GlasgowEmbedded/glasgow/README.md

# Glasgow Interface Explorer

For all information regarding this project, please refer to our [documentation manual](https://glasgow-embedded.org/).
