GlasgowEmbedded/glasgow/docs/meetings/2023-10-07.md

# Glasgow Maintainers Coordination Meeting

Date: 2023-10-07

Attendees:
- @whitequark
- @attie
- @esden
- @ewenmcneill

## Agenda

### CrowdSupply Campaign

Assignee: @esden

- Early bird orders have been arriving, people are very happy!!
  - Issue getting unit(s) shipped to Russia, @whitequark willing to support

### [#312](https://github.com/GlasgowEmbedded/glasgow/issues/312) - Documentation

Assignee: @attie & @whitequark

- Very shiny new documentation has been prepared and published - [glasgow-embedded.org](https://glasgow-embedded.org/latest/intro.html)
- Community contributions for installation steps recieved (FreeBSD)
- @attie to continue working on "_REPL & Script_" usage
- @whitequark to add a "_Design Principles_" section, and fill in "_Dev Process -> Firmware_"

### [#400](https://github.com/GlasgowEmbedded/glasgow/issues/400) - OS version in `--version` output

Assignee: @whitequark

- Plan to use `/etc/os-release`
- In progress, to be completed soon

### [#415](https://github.com/GlasgowEmbedded/glasgow/issues/415) - Case Options Mentioned in Docs

Assignee: @attie (to review)

- 3D print and laser-cut case designs exist, both need review for compatibility with revC3
- **Don't** add link in docs until revC3 compatibility is confirmed
- Aluminium case (from CS) won't be made public, isn't OSHW

### [#429](https://github.com/GlasgowEmbedded/glasgow/issues/429) - Export BOM for revC3

Assignee: @esden

- Will try to complete by the next meeting

### [#422](https://github.com/GlasgowEmbedded/glasgow/issues/422) - TypeError when running `glasgow`

Assignee: @whitequark

- Turns out this is likely related to older patch releases of Python
  - `<=3.9.10` is broken (including `3.9.5` as shipped in "_universe_" repo for Ubuntu 20.04 LTS)
  - `<=3.10.2` is broken
- High priority, do not want to instruct users on additional system setup steps
