GlasgowEmbedded/glasgow/docs/meetings/2023-09-09.md

# Glasgow Maintainers Coordination Meeting

Date: 2023-09-09

Attendees:
- @whitequark
- @attie
- @esden
- @electroniceel
- @wanda
- @isabelburgos
- @nanographs

## Agenda

### Rework Handling of EP0 in FX2

Assignee: @whitequark

- See [#382](https://github.com/GlasgowEmbedded/glasgow/issues/382) - Device fails to enumerate when plugged in for the first time on Windows
- See [#385](https://github.com/GlasgowEmbedded/glasgow/pull/385) - Temporarily work around issue #382
- No update since [2023-09-02](./2023-09-02.md)
- @whitequark plans to progress this next weekend, if not sooner

### CrowdSupply Campaign

Assignee: @esden

- No hardware update - 1000x cases ready, 200x PCBAs ready for firmware (see #382)
- Supply chain paperwork prepared and in review
- No update on LVDS test or test jig

### [#376](https://github.com/GlasgowEmbedded/glasgow/pull/376) - Migrate away from `bitarray` dependency

Assignee: @wanda

- No update since [2023-09-02](./2023-09-02.md)

### [#312](https://github.com/GlasgowEmbedded/glasgow/issues/312) - Documentation

Assignee: @attie & @whitequark

- @attie to look at expanding #312, and discuss with @whitequark
  - If they are aligned, @attie will coordinate documentation, @whitequark gets final approval
- @isabelburgos as lots of notes from personal use
- Potential contributors:
  - @isabelburgos
  - @nanographs
- "_Getting Started_" documentation would benefit from a native Windows / macOS user
