GlasgowEmbedded/glasgow/hardware/boards/glasgow/revB/output/3drender-back.png

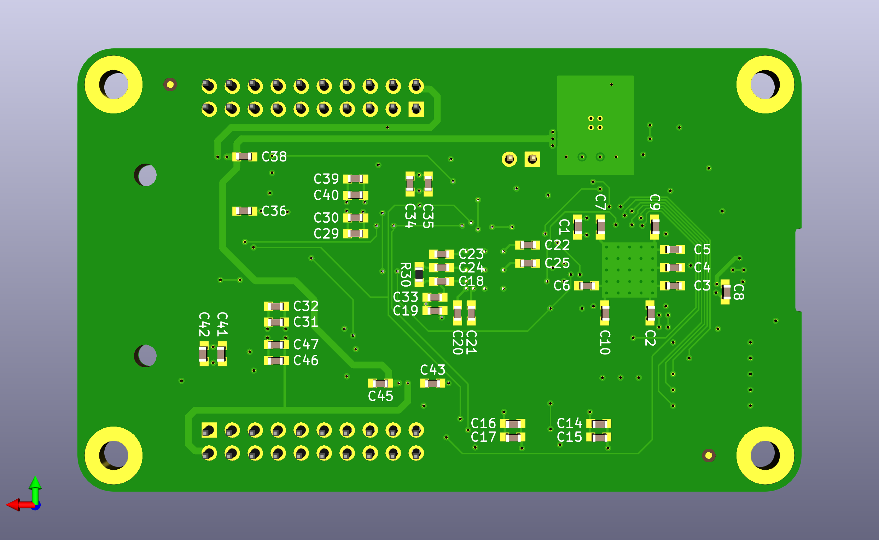
hardware/boards/glasgow/revB/output/3drender-back.png
