GlasgowEmbedded/glasgow/hardware/boards/glasgow/revB/output/3drender-front.png

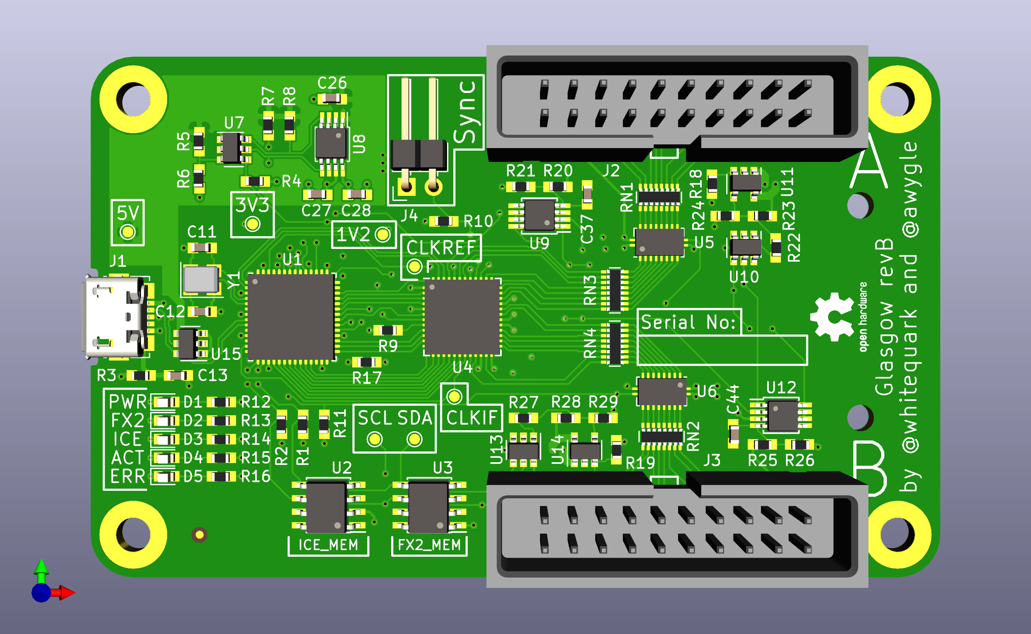
hardware/boards/glasgow/revB/output/3drender-front.png
