GlasgowEmbedded/glasgow/hardware/boards/glasgow/revC0/output/3drender-back.png

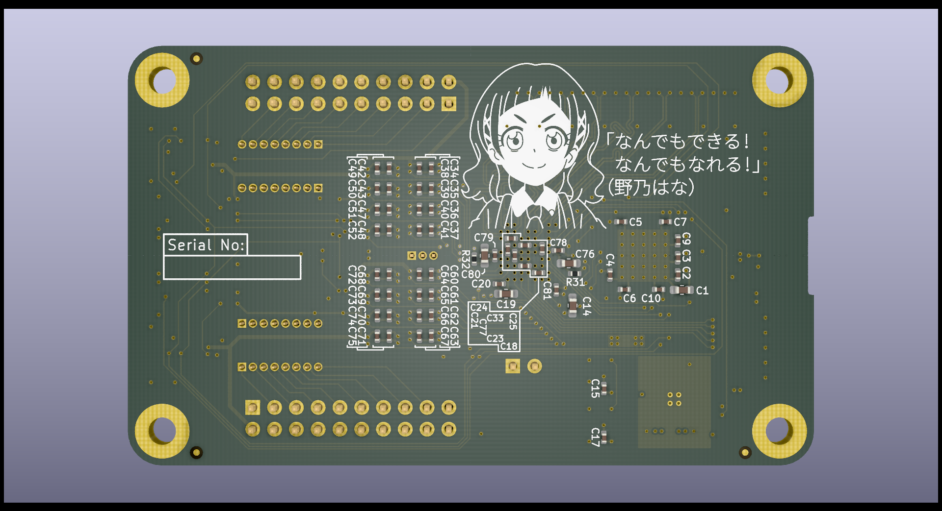
hardware/boards/glasgow/revC0/output/3drender-back.png
