GlasgowEmbedded/glasgow/hardware/boards/glasgow/revC0/output/3drender-front.png

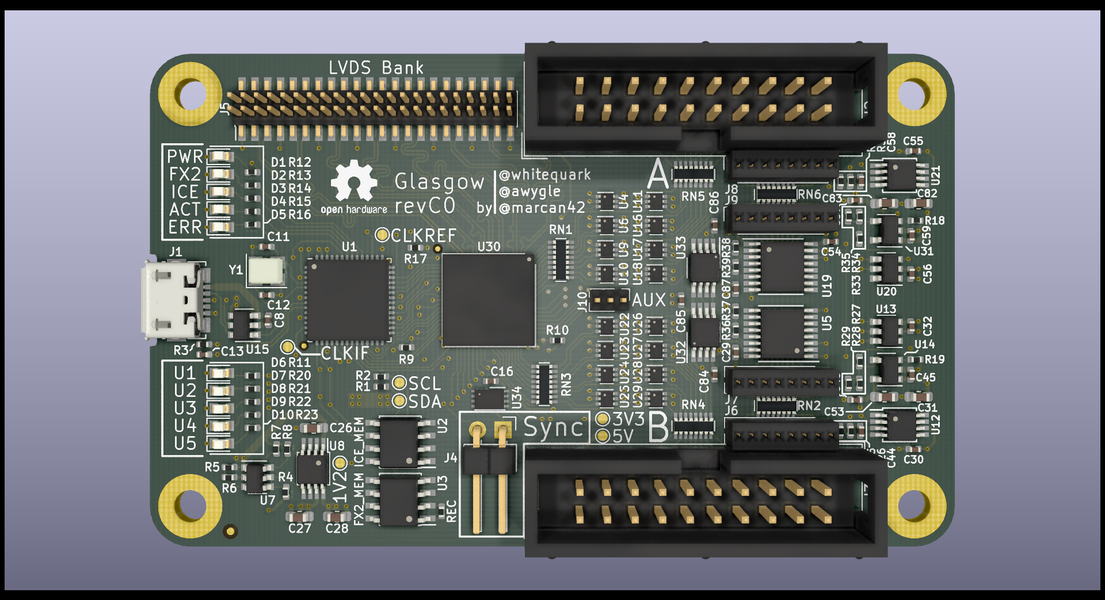
hardware/boards/glasgow/revC0/output/3drender-front.png
