GlasgowEmbedded/glasgow/hardware/boards/glasgow/revC1/output/3drender-back.png

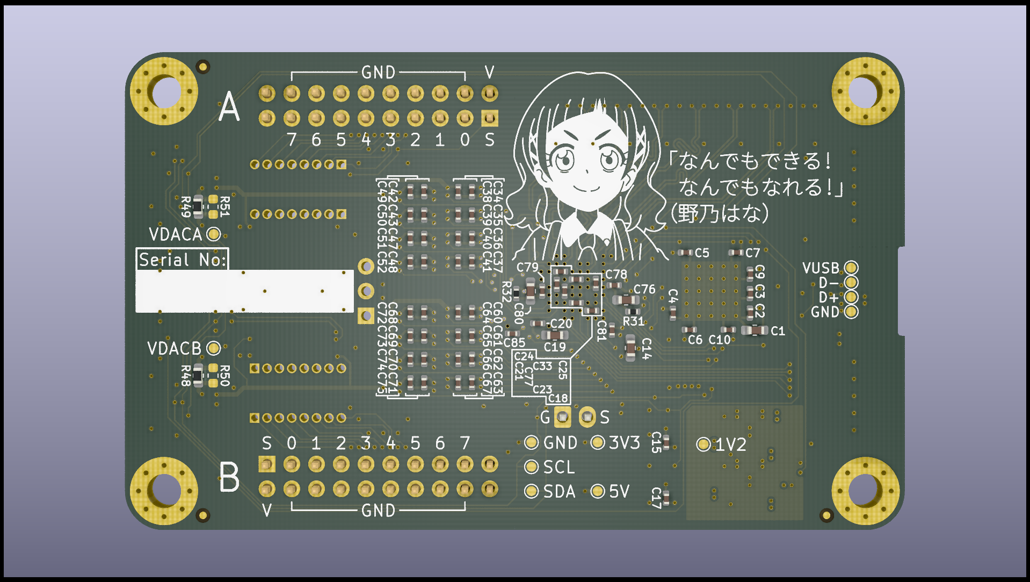
hardware/boards/glasgow/revC1/output/3drender-back.png
