GlasgowEmbedded/glasgow/hardware/boards/glasgow/revC1/output/3drender-front.png

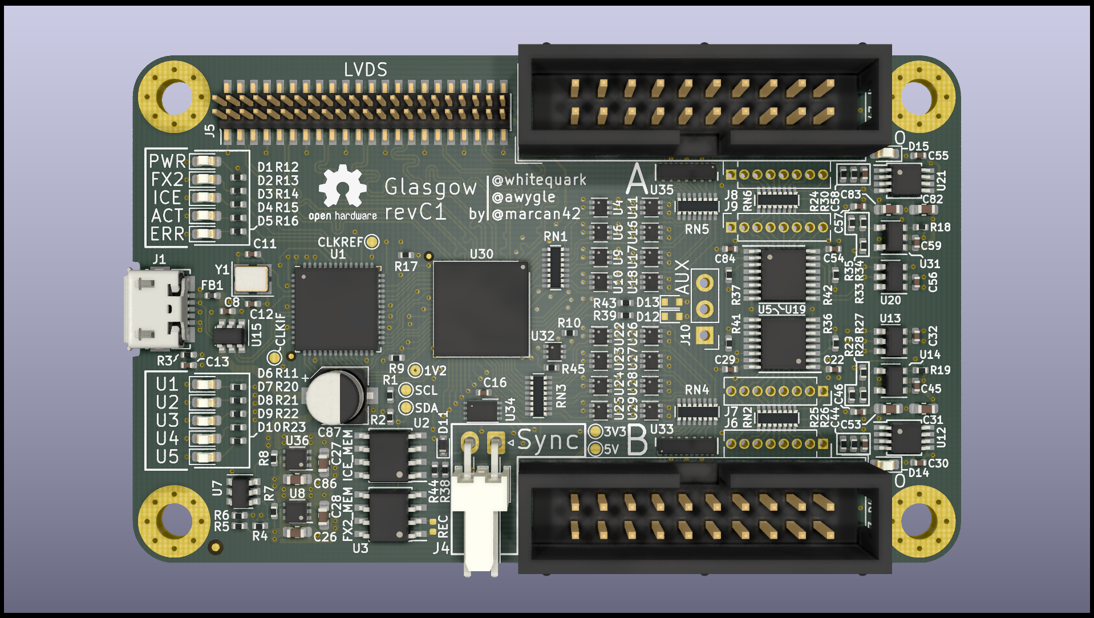
hardware/boards/glasgow/revC1/output/3drender-front.png
