GlasgowEmbedded/glasgow/hardware/boards/glasgow/revC2/output/3drender-back.png

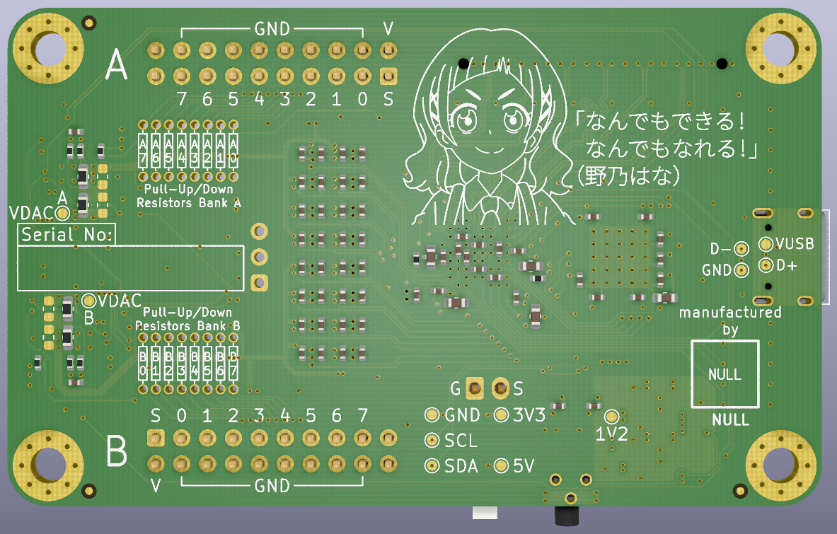
hardware/boards/glasgow/revC2/output/3drender-back.png
