GlasgowEmbedded/glasgow/hardware/boards/glasgow/revC2/output/3drender-front.png

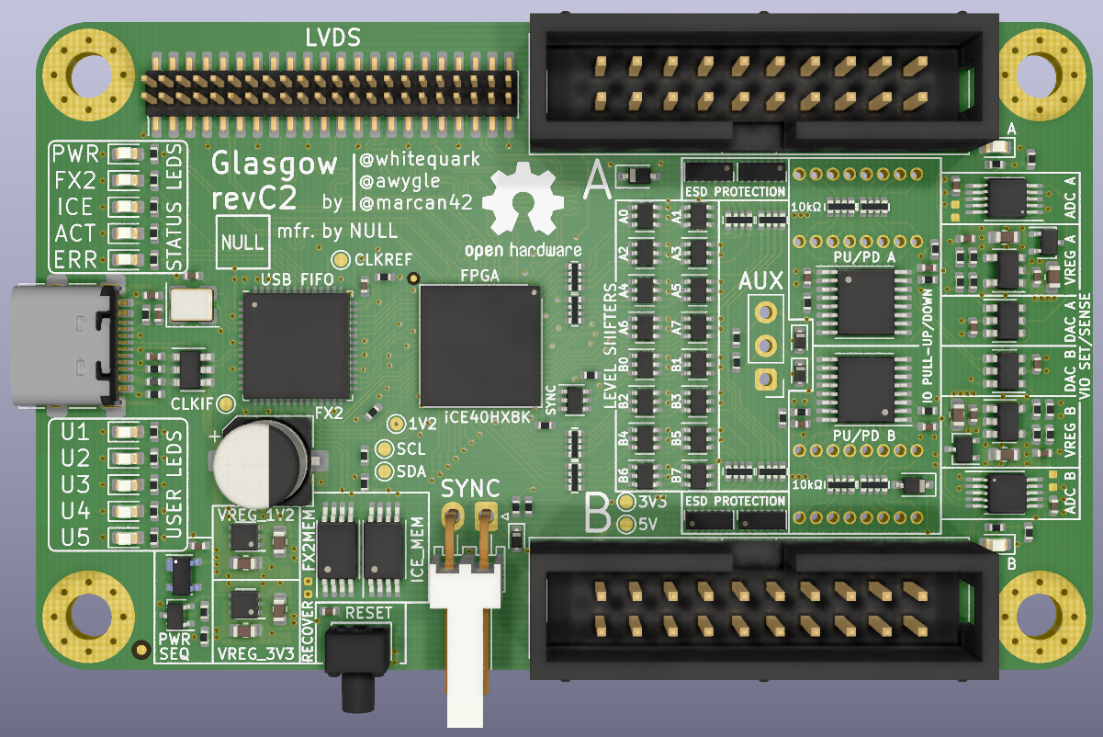
hardware/boards/glasgow/revC2/output/3drender-front.png
