GlasgowEmbedded/glasgow/docs/manual/src/purchase.rst

.. _purchasing:

Purchasing hardware
===================

Pre-assembled Glasgow devices and cases are available for purchase from the stores listed below.

* `CrowdSupply`_
* `1BitSquared USA`_
* `1BitSquared Germany`_
* `Mouser`_

.. _1BitSquared USA: https://1bitsquared.com/products/glasgow
.. _1BitSquared Germany: https://1bitsquared.de/products/glasgow
.. _CrowdSupply: https://www.crowdsupply.com/1bitsquared/glasgow
.. _Mouser: https://www.mouser.com/c/?q=glasgow-c3

As Glasgow is open hardware, you also have the option of :ref:`building a device yourself <build>`!
