GlasgowEmbedded/glasgow/hardware/cases/3d-printed/revC/base/output/Glasgow_base.iges

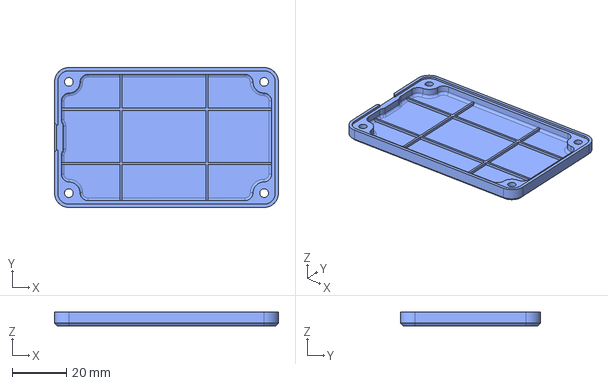
[picture p9: CAD file, 2026-09-02]
hardware/cases/3d-printed/revC/base/output/Glasgow_base.iges
82.6 x 51.6 x 5.00 mm
