GlasgowEmbedded/glasgow/hardware/cases/3d-printed/revC/magnetic-lid/output/glasgow_magnetic_lid.iges

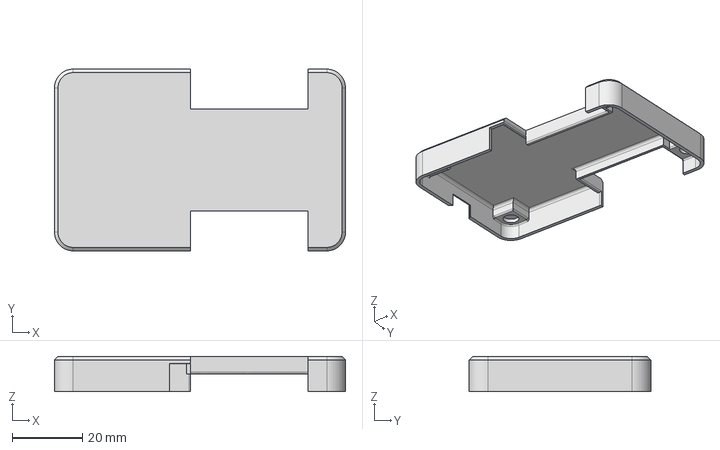
[picture p10: CAD file, 2020-11-04]
hardware/cases/3d-printed/revC/magnetic-lid/output/glasgow_magnetic_lid.iges
82.6 x 51.6 x 9.95 mm
