GlasgowEmbedded/glasgow/hardware/cases/laser-cut/revA/output/bottom.dxf

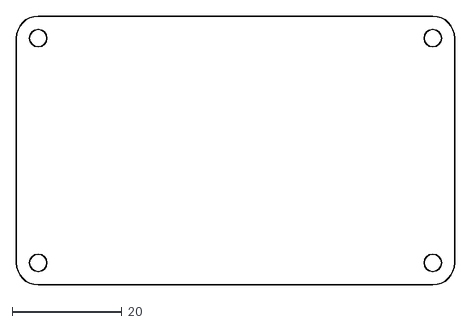
[picture p11: CAD file, 2018-04-18]
hardware/cases/laser-cut/revA/output/bottom.dxf
80.0 x 49.0
