GlasgowEmbedded/glasgow/hardware/cases/laser-cut/revA/output/top.dxf

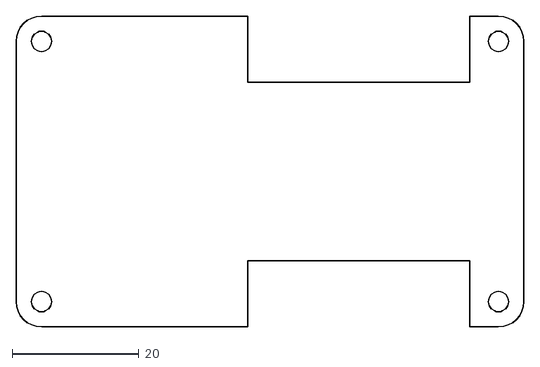
[picture p12: CAD file, 2018-04-18]
hardware/cases/laser-cut/revA/output/top.dxf
80.0 x 49.0
