GlasgowEmbedded/glasgow/(list of files, cad)

Other CAD files:
hardware/cases/3d-printed/revC/base/Glasgow_base.f3d
hardware/cases/3d-printed/revC/base/output/Glasgow_base.stl
hardware/cases/3d-printed/revC/magnetic-lid/glasgow_magnetic_lid.f3z
hardware/cases/3d-printed/revC/magnetic-lid/output/glasgow_magnetic_lid.stl
