GlasgowEmbedded/glasgow/docs/manual/src/applets/index.rst

Applet index
============

.. note::

    Note that not every applet is documented here yet; see ``glasgow run --help`` for a complete list.

.. toctree::
    :maxdepth: 2

    interface/index
    memory/index
    program/index
    debug/index
    radio/index
    control/index
    sensor/index
    bridge/index
    audio/index
    measure/index
    internal/index
