GlasgowEmbedded/glasgow/docs/manual/src/use/index.rst

Using the device
================

.. toctree::

    basic
    repl-script
