GlasgowEmbedded/glasgow/docs/manual/src/applets/control/index.rst

.. _applet.control:

Device control
==============

.. automodule:: glasgow.applet.control

.. toctree::
    :maxdepth: 3

    clock
    gpio
    mdio
    servo
    si535x
    tps6598x
