GlasgowEmbedded/glasgow/docs/manual/src/applets/sensor/index.rst

.. _applet.sensor:

Environment sensing
===================

.. automodule:: glasgow.applet.sensor

.. toctree::
    :maxdepth: 3

    bmx280
    hcsr04
    hx711
    ina260
    max31855
    pmsx003
    scd30
    sen5x
    qmc5883p
