GlasgowEmbedded/glasgow/docs/manual/src/applets/sensor/pmsx003.rst

``sensor-pmsx003``
==================

CLI reference
-------------

.. _applet.sensor.pmsx003:

.. autoprogram:: glasgow.applet.sensor.pmsx003:SensorPMSx003Applet._get_argparser_for_sphinx("sensor-pmsx003")
    :prog: glasgow run sensor-pmsx003

API reference
-------------

.. module:: glasgow.applet.sensor.pmsx003

.. autoexception:: PMSx003Error

.. autoclass:: PMSx003Interface
