GlasgowEmbedded/glasgow/docs/manual/src/applets/interface/index.rst

.. _applet.interface:

I/O interfaces
==============

.. automodule:: glasgow.applet.interface

.. toctree::
    :maxdepth: 3

    analyzer2
    uart
    uart_analyzer
    i2c_controller
    spi_controller
    spi_analyzer
    qspi_controller
    qspi_analyzer
    jtag_pinout
    jtag_probe
    jtag_svf
    sbw_probe
    swd_probe
