GlasgowEmbedded/glasgow/docs/manual/src/applets/interface/i2c_controller.rst

``i2c-controller``
==================

CLI reference
-------------

.. _applet.interface.i2c_controller:

.. autoprogram:: glasgow.applet.interface.i2c_controller:I2CControllerApplet._get_argparser_for_sphinx("i2c-controller")
    :prog: glasgow run i2c-controller

API reference
-------------

.. module:: glasgow.applet.interface.i2c_controller

.. autoexception:: I2CNotAcknowledged

.. autoclass:: I2CControllerInterface

.. module:: glasgow.arch.i2c

.. autoclass:: ProbeStep

    .. autoenum:: glasgow.arch.i2c::ProbeStep.Type

.. autoclass:: ProbeDevice
