GlasgowEmbedded/glasgow/docs/manual/src/applets/sensor/qmc5883p.rst

``sensor-qmc5883p``
==================

CLI reference
-------------

.. _applet.sensor.qmc5883p:

.. autoprogram:: glasgow.applet.sensor.qmc5883p:SensorQMC5883PApplet._get_argparser_for_sphinx("sensor-qmc5883p")
    :prog: glasgow run sensor-qmc5883p

API reference
-------------

.. module:: glasgow.applet.sensor.qmc5883p

.. autoexception:: QMC5883PError

.. autoenum:: OperatingMode

.. autoenum:: OutputDataRate

.. autoenum:: OversampleRatio

.. autoenum:: DownsampleRatio

.. autoenum:: FieldRange

.. autoenum:: SetResetMode

.. autoclass:: QMC5883PInterface
