GlasgowEmbedded/glasgow/docs/manual/src/applets/program/avr_spi.rst

``program-avr-spi``
===================

CLI reference
-------------

.. _applet.program.avr.spi:

.. autoprogram:: glasgow.applet.program.avr.spi:ProgramAVRSPIApplet._get_argparser_for_sphinx("program-avr-spi")
    :prog: glasgow run program-avr-spi
