GlasgowEmbedded/glasgow/docs/manual/src/applets/interface/jtag_probe.rst

``jtag-probe``
==============

CLI reference
-------------

.. _applet.interface.jtag_probe:

.. autoprogram:: glasgow.applet.interface.jtag_probe:JTAGProbeApplet._get_argparser_for_sphinx("jtag-probe")
    :prog: glasgow run jtag-probe

API reference
-------------

.. todo::

    Add API documentation for ``jtag-probe``.
