GlasgowEmbedded/glasgow/docs/manual/src/applets/interface/sbw_probe.rst

``sbw-probe``
=============

CLI reference
-------------

.. _applet.interface.sbw_probe:

.. autoprogram:: glasgow.applet.interface.sbw_probe:SpyBiWireProbeApplet._get_argparser_for_sphinx("sbw-probe")
    :prog: glasgow run sbw-probe

API reference
-------------

.. todo::

    Add API documentation for ``sbw-probe``.
