GlasgowEmbedded/glasgow/docs/manual/src/applets/sensor/hcsr04.rst

``sensor-hcsr04``
=================

CLI reference
-------------

.. _applet.sensor.hcsr04:

.. autoprogram:: glasgow.applet.sensor.hcsr04:SensorHCSR04Applet._get_argparser_for_sphinx("sensor-hcsr04")
    :prog: glasgow run sensor-hcsr04

API reference
-------------

.. module:: glasgow.applet.sensor.hcsr04

.. autoclass:: SensorHCSR04Interface
