GlasgowEmbedded/glasgow/docs/manual/src/applets/interface/swd_probe.rst

``swd-probe``
=============

CLI reference
-------------

.. _applet.interface.swd_probe:

.. autoprogram:: glasgow.applet.interface.swd_probe:SWDProbeApplet._get_argparser_for_sphinx("swd-probe")
    :prog: glasgow run swd-probe

API reference
-------------

.. module:: glasgow.applet.interface.swd_probe

.. autoexception:: SWDProbeException

    .. autoenum:: glasgow.applet.interface.swd_probe::SWDProbeException.Kind

.. autoclass:: SWDProbeInterface
