GlasgowEmbedded/glasgow/docs/manual/src/applets/sensor/sen5x.rst

``sensor-sen5x``
=================

CLI reference
-------------

.. _applet.sensor.sen5x:

.. autoprogram:: glasgow.applet.sensor.sen5x:SensorSEN5xApplet._get_argparser_for_sphinx("sensor-sen5x")
    :prog: glasgow run sensor-sen5x

API reference
-------------

.. todo::

    Add API documentation for ``sensor-sen5x``.
