GlasgowEmbedded/glasgow/docs/manual/src/applets/sensor/scd30.rst

``sensor-scd30``
=================

CLI reference
-------------

.. _applet.sensor.scd30:

.. autoprogram:: glasgow.applet.sensor.scd30:SensorSCD30Applet._get_argparser_for_sphinx("sensor-scd30")
    :prog: glasgow run sensor-scd30

API reference
-------------

.. todo::

    Add API documentation for ``sensor-scd30``.
