GlasgowEmbedded/glasgow/docs/manual/src/applets/control/servo.rst

``control-servo``
=================

CLI reference
-------------

.. _applet.control.servo:

.. autoprogram:: glasgow.applet.control.servo:ControlServoApplet._get_argparser_for_sphinx("control-servo")
    :prog: glasgow run control-servo

API reference
-------------

.. module:: glasgow.applet.control.servo

.. autoclass:: ServoInterface
