GlasgowEmbedded/glasgow/docs/manual/src/applets/interface/spi_analyzer.rst

``spi-analyzer``
================

CLI reference
-------------

.. _applet.interface.spi_analyzer:

.. autoprogram:: glasgow.applet.interface.spi_analyzer:SPIAnalyzerApplet._get_argparser_for_sphinx("spi-analyzer")
    :prog: glasgow run spi-analyzer

API reference
-------------

.. module:: glasgow.applet.interface.spi_analyzer

.. autoexception:: SPIAnalyzerOverflow

.. autoclass:: SPIAnalyzerInterface
