GlasgowEmbedded/glasgow/docs/manual/src/applets/interface/uart.rst

.. _applet.interface.uart:

``uart``
========

CLI reference
-------------

.. autoprogram:: glasgow.applet.interface.uart:UARTApplet._get_argparser_for_sphinx("uart")
    :prog: glasgow run uart

API reference
-------------

.. module:: glasgow.applet.interface.uart

.. autoclass:: UARTInterface
