GlasgowEmbedded/glasgow/docs/manual/src/applets/interface/uart_analyzer.rst

``uart-analyzer``
=================

CLI reference
-------------

.. _applet.interface.uart_analyzer:

.. autoprogram:: glasgow.applet.interface.uart_analyzer:UARTAnalyzerApplet._get_argparser_for_sphinx("uart-analyzer")
    :prog: glasgow run uart-analyzer

API reference
-------------

.. module:: glasgow.applet.interface.uart_analyzer

.. autoenum:: UARTAnalyzerError()

.. autoclass:: UARTAnalyzerInterface
