GlasgowEmbedded/glasgow/docs/manual/src/applets/bridge/flashrom.rst

``spi-flashrom``
================

.. _applet.bridge.spi_flashrom:

.. autoprogram:: glasgow.applet.bridge.spi_flashrom:SPIFlashromApplet._get_argparser_for_sphinx("spi-flashrom")
    :prog: glasgow run spi-flashrom
