GlasgowEmbedded/glasgow/docs/manual/src/applets/bridge/index.rst

.. _applet.bridge:

External tools
==============

.. automodule:: glasgow.applet.bridge

.. toctree::
    :maxdepth: 2

    flashrom
    jtag_openocd
    jtag_xvc
    probe_rs
