GlasgowEmbedded/glasgow/docs/manual/src/applets/bridge/probe_rs.rst

``probe-rs``
============

.. _applet.bridge.probe_rs:

.. autoprogram:: glasgow.applet.bridge.probe_rs:ProbeRsApplet._get_argparser_for_sphinx("probe-rs")
    :prog: glasgow run probe-rs
