GlasgowEmbedded/glasgow/hardware/cases/3d-printed/revC/base/output/Glasgow_base.png

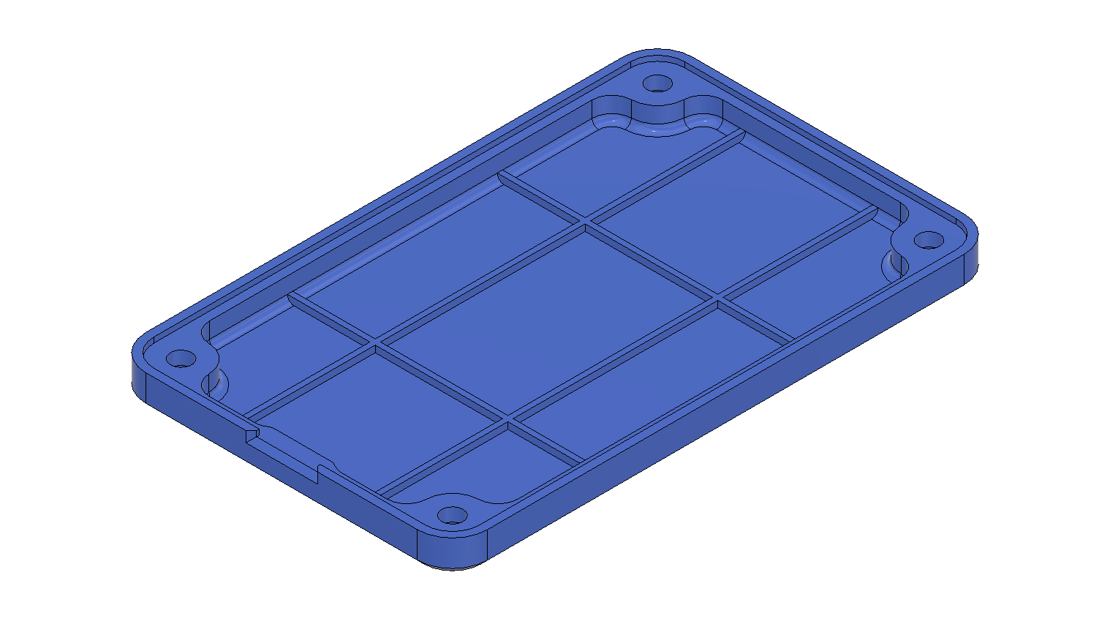
hardware/cases/3d-printed/revC/base/output/Glasgow_base.png
