GlasgowEmbedded/glasgow/docs/manual/src/applets/measure/curve_trace.rst

``curve-trace``
===============

CLI reference
-------------

.. _applet.measure.curve_trace:

.. autoprogram:: glasgow.applet.measure.curve_trace:CurveTraceApplet._get_argparser_for_sphinx("curve-trace")
    :prog: glasgow run curve-trace

API reference
-------------

.. module:: glasgow.applet.measure.curve_trace

.. autoclass:: CurveTraceInterface

.. autoclass:: DiodeTraceInterface
