GlasgowEmbedded/glasgow/docs/manual/src/applets/measure/index.rst

.. _applet.measure:

Measure
=======

.. automodule:: glasgow.applet.measure

.. toctree::
    :maxdepth: 2

    calibrate_clock
    prn_noise
