GlasgowEmbedded/glasgow/docs/manual/src/applets/measure/calibrate_clock.rst

``calibrate-clock``
===================

CLI reference
-------------

.. _applet.measure.calibrate_clock:

.. autoprogram:: glasgow.applet.measure.calibrate_clock:CalibrateClockApplet._get_argparser_for_sphinx("calibrate-clock")
    :prog: glasgow run calibrate-clock

API reference
-------------

.. module:: glasgow.applet.measure.calibrate_clock

.. autoclass:: CalibrateClockInterface
