GlasgowEmbedded/glasgow/hardware/boards/test-jig/pictures/render-bottom.jpg

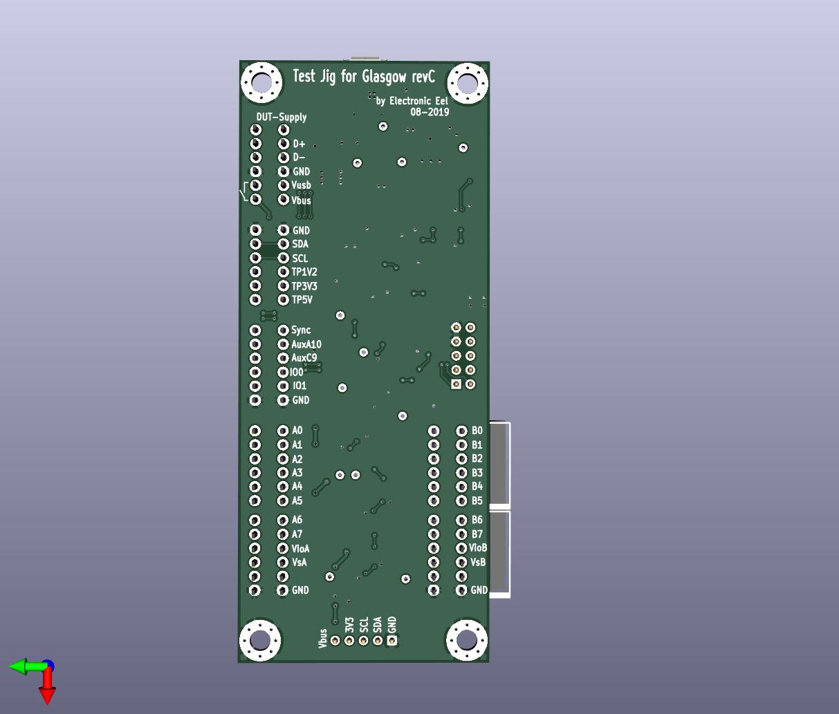
hardware/boards/test-jig/pictures/render-bottom.jpg
