GlasgowEmbedded/glasgow/hardware/boards/test-jig/pictures/render-leds.jpg

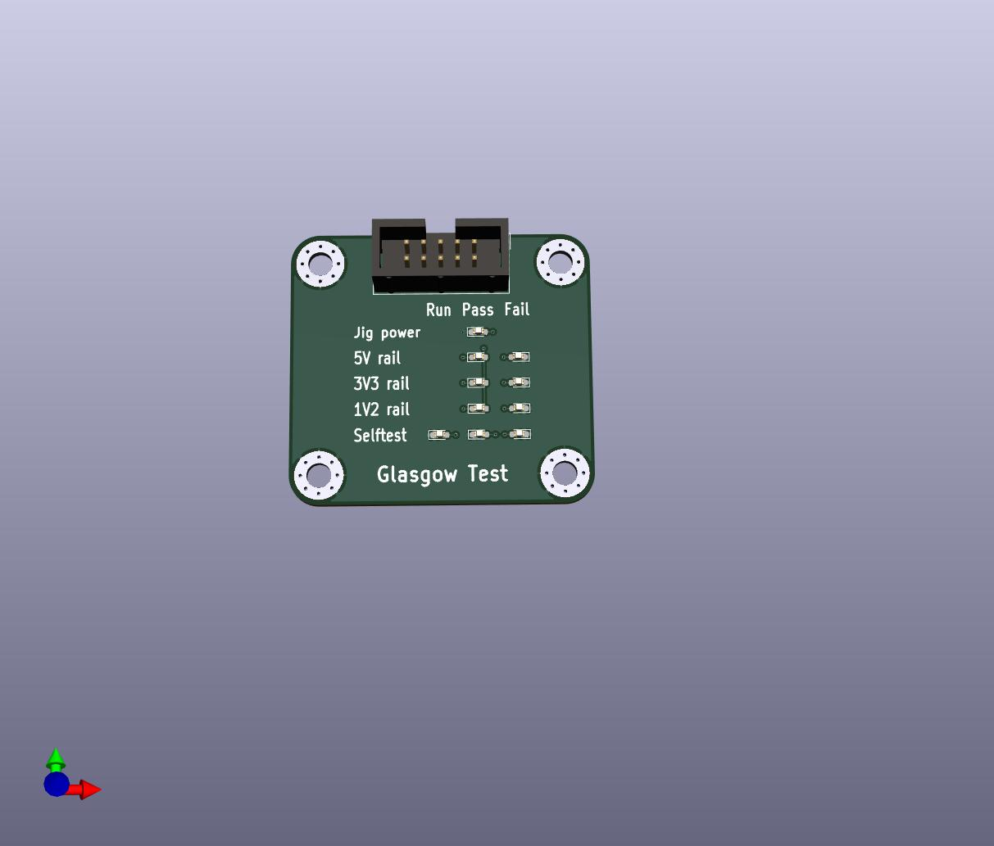
hardware/boards/test-jig/pictures/render-leds.jpg
