GlasgowEmbedded/glasgow/hardware/boards/test-jig/pictures/render-top1.jpg

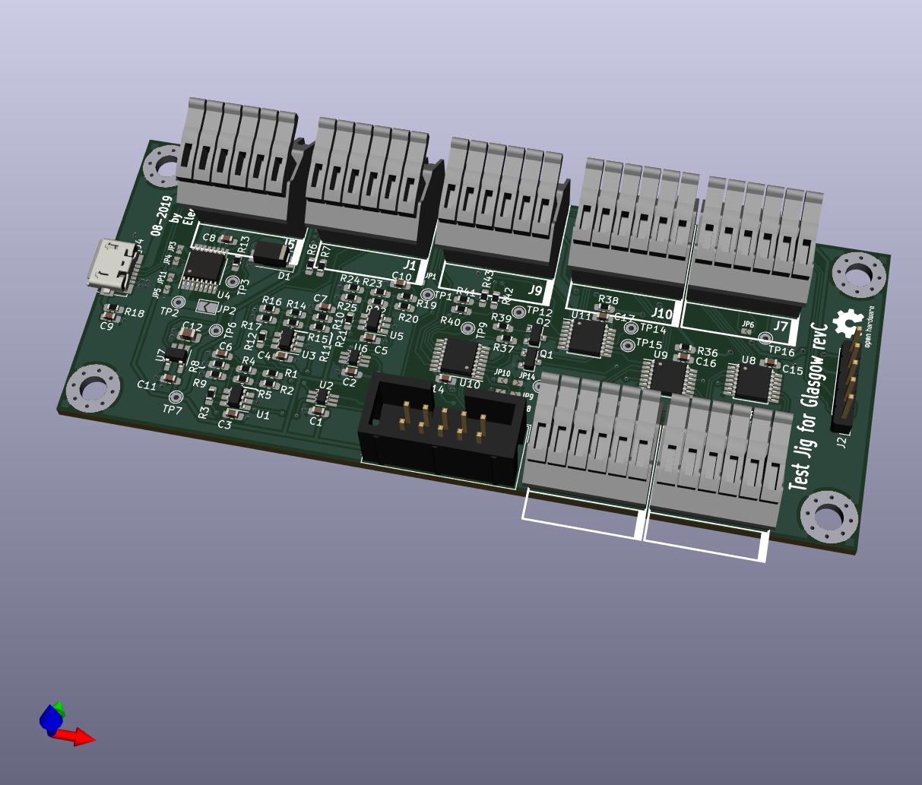
hardware/boards/test-jig/pictures/render-top1.jpg
