GlasgowEmbedded/glasgow/hardware/boards/test-jig/pictures/render-top2.jpg

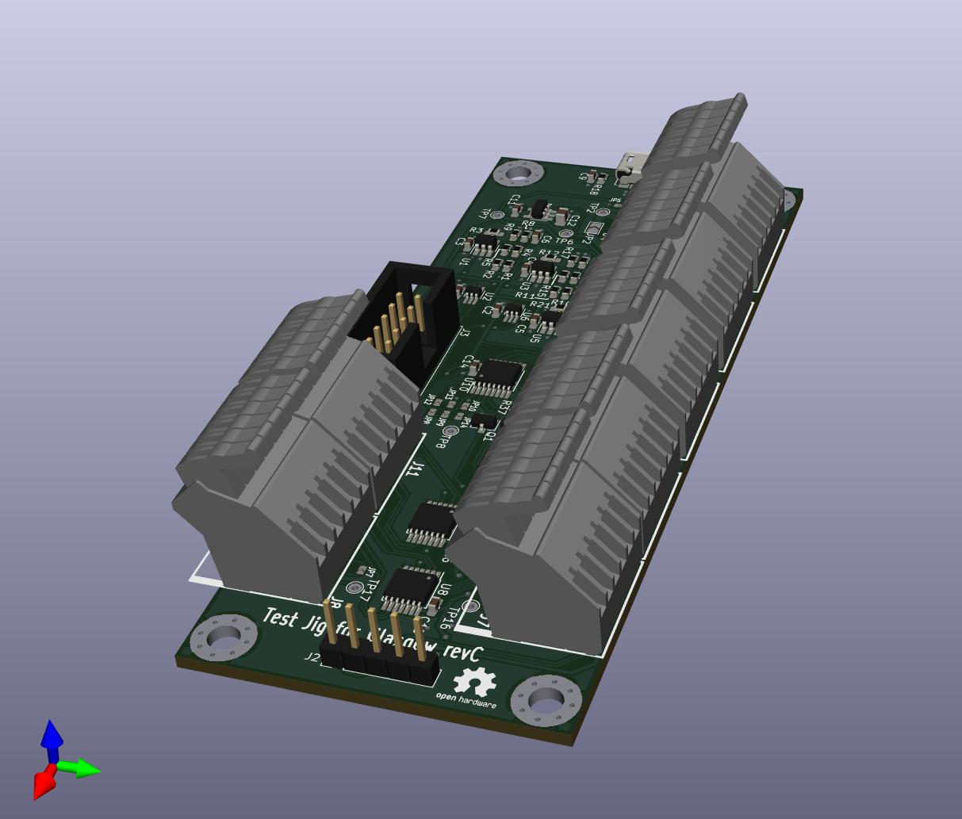
hardware/boards/test-jig/pictures/render-top2.jpg
