GlasgowEmbedded/glasgow/docs/manual/src/applets/debug/arm.rst

``debug-arm``
=============

CLI reference
-------------

.. _applet.debug.arm.jtag:

.. autoprogram:: glasgow.applet.debug.arm.jtag:DebugARMJTAGApplet._get_argparser_for_sphinx("debug-arm")
    :prog: glasgow run debug-arm
