GlasgowEmbedded/glasgow/docs/manual/src/applets/debug/index.rst

.. _applet.debug:

MCU debugging
=============

.. automodule:: glasgow.applet.debug

.. toctree::
    :maxdepth: 3

    arc
    arm
    arm7
    mips
