GlasgowEmbedded/glasgow/docs/manual/src/applets/debug/arm7.rst

``debug-arm7``
==============

CLI reference
-------------

.. _applet.debug.arm.arm7:

.. autoprogram:: glasgow.applet.debug.arm.arm7:DebugARM7Applet._get_argparser_for_sphinx("debug-arm7")
    :prog: glasgow run debug-arm7
