GlasgowEmbedded/glasgow/(threads)

Thread 11 (2018-04-06):

TI ADC081C021CIMM MSOP-8

whitequark, 2018-04-06:
Nothing closely related, seems to use an existing package.

whitequark, 2018-04-11:
Merged

whitequark, 2018-04-16:
ALERT pin should be marked as open-drain (needs to be fixed upstream).

whitequark, 2018-04-19:
Fixed.

Closed 2018-04-19.

Thread 12 (2018-04-06):

ON Semi FXMA108BQX QFN-20

whitequark, 2018-04-06:
Nothing related, the high aspect ratio QFN-20 almost definitely doesn't exist yet.

awygle, 2018-04-08:
See https://github.com/KiCad/kicad-symbols/pull/461 for symbol PR

whitequark, 2018-04-20:
Symbol merged.

whitequark, 2018-05-03:
Pin names are wrong... 1-8 instead of 0-7.

whitequark, 2018-05-03:
Fixed in PR https://github.com/KiCad/kicad-symbols/pull/571

Thread 9 (2018-04-06):

TI TPS73101DBVR SOT-23-5

whitequark, 2018-04-06:
KiCAD has a closely related TPS763xx series, the TPS731 series probably just needs to be a few aliases.

awygle, 2018-04-08:
See https://github.com/KiCad/kicad-symbols/pull/462 for Kicad PR

awygle, 2018-04-09:
Kicad PR merged - closing.

whitequark, 2018-04-17:
Symbol bug. https://github.com/KiCad/kicad-symbols/pull/498

whitequark, 2018-04-20:
Symbol bug fixed upstream.

Closed 2018-04-20.

Thread 15 (2018-04-10):

Cypress CY7C68013A-LXI

whitequark, 2018-04-10:
Unfortunately, some issues with the footprint: https://github.com/KiCad/kicad-symbols/pull/289#issuecomment-380247117

whitequark, 2018-04-11:
> I'm good with having a footprint with thermals vias and making it the default. Vias can also be added by the user in the PCB, but obviously it's best and easiest to build it into the footprint. I have asked Cypress for a recommended footprint. The reference design mentioned above uses 25 vias with 10mil drill (0.254mm), 22mil annular rings (0.5588mm), and 16mil mask (0.4064mm) on a 50mil (1.27mm) XY grid. Pads are oval 40x100mil (1.016x2.54mm) with row-row/column-column spacing of 152.48mil (~3.873mm). When a suitable footprint is in the library, then the default footprint for this symbol could be changed.

whitequark, 2018-05-17:
Footprint: https://github.com/KiCad/kicad-footprints/pull/582

whitequark, 2018-05-25:
3D package: https://github.com/KiCad/kicad-packages3D/pull/316

whitequark, 2018-07-12:
Footprint merged.

whitequark, 2018-09-19:
3D package merged.

Closed 2018-09-19.

Thread 17 (2018-05-01):

R5 has wrong Mouser_PN

whitequark, 2018-05-01:
It's 300k, should be 220k.

whitequark, 2018-05-02:
Already fixed, must have been a stale line in the Mouser BOM.

Closed 2018-05-02.

Thread 19 (2018-05-01):

Move R12-R16 to top side

whitequark, 2018-05-01:
It's a pain in the ass to do double-sided assembly, that's what it is. No need to make it worse.

whitequark, 2018-05-01:
This would involve moving R1/R2/R11 to the right into the great empty plains of EEPROM-land.

whitequark, 2018-05-10:
Nope. D1-D5 silkscreen overlaps R12-R16.

Closed 2018-05-12.

Thread 20 (2018-05-01):

Y1 footprint is way too big

whitequark, 2018-05-01:
Not actually an issue for the component selected, since it still solders nicely, but this is not what I was expecting at all.

Closed 2018-05-05.

Thread 26 (2018-05-01):

Test/loopback PCB

whitequark, 2018-05-01:
When (at this point, apparently not "if") we do a production run we'll need to do QA, and for that we should use a simple board that plugs into both ports and connects them to each other. It should also have LEDs (buffered to Vioa, since the level shifters cannot drive a LED directly) for visual verification.

whitequark, 2018-05-26:
A flat cable with IDC connectors works just as well and is marginally easier to remove. Vio/Vsense map to non-populated pins on an unmodified cable, those should probably be shorted together.

Closed 2018-05-26.

Thread 28 (2018-05-03):

Lattice iCE40HX8K-BG121 121-ball caBGA

whitequark, 2018-05-03:

awygle, 2018-06-25:
Kicad footprint PR: https://github.com/KiCad/kicad-footprints/pull/693
The symbol exists at https://github.com/awygle/kicad-symbols/tree/ice40hx but is waiting on https://github.com/KiCad/kicad-symbols/pull/457 to merge before creating the PR.

whitequark, 2018-07-21:
@awygle That symbol is now merged.

awygle, 2018-07-21:
Kicad symbol PR: https://github.com/KiCad/kicad-symbols/pull/777

whitequark, 2018-10-12:
Symbol merged.

Closed 2018-10-12.

Thread 33 (2018-05-03):

Develop a tool to validate capacitor/resistor values against Mouser API

whitequark, 2018-05-03:

shapr, 2018-05-10:
could this be unpacked with more detail? Might be able to use the octopart API

whitequark, 2018-05-10:
So, I've had an issue several times that the Mouser part number didn't match the value of a resistor (less a problem with capacitors because we only have like one capacitor whose value actually matters, the rest is decoupling). It's a thing that's *really* easy to miss with manual review, so I want to automate it.

Octopart probably works too, just cut `\d+-` from the start of Mouser PN to get MPN.

whitequark, 2018-05-25:
I'm dumb and this is not necessary. The Yageo part numbers have the resistor value in the part number, e.g. `10K` in `RC0603FR-1310KL` or `604R` in `RC0603FR-07604RL`. Same for package. A cursory visual check is well enough.

Closed 2018-05-25.

Thread 34 (2018-05-03):

Use a dedicated USB protection IC instead of a regular fast-blow fuse

whitequark, 2018-05-03:
If you short Vio to GND for like a millisecond it blows instantly. Source: shorted Vio to GND for like a millisecond.

whitequark, 2018-05-05:
This fuse will take ~1s to trip at 1A fault current. Seems completely pointless.

We need a fuse that will blow if you short the 3V3 supply to ground, but also will sustain short-circuit current of both LDOs indefinitely. This needs measurement and experimentation...

awygle, 2018-05-05:
Per IRC discussion, will use http://www.ti.com/lit/ds/symlink/tpd3s014.pdf instead.

whitequark, 2018-05-13:
This seems simple enough we really should add this in revB.

awygle, 2018-06-04:
Closed by 369968e

Closed 2018-06-04.

Thread 35 (2018-05-07):

Slew rate limiting resistors

whitequark, 2018-05-07:
Two arrays of four resistors per port. I'm not sure yet what the values should be; worst case, we can always populate with 0R and decide later.

whitequark, 2018-05-07:
This will also add some very limited pin overcurrent protection. Say at 200 ohm, the buffers should tolerate ±10V on up to two signal pins (not Vio or Vsense though).

whitequark, 2018-05-07:
0402 8-position array fits better (it's about the same size as FXMA108).

whitequark, 2018-06-06:
Pretty sure we also need slew rate limiting on the *other* side of the level shifter because switching many inputs at once causes [glitches](https://github.com/whitequark/Glasgow/blob/a89f5a224449ddd5d1bf9e5f4e8b7e3bc2593bce/software/glasgow/gateware/fx2.py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) on the FLAGn pins on the other side of the board. The apparently random timing of the glitches seems to suggest that glitches happen when the inputs transition happens closely enough to IFCLK transition.

awygle, 2018-06-25:
I added these in commit 7c3203c126e7444981d5405d7d6fcd1db53bbbc5

whitequark, 2018-07-21:
Thanks!

Closed 2018-07-21.

Thread 38 (2018-05-08):

Use an FX2LP in a BGA package?

whitequark, 2018-05-08:
We can save a dollar if we go for 56-ball 0.5 mm pitch VFBGA package. We only need to route out two rows of balls at most, so it seems fine that it's 0.5 mm pitch. Should we?

awygle, 2018-05-08:
Mmm... maybe. The problem with the 0.5mm pitch is, you can't get vias *or* traces between balls on 6/6 trace/space specs. I'll investigate this at the same time as doing the HX routing - 0.8mm parts have similar-but-not-the-same problems, so seeing what we *need* to do will help us figure out what it'll cost us to do the optional stuff.

whitequark, 2018-10-06:
@awygle Do you remember what was your conclusion? Looking at the package, some B and G balls do present an issue...
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

whitequark, 2018-10-31:
We don't have any margin for two-row escape routing on 0.8 mm with 5/5 rules already, so this is not viable.

Closed 2018-10-31.

Thread 40 (2018-05-10):

Add IFCLK test point

whitequark, 2018-05-10:
I'm observing some strange issues related to post-bitstream-upload reset and CDONE is currently not easily accessible at all.

whitequark, 2018-05-11:
I figured it out.

whitequark, 2018-05-11:
But IFCLK makes sense.

Thread 41 (2018-05-13):

Describe Device, Target, Applet APIs

whitequark, 2018-05-13:
- [ ] GlasgowDevice
 - [ ] GlasgowTarget
 - [ ] GlasgowApplet

whitequark, 2019-08-19:
Doesn't seem that useful; documentation dedicated to explaining how to write applets is what's really needed.

Closed 2019-08-19.

Thread 43 (2018-05-13):

Cache bitstreams

whitequark, 2018-05-13:
Synthesis and PAR are slow, rerunning them on every invocation is wasteful, and explicit `--no-build` is awful.

Needs extra care so that it works on:
 - [x] Linux
 - [x] macOS
 - [x] Windows

whitequark, 2018-05-25:
Instead of caching files in some system location, bitstreams are now cached in device memory (volatile and non-volatile) after 48a130ff. This is far more portable and far less likely to result in stale caches leading to confusing results (especially if you don't flash EEPROM) while still eliminating most rebuilds (unless you switch between two applets continuously).

We can revisit this later, but this works for now.

whitequark, 2023-07-23:
We decided to cache bitstreams after all, which becomes possible to do safely after #353 is merged.

Closed 2023-07-23.

Thread 44 (2018-05-13):

Make FX2 bus arbiter prevent starvation

whitequark, 2018-05-13:
Use a leaky bucket algorithm to limit per-FIFO bursts to 16 bytes (or a configurable value).

whitequark, 2019-04-03:
Actually, the FX2 arbiter does not cause starvation. It only looked like it did because of a deadlock in the host code, which was fixed in e59730f.

whitequark, 2019-04-03:
Though, that being said, the arbiter is not particularly fair, but it seems pretty much sufficient for now.

Closed 2019-04-03.

Thread 49 (2018-05-13):

Implement MPSSE subtarget and FTDI emulation mode

whitequark, 2018-05-13:
This is kind of annoying because it needs reenumeration logic in the firmware.

marcan, 2019-05-01:
Don't forget to emulate the 32-bit EEPROM correctly to avoid being hit by FTDI's bricker :P

whitequark, 2019-08-19:
Does anyone actually *want* this?

esden, 2019-08-20:
MPSSE would be fairly useful. There is a bunch of software that uses MPSSE for "stuff" and it would be nice to just transparently use the Glasgow instead of an FTDI cable. Also that implementation might be a useful reference implementation for FTDI chip replacements.

classic-gentleman, 2020-07-08:
> MPSSE would be fairly useful. There is a bunch of software that uses MPSSE for "stuff" and it would be nice to just transparently use the Glasgow instead of an FTDI cable. Also that implementation might be a useful reference implementation for FTDI chip replacements.

YES, for every point made.

whitequark, 2020-07-08:
Ironically this was the original goal of the project and the very first committed gateware, but I don't think we even have the code left for it in-tree anymore.

classic-gentleman, 2020-07-08:
https://github.com/usb-tools/Facedancer/blob/master/facedancer/devices/ftdi.py

Adapting this shouldn't be horrible...

whitequark, 2020-07-08:
The problem is actually the firmware, and there is no great solution that I know of, especially for Windows.

whitequark, 2023-07-23:
We decided not to do this. 60d09a217502f469682e3dd1c51c5e6bd2dfd586

Closed 2023-07-23.

Thread 50 (2018-05-13):

Figure out exactly what happens during Vio short-circuit to GND

whitequark, 2018-05-13:
On revA the fuse blows immediately. Need to check if the current limiting works as designed (probably not since the fuse blows. lol.) and decide what to do about it.

awygle, 2018-05-22:
I put a hard short on one VIO port and did not pop the fuse. I measured a peak of 350 mA and 280 mA steady state (without the short and with the I/O toggling at 15 MHz I was seeing 77 mA). I put a hard short on the other port as well and managed to pop it. That suggests to me that we're close to being able to tolerate two full shorts on the I/O banks, and that dropping down to 100 mA LDOs would probably put us into safe territory. It also becomes sort of a question as to whether we need the USB IC at that point... But then you had your issue earlier so I'm not totally sure what's going on.

Thoughts? Can you replicate your one-port fuse popping?

awygle, 2018-05-22:
With both shorts in place I nearly popped the 600 mA fuse on my ammeter - it looked like 580 mA with both LDOs in current limit.

With one short in place I got up to 350 mA and then it looked like the LDO was going into a thermal shutdown loop. So I think the full-short current is pretty much 350 mA. But again, I was only able to get 77 mA from the pins toggling at 15 MHz, so it looks like the LDO is actually limiting much higher than 150 mA.

awygle, 2018-05-22:
I am an idiot. The current limit for the TPS731 is min 150, typ 360, max 500 mA. No wonder it's not protecting us.

I was going to suggest the LP2980-ADJ, which is a 50 mA output LDO, and whose current limit is "typical" 150 mA. That would put us into safe territory. I'd be worried about starving the shifters but it looks like we can't feed them any faster than like 30 MHz, so we should be safe.

whitequark, 2018-05-22:
> Thoughts? Can you replicate your one-port fuse popping?

I, uh, don't have any fuses left.

whitequark, 2018-05-22:
> I'd be worried about starving the shifters but it looks like we can't feed them any faster than like 30 MHz, so we should be safe.

Hm, I wouldn't put 50 MHz out of question with async FIFOs.

awygle, 2018-05-22:
Yeah, the dropout's not ideal. The alternative is to rely on the USB protection IC. The bummer with that is that it will probably brown out the FX2 and cause the device to flap on the user's PC. The LDO will stop this further downstream.

whitequark, 2018-05-22:
I think a brownout is OK.

whitequark, 2018-05-25:
Since a brownout seems OK (and even beneficial in some ways, as you get a pretty visible indication of something going wrong!) I'm closing this as a duplicate of #34.

Closed 2018-05-25.

Thread 51 (2018-05-14):

Make SYNC pullup smaller

whitequark, 2018-05-14:
The FPGA has ridiculously powerful drivers (what, 10 mA?) so if we use a pullup smaller than 1k we can go well into MHz range. Useful, because the PLL has a minimum frequency of 16 MHz--can we get that high?

awygle, 2018-05-22:
I think 300 Ohms is the lowest we can safely go. That'll give us 300 mV of rise above ground at 3.3V with 10 mA drivers.

whitequark, 2018-05-22:
It's actually 24 mA. On the other hand, Vil(max) for LVCMOS 3.3 inputs is 0.8 V, so 0.3 V seems fine.

awygle, 2018-05-22:
Okay, that'd give us 125 Ohms. 130 for ease of sourcing. Math math math.

whitequark, 2018-05-22:
Can you verify that this value actually gives a decent signal? I don't have my resistor set at hand...

awygle, 2018-05-22:
I have some 120 Ohm resistors, I can look at what those give.

awygle, 2018-06-25:
Where'd you find 24 mA as the value? I'm looking at
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 and reading 8 mA.

(Just for completeness that's 375 Ohms by math and probably 390 by sourcing)

whitequark, 2018-07-10:
Hrm, I might have been looking at the wrong package. 300 mV rise seems pretty low too, that's not enough to sync using e.g. external LMVCMOS 3.3 circuitry... Let's aim at 800 mV rise above ground then.

awygle, 2018-07-10:
Because it's an open drain output, 300 mV is Voh in this case - the voltage for a logic 0. The high voltage will be the full VIO voltage.

whitequark, 2018-07-10:
Oh right, I derped. That's fine then, let's go with 300 mV.

awygle, 2018-07-22:
Whoops:

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

Closed 2018-07-22.

Thread 52 (2018-05-14):

TI SN74LVC1T45

whitequark, 2018-05-14:
Footprint: https://github.com/KiCad/kicad-footprints/pull/581
Symbol: https://github.com/KiCad/kicad-symbols/pull/596
3D package: https://github.com/KiCad/kicad-packages3D/pull/314

whitequark, 2018-05-26:
Footprint and symbol merged.

whitequark, 2018-06-10:
3D package merged.

whitequark, 2018-10-21:
Reopening since the  upstream fp requires 4/4 rules.

whitequark, 2019-08-19:
Upstream says the default footprint should really use the recommended pad sizes, which indeed require 4/4, so we should just fork it, which is what's already happened.

Closed 2019-08-19.

Thread 56 (2018-05-19):

Implement a self-test routine checking for solder bridges

whitequark, 2018-05-19:
This is essentially #26-lite; a proper loopback PCB would allow to test input/output on every single pin, but you need to have it. On the other hand, all our I/O are adjacent on both FPGA and FXMA, and being able to quickly eliminate any possible shorts is *enormously* valuable.

This should run the check twice, once with ~OEQ high and once low, to check for shorts on either side of FXMA.

Closed 2018-07-21.

Thread 59 (2018-05-21):

ESD protection on Vio and Vsense pins

whitequark, 2018-05-21:
FXMA108 gives us ESD protection on all I/O pins. However, what about the ADC and the LDO? In particular, the turned off LDO has the output in hi-Z state, which seems like it might have bad implications. Verify.

awygle, 2018-05-22:
The LDO has 2 kV ESD tolerance, the ADC has 2.5 kV (on the pins in question, under the human body model). The LDO rail has 4.7 uF of capacitance, and the ADC has 12 nF before the input pin. Given that the human body model specifies 200 pF of capacitance, we have an effective 250 kV of tolerance, which should be plenty.

See https://irclog.whitequark.org/~h~openfpga/2018-05-22#22149898; for discussion with @azonenberg on this topic.

whitequark, 2018-05-22:
Agreed.

Closed 2018-05-22.

Thread 62 (2018-07-21):

Use USB type C connector

whitequark, 2018-07-21:
I'm not really sure about this, but it seems mechanically quite a bit nicer than micro-USB, and, well, is the future. I don't think we need excessively small tolerances for just USB 2, but this needs to be verified.

whitequark, 2018-11-29:
Postponed as per request by @esden.

whitequark, 2019-03-08:
After careful consideration: revC will use micro-USB, revD will use micro-USB as well for interchangeability with revC, and revE is too far into future to plan for. As such, this wish is not for now relevant.

Closed 2019-03-08.

Thread 63 (2018-09-17):

Add alignment holes on stencil

whitequark, 2018-09-17:

whitequark, 2018-10-07:
They're there on both revA and revB, seems like a fab issue. DirtyPCBs *does* remind us that they use some weird kinda process to do stencils, so we've been warned.

Closed 2018-10-07.

Thread 64 (2018-10-06):

Implement combined, zero-configuration reset for USB FIFO and applet

whitequark, 2018-10-06:
Right now, all applets have to implement reset code (if any) themselves, via a dedicated I2C register. This is suboptimal because:
  * FIFO needs to be reset at the same time as applet, or there could be stale data going in either direction;
  * this is another thing applets have but don't need to care about;
  * I2C register numbering isn't stable and any use of applets with non-Glasgow software suffers greatly because of this, as reset is an essential function.

We need to add I2C reset register configuration to the FX2 configuration block and add a vendor request (unless USB has something useful) to reset the *interface*, which would also reset the *applet*.

whitequark, 2018-10-06:
Oh and this also effectively breaks ^C as a way to interrupt applets, so it's kind of critical.

whitequark, 2018-10-09:
@kevinmehall Thanks, this worked quite well. Though I didn't anticipate that SET INTERFACE would reset the EP toggles and was really puzzled for a while there.

Closed 2018-10-09.

Thread 65 (2018-10-06):

Add a logic analyzer mode

whitequark, 2018-10-06:
A logic analyzer mode is critical for three different reasons:
  * Glasgow must work as a logic analyzer.
  * Glasgow must allow debugging applets without an external logic analyzer, and especially see pin direction, and its relationship to commands.
  * Glasgow must be able to record traces of interaction with hardware in an applet-independent way, store them as test fixtures, and replay them in simulation, thus achieving end-to-end testing of applets.

The implicit assumption is that when using the logic analyzer, the applets implement synchronous logic, and may be paused at any point, which might be necessary because the analyzer FIFO becomes full (or surpasses high water mark), and the analyzer cannot record any more transitions. Thus, when analyzer FIFO is full, no new USB EP data is delivered to or from applets, and applets don't make any output transitions; if the external logic is fully synchronous, there will be no (or very few, in case there's something like an async R/B input) input transitions either. But, the analyzer has to tolerate overflows in case of asynchronous external logic anyway, as well as genuinely asynchronous applets,

The analyzer frontend should output data in VCD or similar high-level format. USB EP data should, at least, be present as proper hex (and ideally, even symbolized); we need `x` to indicate analyzer FIFO overflow; we'd like `z` for more compact direction indication; and it'd be ideal if we could even display pulls nicely. One trace per I/O pin with highly distinctive states (strong0/strong1/weak0/weak1/input0/input1) would be perfect. That said, something compatible with pulseview (because of its decoders) would be pretty nice, too.

Because of the high amount of physical channels, the analyzer must compress data well. For a 16 channel Glasgow, there are 48 binary analyzer channels just for the I/O cells in the maximum configuration (not all channels need to be continuously polled or placed; we don't care about transitions on unused inputs!), plus the FIFO traces.

Closed 2018-10-12.

Thread 67 (2018-10-07):

Add pullups/pulldowns on every pin

whitequark, 2018-10-07:
I thought about this a lot and pullups are *everywhere*. Having zero external component pullups is very important.

I suggest using TCA9534 plus a 4- or 8-wide resistor network to get tristate/pullup/pulldown capacity on every pin. It will have to be mounted on the bottom side and complicate routing even more, but it's worth the hassle.

Bikeshed: what should we make the pull value? 10k sounds good to me.

hardkrash, 2018-10-15:
Bikeshed... Red My favorite color.
- Nice pull values are between 3.3K for strong i2c pull-ups to 100k for weak drive chips.
- Consider a few channels with individual 0603 resistor or small surface mount 100k trimpot for easy changes.
  - e.g. Bournes TC33X-2-104E in series with 2.2k to 3.3k resistor to limit lower bound.

whitequark, 2018-10-15:
> Consider a few channels with individual 0603 resistor or small surface mount 100k trimpot for easy changes.
> * e.g. Bournes TC33X-2-104E in series with 2.2k to 3.3k resistor to limit lower bound.

I think I'll go with 5k or 10k for revC. I think further revs might use a current source instead of a pullup so you can use a current mirror to set their strength, but I'll need to find a suitable IC and/or make a larger board. I think revC board just doesn't have enough space for configurable pulls.

hardkrash, 2018-10-15:
i thought about a DAC + current mirror,  but didn't think of how to overcome compliance voltages with single supply 5V, unless this is not a concern with pulls.

It appears that digital-pots are not too expensive these days.  Something like a MCP4241 might work for less than $0.76 @ 5k qty with 8x per board, so $6.08 per board...

hardkrash, 2018-10-15:
Yea board space is always a problem.  I was not necessarily saying the digi-pots for rev C.
An add-on daughter card to have the digital-pots that mimics cordwood type interconnects using longer tails on the interconnects.  Any spare pins on the FPGA? It looked full on the schematic.

It the options are 5k or 10k, a user can always add a resistor externally if need be.

whitequark, 2018-10-15:
> Any spare pins on the FPGA? It looked full on the schematic.

Not on this one, but UP5K can't support revC anyway, so we're switching to HX8K.

> An add-on daughter card to have the digital-pots that mimics cordwood type interconnects using longer tails on the interconnects.

Not a bad idea! I should add some sort of header for I2C so you can hook up other stuff to the bus.

whitequark, 2018-11-22:
Mostly done in master, still needs level shifters for the TCAs.

marcan, 2018-11-25:
Done. What I ended up doing is adding 1.27mm female pin headers around the resistor network for the pull-ups. The user can then opt to desolder the resistor network and plug in their own resistors (discretes, daughtercard, or whatever).

Closed 2018-11-25.

Thread 68 (2018-10-15):

Expose on-board I2C for accessories

whitequark, 2018-10-15:
As suggested in https://github.com/whitequark/Glasgow/issues/67#issuecomment-429797935.

marcan, 2018-11-28:
Do we want to do this / what would it look like?

We currently have I²C testpoints. Those could easily be replaced with a 3x2.54mm header (I2C+GND), but I think that may run up the wave soldering keepouts against some decoupling caps.

marcan, 2018-11-28:
There's also a spot centered on the board, to the right of the TCAs, where this would fit vertically and not screw up the wave soldering more.

whitequark, 2018-11-28:
I feel like this ought to be addressed systematically. Let's leave this out of C0; if someone wants digipots, they can use the testpoints. Once the need and a good path forward is clear, we can add this.

marcan, 2018-11-28:
Yeah, we'd need supplies to make this actually useful (and depending on what the user is doing, that might mean 3V3 or VioA or VioB or even also 5V)

marcan, 2018-11-28:
Just for reference since I already tried it, this is what it would look like with just SDA/SCL/GND (modulo fixing the silkscreen):
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

whitequark, 2018-11-28:
> Yeah, we'd need supplies to make this actually useful (and depending on what the user is doing, that might mean 3V3 or VioA or VioB or even also 5V)

Yes. And we can't extend J6/J7, since there's no space...

whitequark, 2019-03-12:
My additional experience with I2C on revC0 indicates that *any* fault on the bus tends to bring the device to its knees until it's power cycled, and USB is not helping here a lot either. Therefore I do not think exposing I2C on revC or revD is a good idea. revE would probably have an I2C switch (or multiple) but that's quite a long time off.

whitequark, 2019-03-12:
To be clear, zealous handling of I2C errors is something that's *possible* to do, but given that errors on the bus potentially affect DUT reliability (e.g.: your DUT can't handle voltages on its inputs while it's not powered, you unplug the DUT, but Glasgow has an I2C bus fault and doesn't shut down the LDO) I am very hesitant to go that route.

And even if we do handle all I2C errors, we'd still have to invest a lot of time into making sure every I2C device can be properly reset, the resets don't lead to glitches (this part is almost impossible), and we have a sound way to test this by fault injection, which is not something I think we can afford for revC/D either.

marcan, 2019-03-12:
Strongly agree given what I've seen recently. Exposed I²C needs to be behind an isolator/mux.

whitequark, 2019-03-12:
It's also kind of ridiculous that most I2C muxes are controlled via I2C. I think the only reliable way to use such a mux is to just reset it every single time before writing a new command byte to it, because otherwise you introduce timeouts--a software minefield--and latency--which can blow your deadlines.

marcan, 2019-03-12:
Yeah, I was thinking about that too. This is only going to work if the mux has a reset line we can control, so we can unwedge it if a downstream peripheral is stupid. We probably don't have to worry much about sub-buses that we control, but we'd need to bracket any external I²C comms with mux resets to cleanly isolate external faults from internal peripherals.

whitequark, 2019-03-12:
> This is only going to work if the mux has a reset line we can control, so we can unwedge it if a downstream peripheral is stupid.

Right, but we don't have any pins on FX2 we can use for a mux reset line on revD, so I think this isn't happening for revD either. (We could technically put LDO enable lines under an I2C GPIO expander, but this is getting quite absurd at this point.)

marcan, 2019-03-12:
Yes, that's a dealbreaker for revD. It's going to depend on how that road goes when we get there. I think there's still a good chance we decide we need more GPIOs anyway and end up using an expander, or something else. If things go in a direction where this is doable, why not do it. If no, then not.

whitequark, 2019-03-12:
I am weakly against having such a feature on revD and not having it on revC for the following reason. revC and revD are supposed to be more or less equivalent, with the understanding that you trade off LVDS capability for double the I/O count. An adapter board should, ideally, work with both. That said, maybe I'll change my mind.

whitequark, 2019-04-01:
Let's keep this open until we figure out for sure whether there's going to be a mux before revE.

whitequark, 2019-04-01:
I'm thinking we could use the "aux" connector on revC to make the FPGA "proxy" I²C if it comes to that. But I still think that a solution that only uses the normal I/O bank pins is more robust...

electroniceel, 2019-04-01:
(continuing from #117)
For an analog addon board, I'd like to have access to the internal I2C and 5V. Having 3V3 would also make sense since the I2C is using 3V3 levels.

I propose to use the space below the Sync-header for this. In the current revC design this place seems to be unused on most layers and the signals mentioned are already running near that place. The sync header would have to be replaced by a vertical 3x2 pin header. This way it could still be used with pin sockets like in the current design.

The addon board could route through the sync signal and provide it on a pin header again, so you could use the sync with the addon board installed.

---------

About I2C muxes / isolators:

The problems you talk about appear when hotplugging something into the internal I2C bus, correct? Is hotplugging necessary? Wouldn't it be possible to adapt the spec of Glasgow to just allow plugging something in/out of the internal I2C when Glasgow is unpowered? Something like "the shrouded headers are secured against for hotplugging & ESD, everything else is not".

You could of course add a mux with reset and so on to guard the internal I2C against influence from outside, but that will add extra cost and needs board space. Is hotplugging an addon board that important?

-----------

About controlling the addon board with some pins from the regular port a or b:

- I'd still need power, preferably 5V
- It makes it hard to properly autodetect if an addon board is installed and which. I'd have put an I2C EEPROM on the addon board which an applet could read and then automatically enable functions, hooks and so on for the addon board. Using regular io pins like this could interfere with the DUT
- The analog board I envision would just minimally interfere with regular Glasgow usage (maybe a few ohms series resistance, a few more parasitic pf). It routes through all of port A and B and I'd constantly leave it plugged into Glasgow. It just adds extra features like ADC on each pin or uses hooks into the regular applets to allow stuff like autodetecting voltages.

whitequark, 2019-04-01:
> The problems you talk about appear when hotplugging something into the internal I2C bus, correct? Is hotplugging necessary? Wouldn't it be possible to adapt the spec of Glasgow to just allow plugging something in/out of the internal I2C when Glasgow is unpowered? Something like "the shrouded headers are secured against for hotplugging & ESD, everything else is not".

No, it's not just hotplugging. Adding things on the internal I²C bus means this internal bus is more likely to misbehave. It is, in fact, very easy to make I²C misbehave, as anyone who's ever worked with it can tell you. Right now, we have a few carefully selected components on it, which are thoroughly tested, and so I'm quite certain that in normal operation it's not going to misbehave. (Consider how we thought we took good care of the added I²C level shifters in revC0, and how much breakage that caused.)

Glitches and strange behavior on the internal I²C bus mean two things.

  1. If the FX2 cannot get a response from I²C in time, it (currently) hangs. It is possible to add timeouts to it, but AFAIK not all I²C fault conditions are recoverable. I think the fault condition where a device is stuck transmitting an ACK bit because it waits for the master to toggle clock, and the master is stuck because it thinks there's bus contention, is not recoverable with FX2.
  2. If the FX2 is stuck, it will not be able to turn off Vio in case Vsense goes out of range. The voltage range alert function is supposed to protect a DUT from being powered via its digital pins in case the DUT power is lost but Glasgow still drives it. Right now, I'm confident that it will do its job in almost any circumstances (I've never seen it fail, at least) but with your change there is no confidence at all.

Robustness, especially robustness against operator error, is a core design principle of Glasgow and I will not compromise on it. In fact, if I had the option, I would not use I²C at all; the current use of I²C for a few carefully selected and tested chips on the board is a compromise. Unfortunately FX2 doesn't really leave  any options here.

Exposing the internal I²C bus to arbitrary peripherals will reduce this robustness significantly and so it will not happen. An I²C mux that is reset out of band on every single I²C transaction is probably good enough (though it needs validation), but we physically lack the board space to fit one on revC, so it's not going to happen on that revision.

> I propose to use the space below the Sync-header for this. In the current revC design this place seems to be unused on most layers and the signals mentioned are already running near that place. The sync header would have to be replaced by a vertical 3x2 pin header. This way it could still be used with pin sockets like in the current design.

I am **especially** opposed to this idea because it is very easy to miss the right row on the pin header when plugging in the sync cable and thus accidentally short the I²C bus to ground when sync activates. Or worse, 5V. That's never happening.

<hr>

So is there a reason your addon board can't use the AUX connector? It would need power; I think we could fit a 4th pin with 3V3 there, but then it wouldn't nicely fall on the 0.1" grid, which is a bit sad. I don't think 5V there is going to happen because that's just one slipped screwdriver away from a fried board.

whitequark, 2019-04-01:
I see these possible routes to addressing this:

  1. Do nothing. Cons: no defined way to autodetect addon boards or communicate with them.
  2. Explicitly define AUX as carrying I²C signals. Add pullups on it. Use the FPGA to proxy host I²C to AUX I²C, or maybe use gateware to drive AUX I²C directly. Cons: requires FPGA to be configured before the addon EEPROM can be read; does not protect FPGA from ESD or overvoltage at all; gateware complexity, potential timing problems; we lose AUX pins for other applications.
  3. Add an I²C buffer with enable in the smallest reasonable package (I think PCA9306 fits between the level shifters), and route the enable to the FX2 so that it can enable that only while trying to communicate with the addon board. Cons: we absolutely have to use an I²C expander on revD now to control LDOs; restricts the addresses that can be used by addon boards (but I think 0x50 still works, and this is statically detectable anyway); we lose AUX pins for other applications.

Common for both 2 and 3 is the problem that only one addon board can use the AUX connector and it has to go over both of the ports.

Common for both 2 and 3 is the problem that if we expand AUX any further it stops being wave solderable.

@marcan What are your thoughts?

whitequark, 2019-04-01:
> 3\. I think PCA9306 fits between the level shifters

Of course, PCA9306 is another one of those awful I²C devices that come with severe restrictions on operating them that make them unsuitable for us. TCA9517 wouldn't fit. TCA9406 fits, but it has internal pullups that are disabled if OE is inactive, which rules it out for our application. TCA4311 seems ideal for our application but it wouldn't fit. PCA9515 wouldn't fit.

So that's pretty much the entire TI I²C buffer lineup ruled out for this application. This isn't going so well.

whitequark, 2019-04-01:
@electroniceel So, the I²C switch exists (a regular analog switch can be used in this application if level translation is not required), but we couldn't find a connector configuration that would work well in this appliaction. Here's the [IRC log](https://freenode.irclog.whitequark.org/glasgow/2019-04-01#1554131987-1554133790;).

I think revC1 is too far into the pipeline to do any kind of major change at this point, and there is no way to make this supported *well* without major changes. I think it is more important to support expandability *well* than to support it *at all*. The decisions we make right now (if we do), we're going to be stuck with them for the rest of eternity, like Arduino is now stuck with their misaligned connectors.

So, we will prototype something for revD0 and then, if it works out, backport it to revC2 or something. But there's no way to easily add this capability in a way that we can support forever, and it's too late to add it the hard way, so it's not going to be there in revC1.

marcan, 2019-04-01:
@electroniceel So here's a proposal. We can't really come up with a "nice" official way of doing what you want on revC, but what we can do is make it easier to do unofficially. So: we're freeing up pin #20 on the IO connectors (previously GND); this makes 19 and 20 both no connect. We will probably use those for something in the future, but for now, this gives you a total of 4 spare pins on the existing connectors. We'll also put I²C, 5V, 3V3 testpoints on the bottom of the board. This way, you can prototype your whole-Glasgow analog expansion board by just adding 4 fly-wires to the bottom of the board, assigning I²C and either or both supplies to the four extra pins on ports A and B combined. Then your board can just connect to the existing IO connectors, and can be easily connected and removed.

To be clear, we aren't going to implement this officially like this in any future revision, but at least this gives you a reasonable way to do it on revC1 unofficially, without requiring any extra hanging connectors or other horrible mods, just four wires on the bottom. This also allows you and others to experiment with other ideas, e.g. connecting I²C to both connectors (for standalone single-bank addons), or a supply to both connectors (for people who just want a big fat 5V to power something exceeding the Vio capability), or putting the AUX pins somewhere (for people who just need that one extra IO).

electroniceel, 2019-04-01:
I don't know of a suitable I2C switch that is small enough either. So I can understand you moving official support to the next board revision. The unconnected pins on the io header are ok for development and a prototype board.

If you plan on putting the testpoints below the sync header, you'd have space to use through hole ones. If you want to solder wires to them, through hole is much more sturdy. I don't care if they are filled with tin from wave soldering.

I suggest to add some silkscreen markers (for example on the back side) indicating the unconnected pins on the port headers. Not that someone expects ground there. Maybe extend that to printing the numbers, sense, Vio. I tend to forget the pinout and hate having to look it up all the time.

-------------------

revD is planned to have the same fx2 and ice40, but more port IOs instead of LVDS, correct?
I guess you'd need more board space for that. Do you plan to completely redesign the physical layout or do you plan to keep some compatibility, like the distance and layout of the shrouded port headers?

------------

I'm a bit sceptical if using '66 muxes in the next revision will help against the I2c logic of the fx2 locking up: if the glitch, emi,... happens while the autodetection code tries to search for an addon board, the fx2 may still lock up. So I think to solve this you'd need a full i2c switch with it's own i2c logic and an external reset, something like the PCA9546A (won't fit the current board of course).

I can fully understand your frustration with I2C. I had my share of lockup problems on projects I worked on. But if you are not keen on adding microcontrollers (see https://github.com/GlasgowEmbedded/Glasgow/issues/115#issuecomment-472180630) there aren't many alternatives left. I use open drain UART as bus on several of my projects and that works well. But all members are microcontrollers and it is just single-master.

-----------------

> I don't think 5V there is going to happen because that's just one slipped screwdriver away from a
> fried board.

You already have a 5V test pin exposed, also the legs of the components. A screwdriver, metal scrap or whatever there can fry your board too. If you want to properly protect a bare board against that, you'd need thick conformal coating everywhere. Don't think that makes sense.

Just use a case that encloses the whole board and just leaves the port headers and usb exposed. 3D printed, laser cut acrylic, whatever.

I need 5V for the analog muxes. Also an addon board may need some switching converters to create additional power rails. It is not efficient or easy to run them from 3V3. Especially during startup they can draw a lot of current to charge the output caps. The 3V3 may dip from this and that could cause stability issues somewhere else on Glasgow. A complex power sequence logic is not what you want.

whitequark, 2019-04-02:
> revD is planned to have the same fx2 and ice40, but more port IOs instead of LVDS, correct?

We'd need to go to the HX8K in CB256 package as there aren't enough FPGA balls for four I/O banks.

> I'm a bit sceptical if using '66 muxes in the next revision will help against the I2c logic of the fx2 locking up: if the glitch, emi,... happens while the autodetection code tries to search for an addon board, the fx2 may still lock up. So I think to solve this you'd need a full i2c switch with it's own i2c logic and an external reset, something like the PCA9546A (won't fit the current board of course).

I agree that isolating the internal I²C devices completely would be more reliable than connecting the I²C on addon board to the main bus. That pretty much rules out exposed I²C on revC.

> But if you are not keen on adding microcontrollers (see [#115 (comment)](https://github.com/GlasgowEmbedded/Glasgow/issues/115#issuecomment-472180630)) there aren't many alternatives left.

Correct. But I think "no autodetection" is also a perfectly reasonable approach. It's not that important.

> I use open drain UART as bus on several of my projects and that works well. But all members are microcontrollers and it is just single-master.

I've considered open-drain UART, but the FX2 has neither spare pins for it nor processing power to bitbang UART in software at any reasonable baud rate. So it's not a great solution.

> You already have a 5V test pin exposed, also the legs of the components. A screwdriver, metal scrap or whatever there can fry your board too. If you want to properly protect a bare board against that, you'd need thick conformal coating everywhere. Don't think that makes sense.

You misunderstood. **If** the AUX connector is exposed to addon boards, it will have a corresponding opening in the case, so even if you have a board that is enclosed, it's still very easy to short it. If it is **not** exposed to addon boards, having 5V on it is about as bad as having it on the test points (i.e. not very bad), but it's also pointless for the purposes of addon boards.

Also, I'd be totally behind a thick conformal coating if I knew of a way to economically apply it while masking all the sensitive areas, like the connectors for customizing pull resistors. I don't think that exists, though?

> A complex power sequence logic is not what you want.

We have a power sequencer that will take care of this. The FX2 has it as one of its requirements, though I've never seen anyone else actually use one.

> I need 5V for the analog muxes. Also an addon board may need some switching converters to create additional power rails. It is not efficient or easy to run them from 3V3. Especially during startup they can draw a lot of current to charge the output caps.

This is true, but keep in mind that I've never planned for addon boards that would be active independent of Vio. All of the addon boards I was thinking about are things like passive adapters to IC sockets, serializers/deserializers, ADCs or DACs that are directly controlled by the applet, and so on.

And for good reason! As this issue nicely demonstrates, supporting such active addon boards well adds a massive amount of complexity (we haven't even touched software yet...). It's hard enough to make a purely digital multitool. Adding plug-and-play analog addons to it is nightmarish, and I don't believe I can pull it off at all without a lot of iteration--and the first iteration that will be shipped to the public is not it.

whitequark, 2019-04-02:
> **If** the AUX connector is exposed to addon boards, it will have a corresponding opening in the case, so even if you have a board that is enclosed, it's still very easy to short it. If it is **not** exposed to addon boards, having 5V on it is about as bad as having it on the test points (i.e. not very bad), but it's also pointless for the purposes of addon boards.

Oh by the way, I am very much opposed to having always-active 5V on any pin of the IO bank connectors in any board revision. Absent-mindedly plugging a jumper wire into a pin next to the one I actually need, or to the wrong side of the connector because I'm looking at it the wrong way, is something I do *constantly*. Any such power pins will be on a separate connector next to the actual I/O bank.

electroniceel, 2019-04-02:
> You misunderstood. **If** the AUX connector is exposed to addon boards, it will have a corresponding opening in the case, so even if you have a board that is enclosed, it's still very easy to short it. If it is **not** exposed to addon boards, having 5V on it is about as bad as having it on the test points (i.e. not very bad), but it's also pointless for the purposes of addon boards.

Hmm. That all depends on the kind of case concept & design you have in mind.

If you have one case that covers Glasgow itself and addon boards connect through openings in this case, then you are right. But then the addon board is unprotected and can still be fried by touching metal parts. So the addon board would have to come with it's own case to protect itself.

So why not expect the addon board to provide a case that encloses Glasgow and the addon board together instead? In small volumes and 3d printing or laser cutting the price difference would be negligible. Then you wouldn't need openings in the case for the addon connectors.

> Also, I'd be totally behind a thick conformal coating if I knew of a way to economically apply it while masking all the sensitive areas, like the connectors for customizing pull resistors. I don't think that exists, though?

All conformal coating stuff I've seen being done was completely manual, with a brush or syringe-style applicator. That is expensive. But the biggest problem I see is that if you use proper coating, you can't remove it ever again. So it completely prevents replacing broken components, expansion, hacking, development,... - I think the intended audience for Glasgow values having these options.

electroniceel, 2019-04-02:
> Oh by the way, I am very much opposed to having always-active 5V on any pin of the IO bank connectors in any board revision.
I concur. They shouldn't be on io banks.

whitequark, 2019-04-02:
> So why not expect the addon board to provide a case that encloses Glasgow and the addon board together instead? In small volumes and 3d printing or laser cutting the price difference would be negligible. Then you wouldn't need openings in the case for the addon connectors.

I see your point, but I've never considered this kind of addon boards in the first place. Nothing in Glasgow is designed to support this use case well. Also, I can't really imagine any addon boards that would *always* want to be in the middle and between anything else you might connect, other than your analog board.

electroniceel, 2019-04-02:
> Also, I can't really imagine any addon boards that would _always_ want to be in the middle and between anything else you might connect, other than your analog board.

Ah, you mean the combined case makes changing addons more complicated? You have a point there.

Maybe the top part of the regular case could be made to easily snap in. Then the addon-case could be made to snap into the same position instead. Don't think that works with the laser cut acrylic designs I know of. Would probably mean 3d printing.

Another idea would be to have the regular Glasgow case have an opening for the addon connectors, but they are protected by a snap-on cover if not in use.

I think there are possible solutions for this, but the board design doesn't really depend on having a complete case design done. I'd just go forward with a case that protects the addon connectors. Providing users with a STL of a new case with access to the connectors is much more simple than to add connectors to a board that is already shipped without...

whitequark, 2019-04-02:
As described above, we can't physically fit a suitable I²C mux on revC and it's not reliable enough with a simple analog switch. So there isn't going to be an addon connector...

electroniceel, 2019-04-02:
I know. Was just thinking ahead for revD.

whitequark, 2019-04-02:
I think for revD we can provide a level translating mux (I think there are muxes that are explicitly ESD rated) and additional protection for any other purposes. I imagine I²C could be provided directly at the I/O bank as the passive adapters would then go for the easier solution, and the active adapters would make use of the additional 5V power.

electroniceel, 2019-04-02:
Good idea. An EEPROM for autodetecting passive addons like socket adapters would make sense to automatically use the correct pin mapping.

Thread 69 (2018-10-25):

Can we get SWD support?

ghost, 2018-10-25:
Is that possible while only using FOSS?

whitequark, 2018-10-25:
There is already a (preview quality) SWD applet! There's no actual gdbserver (or flasher) support *right now* mostly because I was going to integrate with @azonenberg's jtaghal, and jtaghal isn't evolving quite quickly enough. There will likely be native gdbserver support, the same as for MIPS EJTAG applet.

esden, 2018-10-25:
You might be able to plug it into https://github.com/orbcode/orbuculum

whitequark, 2018-10-25:
That's mostly pointless, it's just more C code I cannot actually distribute with Glasgow itself... Really, the protocol is not very complex.

whitequark, 2019-08-19:
Update: I will not even try to rely on jtaghal, Glasgow-native gdbserver is superior in every way.

JustAnother1, 2020-03-26:
I have done some work on SWD. Please let me know how I can help realize the SWD support.

whitequark, 2020-03-26:
There's a prototype of an SWD applet. What's missing is the actual debugger code. Currently the bottleneck is maintainer time / review bandwidth so there is little you can do to make things faster.

samlittlewood, 2020-03-26:
I have been picking at SWIM+stm8, programming only so far.

whitequark, 2020-03-26:
We should probably have a different issue for SWIM, as far as I remember it's a completely different protocol.

samlittlewood, 2020-03-26:
Certainly! I have a couple more branches from master for other protocols, but they are pretty gross atm. I'll create merge rqs when that have at least some utility.

wrongbaud, 2020-06-02:
Is it worth trying to write a driver for support with openocd? That's something I've done in the past and would be willing to work on.

whitequark, 2020-06-02:
Does openocd have something like the JTAG bitbang interface but for SWD? Anything that works through a socket rather than through libusb would work.

wrongbaud, 2020-06-02:
I believe so - I can start experimenting with this and report back if I find something.

whitequark, 2020-06-02:
We can quite easily add a `swd-openocd` applet like the existing `jtag-openocd` one, yep.

gimbas, 2020-06-12:
i never realized there was a `jtag-openocd` bridge, what are the limitations of it? how fast can the clock go? one of the things i wanted from the glasgow was to use it as a debugger programmer

whitequark, 2020-06-12:
As fast as the native JTAG applet allows, which is currently 6 MHz due to a temporary limitation while we're migrating from Migen to nMigen.

gimbas, 2020-06-12:
in that case that `swd-openocd` applet could prove real usefull to me, how far away in the horizon do you see that coming? not asking for a timeline, just a ballpark.

whitequark, 2020-06-12:
No idea if OpenOCD can even do the equivalent of that. @wrongbaud may be investigating that; you could take a look too if you want things earlier.

gimbas, 2020-06-12:
I have every intention of helping, especially on matters that are especially useful to me; I will look into it, though i am not very familiar with the inner workings of openocd. Also my glasgow is just a parts bin waiting to be assembled so i can't test anything.

gimbas, 2020-06-13:
So, i looked around the OpenOCD code.
Apparently, as it is right now, the `remote_bitbang` driver that is used with the `jtag-openocd` applet only supports JTAG, though i found two unmerged patches that added SWD support, i have no idea why they were left open, but they were trivial changes and if they actually worked it shouldn't be to hard to convince them to push them upstream, i have already opened a ticket asking about it.
That being said, if  the `remote_bitbang` supported SWD, not much would be needed in the glasgow applet side in order for it to work, am i correct?

whitequark, 2020-06-13:
> That being said, if the `remote_bitbang` supported SWD, not much would be needed in the glasgow applet side in order for it to work, am i correct?

Correct.

gimbas, 2020-06-26:
So, after opening the ticket there was some progress, one of the patches was rebased, but it needs to be tested, i cant do it myself, because my glasgow isn't ready, and i don't know how i could do it any other way.

If someone could look into this it would be great, i believe it should work.

Here's the ticket:
https://sourceforge.net/p/openocd/tickets/269/

electroniceel, 2020-06-28:
> If someone could look into this it would be great, i believe it should work.

I have a working Glasgow revC1 and would like to help, but I haven't used OpenOCD for some time. So what exactly should I do to test?

Take a recent OpenOCD and apply http://openocd.zylin.com/#/c/4205/
But what would be the next steps to get it running?

I have for example a STM32F072 and would hook up it's SWCLK and SWDIO to the Glasgow.

FFY00, 2020-07-07:
I think you just need to add the new commands to `JTAGOpenOCDSubtarget` and then you should be able to get glasgow to open a server, as shown in https://github.com/GlasgowEmbedded/glasgow/blob/8a277fe9bd609e9abfa8d3b526f95f7c4cdeeac9/software/glasgow/applet/interface/jtag_openocd/__init__.py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, and invoke openocd with the `stm32f0x` config.

Should look something like this:
```
openocd -c 'interface remote_bitbang; remote_bitbang_port 2222' -f /usr/share/openocd/scripts/target/stm32f0x.cfg
```

whitequark, 2020-07-07:
I don't think that would work, `JTAGOpenOCDApplet` can't electrically do SWD if I remember correctly.

FFY00, 2020-07-07:
Hum, okay. Then we can just copy it to a new applet and apply the required modifications.

gimbas, 2020-07-08:
I believe connecting to a target using SWD and that driver should be enough to approve the changes.

I don't think we actually need to change anything in the applet.

FFY00, 2020-07-08:
Well, you should need to test if the new commands actually work, no?

gimbas, 2020-07-08:
hm, i don't think i understood quite right how the applet worked, i guess you're right

whitequark, 2024-03-06:
We now have `swd-openocd`. I'm going to close this issue since it does enable SWD debugging and it'll likely be quite a while before I have bandwidth to either implement or review support for ADIv5 (including internal architecture changes needed to make it maintainable).

Closed 2024-03-06.

Thread 70 (2018-10-31):

Add a DNP resistor footprint between CYP_MEM A1 and Vcc

whitequark, 2018-10-31:
This is so you can easily recover from a failed flash by shorting it with a screwdriver or something.

whitequark, 2018-10-31:
Should be A1. First, it's equivalent to shorting pins 1 and 2 (already easy, but you have to remember the pinout). Second, it gives the EEPROM an unique address, unlike shorting A0 to Vcc.

Closed 2018-11-25.

Thread 73 (2018-10-31):

Pipeline USB reads

whitequark, 2018-10-31:
Right now, making very large latency-sensitive USB reads is done by giving `interface.read()` a `hint` with the amount of expected data, which causes it to use a buffer that large. Unfortunately, the following sequence still results in a FIFO underflow:

  1. `interface.read(512, hint=512*1000)` is called
  2. device returns a single 512-byte packet, `interface.read` returns
  3. processing starts; bus is idle (no IN-BULK-NAK)
  4. device queues 2 (4) more 512-byte packets, filling FX2 FIFO
  5. `interface.read(512, hint=512*1000)` is called again

Given how small the FX2+device FIFO are (at most a 2+30 KB on UP5K), the maximum fill rate (up to 30 KB per millisecond), and the OS scheduling latency (at best, a few milliseconds), if we get a context switch anywhere between steps 3 and 5, a FIFO underflow is unavoidable at the maximum fill rate, and becomes linearly less likely at fractions of maximum fill rate. This can be easily demonstrated with the `shugart-floppy` applet at higher read redundancies.

Thus, we have to teach the software to pipeline USB reads. Up to 30 MB/s of reads should *definitely* be doable in Python if no particular processing is done (`shugart-floppy` just appends reads to a buffer), and possibly even with processing.

whitequark, 2019-02-25:
There is an example of this in the `yamaha-opl` applet, which only needs to be generalized a bit.

Closed 2019-04-03.

Thread 74 (2018-11-21):

Applet regression tests

whitequark, 2018-11-21:
As the number of applets, many targeting very obscure hardware, grows, the need for applet regression tests is clear. In general, applets can be classified into three categories.

For the following applets, regression tests can be done by mocking the gateware interface wrapper (e.g. SPIMasterInterface for SPI flash and AVR flash, and so on). These are the easiest to test, have tests that run the fastest because it does not require simulating gateware, and have the most impact, because this is where most applet complexity lies.

- [ ] i2c-bmp280
- [ ] i2c-eeprom-24c
- [ ] i2c-tps6598x
- [ ] jtag-arc
- [ ] jtag-mec16xx
- [ ] jtag-mips
- [ ] jtag-svf
- [ ] jtag-xc9500
- [ ] spi-flash-25c
- [ ] spi-flash-avr

For the following applets, regression testing requires simulating gateware. This is slower, more complex and more fragile due to the need for non-cycle-accurate fuzzy matching, but is essential as these applets underlie many others. However, they both typically have less functionality and the hardware is easier to obtain.

- [ ] hd44780
- [ ] i2c-master
- [ ] jtag
- [ ] jtag-pinout
- [ ] nand-flash
- [ ] program-ice40
- [ ] shugart-floppy
- [ ] spi-master
- [ ] swd
- [ ] uart

The following applets are utility applets that only use Glasgow itself. They do not require regression testing or regression testing is meaningless for them due to their nature.

- benchmark
- selftest

The following applets cannot be regression tested within the generic framework due to reasons such as very high bit rate.

- rgb_grabber

Closed 2025-05-20.

Thread 76 (2018-11-22):

spi-flash-25c erase-program command broken

whitequark, 2018-11-22:
Causes a hang. Seems related to FX2 arbiter (#44?) as this happened after the arbiter was improved.

smunaut, 2019-01-03:
I think https://github.com/whitequark/Glasgow/pull/90/commits/c24d17a5d799b2f499ecb6c281084cf71f9b23bc might fix that.

whitequark, 2019-01-13:
Nope. Long reads (if you disable the hack below) still break.
https://github.com/whitequark/Glasgow/blob/12ba0124285fa5aa213b58ea142239f9fac83b56/software/glasgow/applet/spi_flash_25c/__init__.py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

whitequark, 2019-01-13:
Oh--my bad, I apologize! I haven't realized I did not merge that. Indeed, it works with your fix, thank you! You've saved me a lot of headache.

Thread 79 (2018-11-24):

Performance issues when writing lots of data

kbeckmann, 2018-11-24:
```
$ python -m glasgow.cli run benchmark sink -c 1000000
I: glasgow.applet.benchmark: running benchmark mode sink for 1.907 MiB
I: glasgow.applet.benchmark: mode sink: 1.182 MiB/s
$ python -m glasgow.cli run benchmark sink -c 5000000
I: glasgow.applet.benchmark: running benchmark mode sink for 9.537 MiB
I: glasgow.applet.benchmark: mode sink: 0.516 MiB/s
$ python -m glasgow.cli run benchmark sink -c 10000000
I: glasgow.applet.benchmark: running benchmark mode sink for 19.073 MiB
I: glasgow.applet.benchmark: mode sink: 0.302 MiB/s
```

I fixed this by using arrays of bytearrays in the class DirectDemultiplexerInterface. However when I do this I get some weird errors from libusb if I send lots of data. Maybe I just found a new bug instead, not sure!

With my patch:
```
$ python -m glasgow.cli run benchmark sink -c 1000000
I: glasgow.applet.benchmark: running benchmark mode sink for 1.907 MiB
I: glasgow.applet.benchmark: mode sink: 18.284 MiB/s
$ python -m glasgow.cli run benchmark sink -c 5000000
I: glasgow.applet.benchmark: running benchmark mode sink for 9.537 MiB
I: glasgow.applet.benchmark: mode sink: 18.310 MiB/s
$ python -m glasgow.cli run benchmark sink -c 10000000
I: glasgow.applet.benchmark: running benchmark mode sink for 19.073 MiB
Traceback (most recent call last):
  File "/usr/lib/python3.7/runpy.py", line 193, in _run_module_as_main
    "__main__", mod_spec)
  File "/usr/lib/python3.7/runpy.py", line 85, in _run_code
    exec(code, run_globals)
  File "/home/konrad/dev/Glasgow/software/glasgow/cli.py", line 694, in <module>
    main()
  File "/home/konrad/dev/Glasgow/software/glasgow/cli.py", line 690, in main
    exit(loop.run_until_complete(_main()))
  File "/usr/lib/python3.7/asyncio/base_events.py", line 573, in run_until_complete
    return future.result()
  File "/home/konrad/dev/Glasgow/software/glasgow/cli.py", line 485, in _main
    await task
  File "/home/konrad/dev/Glasgow/software/glasgow/cli.py", line 474, in run_applet
    iface = await applet.run(device, args)
  File "/home/konrad/dev/Glasgow/software/glasgow/applet/benchmark/__init__.py", line 141, in run
    await iface.write(golden)
  File "/home/konrad/dev/Glasgow/software/glasgow/access/direct/demultiplexer.py", line 114, in write
    await self._write_packet()
  File "/home/konrad/dev/Glasgow/software/glasgow/access/direct/demultiplexer.py", line 106, in _write_packet
    await self.device.bulk_write(self._endpoint_out, packet)
  File "/home/konrad/dev/Glasgow/software/glasgow/device/hardware.py", line 182, in bulk_write
    await self._do_transfer(is_read=False, setup=lambda transfer:
  File "/home/konrad/dev/Glasgow/software/glasgow/device/hardware.py", line 148, in _do_transfer
    transfer.submit()
  File "/usr/lib/python3.7/site-packages/usb1/__init__.py", line 821, in submit
    raiseUSBError(result)
  File "/usr/lib/python3.7/site-packages/usb1/__init__.py", line 125, in raiseUSBError
    raise __STATUS_TO_EXCEPTION_DICT.get(value, __USBError)(value)
usb1.USBErrorIO: LIBUSB_ERROR_IO [-1]
```

The patch in question:
```
diff --git a/software/glasgow/access/direct/demultiplexer.py b/software/glasgow/access/direct/demultiplexer.py
index e9a6cdc..bd949ed 100644
--- a/software/glasgow/access/direct/demultiplexer.py
+++ b/software/glasgow/access/direct/demultiplexer.py
@@ -63,7 +63,7 @@ class DirectDemultiplexerInterface(AccessDemultiplexerInterface):

         self._interface  = self.device.usb.claimInterface(self._pipe_num)
         self._buffer_in  = bytearray()
-        self._buffer_out = bytearray()
+        self._buffer_out = []

     async def reset(self):
         self.logger.trace("asserting reset")
@@ -102,19 +102,16 @@ class DirectDemultiplexerInterface(AccessDemultiplexerInterface):
         return result

     async def _write_packet(self):
-        packet = self._buffer_out[:self._out_packet_size]
-        self._buffer_out = self._buffer_out[self._out_packet_size:]
+        packet = self._buffer_out.pop(0)
         await self.device.bulk_write(self._endpoint_out, packet)

     async def write(self, data):
         if not isinstance(data, (bytes, bytearray)):
             data = bytes(data)

-        self.logger.trace("FIFO: write <%s>", data.hex())
-        self._buffer_out += data
-
-        if len(self._buffer_out) > self._out_packet_size:
-            await self._write_packet()
+        #self.logger.trace("FIFO: write <%s>", data.hex())
+        self._buffer_out.append(data)
+        await self._write_packet()

     async def flush(self):
         self.logger.trace("FIFO: flush")
```

It also helped to comment out the trace log even if I don't run with -v. Compile-time logs would probably fix this but I'm not a python-ninja so have no clue how to do that properly. (Goes from 18.x to 17.x MB/s when that line is commented out, so it's not a huge problem but still noticeable.)

whitequark, 2018-11-24:
> I fixed this by using arrays of bytearrays in the class DirectDemultiplexerInterface.

Nice! I was aware that there is a bottleneck somewhere but deliberately did not pursue it so far. Thanks for tracking it down!

> Compile-time logs would probably fix this but I'm not a python-ninja so have no clue how to do that properly.

This has been on my plans for a while. I'm not yet sure what's the best way to do it, I think some decorator and bytecode hacking could help, but it's somewhat of an open problem.

> However when I do this I get some weird errors from libusb if I send lots of data.

Yeah. So, on Linux, you cannot send a chunk more than a few MB in size (I think I got about 16 MiB in my tests) with libusb. I think it's a kernel limitation, or possibly HCI driver. I'm not sure if it's documented anywhere, I certainly haven't found one.

This is why the Python code chunks the packets right now. (Should've probably added a comment there.)

Think you could investigate alternative chunking strategies? If I was doing it, I would have added a new class, perhaps `ChunkedFIFO`, which would do the following:

   * Store bytes or bytearray objects provided via `.push()` in a FIFO structure;
   * Each time `.pop()` is called, locate the object at the head;
   * If it is under some "safe limit" (1 MiB?), return it directly;
   * Otherwise, return Python's "memory view" (zero-copy view into another buffer) pointing into the chunk, and track current offset.

But you're free to go with another strategy if I'm missing something.

kbeckmann, 2018-11-30:
Sorry I had quite a busy week behind me, thanks for fixing it! It seems to work really well.

Closed 2018-11-30.

Thread 89 (2018-12-05):

Use SB_GB_IO instead of SB_IO+SB_GB

whitequark, 2018-12-05:
SB_GB_IO has a much lower (and completely predictable!) delay than SB_IO + SB_GB pair we are using now. In fact, using the latter pair has been observed to (rarely) lead to selftest failures due to setup/hold violations on FD pins.

Unfortunately, simply switching to SB_GB_IO completely breaks FX2 timing. I have adjusted the strobes to work (without actually trying to think of a proper solution) in the `sb_gb_io` branch, but really, a model of the FX2 bus *and* tests are necessary to fix this properly. See #44.

smunaut, 2018-12-06:
I've been looking into the timings between the FX2 and ICE interface.

### ICE to FX2

The ICE has a clock-to-out somewhere between 9 and 10 ns. (relative to the `if_clk` at the fpga pad).
The FX2 has requirements for up to 11 ns setup time (depends on which signal) and 0ns hold time.

So this works just fine. The data valid window of the ICE outputs entirely cover the data capture window of the FX2 with plenty of margins. Whatever the ICE outputs will be captured on the next rising clk edge by the FX2.

See diagram below :

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

### FX2 to ICE

The FX2 is a bit under-specified in its clock-to-out. There is only a max value of 11 ns but no minimum value, so we have to assume that the data isn't valid at all from the clock edge up to 11 ns after it.

In the ICE40 it takes a long time for the clock to go from the pad to the actual `SB_IO` register, so the data capture window is well after the clock edge has happened. The setup time is -1.3 ns and hold time is 5.6 ns.

So this means that the ICE40 data capture window is right in the middle of the unstable part of the FX2 output :/  See diagram below.

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

The best way to solve this would be to use the DDR registers in the `SB_IO` to capture the window on the falling edge of `if_clk` and then immediate re-register it in a fabric `DFF` on the rising edge. This way the data would be captured in the valid zone and the fpga logic would see whatever is output by the FX2 on the next rising edge of `if_clk`.

### Details

Attached the timing report from icecube to get details on the IO timings. Also attached the sources for the wavedrom drawings.

[timing.txt](https://github.com/whitequark/Glasgow/files/2652993/timing.txt)
[fx2_to_ice.json.txt](https://github.com/whitequark/Glasgow/files/2652996/fx2_to_ice.json.txt)
[ice_to_fx2.json.txt](https://github.com/whitequark/Glasgow/files/2652997/ice_to_fx2.json.txt)

whitequark, 2019-01-13:
Thank you for your analysis again! I'm not entirely sure about one facet here:

> The best way to solve this would be to use the DDR registers in the `SB_IO` to capture the window on the falling edge of `if_clk` and then immediate re-register it in a fabric `DFF` on the rising edge.

Do I understand it correctly that this adds another cycle of latency with regards to the current arrangement with `PIN_INPUT_REGISTERED`?

whitequark, 2019-01-13:
Looks like my understanding is correct. Therefore, there is a problem with this solution. Namely, what happens when we are filling an IN FIFO and it becomes full? With one register, FX2 has an `INFM1` bit, which causes the FIFO flag (which is also registered like this!) to go low one sample before the FIFO is actually full. But there is no `INFM2` flag!

(I'm not sure how `INFM1` actually works--is it effectively the same as using a programmable flag with level set to depth minus two, as opposed to depth minus one? If yes, we could just use a PF then.)

smunaut, 2019-01-13:
Mmm, that's weird I would have thought that the latency would be the same.

If we look at the 'orange' data cycle for the fx2_out in the diagram above. In the previous implementation, I would have assumed that what the ice40 captured during the invalid window was that orange cycle data like I put on the diagram.  And so if you capture on the falling edge, you essentially move that capture window half a cycle earlier than currently, and then re-registering it once on the rising edge in the fabric would bring it "in-alignement" with what the `PIN_INPUT_REGISTERED` version was doing previously.

whitequark, 2019-02-09:
@smunaut I'd like to ask you for a favor. Can you please take another look at the timings of this interface, but this time, assuming externally sourced (in the FPGA) CLKIF, where the CLKIF output is produced using a DDR register with `.D_OUT_0(0)`, `D_OUT_1(1)`. I suspect this might simplify things radically.

whitequark, 2019-03-18:
@smunaut Bad news: this doesn't help. With the video-rgb-input applet, there is digital snow on the output, which I know for sure is caused by timings mismatch between ICE and FX2. I have a bitstream I made half a year ago that doesn't have this problem but I have no idea how to reproduce it.

There's still something else wrong with the arbiter.

whitequark, 2019-03-19:
Looks like ae5cbc1d81f39dfa423d3fd879f7f627fd1091af is the good commit. Bisecting now.

whitequark, 2019-03-19:
I've bisected this down to... 630b524ae3c71437ab217c73ad154780646ec4e6. Which is not really of help.

whitequark, 2019-04-02:
I've made a standalone way to reproduce the glitches. First, apply this patch:

<details>

```diff
diff --git a/software/glasgow/applet/video/rgb_input/__init__.py b/software/glasgow/applet/video/rgb_input/__init__.py
index aa8ee9d..f472b19 100644
--- a/software/glasgow/applet/video/rgb_input/__init__.py
+++ b/software/glasgow/applet/video/rgb_input/__init__.py
@@ -3,6 +3,7 @@ import math
 from migen import *
 from migen.genlib.cdc import *

+from ....gateware.clockgen import *
 from ... import *

@@ -12,12 +13,15 @@ class VideoRGBInputSubtarget(Module):
         gx    = Signal(5)
         bx    = Signal(5)
         dck   = Signal()
-        self.specials += [
-            MultiReg(pads.r_t.i, rx),
-            MultiReg(pads.g_t.i, gx),
-            MultiReg(pads.b_t.i, bx),
-            MultiReg(pads.dck_t.i, dck)
-        ]
+        # self.specials += [
+        #     MultiReg(pads.r_t.i, rx),
+        #     MultiReg(pads.g_t.i, gx),
+        #     MultiReg(pads.b_t.i, bx),
+        #     MultiReg(pads.dck_t.i, dck)
+        # ]
+
+        self.submodules.clockgen = ClockGen(ClockGen.derive(sys_clk_freq, 1.4e6))
+        self.comb += dck.eq(self.clockgen.clk)

         dck_r = Signal()
         stb   = Signal()
@@ -59,7 +63,7 @@ class VideoRGBInputSubtarget(Module):
                     NextState("SKIP-FIRST-PIXEL")
                 ).Elif(row == rows,
                     NextValue(row, 0),
-                    NextState("REPORT-FRAME")
+                    NextState("CAPTURE-ROW")
                 ).Else(
                     NextState("REPORT-FRAME")
                 )
@@ -86,7 +90,7 @@ class VideoRGBInputSubtarget(Module):
             ("REPORT-3", 10, "CAPTURE-PIXEL")
         ):
             self.fsm.act(state,
-                din.eq((pixel >> offset) & 0x1f),
+                din.eq(col & 0x1f),#(pixel >> offset) & 0x1f),
                 we.eq(1),
                 NextState(nextstate)
             )
```
</details>

Second, run:

    glasgow run video-rgb-input --port AB --voltage 3.3 --rows 145 --columns 160 --vblank 960e-6

Third, run:

    git clone https://github.com/whitequark/gameboy-grabber/
    cd gameboy-grabber
    cargo run

This is what it should display:

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

This is what it displays:

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

cc @smunaut @marcan

whitequark, 2019-04-02:
Looks pretty much the same on revB:
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

whitequark, 2019-04-02:
My question on the Cypress forum: https://community.cypress.com/message/191835

enjoy-digital, 2019-04-02:
Have you tried eliminating the FIFO datapath from the equation? (If the corruption is on the first valid cycle after interruption, it also means it's the first data outputed by the fifo after being empty, which is also a corner case). I would personally do a test by keeping the exact same control flow and just replace the FIFO data that is going to the FX2 with a counter and see if you also have the corruption. (but maybe you already verified that).

whitequark, 2019-04-02:
@enjoy-digital You are right! There's no corruption if I replace the FIFO with a counter. But... the FIFO is just migen's SyncFIFOBuffered...

enjoy-digital, 2019-04-02:
Then it seems there is a mismatch between the control/data path for this corner case on the FIFO. I'm using the same FIFO on several designs in situations that very similar (mostly on Xilinx device). Maybe something is not handled correclty in the toolchain. At least it shows the issue is probably not on the FX2 side.

whitequark, 2019-04-02:
Yeah...

daveshah1, 2019-04-02:
Do you have YosysHQ/yosys#896 in your Yosys tree?

whitequark, 2019-04-02:
@daveshah1 If I use Yosys master instead of whichever old commit I've had, it segfaults.

whitequark, 2019-04-02:
@gregdavill Repro: [bug.zip](https://github.com/GlasgowEmbedded/Glasgow/files/3034491/bug.zip)

daveshah1, 2019-04-02:
Hmm, can't reproduce and Valgrind shows nothing either over here. But it doesn't hit the #896 case either, so that's not related anyway.

whitequark, 2019-04-02:
@daveshah1 Valgrind log of the crash:
<details>

```
3.10.6. Executing OPT_RMDFF pass (remove dff with constant values).
==7696== Conditional jump or move depends on uninitialised value(s)
==7696==    at 0x66DE72: std::_Rb_tree<Yosys::RTLIL::Cell*, Yosys::RTLIL::Cell*, std::_Identity<Yosys::RTLIL::Cell*>, std::less<Yosys::RTLIL::Cell*>, std::allocator<Yosys::RTLIL::Cell*> >::_M_erase(std::_Rb_tree_node<Yosys::RTLIL::Cell*>*) (stl_tree.h:1870)
==7696==    by 0x66DFB5: std::_Rb_tree<Yosys::RTLIL::Cell*, Yosys::RTLIL::Cell*, std::_Identity<Yosys::RTLIL::Cell*>, std::less<Yosys::RTLIL::Cell*>, std::allocator<Yosys::RTLIL::Cell*> >::~_Rb_tree() (stl_tree.h:965)
==7696==    by 0x877D60: ~set (stl_set.h:281)
==7696==    by 0x877D60: ~pair (stl_pair.h:193)
==7696==    by 0x877D60: ~entry_t (hashlib.h:202)
==7696==    by 0x877D60: _Destroy<Yosys::hashlib::dict<Yosys::SigSet<Yosys::RTLIL::Cell *, std::less<Yosys::RTLIL::Cell *> >::bitDef_t, std::set<Yosys::RTLIL::Cell *, std::less<Yosys::RTLIL::Cell *>, std::allocator<Yosys::RTLIL::Cell *> >, Yosys::hashlib::hash_ops<Yosys::SigSet<Yosys::RTLIL::Cell *, std::less<Yosys::RTLIL::Cell *> >::bitDef_t> >::entry_t> (stl_construct.h:98)
==7696==    by 0x877D60: __destroy<Yosys::hashlib::dict<Yosys::SigSet<Yosys::RTLIL::Cell *, std::less<Yosys::RTLIL::Cell *> >::bitDef_t, std::set<Yosys::RTLIL::Cell *, std::less<Yosys::RTLIL::Cell *>, std::allocator<Yosys::RTLIL::Cell *> >, Yosys::hashlib::hash_ops<Yosys::SigSet<Yosys::RTLIL::Cell *, std::less<Yosys::RTLIL::Cell *> >::bitDef_t> >::entry_t *> (stl_construct.h:108)
==7696==    by 0x877D60: _Destroy<Yosys::hashlib::dict<Yosys::SigSet<Yosys::RTLIL::Cell *, std::less<Yosys::RTLIL::Cell *> >::bitDef_t, std::set<Yosys::RTLIL::Cell *, std::less<Yosys::RTLIL::Cell *>, std::allocator<Yosys::RTLIL::Cell *> >, Yosys::hashlib::hash_ops<Yosys::SigSet<Yosys::RTLIL::Cell *, std::less<Yosys::RTLIL::Cell *> >::bitDef_t> >::entry_t *> (stl_construct.h:136)
==7696==    by 0x877D60: _Destroy<Yosys::hashlib::dict<Yosys::SigSet<Yosys::RTLIL::Cell *, std::less<Yosys::RTLIL::Cell *> >::bitDef_t, std::set<Yosys::RTLIL::Cell *, std::less<Yosys::RTLIL::Cell *>, std::allocator<Yosys::RTLIL::Cell *> >, Yosys::hashlib::hash_ops<Yosys::SigSet<Yosys::RTLIL::Cell *, std::less<Yosys::RTLIL::Cell *> >::bitDef_t> >::entry_t *, Yosys::hashlib::dict<Yosys::SigSet<Yosys::RTLIL::Cell *, std::less<Yosys::RTLIL::Cell *> >::bitDef_t, std::set<Yosys::RTLIL::Cell *, std::less<Yosys::RTLIL::Cell *>, std::allocator<Yosys::RTLIL::Cell *> >, Yosys::hashlib::hash_ops<Yosys::SigSet<Yosys::RTLIL::Cell *, std::less<Yosys::RTLIL::Cell *> >::bitDef_t> >::entry_t> (stl_construct.h:206)
==7696==    by 0x877D60: _M_erase_at_end (stl_vector.h:1658)
==7696==    by 0x877D60: clear (stl_vector.h:1386)
==7696==    by 0x877D60: clear (hashlib.h:557)
==7696==    by 0x877D60: Yosys::SigSet<Yosys::RTLIL::Cell*, std::less<Yosys::RTLIL::Cell*> >::clear() (sigtools.h:151)
==7696==    by 0x872BA3: (anonymous namespace)::OptRmdffPass::execute(std::vector<std::__cxx11::basic_string<char, std::char_traits<char>, std::allocator<char> >, std::allocator<std::__cxx11::basic_string<char, std::char_traits<char>, std::allocator<char> > > >, Yosys::RTLIL::Design*) (opt_rmdff.cc:542)
==7696==    by 0x52E658: Yosys::Pass::call(Yosys::RTLIL::Design*, std::vector<std::__cxx11::basic_string<char, std::char_traits<char>, std::allocator<char> >, std::allocator<std::__cxx11::basic_string<char, std::char_traits<char>, std::allocator<char> > > >) (register.cc:234)
==7696==    by 0x52E2AB: Yosys::Pass::call(Yosys::RTLIL::Design*, std::__cxx11::basic_string<char, std::char_traits<char>, std::allocator<char> >) (register.cc:214)
==7696==    by 0x85EA69: (anonymous namespace)::OptPass::execute(std::vector<std::__cxx11::basic_string<char, std::char_traits<char>, std::allocator<char> >, std::allocator<std::__cxx11::basic_string<char, std::char_traits<char>, std::allocator<char> > > >, Yosys::RTLIL::Design*) (opt.cc:150)
==7696==    by 0x52E658: Yosys::Pass::call(Yosys::RTLIL::Design*, std::vector<std::__cxx11::basic_string<char, std::char_traits<char>, std::allocator<char> >, std::allocator<std::__cxx11::basic_string<char, std::char_traits<char>, std::allocator<char> > > >) (register.cc:234)
==7696==    by 0x52E2AB: Yosys::Pass::call(Yosys::RTLIL::Design*, std::__cxx11::basic_string<char, std::char_traits<char>, std::allocator<char> >) (register.cc:214)
==7696==    by 0x52EECF: Yosys::ScriptPass::run(std::__cxx11::basic_string<char, std::char_traits<char>, std::allocator<char> >, std::__cxx11::basic_string<char, std::char_traits<char>, std::allocator<char> >) (register.cc:322)
==7696==    by 0x9E296C: (anonymous namespace)::SynthIce40Pass::script() (synth_ice40.cc:240)
==7696==    by 0x9E21E5: (anonymous namespace)::SynthIce40Pass::execute(std::vector<std::__cxx11::basic_string<char, std::char_traits<char>, std::allocator<char> >, std::allocator<std::__cxx11::basic_string<char, std::char_traits<char>, std::allocator<char> > > >, Yosys::RTLIL::Design*) (synth_ice40.cc:214)
==7696==
==7696== Use of uninitialised value of size 8
==7696==    at 0x66DE74: _S_right (stl_tree.h:788)
==7696==    by 0x66DE74: std::_Rb_tree<Yosys::RTLIL::Cell*, Yosys::RTLIL::Cell*, std::_Identity<Yosys::RTLIL::Cell*>, std::less<Yosys::RTLIL::Cell*>, std::allocator<Yosys::RTLIL::Cell*> >::_M_erase(std::_Rb_tree_node<Yosys::RTLIL::Cell*>*) (stl_tree.h:1872)
==7696==    by 0x66DFB5: std::_Rb_tree<Yosys::RTLIL::Cell*, Yosys::RTLIL::Cell*, std::_Identity<Yosys::RTLIL::Cell*>, std::less<Yosys::RTLIL::Cell*>, std::allocator<Yosys::RTLIL::Cell*> >::~_Rb_tree() (stl_tree.h:965)
==7696==    by 0x877D60: ~set (stl_set.h:281)
==7696==    by 0x877D60: ~pair (stl_pair.h:193)
==7696==    by 0x877D60: ~entry_t (hashlib.h:202)
==7696==    by 0x877D60: _Destroy<Yosys::hashlib::dict<Yosys::SigSet<Yosys::RTLIL::Cell *, std::less<Yosys::RTLIL::Cell *> >::bitDef_t, std::set<Yosys::RTLIL::Cell *, std::less<Yosys::RTLIL::Cell *>, std::allocator<Yosys::RTLIL::Cell *> >, Yosys::hashlib::hash_ops<Yosys::SigSet<Yosys::RTLIL::Cell *, std::less<Yosys::RTLIL::Cell *> >::bitDef_t> >::entry_t> (stl_construct.h:98)
==7696==    by 0x877D60: __destroy<Yosys::hashlib::dict<Yosys::SigSet<Yosys::RTLIL::Cell *, std::less<Yosys::RTLIL::Cell *> >::bitDef_t, std::set<Yosys::RTLIL::Cell *, std::less<Yosys::RTLIL::Cell *>, std::allocator<Yosys::RTLIL::Cell *> >, Yosys::hashlib::hash_ops<Yosys::SigSet<Yosys::RTLIL::Cell *, std::less<Yosys::RTLIL::Cell *> >::bitDef_t> >::entry_t *> (stl_construct.h:108)
==7696==    by 0x877D60: _Destroy<Yosys::hashlib::dict<Yosys::SigSet<Yosys::RTLIL::Cell *, std::less<Yosys::RTLIL::Cell *> >::bitDef_t, std::set<Yosys::RTLIL::Cell *, std::less<Yosys::RTLIL::Cell *>, std::allocator<Yosys::RTLIL::Cell *> >, Yosys::hashlib::hash_ops<Yosys::SigSet<Yosys::RTLIL::Cell *, std::less<Yosys::RTLIL::Cell *> >::bitDef_t> >::entry_t *> (stl_construct.h:136)
==7696==    by 0x877D60: _Destroy<Yosys::hashlib::dict<Yosys::SigSet<Yosys::RTLIL::Cell *, std::less<Yosys::RTLIL::Cell *> >::bitDef_t, std::set<Yosys::RTLIL::Cell *, std::less<Yosys::RTLIL::Cell *>, std::allocator<Yosys::RTLIL::Cell *> >, Yosys::hashlib::hash_ops<Yosys::SigSet<Yosys::RTLIL::Cell *, std::less<Yosys::RTLIL::Cell *> >::bitDef_t> >::entry_t *, Yosys::hashlib::dict<Yosys::SigSet<Yosys::RTLIL::Cell *, std::less<Yosys::RTLIL::Cell *> >::bitDef_t, std::set<Yosys::RTLIL::Cell *, std::less<Yosys::RTLIL::Cell *>, std::allocator<Yosys::RTLIL::Cell *> >, Yosys::hashlib::hash_ops<Yosys::SigSet<Yosys::RTLIL::Cell *, std::less<Yosys::RTLIL::Cell *> >::bitDef_t> >::entry_t> (stl_construct.h:206)
==7696==    by 0x877D60: _M_erase_at_end (stl_vector.h:1658)
==7696==    by 0x877D60: clear (stl_vector.h:1386)
==7696==    by 0x877D60: clear (hashlib.h:557)
==7696==    by 0x877D60: Yosys::SigSet<Yosys::RTLIL::Cell*, std::less<Yosys::RTLIL::Cell*> >::clear() (sigtools.h:151)
==7696==    by 0x872BA3: (anonymous namespace)::OptRmdffPass::execute(std::vector<std::__cxx11::basic_string<char, std::char_traits<char>, std::allocator<char> >, std::allocator<std::__cxx11::basic_string<char, std::char_traits<char>, std::allocator<char> > > >, Yosys::RTLIL::Design*) (opt_rmdff.cc:542)
==7696==    by 0x52E658: Yosys::Pass::call(Yosys::RTLIL::Design*, std::vector<std::__cxx11::basic_string<char, std::char_traits<char>, std::allocator<char> >, std::allocator<std::__cxx11::basic_string<char, std::char_traits<char>, std::allocator<char> > > >) (register.cc:234)
==7696==    by 0x52E2AB: Yosys::Pass::call(Yosys::RTLIL::Design*, std::__cxx11::basic_string<char, std::char_traits<char>, std::allocator<char> >) (register.cc:214)
==7696==    by 0x85EA69: (anonymous namespace)::OptPass::execute(std::vector<std::__cxx11::basic_string<char, std::char_traits<char>, std::allocator<char> >, std::allocator<std::__cxx11::basic_string<char, std::char_traits<char>, std::allocator<char> > > >, Yosys::RTLIL::Design*) (opt.cc:150)
==7696==    by 0x52E658: Yosys::Pass::call(Yosys::RTLIL::Design*, std::vector<std::__cxx11::basic_string<char, std::char_traits<char>, std::allocator<char> >, std::allocator<std::__cxx11::basic_string<char, std::char_traits<char>, std::allocator<char> > > >) (register.cc:234)
==7696==    by 0x52E2AB: Yosys::Pass::call(Yosys::RTLIL::Design*, std::__cxx11::basic_string<char, std::char_traits<char>, std::allocator<char> >) (register.cc:214)
==7696==    by 0x52EECF: Yosys::ScriptPass::run(std::__cxx11::basic_string<char, std::char_traits<char>, std::allocator<char> >, std::__cxx11::basic_string<char, std::char_traits<char>, std::allocator<char> >) (register.cc:322)
==7696==    by 0x9E296C: (anonymous namespace)::SynthIce40Pass::script() (synth_ice40.cc:240)
==7696==    by 0x9E21E5: (anonymous namespace)::SynthIce40Pass::execute(std::vector<std::__cxx11::basic_string<char, std::char_traits<char>, std::allocator<char> >, std::allocator<std::__cxx11::basic_string<char, std::char_traits<char>, std::allocator<char> > > >, Yosys::RTLIL::Design*) (synth_ice40.cc:214)
==7696==
==7696== Invalid read of size 8
==7696==    at 0x66DE74: _S_right (stl_tree.h:788)
==7696==    by 0x66DE74: std::_Rb_tree<Yosys::RTLIL::Cell*, Yosys::RTLIL::Cell*, std::_Identity<Yosys::RTLIL::Cell*>, std::less<Yosys::RTLIL::Cell*>, std::allocator<Yosys::RTLIL::Cell*> >::_M_erase(std::_Rb_tree_node<Yosys::RTLIL::Cell*>*) (stl_tree.h:1872)
==7696==    by 0x66DFB5: std::_Rb_tree<Yosys::RTLIL::Cell*, Yosys::RTLIL::Cell*, std::_Identity<Yosys::RTLIL::Cell*>, std::less<Yosys::RTLIL::Cell*>, std::allocator<Yosys::RTLIL::Cell*> >::~_Rb_tree() (stl_tree.h:965)
==7696==    by 0x877D60: ~set (stl_set.h:281)
==7696==    by 0x877D60: ~pair (stl_pair.h:193)
==7696==    by 0x877D60: ~entry_t (hashlib.h:202)
==7696==    by 0x877D60: _Destroy<Yosys::hashlib::dict<Yosys::SigSet<Yosys::RTLIL::Cell *, std::less<Yosys::RTLIL::Cell *> >::bitDef_t, std::set<Yosys::RTLIL::Cell *, std::less<Yosys::RTLIL::Cell *>, std::allocator<Yosys::RTLIL::Cell *> >, Yosys::hashlib::hash_ops<Yosys::SigSet<Yosys::RTLIL::Cell *, std::less<Yosys::RTLIL::Cell *> >::bitDef_t> >::entry_t> (stl_construct.h:98)
==7696==    by 0x877D60: __destroy<Yosys::hashlib::dict<Yosys::SigSet<Yosys::RTLIL::Cell *, std::less<Yosys::RTLIL::Cell *> >::bitDef_t, std::set<Yosys::RTLIL::Cell *, std::less<Yosys::RTLIL::Cell *>, std::allocator<Yosys::RTLIL::Cell *> >, Yosys::hashlib::hash_ops<Yosys::SigSet<Yosys::RTLIL::Cell *, std::less<Yosys::RTLIL::Cell *> >::bitDef_t> >::entry_t *> (stl_construct.h:108)
==7696==    by 0x877D60: _Destroy<Yosys::hashlib::dict<Yosys::SigSet<Yosys::RTLIL::Cell *, std::less<Yosys::RTLIL::Cell *> >::bitDef_t, std::set<Yosys::RTLIL::Cell *, std::less<Yosys::RTLIL::Cell *>, std::allocator<Yosys::RTLIL::Cell *> >, Yosys::hashlib::hash_ops<Yosys::SigSet<Yosys::RTLIL::Cell *, std::less<Yosys::RTLIL::Cell *> >::bitDef_t> >::entry_t *> (stl_construct.h:136)
==7696==    by 0x877D60: _Destroy<Yosys::hashlib::dict<Yosys::SigSet<Yosys::RTLIL::Cell *, std::less<Yosys::RTLIL::Cell *> >::bitDef_t, std::set<Yosys::RTLIL::Cell *, std::less<Yosys::RTLIL::Cell *>, std::allocator<Yosys::RTLIL::Cell *> >, Yosys::hashlib::hash_ops<Yosys::SigSet<Yosys::RTLIL::Cell *, std::less<Yosys::RTLIL::Cell *> >::bitDef_t> >::entry_t *, Yosys::hashlib::dict<Yosys::SigSet<Yosys::RTLIL::Cell *, std::less<Yosys::RTLIL::Cell *> >::bitDef_t, std::set<Yosys::RTLIL::Cell *, std::less<Yosys::RTLIL::Cell *>, std::allocator<Yosys::RTLIL::Cell *> >, Yosys::hashlib::hash_ops<Yosys::SigSet<Yosys::RTLIL::Cell *, std::less<Yosys::RTLIL::Cell *> >::bitDef_t> >::entry_t> (stl_construct.h:206)
==7696==    by 0x877D60: _M_erase_at_end (stl_vector.h:1658)
==7696==    by 0x877D60: clear (stl_vector.h:1386)
==7696==    by 0x877D60: clear (hashlib.h:557)
==7696==    by 0x877D60: Yosys::SigSet<Yosys::RTLIL::Cell*, std::less<Yosys::RTLIL::Cell*> >::clear() (sigtools.h:151)
==7696==    by 0x872BA3: (anonymous namespace)::OptRmdffPass::execute(std::vector<std::__cxx11::basic_string<char, std::char_traits<char>, std::allocator<char> >, std::allocator<std::__cxx11::basic_string<char, std::char_traits<char>, std::allocator<char> > > >, Yosys::RTLIL::Design*) (opt_rmdff.cc:542)
==7696==    by 0x52E658: Yosys::Pass::call(Yosys::RTLIL::Design*, std::vector<std::__cxx11::basic_string<char, std::char_traits<char>, std::allocator<char> >, std::allocator<std::__cxx11::basic_string<char, std::char_traits<char>, std::allocator<char> > > >) (register.cc:234)
==7696==    by 0x52E2AB: Yosys::Pass::call(Yosys::RTLIL::Design*, std::__cxx11::basic_string<char, std::char_traits<char>, std::allocator<char> >) (register.cc:214)
==7696==    by 0x85EA69: (anonymous namespace)::OptPass::execute(std::vector<std::__cxx11::basic_string<char, std::char_traits<char>, std::allocator<char> >, std::allocator<std::__cxx11::basic_string<char, std::char_traits<char>, std::allocator<char> > > >, Yosys::RTLIL::Design*) (opt.cc:150)
==7696==    by 0x52E658: Yosys::Pass::call(Yosys::RTLIL::Design*, std::vector<std::__cxx11::basic_string<char, std::char_traits<char>, std::allocator<char> >, std::allocator<std::__cxx11::basic_string<char, std::char_traits<char>, std::allocator<char> > > >) (register.cc:234)
==7696==    by 0x52E2AB: Yosys::Pass::call(Yosys::RTLIL::Design*, std::__cxx11::basic_string<char, std::char_traits<char>, std::allocator<char> >) (register.cc:214)
==7696==    by 0x52EECF: Yosys::ScriptPass::run(std::__cxx11::basic_string<char, std::char_traits<char>, std::allocator<char> >, std::__cxx11::basic_string<char, std::char_traits<char>, std::allocator<char> >) (register.cc:322)
==7696==    by 0x9E296C: (anonymous namespace)::SynthIce40Pass::script() (synth_ice40.cc:240)
==7696==    by 0x9E21E5: (anonymous namespace)::SynthIce40Pass::execute(std::vector<std::__cxx11::basic_string<char, std::char_traits<char>, std::allocator<char> >, std::allocator<std::__cxx11::basic_string<char, std::char_traits<char>, std::allocator<char> > > >, Yosys::RTLIL::Design*) (synth_ice40.cc:214)
==7696==  Address 0x100000017 is not stack'd, malloc'd or (recently) free'd
==7696==
==7696==
==7696== Process terminating with default action of signal 11 (SIGSEGV)
==7696==  Access not within mapped region at address 0x100000017
==7696==    at 0x66DE74: _S_right (stl_tree.h:788)
==7696==    by 0x66DE74: std::_Rb_tree<Yosys::RTLIL::Cell*, Yosys::RTLIL::Cell*, std::_Identity<Yosys::RTLIL::Cell*>, std::less<Yosys::RTLIL::Cell*>, std::allocator<Yosys::RTLIL::Cell*> >::_M_erase(std::_Rb_tree_node<Yosys::RTLIL::Cell*>*) (stl_tree.h:1872)
==7696==    by 0x66DFB5: std::_Rb_tree<Yosys::RTLIL::Cell*, Yosys::RTLIL::Cell*, std::_Identity<Yosys::RTLIL::Cell*>, std::less<Yosys::RTLIL::Cell*>, std::allocator<Yosys::RTLIL::Cell*> >::~_Rb_tree() (stl_tree.h:965)
==7696==    by 0x877D60: ~set (stl_set.h:281)
==7696==    by 0x877D60: ~pair (stl_pair.h:193)
==7696==    by 0x877D60: ~entry_t (hashlib.h:202)
==7696==    by 0x877D60: _Destroy<Yosys::hashlib::dict<Yosys::SigSet<Yosys::RTLIL::Cell *, std::less<Yosys::RTLIL::Cell *> >::bitDef_t, std::set<Yosys::RTLIL::Cell *, std::less<Yosys::RTLIL::Cell *>, std::allocator<Yosys::RTLIL::Cell *> >, Yosys::hashlib::hash_ops<Yosys::SigSet<Yosys::RTLIL::Cell *, std::less<Yosys::RTLIL::Cell *> >::bitDef_t> >::entry_t> (stl_construct.h:98)
==7696==    by 0x877D60: __destroy<Yosys::hashlib::dict<Yosys::SigSet<Yosys::RTLIL::Cell *, std::less<Yosys::RTLIL::Cell *> >::bitDef_t, std::set<Yosys::RTLIL::Cell *, std::less<Yosys::RTLIL::Cell *>, std::allocator<Yosys::RTLIL::Cell *> >, Yosys::hashlib::hash_ops<Yosys::SigSet<Yosys::RTLIL::Cell *, std::less<Yosys::RTLIL::Cell *> >::bitDef_t> >::entry_t *> (stl_construct.h:108)
==7696==    by 0x877D60: _Destroy<Yosys::hashlib::dict<Yosys::SigSet<Yosys::RTLIL::Cell *, std::less<Yosys::RTLIL::Cell *> >::bitDef_t, std::set<Yosys::RTLIL::Cell *, std::less<Yosys::RTLIL::Cell *>, std::allocator<Yosys::RTLIL::Cell *> >, Yosys::hashlib::hash_ops<Yosys::SigSet<Yosys::RTLIL::Cell *, std::less<Yosys::RTLIL::Cell *> >::bitDef_t> >::entry_t *> (stl_construct.h:136)
==7696==    by 0x877D60: _Destroy<Yosys::hashlib::dict<Yosys::SigSet<Yosys::RTLIL::Cell *, std::less<Yosys::RTLIL::Cell *> >::bitDef_t, std::set<Yosys::RTLIL::Cell *, std::less<Yosys::RTLIL::Cell *>, std::allocator<Yosys::RTLIL::Cell *> >, Yosys::hashlib::hash_ops<Yosys::SigSet<Yosys::RTLIL::Cell *, std::less<Yosys::RTLIL::Cell *> >::bitDef_t> >::entry_t *, Yosys::hashlib::dict<Yosys::SigSet<Yosys::RTLIL::Cell *, std::less<Yosys::RTLIL::Cell *> >::bitDef_t, std::set<Yosys::RTLIL::Cell *, std::less<Yosys::RTLIL::Cell *>, std::allocator<Yosys::RTLIL::Cell *> >, Yosys::hashlib::hash_ops<Yosys::SigSet<Yosys::RTLIL::Cell *, std::less<Yosys::RTLIL::Cell *> >::bitDef_t> >::entry_t> (stl_construct.h:206)
==7696==    by 0x877D60: _M_erase_at_end (stl_vector.h:1658)
==7696==    by 0x877D60: clear (stl_vector.h:1386)
==7696==    by 0x877D60: clear (hashlib.h:557)
==7696==    by 0x877D60: Yosys::SigSet<Yosys::RTLIL::Cell*, std::less<Yosys::RTLIL::Cell*> >::clear() (sigtools.h:151)
==7696==    by 0x872BA3: (anonymous namespace)::OptRmdffPass::execute(std::vector<std::__cxx11::basic_string<char, std::char_traits<char>, std::allocator<char> >, std::allocator<std::__cxx11::basic_string<char, std::char_traits<char>, std::allocator<char> > > >, Yosys::RTLIL::Design*) (opt_rmdff.cc:542)
==7696==    by 0x52E658: Yosys::Pass::call(Yosys::RTLIL::Design*, std::vector<std::__cxx11::basic_string<char, std::char_traits<char>, std::allocator<char> >, std::allocator<std::__cxx11::basic_string<char, std::char_traits<char>, std::allocator<char> > > >) (register.cc:234)
==7696==    by 0x52E2AB: Yosys::Pass::call(Yosys::RTLIL::Design*, std::__cxx11::basic_string<char, std::char_traits<char>, std::allocator<char> >) (register.cc:214)
==7696==    by 0x85EA69: (anonymous namespace)::OptPass::execute(std::vector<std::__cxx11::basic_string<char, std::char_traits<char>, std::allocator<char> >, std::allocator<std::__cxx11::basic_string<char, std::char_traits<char>, std::allocator<char> > > >, Yosys::RTLIL::Design*) (opt.cc:150)
==7696==    by 0x52E658: Yosys::Pass::call(Yosys::RTLIL::Design*, std::vector<std::__cxx11::basic_string<char, std::char_traits<char>, std::allocator<char> >, std::allocator<std::__cxx11::basic_string<char, std::char_traits<char>, std::allocator<char> > > >) (register.cc:234)
==7696==    by 0x52E2AB: Yosys::Pass::call(Yosys::RTLIL::Design*, std::__cxx11::basic_string<char, std::char_traits<char>, std::allocator<char> >) (register.cc:214)
==7696==    by 0x52EECF: Yosys::ScriptPass::run(std::__cxx11::basic_string<char, std::char_traits<char>, std::allocator<char> >, std::__cxx11::basic_string<char, std::char_traits<char>, std::allocator<char> >) (register.cc:322)
==7696==    by 0x9E296C: (anonymous namespace)::SynthIce40Pass::script() (synth_ice40.cc:240)
==7696==    by 0x9E21E5: (anonymous namespace)::SynthIce40Pass::execute(std::vector<std::__cxx11::basic_string<char, std::char_traits<char>, std::allocator<char> >, std::allocator<std::__cxx11::basic_string<char, std::char_traits<char>, std::allocator<char> > > >,
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

Thread 96 (2019-01-28):

Level shifter state during reconfiguraiton?

whitequark, 2019-01-28:
It looks like we are constrained in level shifter routing: the DIR input is referenced to VCCA. When DIR is low, B is an input. Ideally, we would have this as the state of the tool when the FPGA is reconfigured, but AFAIK the FPGA pins are all set to be weak pullups.

Should we add external pulldowns? This seems... basically impossible placement-wise.

The alternative is to force the entire level shifter into a high impedance state by disabling the voltage regulators. (Good thinking, @marcan--if we powered level shifters directly from Vsense this would not be possible.) The problem is that discharging the output capacitor below the cutoff level may take a while and we cannot directly determine when this happens. So it would be a hardcoded worst-case delay in the FPGA reconfiguration code.

Thoughts?

marcan, 2019-01-28:
Pull-downs are plausible on the back side. It won't be fun but I think it's doable. We already have a couple of resistors back there.

Our only static load on VIO is the feedback divider, which is 83kΩ. We have about 6µF of capacitance on that bus, so not considering any external capacitance, that's a t<sub>RC</sub> of half a second. Not terrible, not great. The easiest change to improve this would be to dump a 1kΩ discharge resistor on there (easy to retrofit to revC0 units), which would add a worst-case load of 5mA and reduce the t<sub>RC</sub> to 6ms. This is probably a good idea anyway, we'd want level changes on that rail to be responsive.

marcan, 2019-01-28:
I couldn't find a proper threshold for the shifters to shut down, but I'm guessing 3t<sub>RC</sub> will probably do it in all cases (that's 5V to 0.23V).

whitequark, 2019-02-02:
Discharge resistor sounds great, and we need that regardless of this issue--I think I've hit the problem with rails changing too slowly before.

We can qualify the level shifter threshold easily, at least the ballpark.

marcan, 2019-03-28:
Let's call this closed for revC1. Discharge resistors are there, we can revisit and add pull-downs if it becomes a problem.

Closed 2019-03-28.

Thread 97 (2019-02-09):

Make both PLLs usable in theory

whitequark, 2019-02-09:
Right now on revC, CLKIF is connected to GBIN4 and CLKREF is connected to GBIN5. CLKIF can be either an (FPGA) input or an output; CLKREF is always an (FPGA) input.

On iCE40, a PLL is connected in such a way that it is always in an input path of an SB_IO tile. Moreover, it always uses a global buffer. So, the PLL placed at SB_IO of GBIN4 uses a) the G4 network for its PLLOUTGLOBAL output and b) the input path of the SB_IO pin.

Currently, we have two possible cases:
  * No PLLs are used. CLKIF can be an input or an output, CLKREF can be used.
  * One PLL is used. The PLL is placed in the CLKREF input path, and CLKREF cannot be used. Since there is nothing to generate the clock from, CLKIF can only be an input.
  * Two PLLs are used. Impossible.

I have a proposal that allows two PLLs to be used. This would happen by:
  * Making CLKIF an output, which is compatible with a co-located PLL.
  * Connecting CLKREF to a different ball, apart from its normal `L5`. `K4` (currently ~ALERT) seems well suitable, and nothing is currently using FPGA alert anyway, none of that path is implemented.
  * Connecting ~ALERT to  a different ball, instead of its normal `K4`. `B10` would likely work, and result in no disruption.

Then this case becomes possible:
  * Two PLLs are used. Both CLKIF and CLKREF input buffers are used for PLLs. Clock is routed from CLKREF_AUX to a `SB_GB` global buffer. A DDR output pin at CLKIF outputs the clock.

This would allow us a significant increase in flexibility at the cost of insignificant ball assignment change and having to route ~ALERT via an even more meandering path, which doesn't really make it much worse anyway.

@daveshah1 Can you please confirm my understanding of interaction of PLLs and input buffers here?
@marcan Can you take a look at routing and ballout, in case I'm missing something?

daveshah1, 2019-02-09:
If CLKREF is useful as a PLL input, then there is another option on the existing hardware. You can use a `SB_PLL_2_PAD` (as opposed to a `2F_PAD`) with `PACKAGEPIN` connected directly to the CLKREF pin. This will pass CLKREF to the second output, either to fabric or a global network.

In the latter case, this is similar to having a `SB_GB_IO` on CLKREF, although I don't know how it compares delay wise.

whitequark, 2019-02-09:
> If CLKREF is useful as a PLL input, then there is another option on the existing hardware. You can use a `SB_PLL_2_PAD` (as opposed to a `2F_PAD`) with `PACKAGEPIN` connected directly to the CLKREF pin. This will pass CLKREF to the second output, either to fabric or a global network.

Would that take up both GBIN4 and GBIN5?

daveshah1, 2019-02-09:
AIUI this would occupy the padins at (16, 0, 1) and (17, 0, 0) which correspond to GBIN3 and GBIN6

whitequark, 2019-02-09:
Are you sure? I currently have clk_if constrained to ball K6, which is called IOB_82_GBIN4, which in nextpnr output corresponds to `X17/Y0/io0`, and the PLL takes `X16/Y0/pll_3`.

daveshah1, 2019-02-09:
I was looking at a PLL with pad connected CLKREF which I think is at (16, 0, 1); which would indeed constrain the PLL to (16, 0, 3)

whitequark, 2019-04-01:
Fixed in fe2ecfe.

Closed 2019-04-01.

Thread 102 (2019-02-25):

Reconsider SYNC pullup value?

whitequark, 2019-02-25:
The revAB SYNC pin can sink 24 mA. This is no longer true as of revC.

whitequark, 2019-03-30:
Is this worth a ECN?

marcan, 2019-03-30:
Done.

Thread 103 (2019-02-25):

Changing pin assignment only doesn't change bitstream ID

whitequark, 2019-02-25:

Closed 2019-03-12.

Thread 99 (2019-02-25):

FX2 firmware too large?

bgamari, 2019-02-25:
I just built `firmware.bin` on 8ae10d25574f583828203a85be58edfd92cbc8c7 and found that it contains over 10 kBytes of text:
```
firmware$ size glasgow.ihex
   text	   data	    bss	    dec	    hex	filename
      0	  11059	      0	  11059	   2b33	glasgow.ihex
```
This seems problematic given that the FX2 has only 8kB of RAM.

As one might expect, attempting to load this firmware onto the device fails:
```
$ sudo result/bin/glasgow  factory
Traceback (most recent call last):
  File "/nix/store/5smg02nfkfy3x29zaqcbmqiicggvg2im-python3.7-glasgow-0.1/bin/.glasgow-wrapped", line 12, in <module>
    sys.exit(main())
  File "/nix/store/5smg02nfkfy3x29zaqcbmqiicggvg2im-python3.7-glasgow-0.1/lib/python3.7/site-packages/glasgow/cli.py", line 656, in main
    exit(loop.run_until_complete(_main()))
  File "/nix/store/yv4pzx3lxk3lscq0pw3hqzs7k4x76xsm-python3-3.7.2/lib/python3.7/asyncio/base_events.py", line 584, in run_until_complete
    return future.result()
  File "/nix/store/5smg02nfkfy3x29zaqcbmqiicggvg2im-python3.7-glasgow-0.1/lib/python3.7/site-packages/glasgow/cli.py", line 337, in _main
    device = GlasgowHardwareDevice(firmware_file, VID_CYPRESS, PID_FX2)
  File "/nix/store/5smg02nfkfy3x29zaqcbmqiicggvg2im-python3.7-glasgow-0.1/lib/python3.7/site-packages/glasgow/device/hardware.py", line 100, in __init__
    self._download_firmware(input_data(f, fmt="ihex"))
  File "/nix/store/5smg02nfkfy3x29zaqcbmqiicggvg2im-python3.7-glasgow-0.1/lib/python3.7/site-packages/glasgow/device/hardware.py", line 80, in _download_firmware
    self._write_ram(address, data)
  File "/nix/store/5smg02nfkfy3x29zaqcbmqiicggvg2im-python3.7-glasgow-0.1/lib/python3.7/site-packages/glasgow/device/hardware.py", line 72, in _write_ram
    self.usb.controlWrite(usb1.REQUEST_TYPE_VENDOR, REQ_RAM, addr, 0, data)
  File "/nix/store/ry142lhv029chh1rh7jsyah11wf7443g-python3.7-libusb1-1.7/lib/python3.7/site-packages/usb1/__init__.py", line 1481, in controlWrite
    sizeof(data), timeout)
  File "/nix/store/ry142lhv029chh1rh7jsyah11wf7443g-python3.7-libusb1-1.7/lib/python3.7/site-packages/usb1/__init__.py", line 1457, in _controlTransfer
    mayRaiseUSBError(result)
  File "/nix/store/ry142lhv029chh1rh7jsyah11wf7443g-python3.7-libusb1-1.7/lib/python3.7/site-packages/usb1/__init__.py", line 133, in mayRaiseUSBError
    __raiseUSBError(value)
  File "/nix/store/ry142lhv029chh1rh7jsyah11wf7443g-python3.7-libusb1-1.7/lib/python3.7/site-packages/usb1/__init__.py", line 125, in raiseUSBError
    raise __STATUS_TO_EXCEPTION_DICT.get(value, __USBError)(value)
usb1.USBErrorInvalidParam: LIBUSB_ERROR_INVALID_PARAM [-2]
```

marcan, 2019-02-25:
The FX2 has 16KiB of RAM (CY7C68013A-56LTXC).

bgamari, 2019-02-25:
The following is output from `glasgow -vv factory`, as requested by @whitequark:
```
$ sudo result/bin/glasgow -vv  factory --revision C
D: glasgow.device.hardware: found revA device without firmware
D: glasgow.device.hardware: loading firmware from /nix/store/5smg02nfkfy3x29zaqcbmqiicggvg2im-python3.7-glasgow-0.1/lib/python3.7/site-packages/glasgow/glasgow.ihex
write_ram 58880 1
write_ram 0 6
write_ram 11 3
write_ram 19 3
write_ram 27 3
write_ram 35 3
write_ram 43 3
write_ram 51 3
write_ram 59 3
write_ram 67 3
write_ram 75 3
write_ram 83 3
write_ram 91 3
write_ram 99 98
write_ram 256 3
write_ram 260 3
write_ram 264 3
write_ram 268 3
write_ram 272 3
write_ram 276 3
write_ram 280 3
write_ram 284 3
write_ram 288 3
write_ram 292 3
write_ram 296 3
write_ram 300 3
write_ram 304 3
write_ram 308 3
write_ram 312 3
write_ram 316 3
write_ram 320 3
write_ram 324 3
write_ram 328 3
write_ram 332 3
write_ram 336 3
write_ram 340 3
write_ram 344 3
write_ram 348 3
write_ram 352 3
write_ram 356 3
write_ram 360 3
write_ram 364 3
write_ram 368 3
write_ram 372 3
write_ram 376 3
write_ram 380 3
write_ram 384 3
write_ram 388 3
write_ram 392 3
write_ram 396 3
write_ram 400 3
write_ram 404 3
write_ram 408 3
write_ram 412 3
write_ram 416 3
write_ram 420 3
write_ram 424 3
write_ram 428 3
write_ram 432 3
write_ram 436 3
write_ram 440 1
write_ram 446 10783
Traceback (most recent call last):
  File "/nix/store/5smg02nfkfy3x29zaqcbmqiicggvg2im-python3.7-glasgow-0.1/bin/.glasgow-wrapped", line 12, in <module>
    sys.exit(main())
  File "/nix/store/5smg02nfkfy3x29zaqcbmqiicggvg2im-python3.7-glasgow-0.1/lib/python3.7/site-packages/glasgow/cli.py", line 656, in main
    exit(loop.run_until_complete(_main()))
  File "/nix/store/yv4pzx3lxk3lscq0pw3hqzs7k4x76xsm-python3-3.7.2/lib/python3.7/asyncio/base_events.py", line 584, in run_until_complete
    return future.result()
  File "/nix/store/5smg02nfkfy3x29zaqcbmqiicggvg2im-python3.7-glasgow-0.1/lib/python3.7/site-packages/glasgow/cli.py", line 337, in _main
    device = GlasgowHardwareDevice(firmware_file, VID_CYPRESS, PID_FX2)
  File "/nix/store/5smg02nfkfy3x29zaqcbmqiicggvg2im-python3.7-glasgow-0.1/lib/python3.7/site-packages/glasgow/device/hardware.py", line 100, in __init__
    self._download_firmware(input_data(f, fmt="ihex"))
  File "/nix/store/5smg02nfkfy3x29zaqcbmqiicggvg2im-python3.7-glasgow-0.1/lib/python3.7/site-packages/glasgow/device/hardware.py", line 80, in _download_firmware
    self._write_ram(address, data)
  File "/nix/store/5smg02nfkfy3x29zaqcbmqiicggvg2im-python3.7-glasgow-0.1/lib/python3.7/site-packages/glasgow/device/hardware.py", line 72, in _write_ram
    self.usb.controlWrite(usb1.REQUEST_TYPE_VENDOR, REQ_RAM, addr, 0, data)
  File "/nix/store/ry142lhv029chh1rh7jsyah11wf7443g-python3.7-libusb1-1.7/lib/python3.7/site-packages/usb1/__init__.py", line 1481, in controlWrite
    sizeof(data), timeout)
  File "/nix/store/ry142lhv029chh1rh7jsyah11wf7443g-python3.7-libusb1-1.7/lib/python3.7/site-packages/usb1/__init__.py", line 1457, in _controlTransfer
    mayRaiseUSBError(result)
  File "/nix/store/ry142lhv029chh1rh7jsyah11wf7443g-python3.7-libusb1-1.7/lib/python3.7/site-packages/usb1/__init__.py", line 133, in mayRaiseUSBError
    __raiseUSBError(value)
  File "/nix/store/ry142lhv029chh1rh7jsyah11wf7443g-python3.7-libusb1-1.7/lib/python3.7/site-packages/usb1/__init__.py", line 125, in raiseUSBError
    raise __STATUS_TO_EXCEPTION_DICT.get(value, __USBError)(value)
usb1.USBErrorInvalidParam: LIBUSB_ERROR_INVALID_PARAM [-2]
```

I also have this patch applied for debugging purposes:
```patch
diff --git a/software/glasgow/device/hardware.py b/software/glasgow/device/hardware.py
index b4b8ad6..81c8acd 100644
--- a/software/glasgow/device/hardware.py
+++ b/software/glasgow/device/hardware.py
@@ -68,6 +68,7 @@ class GlasgowHardwareDevice:
             pass

     def _write_ram(self, addr, data):
+        print("write_ram", addr, len(data))
         self.usb.controlWrite(usb1.REQUEST_TYPE_VENDOR, REQ_RAM, addr, 0, data)

     def _cpu_reset(self, is_reset):
```

whitequark, 2019-02-25:
This was fixed by commit whitequark/libfx2@a06b7f573f71abe6e. Did you run `git submodule update`?

bgamari, 2019-02-25:
Ahh, this commit wasn't present on the commit pointed to in the `revC0` tag.

bgamari, 2019-02-25:
Actually, I don't see how this could be fixed by that commit. The `fx2` library appears nowhere in the backtrace. It looks to me like this issue just exists independently in `software/glasgow/device/hardware.py`.

whitequark, 2019-02-25:
Good point! Can you try this patch:
```patch
diff --git a/software/glasgow/device/hardware.py b/software/glasgow/device/hardware.py
index 8b454a7..7b4d190 100644
--- a/software/glasgow/device/hardware.py
+++ b/software/glasgow/device/hardware.py
@@ -68,7 +68,11 @@ class GlasgowHardwareDevice:
             pass

     def _write_ram(self, addr, data):
-        self.usb.controlWrite(usb1.REQUEST_TYPE_VENDOR, REQ_RAM, addr, 0, data)
+        while len(data) > 0:
+            chunk_length = min(len(data), 4096)
+            self.usb.control_write(usb1.REQUEST_TYPE_VENDOR, REQ_RAM, addr, 0, data[:chunk_length])
+            addr += chunk_length
+            data = data[chunk_length:]

     def _cpu_reset(self, is_reset):
         self._write_ram(REG_CPUCS, [1 if is_reset else 0])
```

bgamari, 2019-02-25:
Made it much farther with that patch (although `control_write` should be `controlWrite`).

Closed 2019-02-25.

Thread 104 (2019-02-27):

Indicate 10/12-bit ADC and DAC as functional equivalents to the 8-bit ones

whitequark, 2019-02-27:
They're completely identical in function when used as replacements and apparently there is a shortage of 8-bit chips for some reason. I assumed it's obvious that the 10/12-bit ones are just as good but it's not; we need to indicate it on the schematic and/or BOM somehow.

Closed 2019-03-28.

Thread 106 (2019-03-01):

Pulls on revC0 are BROKEN and I²C level shifters require replacement

whitequark, 2019-03-01:
This is what happens to the FX2-side I2C bus after trying to address a pull TCA9534 while *both* DACs are enabled and supply IO power:
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
The TCA9534-side I2C bus is similar but oscillates at 1.8 MHz instead.

This happens because we connected two TCA9517s with their B-sides on the same bus. (We had to, since the A-side is the only one that goes below 2.7 V). The datasheet says to not do it, but doesn't mention that they will oscillate wildly...

As far as I can tell, TCA9509 ([datasheet](https://www.ti.com/lit/ds/symlink/tca9509.pdf)) is a pin and package compatible replacement for TCA9517 ([datasheet](https://www.ti.com/lit/ds/symlink/tca9517.pdf)) that should not have this problem. It is possible to use it on existing revC0 boards by swapping the shifter and changing R36-R39 to DNP.

TCA9509 datasheet explicitly calls out this problem (or lack thereof):

> The output pull-down on the B-side drives a hard LOW and the input level is set at 0.3 of SMBus
or I2C-bus voltage level which enables B side to connect to any other I2C-bus devices or buffer.

marcan, 2019-03-08:
Fixed with the new expanders, just need to update the design and validate. Chips are on the way.

marcan, 2019-03-28:
New chips validated and design updated.

Closed 2019-03-28.

Thread 107 (2019-03-01):

Consider connecting level shifter EN to DAC EN

whitequark, 2019-03-01:
Related to #96. We really don't need the level shifters to guess whether the IO port is enabled, and lock up the bus if it guesses wrong.

TCA9509 does this:

> The TCA9509 drivers are not enabled unless VCCA is above 0.8 V and VCCB is above 2.5 V. The enable (EN) pin can also be used to turn the drivers on and off under system control. Caution should be observed to only change the state of the EN pin when the bus is idle.

which is good enough, but I think explicitly managing EN would be safer.

marcan, 2019-03-08:
Sounds good to me. We still need to make sure we have something like a 100ms delay after Vio shutdown before reconfiguration to allow for plenty of time for charge to drain on revC0, but this makes revC1 more robust in the face of external capacitance.

marcan, 2019-03-28:
Kill it with fiiiiiiiire

Closed 2019-03-28.

Thread 108 (2019-03-08):

Verify XC9572XL programming on revC

whitequark, 2019-03-08:
There were some spurious errors while programming XC9572XL with revB, it's unclear if they were caused by FXMAs or something else.

whitequark, 2019-03-10:
Answer: these are not caused by FXMA as the error patterns are exactly the same on revC as on revB. These are likely reject bin or [recycled](http://tech.mattmillman.com/making-use-of-recycled-xilinx-xc9500-cplds/) devices, since they are found on an extremely cheap POST card.

Closed 2019-03-10.

Thread 109 (2019-03-08):

Verify MEC16xx programming on revC

whitequark, 2019-03-08:
There were some spurious errors while verifying (not programming!) MEC16xx with revB, it's unclear if they were caused by FXMAs or something else.

whitequark, 2020-11-04:
Having done some groundwork on the ARC core in MEC16xx, I have concluded that this is more likely to be a silicon bug than an FXMA-related issue and updated the applet to indicate this conclusion in 506839f1e5186881ab9427e2d9b89e0e307b6c1b.

Closed 2020-11-04.

Thread 115 (2019-03-12):

ADC on every IO pin

electroniceel, 2019-03-12:
Enhancement idea for a future hardware revision:

Use muxes to be able to automatically connect the ADC to any regular IO pin, not just dedicated analog sense pins. This would allow to improve the automatic detection capabilities. An applet could just scan the voltages on all pins and select the correct io voltage level or complain if one or more pins are not within a common level.

Another idea would be to wiggle the pullups/pulldowns while the adc is sampling in sync. This would allow to guess the impedance of the possibly unknown stuff connected to this pin. This would help the user to make a guess at finding out what a pin does. It also helps deciding if it is safe to use push-pull logic on a pin or not.

Both features would also increase the value of Glasgow for small scale automated post-production tests.

Ideas to implement it:
a) an 8 channel analog mux, like 74HC4051, between the pins and voltage divider, then the ADC.
Drive it with 5V Vcc, you need 4 control lines on 5V-level from somewhere. But you can then switch off the voltage divider for the ADC.

b) Replace the ADC with a 5V-compatible microcontroller that has an ADC and 8 or more analog input pins. For example some Atmel part like the Attiny416 https://www.microchip.com/wwwproducts/en/ATTINY416 would probably work. It also seems to be even cheaper than the ADC081C021.

You could communicate with it via I2C (I2C level shifting to 5V needed). For programming it uses UPDI, which would probably need a connection to the FPGA with another '1T45 for level shifting.

whitequark, 2019-03-12:
> This would allow to guess the impedance of the possibly unknown stuff connected to this pin.

That's doable purely in the digital domain. In fact the jtag-pinout applet already does something like it.

whitequark, 2019-03-12:
Is there a reason this should be on the main PCB? This significantly increases area, cost and complexity.

I think you can implement this with a board that plugs into (let's say we have revC) port A and port B. Port A is the normal digital port, powered however you like, port B has the mux and ADC connected to it, and is powered from 5 V. This a) doesn't require everyone to pay for this non-essential feature, b) allows to iterate this fairly complicated analog circuit separately from Glasgow.

electroniceel, 2019-03-12:
Wow, that was a fast reply :-O

> That's doable purely in the digital domain. In fact the jtag-pinout applet already does something like it.

Don't you get just stuff like "high-Z" or "push/pull" in the digital domain? I'd prefer to get some estimate of the pullup/pulldown strength, like is it more like 4K (-> could be I2C) or more like 50K.

> Is there a reason this should be on the main PCB?

It could be an addon pcb.

> This significantly increases area, cost and complexity.

Really? For my suggestion with the Attiny you'd replace the ADC081C021 with the Attiny (3x3 QFN). You'd need one more '1T45 and one more TCA9517. I wouldn't call this significantly. But you are to decide.

whitequark, 2019-03-12:
> Don't you get just stuff like "high-Z" or "push/pull" in the digital domain? I'd prefer to get some estimate of the pullup/pulldown strength, like is it more like 4K (-> could be I2C) or more like 50K.

You can estimate pull strength by measuring its time constant with just the digital driver, then with a configurable (known value) Glasgow pullup, then solving for unknown R. You don't know the exact input threshold voltage for this PVT corner, but you can calibrate it against a known resistance (integrated 1% pull resistor) and known capacitance (connect a capacitor to a pin).

> Really? For my suggestion with the Attiny you'd replace the ADC081C021 with the Attiny (3x3 QFN). You'd need one more '1T45 and one more TCA9517. I wouldn't call this significantly. But you are to decide.

This can't possibly physically fit on revC. Also, unless we replace the old DACs we don't have enough pins on the FX2 for UPDI, so there's no way to program this microcontroller.

But the most significant part is: the need to add a completely new kind of programmable logic to the device, add *even more* level shifters (which are extremely finicky and in fact we are getting rid of TCA9517s because they're too unreliable to use), add a new toolchain (which needs to be added on CI, has its own unique quirks, etc), add a new firmware (which needs to be stored somewhere, appropriately reflashed when it's stale, etc), add a new programming interface (which needs to be implemented to fit in the already quite scarce 8051 RAM), qualify new analog circuitry... probably a few things I've missed. All this without ever dropping support for the old DAC and/or ADC (because we support existing boards forever), of course.

The "simplicity" of adding a microcontroller is misleading; in fact there is no simplicity at all. That would still be true even on a completely new design, microcontrollers are inferior to programmable logic as well as hard logic when it comes to reliability. Programmable logic allows you to trivially prove strong isolation for different components, and hard logic allows you to use physically independent components. A microcontroller requires some kind of scheduling, which is very easy to get wrong in edge cases. A microcontroller usually has bugs in its I²C implementation, or at least more bugs than a typical discrete DAC/ADC. I would never implement this feature with a microcontroller even if I chose to put it on the base design.

marcan, 2019-03-12:
I concur; using a microcontroller adds all kinds of horrible complexity that we don't want here, and there is no way this is ever going to fit on revC.

electroniceel, 2019-03-12:
I understand your reservations against adding a microcontroller.

So if this is added to the Glasgow PCB, it would have to be done with an analog mux or an I2C ADC (MAX11602, NCD9830,...). Both would need more board space.

whitequark, 2019-03-12:
No Maxim parts in any production designs.

whitequark, 2019-03-30:
Unrealistic for revC/D. I'd be interested in such an add-on card but I don't consider myself a competent analog designer, so this goes in the "An Interesting Project" category. Therefore, closing as not immediatealy actionable.

Closed 2019-03-30.

Thread 117 (2019-03-31):

Pins for Addon-Boards

electroniceel, 2019-03-31:
Let's say I wanted to develop an addon board like suggested as solution for #115. It would make developing an analog addon board easier if I had access to these signals:
5V, SCL, SDA.
Maybe also one of the aux signals would be handy if an additional pin is free.

These are already accessible on the pcb as smd pads. But that makes bringing them up to an addon board sitting on top and plugging into port A & B mechanically difficult. So I propose to provide these signals on some vertical pin headers that an addon board could easily plug into.

I propose to use the space below the Sync-header for this. In the current revC design this place seems to be unused on most layers and the signals mentioned are already running near that place. The sync header would have to be replaced by a vertical 3x2 pin header. This way it could still be used with pin sockets like in the current design.

The addon board could route through the sync signal and provide it on a pin header again, so you could use the sync with the addon board installed.

What do you think?

whitequark, 2019-03-31:
Duplicate of #68, please continue the discussion there. In short, this wouldn't be possible on revC1, but will likely be possible on revD0.

whitequark, 2019-04-01:
To be clear--I would very much like to see an analog frontend that works with revC1. I think it should use the normal data pins instead of the internal I²C bus. Indeed that would be a much better experience because you could get higher sample rates and more flexibility with less cost in terms of software complexity, as you don't have to configure the frontend with the FX2.

electroniceel, 2019-04-01:
Sorry for the duplicate, didn't see it because it was closed. Will continue the discussion in #68.

Closed 2019-03-31.

Thread 118 (2019-04-01):

Improve ESD immunity

electroniceel, 2019-04-01:
Glasgow is designed to withstand hotplugging, manually touching wires and so on on the port pins. But there are also other pins accessible from the outside: sync, aux, lvds. They currently aren't protected well. They don't have a series resistor like the ports, so the IC connected to them has to survive all the ESD energy.

The first thing I propose is to add a series resistors (I suggest 47 ohms) between the sync pin and it's '45 U32, and the aux pins and the ice40.

These series resistors help the ICs dropping the ESD voltage. They aren't perfect, but a small, cheap and easy method. In my experience they significantly improve esd immunity. Also they double as a series termination and help to reduce ringing.

The 74LVC1T45s used on the port pins just have an ESD rating of 2 kV HBM. That is not much for a pin connected to outside of the board and expected to be "abused", even with the series resistors in front. I suggest to add TVS diode arrays behind the series resistors to improve this.

My usual go-to part for this application is IP4220CZ6, I use them a lot on my boards. It protects 4 lines of USB HS speed level. But it is SOT23-6, so it wouldn't fit on the board. But there are many similar products available in smaller packages, e.g. D5V0F4U6V, XBP14E5UFN-G or you could even go crazy small with HSP051-4M5.

There are also some available for 8 lines in parallel. These are mostly designed for USB 3, HDMI and the like and could also be used for the LVDS port. For example ESD7016MUTAG,  ESD8008MUTAG or SP7538PUTG.

On the LVDS port I wouldn't add series resistors as this interferes with LVDS and isn't recommended. So just a TVS diode array there.

whitequark, 2019-04-02:
So, the AUX pins and the LVDS bank are not going to be populated as they come from the fab, and moreover, they will not be directly accessible under the case. That means you can't just touch them, and that's why they have no particular protection mechanisms; for LVDS specifically it is expected that for any real use, an add-on board will be connected that has the termination (as it stands, the "LVDS" bank can't really do LVDS, it requires external passives, a lot of them).

Regarding banks A and B and the Sync pin... it would be very tricky to fit. @marcan?

marcan, 2019-04-02:
Adding series resistors for SYNC and AUX is trivial, that much we can do.

As for clamp diodes, it's worth noting that as far as I can tell the SN74LVC1T45s we're using only have low side clamp diodes (because they are 5V tolerant on inputs regardless of IO voltage). So to provide proper protection it makes sense to add external diodes hardwired to 5V and GND (not VIO); this maintains the 5V-tolerance on the inputs regardless of reference voltage (which is a good feature to have).

Now the question is whether we can fit this in at all. I might try something with the XBP14E5UFN, but either way, if we do this I'm pretty sure the ESD protection is going to have to go on the underside.

marcan, 2019-04-02:
Okay, I can push things around *just* enough to put the XBP14E5UFN on the top side. Very rough layout test:

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

electroniceel, 2019-04-02:
looking good to me. Thanks for picking this up.

whitequark, 2019-04-07:
Fixed in b9794b5.

whitequark, 2019-04-07:
Ah, not yet on SYNC.

marcan, 2019-04-07:
Fixed in 59c960b.

Closed 2019-04-07.

Thread 119 (2019-04-02):

Print IO bank pin mappings on silkscreen

electroniceel, 2019-04-02:
As written by me in https://github.com/GlasgowEmbedded/Glasgow/issues/68#issuecomment-478746138:
I suggest to add some silkscreen markers (for example on the back side) indicating the unconnected pins on the port headers. Not that someone expects ground there. Maybe extend that to printing the numbers, sense, Vio. I tend to forget the pinout and hate having to look it up all the time.

I don't want to put work on you with more and more of my ideas, so do you want me to provide patches? Don't want to create merge conflicts tough, they aren't as easy to see & fix in Kicad as in code.

whitequark, 2019-04-02:
I really like this idea.

marcan, 2019-04-03:
Yeah, we had to get rid of the (very vague) front side marking due to space constraints, but we can probably put some version of a full pinout on the back.

Closed 2019-04-05.

Thread 121 (2019-04-08):

MG2040

whitequark, 2019-04-08:

smunaut, 2019-06-11:
Comment from IRC that's probably relevant for this issue :

> 07:06 < esden> LOL! Why are the MG2040 set as Through hole parts in the board file... ;)

whitequark, 2023-02-07:
No one has the bandwidth to upstream footprints.

Closed 2023-02-07.

Thread 122 (2019-04-08):

USB test points

whitequark, 2019-04-08:
Per IRC:
```
18:55 < davidc__> (Re USB connectors, using the actual USB connector for testing can be problematic.... plug starts to wear out of tolerance at $N insertions... then starts bending the pins inside the USB housing on the board)
18:55 < davidc__> (since the connector is broken, it makes fine contact, but ruins the connector for normal cables. Yes this has happened to me)
18:56 < davidc__> Solution is generally to force replacement of the test cable every $N boards tested, but that can be difficult to enforce at the fab
```

Two small stubs shouldn't make things much worse at 480 Mbps.

As a bonus, if you ever manage to tear off the SMT connector, you can solder directly to testpoints to make the device work again. (But the cable would need to be well restrained or you'll just tear off the testpoints again.)

whitequark, 2019-04-09:
Fixed in e91c7a9847.

Closed 2019-04-09.

Thread 125 (2019-04-12):

Protection resistor for FPGA & level shifter on the sync pin

electroniceel, 2019-04-12:
There are resistor networks RN1 and RN3 between the FPGA and the '45 level shifters of the io ports. My guess is that these are there mostly to protect against the pins burning out due to contention when buggy hdl code is loaded.

If that is the reason, then it would only be consistent to add a resistor between the FPGA and the level shifter for the sync pin too.

Regarding the resistor value:
The value should most probably be the same as RN1 and RN3. But currently these are still marked as "TBD".

The current datasheet for the ice40hx doesn't specify a abs max. value for the io ports anymore. But on IRC daveshah found an old version of the datasheet that specifies 20mA:
http://static6.arrow.com/aropdfconversion/5439a9fe06e5510518bbd9887f93dff8a029b60a/ice40hxdatasheet120330.pdf
His guess is that this value got lost during the transition from SiliconBlue to Lattice.

20mA @ 3.3V would mean 165 Ohms. But the '45 would most probably drop the voltage on contention. So my guess is that 100 Ohms could be enough to protect from permanent damage, but 220 Ohms would be on the safe side.

electroniceel, 2019-04-13:
I have a proposed implementation for this as pull request #126.

This leaves the resistor value at TBD.

Closed 2019-04-13.

Thread 127 (2019-04-14):

Add LEDs for status of port Vio

electroniceel, 2019-04-14:
As discussed on IRC: it would be nice to have LEDs showing if Vio on each of the ports is enabled.

The LEDs should be next to the port connectors. Either on the side, where the J2 / J3 labels currently are, or on the inside, next to the "A" or "B" silkscreen labels (moving the testpoints or getting rid of them as we now have some on the back side).

I prefer the J2 / J3 label positions, because if you have an addon board connecting to both ports on top of Glasgow, you won't see them on the inside. But the exact positions of the J2 / J3 labels are near to the screw holes. So LEDs there could touch screw heads or washers. So maybe a few millimeters to the indside, where the R24 / R25 labels are now.

Regarding color: I'd prefer green, like a power led. Yellow like the activity led would also be an option.

I would connect them directly to the enable inputs of the voltage regulators as this signal has a constant voltage.

@marcan I can do a layout patch, but I guess you'll want to redo it afterwards because my try is not beautiful/symmetrical/... enough. So it is probably better if you do it.

marcan, 2019-04-24:
Done in 104b364.

Closed 2019-04-24.

Thread 130 (2019-04-16):

Change regulator from MIC5355-S4YMME

whitequark, 2019-04-16:
This regulator appears to be out of stock or soon out of stock at multiple distributors, for unknown reasons.

electroniceel, 2019-04-17:
@marcan
When you are re-working the layout to fit the new regulators, could you please also reposition R6 next to the regulator region: one pad of it is quite near to the mounting hole so that I fear a washer, standoff or similar hardware might short or damage the resistor.

A standard washer for M3 has 7mm outer diameter. I suggest 1mm tolerance and safety margin around it and then you end up with 9mm diameter or 4.5mm radius.

whitequark, 2019-04-17:
We should put that keepout zone on the PCB.

electroniceel, 2019-04-17:
There is the Courtyard layer, I think it is designed for such stuff

electroniceel, 2019-04-22:
The courtyard & resistors are done with #132.

marcan, 2019-04-24:
New regulators in f3fa13a

Closed 2019-04-24.

Thread 135 (2019-04-24):

Regulator behavior after short circuit

whitequark, 2019-04-24:
To reproduce this issue, do this:
  1. `glasgow voltage A 5.0`
  2. Short Vio to GND. Do this in a way that doesn't bounce as bounce will hide the issue.
  3. The board stays powered down--the 3V3 rail is dark because of brownout detection. However a considerable current is flowing through the regulator.
  4. Note that regulator EN pin is actually low.

marcan, 2019-04-25:
Okay, so the problem here is [this](https://electrical-engineering-portal.com/selectivity-between-circuit-breakers).

We have two current limits: the one inherent to the TPS73101DBV and the upstream TPD3S014. The problem is that the latter trips faster and harder, and that the former has a memory characteristic.

1. When Vio is shorted hard to GND, current begins flowing through both devices. The TPD3S014 detects this overload earlier, and starts limiting current. This stabilizes with the TPD3S014 dropping about 4.5V and the TPS73101DBV dropping less than 0.4V or thereabouts.
2. At this point, the internal 5V rail is at 0.4V. This is not enough to power any logic, so the TPS73101DBV no longer functions.
3. The 3.3V rail is also going low, and with it EN, but by this point the TPS73101DBV cannot respond to this low-EN condition and properly shut down; instead, the gate of its pass transistor remains charged and passing current, as it has no discharge resistor or other passive path from gate to GND when not powered properly.
4. With the TPD3S014 dropping most of the voltage, it gets very hot; this causes it to go into thermal shutdown quickly.
5. At this point the internal 5V rail drops to 0. However, the pass gate of the TPS73101DBV remains charged.
6. After the thermal trip in the TPD3S014 resets a few milliseconds later, the TPS73101DBV begins passing current again since its gate is still charged. This causes another thermal trip, and the system oscillates through thermal trips and never recovers.

If the device is unplugged and plugged back in, the lockup persists: the pass transistor gate of the TPS73101DBV seems to easily stay charged for over a minute while completely unpowered. Removing and reinstating the fault while unpowered has no effect; on next power-up the board still locks up. To clear the condition, the board must be powered with no fault present (or the fault removed while powered).

Solutions being investigated:

1. Use a regulator other than TPS73101DBV, which does not have the gate discharge problem.
1. Replace the TPD3S014 with TPD3S044, which has a higher current limit and may allow enough voltage to remain on the 5V rail through a fault condition for the TPS73101DBV to cleanly shut itself down.
1. Introduce a protection resistor in series with the TPD3S044 output. This can be before the feedback divider, so it would introduce dropout voltage, but not bad regulation. A Vio fault with a 1Ω resistance does not cause this problem; instead the TPS73101DBV drops most of the voltage and goes into thermal and current limiting, which is what we expect.

marcan, 2019-04-25:
255e8c5 implements solution #<b></b>3. Waiting for parts to arrive to qualify it and determine final resistor value, and also test #<b></b>2.

sixtyfive, 2019-04-25:
Not sure if it has suitable specs for your purposes but I've had good experiences with the 3V3, PDIP version of the TPS71xx, which is also available as SO and TSSOP and with different fixed voltages or adjustable.

whitequark, 2019-04-25:
SO and TSSOP are far too large.

marcan, 2019-04-30:
Okay, so the problem wasn't the TPD3S014 per se, at least not initially. The initial transient response where we lose 5V entirely is just due to lack of bulk capacitance on that rail (and things like impedance of the USB cable and transient response of whatever is upstream). After that, indeed the TPD3S014 current limit triggers ahead of the downstream regulator and we never recover.

Putting 220µF of capacitance on the internal 5V rail (after the TPD3S014) solves the problem entirely, with the 5V rail dropping briefly (below the brownout threshold, but not for long enough for the LM3880 to trigger a reset/shutdown sequence, and not low enough to brown out the 3V3 rail). This avoids a reset entirely, with the unit remaining active and functional through the event; the TPS73101DBV goes into current limiting and gets hot and that's it (this is the same thing that already happened if the output was enabled into a dead short; in that case the TPS73101DBV ramping up correctly ended up triggering the current limit without any upstream effects).

So we're going to go with several mitigations:

1. Drop the EN pulldowns to 10K. This may or may not help anything, but it can't hurt and I feel that might help recovery over 100K.
1. Put 0.68Ω in series with the regulator output, before the feedback divider. In my testing, this allows revC0 to recover from a Vio crowbar fault immediately; 5V rises high enough for the regulator to shut itself down. 0.68Ω at 300mA is 0.2V of dropout (this only matters when the output is set to 5V, as lower settings will still regulate properly).
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
  This resistance will be on the back of the board next to an empty footprint; users concerned about dropout at the 5V IO setting can either use a USB host that provides a slightly higher voltage (>5.2V under load will allow correct regulation at a 5V output setting when the load is high) or short out the resistor / install a 0 ohm resistor next to it.
1. Add 150µF (tentative value, needs more testing; 220µF is sufficient with no series resistance, 150µF is sufficient with 0.68Ω resistance) across the internal 5V rail, after the TPD3S014. This solves the actual problem of a load transient browning out everything before the current limit kicks in.
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

(2) solves the steady-state problem (it lets Glasgow recover from a bad state where the TPD3S014 has gone into limiting mode and the output regulator is enabled), while (3) avoids getting into that state in the first place.

I don't think we need to switch to the TPD3S044 necessarily, but it would be an option if we want to allow higher current consumption, and it ought to allow us to use smaller protection resistors while still being able to get out of a lockup state.

Thoughts?

marcan, 2019-04-30:
Looks like 100µF is enough; this droops the 3V3 rail down to 3.1V, but that should be acceptable for a glitch. Performance might be better with the production parts.

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

I was able to shoehorn a 5mm SMT electrolytic into the layout:

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

marcan, 2019-04-30:
Turns out the TPD3S014 said 120µF was required for USB applications all along, derp. Bumped it to 150µF (which is about the highest we can get in that footprint), that should give us plenty of margin.

electroniceel, 2020-06-07:
I'm revisiting this issue as #165 will re-use the dropper resistor of point (2) above
as measurement shunt.

I've tested a stock revC1 with 0.68Ω and 150µF cap. Due to the capacitor,
there is no more brownout on the internal 5V when shorting one port rail.
But when shorting both ports (set to 5V) at once, there is still a brownout.

In stock revC1 this results in a shutdown of the FX2 and ICE40, recovery
after about 3 ms and properly disabled Vio.

I shorted the 0.68Ω resistor and created a short on both rails at once
using two AO3400A MOSFETs, controlled by a function generator.

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

Yellow: internal 5V rail
Magenta: Vio on Port A
Blue: Current flowing through Vio on Port A

So without the 0.68Ω resistor we now don't get the original issue, but
an oscillation at about 9 MHz over the time of a few milliseconds. This
shows that a resistor is definitely needed. The changed behavior could
have to do with the different test setup, like shorting both ports or
interaction of the LDO with the wire inductance of the test harness.

Next was a test with 0.22Ω, which shows a clear improvement, but still
not perfect behavior:

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

Increasing to 0.33Ω fixed these issues:
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

For implementing #165, it is planned to use a 0.47Ω resistor to give the
INA233 the wanted measurement range. 0.47Ω should give enough headroom
for process variation, different usb hosts and varying overload conditions, so that
the LDO stays stable under overload conditions.

marcan, 2020-06-08:
Yikes, that oscillation. Worth noting that I never measured the Vio rail in the scope, just the internal 5V rail.

0.47Ω sounds reasonable; I forget how I came up with 0.68Ω, but I think I was leaving some margin (and also going with whatever values I had lying around to test with). Keep in mind that this was with a (probably higher ESR / lower perf) through hole cap tacked on. If 0.47Ω works then we can go with that and lower the dropout voltage.

That said, since the shunt is now a measurement device, we should consider a settings area to store the actual shunt value / calibration data somewhere in flash. This would allow for calibration, but also changing the value if, for example, a different manufacturing variant run (otherwise identially compatible with software) with different capacitors ends up requiring a higher value to avoid this issue.

whitequark, 2020-06-08:
> we should consider a settings area to store the actual shunt value / calibration data somewhere in flash.

Reasonable, and in fact we can add this at any point when we need it in a backwards-compatible way (since I thought of this when designing the configuration area in the EEPROM). So there's no rush.

Closed 2019-04-30.

Thread 137 (2019-05-01):

Reduce resistor part count

electroniceel, 2019-05-01:
Reduce the number of different resistors by replacing them with similar values. Less different resistor values reduces the count of reels needed for production, reducing costs.

Candidates:
R45 (33 ohms) to 47 ohms
or
R38, R39, R43 (47 ohms) to 33 ohms
These are used for the sync io and aux.

R3 (1 Meg) to 100k
This is decoupling of the usb shield. 1 Meg is a common value for that, but 100k should not make much of a difference.

whitequark, 2019-05-01:
R38 needs to be 47 ohm to stay under AMR, so it is better to change R45.

Changing R3 to 100k is OK.

electroniceel, 2019-05-01:
heartless cost cutters might also reduce the color variance of the leds. But I think that bit of indulgence is justified.

whitequark, 2019-05-01:
Key part of the device! :D

whitequark, 2019-05-01:
(You could cut the costs by making the brightness not matched as well before that, I think.)

electroniceel, 2019-05-01:
the 6k8 R21 is just used for white. that could be changed to 4k7 or 10k

whitequark, 2019-05-01:
I'd rather keep that one.

electroniceel, 2019-05-01:
The other led resistor values seem to be used in some other circuits as well.

marcan, 2019-05-01:
Yeah, it makes more sense to choose nicely matched resistors for the LEDs and then reuse those values where they fit (which is what I did a few times).

Closed 2019-05-01.

Thread 141 (2019-05-12):

Better specify ATECC508A variant in schematic/bom

JJJollyjim, 2019-05-12:
The schematic and BOM only specify that the chip is a ATECC508A, which leaves open which of three packages, and two interfaces are used:

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

It looks to me like the relevant variant is the ATECC508A-MAHDA: can someone confirm that?

whitequark, 2019-05-12:
Yes, it is -MAHDA indeed.

Closed 2019-07-24.

Thread 142 (2019-05-16):

Present revC1 on http://kicad-pcb.org

herostrat, 2019-05-16:
Hey guys,

I wanted to thank you for this awesome project.
Just for the case you didn't know, there is a section on the official KiCad site were interesting projects are presented.
See: http://kicad-pcb.org/made-with-kicad/

I think this project is very interesting and would deserve a place on the list (although I am not qualified to make a decision on this).
You can make a PR to include your board here: https://github.com/KiCad/kicad-website/tree/master/content/made-with-kicad

attie, 2023-02-23:
This repo has since moved - https://gitlab.com/kicad/services/kicad-website/-/tree/master/content/made-with-kicad

Details on submitting a project are here: https://www.kicad.org/made-with-kicad/submit-a-project/

I think this would be a good thing to do! (probably starting with the CS hardware)

whitequark, 2023-02-23:
@attie SGTM

attie, 2023-02-23:
I'm planning to submit a generic "_Glasgow revC_" (rather than "_revCx_", if that works for you...

They require a `projectdeveloper` field - with your permission, I'll list you (wq)?

whitequark, 2023-02-23:
Is that just one person? If so, `Catherine <whitequark@whitequark.org>`

attie, 2023-02-23:
Seems to be, yes - no email, so is just "_Catherine_" okay?

whitequark, 2023-02-23:
`Catherine 'whitequark'` maybe?

whitequark, 2023-02-23:
@attie SGTM

attie, 2023-02-23:
PR here: https://gitlab.com/kicad/services/kicad-website/-/merge_requests/594

herostrat, 2023-02-23:
Thanks and awesome work

Closed 2023-02-23.

Thread 143 (2019-05-25):

Spy-Bi-Wire support

smunaut, 2019-05-25:
Applet to support the 2 wire JTAG variant of TI for the msp430 along with a way to interact with the mspdebug tool (and/or gdb directly) would be really nice :)

http://www.ti.com/lit/ug/slau320ag/slau320ag.pdf

whitequark, 2019-07-27:
I totally agree. Want to sponsor an MSP430 board for me? Although if they're cheap...

Closed 2019-08-01.

Thread 150 (2019-08-18):

Port and validate applets on nMigen native

whitequark, 2019-08-18:
The following is a list of applets with gateware that needs to be ported to native (non-compat) nMigen and validated on real hardware:

 - [x] audio.dac
 - [ ] audio.yamaha_opx
 - [ ] debug.arm.swd
 - [x] display.hd44780
 - [x] display.pdi
 - [x] interface.analyzer
 - [x] interface.i2c_initiator
 - [x] interface.i2c_target
 - [x] interface.jtag_pinout
 - [x] interface.jtag_probe
 - [x] interface.ps2_host
 - [x] interface.sbw_probe
 - [x] interface.spi_controller
 - [x] interface.uart (#228)
 - [x] internal.benchmark
 - [x] internal.selftest
 - [ ] memory.floppy
 - [ ] memory.onfi
 - [x] memory.prom
 - [x] program.avr.spi
 - [x] program.ice40_sram
 - [ ] program.m16c
 - [x] program.nrf24lx1
 - [ ] program.xc6s
 - [ ] radio.nrf24l01
 - [x] sensor.hx711
 - [x] sensor.pmsx003
 - [ ] video.rgb_input
 - [x] video.vga_output (#233)
 - [x] video.ws2812_output

(Although many of these will go away after #147, so maybe that should be done first.)

Closed 2023-07-03.

Thread 151 (2019-08-19):

False positive results in selftest

electroniceel, 2019-08-19:
Selftest can give false-positive results on revC, see for example https://twitter.com/szeloof/status/1161346534098833408

The main reason is probably that cmos inputs are left floating in high-z and their value is used for the test results. This seems to be a leftover from revA and revB which had hold circuits.

So selftest for revC has to be reworked to utilize the pullups/pulldowns.

For the pins-int test the internal pullups of the ice40 should be used. This is not yet supported in nmigen.

whitequark, 2019-08-19:
One problem is that there could actually be shorts on the side of pull drivers too.

electroniceel, 2019-08-19:
There could be shorts on the side of the pull drivers, there could also be a bridge over the 10k resistor, changing pullup/pulldown to push-pull.

Some of this can be detected on the other port utilizing the pins-loop and hoping that there is not the same error on the same pins.

But in the end you can detect all shorts with current measurement. This is why I wanted to have it on the test jig pcb.

esden, 2020-08-25:
Just for added information. I just ran into this issue too.

The `pins-int` selftest consistently results in:
```
E: g.applet.internal.selftest: self-test: FAIL
E: g.applet.internal.selftest: pins-int: fail high: A0 A1 A2 A3 A4 A5 A6 A7 B0 B1 B2 B3 B4 B5 B6 B7
```

All other selftests pass. This is consistent on 3 revC1 boards I could get tested.

FFY00, 2020-09-17:
Also ran into this in a new board, I had tested before with an older version and it passed.

brainstorm, 2020-10-04:
hand-assembled revC1, same here:

```
$ glasgow run selftest
I: g.device.hardware: building bitstream ID 5f3786f6a206364144276824b8f39a8e
Warning: Wire top.$flatten\U$$0.$verilog_initial_trigger has an unprocessed 'init' attribute.
Warning: Wire top.$flatten\i2c_target.\bus.$verilog_initial_trigger has an unprocessed 'init' attribute.
Warning: Wire top.$verilog_initial_trigger has an unprocessed 'init' attribute.
I: g.cli: running handler for applet 'selftest'
I: g.applet.internal.selftest: running self-test mode pins-int
I: g.applet.internal.selftest: running self-test mode loopback
E: g.applet.internal.selftest: self-test: FAIL
E: g.applet.internal.selftest: pins-int: fail high: A0 A1 A2 A3 A4 A5 A6 A7 B0 B1 B2 B3 B4 B5 B6 B7
```

whitequark, 2020-10-04:
Yes, the selftest is completely broken on revC, please stop reiterating this over and over again. I should probably just remove it.

attie, 2020-11-04:
@whitequark can this be closed after 13a3509?

whitequark, 2020-11-04:
No, we still have to implement some form of selftest on revC. I've renamed the issue.

TomKeddie, 2021-02-16:
@whitequark would you like me to look at this?  I think the first steps would be to get the existing tests to be sane on revC?

rwhitby, 2021-02-16:
@TomKeddie I'd be happy to help you with that if desired.

TomKeddie, 2021-02-16:
@rwhitby I'll look at this toward the end of the week.  I have some fixes already on a branch, I made some changes/hacks to find the shorts in the boards I built.

TomKeddie, 2021-02-25:
I have a proposed fix on https://github.com/TomKeddie/glasgow/tree/tomk_20210225_self_test am looking for people with revA, revB, revC0 and revC2 to test please.

RoganDawes, 2025-01-05:
I just started trying to use my CrowdSupply Glasgow C3, and am running into odd behaviour on the selftests. Even the pins-loop test fails, surprisingly, with different pins reported each run.

Not sure how to proceed, but it does feel like more/working selftests would help to diagnose the problem?

Thread 152 (2019-08-19):

Add selftest for sync and aux pins

electroniceel, 2019-08-19:
Currently there is no selftest for the sync and aux pins of revC. These should be added.

For a loop test they should be connected like on the test jig pcb: sync to A0, Aux A10 to A1 and Aux C9 to A2.

These tests also require the internal pullups on the ice40 which are not yet supported in nmigen.

whitequark, 2019-08-19:
Sync to A0?

electroniceel, 2019-08-19:
Yeah. When executing "pins-sync-loop" the user is required to connect the sync pin to port A pin 0.

I don't like looping Aux together as they could probably have a short between them. Connecting them to port A, which was tested independently by the other tests, seems to be a better idea to me.

whitequark, 2019-08-19:
Makes sense

Thread 160 (2019-09-27):

selftest uses outdated LED resource name

emilazy, 2019-09-27:
selftest references the platform resource `"user_leds"`, which seems to throw a ResourceError (`"leds"` works). This bug confuses me a bit though, since as far as I can tell only nmigen-boards migrated the name of this, and there have been no changes involving the resource naming in nmigen or Glasgow itself...

whitequark, 2019-09-27:
Yes, I forgot to change that.

Closed 2019-09-27.

Thread 162 (2019-09-28):

CLI handles USB device permission errors badly

emilazy, 2019-09-28:
If you run Glasgow as a user that can't access the USB device under Linux, you get a `usb1.USBErrorAccess: LIBUSB_ERROR_ACCESS [-3]` backtrace; it should print something more useful about running it with `sudo` or installing the udev rules. (Relatedly, Glasgow should probably drop permissions after opening the USB device when run as `root`.)

whitequark, 2019-09-28:
> Relatedly, Glasgow should probably drop permissions after opening the USB device when run as `root`.

I'm not sure if this works. Suppose you run it in a Docker container--you have to be root then, I think, or you can't write anywhere in it.

emilazy, 2019-09-28:
Well, it should at least drop its privileges after opening everything it needs to. This is good practice even for daemons that need to have access to root-permissioned files. However, it's hard to implement, and given that the CLI just plain crashes and dies if you try to run it in anything that isn't a proper pty with width and height it can determine, I'm not sure `glasgow.cli`-in-Docker-with-pid-namespaces is the most convincing use-case.

whitequark, 2019-09-28:
> Well, it should at least drop its privileges after opening everything it needs to.

You can't do that. An applet can decide to write a file right before termination, and it might not even know the name of this file beforehand (e.g. you're reading a floppy into `track-1.raw`, `track-2.raw` etc).

whitequark, 2019-09-28:
Also, it works just fine for me in Docker? I actually test the installation instructions that way.

whitequark, 2023-10-21:
The error that you get now (since commit 26ba5e70d12b508ebf6f95d4e8544964d28a9d05) is this:

```
$ glasgow list
E: g.device.hardware: missing permissions to open device 001/113
```

The documentation includes instructions for installing the udev rules file that should work, as far as I know, for any remotely modern Linux distribution (including eudev-based ones), so I consider this finished.

Closed 2023-10-21.

Thread 163 (2019-09-29):

config/99-glasgow.rules should maybe set ENV{ID_MAKER_TOOL}

emilazy, 2019-09-29:
...or something of the sort, rather than doing group tests and assigning uaccess directly. udev ships with rules like these:

```
# software-defined radio communication devices
ENV{ID_SOFTWARE_RADIO}=="?*", TAG+="uaccess"

# 3D printers, CNC machines, laser cutters, 3D scanners, etc.
ENV{ID_MAKER_TOOL}=="?*", TAG+="uaccess"
```

electroniceel, 2019-09-29:
hmm, I'm not so sure if Glasgow fits their idea of a "maker tool". The examples they give hint more in the direction of making physical stuff than being used for electronics debugging and rev engineering.

Also this would tighten the dependencies for Glasgow: this ID_MAKER_TOOL was introduced with systemd 230, released 2016-05-21.

I'm not sure we gain anything by declaring being a maker tool. systemd will just give us the same uaccess. I actually like the GROUP="plugdev", TAG+="uaccess" approach, as it gives maximum compatibility with older and newer systems, be they systemd-based or something else.

marcan, 2019-09-30:
Just as a datapoint, eudev does not ship with such rules as far as I can tell.

whitequark, 2019-09-30:
> I'm not sure we gain anything by declaring being a maker tool. systemd will just give us the same uaccess. I actually like the GROUP="plugdev", TAG+="uaccess" approach, as it gives maximum compatibility with older and newer systems, be they systemd-based or something else.

I agree with this. I also don't find "maker tool" a convincing classification.

Closed 2019-09-30.

Thread 164 (2019-10-02):

ICE_MEM is too small, needs to use 24M02 instead of 24M01

whitequark, 2019-10-02:
HX8K bitstream is about 32 Kbit too large for the 1 Mbit device, unfortunately.

I think this (+ possible DFM issues with ESD diodes?) pushes us to revC2.

Thanks to @smunaut for discovering this.

electroniceel, 2019-10-02:
just changing to a 24M02 will not be enough as this will create an address clash with the fx2 eeprom.
See irc discussion for details and ideas to fix it.

whitequark, 2019-10-02:
I looked into this further, let me recap.
  1. The FX2 can boot from `1010000` and `1010001`. My understanding is that it first tries to boot from `1010000` and treats it as a 1 address byte EEPROM, and then from `1010001` and treats it as a 2 address byte EEPROM. However, this needs to be verified on actual hardware.
  2. Currently, we have FX2_MEM at `1010001` and ICE_MEM at `1010010`/`1010011`. We also have ADCs at `1010100` and `1010101`.
  3. Using the E2 strap, 24M02 can take either addresses `1010000`..`1010011` (which will not work because FX2 will interpret `1010000` as a 1 address byte EEPROM and likely fail to boot from it), or `1010100`..`1010111` (which clashes with ADCs).
  4. The ADCs can be easily remapped to `1011000`/`1011001` by changing the ADR1 strap to V_A. This does not clash with the 24M02-xR variant, which has an identification page at `1011100` when E2 is strapped high.
  5. Strapping ADCs with ADR1 to V_A deprives us of the ability to use four ADCs on the main I2C bus on revD.
  6. When the FX2 is booting from an EEPROM, it can never directly load more than 16 KB since it only has that much RAM; the largest FX2 package that exposes the external memory bus lets it have up to 64 KB of memory, but we don't use that package, so we have a 16 KB hard limit. I have used a 32 KB EEPROM just in case it will come in handy.
  7. CAT24M01 costs 0.78€@100. CAT24C256 costs ~0.18€@100. M24M02 costs 1.98€@100.

My conclusion is that, even if consolidating ICE and FX2 flashes into a single package would work (i.e. the FX2 can actually boot from a M24M02 strapped with E2 to low), it would be more expensive. I think the simplest solution is to remap accesses to ICE flash above certain addresses back to the top addresses of FX2 flash.

Closed 2019-10-02.

Thread 165 (2019-10-03):

Replace ADC with INA233

electroniceel, 2019-10-03:
Replace ADC with INA233 in revD.
http://www.ti.com/product/INA233

It can monitor voltages and trigger an interrupt in cases of overvoltage, undervoltage and so on. The interrupt can then directly shut off the LDO, without interaction of the fx2 or other processor.

Also it can measure current, allowing to program a precise overcurrent limit.
Use the 0.68 Ohm resistor we have after the LDO as current shunt.

VBUS voltage input would be connected to the Vsense of the port. This allows the same flexibility as revC, but with much enhanced voltage range on Vsense, as the INA233 allows up to 36V.

whitequark, 2019-10-03:
Of note is that the ADC we are currently using can also shut off the LDO directly, in principle, but the board is not designed to take advantage of that. I am not sure if the tradeoff of somewhat worse UI and somewhat better theoretical reliability is worth it.

I think changing the FX2 code to shut off all regulators indiscriminately in case an ALERT# coincides with I2C hangup would be an acceptable fail-safe, but if there is a good way to make INA233 shut off the LDO directly that would not degrade the UI too much, we should do that.

electroniceel, 2019-10-03:
The ALERT# can directly pull down the enable signal of the LDO for the respective port. Just one extra resistor required. The FX2 can read if a over* event occured via the STATUS_* registers of the INA233.

whitequark, 2019-10-03:
How does it pull down both that and ALERT# of the FX2? I don't think polling I2C is acceptable.

electroniceel, 2019-10-03:
We could do that with diodes:
1. between ALERT# of the FX2 and the ALERT# out of the INA233
2. between LDO enable and the ALERT# out of the INA233

whitequark, 2019-10-03:
Will the added diode drop work well with the rest of the circuit? This has occurred to me, but it's not immediately obvious if there are bad implications.

electroniceel, 2019-10-03:
I suggest to use BAT54CW / BAT54-05W common cathode dual diodes in SOT-323. They are small and the max forward drop is about 300mV if we stay <1mA. I don't think this is gonna have negative effects on the function as we have CMOS logic inputs on the LDO enable and FX2 ALERT#.

The Vio LED is tied to the LDO enable. We'd have to keep that before the dropper resistor, so the LED doesn't automatically shut off when the LDO enable is pulled down by the Alert signal of the INA233. The FX2 has to switch the LDO enable off for the LED to go off. The time delay won't be visible. It is just in case the FX2 should ever lock up that the Vio LED isn't accurate. But I'd say mission accomplished if the DUT survives even in case of a lockup.

whitequark, 2019-10-03:
I think that's a reasonable thing to consider, with an assembly option that disables it in case we get it wrong.

electroniceel, 2020-07-12:
The original idea in #165 and #135 was to reuse the 0.47 Ohms dropper resistor
    we already have for the regulator as current shunt too. As the INA233 has a fixed
    measurement range of +- 81.9 mV, this would allow to measure 174 mA. My initial
    thought was that this is enough, as the specced load of the TPS73101 is 150 mA.

    Review and experimentation has shown that the TPS73101 can be used to 350 mA in
    most configurations before limiting set in, for a programmed output of 5 V I
    could use it even up to 420 mA. As one of the design goals of using the INA233
    is overcurrent protection, the settable range should be higher than what the
    regulator can output in best case.

    So the design is changed to a 0.15 Ohms current shunt and an additional 0.33 Ohms
    dropper resistor in series. This gives a total 0.48 Ohms drop for the regulator
    and a measurable current range to 546 mA.

    For both resistors a DNPed parallel footprint is provided as before, allowing
    the user to reduce the voltage drop if desired.

whitequark, 2020-07-12:
@electroniceel Excellent investigation!

whitequark, 2020-12-27:
This has now been done in revC2 and merged.

Closed 2020-12-27.

Thread 169 (2019-10-06):

revD minispec

whitequark, 2019-10-06:
Summarizing the broad design points regarding revD in one place:

1. Four I/O banks (ABCD) instead of two (AB)
2. Placement of AB and CD so that addons developed for revC work on revD side by side (at least if width allows). That means relative position of AB and CD is the same as AB on revA-C.
3. No LVDS bank.
4. Goal: we should provide I2C and power to ports. Proposal#1: put I2C on NC pins in the 20-pin connector, put GND/3V3/GND/5V on a pin header next to 20-pin connector. Proposal #2: put SDA/SCL/GND/3V3/GND/5V on a pin header next to 20-pin connector, leave NC pins as NC.
5. Goal: I2C on ports should not impact reliability due to faults such as stuck bus. Proposal: use 1:4 I2C level translating passthrough switch with dedicated reset pin.
6. Problem: we run out of I2C addresses (definitely on PCA6408, possibly on DAC081 without change of package). Proposal#1: change PCA6408 part and DAC081 package. Proposal#2: expand passthrough switch from (5) to 1:8, use identical parts to revC (simplifies production!).
7. Placement/layout sketch: https://marcan.st/transf/Screenshot_20190510_145158.png
8. Proposal: Replace ADC with INA233 to allow for precise current and voltage limiting (#165)
9. Consideration: if there is free board space, some sort of low pin count RAM would help with streaming workloads. Only a "nice to have" and should be dropped if troublesome at all.

electroniceel, 2019-10-06:
> Placement of AB and CD so that addons developed for revC work on revD side by side (at least if
> width allows). That means relative position of AB and CD is the same as AB on revA-C.

This could be solved by an adapter board which can be plugged into revD and which provides connectors with the same width as revC.

For this to work revD has to be wider and the position of the new connectors must not intersect the position of the revC ones.

whitequark, 2019-10-06:
Huh? Why use an adapter if we can just not have one?

electroniceel, 2019-10-06:
It might make layout easier if we want/need to use a different layout than what marcan proposed.
Such an adapter board would be dirt cheap and I don't think many users with revC addons would mind.

whitequark, 2019-10-06:
But it needs to be produced, packaged, sold, assembled, etc. And then you have to not lose or forget it.

The only thing better than solving a problem cheaply is to not have it in the first place.

electroniceel, 2019-10-06:
Another point: my I/O protection board will work easier and better if it has access to the IO voltage DAC output. I suggest to put that on the addon pins too. We could replace one of the GNDs proposed above, there are enough GND pins on the port header already.

whitequark, 2019-10-06:
We are not going to change any GND pins on the connectors to non-GND.

whitequark, 2019-10-06:
Oh sorry, you meant one *new* GND pin. That could work.

whitequark, 2019-10-06:
The reason I suggested using this many GND pins on the extension connectors is to make shorts between adjacent pins a little less destructive (short to GND generally stresses the LDO, short from 5V to 3V3 will stress all logic on 3V3 too).

electroniceel, 2019-10-06:
yes, the new header. Not change the existing 20 pin header.
I suggest using female connectors for the new header. It is harder to short these.

whitequark, 2019-10-06:
That makes sense. I think they should somehow be keyed, too.

whitequark, 2019-10-06:
> Another point: my I/O protection board will work easier and better if it has access to the IO voltage DAC output.

I'm confused. Isn't that just Vio already?

electroniceel, 2019-10-06:
What is the use case for this keying? If you plug in single wires, a keying won't matter. If you plug in full addon boards, these won't fit into the 20 pin header the wrong way, so the other connector fits too.

I think of regular female pin header, something like this: https://lcsc.com/product-detail/Pin-Header-Female-Header_HOAUC-2685Y-106CNG1SNA01_C350307.html
Getting keyed ones might be more expensive.

whitequark, 2019-10-06:
I guess it's fine. If it's not centered wrt 20 pin header, then plugging it the wrong way wouldn't result in electrical contact even if you try to plug in the board one pin off and it skews.

electroniceel, 2019-10-06:
> > Another point: my I/O protection board will work easier and better if it has access to the IO voltage DAC output.
>
> I'm confused. Isn't that just Vio already?

I explained it somewhere, but don't find it now. Probably on IRC.
Overvoltage will be current limited, but the current still has to go somewhere. Vio might rise above the programmed voltage if there is not enough load on it. So there will be an opamp and transistor to drain it. But the opamp needs some reference value to compare the current Vio against. The DAC output voltage is this reference value.

More details here:
https://github.com/electroniceel/io-protection-notes/tree/master/vio-discharge-sim

whitequark, 2019-10-06:
> The DAC output voltage is this reference value.

Makes sense. One problem is that it's not actually the same as Vio, there is a more complex function between the DAC out and the Vio voltage.

electroniceel, 2019-10-06:
> Makes sense. One problem is that it's not actually the same as Vio, there is a more complex function between the DAC out and the Vio voltage.

That is already accounted for, see the U3 opamp in my simulation schematic.

revC1 has VDAC test points on the back for exactly this use case. The voltage scaling would be the same for revD, just on a regular connector which doesn't require the user to solder bodge wires.

whitequark, 2019-10-06:
I am a bit worried about making VDAC a part of our "public API".

electroniceel, 2019-10-06:
Will revE not be only SYZYGY and you need a SYZYGY-to-regular-glasgow-port addon? If so, the addon can have a similar dac-to-ldo configuration.

whitequark, 2019-10-06:
> Will revE not be only SYZYGY and you need a SYZYGY-to-regular-glasgow-port addon?

I was thinking about including one or two legacy ports somewhere, since it's so convenient to do some wirewrapping to them.

electroniceel, 2019-10-06:
ok, but why should we develop some new DAC/LDO scheme for these regular ports? I think it works quite well as it is now.

If we ever have to change it, we could either add an opamp to Glasgow to keep compatibility or respin the protection board with a jumper to select the correct ratio. Or a more automatic way with autodetection and a mux.

whitequark, 2019-10-06:
OK. No objection to DAC out on accessory connector.

electroniceel, 2019-10-06:
If there is enough board space left: add a DNP SO-8 footprint for a SPI-flash connected to the FPGA to load/store user data from in a setup without host.

whitequark, 2019-10-07:
We can use [PCA9544A](https://www.ti.com/lit/ds/symlink/pca9544a.pdf) as the I2C mux, connecting all of our level translating GPIO expanders behind it. It has four interrupt inputs and one interrupt output. We can connect the INA233 alert output to PCA9544A interrupt input, and PCA9544A interrupt output to the FX2 interrupt input (which is also shared with FPGA alert pin). This way, a PCA9544A reset followed by a register read should give us the exact faulting channel, which seems reliable enough to me. Also, in this scheme, we do not need any diodes and can connect INA233 alert output directly to LDO EN input.

whitequark, 2019-10-07:
Actually, not PCA9544A, since it does not have a reset.

whitequark, 2019-10-07:
Note that while PCA9545A is a voltage translating I2C switch, I think we should run all of its subordinate buses at 3V3 as well. First, the ~INTn inputs are referenced to the bus pull-up voltage. Second, I think the connected extension board should not be forced to interoperate with Vio level I2C but 3V3 level I2C. So we would keep the voltage translating PCA6408 IO expander (and use it for translating) even as we use a voltage translating I2C mux (and do not use it for translating).

electroniceel, 2019-10-08:
How do we deal with the too few I2C addresses for the PCA6408? Is the PCA6408 for pullup/-down of a port connected to the same I2C sub-bus as the addon board on this port?

The list of available I2C addresses becomes part of the addon interface guarantee, right? We already use up a lot of address space for common stuff (like EEPROMs, DAC, an addon might also want to use the tried and tested PCA6408 to switch something onto the pins of the port,...).

So I'm more leaning towards splitting the I2C bus into smaller bits by using a 8-way switch like the [TCA9548A](http://www.ti.com/product/TCA9548A). Just the fx2 eeprom would be directly on the bus as the fx2 wouldn't start without, and the TCA9548A. We'd then have 4 sub-busses for internal stuff, including the PCA6408 for pullup/-down per port. The addon connectors each get their own sub-bus, so that just the address for the TCA9548A and the fx2 eeprom is blocked from usage on the addon board. Also a broken addon can't interfere with the glasgow controlling it's pullups/-downs.

I think all the I2C busses, including the ones on addon boards, should just run on 3V3. This makes it easier and prevents unexpected trouble like oscillating i2c-level-shifters and the like.

whitequark, 2019-10-08:
> The list of available I2C addresses becomes part of the addon interface guarantee, right? We already use up a lot of address space for common stuff (like EEPROMs, DAC, an addon might also want to use the tried and tested PCA6408 to switch something onto the pins of the port,...).

This is a good point. I did not realize that the addresses used by Glasgow-internal I2C devices become "holes" in our I2C addressing scheme. I think your suggestion makes a lot of sense.

electroniceel, 2019-10-10:
The 8-way I2C switches don't have integrated IRQ handling, so we have to use something else. Here is a quick sketch of what I propose:
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

In response to "`<whitequark>` that seems kinda like the worst of both worlds":

This adds a 74HC4066 analog mux to the diode logic I proposed earlier in #165. This analog mux allows the user to select between each INA233-Alert only shutting off it's own port and each Alert shutting off all ports simultaneously in hardware. While you could think of use cases where you for example just want port A and B shut off together, I think offering either global or local shutoff will allow a reasonable behaviour for most cases.

But we can now handle both cases fully in hardware, with quick response and no software handling necessary in the FX2.

---------
The Reset for the TCA9548A I2C switch and the 74HC4066 global/local shutoff will need 2 more GPIOs on the FX2 which aren't free.
- The reset for the TCA9548A could be wired together with the FX2-LED. The FX2-LED will be on as soon as code is loaded into the FX2, the TCA9548A will need to be high most of the time. Only in case we really assert a reset the pin will be pulled low, resulting in a short, but probably not noticeable flicker of the LED.
- The ICE-LED could be rewired directly to the ICE40. It only lights up if gateware is loaded and could be hard-wired high by default in gateware. Then we get one GPIO on the FX2 to control the 74HC4066 global/local shutoff.

whitequark, 2019-10-10:
I'm really unhappy about the increase in complexity. I think neither the hardware global shutoff feature nor the reduction in reserved addresses is really justifies adding all this.

whitequark, 2019-10-10:
After discussion on IRC and careful consideration I changed my mind. Let's prototype this. Instead of rewriring ICE-LED to iCE40 we should rewire it to CDONE, I am not sure why it's not already done that way.

whitequark, 2019-10-10:
To add to this, the 1:8 mux allows us to strap every ADC/DAC to the same addresses, which is very nice and reduces errors as well as simplifies firmware.

electroniceel, 2019-10-11:
As per discussion on IRC, remove the ATECC digital signature IC. Not enough benefit for the work of implementing the software for it.

electroniceel, 2020-01-17:
as per discussion on IRC, the interface to the addon boards should have one pin for swizzling i2c addresses for stacking up to 2 addon boards. This pin is GND on Glasgow. An addon that is designed for stacking will set it to 3V3 on it's output connector.

Addon boards are expected to connect one address pin of their ID-EEPROM to this pin. If they have more i2c devices than the ID-EEPROM, they are expected to have an I2C switch, which address is also connected to the swizzle-pin.

whitequark, 2020-01-17:
> If they have more i2c devices than the ID-EEPROM, they are expected to have an I2C switch, which address is also connected to the swizzle-pin.

To expand on this, the reason is to avoid address collisions between one device on a bottom addon strapped to A=0 potentially having a conflict with a completely different device on a top addon strapped to A=1, e.g. if they have different address bits adjustable with address straps.

DurandA, 2020-01-20:
Will you keep the ATECC508A/608A footprint or completely get rid of it?

electroniceel, 2020-01-20:
> Will you keep the ATECC508A/608A footprint or completely get rid of it?

I'd say there is no reason to waste space for it. That is unless there is actual interest in using the ATECC on Glasgow, with someone contributing code to make use of it (creating a CA, creating certificates, signing, checking,...)

revD will expose the internal I2C over the new addon interface, so you could also put a ATECC on an addon board, without any specific provisions necessary on the side of Glasgow revD.

hardkrash, 2020-01-23:
Would changing the USB connection to Type-C legacy UFP Sink be acceptable?
It involves a type-c connector and 2 resistors, no additional logic.

Could upgrade to have usb super speed streaming, but that's just icing on the cake.

whitequark, 2020-01-23:
> Would changing the USB connection to Type-C legacy UFP Sink be acceptable?

@esden was worried about assembly of these.

> Could upgrade to have usb super speed streaming, but that's just icing on the cake.

Nope. Would need to change almost the entire design to have SS; that'll be revE.

sslupsky, 2020-03-19:
Add a couple Pmod interfaces?

whitequark, 2020-03-19:
@sslupsky Glasgow isn't intended to be a general purpose developer board, so I would say Pmod interfaces are out of scope.

sslupsky, 2020-03-19:
I was think along the lines of possibly using Glasgow with sigrok as a logic analyzer?

electroniceel, 2020-03-19:
> Add a couple Pmod interfaces?

You could design an addon board for Glasgow with a Pmod on top.

sslupsky, 2020-03-19:
I think so.  When do you think will the Glasgow be available for sale?

whitequark, 2020-03-19:
> I was think along the lines of possibly using Glasgow with sigrok as a logic analyzer?

Do you need Pmods for that?

hardkrash, 2020-03-19:
I would leave specialty I/O for kilts to attach.

In your instance a pmod snooping kilt might be the best bet.

I would rarely use PMOD for my applications, and probably resort to jumper wires in that application as the -.1" connectors are easy to come by.

hardkrash, 2020-03-19:
> > Would changing the USB connection to Type-C legacy UFP Sink be acceptable?
>
> @esden was worried about assembly of these.

There are USB 2.0 only Type-C connectors that are pretty simple, no hidden pins and the like of a super speed version.  I understand the desire to keep it simple.

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

Makes sense.

Thread 170 (2019-10-29):

Nasty Schematic vs PCB bug in revC1 - 1.2V and 3.3V regulators are swapped

TomKeddie, 2019-10-29:
I really want this to be some kind of mistake I've made but I'm fairly sure the pcb does not match the schematic.  I believe the part numbers for U8 and U36 are swapped in the PCB file, the 1.2V regulator (TLV73312PQDRVRQ1) is shown as U8 driving the 3.3V bus.

This also affects the bom generated by the interactive bom generator.  I'm hoping my board is ok but once I saw the 1.2V rail rise to 1.4V and shutdown I had a sinking feeling.

You can also see this in the text of the kicad files (thank you kicad for using plain text).  The [schematic](https://github.com/GlasgowEmbedded/glasgow/blob/master/hardware/boards/glasgow/glasgow.sch#L3042) does not match the [pcb](https://github.com/GlasgowEmbedded/glasgow/blob/master/hardware/boards/glasgow/glasgow.kicad_pcb#L3341) (github won't view the file).

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

marcan, 2019-10-29:
Ugh. Yeah, we found this, and [fixed it](https://github.com/GlasgowEmbedded/glasgow/commits/revC1), but evidently I forgot about regenerating the fabrication outputs (and updating the PCB) with the fixed schematic data.

I'll do that as soon as I get home. Sorry that you had to stumble upon this the hard way.

TomKeddie, 2019-10-29:
Thanks I figured someone must have seen this I guess I should have been working off the branch not master.

marcan, 2019-10-29:
Those commits should be in master too, unless I did something horribly wrong. What I just didn't do yet is propagate the change to the other files.

TomKeddie, 2019-10-29:
I test generated a PR from revC1 to master, the kicad_pcb file changes were the only ones that came up not merged.

TomKeddie, 2019-10-29:
I should add that I have absolutely no ill feelings about this.  I'm in the wild west of hardware and here be dragons.  I built two boards things that the process might not be smooth, I now need to find the shorts on my other board.

marcan, 2019-10-30:
Should be fixed in dc3e083 (branch) and b436530 (master). Sorry again for leaving this pending so long :(

Closed 2019-10-30.

Thread 171 (2019-11-03):

selftest: some tests ignore --port spec

TomKeddie, 2019-11-03:
This may be all tests, these are the inconsistent results I've observed.

voltage:
```
(venv) tom@z400:~/git/GlasgowEmbedded/glasgow/software$ venv/bin/glasgow run selftest --port A voltage
I: g.device.hardware: device already has bitstream ID f40ac1bcdf477dc065149f7980d9eaf3
I: g.cli: running handler for applet 'selftest'
I: g.applet.internal.selftest: running self-test mode voltage
E: g.applet.internal.selftest: self-test: FAIL
E: g.applet.internal.selftest: voltage: port B out of ±5% tolerance: Vio=1.80 Vsense=0.00
E: g.applet.internal.selftest: voltage: port B out of ±5% tolerance: Vio=2.70 Vsense=0.00
E: g.applet.internal.selftest: voltage: port B out of ±5% tolerance: Vio=3.30 Vsense=0.00
E: g.applet.internal.selftest: voltage: port B out of ±5% tolerance: Vio=5.00 Vsense=0.00
```
pins-ext:
```
(venv) tom@z400:~/git/GlasgowEmbedded/glasgow/software$ venv/bin/glasgow run selftest --port A pins-ext
I: g.device.hardware: device already has bitstream ID f40ac1bcdf477dc065149f7980d9eaf3
I: g.cli: running handler for applet 'selftest'
I: g.applet.internal.selftest: running self-test mode pins-ext
E: g.applet.internal.selftest: self-test: FAIL
E: g.applet.internal.selftest: pins-ext: fail short: B0 B1
```

TomKeddie, 2021-02-16:
This is a dupe of https://github.com/GlasgowEmbedded/glasgow/issues/151

Closed 2021-02-16.

Thread 172 (2019-11-04):

revC1 schematic : lvds compatible connector part number is incorrect

TomKeddie, 2019-11-04:
The suggested part number 20021321-00040T4LF in the schematic refers to a 40 pin connector, a 44 pin connector is required.  Unfortunately I could not find an economic 44 pin connector to recommend.

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

electroniceel, 2019-11-04:
For J5 itself, @esden has used Samtec FTSH-122-01-F-DV-K-P while @gregdavill has used FTS-122-01-L-DV.

According to the mating connector search at Samtec, CLP-122-02-F-D and FLE-122-01-G-DV should be possible mating connectors. Both seem to be available in single quantity at Mouser.

But I guess we should try both and check if the mechanics work out, meaning they stay on, but can still be removed without too much stress on the solder joints of J5.

electroniceel, 2020-03-03:
I now tested Samtec FLE-122-01-G-DV-A and CLP-122-02-F-D-A on the FTS-122-01-L-DV of my Glasgow:

- Both fit
- Both are availably in small quantities from Mouser
- The CLP one is more difficult to insert and remove, Samtec probably increased the tension due to the smaller height
- The FLE one looks and feels more sturdy to me

-> I would recommend the Samtec FLE-122-01-G-DV-A in the schematics

Closed 2020-03-03.

Thread 180 (2020-02-03):

Multiple Simultaneous Applets

gregdavill, 2020-02-03:
For a hardware project I'm working on now I'm using both the Glasgow as a UART pty and a separate basic FTDI breakout for JTAG.

I see potential for having both a JTAG and UART interface when debugging a target.
Or having two UARTs one for a CLI and another for Embedded Logic analyses in SoC designs.
From a hardware perspective there isn't any reason why Glasgow couldn't theoretically handle this.

But I'm not sure what that would look like from the software side, and the command line side.

I understand this feature may be impractical to support in a general sense, but do you think it may be possible for some subset of cases? Like Applet.* + UART?

whitequark, 2020-02-03:
> I understand this feature may be impractical to support in a general sense, but do you think it may be possible for some subset of cases?

I think it is, in principle, practical to support in general, and in fact, I have aimed to do so from the very beginning. It's been one of the design goals!

> But I'm not sure what that would look like from the software side,

This one is easy: you simply build/run multiple applets. I've never actually tried it, but none of the applet APIs assume that there is only one applet; there can be any amount of submodules in the target, and asyncio takes care of concurrency inherent to multiple applets.

> and the command line side.

Here... I'm not sure either, which is precisely why it isn't yet implemented.

Let's brainstorm CLI ideas in this issue?

gregdavill, 2020-02-03:
Brainstorming sounds like a good idea.

One idea, which I think could work in practice, but may be not very elegant.
The initial command which creates the multiple applets, also creates a server, each applet gets a socket or pipe interface.

In separate terminals each applet can run in a "client" mode which connects to the server to interact with the hardware. Kind of like how litex_server operates.

whitequark, 2020-02-03:
One problem is that currently applet code assumes that build/run state is one and same, and that's pretty well baked in. So these "clients" would have to be thin clients, perhaps reduced to passing the terminal fds and cwd through that socket.

But I think I could do that.

whitequark, 2020-02-03:
That still leaves open a question of how to specify multiple applets on the CLI invocation of the server.

gregdavill, 2020-02-03:
You could just specify run multiple times?
```
glasgow run uart --pin-rx 1 --pin-tx 0 -V 3.3 -b 115200 pty run uart --pin-rx 2 --pin-tx 3 -b 115200 pty
```

whitequark, 2020-02-03:
I think you can't do that with argparse. Imagine what would happen if `pty` took a filename.

gregdavill, 2020-02-04:
Turn each command into a string?

```
glasgow run "uart --pin-rx 1 --pin-tx 0 -V 3.3 -b 115200 pty" "uart --pin-rx 2 --pin-tx 3 -b 115200 pty"
```

So argparse just sees two strings? This gets ugly when filenames are required and strings need to be escaped.

Or adding a new command:
```
glasgow run-multiple
```

That drops you into a REPL or other interactive console that enabled you to add interfaces then run. If this is the path this feature heads down, it would be possible to show recently used interface combinations.

whitequark, 2020-02-04:
I think a guard argument can be done:

    glasgow run-multiple uart --pin-rx 1 --pin-tx 0 -V 3.3 -b 115200 pty -- uart --pin-rx 2 --pin-tx 3 -b 115200 pty

Still kind of ugly though.

alexhude, 2020-03-12:
+1
**run-multiple** with **--** guard argument is pretty straight forward, I vote for that :)

andresmanelli, 2020-03-13:
Hello, what about a config file? I see it like a "glasgow compose" file

`glasgow run -f config.?`

whitequark, 2020-03-13:
> what about a config file?

I don't know what a good syntax would be, and worse, currently the frontend is very closely tied to argparse.

RX14, 2020-03-14:
Would it be possible to have the interface be to run glasgow multiple times in multiple terminals and have that be handled gracefully? Then the server/daemon would be configured over some form of IPC?

whitequark, 2020-03-14:
> Would it be possible to have the interface be to run glasgow multiple times in multiple terminals and have that be handled gracefully?

Not really, since there's no partial reconfiguration possible on iCE40.

alexhude, 2020-03-14:
I think config file should be an alternative to command arguments, not a replacement. Therefore run-multiple with guard or something similar should still exist.

ChuckM, 2023-05-09:
Random thought on this somewhat dated thread ...

One might consider both a config file and arguments. In many ways glasgow appears to be like a "hardware interpreter" in the same sense the python is a software interpreter. A glasgow "program" would consist of the applet(s) to run. It would specify at its entry point what command line arguments it would accept and how it would use them.

I'm going to have to noodle on some syntax ideas but basically think shell script where instead of shell commands you have applets.

whitequark, 2023-05-09:
> I'm going to have to noodle on some syntax ideas but basically think shell script where instead of shell commands you have applets.

We do not need new syntax. We have perfectly good Python right here. We even have a shell-style interpreter! (`glasgow repl`)

fabianfreyer, 2023-05-09:
> We do not need new syntax. We have perfectly good Python right here. We even have a shell-style interpreter! (`glasgow repl`)

@whitequark does this mean that the ability to run multiple applets via the CLI is no longer a goal? Above, you mentioned that this is blocked on the command-line side because it's not clear how this should look. There seem to be two, not necessarily mutually exclusive, approaches:
* Shoehorn this into a command-line (`run-multiple`, etc.), which seems difficult, if not impossible using argparse.
* Specify what applets to run in some config file. This was blocked earlier by the question about a good syntax (https://github.com/GlasgowEmbedded/glasgow/issues/180#issuecomment-598722258). Does this mean this is no longer an issue, and people should just use the `script` / `real` subcommand instead? In this case, it's not really clear to me right now how one would do that easily, without e.g. mocking argparse and instantiating each frontend, which seems cumbersome.

whitequark, 2023-05-09:
@fabianfreyer Sorry, I was unclear earlier. This thread is so old I nearly forgot what I was thinking about back then...

> * Shoehorn this into a command-line (`run-multiple`, etc.), which seems difficult, if not impossible using argparse.

You could do this with argparse--it is a bit hacky though. The problem is sometimes more with applets themselves that try to do things like read from the console, or take exclusive use of limited FPGA resources. The UI is also very awkward.

People will probably want this no matter what.

> * Does this mean this is no longer an issue, and people should just use the `script` / `real` subcommand instead?

We still need a configuration file, but the surface syntax of the configuration file should just be Python.

The deep syntax, i.e. the meaning of the objects and functions used within, still needs to be defined.

Ultimately the current argparse syntax should be reduced to a special case of whatever we use for the configuration file. For that however the applets need to use some sort of language (again, Python-based) to declare the options they take.

fabianfreyer, 2023-12-25:
FWIW, here's my quick-and-very-dirty script I just used to do things, if someone wants to clean that up somehow, I could imagine it to be somewhat useful.
https://gist.github.com/fabianfreyer/b6371761fa521d14b48c602e738006b9

alexhude, 2023-12-26:
Thanks heaps! I hope I will be able to use that as reference to get JTAG+UART applet combo :)

whitequark, 2023-12-26:
@fabianfreyer This is essentially the best way to achieve what you want right now. Good job!

alexhude, 2024-04-08:
OK, as I understand maximum amount of applets is 2, because otherwise there is an error `cannot claim pipe: out of pipes`?

whitequark, 2024-04-08:
For now yes, though there is an open RFC to change that.

urjaman, 2024-07-29:
Thank you a bunch for that dual UART example - I updated and modified it a bit and made an UART (on the tty) + spi-flashrom (TCP) dual "applet". (Oh btw, it called uart0_parser twice to provide the args for uart0 and uart1 :P)

https://gist.github.com/urjaman/0e48bb2fc31bfe355cdd18a5388705a7

whitequark, 2024-07-29:
@urjaman I'd like to prototype a much better interface for achieving the same sometime soon. Would you like to participate?

urjaman, 2024-07-29:
@whitequark  I'd be happy to participate - feel free to poke me on discord or IRC when it's relevant because I don't actively "poll" github.

urjaman, 2025-03-23:
Today, in remembering how to use glasgow, i effectively did:
```
$ glasgow -h
$ glasgow run -h
$ glasgow run uart -h
$ glasgow run uart socket -h
```
(and waited 4 seconds between each)

And then I thought, maybe glasgow itself could provide a REPL/"interactive cli" (additionally to the per-applet python REPL), somewhat modeled after the CLI, so that individual operations wouldnt need to incur the python startup time.

But right after that thought, i realized that such an interface would suit itself to multiple applets, you'd "run"/configure each one, and then finally launch the whole configuration - and in this way, you could also easily store such a configuration in script form.

I know this isnt like, earth shattering insight, but I just wanted to share this to maybe provoke some more thoughts about this (is this the direction you'd like to prototype with?) - and to say that I still care about multiple applets, and also I care about having fast interactivity.

whitequark, 2025-03-23:
4 seconds is very high, what kind of device this is on? We can make it faster in various ways (and I already did my best to do so).

urjaman, 2025-03-24:
> 4 seconds is very high, what kind of device this is on? We can make it faster in various ways (and I already did my best to do so).

ASUS C201 (ARMv7, RK3288, 4 Cortex-A17 cores at 1.8Ghz, with Python 3.11.9):
```
[urjaman@veyron ~]$ time glasgow -h
usage: glasgow [-h] [-V] [-v] [-q] [-L FILE] [-F FILTER] [--statistics]
               [--serial SERIAL]
               COMMAND ...
<snipsnap tldr>
real    0m4.307s
user    0m3.723s
sys     0m0.280s
```
(okay, that was the "first run" in a while (the laptop idled all day), 3.9s now when "warmed up".)

whitequark, 2025-03-24:
That's remarkably low end. On that kind of hardware I do expect a cold run to take this long. I have an idea of how to improve this without any user-facing changes but it's a bit tricky; it involves having a long-running process that has the Glasgow modules loaded fork itself and run a `main` whenever commanded; JRuby does this (it's called "shotgun" launcher) with great efficiency.

Closed 2025-05-20.

Thread 182 (2020-02-08):

gateware.analyzer: FIFO tests are broken

emilazy, 2020-02-08:
`gateware.analyzer:EventAnalyzerTestCase.test_delay_{{2,3}_septet,max,overflow{,_p1}}` currently fail (potentially nondeterministically?). They should probably not fail. I'm creating this issue so I can disable them for now.

emilazy, 2020-02-08:
`test_delay_4_septet` too, so it seems there is indeed some nondeterminism at play here. :(

Thread 184 (2020-02-14):

Glasgow isn't quite compatible with Chrome OS

TiltMeSenpai, 2020-02-14:
Probably a low priority issue, I'm opening this mostly so I can track and share information.

Chrome OS added a preview for USB support in their linux subsystem a while back, and I was curious if I could use Glasgow with this. Initially, I would get a libusb device not found error when attempting to connect (working theory here) due to how the Glasgow board briefly disconnects when receiving firmware before coming back with the same VID/PID combo.

I also discovered the `glasgow flash` command while looking through source to find something to help. While this in theory does help Chrome with not losing track of the Glasgow board, there's something in the descriptors that Chrome must not like, bc `lsusb` doesn't show the board, and `usb-devices` freezes before showing output without the Glasgow board. After this happens, attaching USB devices to Crostini no longer does anything.

TiltMeSenpai, 2020-02-14:
Update: Found these entries in /var/log/messages:
```
2020-02-13T21:40:03.425453-08:00 ERR crosvm[6583]:  [vm_control/src/lib.rs:527] fail to recv command from usb control socket: failed to receive request or response: Resource temporarily unavailable (os error 11)
2020-02-13T21:40:03.426792-08:00 ERR vm_concierge[6545]: Failed crosvm call returned code 1
2020-02-13T21:40:03.426952-08:00 ERR vm_concierge[6545]: Failed to attach USB device: unexpected response: error: Input/output error (os error 5)
```
This looks like a bug on the ChromeOS side, but I'd like to keep this open for a bit to see if I can narrow down if there's something about Glasgow after loading device strings that is triggering this.

whitequark, 2023-02-23:
@TiltMeSenpai It's been a while. Does it work now?

Closed 2023-07-02.

Thread 186 (2020-02-20):

Invalid revision value after flashing EEPROM

DurandA, 2020-02-20:
Hi,

After a few flashes, I can't revert the EEPROM to factory firmware anymore.

**I don't have a Glasgow** yet so I am using a FX2LP dev board ([EZ-USB FX2LP CY7C68013A](https://www.hotmcu.com/ezusb-fx2lp-cy7c68013a-usb-development-board-p-281.html)—schematic outdated on the link, I can't find one for the newer revision) to play with the firmware without the iCE40 connected.

After resetting the FX2LP, the host detects it as `Bus 001 Device 046: ID 04b4:8613 Cypress Semiconductor Corp. CY7C68013 EZ-USB FX2 USB 2.0 Development Kit
`. Using `glasgow -vv factory --rev C1` produces the following output:
```
D: g.device.hardware: loading firmware from /home/duranda/devel/glasgow-vanilla/software/glasgow/glasgow.ihex
D: g.device.hardware: loading firmware to revC1 device
E: g.cli: device not found
```

However, `lsusb | grep 20b7:9db1` shows `Bus 001 Device 047: ID 20b7:9db1 Qi Hardware`. If I proceed with `glasgow -vv flash` anyway it produces the following output:
```
Traceback (most recent call last):
  File "/home/duranda/devel/glasgow-vanilla/venv/bin/glasgow", line 11, in <module>
    load_entry_point('glasgow', 'console_scripts', 'glasgow')()
  File "/home/duranda/devel/glasgow-vanilla/software/glasgow/cli.py", line 796, in main
    exit(loop.run_until_complete(_main()))
  File "/usr/lib/python3.8/asyncio/base_events.py", line 612, in run_until_complete
    return future.result()
  File "/home/duranda/devel/glasgow-vanilla/software/glasgow/cli.py", line 436, in _main
    device = GlasgowHardwareDevice(args.serial, firmware_filename)
  File "/home/duranda/devel/glasgow-vanilla/software/glasgow/device/hardware.py", line 73, in __init__
    revision = GlasgowConfig.decode_revision(device_id & 0xFF)
  File "/home/duranda/devel/glasgow-vanilla/software/glasgow/device/config.py", line 59, in decode_revision
    raise ValueError("invalid revision value {:#04x}".format(value))
ValueError: invalid revision value 0xaa
```

I was able to flash the firmware previously, so I guess I corrupted the EEPROM at some point. I am using the same CAT24C256W as on the schematic with pin 1 tied to VCC and pin 2 left floating.

Do you have any advice on how I could flash EEPROM? I don't have spare EEPROM but I can erase it with an Arduino if required. I am using the vanilla master branch with the below line commented to prevent interrupts from triggering (as advised by @whitequark): https://github.com/GlasgowEmbedded/glasgow/blob/bd9625cdf85c8dad3911ca1b38cc3604ee0cf5a2/firmware/adc.c#L40

whitequark, 2020-02-20:
You can use `fx2tool -d xxxx:yyyy -B write_eeprom ...` with any FX2 based device. It's in the libfx2 Python package.

DurandA, 2020-02-27:
_fxtool_ is excellent, thanks! The only related tool I found is _fxload_ and doesn't seem to be practical to write EEPROM. For reference, I used `dd if=/dev/zero ibs=1k count=256 | tr "\000" "\377" > paddedFile.bin` to pad with 0xFF and then `fx2tool -d 04b4:8613 -B write_eeprom -f paddedFile.bin`.

For some reasons, I always have to call `glasgow factory` to boot from the EEPROM after a reset/power cycle. I had a look at [EZ-USB FX1/FX2LP Boot Options](https://www.cypress.com/file/43391/download) but couldn't figure why it doesn't boot directly to the EEPROM. Do you have any suggestion?

whitequark, 2020-02-27:
> For some reasons, I always have to call `glasgow factory` to boot from the EEPROM after a reset/power cycle.

Can you describe the steps you are taking exactly, starting from some known state? The boot process is a bit subtle so I can't tell just from your description here.

DurandA, 2020-02-27:
Starting with empty EEPROM (filled with 0xFF) connected to the FX2LP dev board as follow:
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

1. At this point, `lsusb` shows `ID 04b4:8613 Cypress Semiconductor Corp. CY7C68013 EZ-USB FX2 USB 2.0 Development Kit`.
2. `glasgow factory --rev C1`.
3. `lsusb` still shows `ID 04b4:8613 Cypress Semiconductor Corp. CY7C68013 EZ-USB FX2 USB 2.0 Development Kit`.
4. Reset.
5. `lsusb` still shows `ID 04b4:8613 Cypress Semiconductor Corp. CY7C68013 EZ-USB FX2 USB 2.0 Development Kit`.
6. `glasgow factory --rev C1`.
7. `lsusb` shows `ID 20b7:9db1 Qi Hardware`.
8. Reset.
9. `lsusb` shows `ID 04b4:8613 Cypress Semiconductor Corp. CY7C68013 EZ-USB FX2 USB 2.0 Development Kit`.

whitequark, 2020-02-27:
That's really strange actually. Please do this: After step (2), read the EEPROM with `fx2tool`. After step (4), (6) and (8) do it again. Compare the result, or just post the dumps here.

DurandA, 2020-02-27:
All dumps are identical after (2), (4), (6) and (8).

DurandA, 2020-02-27:
All dumps are identical after (2), (4), (6) and (8). I did the process several times and please ignore my previous edit.

whitequark, 2020-02-27:
That's really weird. I'll have to use one of my devkits to reprouce.

DurandA, 2020-02-27:
I bought the cheapest board available on AliExpress. Do you know if there are fake FX2 chips around? Could it be a FX2 disguised as FX2LP?

whitequark, 2020-02-27:
Seems super unlikely. What I think is more likely is that you don't have other peripherals real Glasgow boards do, and that trips up the boot process somehow.

electroniceel, 2020-02-27:
It could be a genuine FX2LP that was recycled and damaged in the process. There are some backyard recycling gigs in China that remove valuable ICs with big blowtorches and similar methods.

Do you have a logic analyzer? If yes, maybe take a look at the I2C bus and check if the FX2 is successfully reading from your EEPROM directly after reset.

DurandA, 2020-02-27:
> What I think is more likely is that you don't have other peripherals real Glasgow boards do, and that trips up the boot process somehow.

This was also my first hypothesis but I wondered if this was a jelly-bean part that is massively counterfeited like the FTDI chips.

> It could be a genuine FX2LP that was recycled and damaged in the process. There are some backyard recycling gigs in China that remove valuable ICs with big blowtorches and similar methods.

That could very well be the case given that the board + shipping was cheaper than the CY7C68013A in > 1k quantitites.

> Do you have a logic analyzer?

Yes, I have a FX2-based logic analyzer. :laughing: I will try that tomorrow.

Many thanks for your time.

DurandA, 2020-02-28:
Here is the trace:

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

I think that the EEPROM replies with 0xFF at address 0 instead of 0xC0. This is really strange since it reads C0 at address 0 when I dump the flash using `fx2tool`.

electroniceel, 2020-02-28:
Is there another EEPROM on the I2C bus?

A0 of the Glasgow EEPROM is high, A1 and A2 low (001). The FX2 tries to read from 000 first and some EEPROM seems to answer there, so the FX2 acts on that answer and does not do the C0-boot we want.

whitequark, 2020-02-29:
> Is there another EEPROM on the I2C bus?

There almost certainly is, the FX2 devboards come with a EEPROM that @DurandA needs to disconnect for things to start working. Sometimes there's a jumper on SCL or one of the address pins.

DurandA, 2020-02-29:
> Is there another EEPROM on the I2C bus?

No, I unsoldered the EEPROM that came with the FX2 devboard. And I re-checked the connection of the EEPROM, A0 is connected to VCC (measured 3.3V with my multimeter). :confused:

DurandA, 2020-02-29:
I mixed up the CAT24M01 and the CAT24C256. The CAT24M01 doesn't have A0 so the address was 0x50...

I am really sorry for the wasted time.

@electroniceel I just realized you were the author of the awesome [SMD protoboard](https://github.com/electroniceel/protoboard). I really love it, I have to try the new variant with ground plane.

Closed 2020-02-29.

Thread 187 (2020-03-01):

applet.interface.i2c_initiator: timeout & error message when SCL stuck low

electroniceel, 2020-03-01:
how to reproduce:
- connect any port IO to GND (like A0)
- issue any command that uses this io as i2c initiator SCL (like "glasgow run i2c-initiator --port A -V 3.3 scan")
- glasgow is waiting endlessly for SCL to go high

I suggest to add a generous, but still reasonable timeout (like 1 second) for this case. Also return an explicit error message like "timeout, SCL stuck low" or similar.

I think this kind of error is not uncommon when testing or developing. Cases that come to mind are:

- wrong IO pin selected
- flaky connection
- external pullup resistors not connected or forgotten to enable the internal ones
- DUT misbehaving

It would be nice to add some similar detection for SDA too, currently you get back all zeros.

whitequark, 2020-03-05:
Yes, that's pretty common. We can add a timeout for USB requests, which is already supported by the streaming code we have, and raise an exception in `I2CInitiatorInterface`. I2C doesn't require a timeout (unfortunately, IMO) so it'll have to be optional, but having it something like 1 second by default seems generally OK.

whitequark, 2023-07-30:
This will become *far* easier wihth #354.

Thread 190 (2020-03-25):

cortex-m jtag

gimbas, 2020-03-25:
Is debugging/programing arm cortex-m devices via swd/jtag possible/implemented/planned?
In the main README there is a lot of mention of debugging and programming microcontrollers via jtag, but not for cortex-m devices.

whitequark, 2020-03-25:
Planned, cf. #69.

gimbas, 2020-03-25:
thank you, sorry for the duplicate.

whitequark, 2020-03-25:
Not actually a duplicate--JTAG and SWD debugging are different in this context.

Thread 202 (2020-09-18):

Benchmark results never gets reported

FFY00, 2020-09-18:
```
$ glasgow run benchmark source
I: g.device.hardware: device already has bitstream ID e00c76bf7d43e9c1b138500bf7df1a1f
I: g.cli: running handler for applet 'benchmark'
I: g.applet.internal.benchmark: running benchmark mode source for 8.000 MiB
```

I've traced the issue to `iface.read` never continuing and bisected the breaking patch to a7d041f4ca5805a136acc8a99689833dedefd9d5.

FFY00, 2020-09-18:
Looks like that commit can be cleanly reverted, and after that everything does work as supposed to.

```
$ glasgow run benchmark
I: g.device.hardware: device already has bitstream ID e00c76bf7d43e9c1b138500bf7df1a1f
I: g.cli: running handler for applet 'benchmark'
I: g.applet.internal.benchmark: running benchmark mode source for 8.000 MiB
I: g.applet.internal.benchmark: mode source: 25.11 MiB/s (200.85 Mb/s)
```

FFY00, 2020-09-18:
The following patch solves the issue.

```patch
diff --git a/software/glasgow/support/task_queue.py b/software/glasgow/support/task_queue.py
index 25cda9f..cb87c0c 100644
--- a/software/glasgow/support/task_queue.py
+++ b/software/glasgow/support/task_queue.py
@@ -21,7 +21,8 @@ class TaskQueue:

     def _callback(self, future):
         self._live.remove(future)
-        self._done.append(future)
+        if not future.cancelled():
+            self._done.append(future)

     def submit(self, coro):
         """
```

I miss the background behind this change, @whitequark could you clarify?

whitequark, 2020-09-21:
The background for the change is described in the commit message. Whether your patch is correct or not, I can't say offhand because asyncio cancellation semantics is annoyingly tricky.

Closed 2020-10-16.

Thread 206 (2020-09-23):

Method to list connected Glasgow boards

attie, 2020-09-23:
It doesn't appear that the `glasgow` utility has a method to list / enumerate connected Glasgow boards.

I'd like to propse a new `glasgow list` subcommand that will produce a list of boards connected to the system, with their revision and serial number (ready for use with `--serial`)... and possibly even their position in the USB tree too.

It is possible to get this information using other system utilities (examples below), but I feel we could streamline the process and present the information in a better way.

- `lsusb -d 20b7:9db1 -v | grep iSerial`
- `dmesg | grep -A2 'Glasgow Debug Tool'`

Is there already a method to do this with the `glasgow` tool (ignoring methods that employ other system utilities such as `lsusb` / `dmesg`), and/or does this sound sensible?

attie, 2020-09-25:
While flashing and testing the batch of boards I've just run, I also noticed that the Glasgow's serial isn't reported correctly until the `glasgow` utility has interacted with it for the first time (since power up).

This seems to be because the firmware needs to be loaded ((software/glasgow/device/hardware.py:88)[https://github.com/GlasgowEmbedded/glasgow/blob/master/software/glasgow/device/hardware.py#L88]), which is fair enough / makes sense.

While digging, I also noticed that a list of connected serials is in fact listed if A) no serial number is given, _and_ B) there are more than 1x Glasgows attached to the system. See (software/glasgow/device/hardware.py:120)[https://github.com/GlasgowEmbedded/glasgow/blob/master/software/glasgow/device/hardware.py#L120], for example:

```
venv:$ glasgow run selftest loopback
E: g.cli: found 2 devices (serial numbers C1-20200923T174926Z, C1-20200923T190627Z), but a serial number is not specified
```

I appreciate that this is only presented when required... but it isn't presented when an invalid serial is given (e.g: "_oops - pick from this list_"), and it feels like a bit of an unexpected route (i.e: "_just try running something_" vs "_show me a list_").

whitequark, 2020-09-29:
Yeah, reasonable request.

> This seems to be because the firmware needs to be loaded ([software/glasgow/device/hardware.py:88](https://github.com/GlasgowEmbedded/glasgow/blob/master/software/glasgow/device/hardware.py#L88)), which is fair enough / makes sense.

You can also run `glasgow flash`, which will cause the firmware to be loaded on power-up. Glasgow boards that are distributed to general public actually have to be shipped in that state because otherwise you have to do an annoying little registry dance to have them recognized via WinUSB.

attie, 2020-09-29:
> You can also run `glasgow flash`, which will cause the firmware to be loaded on power-up.

Oh, oops... I didn't run this step for the batch I've just done, running just `glasgow factory`, and then the various self test steps. Everything seems to work okay - I'll have a play and then send an email to the group so that they're aware that this might be something worth doing(!)

> Glasgow boards that are distributed to general public actually have to be shipped in that state because otherwise you have to do an annoying little registry dance to have them recognized via WinUSB

Huh, interesting... For clarity, do boards need to be shipped with firmware flashed (i.e: which state are you referring to by "_in that state_")?

whitequark, 2020-09-29:
> For clarity, do boards need to be shipped with firmware flashed (i.e: which state are you referring to by "_in that state_")?

Boards need to be shipped with firmware flashed so that they present the WinUSB descriptor on first plug-in. Otherwise Windows remembers the *lack* of the descriptor and you'll get an access violation even if you plug a flashed board in.

You can fix that by deleting a single registry key (which I *think* it's possible to write a .reg file for, and it's definitely possible with a short PowerShell snippet), or by using a driverless INF file (which someone will have to write, but it's straightforward).

But it's easiest to ship flashed boards, in which case no interaction is necessary. Install the Python package and off you go.

attie, 2020-09-29:
Understood - thanks for the clarification! I had expected it to be that way round, but wanted to be sure.

Closed 2020-10-03.

Thread 212 (2020-10-09):

'KeyError: None' when no applet name given to 'run' command

ansemjo, 2020-10-09:
When running `glasgow run` with an attached Glasgow revC1 but no applet name, the command crashes with a traceback:

```
Traceback (most recent call last):
  File "/home/ansemjo/.local/bin/glasgow", line 33, in <module>
    sys.exit(load_entry_point('glasgow', 'console_scripts', 'glasgow')())
  File "/home/ansemjo/git/extern/glasgow/software/glasgow/cli.py", line 812, in main
    exit(loop.run_until_complete(_main()))
  File "/usr/lib/python3.8/asyncio/base_events.py", line 616, in run_until_complete
    return future.result()
  File "/home/ansemjo/git/extern/glasgow/software/glasgow/cli.py", line 499, in _main
    target, applet = _applet(device.revision, args)
  File "/home/ansemjo/git/extern/glasgow/software/glasgow/cli.py", line 340, in _applet
    applet = GlasgowApplet.all_applets[args.applet]()
KeyError: None
```

Looking at `cli.py` it is indeed marked *not* required but is then later used in `_applet()` without checking for `None`.

https://github.com/GlasgowEmbedded/glasgow/blob/696b94ac66bf3803335bb63423dce5beede8d4b2/software/glasgow/cli.py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

The default argument of `False` looked weird but intentional. Changing it to `True` produces a different error: `ValueError: mutually exclusive arguments must be optional`.

So I'd propose something like this to catch a missing applet argument:

```diff
diff --git a/software/glasgow/cli.py b/software/glasgow/cli.py
index 68935b0..cc06b2f 100644
--- a/software/glasgow/cli.py
+++ b/software/glasgow/cli.py
@@ -334,6 +334,9 @@ def get_argparser():

 # The name of this function appears in Verilog output, so keep it tidy.
 def _applet(revision, args):
+    if args.applet is None:
+      logger.error("applet name required as an argument")
+      raise SystemExit()
     target = GlasgowHardwareTarget(revision=revision,
                                    multiplexer_cls=DirectMultiplexer,
                                    with_analyzer=hasattr(args, "trace") and args.trace)
```

---

**edit:** I'm on `HEAD` by the way:

```
$ glasgow --version                                                                                         
Glasgow version 0.1.dev1447+g696b94a (Python 3.8.5)
```

ansemjo, 2020-10-09:
Oh, sorry .. I looked through the issues but not the pull requests. There is one open already: https://github.com/GlasgowEmbedded/glasgow/pull/203

Closed 2020-10-09.

Thread 219 (2020-10-24):

Firmware support for INA233 on revC2

electroniceel, 2020-10-24:
revC2 replaces the ADC081C021, which was used on previous revisions, with the INA233.

The firmware needs to be adapted to communicate with the INA233 on revC2 boards.

First step is to reach feature-parity with revC1 (voltage sensing, interrupt for undervoltage and overvoltage).

Second step is to add current sensing and interrupt for overcurrent.

attie, 2023-02-23:
@electroniceel - is this now complete / can be closed (in #242), or are we waiting on current sense / overcurrent?

whitequark, 2023-07-24:
@attie I have a revC2 and it's unusable (I cannot enable any Vio), so I don't think it's complete...

attie, 2023-07-29:
revC3:

```
$ glasgow -vv voltage A 3.3
D: g.device.hardware: found revC3 device with serial C3-20230610T175317Z
T: g.device.hardware: USB: CONTROL OUT type=0x40 request=0x16 value=0x0000 index=0x0001 data=<00007c15> (submit)
T: g.device.hardware: USB: CONTROL OUT (completed)
T: g.device.hardware: USB: CONTROL IN type=0x40 request=0x12 value=0x0000 index=0x0000 length=1 (submit)
T: g.device.hardware: USB: CONTROL IN data=<00> (completed)
T: g.device.hardware: USB: CONTROL IN type=0x40 request=0x17 value=0x0000 index=0x0000 length=1 (submit)
T: g.device.hardware: USB: CONTROL IN data=<00> (completed)
T: g.device.hardware: USB: CONTROL OUT type=0x40 request=0x14 value=0x0000 index=0x0001 data=<e40c> (submit)
T: g.device.hardware: USB: CONTROL OUT (completed)
T: g.device.hardware: USB: CONTROL IN type=0x40 request=0x12 value=0x0000 index=0x0000 length=1 (submit)
T: g.device.hardware: USB: CONTROL IN data=<00> (completed)
T: g.device.hardware: USB: CONTROL OUT type=0x40 request=0x16 value=0x0000 index=0x0001 data=<9a0b2e0e> (submit)
T: g.device.hardware: USB: CONTROL OUT (completed)
T: g.device.hardware: USB: CONTROL IN type=0x40 request=0x12 value=0x0000 index=0x0000 length=1 (submit)
T: g.device.hardware: USB: CONTROL IN data=<00> (completed)
Port    Vio     Vlimit  Vsense  Monitor
T: g.device.hardware: USB: CONTROL IN type=0x40 request=0x17 value=0x0000 index=0x0000 length=1 (submit)
T: g.device.hardware: USB: CONTROL IN data=<00> (completed)
T: g.device.hardware: USB: CONTROL IN type=0x40 request=0x14 value=0x0000 index=0x0001 length=2 (submit)
T: g.device.hardware: USB: CONTROL IN data=<fa0c> (completed)
T: g.device.hardware: USB: CONTROL IN type=0x40 request=0x1a value=0x0000 index=0x0001 length=2 (submit)
T: g.device.hardware: USB: CONTROL IN data=<7c15> (completed)
T: g.device.hardware: USB: CONTROL IN type=0x40 request=0x15 value=0x0000 index=0x0001 length=2 (submit)
T: g.device.hardware: USB: CONTROL IN data=<0000> (completed)
T: g.device.hardware: USB: CONTROL IN type=0x40 request=0x16 value=0x0000 index=0x0001 length=4 (submit)
T: g.device.hardware: USB: CONTROL IN data=<9a0b2e0e> (completed)
A       3.3     5.5     0.0     3.0-3.6
```

whitequark, 2023-07-29:
Nevermind, I got tripped up by my own bad UI choices; I had a voltage limit set (years ago) and totally forgot about it.

I think this is done then.

Closed 2023-07-29.

Thread 220 (2020-10-24):

Qualification tests for revC2: pre INA233

electroniceel, 2020-10-24:
This issue is a task list of things to test for qualification of revC2.

This issue lists the tests that should be able to do without firmware support for the new INA233 ADC (pre issue #219).
There is issue #221 for tests that need support for the INA233 in firmware.

### PCB/Mechanical
- [x] Use a addon board with soldered-in port plugs, does it fit in revC1 and revC2? (the spacing was changed a little)
- [x] Check all silkscreen markings, do they match the actual pins/ports (known issue: #250)
- [x] Check new LVDS connector. Does the recommended mating connector still work well?
- [x] Check height of cap and reset button. Does the laser cut "case" still work or will it get in the way of addon boards?
- [x] Check how hard it is to replace/rework the USB-C socket. There is some flood fill in the layers that might make this harder than necessary.

### USB/Power

- [x] USB communication works with USB-C cable plugged in both orientations
- [x] Powering via USB works from a USB-C host with a fancy cable with electronic marker
- [x] Measure current idle draw of Glasgow, compare to revC1, differences reasonable?
- [x] Run benchmark for some time and compare to revC1, there should be no significant difference

### LEDs
- [x] LED brightness is similar among the LEDs, maybe with exception of the ERR led (@esden : assuming the prototypes use the final led part nos)

### Reset
- [x] Measure rising voltage (+5V rail) the reset is released at, is it enough for the lowest voltage the usb spec allows?
- [x] Measure falling voltage (+5V rail) the reset is activated at, is it enough for the max. drop of the 3v3 LDO?
- [x] Measure time between press (!) of reset button and falling voltage of (enabled) Vio a and b. Is it reasonably fast for a emergency power off?
- [x] Measure time between rise of the internal 3v3 rail and release of reset for the FX2. Is it > 5 msec?
- [x] Short internal 3v3 rail, is the FX2 reset triggered?
- [x] Remove short on internal 3v3 rail, is the FX2 reset released >5 msec later?
- [x] Is the new reset circuit sensitive to EMI? Improvise some EMI, see if accidental resets are issued

### EEPROMs
- [x] Storing the FX2 firmware works
- [x] Recover shorting works
- [x] Storing FPGA gateware works using ```glasgow flash <applet>```

### Short circuit behavior
- [x] Redo tests as in #135, including scope measurement of Vio out

### Level Shifters
- [x] New shifter footprints: Vio to 5V, pin to output, short the pin. Keep shorted for a few hours. Does the shifter survive? Measure temp.

whitequark, 2020-10-24:
> * TODO: do we already have support for it, I never tried it?

Yes we do, `glasgow flash <applet>` will do everything necessary.

electroniceel, 2020-12-06:
@esden tested reworking the USB-C connector live on twitch.

Rework was not unreasonably difficult, just needed regular hot air.

esden, 2020-12-07:
I tested point one "Use a addon board with soldered-in port plugs, does it fit in revC1 and revC2? (the spacing was changed a little)" and the PROM reader addon fits perfectly on both versions of the board.

electroniceel, 2020-12-30:
Current consumption:

| test             | revC1 mA | revC2 mA |
|--------------- |-------------- |-------------- |
| idle             |   34.8         |   36.4    |
| firmware loaded |   44.3 |   45.0   |
| uart gw running  |   57.3 |  58.0   |
| vga output         |    55.6 |  57.2  |

These differences are reasonable and can be explained for example by different led resistors and part variance.

electroniceel, 2020-12-30:
Benchmarks:

revC1:
I: g.applet.internal.benchmark: running benchmark mode source for 953.674 MiB
I: g.applet.internal.benchmark: mode source: 41.39 MiB/s (331.09 Mb/s)
I: g.applet.internal.benchmark: running benchmark mode sink for 953.674 MiB
I: g.applet.internal.benchmark: mode sink: 41.64 MiB/s (333.08 Mb/s)
I: g.applet.internal.benchmark: running benchmark mode loopback for 953.674 MiB
I: g.applet.internal.benchmark: mode loopback: 41.62 MiB/s (332.95 Mb/s)
I: g.applet.internal.benchmark: running benchmark mode latency for 953.674 MiB
I: g.applet.internal.benchmark: mode latency: mean: 740.00 µs stddev: 213.11 µs worst: 48991.92 µs

revC2:
I: g.applet.internal.benchmark: running benchmark mode source for 953.674 MiB
I: g.applet.internal.benchmark: mode source: 41.39 MiB/s (331.13 Mb/s)
I: g.applet.internal.benchmark: running benchmark mode sink for 953.674 MiB
I: g.applet.internal.benchmark: mode sink: 41.64 MiB/s (333.08 Mb/s)
I: g.applet.internal.benchmark: running benchmark mode loopback for 953.674 MiB
I: g.applet.internal.benchmark: mode loopback: 41.63 MiB/s (333.03 Mb/s)
I: g.applet.internal.benchmark: running benchmark mode latency for 953.674 MiB
I: g.applet.internal.benchmark: mode latency: mean: 744.14 µs stddev: 214.06 µs worst: 49607.51 µs

The differences are within the expected tolerances.

whitequark, 2020-12-30:
(Did we *expect* any changes in USB performance?)

electroniceel, 2020-12-30:
No, we didn't expect any differences. I there were any, we'd have to investigate (bad layout, added capacitance and stuff like that could cause it).

This test was to make sure there isn't such stuff lurking anywhere.

electroniceel, 2020-12-30:
Reset thresholds of the new reset IC:
Rising (slow): 4.10 V
Falling (slow): 3.96 V
Measured at about 19 °C directly at the reset ic (behind the TPD3S014).

-> Matches the datasheet (which just specifies falling and not rising).

The TLV75533 has a max. dropout of 270 mV: ok
USB Vbus is allowed to go down to 4.40 V: ok

electroniceel, 2020-12-30:
Vio off time when pressing the reset button:

Worst case measurement: 5 V Vio, no load

Falling logarithmically,
5 V -> 1 V: 8 ms
5 V -> 300 mV: 16.2 ms

With 100 mA load:

Falling logarithmically,
5 V -> 1 V: 320 µs
5 V -> 300 mV: 610 µs

The time seems to be dominated by the voltage regulator switching off and the output capacitor to discharge.

Compared to the operator hitting the button this reasonably fast.

electroniceel, 2020-12-30:
Reset for the FX2 crosses the VIL level (800 mV) about 5.4 ms after the 3v3 rail reaches 3.0 V. This satisfies the requirements of the datasheet.

This is the same for initial powerup and after a short on 3v3.

A short on 3v3 instantly pulls low the reset.

electroniceel, 2020-12-30:
Height of cap and reset button:

The highest component on the prototype is the sync connector. But it was manually rised because of a component mismatch at @esden. The proper part is lower, Next lower part is the polymer cap (about 1mm).

But even with the high sync connector a 2.5 mm thick acrylic laser cut case works fine (top of acrylic = top of port shroud).

electroniceel, 2020-12-31:
Level shifter shorted from 5V.

Temp. increase over ambient by 19 K. The 33 R series resistor even gets warmer than the shifter: 31 K. Current flowing 102 mA,

After 12 hours the temp increase was still the same, also still 102 mA flowing.

The shifter still works fine for input and output, edges look similar on the scope. No measurable current flowing into the shifter in input mode. No increased supply current measurable.

marcan, 2020-12-31:
Worth noting that IIRC I torture tested the old shifters *without* the protection resistors for a day or two and they were still fine :)

electroniceel, 2020-12-31:
All the older revs already have the resistors. So did you bridge them for testing?

marcan, 2020-12-31:
IIRC I soldered directly to the shifter pin.

electroniceel, 2020-12-31:
Ok, so it seems there is enough margin. The new shifter footprint has slightly worse thermal resistance than the one in revC1, but that doesn't matter because it is usually used with the resistors like I tested them.

electroniceel, 2021-01-01:
Redid the tests as in #135 with revC2:

Just shorting one port from 5V with a function-gen controlled fet is enough for triggering the new reset ic.

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

Yellow: internal 5V rail, measured at the polymer bulk cap
Magenta: Vio pin on port A

The results look even cleaner than what we had on revC1, no trace of oscillation. The reset ic triggers, Vio switches off and that's it.

I also measured a short 30µs load pulse:

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

The pulse length is still enough to drop the 5V rail to a reset condition. But the regulator is switched off cleanly and then the bleeding resistor begins to discharge Vio. So no trace left of the buggy still-conducting behavior from revC0.

marcan, 2021-01-01:
Is this with or without the series resistor? Ideally we *don't* necessarily want glasgow to reset on a momentary Vio short, I would say. That's how revC1 worked. The regulators should current limit on that condition without killing the whole board.

whitequark, 2021-01-01:
> Ideally we _don't_ necessarily want glasgow to reset on a momentary Vio short, I would say.

I've been thinking about that, and at first, that was also my view. But for revC2 we went even harder for safety than we did before, adding a E-stop button (which resets the board) that you are expected to use any time you rewire anything. I think that momentary shorts triggering the E-stop behavior "automatically" are, at least, in line with that design direction.

There is the separate question of whether INA233 can detect and abort momentary shorts before they can affect the board power rails. If yes, that should be our only supported mechanism for keeping the board alive across a momentary short.

electroniceel, 2021-01-01:
This is with the default series resistor and shunt (0.33 + 0.15 Ohms).

Not resetting the board on a short could be done by
1. making the reset ic less sensitive
2. increase bulk capacitance
3. use another voltage regulator that limits faster / stricter
4. increase series resistance to voltage regulator

I don't think any of these are particularly good options and safely switching off is the better option.

The INA233 isn't fast enough to prevent the 5V rail to drop. It works by constantly sampling and converting (delta sigma adc) Vsense and Isense (constantly switching between the two). If one measured value goes beyond the programmed limit, it can trigger the alarm. The shortest sampling interval is 140 µs, so 280 µs between two current measurements. A 30 µs short was enough for reset in the measurement shown above. So it is about one order of magnitude too slow.

whitequark, 2021-01-01:
Ack. I'm perfectly fine with safely switching off on a momentary short.

marcan, 2021-01-01:
I'm concerned about large bulk capacitance connected across Vio spuriously triggering this behavior. Can we qualify how it behaves in this scenario? *Especially* during soft power up scenarios.

30μs quite honestly sounds to me like spurious glitch territory to me. I'd be fine with a shutdown after a 10ms short or such, but...

The point of the Vio current limiting behavior of the regulators was to insulate Glasgow from not just actual fault conditions, but also "general badness". Glasgow is obviously not a tool only meant to be used with well-behaved circuits, and I hotplug things all the time. If I have Glasgow in powering logic analyzer mode I don't want it to just die on me while I'm debugging something just because a new subcircuit got powered up and glitched Vio for a few microseconds.

If *enabling* Vio into 2000μF of capacitance results in a reset, I would consider that a problem. If externally connecting such capacitance while live does, that is still not great, but would not be as critical a flaw.

whitequark, 2021-01-01:
> If _enabling_ Vio into 2000μF of capacitance results in a reset, I would consider that a problem

Enabling into a short worked fine in my limited testing, though I'll defer to @electroniceel to check this more thoroughly.

electroniceel, 2021-01-06:
Improvised EMI test:

- Glasgow constantly running loopback benchmark. Throughput and any usb-related kernel messages are monitored
- Glasgow connected to a stationary PC, IEC protection class I (GND connected to PE in the PSU)

A massive industrial relay (rated 4x 40 A, 24 V coils, coil current 0.5 A) is wired in oscillation mode using it's NC contacts.

#### Just the oscillating relay next to glasgow
No measurable effect

#### Connecting relay coil GND to Glasgow GND (PSU powering the coil isolated)
No measurable effect

#### Connecting relay coil GND to Glasgow GND (PSU powering the coil connected to PE)
In this setup a part of the coil current flows through the USB cable.

Sometimes leads to USB disconnects. Also the monitor sometimes flickers black and once the PC crashed. No reset of the FX2 was visible on Glasgow LEDs.

So this level of EMI is more than common PCs are immune against, so not a concern for Glasgow. But even then no spurious resets on Glasgow.

#### Coil of fluorecent lamp ballast switched with relay
Oscillating setup as above.
Coil wired in series with a incadecent bulb for current limiting, connected to mains.
Next to Glasgow
No measurable effect

#### GSM900 call directly next to Glasgow
Test was done in the basement, to provoke the cell phone using max power.
In a cheap active speaker nearby I could loudly hear the GSM noise.
No measurable effect on Glasgow.

whitequark, 2021-01-06:
> Sometimes leads to USB disconnects.

I'm fairly sure this happens because USB isn't fully differential and the DC level matters for things like SE0 detection.

> Test was done in the basement, to provoke the (ancient) cell phone using max power.

Another good test I have found in the past is using a CB or commercial radio. 5 W seems to reset USB devices quite reliably.

electroniceel, 2021-01-06:
> > Sometimes leads to USB disconnects.
>
> I'm fairly sure this happens because USB isn't fully differential and the DC level matters for things like SE0 detection.

I'm fairly sure that this was a massive level of EMI. Otherwise neither the monitor wouldn't flicker nor the whole PC would crash.
I use this machine on my electronics bench on a daily basis and it is a stable and well working machine.

> Another good test I have found in the past is using a CB or commercial radio. 5 W seems to reset USB devices quite reliably.

I'll can try that too.

electroniceel, 2021-01-06:
#### Keying up a Baofeng at 145 MHz FM with (specified, not verified) 5 W directly above Glasgow
USB disconnect
At some antenna positions: Glasgow reset

#### Keying up a Baofeng at 145 MHz FM with (specified, not verified) 1 W directly above Glasgow
No measurable effect

#### Keying up a Baofeng at 434 MHz FM with (specified, not verified) 5 W directly above Glasgow
No measurable effect

whitequark, 2021-01-06:
> Otherwise neither the monitor would flicker nor the whole PC would crash.

Oh yeah if the whole thing crashes you're right. I misread, sorry.

> Keying up a Baofeng [...]

This tracks with my experiments.

electroniceel, 2021-01-06:
> > Keying up a Baofeng [...]
>
> This tracks with my experiments.

And I don't see it as concern for Glasgow design, especially because going down to 1 W eliminates the problem.

electroniceel, 2021-01-06:
About the LEDs:

@esden told me that the LEDs he used on the prototypes are different parts than the ones specified in the BOM. He plans to use the same LED / resistor combinations as in the prototypes for the production run.

In my experiments I found the LEDs on the prototype to work well and evenly lit. But I don't have a prototype of the aluminium case so I couldn't test how they work for that scenario.

whitequark, 2021-01-06:
> He plans to use the same LED / resistor combinations as in the prototypes for the production run.

Then it will be necessary to recalibrate the resistors. cc @marcan

electroniceel, 2021-01-06:
As I wrote, the brightness levels of the LEDs on the prototype seemed fine to my eyes, so @esden running production with these resistors+LEDs would work for me.

The bigger issue I'd say is finding a brightness setup that works well with a bare board and also through the lightpipes on the al case. This is complicated by the fact that to my knowledge only @timonsku has a prototype of the case, and that prototype has a different height than the final cases will have (the prototype has the capacitor sticking out, the final one will not).

If further discussion is wanted, I'd prefer if we could create a separate issue for it.

esden, 2021-01-06:
I had a conversation with @whitequark about this today. Especially after yesterday's stream, I have to agree and change my position on this. We will have to at least adjust the resistors to increase the brightness. What I ended up mounting onto the prototypes is not good enough. I would rather not open the topic and delay things but unfortunately that is not possible. And yes we should probably open a dedicated issue to fixing the LED selection and associated resistors.

electroniceel, 2021-01-06:
@esden created issue #259 for further discussion of the LED issue.

Closed 2021-01-06.

Thread 221 (2020-10-24):

Qualification tests for revC2: post INA233

electroniceel, 2020-10-24:
This issue is a task list of things to test for qualification of revC2.

This issue lists the tests that need firmware support for the new INA233 ADC (post issue #219).
There is issue #220 for tests that don't need support for the INA233 in firmware.

### Voltage measurement
- [x] Measure different Vsense voltages, check accuracy
- [x] Vsense to 36V, measure current drawn by Vsense, check measured voltage
- [x] Slowly rise Vsense to 40V, measure current drawn by Vsense, check when the TVS diode begins to conduct
- [x] Do we need a filter (R60 + C91)? Couple some hi freq noise (e.g. 1 MHz) onto a otherwise constant voltage, measure results over a time, aliasing present?

### Current measurement
- [x] Measure idle current at different voltages. Does it correspond to our load resistor values? What kind of offset calibration do we need?
- [x] Measure different currents, compare to multimeter
- [x] Connect a 100µF cap on Vio, program a overcurrent limit. what limit do you need to reliably not trigger the overcurrent off?
- [x] Draw a fast-pulsed current (FET+R controlled by function gen), is the filtering on the INA233 good enough?
- [x] Measure (worst case) reaction speed of the overcurrent protection. Is it fast enough to prevent damage on a DUT?

### Hardware Vio-off via IRQ
- [x] Program overvoltage/undervoltage limits into the INA233, activate the IRQ, is Vio turned off without intervention of the FX2?
- [x] Do the Vio-LEDs stay on in this case? They should by design.

### Port differences
- [x] Repeat the tests above on both ports. Are there significant differences between the two ports?

### SMBus Alert Response Address
- [x] Change the conflicting DAC I2C address, adapt firmware, test how the INA233 reacts to the Alert Response Address and when ~ALERT is released

electroniceel, 2021-01-01:
Voltages set with 30 V calibrator (Advantest R6144) and read out in parallel with Keithley 2001 multimeter.

On both ports the measured voltages swing by +- 2 LSB. The median is within 0.02% of the voltage measured with the multimeter.

Matches the spec of the INA233, much better than what is required for Glasgow.

electroniceel, 2021-01-01:
I coupled hi freq noise into the Vsense pins. While on most frequencies no aliasing was measurable, on some frequencies (e.g. 370 kHz, 680 kHz) I could measure aliasing up to 50 mV with my (very improvised) setup. Will have to improve my test setup to better quantify the results.

electroniceel, 2021-01-02:
Today I improved my noise injection setup. I used this coupling network, derived from similar setups used for various EMI measurements:

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

The noise was a triangle signal, tuned with the oscilloscope to result in 200 mVpp noise on the output, overlayed over the reference voltage that was set with my calibrator. The LC network shields the noise from the calibrator to not affect it's feedback loop. A 200 mVpp ripple/noise figure is a realistic value for an unfiltered switching PSU. A triangle noise shape is also very common for switcher ripple.

With most frequencies the noise was completely filtered by the INA233. But with some select frequencies the results were significantly affected:

| Frequency   |  Std. deviation  |  Max. deviation |
|----------------|--------------------|-------------------|
| 338 kHz      |     0.018 V        |     0.034 V          |
| 677 kHz      |     0.020 V        |     0.038 V          |
| 683 kHz      |     0.021 V        |     0.040 V          |
| 694 kHz      |     0.015 V        |     0.030 V          |
| 1.014 MHz   |    0.063 V        |     0.110 V          |
| 1.353 MHz   |    0.025 V        |     0.043 V          |

I tested the frequencies by letting the freq generator sweep in 1 kHz steps up while watching the results that were read out in a loop. So I could have missed some peaks. Unfortunately I don't have the software tooling ready to create a proper graph with smaller steps.

These frequencies are something that can very well be created by a common switching PSU. Even PSUs switching at a much lower frequency will create harmonics that easily go in these regions.

Increasing the built-in averaging in the INA233 only partially helped, 0.026 V std. dev and 0.050 V max at 1.014 MHz with 64 averages.

I tested several RC combinations with R and C values that are already on the Glasgow BOM. Unfortunately 100 nF doesn't work as they usually aren't specced to the 40 V we need in 0402. Even if they were, the capacitance would be gone at that voltage. Also 2k2 as resistor is too high, the INA233 begins to read low by about 1% with this, even without noise.

A RC filter with 470 Ohms and 1 nF gives good results though:
0.016 V std. dev. and 0.026 V max dev at 1.014 MHz with just 4 averages. I couldn't see any noise at all the other frequencies listed above.

1 nF is available in 0402 as C0G up to 50 V.

So the question is: do we want to increase the BOM by 2 parts for making the ADC immune to noise at specific frequencies?

electroniceel, 2021-01-06:
Idle current:

The idle current varied by 0.2 mA from the theoretical value given by the load resistors (2 resistors of 2k2 in parallel). For example I measured 4.5 mA at 4.78 V instead of the expected 4.3 mA. Or 2.4 mA measured at 2.55 V instead of the expected 2.3 mA. The difference percentage was constant across the set voltages, so it could be caused by load resistor values being out a bit.

Another reason could be idle current draw by devices connected to the Vio rail, e.g. the level shifters or the IO-expanders for the pull resistors.

Calibrating out this offset requires knowing the Vio voltage and the measured load resistor value. Using the set Vio voltage (instead of the measured actual voltage) should be enough for the precision expectations of Glasgow. This is realistic to be done in firmware.

electroniceel, 2021-01-06:
Current measurement accuracy:

I used a electronic load set to CC mode in series to my Keithley 2001 multimeter. I dialed in the currents on the e-load and compared the measurement on the multimeter with the values read out from Glasgow.

The idle voltage of Glasgow was measured first with disconnected load and subtracted from the following measurements.

I measured currents in 50 mA steps from 50 mA to 400 mA. The measured values were higher by between 1.3% and 1.5% than the values expected by ideal shunt resistors with 0.15 Ohms. This difference was constant between both ports. It could be both shunts being out a bit.

This difference could be calibrated out by firmware.

With calibration the measured error would be 0.1%, which is totally acceptable for Glasgow.

electroniceel, 2021-01-06:
Aliasing/Filtering of current measurements:

I connected a 47 Ohm base load resistor between Vio and GND. In parallel I connected a 470 Ohm pulse resistor in series with a N-MOSFET. The gate connected to my function generator. I set Vio to 3.3 V, yielding in about 70 mA with just the base load and 77 mA with the FET conducting.

I swept the frequency of the function gen in 1 kHz steps between 400 and 600 kHz and 900 and 1100 kHz, as these are the ranges the ADC is most sensitive to noise in.

I could not find any frequency that caused the measurement results to produce aliasing. So the implemented filtering seems to be adequate.

electroniceel, 2021-01-09:
Overcurrent with capacitor:

Tested with Vio = 3.3V, 100 µF polymer capacitor (ESR in the 0.01 Ohms region)

When first activating the Vio, then connecting the capacitor, a current limit of 130 mA was enough to not trigger.
When first connecting the capacitor, then activating the Vio, it needs a 300 mA limit to reliably not trigger.

This means the current in the first scenario is such a fast spike that the filtering and ADC timing doesn't let it register the current well.

100 µF polymer is quite a lot for something that is not expected to draw more than about 300 mA total, so this testing the limits. If cap charging leads to too many false OCP triggers, we could add a firmware option to slowly step up the Vio. This would also prevent shorts or bigger caps on the output from resetting Glasgow.

When testing with Vio set to 5V and then connecting the 100 µF I experienced some resets of Glasgow due to the 5 V rail dropping down too much. This isn't unexpected when comparing the 150 µF bulk cap on Glasgow with the 100 µF load cap. So a slow start option would be good.

electroniceel, 2021-01-09:
I tested the overcurrent protection reaction speed:

Current limit set to 50 mA, ADC speed to max. (140 µs interleaved, 280 µs current sampling speed).
The results varied a lot, so the following is the slowest reaction from 20 tries:

Current drawn 70 mA (3.3V, 47 Ohm):
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

Current drawn 330 mA (3.3V, 10 Ohm):
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

Yellow is Vio, magenta the gate of the FET that switches the current.

Since the worst time is just a bit above two sample times (560 µs), this means that unless there is a dead short on the rail, at least two samples are needed before the OCP triggers. If the drawn current is just a bit over the programmed limit, it takes about 5 samples. This indicates that the filtering is the reason for this.

In the 330 mA case I would have preferred a faster reaction time, since for example the integrated protection diodes of a DUT with the power pins reversed could already be damaged by then.

electroniceel, 2021-01-09:
Further experimentation showed that most likely the datasheet of the INA233 isn't detailed enough regarding when/how the limits are compared:

Figure 23 reads "Current Limit Detect Following Every Shunt Voltage Conversion". I understood this as that the actually read last is compared to the limit. This is most likely wrong.

The above measurements were taken with averaging set to 4. Once I switched down to 1 number of averages, the reaction times improved to a bit more than 280 µs. Since 4 averages would take 1120 µs, what most likely happens is that the INA233 calculates a moving average and that is compared against the limit value.

So for a fast reaction, any averaging in the INA233 itself has to be switched off. For less noise the firmware in the FX2 could take care of averaging.

electroniceel, 2021-01-09:
Vsense overvoltage test:

INA233 equipped with the filter from https://github.com/GlasgowEmbedded/glasgow/issues/221#issuecomment-753531753
(a sample IC on a protoboard, no Glasgows were endangered in this test)

3v3 supply applied, Vbus voltage slowly increased, current into Vbus measured
- until 42 V: nothing happens
- at 42 V: current begins to increase slowly, most probably the TVS that begins to conduct
- 56 V: about 50 mA flows through the TVS
- 60 V: the TVS fails short

Desoldered the TVS, inspected the INA233:

- No increased supply current drawn
- No reduced impedance on Vbus (the voltage measurement pin)
- I2C comms works
- Voltage sense accuracy not reduced

-> protection circuitry performs as planned

electroniceel, 2021-01-10:
SMBus Alert Response Address:

I changed the i2c address of the port A dac with a bodge wire, just like I plan to change it for revC3.

Accessing the DAC on port A, port B and ports AB simultaneously worked (i2c address changed in firmware of course).
Also querying the Alert Response Address cleared the ~ALERT line of the INA233s as planned.

So there are no negative consequences to be expected when changing the dac address in revC3 and the wanted outcome of being able to query the ARA is achieved.

But after being more familiar with the state mechanisms and requirements of the firmware, I think the current solution of using a state cache and reset for the INA233 is the better solution than using the ARA, at least until we get muxed i2c busses as planned for revD and maybe later revC.

Consider the following case:
- There is an alert on port B
- The INA233 of port B pulls low it's ~ALERT line, thus disabling the voltage regulator on port B through the diode logic
- The firmware sees the alert and begins to handle it
- The INA233s on both ports are queried for alerts, it is found out that port B triggered the alert
- Firmware switches off the enable line for Vio B, so the diode logic isn't required anymore to keep Vio B off
- There is now an alert on port A too
- The INA233 of port A pulls low it's ~ALERT line, thus disabling the voltage regulator on port A through the diode logic
- Firmware continues to handle the previous alert on port B. The next thing to do would be to disable the ~ALERT line for port B
- The Alert Response Protocol is not directed at a special device. If multiple devices have an alert situation, the device with the lowest i2c address will win the request and thus disable their ~ALERT line. The other devices with alert situations will respond to subsequent Alert Response queries.
- The INA233 with the lowest i2c address is the one on port A. When it disables it's ~ALERT line, the voltage regulator on port A will now be re-enabled, because firmware hasn't gotten around to disable it's enable line yet

The cache and reset logic used now is better in that regard, because it only affects the one INA233 that is addressed through it's i2c address. So there is no risk of accidently reenabling a already disabled Vio.

I still think it makes sense to fix the i2c address clash for revC3, but keep the cache & reset logic from revC2 firmware.

Closed 2021-01-10.

Thread 234 (2020-11-14):

Long-term maintainability goals

whitequark, 2020-11-14:
**Please DO NOT start working on tasks from this list on your own.** These tasks are very complex, have far-reaching consequences, and require subtle API design. In most cases, I (@whitequark) have a fairly specific solution in mind, which I will eventually transfer to a dedicated issue for collaborating. Unless you discuss any work on these tasks beforehand, it is unlikely to be accepted.

  - [ ] Replace `argparse` with a new, almost certainly in-house argument parsing system.

    Although `argparse` has served us extremely well so far (it is quite impressive how well it supports Glasgow's sprawling, complicated CLI), there are many issues with it:
    * rough at edges (e.g. #204),
    * doesn't integrate well with our very specific domain (`add_pin_argument` is the worst offender),
    * requires significant amounts of imperative glue code in applets,
    * is not based on an abstract model that could be shared between CLI and GUI,
    * does not allow an inheriting applet a free choice between keeping its ancestor's options in the CLI or setting a fixed value for them (to a degree this is mitigated with highly modular subtargets, but the overhead is high for something like `program-ice40-sram`);
    * does not easily admit formatted help text (`cli.TextHelpFormatter` is an abomination, Markdown or reST would be ideal),
    * does not easily support multiple applets (#180),
    * does not allow improving autogenerated help text for choice options (e.g. no way to show only non-preview applets, or non-contrib ones, etc),
    * is inherently unable to support self-chainable applets (e.g. JTAG-over-BSCAN-over-JTAG-...) because it requires eagerly defining all subparsers and has only a single namespace for every argument/option,
    * does not allow automatically renaming conflicting options to disambiguate (e.g. in cases of applet inheritance).

    A particularly unpleasant consequence of the imperative interface and lack of an abstract model is that using shell completions (e.g. [`argcomplete`](https://kislyuk.github.io/argcomplete/) requires importing every applet on every Tab press, which is unusably slow.

    Any solution would have to start off with an `argparse` API compatibility layer and allow gradual migration. (The new API could either use `argparse` internally to perform actual argument parsing and help formatting during the migration, or it could present an `argparse`-compatible interface.)

  - [ ] Replace `logging` with a new, definitely in-house logging system.

    Although `logging` has served us pretty okay so far (complex applets, especially JTAG-related applets, do already have serious usability problems), there are many issues with it:
    * does not easily support `{}`-style formats and is the sole remaining reason the codebase uses `%`-style formats (workarounds are available but unpleasant),
    * does not support multiple TRACE debug levels (requiring hacks such as `glasgow -F`, instead of straightforward `-vvv` enabling tracing three interfaces deep),
    * doesn't integrate well with our very specific domain (it would be extremely handy to have nested loggers coupled with the ability to bracket begin/end of a request/response),
    * doesn't support fine-grained elimination of disabled logging calls (ideally through a source-to-source transformation so that hacks like the lazy `dump_bin` are not necessary in first place),
    * doesn't support structured logging (the structure should be ad-hoc and optimized for writeability/readability of the source, but filtering by e.g. logged addresses would be extremely handy).

    Any solution would include a `logging`-compatible sink for external library code, as well as to allow gradual migration.

  - [ ] Extend the Python import system to allow introducing external (PyPI) library dependencies from applet code.

    Although the current situation where applets directly and unconditionally import libraries and the Glasgow package depends on the union of external dependencies of all in-tree applets has somewhat worked so far, there are many issues with it:
    * is extremely slow to import all packages at all times (the CLI is already too slow for tab-completion or running interactively on RasPi) and is only going to get much slower,
    * is highly error-prone to maintain the import/dependency correspondence manually, especially if version constraints are involved,
    * does not gracefully degrade in case of missing imports (bitarray #179 is a particularly painful case, being used only by two applets),
    * is inherently incompatible with loading applets directly from filesystem (as individual files) rather than from a setuptools package, as well as graceful handling of imports in even more ad-hoc scenarios such as `glasgow script`,
    * makes harder to generate option parsers and help text for applets that lack all necessary imports,
    * finally, simply wastes resources (most of the current transitive dependencies are only there because of `audio-yamaha-opx`, something most people will never use).

    A possible solution is to transform imports of the form `from ..pypi.aiohttp import aiohttp` or even `from ..pypi.aiohttp.ge_3_7 import aiohttp` into code that:
    * for packages that are found, simply imports the module from the package,
    * for packages that are not found or do not satisfy a constraint, imports a dummy module that raises an exception if it's being used in any way, records this fact, and ideally propagates it to any modules that import the module with the problematic import,
    * exposes the list of missing imports for any requested module, so that it can be used in the help text, error messages, etc,
    * automatically collects `extra_requires` for the setuptools package, so that e.g. `pip install glasgow[debug-arm-jtag]` installs whatever dependencies that applet may or may not have (this becomes even more useful if the new pip resolver starts to track extras statefully rather than statelessly as it is done now).

    It would be *extremely* cool (and also ensure we never struggle with dependency hell) if the external dependencies of every applet would exist in a sort of "in-process venv", but while this seems possible (barely) with PEP 302 import hooks and creative use of the pip cli, it looks like one of those things that would break in truly horrifying ways that negate whatever advantages they may have when they work.

    - [ ] Switch to declarative pin management based on nMigen platforms.

    For historical reasons (namely, Migen platforms being very crude), Glasgow reimplements large chunks of nMigen platform code: connector-based indirection, triple construction, IO buffer insertion. There are many issues with it:
    * prevents us from using nMigen-native pin gearboxes (and thus kneecapping maximum IO frequency of many applets),
    * prevents us from adding multi-applet support because of the rigid `argparse`-based pin allocation scheme (that would work a lot better if represented as a constraint solving problem),
    * necessitates sprawling `XxxBus` modules that mostly rearrange the wires attached to the tristate triples that are constructed for every pin,
    * does not have an abstract model that would allow defining FPGA pin constraints (needed at build time) and pull resistor settings (needed at run time) in the same place.

    Unfortunately, Glasgow has additional requirements well beyond what most FPGA boards require (and thus what nmigen-boards can handle):
    * applets may not use a global resource namespace, making direct use of `platform.request` (with dynamically added resources) non-viable,
    * revC+ has an OE pin that must follow output enable of the corresponding IO pin, even if gearboxes are involved;
    * reuse of subtargets between applets means point of resource definition is completely decoupled from point of resource use, making https://github.com/nmigen/nmigen/issues/458 a hard requirement;
    * applets use dynamic constraints for pin properties like width range or optionality whereas nMigen only supports static constraints for these properties (i.e. applet resource declarations are higher order compared to nMigen platform resource declarations).

    Solving this will certainly require major nMigen changes (as well as migrating the entire codebase to nMigen in first place).

whitequark, 2020-11-25:
> * Extend the Python import system to allow introducing external (PyPI) library dependencies from applet code.

I'm starting to think this might not be necessary (thank gods). The [entry point system](https://setuptools.readthedocs.io/en/latest/userguide/entry_point.html) (available through [`importlib.metadata`](https://docs.python.org/3/library/importlib.metadata.html)) provides almost everything we need.

It seems like there is a reasonably simple solution: don't mess with executable code at all, just add a `__requires__ = [...]` statement somewhere in the applet module. This statement (where the RHS is strictly a literal) can be easily parsed using
standard functionality. There are a few possible options of what happens next:
  * We might use the entry points functionality closer to the way it's intended: create an "extra" per applet with external dependencies, then add the contents of `__requires__` to `extra_requires`. However, there are a few issues with this. First, metadata can (and will, with editable installs) get outdated. Second, while `importlib.metadata` will happily give you the dependencies of a package with extras, it won't help you parse it--I think people usually import some `distutils` gunk which breaks a few months later. Third, while you can easily print a message instructing to `pip install <requirements...>`, it is much harder to figure out the right command to `pip install glasgow[<extras...>]` (in fact it's impossible in some cases).
  * Or, we might forget about extras and just manage requirements lists ourselves in a rudimentary way. This is robust with editable installs and so probably preferable, but, annoyingly, still requires parsing dependencies because otherwise there is no way to safely run an applet with dependencies (best case it fails with `ImportError`, worst case it is silently broken because of one patch revision too low).
  * Maybe both? Try `__requires__` first since it is up to date, fall back to extras if that didn't work (maybe a third party chose not to use `__requires__`).

whitequark, 2023-10-21:
> 3. Extend the Python import system to allow introducing external (PyPI) library dependencies from applet code.

The third goal is now **complete**! :tada:

whitequark, 2024-06-24:
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

Amaranth is going to replace the platform system entirely at some later point because it was not working well for Amaranth either. In particular, triples are gone (`Pin` is deprecated and will be removed shortly), and IO buffer insertion is no longer a part of the platform functionality (instead, `lib.io` is used in Amaranth 0.5).

The major Amaranth changes have been done, and PR #590 adds support for new Amaranth I/O. Completing this goal now only requires a new declarative pin management system.

whitequark, 2025-05-10:
Goal (4) has been partly completed by PRs https://github.com/GlasgowEmbedded/glasgow/pull/590 and https://github.com/GlasgowEmbedded/glasgow/pull/598. We are only missing a declarative pin constraint definition language.

Thread 235 (2020-11-15):

LED testing mode

timonsku, 2020-11-15:
As mentioned on Discord. It would be great to have a LED testing mode that allows to freely toggle every LED on the board.
Background for me is testing the case for Glasgow and ensuring that the visibility of LEDs is good but probably also handy for testing functioning of the LEDs in general for manufacturing (which I think is @esden primary reason for wanting it).

Closed 2023-07-28.

Thread 239 (2020-12-03):

On windows, first glasgow command after plug-in errors, second one works

0x53A, 2020-12-03:
If I plug my glasgow in the first command errors out:

1) plug in
2) run ``glasgow list`` (and I get a bling from windows as if a device was connected)

```
C:\Users\lr>glasgow list
I: glasgow.device.hardware: found revC1 device with API level 0 (supported API level is 1)
Traceback (most recent call last):
  File "C:\Users\lr\AppData\Local\Programs\Python\Python39\Scripts\glasgow-script.py", line 33, in <module>
    sys.exit(load_entry_point('glasgow', 'console_scripts', 'glasgow')())
  File "c:\glasgow\repo\glasgow\software\glasgow\cli.py", line 856, in main
    exit(loop.run_until_complete(_main()))
  File "c:\users\lr\appdata\local\programs\python\python39\lib\asyncio\base_events.py", line 642, in run_until_complete
    return future.result()
  File "c:\glasgow\repo\glasgow\software\glasgow\cli.py", line 835, in _main
    for serial in sorted(GlasgowHardwareDevice.enumerate_serials()):
  File "c:\glasgow\repo\glasgow\software\glasgow\device\hardware.py", line 174, in enumerate_serials
    devices = cls._enumerate_devices(usb_context)
  File "c:\glasgow\repo\glasgow\software\glasgow\device\hardware.py", line 107, in _enumerate_devices
    handle = device.open()
  File "c:\users\lr\appdata\local\programs\python\python39\lib\site-packages\libusb1-1.8.1-py3.9-win-amd64.egg\usb1\__init__.py", line 2153, in open
    mayRaiseUSBError(libusb1.libusb_open(self.device_p, byref(handle)))
  File "c:\users\lr\appdata\local\programs\python\python39\lib\site-packages\libusb1-1.8.1-py3.9-win-amd64.egg\usb1\__init__.py", line 127, in mayRaiseUSBError
    __raiseUSBError(value)
  File "c:\users\lr\appdata\local\programs\python\python39\lib\site-packages\libusb1-1.8.1-py3.9-win-amd64.egg\usb1\__init__.py", line 119, in raiseUSBError
    raise __STATUS_TO_EXCEPTION_DICT.get(value, __USBError)(value)
usb1.USBErrorNoDevice: LIBUSB_ERROR_NO_DEVICE [-4]
Exception ignored in: <function USBDevice.__del__ at 0x000001EE1FC8FF70>
Traceback (most recent call last):
  File "c:\users\lr\appdata\local\programs\python\python39\lib\site-packages\libusb1-1.8.1-py3.9-win-amd64.egg\usb1\__init__.py", line 1897, in __del__
  File "c:\users\lr\appdata\local\programs\python\python39\lib\site-packages\libusb1-1.8.1-py3.9-win-amd64.egg\usb1\__init__.py", line 1909, in close
OSError: exception: access violation writing 0x0000000000000024
Exception ignored in: <function USBDevice.__del__ at 0x000001EE1FC8FF70>
Traceback (most recent call last):
  File "c:\users\lr\appdata\local\programs\python\python39\lib\site-packages\libusb1-1.8.1-py3.9-win-amd64.egg\usb1\__init__.py", line 1897, in __del__
  File "c:\users\lr\appdata\local\programs\python\python39\lib\site-packages\libusb1-1.8.1-py3.9-win-amd64.egg\usb1\__init__.py", line 1909, in close
OSError: exception: access violation writing 0x0000000000000024
Exception ignored in: <function USBDevice.__del__ at 0x000001EE1FC8FF70>
Traceback (most recent call last):
  File "c:\users\lr\appdata\local\programs\python\python39\lib\site-packages\libusb1-1.8.1-py3.9-win-amd64.egg\usb1\__init__.py", line 1897, in __del__
  File "c:\users\lr\appdata\local\programs\python\python39\lib\site-packages\libusb1-1.8.1-py3.9-win-amd64.egg\usb1\__init__.py", line 1909, in close
OSError: exception: access violation writing 0x0000000000000024
Exception ignored in: <function USBDevice.__del__ at 0x000001EE1FC8FF70>
Traceback (most recent call last):
  File "c:\users\lr\appdata\local\programs\python\python39\lib\site-packages\libusb1-1.8.1-py3.9-win-amd64.egg\usb1\__init__.py", line 1897, in __del__
  File "c:\users\lr\appdata\local\programs\python\python39\lib\site-packages\libusb1-1.8.1-py3.9-win-amd64.egg\usb1\__init__.py", line 1909, in close
OSError: exception: access violation writing 0x0000000000000024
Exception ignored in: <function USBDevice.__del__ at 0x000001EE1FC8FF70>
Traceback (most recent call last):
  File "c:\users\lr\appdata\local\programs\python\python39\lib\site-packages\libusb1-1.8.1-py3.9-win-amd64.egg\usb1\__init__.py", line 1897, in __del__
  File "c:\users\lr\appdata\local\programs\python\python39\lib\site-packages\libusb1-1.8.1-py3.9-win-amd64.egg\usb1\__init__.py", line 1909, in close
OSError: exception: access violation writing 0x0000000000000024
Exception ignored in: <function USBDevice.__del__ at 0x000001EE1FC8FF70>
Traceback (most recent call last):
  File "c:\users\lr\appdata\local\programs\python\python39\lib\site-packages\libusb1-1.8.1-py3.9-win-amd64.egg\usb1\__init__.py", line 1897, in __del__
  File "c:\users\lr\appdata\local\programs\python\python39\lib\site-packages\libusb1-1.8.1-py3.9-win-amd64.egg\usb1\__init__.py", line 1909, in close
OSError: exception: access violation writing 0x0000000000000024
```

3) run ``glasgow list`` again:

```
C:\Users\lr>glasgow list
C1-20200924T010855Z
```

Notes: the usb driver has been a bit finicky and I clicked buttons in Zardig without really understanding what they do, apparently I currently have libusbk.

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

whitequark, 2020-12-03:
There's a timeout in the enumeration code which probably needs increasing, but it's at 5 seconds already and I'm somewhat surprised that isn't enough. If it *is* increased significantly then we should do this once libusb hotplug lands on Windows (https://github.com/libusb/libusb/issues/86).

0x53A, 2020-12-13:
After ``glasgow flash`` this seems to happen less often.
It still errors out if I execute a glasgow command immediatly after plugging it in, but if I plug it in and wait 10 seconds, it works.

Maybe ``I: glasgow.device.hardware: found revC1 device with API level 0 (supported API level is 1)`` could be extended with that information?

> [...] (supported API level is 1, __run 'glasgow flash' to update your device__)

whitequark, 2020-12-13:
I think it would be better to fix the hotplug issue, or perhaps do both.

Closed 2023-08-05.

Thread 241 (2020-12-05):

In-Use Glasgows can be interrupted by firmware reload

attie, 2020-12-05:
I had previously started a Glasgow collecting data using the SCD30 applet.

I've just connected a second Glasgow to my system and ran `glasgow list` (to get the serial for use with `--serial`), and noticed that the SCD30 Glasgow was interrupted. I also _think_ I saw the following line twice (once for each board, I've lost the output unfortunately).

```
I: g.device.hardware: found revC1 device with API level 0 (supported API level is 1)
```

It seems that running `glasgow list` reloaded the firmware on the currently busy board, interrupting the applet, and showing the errors below (the last a number of times).

I don't know if we can "_lock_" a device, or determine if it is already use, but this may be worth investigating.

The API level message was introduced in ab21295, and may or may not be related.

I'll look into this further when I have time.

---

```
Traceback (most recent call last):
  File "/home/attie/proj_local/glasgow/venv/bin/glasgow", line 11, in <module>
    load_entry_point('glasgow', 'console_scripts', 'glasgow')()
  File "/home/attie/proj_local/glasgow/glasgow/software/glasgow/cli.py", line 830, in main

  File "/home/attie/.bin/python3.8.2/lib/python3.8/asyncio/base_events.py", line 616, in run_until_complete
    return future.result()
  File "/home/attie/proj_local/glasgow/glasgow/software/glasgow/cli.py", line 639, in _main
    await asyncio.wait(tasks, return_when=asyncio.ALL_COMPLETED)
  File "/home/attie/proj_local/glasgow/glasgow/software/glasgow/cli.py", line 600, in run_applet
    if args.action == "run":
  File "/home/attie/proj_local/glasgow/glasgow/software/glasgow/applet/sensor/scd30/__init__.py", line 290, in interact
    await asyncio.wait_for(report(), meas_interval * 3)
  File "/home/attie/.bin/python3.8.2/lib/python3.8/asyncio/tasks.py", line 483, in wait_for
    return fut.result()
  File "/home/attie/proj_local/glasgow/glasgow/software/glasgow/applet/sensor/scd30/__init__.py", line 283, in report
    while not await scd30.is_data_ready():
  File "/home/attie/proj_local/glasgow/glasgow/software/glasgow/applet/sensor/scd30/__init__.py", line 96, in is_data_ready
    ready, = await self._read(CMD_DATA_READY, ">H")
  File "/home/attie/proj_local/glasgow/glasgow/software/glasgow/applet/sensor/scd30/__init__.py", line 81, in _read
    return struct.unpack(format, await self._read_raw(addr, struct.calcsize(format)))
  File "/home/attie/proj_local/glasgow/glasgow/software/glasgow/applet/sensor/scd30/__init__.py", line 54, in _read_raw
    acked = await self.lower.write(self.i2c_addr, struct.pack(">H", addr), stop=True)
  File "/home/attie/proj_local/glasgow/glasgow/software/glasgow/applet/interface/i2c_initiator/__init__.py", line 182, in write
    acked = len(data) - unacked
  File "/home/attie/proj_local/glasgow/glasgow/software/glasgow/applet/interface/i2c_initiator/__init__.py", line 163, in _data_read

  File "/home/attie/proj_local/glasgow/glasgow/software/glasgow/access/direct/demultiplexer.py", line 225, in read
    async def read(self, length=None, *, flush=True):
  File "/home/attie/proj_local/glasgow/glasgow/software/glasgow/access/direct/demultiplexer.py", line 357, in flush
    if self._out_buffer:
  File "/home/attie/proj_local/glasgow/glasgow/software/glasgow/support/task_queue.py", line 73, in wait_all
    async def wait_all(self):
  File "/home/attie/proj_local/glasgow/glasgow/software/glasgow/support/task_queue.py", line 55, in poll
    """
  File "/home/attie/proj_local/glasgow/glasgow/software/glasgow/access/direct/demultiplexer.py", line 288, in _out_task

  File "/home/attie/proj_local/glasgow/glasgow/software/glasgow/device/hardware.py", line 245, in bulk_write
    else:
  File "/home/attie/proj_local/glasgow/glasgow/software/glasgow/device/hardware.py", line 204, in _do_transfer
    def close(self):
  File "/home/attie/proj_local/glasgow/venv/lib/python3.8/site-packages/usb1/__init__.py", line 822, in submit
    raiseUSBError(result)
  File "/home/attie/proj_local/glasgow/venv/lib/python3.8/site-packages/usb1/__init__.py", line 125, in raiseUSBError
    raise __STATUS_TO_EXCEPTION_DICT.get(value, __USBError)(value)
usb1.USBErrorNoDevice: LIBUSB_ERROR_NO_DEVICE [-4]
E: asyncio: Unclosed client session
client_session: <aiohttp.client.ClientSession object at 0x7f98fa2d97f0>
E: asyncio: Task exception was never retrieved
future: <Task finished name='Task-2297363' coro=<DirectDemultiplexerInterface._in_task() done, defined at /home/attie/proj_local/glasgow/glasgow/software/glasgow/access/direct/demultiplexer.py:209> exception=Gla
sgowDeviceError('transfer error: LIBUSB_TRANSFER_ERROR')>
Traceback (most recent call last):
  File "/home/attie/proj_local/glasgow/glasgow/software/glasgow/access/direct/demultiplexer.py", line 217, in _in_task
    await self._in_pushback.wait()
  File "/home/attie/proj_local/glasgow/glasgow/software/glasgow/device/hardware.py", line 236, in bulk_read
    endpoint_dir = "OUT"
  File "/home/attie/proj_local/glasgow/glasgow/software/glasgow/device/hardware.py", line 206, in _do_transfer
    self.usb_handle.close()
glasgow.device.GlasgowDeviceError: transfer error: LIBUSB_TRANSFER_ERROR
```

whitequark, 2020-12-05:
> I don't know if we can "_lock_" a device, or determine if it is already use, but this may be worth investigating.

We can, by claiming an interface. But... there's a chicken-and-egg problem here: the only way we can introduce this interface is by increasing the API level, which means that claiming an interface would require reloading the firmware, which means this very interruption.

whitequark, 2020-12-05:
Per IRC discussion, it's an edge case that we probably can't do much with.

whitequark, 2020-12-27:
I actually think we *can* introduce this feature without significant disruption. But it would need to be carefully considered how.

marcan, 2020-12-27:
Can't we just make sure we don't reload firmware on Glasgows already exposing this interface? Sure, ones running old firmware would be reloaded... but that sounds like a problem nobody will ever actually care about.

whitequark, 2020-12-27:
> Can't we just make sure we don't reload firmware on Glasgows already exposing this interface?

That's what API levels are already for! And we still have the problem, because people keep running old firmware, because the firmware is transparently reloaded on every invocation.

marcan, 2020-12-27:
But once you're running an applet with up to date software, like OP, it'll already be running the latest firmware, right? If this happened to them it's because their existing run wasn't using an interface, otherwise we would just try to claim it, fail, and not touch that device any more.

whitequark, 2020-12-27:
> wasn't using an interface, otherwise we would just try to claim it, fail, and not touch that device any more.

The firmware is reloaded before any interfaces are claimed.

marcan, 2020-12-27:
> > wasn't using an interface, otherwise we would just try to claim it, fail, and not touch that device any more.
>
> The firmware is reloaded before any interfaces are claimed.

Then it sounds like an easy fix to claim the interface first, if present, as a mutex, before doing that.

whitequark, 2020-12-27:
Well... yes, that's what I suggested above? Except we don't have an interface that can be used for this purpose yet.

marcan, 2020-12-27:
Sure... I was just confused as to how this was an unfixable problem. Like, just doing that means going from "any concurrent glasgow invocations fail" to "glasgow invocations concurrent with out of date ones fail" which sounds like an obvious 99% fix.

whitequark, 2020-12-27:
Yep, I was also confused when I closed this issue, which is why I reopened it!

marcan, 2020-12-27:
Ok, we're in violent agreement then :)

whitequark, 2020-12-29:
Actually, I think I came up with a way that is somewhat simpler and works with every firmware version we have: just try to claim every interface that is already exposed before reflashing, then release.

Closed 2023-08-05.

Thread 250 (2020-12-27):

Silkscreen labels swapped on SCL and SDA testpoints

kevinmehall, 2020-12-27:
Originally reported by `martinr` on Discord, confirmed in KiCad:

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

attie, 2020-12-27:
@esden - a candidate for revC3...

electroniceel, 2021-01-10:
Fixed in wip-revC3-hardware branch

Closed 2021-01-10.

Thread 252 (2020-12-30):

recover flashing doesn't work when firmware or gateware is flashed

electroniceel, 2020-12-30:
Steps to reproduce
1. flash firmware or gateware onto the eeproms
2. short the recover jumper and release reset
3. ```glasgow factory --force --rev C2```

Result:
```
W: g.device.hardware: device 001/033 did not re-enumerate after firmware upload
E: g.cli: device not found
```
No new serial is flashed. The Glasgow still loads firmware and gateware after a manual reset.

I haven't investigated yet, but at least loading gateware takes longer than factory is waiting for. Could be the same for firmware, but the time difference isn't as obvious.

Maybe we need to upload a special firmware during factory that ignores everything in eeprom?

whitequark, 2020-12-30:
> Maybe we need to upload a special firmware during factory that ignores everything in eeprom?

Yes, and we can even get it from libfx2.

electroniceel, 2020-12-30:
> Yes, and we can even get it from libfx2.

One of the examples?

They don't have binaries checked in and we don't want to require sdcc.

I also think we should upload special firmware, because if the flashed firmware is completely broken (that is what recover is for), then we really don't want the fx2 to load it.

whitequark, 2020-12-30:
No, `boot-cypress.ihex` (it is built like a binary extension of the fx2 wheel). (I'm not sure actually if I'm uploading fx2 wheels, let me check that.)

whitequark, 2020-12-30:
Ok, there are binary wheels now: https://pypi.org/project/fx2/#files

whitequark, 2020-12-30:
Specifically, I'm referring to the firmware loaded when you run `fx2tool --bootloader`, which is needed for its EEPROM commands.

electroniceel, 2020-12-30:
Ok, so the solution for factory would be:
1. upload boot-cypress.ihex into the ram of the fx2
2. clear & rewrite the eeprom
3. tell the user to reset

Are the eeprom commands the same between boot-cypress.ihex and Glasgow firmware?

whitequark, 2020-12-30:
Yes, intentionally.

whitequark, 2020-12-30:
(You can also use fx2tool's EEPROM commands with Glasgow *without* replacing its firmware with the bootloader, although you can only access the first EEPROM that way.)

electroniceel, 2020-12-30:
Hmm, let's say you have bad gateware flashed. Once you load the Glasgow firmware into the ram of the fx2, it will start to load this gateware, right? So i think factory should also clear the FPGA EEPROM.

Can the boot-cypress.ihex do this or does it just have the commands for the FX2 EEPROM?

whitequark, 2020-12-30:
> Once you load the Glasgow firmware into the ram of the fx2, it will start to load this gateware, right?

No it won't if the configuration doesn't tell it to do that.

electroniceel, 2020-12-30:
Ah, ok, I haven't looked at that part yet. So the boot-cypress.ihex is fine then when we clear this config bit.

Closed 2023-07-28.

Thread 253 (2020-12-31):

Add documentation of ics used on Glasgow to the archive

electroniceel, 2020-12-31:
The Glasgow archive is designed to store older versions of relevant documentation for devices or standards, even when the vendor removes them or redacts out important information.

Currently the archive mostly contains documentation of devices that Glasgow applets communicate with, but ics on Glasgow itself are missing. This should be improved.

Relevant ics are all non-discrete parts.

All files that are relevant for Glasgow should be archived. That is the basic datasheet, but also reference manuals and appnotes that touch anything used by Glasgow. For example for the FX2 that is AN15456, AN50963, datasheet, TRM, reset and power considerations.

Thread 255 (2021-01-01):

Schematics & Layout TODO for revC3

electroniceel, 2021-01-01:
A list of everything that should be decided and/or done for revC3 of the Glasgow hardware.

- [x] Finish qualification tests for revC2 ( #220 #221 )
- [x] Fix I2C address clash between SMBus Alert Response Address and the DAC of port A
- [x] Add note about the SMBus Alert Response Address to the schematics
- [x] Fix internal I2C testpoint silkscreen labels ( #250 )
- [x] Review all changes added to revC2 between the version the prototypes were made from and merge of the branch
- [x] Check all DFM issues @esden mentioned on stream while assembling the prototypes, are they already incorporated into revC2?
- [x] Increase spacing between the mounting holes and the 3V3 flood fill on the internal power layer to prevent shorts when using serrated washers that could penetrate into the power layer
- [x] Remove the port pinout marking on the top silkscreen ( #256 )
- ~~Decide if to keep the CDSOD323-T36S TVS diodes or to change to another model with better availibility.~~ CDSOD323-T36S stay, @esden said they are ok
- [x] Decide if to add filter for Vsense ( https://github.com/GlasgowEmbedded/glasgow/issues/221#issuecomment-753531753 )  -> filter added in wip-revC3-hardware branch
- [x] Schematics+BOM: adapt LEDs and LED-resistors ( #259 )
- [x] Fix reset button part number
- [x] Decide on LVDS connector alignment hole size
- [x] Decide on resistor pack footprint spacing
- [x] Decide on improved decoupling for Vio_Aux (LVDS io rail). Currently it has 100nF, maybe go up to 1µF, also check trace width
- [x] Add pin 1 marker or something similar to the LVDS header to make the pinout unambiguous

electroniceel, 2021-01-10:
@esden While reviewing the changes to revC2 since the prototypes I found these issues:

### 1. LVDS alignment holes
You mentioned that the LVDS connector alignment holes are quite large and fitting loose. They haven't been changed yet and are still 1.1mm.

The samples you sent me measure alignment pins of 1.02 x 0.98 mm.
The samples of Samtec FLE-122-01-G-DV-A I have measure 0.65mm tough. Samtec suggests a hole of 0.76mm

So the alignment pins of Samtec and your parts have different sizes and I'd say the tolerances look reasonable in CAD, maybe JLCPCB added too much tolerance and drilled much larger in the prototypes?

So to me it looks ok, but please check and decide what to do.

### 2. Reset button part number
The reset button part no is currently "TC-1109DE-X-X". The Xes stand for ordering options for length and actuation force. Please review your ordering/manufacturing data and fill in the correct part nos.

electroniceel, 2021-01-10:
@esden I found another thing that I'm not sure about:

The new footprint for the resistor packs (R_Array_Convex_4x0402) has unequal spacing between the pads. The inner pads have 0.2 mm space between them, the space between the outer and the inner pads is 0.15 mm. I thought the issue was increased likelihood of shorts between the outer and inner pads. So moving the outer pads a bit more outside is good, but you also increased them to the point that the spacing is reduced. I don't know if that will really help.

I suggest to move them out a little bit more so that they get the same space of 0.2 mm.

electroniceel, 2021-01-20:
@smunaut I added a 4.7 µF cap to VIO_AUX now, because adding 1 µF would have meant adding a new BOM line, as we don't have 1 µF yet.

Unfortunately I couldn't get it as close to the FPGA as I wanted, but I didn't want to reroute bigger parts of the LVDS data lines this late in the design.

You can check it in the wip-revC3-hardware branch. Maybe you find a better spot to fit it or a second 100 nF nearer to the balls?

smunaut, 2021-01-20:
4u7 is fine.

And location will have to do. That's a rather crowded area and the 'clkref' line splitting the line and also going across the whole reference plane for half the lvds lines is a bit of a bummer but with 6/6 rules there is only so much you can do :/

electroniceel, 2021-01-20:
> And location will have to do. That's a rather crowded area and the 'clkref' line splitting the line and also going across the whole reference plane for half the lvds lines is a bit of a bummer but with 6/6 rules there is only so much you can do :/

Yeah, the layout in that area is a bit crowded and convoluted, not optimized for EMI, but for keeping it at 4 layers. But I think it will still do fine as it is now.

Thanks for reviewing.

esden, 2021-03-26:
## Decide on LVDS connector alignment hole size

The part that we have sourced for the production of Glasgow revC3 has a smaller alignment pin than alternative models. This results in alignment wobble. The peg is rectangular with dimensions of 0.5mm x 0.7mm. The footprint recommendation by the connector manufacturer lists a hole of 1.1mm which is very large and does not result in a very good alignment. Based on reading of other manufacturer datasheets and recommendations, the rule of thumb seems to be 0.1mm larger hole than the alignment pin. Thus I would recommend to decrease the alignment hole size to 0.8mm.

esden, 2021-03-26:
## Fix reset button part number
Fixed in commit 84810727408d623672fd89c878565682f2e92de3 the full part number is `TC-1109DE-B-F`.

esden, 2021-03-26:
## Decide on resistor pack footprint spacing

The current footprint is based on the Samsung recommended footprint dimensions.

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
https://www.samsungsem.com/resources/file/global/support/product_catalog/Chip_Resistor.pdf

The `RP104P` is the `0402x4` package type. The strange part about those dimensions is that the P1 distance indicates 0.55mm between the inner pad and the outer pad centers. Which results in a 0.15mm gap. The outer gap is not defined otherwise only the center gap which is 0.2mm. I guess we could move the pad out by 0.05mm so that the gaps are balanced.

On another note, looking through a bunch of datasheets the bigger outer pads recommendation is not the most common one. (if the manufacturer recommends any footprint at all) I tried to resolve it by going to JEDEC standard. But so far I was not able to locate that. Based on [one stack overflow post](https://electronics.stackexchange.com/questions/101079/what-standard-governs-the-dimensions-of-smt-chip-resistors-and-capacitors) it seems that there is no up to date standard for resistor array footprints at the moment. But it would be nice to at least find a copy of the IEC 60115-8 document.

I would for now leave the footprint as it is, as I know that it works in production. But if we can get some better industry recommendation we can consider updating it.

esden, 2021-03-31:
## Schematics+BOM: adapt LEDs and LED-resistors

Resolved with: bd0d5b1d4d3006b3629e85382b80c47547cc3e1b

esden, 2021-03-31:
## Decide on LVDS connector alignment hole size
Changed to 0.76mm diameter holes, and removed pad chamfers that are not needed any more in: ae8d47c5f9998be509b4eca82c461dd58cf31335

attie, 2023-02-23:
@esden / @electroniceel - is this still in progress?

esden, 2023-07-31:
I have also corrected the resistor pack footprint. That was the last remaining todo item. I have pushed all the remaining patches to the wip branch. I will open a PR as soon as I rebase it onto main.

whitequark, 2023-07-31:
@esden Excellent work!! So excited to have this ***Done***.

esden, 2023-07-31:
Yeah it is indeed quite a relief! I hope everything works as expected :see_no_evil:

whitequark, 2023-10-06:
Thanks everyone! We now have all the design files upstream.

Closed 2023-10-06.

Thread 256 (2021-01-01):

Decide on port pinout marking on the top silkscreen

electroniceel, 2021-01-01:
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

During revC2 development this was added, mostly as an experiment to see how it works out in the prototypes.
Do we want to keep it for future revisions or remove it in revC3?

Pros:
- We have no other marking on the top side that shows the port assignments
- Does not cost us anything

Cons:
- Hard to read
- Does not look pretty in it's current state
- The marking is on the outside of the port headers, because that is the only space available. But the outside pins are mostly GND, the numbered pins are inside. The user could get confused by this and has to memorize it.

The protoypes were made at JLCPCB, the final production boards are planned to be made at King Credie. The latter is supposed to have higher quality silkscreen, at least available as an option. So it may look better on the final boards.

There are full pin markings without any confusion issues on the backside silkscreen. Also the aluminium case will have the pinout printed on top. People not using the aluminium case can stick marking tape on the connector shrouds or the lasercut case.

I'm yet undecided, but more leaning for removal because of the inside/outside confusion issue.

electroniceel, 2021-01-01:
@esden Could you comment on the silkscreen quality expected by King Credie? Also your opinion on this issue of course.

esden, 2021-01-01:
@electroniceel Regarding the labeling. I think I agree, I am not really using those labels myself (they are as we expected too small to be useful). I also think they might result in confusion as they are on the wrong side of the connector anyways. I think we should remove them. The wire harnesses and their labeling, as well as the markings on the back of the board turn out to be much more useful in practice.

whitequark, 2021-01-01:
I agree with the removal. Parallax makes the labels easy to accidentally misuse.

electroniceel, 2021-01-01:
Ok, let's remove them

Closed 2021-01-01.

Thread 257 (2021-01-02):

Blink FX2 LED when Glasgow is powered, but no USB data connection

electroniceel, 2021-01-02:
This is to make cable issues or charge-only usb cables easily visible for the user.

Use a slow blink (not aggressively fast) because this could also be a permanent and expected state (Glasgow with flashed gateware connected to a power supply).

Implementation: check in firmware if an address is assigned.

Idea from @whitequark on irc: https://freenode.irclog.whitequark.org/glasgow/2020-12-20#28644811;

Closed 2023-07-28.

Thread 259 (2021-01-06):

revC LED type and resistor selection

esden, 2021-01-06:
In the effort to optimize pricing for revC batch production I have ended up using different LED than the ones listed in the design files. Thus the optimized resistors for even and correct brightness ended up not being correct.

I was hoping to get it close enough with some existing BOM lines but it turns out that did not work out.

This issue is meant to track progress on finalizing the LED type and inline resistor selection to meet the following requirements:

* Reasonabely even brightness between all the different color LEDs
* Not too bright to be blinding as a naked PCB
* Bright enough to be well visible through lightpipes of the case in bright video recording brightness conditions.
* Easily sourcible LEDs for a CM at good price point.

TODO: I will post the old and new LED MFN and assoctiated resistor selections a bit later.

attie, 2021-01-06:
@esden - if you're swapping the LEDs, I'd vote for the design files to be updated to reflect the actual parts used - especially if you're going to tune the resistors again.

revC2 is already "released", so don't change that... but perhaps this update can be done for revC3? (which I believe you'll be shipping for the CS campaign?)

esden, 2021-01-06:
For revC2 design files I should have not touched the resistor values as I did not change the LED MPN. When populated with the original parts and resistor values as marcan selected will be fine. My mistake here was to touch the resistor values in the design files.

As for the parts that I have selected, I am concerned that hose parts are not as widely available from the usual part suppliers. They are easy to get in china but not from western suppliers. So at the end I am not sure what the correct end solution should be. I wish KiCad supported alternate population sets...

timonsku, 2021-01-06:
I wouldn't worry too much about the light pipes in terms of brightness. The extra size doesn't really decrease brightness, it just means the light pipes have to be longer. Acrylic has 90%+ translucency so the brightness loss is minimal, making them not blindingly bright is more important imo.
Also note that a very high brightness can also cause more bleed as we are not working with "true" light-pipes that transfer the light of each LED individually but rather packed together as one big blob.

For the case I only would like to see at least a different LED color for the FX2 LED so they can be differentiated when they inevitably bleed into each other a bit with the light-pipe. The ICE green led and the orange ACT led are also a bit similar in color and probably hard to differentiate for color blind people.
Blue for ICE and white for FX2 sound like good options to me as these colors are used on the user LEDs already.

electroniceel, 2021-01-06:
> As for the parts that I have selected, I am concerned that hose parts are not as widely available from the usual part suppliers. They are easy to get in china but not from western suppliers.

If the new LEDs are available from LCSC that would be good enough for me. They reliably ship to western countries and don't ship fakes or misuse part nos.

In the end the LEDs are not a dealbreaker for rebuilding. If someone is able to solder BGAs and 0402 to build their own Glasgow, I'd say they should usually be experienced enough to change to different LEDs and matching resistors if they can't source the original ones.

But I second @attie in that we should put the parts actually used in production into the schematics and BOM.

marcan, 2021-01-07:
Yeah, the canonical schematics and BOM should just have *some* set of resistors and LEDs that are known to be properly matched, ideally the production ones.

People DIYing this will probably use whatever they have on hand, and people doing their own production runs get to redo this process. I'm not too concerned as long as the design files reflect one known-good set of parts, and it might as well be @esden's production version.

As for the brightness, I'm happy as long as long as the end result is roughly similar to what I came up with. For referecence, [this](https://twitter.com/marcan42/status/1103642165475864577) is how I did it.

Basically, I would say: naked LEDs should be discernible (not necessarily easily) in bright sunlight. Lightpipes should be easily visible in normal indoor bright lighting conditions. And the things shouldn't light up the whole room when in pitch darkness. The revC1 I got from @esden has pretty good brightness, so that's probably a good thing to match to (except the Vio LEDs are way too dim on that one; I think the resistor choice was wrong for that or something and I assume that's been fixed already).

electroniceel, 2021-01-07:
> For the case I only would like to see at least a different LED color for the FX2 LED so they can be differentiated when they inevitably bleed into each other a bit with the light-pipe. The ICE green led and the orange ACT led are also a bit similar in color and probably hard to differentiate for color blind people.
> Blue for ICE and white for FX2 sound like good options to me as these colors are used on the user LEDs already.

The majority of the orders seems to be with the al. case, so we should really make the  LEDs work well for that scenario too. I think @timonsku has a valid point here, light bleed can be an issue, especially when looking at the LEDs from an angle.

Even though LEDs are surprisingly hard to photograph an still look realistic, I tried to emulate the lightpipe setup with a slightly frosted acrylic sheet I had around:

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

The picture above is from straight above. But when looking at an angle, color bleed and axis shift become a problem:

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

To see how @timonsku s proposal would look like, I took the user LEDs from my prototype and resoldered them to the status LEDs:

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

While I think the look on the bare board is a bit more "nervous" than the greens that were suggesting everything is ok, I still think it is ok. Also the white and blue are much brighter than the orange activity LED.

But unfortunately it doesn't work out for me through the acrylic:

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

The white has a bluish tint and the blue isn't visible as a point, more as a color field bleeding everywhere. I guess this mostly comes from these individual LED models, but could also have to do something with the light permeability of the acrylic being dependant on wavelength.

So unfortunately I don't have a nice solution for the problem.

esden, 2021-03-26:
Michael Ossmann tipped me off that they have put a bunch of effort into selecting LCSC sourcable LEDs with appropriate resistors for [Luna](https://github.com/greatscottgadgets/luna). For reference here is their selection of led and resistor values:
* Red, OptoSupply, OSR50603C1E, 1k
* Orange, EKINGLUX, E6C0603SEAC1UDA, 1k
* Yellow, EKINGLUX, E6C0603UYAC1UDA, 1k
* Green, Orient, ORH-G36G, 10k
* Blue, Orient, ORH-B36G, 2k2
* Purple, OptoSupply, OSVX0603C1E, 2k2 (does not seem to be available through LCSC?)
* Ice Blue, MEIHUA, MHT192WDT-ICE, 5k5 (5k5 is not a common value, 5k49 or 5k6 could be used here?)
* Pink, OptoSupply, OSK40603C1E, 2k2
* White, Orient, ORH-W46G, 2k2

The resulting color balance picture by ktemkin: https://twitter.com/ktemkin/status/1357120015133077504

esden, 2021-03-29:
I like the @electroniceel suggestion to change the `STATUS LED` colors. I have put the proposed color scheme onto a test board and it does look good and makes it easier to distinguish them. (will test on a live glasgow board next)

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

This is the proposed color scheme:
* PWR: Green
* FX2: White
* ICE: Blue
* ACT: Orange
* ERR: Red
* U1: Blue
* U2: Pink
* U3: White
* U4: Pink
* U5: Blue

The part numbers used on my board with resistor values:
* Green, Foshan NationStar Opto, NCD0603G1, 10k
* White, Foshan NationStar Opto, NCD0603G1, 2k2
* Blue, Orient, ORH-B36G, 2k2
* Orange, Foshan NationStar Opto, NCD0603O1, 1k
* Red, Orient, ORH-R36A, 1k
* Pink, OptoSupply, OSK40603C1E, 2k2

The brightness match seems acceptable to me. It is still possible to see that the led are on with a bright flashlight shining onto the board, and they are also not blindingly bright. (it is very hard to convey on camera though)

electroniceel, 2021-03-29:
did you check the proposed LEDs through a lightpipe?

As noted above, I had problems when looking at an angle and especially with the blue LEDs.

electroniceel, 2021-03-29:
>     * Green, Foshan NationStar Opto, NCD0603G1, 10k
>     * White, Foshan NationStar Opto, NCD0603G1, 2k2

these are the same P/N, this seems like a mistake.

I use NCD0603G1 myself, they are my default green LEDs.

esden, 2021-03-29:
After testing multiple lightpipes, I am convinced that using clear acrylic is the way to go. At least as long as we keep the oval lightpipes. Diffusion will only be useful if we have another way of separating the LED, for example by using one light pipe per LED. Having different colors of LED next to each other is still desirable though as it makes it easier to see what is going on at a glance.

I corrected the P/N above.

esden, 2021-03-31:
Made the proposed changes and committed in: bd0d5b1d4d3006b3629e85382b80c47547cc3e1b
For additional reference, I showed off the selected LEDs and discussed their visibility through the light pipes during [my twitch stream](https://www.twitch.tv/videos/969238435).

esden, 2021-03-31:
I consider the issue closed. If there are still questions or need for followup please feel free to reopen the issue.

Closed 2021-03-31.

Thread 263 (2021-01-19):

applet.interface.uart: high Baud rates drop data

attie, 2021-01-19:
It seems that using ~1.5Mbaud, with high Rx data rates can cause the applet FIFOs to overflow, and silently drop data.

1.5Mbaud is worst-case of ~150KB/s... this overflow is likely due to the relatively inefficient USB utilization that is incurred with the default `auto_flush=True`.

Suggestions:

1. Set `auto_flush=False`, and implement a timer to flush buffers after a number of idle bit/word-times
2. Increase FPGA-side FIFO size, past the default of `depth=512`
3. Add a register to indicate overflow / dropped frames

I think that this should be a non-issue for Tx data, as the buffers will back up, eventually into Python.

---

This was discovered by @marcan while working on Asahi Linux.

whitequark, 2023-07-24:
We should probably implement something like Nagle for UART.

whitequark, 2025-07-06:
Item (1) will be fixed globally in #794.
Item (2) isn't necessary once (1) and (3) are addressed.
Item (3) is fixed in #932.

Closed 2025-07-13.

Thread 268 (2021-01-31):

iCE40 NVCM programming support

smunaut, 2021-01-31:
New applet to support to program NVCM memory in ice40 devices.

Just opening the issue to collect data about how that works just because I happen to have an example of NVCM file and the matching "SVF" (which really is SPI commands, not JTAG) for it and it includes some comments.

There is no official document describing the protocol. Those files were generated from Radiant.

[nvcm-example.zip](https://github.com/GlasgowEmbedded/glasgow/files/5899869/nvcm-example.zip)

whitequark, 2025-05-20:
@smunaut Are you still planning to work on this applet?

Thread 270 (2021-02-08):

applet.interface.pulse_counter: new applet to count pulse events on pins

TomKeddie, 2021-02-08:
I'm writing this applet for a testbench I'm building.  Initial version will just edge detect on pins and increment counters.
Other future features could include
- counter reset
- per pin configurable debounce time
- pulse width measurement (min/max/median/recent)

attie, 2021-02-08:
see https://github.com/GlasgowEmbedded/glasgow/pull/218

Closed 2021-02-08.

Thread 274 (2021-02-12):

Invalid glasgow_config after flashing a modified firmware

DurandA, 2021-02-12:
Hi,

I got an assembled Glasgow rev C1 and I am playing with the FX2 firmware. I noticed some strange issues if I erase the FX2 EEPROM, perform a `glasgow factory --rev C1`:
```
[ 2080.974006] usb 1-2: New USB device found, idVendor=20b7, idProduct=9db1, bcdDevice= 1.31
[ 2080.974011] usb 1-2: New USB device strings: Mfr=1, Product=2, SerialNumber=3
[ 2080.974014] usb 1-2: Product: Glasgow Debug Tool
[ 2080.974017] usb 1-2: Manufacturer: whitequark research
[ 2080.974020] usb 1-2: SerialNumber: C1-20210212T011722Z
```

And then after a power cycle  `glasgow flash --firmware firmware/glasgow.ihex` with a [modified firmware](https://github.com/GlasgowEmbedded/glasgow/compare/master...DurandA:atecc):
```
[ 2281.649128] usb 1-2: New USB device found, idVendor=04b4, idProduct=8613, bcdDevice= 1.f9
[ 2281.649133] usb 1-2: New USB device strings: Mfr=1, Product=2, SerialNumber=3
[ 2281.649136] usb 1-2: Product: Glasgow Debug Tool
[ 2281.649139] usb 1-2: Manufacturer: whitequark research
[ 2281.649141] usb 1-2: SerialNumber: O9-9999999999999999
[ 2286.717811] usb 1-2: can't set config #1, error -110
```

The board becomes unusable after that and requires a flash erase with an external tool as it is not properly enumerated after a power cycle otherwise:
```
[ 2624.222003] usb 1-2: new high-speed USB device number 28 using xhci_hcd
[ 2629.374022] usb 1-2: device descriptor read/64, error -110
```

However, the issue does not appear if I first flash the firmware compiled from master and then the same custom firmware.

My first thought that maybe a memory region grew a bit too much and the memory location of `glasgow_config` slightly moved and/or was erased by other regions. However it seems to be allocated the very end of the usable memory:
https://github.com/GlasgowEmbedded/glasgow/blob/25fe8d326ef2cb01d1316136ec7a86967e90f21b/firmware/glasgow.h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

So I tried to slightly increase XRAM and reduce CODE by the same amount:
https://github.com/GlasgowEmbedded/glasgow/blob/25fe8d326ef2cb01d1316136ec7a86967e90f21b/firmware/Makefile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

None of my attempts solved the issue. Do you have any idea of what kind of black magic could be happening?

attie, 2021-02-12:
Unfortunately I don't think custom firmware is going to receive much direct support from the Glasgow project. Sorry.

Depending on what you're doing, I'd encourage you to inspect the official firmware, how it is built, and work from there.

If you've taken the existing firmware and tweaked it, then the `bcdDevice`, Serial Number, and other fields are stored at a [specific location in flash](https://github.com/GlasgowEmbedded/glasgow/blob/25fe8d326ef2cb01d1316136ec7a86967e90f21b/firmware/glasgow.h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) (as you've identified), and looking at your values, these all appear to be bad / wrong... Possibly due to erased flash with no data (_does a bcd field mask / limit to `9`?_, wrt revision `'A' + 0xf - 1 == 'O'`), possibly due to other data being placed there incorrectly.

This location is at the very end of the flash (`0x4000 - CONF_SIZE = 16 KiB - 64 Bytes`), and that `0x4000` / 16 KiB size directly relates the size of the FX2's internal RAM - i.e: your CODE + RAM + CONFIG cannot exceed this size.

If you have access, it might be worth dumping the flash and looking at what is stored there.

The USB enumeration / configuration change failing implies that something is wrong with your USB handling, but I can't offer much more than that unfortunately.

Have you confirmed that you can simply build the official firmware, and that it works correctly?

> The board becomes unusable after that and requires a flash erase with an external tool as it is not properly enumerated after a power cycle otherwise:

It should be possible to short the two "REC" pins at power up, to present the FX2 as if it had no firmware - assuming you're on the revC1 board from me, the pins are here:

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

electroniceel, 2021-02-12:
> > The board becomes unusable after that and requires a flash erase with an external tool as it is not properly enumerated after a power cycle otherwise:
>
> It should be possible to short the two "REC" pins at power up, to present the FX2 as if it had no firmware - assuming you're on the revC1 board from me, the pins are here:

If flashing with the REC pads shorted doesn't work for you, it could be issue #252 you are experiencing. This happens when you have flashed firmware (and not just the VID/PID for the FX2). You need to flash basic firmware from libfx2 as outlined in that issue to work around that until a proper fix for #252 is implemented.

DurandA, 2021-02-12:
Thank you very much @attie and @electroniceel for the help. I will have a closer look at it in the next few days.

>     1. It looks like your changes are implementing support for the ATECC chip - if you're using the board from me without modifications, then please be aware that this chip isn't present.

I'm using your one board :wink: and yes U34 is unpopulated. I soldered the SOIC variant on the test points at the back.

>     2. The ATECC chip was removed from future revisions for various reasons, so I _suspect_ that support for it isn't something we're looking for (in case you're aiming at a PR).

I am aware of it. I joined the #glasgow IRC last year to propose my help for authentication and @whitequark told me that the idea was discarded. I proceeded anyway since I am doing some academic work on IoT security and was interested in it.

Thanks for the REC tip, I did not notice it on the board nor in the schematic.

electroniceel, 2021-02-12:
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

I'm curious to know why you decided to connect your ATECC to the internal I2C bus of Glasgow then and not to one of the regular ports A or B.

Using the regular ports would allow you to easily create a Glasgow applet for the ATECC or use a REPL script like https://github.com/GlasgowEmbedded/glasgow/blob/master/examples/i2c-pcf8574.py
There is no interface for accessing the internal I2C yet, so all I2C transactions must be added to the firmware, as you probably already figured out. This makes it much more complicated, at least from my point of view.

DurandA, 2021-02-13:
> I'm curious to know why you decided to connect your ATECC to the internal I2C bus of Glasgow then and not to one of the regular ports A or B.

The main reason was that the board was already designed with the ATECC connected to the internal bus. Also I was able to start working on the firmware with a cheap FX2LP dev board as I did not have a Glasgow and was not very confident about assembling BGA parts myself. I also think it makes more sense to be able to authenticate the device at any stage without replacing the gateware.

Besides the issue when flashing this firmware, the minimal driver for the ATECC I created for the FX2 seems to work fine and have sufficient features for public key authentication and certificate retrieval. The Python authentication module is still WIP.

DurandA, 2021-03-30:
I am back to firmware hacking and I am still annoyed by this issue. I am now stuck in a loop that prevents any useful work.

From a C1 Glasgow with a modified firmware:
```
[  980.665167] usb 1-2: new high-speed USB device number 24 using xhci_hcd
[  980.817066] usb 1-2: New USB device found, idVendor=20b7, idProduct=9db1, bcdDevice= 1.31
[  980.817071] usb 1-2: New USB device strings: Mfr=1, Product=2, SerialNumber=3
[  980.817074] usb 1-2: Product: Glasgow Debug Tool
[  980.817077] usb 1-2: Manufacturer: whitequark research
[  980.817079] usb 1-2: SerialNumber: C1-20210330T015615Z
```

Then I send a USB requests that fails with `usb1.USBErrorPipe: LIBUSB_ERROR_PIPE [-9]`:
```
data = await device.control_read(usb1.REQUEST_TYPE_VENDOR, 0x20, 10, 0, 16)
```

After that the device is unusableso I disconnect and then reconnect the Glasgow board:
```
[ 1071.765476] usb 1-2: USB disconnect, device number 24
[ 1074.350063] usb 1-2: new high-speed USB device number 25 using xhci_hcd
[ 1074.502355] usb 1-2: New USB device found, idVendor=04b4, idProduct=8613, bcdDevice= 1.f9
[ 1074.502360] usb 1-2: New USB device strings: Mfr=1, Product=2, SerialNumber=3
[ 1074.502364] usb 1-2: Product: Glasgow Debug Tool
[ 1074.502367] usb 1-2: Manufacturer: whitequark research
[ 1074.502369] usb 1-2: SerialNumber: O9-9999999999999999
[ 1079.687043] usb 1-2: can't set config #1, error -110
```

And then the device is unusable. I have to put it back to FX2 bootloader mode, erase the EEPROM and start again.

What kind of debug tools do you use for the FX2?

DurandA, 2021-04-05:
After some more debug, the USB errors appear as I get closer to the memory limit of the 8051.

It is strange, because I do not see overlaps in `build/glasgow.mem`:
```
Other memory:
   Name             Start    End      Size     Max
   ---------------- -------- -------- -------- --------
   PAGED EXT. RAM   0x3e00   0x3ecc     205      256
   EXTERNAL RAM     0x3ecd   0x3f1a      78      448
   ROM/EPROM/FLASH  0x0000   0x3958   14617    15872
```

I know that `struct glasgow_config` is located at  `__xdata __at(0x4000 - CONF_SIZE)` where `CONF_SIZE` is configured to `0x0040` but 0x4000-0x40 > 0x3f1a.

Commenting out a few unused functions solves the USB issues. It could be a memory alignment issue as well.

I'm not sure if I should close this issue as it could happen if the current firmware is expanded. Let me know what you think.

whitequark, 2021-04-05:
I agree that this is a potential issue for expanding the current firmware.

DurandA, 2021-04-06:
I started investigating if this could be due to the config overwriting due to an overlapping EEPROM page.

I enabled https://github.com/GlasgowEmbedded/glasgow/blob/99b81aac282f02ec3f3cda9566d929e30f1ecef4/software/glasgow/device/hardware.py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 and  https://github.com/GlasgowEmbedded/glasgow/blob/99b81aac282f02ec3f3cda9566d929e30f1ecef4/software/glasgow/device/hardware.py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

What surprises me is that the configuration is read at address 0 of the EEPROM while I thought it was located at 0x3fc0:
```sh
$ glasgow flash --firmware firmware/glasgow.ihex
I: g.cli: reading device configuration
reading EEPROM chip 0 range 0000-004b
I: g.cli: device has serial C1-20210406T021410Z
```

Is the memory mapping reversed?

whitequark, 2021-04-06:
No. Take a look at the section of the FX2 manual that describes how loads its firmware from EEPROM. In short, there's a series of length-address-value chunks at the start of the EEPROM, so the EEPROM addresses and the XRAM addresses have no correspondence.

whitequark, 2023-07-24:
At a glance, this issue seems to have been caused by the code area becoming too large and overflowing into something important. (The `atecc.c` file is pretty chonky.)

In any case this is not an actionable issue for the Glasgow project.

Closed 2023-07-24.

Thread 276 (2021-02-16):

applet: explore ideas for testing usb 2.0 data with Glasgow

TomKeddie, 2021-02-16:
I'm opening this issue to document my experiments with Luna (https://github.com/greatscottgadgets/luna) on glasgow.

Unsurprisingly Luna works fine using the lvds connector.  Here is the platform definition I used.  I used a usb direct pmod and my lvds-pmod adapter to test this.

Next step is to test using the test interface.

```
#
# This file is part of LUNA.
#
# Copyright (c) 2020 Great Scott Gadgets <info@greatscottgadgets.com>
# SPDX-License-Identifier: BSD-3-Clause

""" TinyFPGA Platform definitions.

This is a non-core platform. To use it, you'll need to set your LUNA_PLATFORM variable:

    > export LUNA_PLATFORM="luna.gateware.platform.glasgow:GlasgowPlatform"
"""

import os
import subprocess

from nmigen import Elaboratable, ClockDomain, Module, ClockSignal, Instance, Signal, Const, ResetSignal
from nmigen.build import Resource, Subsignal, Pins, Attrs, Clock, Connector, PinsN
from nmigen_boards.resources import *
from nmigen.vendor.lattice_ice40 import *

from .core import LUNAPlatform

class GlasgowDomainGenerator(Elaboratable):
    """ Creates clock domains for the TinyFPGA Bx. """

    def __init__(self, *, clock_frequencies=None, clock_signal_name=None):
        pass

    def elaborate(self, platform):
        m = Module()
        locked = Signal()

        # Create our domains...
        m.domains.sync   = ClockDomain()
        m.domains.usb    = ClockDomain()
        m.domains.usb_io = ClockDomain()
        m.domains.fast   = ClockDomain()
        # ... create our 48 MHz IO and 12 MHz USB clock...
        # Fout = 48MHz * (47 + 1) / (2^4 * (2 + 1)) = 48MHz
        clk48  = Signal()
        clk12  = Signal()
        m.submodules.pll = Instance("SB_PLL40_2F_CORE",
            i_REFERENCECLK  = platform.request(platform.default_clk),
            i_RESETB        = Const(1),
            i_BYPASS        = Const(0),

            o_PLLOUTCOREA   = clk48,
            o_PLLOUTCOREB   = clk12,
            o_LOCK          = locked,

            # Create a 48 MHz PLL clock...
            p_FEEDBACK_PATH = "SIMPLE",
            p_PLLOUT_SELECT_PORTA = "GENCLK",
            p_PLLOUT_SELECT_PORTB = "SHIFTREG_0deg",
            p_DIVR          = 2,
            p_DIVF          = 47,
            p_DIVQ          = 4,
            p_FILTER_RANGE  = 1,
        )

        # ... and constrain them to their new frequencies.
        platform.add_clock_constraint(clk48, 48e6)
        platform.add_clock_constraint(clk12, 12e6)

        # We'll use our 48MHz clock for everything _except_ the usb domain...
        m.d.comb += [
            ClockSignal("usb")     .eq(clk12),
            ClockSignal("sync")    .eq(clk48),
            ClockSignal("usb_io")  .eq(clk48),
            ClockSignal("fast")    .eq(clk48),

            ResetSignal("usb")     .eq(~locked),
            ResetSignal("sync")    .eq(~locked),
            ResetSignal("usb_io")  .eq(~locked),
            ResetSignal("fast")    .eq(~locked)
        ]
        return m

class GlasgowPlatform(LatticeICE40Platform, LUNAPlatform):
    name                   = "Glasgow"
    clock_domain_generator = GlasgowDomainGenerator
    default_usb_connection = "usb"
    device                 = "iCE40HX8K"
    package                = "BG121"
    default_clk            = "clk48"
    resources   = [
        Resource("clk48", 0, Pins("K6", dir="i"),
                 Clock(48e6), Attrs(IO_STANDARD="SB_LVCMOS")),

        *LEDResources(pins="G9", attrs=Attrs(IO_STANDARD="SB_LVCMOS")),

        DirectUSBResource(0, d_p="H2", d_n="H1", pullup="J2", d_p_oe="C1", d_n_oe="D2", attrs=Attrs(IO_STANDARD="SB_LVCMOS33")),
    ]
```

whitequark, 2021-02-16:
To keep my workload as a maintainer manageable I would strongly prefer to avoid supporting any third party frameworks on Glasgow hardware even if it is something as nice as Luna. I will close this issue because of this.

TomKeddie, 2021-02-16:
Thanks @whitequark I was expecting this kind of thing would come to Glasgow with support for external applets, we not expecting this to be in tree.  I understand your need to stay focussed.  I have some more stuff to document that I'd like to add here (if you don't mind).  If nothing else, to aid someone in the future that might want to build usb test on Glasgow.

whitequark, 2021-02-16:
I understand that this is frustrating but unless explicitly limited, open source tends to creep in scope until the maintainers fold. I will preventively limit the scope to avoid that. I think I made the board easily hackable for anyone who wants to do that with the understanding that they are completely on their own.

TomKeddie, 2021-02-16:
Not frustrated, a good call on your part I think.

whitequark, 2021-02-16:
The LVDS bank in particular is essentially something that exists because @marcan didn't want any FPGA I/O to go to waste. It is not even going to be 100% tested (I think, this might not be final) and it will go away in future revs.

TomKeddie, 2021-02-16:
Agreed, I used lvds as a PoC for the logic and nothing else.  My next comment was to be about resolving whether this is possible for the test interface.  I'm not sure it is.

TomKeddie, 2021-02-16:
(am leaving this here for future explorers).

The real challenge for driving the usb data lines directly with the glasgow test interface will be the direction control on the level converters.  I've modified luna to wire out the direction control to pins and used them to drive the test interface (A[0:2]) with this change to the platform definition.
```
        DirectUSBResource(0, d_p="A1", d_n="A2", pullup="B3", d_p_oe="C7", d_n_oe="C8", attrs=Attrs(IO_STANDARD="SB_LVCMOS33")
```
There are signs of life but it's not clean.  The messages are corrupt are the enumeration fails.
```
[788582.485186] usb 2-4.7.4: new high-speed USB device number 79 using ehci-pci
[788582.593700] usb 2-4.7.4: New USB device found, idVendor=03fd, idProduct=000f, bcdDevice= 0.00
[788582.593704] usb 2-4.7.4: New USB device strings: Mfr=0, Product=0, SerialNumber=0
```

rwhitby, 2021-02-16:
This is all good for me to hear and understand.   I was contemplating putting D+/D- switchable pull-up/down on the Glasgow USB-PD board I'm designing (https://github.com/rwhitby/glasgow-addons/tree/usbp-pd-addon/hardware/usb-pd-addon) but this discussion is now dampening that contemplation and pushing me towards just making the USB-PD board easily connectable to a supported Luna board (Glasgow/USB-PD handles the USB-PD side, Luna handles the USB data side).

Closed 2021-02-16.

Thread 281 (2021-03-29):

P and N pins are swapped on revC2

whitequark, 2021-03-29:
I've tried actually using the LVDS bank and it turns out we swapped the pair polarity *again*.

From nMigen comments:
```
        # On iCE40, a differential input is placed by only instantiating an SB_IO primitive for
        # the pin with z=0, which is the non-inverting pin. The pinout unfortunately differs
        # between LP/HX and UP series:
        #  * for LP/HX, z=0 is DPxxB   (B is non-inverting, A is inverting)
        #  * for UP,    z=0 is IOB_xxA (A is non-inverting, B is inverting)
```

electroniceel, 2021-03-29:
When looking at Figure 2 in
https://github.com/GlasgowEmbedded/archive/raw/main/G00079/Using_Differential_IOLVDS_Sub-LVDS_in_iCE40_Devices_Revision_1.5.pdf
it seems like IOL_nA is non-inverting and IOL_nB is inverting. The document explicitly mentions LP/HX devices and not UP. It is also explained in the text on page 3:
```
Connect the positive or true polarity side of the differential pair to the DPxxA input and the negative or complemen-
tary side of the pair to the DPxxB input.
```

This doesn't match the above mentioned nMigen comment.

I couldn't quickly find another document from Lattice confirming this.

The ball numbers in our symbol and the IOL_nA / IOL_nB description matches the pinout description from Lattice.

We always call the *_A from the FPGA _P (positive, non-inverting) and the *_B _N (negative, inverting). This matches the LVDS document I linked above.

When comparing the LVDS pinout on revC0, revC1 and revC2 I couldn't see a difference.

I'm trying to understand where the issue actually occurs. Could it be that the nMigen comment is wrong? Or is the error in the Lattice documentation?

electroniceel, 2021-03-29:
from IRC discussion https://freenode.irclog.whitequark.org/glasgow/2021-03-29#29552047 :

@adamgreig found that Lattice changed the _A and _B designators in the revision history of the tech note linked above. This suggests that there are some inconsistencies in the Lattice documentation about this detail. So it is not unlikely that the nMigen comment is correct.

whitequark, 2021-03-29:
> Could it be that the nMigen comment is wrong? Or is the error in the Lattice documentation?

If you try to synthesize a design with the pins assigned as they are right now, you get a placement error.

electroniceel, 2021-03-29:
Further progress from IRC:

@smunaut saw that inverting and non-inverting is swapped between input and output pairs.

Naming in the Glasgow schematics currently matches output pairs.

Figure 9 in the tech note shows that the input pair has a fixed polarity, while for the output pair LUTs are used, so inverting is free. This would mean that naming the pins in the schematics would be better done according to input pairs.

Now the best course of action is still to be determined: Swapping pin names now could lead to confusion with existing addons/documents/code.

whitequark, 2021-03-30:
> Swapping pin names now could lead to confusion with existing addons/documents/code. OTOH, getting a placement error with the names from the schematics will lead to confusion too.

Fix it. The LVDS connector is supported on a best-effort basis so I am not concerned about downstream fallout. Also, barely anyone has ever used it.

marcan, 2021-03-30:
I assume we mean swapping the labels, not the traces. If so, agreed. Whatever fallout exists right now can be mitigated, let's make the docs sane from here on.

whitequark, 2021-03-30:
Yes, the labels of course.

electroniceel, 2021-03-30:
As this just affects the labeling and not the traces, I don't consider it urgent. I'm currently busy with other stuff, so it will take me 3 weeks or so until I'll work on it.

If someone else wants to work on this, feel free to take over this issue and send a pull request or questions.

TomKeddie, 2021-03-30:
@esden some notes here on the lvds connector that might affect the rampak (but likely not since the only differential signal is the clock which is an output from the fpga).

whitequark, 2023-10-21:
@esden Could you please check the latest revC schematic to see if that's still a problem?

whitequark, 2025-05-20:
It seems like nobody involved cares enough to fix this on revC, and revD won't have the LVDS bank, so I'm just going to leave the schematic as-is.

Closed 2025-05-20.

Thread 282 (2021-04-21):

revC2: incorrect part number for U2

festlv, 2021-04-21:
[BOM](https://github.com/GlasgowEmbedded/glasgow/blob/99b81aac282f02ec3f3cda9566d929e30f1ecef4/hardware/boards/glasgow/revC2/bom.csv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) and [schematics](https://github.com/GlasgowEmbedded/glasgow/blob/99b81aac282f02ec3f3cda9566d929e30f1ecef4/hardware/boards/glasgow/glasgow.sch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) of revC2 have the following part number for U2: CAT24M01XI-T2

That part number corresponds to SOIC-8 package, however the footprint used on board is TSSOP-8.

The correct part number should be either:
CAT24M01YI−GT3 (-40..+85 deg C) **or** CAT24M01YE−GT3 (-40..+125 deg C)

whitequark, 2021-04-22:
It should be CAT24M01YI−GT3.

Closed 2023-07-31.

Thread 283 (2021-05-16):

Test 1.2 V capable level shifters 74AXP1T45

electroniceel, 2021-05-16:
Glasgow revC devices use 74LVC1T45 level shifters for the two ports. They support a 1.65 to 5.5 V voltage range, but lack official support for 1.2 V. @attie found out that Nexperia recently released the 74AXP1T45 which supports 0.9 V to 5.5 V. This issue is about testing if 74AXP1T45 would work as a replacement for future Glasgow revisions and thus allow increasing the voltage range of the Glasgow ports.

The side of the level shifter that has the DIR pin is called "FPGA-side" in this issue and is fixed to 3.3 V. The other side is called "DUT-side" and is varied in voltage. The voltages tested on the DUT-side will be the common CMOS-levels 1.2 V, 1.8 V, 3.3 V, 5 V.

Tests to do:
- shifter driving the DUT-side, measure propagation delay between input and output, repeat with different voltage levels
- shifter receiving on the DUT-side, measure propagation delay between input and output, repeat with different voltage levels
- shifter driving the DUT-side, compare signal shape on the output, repeat with different voltage levels
- shifter receiving on the DUT-side, test max. frequency on the DUT-side the shifter can reliably forward, repeat with different voltage levels
- measure max DC drive and sink strength on the DUT-side (through the 33 Ohms resistor as on Glasgow), repeat with different voltage levels
- output shorted to GND on DUT-side, let the shifter constantly drive the short at 5V, measure temperature, check if it survives for a day (check drive strength and leakage afterwards)
- shifter with 33 Ohms in series, SP3012-06UTG TVS diodes after the resistor as on Glasgow revC2. shifter in receiving mode, slowly increase voltage on the DUT-side until either the TVS diode or the shifter dies. Repeat with new shifters and diodes, lower voltage into negative until one dies. It should be the TVS diode that dies first and thus protects the FPGA.

Repeat these test with the TI SN74LVC1T45DCK, Diodes 74LVC1T45DW and Nexperia 74AXP1T45. Also do the 1.2 V tests with the TI and Diodes parts to check how they perform outside their officially supported voltage range.

electroniceel, 2021-05-16:
Attached is the current work-in-progress state of the circuit i plan to use.
[level-shifter-comparison.pdf](https://github.com/GlasgowEmbedded/glasgow/files/6489123/level-shifter-comparison.pdf)

The AC-coupled input with the comparator is definitely overkill, but I might use this comparator for another circuit I have in mind, so I want to try it out here.

Anyone else got ideas for other tests to do or improvements to the circuit?

attie, 2021-05-16:
This looks good - thanks!

> shifter receiving on the DUT-side, test max. frequency on the DUT-side the shifter can reliably forward

I think it would be good to have this in reverse too (i.e: verify max. freq in both directions)

The schematic looks good, though on Glasgow we also have a 33R betwen the shifers and the FPGA, so I'd be tempted to include one here too, just to match the usage it as closely as possible.

electroniceel, 2021-05-16:
> > shifter receiving on the DUT-side, test max. frequency on the DUT-side the shifter can reliably forward
>
> I think it would be good to have this in reverse too (i.e: verify max. freq in both directions)

I'm actually not really sure how to measure the exact max. frequency. The common way seems to measure from when the rising signal crosses 0.5xVcc to the next rising crossing. But there doesn't seem to be a common definition how high the signal must rise in between to still be considered a stable setup. Maybe the 0.7xVcc / 0.3xVcc points used for defining the input voltages? But then there is no voltage tolerance left for parasitics between the output and input of the next stage.

So I mostly wanted to do this by comparing the waveforms of the different shifter models in the same setup. But I'm open to other suggestions.

> The schematic looks good, though on Glasgow we also have a 33R betwen the shifers and the FPGA, so I'd be tempted to include one here too, just to match the usage as closely as possible.

Good idea, I'll add a 33 Ohms on the other side too.

My signal generator maxes out at 120 MHz for square signals, while I have sine sources up to 3 GHz available. That was why I thought about adding the comparator. But after searching around a bit I'm not sure if the comparator is really the best way to supply really fast logic input signals. The ADCMP602 is the fastest I found with CMOS outputs and it still maxes out between 160 and 200 MHz. If I go to LVDS comparators, the fastest LVDS to CMOS receivers I found claim 200 MHz, e.g. ADN4662.

Nexperia claims about 619 MHz typ. max. freq for some parts in their AUP series:
https://assets.nexperia.com/documents/data-sheet/74AUP1G80.pdf
So maybe build a self oscillating circuit out of an AUP or AUC inverter and a trimmer resistor. This is not as convenient as typing in a freqency, but should still work out.

attie, 2021-05-16:
> I'm actually not really sure how to measure the exact max. frequency.

Hmm, fair point. I've not looked at the figures (IIRC there were a few missing from the new part), and I'm probably not well placed to comment much further, but...

- For our usage, I might expect that the phase shift introduced will start to become problematic before the part's max freq is reached? (should we try to measure that too, if it's not spec'd)
- Depending on how the part behaves at the higher frequencies, I'd suggest that when the signal starts to get attenuated due to bumping into the rise/fall times would be the cutoff... but as you say, that's going to be influenced by parasitics... It's a difficult one to quantify.

electroniceel, 2021-05-17:
>     * For our usage, I might expect that the phase shift introduced will start to become problematic before the part's max freq is reached?

With phase shift you mean the one between input and output of the shifter, introduced by the transition delay? Wouldn't that only become a problem with a protocol where Glasgow needs to reply in time to some external event, like in a SPI peripheral applet? An applet which just receives, like a logic analyzer or frequency counter, shouldn't be affected by that.

> (should we try to measure that too, if it's not spec'd)

I had the propagation delay on the list. But maybe we are meaning something different with phase shift.

> PS: Do we just want to verify that they'll work to (and a bit above) our current specs? You have access to 120MHz, and that will satisfy the 100 MHz Glasgow spec...?

Boo! Where is the fun in that? :smirk:

Here is an updated version of the schematics:
[level-shifter-comparison.pdf](https://github.com/GlasgowEmbedded/glasgow/files/6496577/level-shifter-comparison.pdf)

attie, 2021-05-18:
> An applet which just receives, like a logic analyzer or frequency counter, shouldn't be affected by that.

While this is true, from a usability point of view if there are certain restrictions like "_btw, don't try 2-way comms at high speeds because of phase shift / propagation delays_" might be a bit invisible / unexpected, and could cause weird behaviour for people who don't realise - especially if we quote "_works up to 100 MHz_", with a subtext / caveat of "_for one-way interfaces only_".

I wonder where our current level shifters sit on this?

> I had the propagation delay on the list. But maybe we are meaning something different with phase shift.

Ah yes, apologies.

> Boo! Where is the fun in that? 😏

🙃

electroniceel, 2021-05-18:
> While this is true, from a usability point of view if there are certain restrictions like "_btw, don't try 2-way comms at high speeds because of phase shift / propagation delays_" might be a bit invisible / unexpected, and could cause weird behaviour for people who don't realise - especially if we quote "_works up to 100 MHz_", with a subtext / caveat of "_for one-way interfaces only_".

Ah, good point. I was just thinking of measuring and comparing the shifters first, not what we will communicate as "supported" or similar in the end.

So I'd say I'll make the planned measurements and comparisons, when we have the results we'll draw conclusions on what can be considered as safe to be called supported.

> I wonder where our current level shifters sit on this?

I don't know and I haven't seen any systematic measurements (like with different voltage levels and so on) yet. I guess we'll find out when I'm done with the measurements listed above.

What I'm also interested in is how the same shifter model from different manufatcurers compare. This is why I included the I SN74LVC1T45DCK and Diodes 74LVC1T45DW in my list above.

shuffle2, 2021-11-21:
1.2v would be great to expand the existing nand support to newer versions of jedec/onfi spec. Just an anecdote as I am currently searching for a device to interface with such band and was hoping glasgow would work.

attie, 2021-11-21:
@shuffle2 is that on topic for this thread (i.e: low voltage parts), or a feature request (i.e: new parts / protocol)?

If the latter, please create a new issue. and give details about the part(s) you have in mind.

shuffle2, 2021-11-21:
I hope it was on topic for this thread :) glasgow already [has nand protocol support](https://github.com/GlasgowEmbedded/glasgow/blob/main/software/glasgow/applet/memory/onfi/__init__.py). But the DUT logic levels go down to 1.8v only. So implementing this level shifter change would enable otherwise existing functionality of glasgow to support the newer ("NV-DDR3/NV-LPDDR4") nand protocols which have 1.2v I/O levels, maybe modulo the turnaround time issues which were pointed out in previous messages.

whitequark, 2023-07-31:
This is not happening for revC (please confirm @esden) so I'm going to bump this to revD.

electroniceel, 2023-07-31:
> This is not happening for revC (please confirm @esden) so I'm going to bump this to revD.

Yes, this is more for revC4 (if we ever have one) or revD

esden, 2023-07-31:
We can definitely evaluate it for revC4, which can happen after we run out of parts for the current boards. By that time I will also know what DFM improvements to make.

whitequark, 2023-08-01:
> We can definitely evaluate it for revC4, which can happen after we run out of parts for the current boards. By that time I will also know what DFM improvements to make.

Got it. Tagged back as `revC`.

Thread 286 (2021-11-13):

applet.memory-25x: Sector parameter, doesn't update erase opcode

gregdavill, 2021-11-13:
When using the memory-25x, you have the ability to set the sector size, using the `-S` parameter.
However setting this value does not update the command that's actually sent to the flash.

By default the opcode `0x20` is sent, which (on common flashes) is a 4kB sector erase.

Most flash devices supports the 64kB sector erase, which typically executes faster, but in order to make use of this the opcode sent will need to change based on the `-S` parameter.

whitequark, 2023-10-26:
@gregdavill In case SFDP is available this is easy to handle. What is to be done if there's no SFDP data available? Should an option to specify the exact erase opcode be mandatory in this case?

gregdavill, 2023-10-26:
Using SFDP makes the most sense when it's available as a default option, it can pick the largest erase sector size based on the amount of data to write.

If an opcode is presented it should take precedence over the SFDP. (But show a WARN/INFO if SFDP is available and the opcode is not present in the SFDP)

If no SFDP is available, requiring the opcode to be provided is a good option.

whitequark, 2023-10-26:
Got it! I'll implement this soonish (and then finally take care of your other PRs.)

Thread 287 (2021-11-13):

GPIB applet

FFY00, 2021-11-13:
It would be useful to have a GPIB applet, as it would allow us to talk with lots of, mainly older, testing equipment.

whitequark, 2021-11-13:
Yeah. I've considered it; I'm not sure if I have anything around that supports GPIB.

whitequark, 2021-11-13:
If you can suggest something cheap (bonus points if it's useful) I can buy then I might just do that and implement it.

FFY00, 2021-11-13:
I really need to get started on hardware design so I can help with this stuff.

Unfortunately, I don't think I know anything super cheap, but there are many cheap-ish, for what you get at least, useful legacy gear.

I really like the HP/Agilent 66xxB lines of power supplies. They are pretty good, and you can easily put binding posts on the front (there are holes already in the front panel plastic piece and the PCB is prepared, just needs some missing jumpers). I don't know about shipping/import costs for where you are, but you can find them pretty cheap in the US, a bit more expensive for the rest of the world. Here are a couple listings in Asia:

https://www.ebay.com/itm/110943616006
https://www.ebay.com/itm/153823238670
https://www.ebay.com/itm/153283612160
https://www.ebay.com/itm/272327301175
https://www.ebay.com/itm/392242863402
https://www.ebay.com/itm/392241077278
https://www.ebay.com/itm/283952534100
https://www.ebay.com/itm/113411427377
https://www.ebay.com/itm/401709583912

Some other useful stuff:

https://www.ebay.com/itm/294203055354
https://www.ebay.com/itm/133922320443

I have just bought a Tektronix TDS744A in a lot, which can be hacked to 1GHz. That is a bit more expensive, but still could be potentially interesting.

whitequark, 2021-11-13:
All of those either can't be shipped, or have >200$ shipping...

FFY00, 2021-11-17:
😕

This is not cheap, but reasonably priced, I think, if it doesn't give you extra shipping costs.

https://www.ebay.com/itm/HP-Agilent-34401A-6-1-2-Digit-Digital-Multi-Meter-Main-Unit-Only-From-JAPAN-/384484576020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

whitequark, 2021-11-17:
Nope, can't be shipped.

whitequark, 2023-10-21:
I have several GPIB devices and am working on the GPIB controller applet with some others. This turns out to be unexpectedly tricky because *holy shit have you seen the spec?!?*

Thread 289 (2021-11-20):

Debugging a SuperH4 target (Anritsu MS2721B)

brainstorm, 2021-11-20:
While attempting repair of an [Anritsu MS2721B 6GHz "portable" spectrum analyzer](https://www.anritsu.com/en-US/test-measurement/products/ms2721b), I [mapped out the JTAG pinout](https://www.eevblog.com/forum/testgear/anritsu-ms2721b-internal-cf-card-missing/msg3732022/#msg3732022) of its main [SH4 (SH7750R) MCU](https://datasheet.octopart.com/HD6417750F167V-Renesas-datasheet-11770390.pdf) on the board.

<a href="https://www.eevblog.com/forum/testgear/anritsu-ms2721b-internal-cf-card-missing/msg3732022/#msg3732022">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</a>

For context, [the unit was working before but stopped booting up](https://blogs.nopcode.org/brainstorm/anritsu-ms2721b-spectrum-analyzer-repair-part-2/), so now I'm trying to figure out where exactly is the device halting within the (early) boot sequence.

Then I went for Glasgow to confirm the JTAG pinout and indeed, those pins are well identified:

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

```
(glasgow) rvalls@m1 glasgow % glasgow run jtag-pinout --port A --pins-jtag 1,3,5,6 -f 250 -V 1.8
I: g.device.hardware: building bitstream ID 32f2f979fe52e87384b67000968b34fa
I: g.cli: running handler for applet 'jtag-pinout'
I: g.applet.interface.jtag_pinout: port(s) A voltage set to 1.8 V
I: g.applet.interface.jtag_pinout: detecting pull resistors
I: g.applet.interface.jtag_pinout: pull-H: A1, A3, A5, A6
I: g.applet.interface.jtag_pinout: detecting TCK, TMS, and TDO
I: g.applet.interface.jtag_pinout: shifted 10 out of IR with TCK=A1 TMS=A5 TDO=A3
I: g.applet.interface.jtag_pinout: detecting TDI
I: g.applet.interface.jtag_pinout: shifted 32-bit IR with TCK=A1 TMS=A5 TDI=A6 TDO=A3
I: g.applet.interface.jtag_pinout: JTAG interface without reset detected
I: g.applet.interface.jtag_pinout: use `jtag-probe -V 1.8 --pin-tck 1 --pin-tms 5 --pin-tdi 6 --pin-tdo 3` as arguments
```

And they also spit some TAP info:

```
(glasgow) rvalls@m1 glasgow % glasgow run jtag-probe -V 1.8 --pin-tck 1 --pin-tms 5 --pin-tdi 6 --pin-tdo 3 scan
I: g.device.hardware: building bitstream ID a441e52aea68aafca8d02fa0007c27cf
I: g.cli: running handler for applet 'jtag-probe'
I: g.applet.interface.jtag_probe: port(s) A, B voltage set to 1.8 V
I: g.applet.interface.jtag_probe: shifted 1-bit DR=<0>
I: g.applet.interface.jtag_probe: shifted 32-bit IR=<10111111111111111111111111111111>
I: g.applet.interface.jtag_probe: discovered 1 TAPs
I: g.applet.interface.jtag_probe: TAP #0: IR[32] BYPASS
```

And even attempted to establish some JTAG bitbanged session for OpenOCD, similar to [my previous attempts with an ESP32S2](https://github.com/espressif/openocd-esp32/issues/135):

```
% glasgow run jtag-openocd -V 1.8 --pin-tck 1 --pin-tms 5 --pin-tdi 6 --pin-tdo 3 -f 100 -V 3.3 tcp:localhost:2222
I: g.device.hardware: building bitstream ID c850b1822f53f5fa7fc5e4ec24e21c87
I: g.cli: running handler for applet 'jtag-openocd'
I: g.applet.interface.jtag_openocd: port(s) A, B voltage set to 3.3 V
I: g.applet.interface.jtag_openocd: socket: listening at tcp:localhost:2222
I: g.applet.interface.jtag_openocd: socket: new connection from [::1]:58608

% openocd -c 'interface remote_bitbang; remote_bitbang_port 2222'
Open On-Chip Debugger 0.11.0+dev-00471-gcaa169813 (2021-11-20-01:35)
Licensed under GNU GPL v2
For bug reports, read
	http://openocd.org/doc/doxygen/bugs.html
DEPRECATED! use 'adapter driver' not 'interface'
Info : only one transport option; autoselect 'jtag'
DEPRECATED! use 'remote_bitbang port' not 'remote_bitbang_port'
Info : Listening on port 6666 for tcl connections
Info : Listening on port 4444 for telnet connections
Info : Initializing remote_bitbang driver
Info : Connecting to localhost:2222
Info : remote_bitbang driver initialized
Info : This adapter doesn't support configurable speed
Warn : There are no enabled taps.  AUTO PROBING MIGHT NOT WORK!!
Info : TAP auto0.tap does not have valid IDCODE (idcode=0xfffffffe)
Warn : AUTO auto0.tap - use "jtag newtap auto0 tap -irlen 2 -expected-id 0x00000000"
Warn : gdb services need one or more targets defined
```

But then after [scanning OpenOCD for suitable targets](https://github.com/openocd-org/openocd/tree/master/tcl/target), I couldn't find any SuperH4 related ones. So I went back to the [datasheet linked above](https://datasheet.octopart.com/HD6417750F167V-Renesas-datasheet-11770390.pdf) and sections 20 and 21 describe what seems to be a customization (extension?) of JTAG called **"H-UDI"** (and its debugging support called **"UBC"**).

Also there seem to be [some 12-y.o dead end threads on renesasrulz.com regarding BDSL availability for those targets](https://renesasrulz.com/other_products/sh_family/f/sh-family---forum/2824/h-udi-jtag).

Is there somebody experienced with this target within this community? Is there any prior art of OSS tooling for SH4 that somebody can point me to?

Closed 2021-11-20.

Thread 292 (2022-04-13):

Running glasgow applets fails on first try after device plug-in

thasti, 2022-04-13:
On recent ArchLinux (Kernel 5.6.13), glasgow fails to run any applet on the first invocation of `glasgow run` after connecting the device to USB.  The error message is the following:

```
[thasti@nyan microbeam]$ glasgow run ...

Traceback (most recent call last):
  File "/home/thasti/.local/bin/glasgow", line 33, in <module>
    sys.exit(load_entry_point('glasgow', 'console_scripts', 'glasgow')())
  File "/home/thasti/projekte/glasgow/glasgow/software/glasgow/cli.py", line 857, in main
    exit(loop.run_until_complete(_main()))
  File "/usr/lib/python3.10/asyncio/base_events.py", line 641, in run_until_complete
    return future.result()
  File "/home/thasti/projekte/glasgow/glasgow/software/glasgow/cli.py", line 470, in _main
    device = GlasgowHardwareDevice(args.serial)
  File "/home/thasti/projekte/glasgow/glasgow/software/glasgow/device/hardware.py", line 179, in __init__
    devices = self._enumerate_devices(usb_context, _factory_rev)
  File "/home/thasti/projekte/glasgow/glasgow/software/glasgow/device/hardware.py", line 107, in _enumerate_devices
    handle = device.open()
  File "/home/thasti/.local/lib/python3.10/site-packages/libusb1-3.0.0-py3.10.egg/usb1/__init__.py", line 2055, in open
    mayRaiseUSBError(libusb1.libusb_open(self.device_p, byref(handle)))
  File "/home/thasti/.local/lib/python3.10/site-packages/libusb1-3.0.0-py3.10.egg/usb1/__init__.py", line 127, in mayRaiseUSBError
    __raiseUSBError(value)
  File "/home/thasti/.local/lib/python3.10/site-packages/libusb1-3.0.0-py3.10.egg/usb1/__init__.py", line 119, in raiseUSBError
    raise __STATUS_TO_EXCEPTION_DICT.get(value, __USBError)(value)
usb1.USBErrorNoDevice: LIBUSB_ERROR_NO_DEVICE [-4]
```

This error message coincides with a re-enumeration of the device in dmesg:

```
[397361.999956] usb 2-2: USB disconnect, device number 94
[397362.290842] usb 2-2: new high-speed USB device number 95 using xhci_hcd
[397362.433003] usb 2-2: New USB device found, idVendor=20b7, idProduct=9db1, bcdDevice= 1.31
[397362.433017] usb 2-2: New USB device strings: Mfr=1, Product=2, SerialNumber=3
[397362.433023] usb 2-2: Product: Glasgow Debug Tool
[397362.433027] usb 2-2: Manufacturer: whitequark research
[397362.433031] usb 2-2: SerialNumber: C1-20200924T000714Z
```

Any further attempts at running applets work just fine every time, however the issue can be reproduced (on multiple machines here) by disconnecting and reconnecting the device.

attie, 2022-04-13:
Where did your Glasgow come from? (self build / me?)

Please could you try running the following?

```
glasgow flash
```

thasti, 2022-04-16:
Hi Attie. This indeed is one from the batch you made. I confirm that after running `glasgow flash`, the issue disappears. Now, the glasgow already enumerates fully (i.e. as `Glasgow Debug Tool`) on the initial plug-in - not only after launching the `glasgow run` command.

So now I'm not sure if "device is being used without firmware in flash" is a valid use case or not, and therefore whether this issue is actually one or not.

attie, 2022-04-16:
Thanks for confirming - I tried to be careful and flash all boards, so I'm surprised you needed to do that step.... my apologies either way.

This is a valid use-case, and it should load firmware and "just work" on the first run... I have a feeling there is already a ticket about this, so I'll look through later and link / close as necessary.

attie, 2022-04-16:
This seems to be similar in behaviour to / the same as #239...

whitequark, 2022-04-16:
On Linux, Glasgow uses hotplug detection since it's available in libusb, so #239 shouldn't apply...

whitequark, 2023-07-24:
To investigate this further I would need verbose logs from `glasgow -vvv` and also timestamped `dmesg`. Let me know if this is something you can still reproduce, please.

whitequark, 2023-10-06:
No response from reporter for a few months; closing.

Closed 2023-10-06.

Thread 298 (2022-12-17):

Synthesis for `jtag-probe` fails with latest YoWASP Yosys

VioletEternity, 2022-12-17:
Using `yowasp-yosys 0.23.dev444` (the version that is installed with no additional action taken), synthesis fails when running as a part of `glasgow build --rev C2 jtag-probe`:
```
(beginning of log omitted)
2.4. Executing FLATTEN pass (flatten design).
<suppressed ~6 debug messages>
ERROR: Cell port out_fifo_0.inner.$2 is driving constant bits: { 7'0000000 \inner_None$8 } <= { 7'0000000 $flatten\inner.$1 }
```
The archive with the build tree is attached here: [glasgow_sm98_a5s.zip](https://github.com/GlasgowEmbedded/glasgow/files/10250283/glasgow_sm98_a5s.zip)

Also, it would be nice if the `debug` argument of `BuildPlan.execute` would be settable from the command line. I had to apply the following diff to retain the build tree above:
```
diff --git a/software/glasgow/cli.py b/software/glasgow/cli.py
index f401033..ecc86f1 100644
--- a/software/glasgow/cli.py
+++ b/software/glasgow/cli.py
@@ -770,7 +770,7 @@ async def _main():
                 logger.info("building bitstream for applet %r", args.applet)
                 with open(args.filename or args.applet + ".bin", "wb") as f:
                     f.write(plan.bitstream_id)
-                    f.write(plan.execute())
+                    f.write(plan.execute(debug=True))

         if args.action == "test":
             logger.info("testing applet %r", args.applet)
```

VioletEternity, 2022-12-17:
It also fails, with the same error, as far back as `yowasp-yosys 0.9.post5623.dev231`, so the issue might not be Yosys version dependent.

whitequark, 2022-12-17:
Looks like the `build_top.sh` file, when generated on Windows, is written with CRLF line endings, and so sh doesn't run it. I've filed this as https://github.com/amaranth-lang/amaranth/issues/732.

whitequark, 2022-12-17:
Other than that, I can reproduce the issue with the archive you attached, but not with Glasgow installed in a fresh venv on Linux. Can you describe your environment in more detail?

VioletEternity, 2022-12-17:
I'm using `Python 3.11.1 (tags/v3.11.1:a7a450f, Dec  6 2022, 19:58:39) [MSC v.1934 64 bit (AMD64)] on win32`. The output of `pip freeze` is:
```
aiohttp==3.8.3
aiosignal==1.3.1
amaranth==0.3
amaranth-yosys==0.10.0.dev47
appdirs==1.4.4
async-timeout==4.0.2
attrs==22.1.0
bitarray==2.6.0
charset-normalizer==2.1.1
crcmod==1.7
frozenlist==1.3.3
fx2==0.9
-e git+https://github.com/GlasgowEmbedded/glasgow@b8051ad39cf608cf52adf6111892d9510b4420ab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
idna==3.4
Jinja2==2.11.3
libusb1==3.0.0
MarkupSafe==1.1.1
multidict==6.0.3
pyvcd==0.2.4
wasmtime==0.30.0
yarl==1.8.2
yowasp-nextpnr-ice40==0.4.post25.dev361
yowasp-yosys==0.23.dev444
```

whitequark, 2022-12-17:
After removing the `src` attributes, it looks like there is some difference in the IL where wires end up with internal `$`-names rather than `\\`-names:

```diff
@@ -60,8 +60,8 @@
       update \stage1 \stage1$next
   end
   process $group_2
-    assign $1 1'0
-    assign $1 \stage1
+    assign \sda_i 1'0
+    assign \sda_i \stage1
     sync init
   end
 end
```

This is likely to affect the `flatten` pass. The reason names end up missing are probably bytecode changes in Python 3.11. Can you recheck with 3.9 or 3.10?

VioletEternity, 2022-12-17:
I get a different crash with `Python 3.10.9 (tags/v3.10.9:1dd9be6, Dec  6 2022, 20:01:21) [MSC v.1934 64 bit (AMD64)] on win32` and YoWASP Yosys:
```
I: glasgow.cli: building bitstream for applet 'jtag-probe'
ERROR: Assert `ofs.is_open()' failed in ../yosys-src/passes/techmap/abc9_ops.cc:950.
I: glasgow.target.hardware: keeping build tree as C:\Users\Maya\AppData\Local\Temp\glasgow_lfow7thr
Traceback (most recent call last):
  File "C:\Users\Maya\AppData\Local\Programs\Python\Python310\lib\runpy.py", line 196, in _run_module_as_main
    return _run_code(code, main_globals, None,
  File "C:\Users\Maya\AppData\Local\Programs\Python\Python310\lib\runpy.py", line 86, in _run_code
    exec(code, run_globals)
  File "C:\Users\Maya\Desktop\glasgow\software\glasgow\cli.py", line 861, in <module>
    main()
  File "C:\Users\Maya\Desktop\glasgow\software\glasgow\cli.py", line 857, in main
    exit(loop.run_until_complete(_main()))
  File "C:\Users\Maya\AppData\Local\Programs\Python\Python310\lib\asyncio\base_events.py", line 649, in run_until_complete
    return future.result()
  File "C:\Users\Maya\Desktop\glasgow\software\glasgow\cli.py", line 773, in _main
    f.write(plan.execute(debug=True))
  File "C:\Users\Maya\Desktop\glasgow\software\glasgow\target\hardware.py", line 118, in execute
    products  = self.lower.execute_local(build_dir)
  File "C:\Users\Maya\AppData\Local\Programs\Python\Python310\lib\site-packages\amaranth\build\run.py", line 96, in execute_local
    subprocess.check_call(["cmd", "/c", "call {}.bat".format(self.script)])
  File "C:\Users\Maya\AppData\Local\Programs\Python\Python310\lib\subprocess.py", line 369, in check_call
    raise CalledProcessError(retcode, cmd)
subprocess.CalledProcessError: Command '['cmd', '/c', 'call build_top.bat']' returned non-zero exit status 1.
```

The output of `pip freeze` is:
```
aiohttp==3.8.3
aiosignal==1.3.1
amaranth==0.3
amaranth-yosys==0.10.0.dev47
appdirs==1.4.4
async-timeout==4.0.2
attrs==22.1.0
bitarray==2.6.0
charset-normalizer==2.1.1
crcmod==1.7
frozenlist==1.3.3
fx2==0.9
-e git+https://github.com/GlasgowEmbedded/glasgow@b8051ad39cf608cf52adf6111892d9510b4420ab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
idna==3.4
Jinja2==2.11.3
libusb1==3.0.0
MarkupSafe==1.1.1
multidict==6.0.3
pyvcd==0.2.4
wasmtime==0.30.0
yarl==1.8.2
yowasp-nextpnr-ice40==0.4.post25.dev361
yowasp-yosys==0.23.dev444
```

The archive with the build tree is attached here:
[glasgow_lfow7thr.zip](https://github.com/GlasgowEmbedded/glasgow/files/10250432/glasgow_lfow7thr.zip)

whitequark, 2022-12-17:
I can build a bitstream with the build tree from `glasgow_lfow7thr.zip` on Linux, so it looks like there are at least three bugs here:
 1. Amaranth not inferring names for signals properly on Python 3.11;
 2. Yosys `flatten` pass failing to process the netlist Amaranth generates;
 3. whatever the fuck is wrong with abc from yowasp that makes it die with a `Assert `ofs.is_open()' failed in ../yosys-src/passes/techmap/abc9_ops.cc:950.`
 4. oh and there's the CRLF issue that I already filed an Amaranth bug for.

Sigh...

whitequark, 2022-12-17:
Hey @mwkmwkmwk, can you please take a look at the netlist in [glasgow_sm98_a5s.zip](https://github.com/GlasgowEmbedded/glasgow/files/10250283/glasgow_sm98_a5s.zip) please and say if there's a reason the `flatten` pass should be failing on it?

whitequark, 2022-12-17:
> * whatever the fuck is wrong with abc from yowasp that makes it die with a `` Assert `ofs.is_open()' failed in ../yosys-src/passes/techmap/abc9_ops.cc:950. ``

It looks like abc is failing to write a LUT library:

```
void write_lut(RTLIL::Module *module, const std::string &dst) {
	std::ofstream ofs(dst);
	log_assert(ofs.is_open());
	ofs << module->design->scratchpad_get_string("abc9_ops.lut_library");
	ofs.close();
}
```
Probably because the path is wrong or something?

mwkmwkmwk, 2022-12-20:
> Hey @mwkmwkmwk, can you please take a look at the netlist in [glasgow_sm98_a5s.zip](https://github.com/GlasgowEmbedded/glasgow/files/10250283/glasgow_sm98_a5s.zip) please and say if there's a reason the `flatten` pass should be failing on it?

Amaranth is using `$13` as an autogenerated port name. Unfortunately, yosys has the convention that ports called `$<number>"`are actually positional parameters, so cell port called `$13` will actually bind to, say, `wire width 4 input 13 \fx2_0__flag__i1`.

I highly suggest choosing a different naming convention.

mwkmwkmwk, 2022-12-20:
Oh, and by the way, this only happens when the `$<number>` actually happens to be a valid port number — you may get lucky if the autogenerated name is high enough.

whitequark, 2022-12-20:
That is incredibly cursed.

mwkmwkmwk, 2022-12-20:
> I can build a bitstream with the build tree from `glasgow_lfow7thr.zip` on Linux, so it looks like there are at least three bugs here:
>
> 1. Amaranth not inferring names for signals properly on Python 3.11;

The version of amaranth here seems to be 0.3, which is earlier than 851546bf2d16db62663d7002bece51f07078d0a5 that adds Python 3.11 support — could you retest with current git main?

VioletEternity, 2022-12-20:
I've retested with Amaranth version 0.4.dev36+ge3b2ba4` (installed via `pip install git+https://github.com/amaranth-lang/amaranth.git`); `glasgow build --rev C2 jtag-probe` succeeds with yowasp-yosys version 0.23.dev444.

whitequark, 2023-01-31:
Of issues described in https://github.com/GlasgowEmbedded/glasgow/issues/298#issuecomment-1355933818:

- (1) was already fixed upstream;
- (2) is an Amaranth issue that was fixed upstream;
- (3) is a consequence of (2), probably because there's a comb loop or something;
- (4) isn't a cause of bugs here and is tracked upstream.

I think this is done now. Thanks for the report.

whitequark, 2023-01-31:
@mwkmwkmwk So I've never actually aimed to create ports with `$\d+` names, it was an invariant violation elsewhere.

Closed 2023-01-31.

Thread 301 (2023-02-03):

ImportError: cannot import name 'soft_unicode' from 'markupsafe'

jeremyherbert, 2023-02-03:
When running the `glasgow` executable for the first time after install, I get the following error:

```
$ glasgow
Traceback (most recent call last):
  File "/home/jeremy/.local/bin/glasgow", line 33, in <module>
    sys.exit(load_entry_point('glasgow', 'console_scripts', 'glasgow')())
  File "/home/jeremy/.local/bin/glasgow", line 25, in importlib_load_entry_point
    return next(matches).load()
  File "/usr/lib/python3.10/importlib/metadata/__init__.py", line 171, in load
    module = import_module(match.group('module'))
  File "/usr/lib/python3.10/importlib/__init__.py", line 126, in import_module
    return _bootstrap._gcd_import(name[level:], package, level)
  File "<frozen importlib._bootstrap>", line 1050, in _gcd_import
  File "<frozen importlib._bootstrap>", line 1027, in _find_and_load
  File "<frozen importlib._bootstrap>", line 1006, in _find_and_load_unlocked
  File "<frozen importlib._bootstrap>", line 688, in _load_unlocked
  File "<frozen importlib._bootstrap_external>", line 883, in exec_module
  File "<frozen importlib._bootstrap>", line 241, in _call_with_frames_removed
  File "/home/jeremy/Downloads/glasgow/software/glasgow/cli.py", line 26, in <module>
    from .target.hardware import GlasgowHardwareTarget
  File "/home/jeremy/Downloads/glasgow/software/glasgow/target/hardware.py", line 8, in <module>
    from amaranth.build import ResourceError
  File "/home/jeremy/.local/lib/python3.10/site-packages/amaranth/build/__init__.py", line 3, in <module>
    from .plat import *
  File "/home/jeremy/.local/lib/python3.10/site-packages/amaranth/build/plat.py", line 6, in <module>
    import jinja2
  File "/home/jeremy/.local/lib/python3.10/site-packages/jinja2/__init__.py", line 12, in <module>
    from .environment import Environment
  File "/home/jeremy/.local/lib/python3.10/site-packages/jinja2/environment.py", line 25, in <module>
    from .defaults import BLOCK_END_STRING
  File "/home/jeremy/.local/lib/python3.10/site-packages/jinja2/defaults.py", line 3, in <module>
    from .filters import FILTERS as DEFAULT_FILTERS  # noqa: F401
  File "/home/jeremy/.local/lib/python3.10/site-packages/jinja2/filters.py", line 13, in <module>
    from markupsafe import soft_unicode
ImportError: cannot import name 'soft_unicode' from 'markupsafe' (/home/jeremy/.local/lib/python3.10/site-packages/markupsafe/__init__.py)
```

It appears that `markupsafe` needs to be pinned to 2.0.1 as they have removed this functionality: https://github.com/aws/aws-sam-cli/issues/3661

jeremyherbert, 2023-02-03:
After running `pip3 install --force-reinstall MarkupSafe==2.0.1` the `glasgow` command works.

whitequark, 2023-02-03:
This is an upstream issue, https://github.com/amaranth-lang/amaranth/issues/718.

whitequark, 2023-02-07:
I think this should be coincidentally fixed by 386a7b8fd5084f29da0d9a9b435cb7a53477ba45 since now pip will install the git revision of Amaranth.

daquintero, 2023-08-17:
Cheers for all the great work @whitequark ! Worth mentioning that the https://github.com/GlasgowEmbedded/glasgow/commit/386a7b8fd5084f29da0d9a9b435cb7a53477ba45 fix for the upstream pypi installation `amaranth @ git+https://github.com/amaranth-lang/amaranth.git` has not been propagated to pypi as it still is pinned to the old 0.3v without this fix.

whitequark, 2023-08-17:
> Worth mentioning that the [386a7b8](https://github.com/GlasgowEmbedded/glasgow/commit/386a7b8fd5084f29da0d9a9b435cb7a53477ba45) fix for the upstream pypi installation `amaranth @ git+https://github.com/amaranth-lang/amaranth.git` has not been propagated to pypi as it still is pinned to the old 0.3v without this fix.

I do not understand what you are saying here.

attie, 2023-08-20:
I think @daquintero is referring to [amaranth on PyPi](https://pypi.org/project/amaranth/#history).

@daquintero, it's worth noting, that the `name @ repo` syntax will install the package from the git repo, and not from PyPi, so while PyPi has v0.3 listed, it'll actually be installing from the [Amaranth repo](https://github.com/amaranth-lang/amaranth) directly.

Closed 2023-02-07.

Thread 303 (2023-02-06):

jtag-openocd behaviour doesn't match jtag-svf

jeremyherbert, 2023-02-06:
Apologies in advance if this is an upstream bug in openocd or ecppack.

I have an SVF file which is just a blinky for an ECP5 (LFE5U-12F) FPGA built with ecppack. If I use the `jtag-svf` applet, it loads on the FPGA fine:

```
$ glasgow run jtag-svf -M --port A --pin-tck 0 --pin-tms 3 --pin-tdi 2 --pin-tdo 1 blink.svf
I: g.device.hardware: building bitstream ID baa3e836c8b20784cde3bbff3b5fe82e
/home/jeremy/oss-cad-suite/bin/nextpnr-ice40: line 22: /home/jeremy/.config/yosyshq/fonts.conf: No such file or directory
I: g.cli: running handler for applet 'jtag-svf'
I: g.applet.interface.jtag_svf: port A voltage set to 3.3 V
W: g.applet.interface.jtag_svf: SVF: test vector did not reset DUT explicitly, resetting
```

However, if I try to use the `jtag-openocd` applet with the following configuration file:

```
adapter driver remote_bitbang
remote_bitbang port 33333
remote_bitbang host localhost

reset_config none separate

jtag newtap ecp5 tap -irlen 8 -expected-id 0x21111043

init
scan_chain
svf -tap ecp5.tap -quiet -progress blink.svf
shutdown
```

the FPGA does actually load the bitstream and start running (I can see the blinking LEDs), but openocd throws an error:

```
$ glasgow run jtag-openocd -M --port A --pin-tck 0 --pin-tms 3 --pin-tdi 2 --pin-tdo 1 tcp:localhost:33333
I: g.device.hardware: building bitstream ID b6ca43076c531bba087e54cd1f647cdb
/home/jeremy/oss-cad-suite/bin/nextpnr-ice40: line 22: /home/jeremy/.config/yosyshq/fonts.conf: No such file or directory
I: g.cli: running handler for applet 'jtag-openocd'
I: g.applet.interface.jtag_openocd: port A voltage set to 3.3 V
I: g.applet.interface.jtag_openocd: socket: listening at tcp:localhost:33333
I: g.applet.interface.jtag_openocd: socket: new connection from [127.0.0.1]:51492
I: g.applet.interface.jtag_openocd: socket: connection from [127.0.0.1]:51492 lost
```

```
$ openocd -f flash.ocd
Open On-Chip Debugger 0.12.0+dev-00059-g0b6f53e94-dirty (2023-01-29-02:08)
Licensed under GNU GPL v2
For bug reports, read
	http://openocd.org/doc/doxygen/bugs.html
Info : only one transport option; autoselecting 'jtag'
Info : Initializing remote_bitbang driver
Info : Connecting to localhost:33333
Info : remote_bitbang driver initialized
Info : Note: The adapter "remote_bitbang" doesn't support configurable speed
Info : JTAG tap: ecp5.tap tap/device found: 0x21111043 (mfg: 0x021 (Lattice Semi.), part: 0x1111, ver: 0x2)
Warn : gdb services need one or more targets defined
svf processing file: "blink.svf"
95%    Error: tdo check error at line 28
Error:     READ = 0x6401e10
Error:     WANT = 0x0000000
Error:     MASK = 0x000b000
Time used: 0m16s183ms

svf file programmed failed
Info : remote_bitbang interface quit
```

Presumably there isn't anything wrong with the SVF file because the `jtag-svf` applet works fine - unless there are some SVF lines that are skipped in the `jtag-svf` applet.

[blink.svf.txt](https://github.com/GlasgowEmbedded/glasgow/files/10661891/blink.svf.txt) (.txt extension added to allow it to be uploaded)

jeremyherbert, 2023-02-06:
Hmm, I’m thinking this is because there is no openocd remote_bitbang command for a delay. The glasgow server is accepting packets as fast as possible, and so the delay in data packets is not transferred to the device due to the fact that the output data rate of the FPGA is slower than the input data rate from the USB interface.

jeremyherbert, 2023-02-07:
Indeed, that appears to be the issue. Something like this appears to fix the problem: https://review.openocd.org/c/openocd/+/7472

Basically, it just adds two commands to delay either 1ms or 1us. If the patch is accepted, then it should be straightforward to add some delays to the JTAG applet I think.

whitequark, 2023-02-07:
I wonder if maybe applying backpressure to the bitbang source is actually the correct approach here? Can we do this?

jeremyherbert, 2023-02-07:
I thought about this (both with some sort of XON/XOFF and a ‘checkpoint’ handshake at points in SVF execution), but I can’t think of a good way to send the back pressure indication to openocd without increasing the complexity of the remote_bitbang protocol (which I don’t think will fly). As I understand it, the original intention for the protocol was for use with simulations, so they probably want to keep it as simple as possible.

Though, I think there is no reason that Glasgow needs to utilise the functionality in the linked patch - perhaps a different way would be more suitable given the extreme flexibility of the hardware. I mostly put the patch together to confirm that was indeed the problem, and also because I’d like to use it with another non-Glasgow device. For this applet, I think that maybe long term it would be better to use/create another adapter in openocd that also allows one to set the clock rate and maybe some other options - this could also include back pressure indication.

whitequark, 2023-02-07:
LGTM on adding support for this specific interface to `jtag-openocd`.

whitequark, 2023-10-21:
The upstream continues being unresponsive for seemingly no reason. :(

whitequark, 2023-12-17:
This has now been merged upstream: https://review.openocd.org/c/openocd/+/7472

jeremyherbert, 2024-03-31:
See also https://review.openocd.org/c/openocd/+/8191

whitequark, 2024-06-27:
@jeremyherbert I think this should be fixed now--could you retest please?

jeremyherbert, 2024-07-02:
I tried running the following command with the SVF file in the original post:

```
glasgow run jtag-svf -V 3.3 --port A --pin-tck 0 --pin-tms 3 --pin-tdi 2 --pin-tdo 1 blink.svf
```

But I receive the error:

```
I: g.device.hardware: device already has bitstream ID 62239ba31f7697d2809a2646248c966a
I: g.cli: running handler for applet 'jtag-svf'
I: g.applet.interface.jtag_svf: port(s) A voltage set to 3.3 V
Traceback (most recent call last):
  File "/home/jeremy/.local/bin/glasgow", line 8, in <module>
    sys.exit(run_main())
  File "/home/jeremy/Downloads/glasgow/software/glasgow/cli.py", line 939, in run_main
    exit(asyncio.new_event_loop().run_until_complete(main()))
  File "/usr/lib/python3.10/asyncio/base_events.py", line 649, in run_until_complete
    return future.result()
  File "/home/jeremy/Downloads/glasgow/software/glasgow/cli.py", line 707, in main
    return applet_task.result()
  File "/home/jeremy/Downloads/glasgow/software/glasgow/cli.py", line 656, in run_applet
    return await applet.interact(device, args, iface)
  File "/home/jeremy/Downloads/glasgow/software/glasgow/applet/interface/jtag_svf/__init__.py", line 294, in interact
    await coro
  File "/home/jeremy/Downloads/glasgow/software/glasgow/applet/interface/jtag_svf/__init__.py", line 120, in svf_state
    path = {
KeyError: (<JTAGState.UNKNOWN: 'Unknown'>, <JTAGState.IDLE: 'Run-Test/Idle'>)
```

I also tried with a freshly compiled openocd and the openocd config file above:

```
Open On-Chip Debugger 0.12.0+dev-00634-g23c33e1d3 (2024-07-02-17:11)
Licensed under GNU GPL v2
For bug reports, read
	http://openocd.org/doc/doxygen/bugs.html
Info : auto-selecting first available session transport "jtag". To override use 'transport select <transport>'.
Info : Initializing remote_bitbang driver
Info : Connecting to localhost:33333
Info : remote_bitbang driver initialized
Info : Note: The adapter "remote_bitbang" doesn't support configurable speed
Info : JTAG tap: ecp5.tap tap/device found: 0x41111043 (mfg: 0x021 (Lattice Semi.), part: 0x1111, ver: 0x4)
Warn : JTAG tap: ecp5.tap       UNEXPECTED: 0x41111043 (mfg: 0x021 (Lattice Semi.), part: 0x1111, ver: 0x4)
Error: JTAG tap: ecp5.tap  expected 1 of 1: 0x21111043 (mfg: 0x021 (Lattice Semi.), part: 0x1111, ver: 0x2)
Error: Trying to use configured scan chain anyway...
Warn : Bypassing JTAG setup events due to errors
Warn : gdb services need one or more targets defined
svf processing file: "blink.svf"
  0%  HDR	0;
(Above Padding command skipped, as per -tap argument)
  0%  HIR	0;
(Above Padding command skipped, as per -tap argument)
  0%  TDR	0;
(Above Padding command skipped, as per -tap argument)
  0%  TIR	0;
(Above Padding command skipped, as per -tap argument)
  0%  ENDDR	DRPAUSE;
  0%  ENDIR	IRPAUSE;
  0%  STATE	IDLE;
  0%  SIR	8	TDI  (E0);
  0%  			MASK (FFFFFFFF);
  0%  SIR	8	TDI  (1C);
  0%  				FFFFFFFFFFFFFFFFFFFFFFFFFFFFFFFFFFFFFFFFFFFFFFFF);
  0%  SIR	8	TDI  (C6);
  0%  SDR	8	TDI  (00);
  0%  RUNTEST	IDLE	2 TCK	1.00E-02 SEC;
  0%  SIR	8	TDI  (0E);
  0%  SDR	8	TDI  (01);
  0%  RUNTEST	IDLE	2 TCK	1.00E-02 SEC;
  0%  SIR	8	TDI  (3C);
  0%  			MASK (0000B000);
  0%  SIR	8	TDI  (46);
  0%  SDR	8	TDI  (01);
  0%  RUNTEST	IDLE	2 TCK	1.00E-02 SEC;
  0%  SIR	8	TDI  (7A);
  0%  RUNTEST	IDLE	2 TCK	1.00E-02 SEC;
  0%  			0000DCFFFFFFFFCDBDFFFFFF006CAC4C82E24282C21CB4624C8CB4AAACA26232045C2E4E860A00FF);
  0%  			00FF173300000000000000000000FF173300000000000000000000FF173300000000000000000000);
  0%  			FF173300000000000000000000FF173300000000000000000000FF173300000000000000000000FF);
  5%  			173300000000000000000000FF173300000000000000000000FF173300000000000000000000FF17);
  5%  			000000000000000000FF173300000000000000000000FF173300000000000000000000FF17330000);
  5%  			0000000000000000FF173300000000000000000000FF173300000000000000000000FF1733000000);
  5%  			000000000000FF173300000000000000000000FF173300000000000000000000FF17330000000000);
  5%  			00000000FF173300000000000000000000FF173300000000000000000000FF173300000000000000);
 10%  			000000FF173300000000000000000000FF173300000000000000000000FF17330000000000000000);
 10%  			00FF173300000000000000000000FF173300000000000000000000FF173300000000000000000000);
 10%  			173300000000000000000000FF173300000000000000000000FF173300000000000000000000FF17);
 10%  			3300000000000000000000FF173300000000000000000000FF173300000000000000000000FF1733);
 10%  			00000000000000000000FF173300000000000000000000FF173300000000000000000000FF173300);
 15%  			0000000000000000FF173300000000000000000000FF173300000000000000000000FF1733000000);
 15%  			000000000000FF173300000000000000000000FF173300000000000000000000FF17330000000000);
 15%  			0000000000FF173300000000000000000000FF173300000000000000000000FF1733000000000000);
 15%  			000000FF173300000000000000000000FF173300000000000000000000FF17330000000000000000);
 15%  			00FF173300000000000000000000FF173300000000000000000000FF173300000000000000000000);
 20%  			173300000000000000000000FF173300000000000000000000FF173300000000000000000000FF17);
 20%  			3300000000000000000000FF173300000000000000000000FF173300000000000000000000FF1733);
 20%  			000000000000000000FF173300000000000000000000FF173300000000000000000000FF17330000);
 20%  			00000000000000FF173300000000000000000000FF173300000000000000000000FF173300000000);
 20%  			000000000000FF173300000000000000000000FF173300000000000000000000FF17330000000000);
 25%  			00000000FF173300000000000000000000FF173300000000000000000000FF173300000000000000);
 25%  			000000FF173300000000000000000000FF173300000000000000000000FF17330000000000000000);
 25%  			00FF173300000000000000000000FF173300000000000000000000FF173300000000000000000000);
 25%  			0000000000000000FF173300000000000000000000FFF4220000000000000000000A40FF17330000);
 25%  			0000FF173300000000000000000000FF173300000000000000000000FF1733000000000000000000);
 25%  			00000000000000FF173300000000000000000000FF173300000000000000000000FF173300000000);
 30%  			173300000000000000000000FFD5360080000000000000000000FF173300000000000000000000FF);
 30%  			000000000000FFF4220000000000000000000A40FF173300000000000000000000FF173300000000);
 30%  			00000000000000000000FF173300000000000000000000FF173300000000000000000000FF173300);
 30%  			00000000FF173300000000000000000000FF173300000000000000000000FF173300000000000000);
 30%  			000000FF173300000000000000000000FF173300000000000000000000FF17330000000000000000);
 35%  			000000000000FF173300000000000000000000FF173300000000000000000000FF17330000000000);
 35%  			00FFF4220000000000000000000A40FFF4220000000000000000000A40FFF4220000000000000000);
 35%  			000000000000FF173300000000000000000000FF173300000000000000000000FF17330000000000);
 35%  			000000000000FFF4220000000000000000000A40FFF4220000000000000000000A40FFF422000000);
 35%  			0000000000FF173300000000000000000000FF173300000000000000000000FF1733000000000000);
 40%  			0000000000000000FF173300000000000000000000FF173300000000000000000000FF1733000000);
 40%  			00000000FF173300000000000000000000FF173300000000000000000000FF173300000000000000);
 40%  			00000000000000FF173300000000000000000000FF173300000000000000000000FF173300000000);
 40%  			00000000000000000000FF173300000000000000000000FF173300000000000000000000FF173300);
 40%  			0000000000000000FF173300000000000000000000FF173300000000000000000000FF1733000000);
 45%  			00000000000000FF173300000000000000000000FF173300000000000000000000FF173300000000);
 45%  			00000000FF173300000000000000000000FF173300000000000000000000FF173300000000000000);
 45%  			173300000000000000000000FF173300000000000000000000FF173300000000000000000000FF17);
 45%  			0000000000000000FF173300000000000000000000FFD5360080000000000000000000FF17330000);
 45%  			00000000FF173300000000000000000000FF173300000000000000000000FF173300000000000000);
 50%  			000000FF173300000000000000000000FF173300000000000000000000FF17330000000000000000);
 50%  			00FF173300000000000000000000FF173300000000000000000000FF173300000000000000000000);
 50%  			FF173300000000000000000000FF173300000000000000000000FF173300000000000000000000FF);
 50%  			3300000000000000000000FF173300000000000000000000FF173300000000000000000000FF1733);
 50%  			000000000000000000FF173300000000000000000000FF173300000000000000000000FF17330000);
 55%  			00000000000000FF173300000000000000000000FF173300000000000000000000FF173300000000);
 55%  			000000000000FF173300000000000000000000FF173300000000000000000000FF17330000000000);
 55%  			00000000000000000000FF173300000000000000000000FF173300000000000000000000FF173300);
 55%  			FF173300000000000000000000FF173300000000000000000000FF173300000000000000000000FF);
 55%  			173300000000000000000000FF173300000000000000000000FF173300000000000000000000FF17);
 60%  			00000000000000000000FF173300000000000000000000FF173300000000000000000000FF173300);
 60%  			0000000000000000FF173300000000000000000000FF173300000000000000000000FF1733000000);
 60%  			000000000000FF173300000000000000000000FF173300000000000000000000FF17330000000000);
 60%  			0000000000FF173300000000000000000000FF173300000000000000000000FF1733000000000000);
 60%  			000000FF173300000000000000000000FF173300000000000000000000FF17330000000000000000);
 65%  			0000FF173300000000000000000000FF173300000000000000000000FF1733000000000000000000);
 65%  			FF173300000000000000000000FFD5360080000000000000000000FF173300000000000000000000);
 65%  			173300000000000000000000FF173300000000000000000000FF173300000000000000000000FF17);
 65%  			00000000000000000000FF173300000000000000000000FF173300000000000000000000FF173300);
 65%  			0000000000000000FF173300000000000000000000FF173300000000000000000000FF1733000000);
 70%  			00000000000000FF173300000000000000000000FF173300000000000000000000FF173300000000);
 70%  			0000000000FF173300000000000000000000FF173300000000000000000000FF1733000000000000);
 70%  			000000FF173300000000000000000000FF173300000000000000000000FF17330000000000000000);
 70%  			00FF173300000000000000000000FF173300000000000000000000FF173300000000000000000000);
 70%  			FF173300000000000000000000FF173300000000000000000000FF173300000000000000000000FF);
 75%  			3300000000000000000000FF173300000000000000000000FF173300000000000000000000FF1733);
 75%  			000000000000000000FF173300000000000000000000FF173300000000000000000000FF17330000);
 75%  			0000FF173300000000000000000000FF173300000000000000000000FF1733000000000000000000);
 75%  			00FF173300000000000000000000FF173300000000000000000000FF173300000000000000000000);
 75%  			173300000000000000000000FF173300000000000000000000FF173300000000000000000000FF17);
 80%  			00000000000000000000FF173300000000000000000000FF173300000000000000000000FF173300);
 80%  			000000000000000000FF173300000000000000000000FF173300000000000000000000FF17330000);
 80%  			00000000000000FF173300000000000000000000FF173300000000000000000000FF173300000000);
 80%  			0000000000FF173300000000000000000000FF173300000000000000000000FF1733000000000000);
 80%  			000000FF173300000000000000000000FF173300000000000000000000FF17330000000000000000);
 85%  			0000FF173300000000000000000000FF173300000000000000000000FF1733000000000000000000);
 85%  			FF173300000000000000000000FF173300000000000000000000FF173300000000000000000000FF);
 85%  			3300000000000000000000FF173300000000000000000000FF173300000000000000000000FF1733);
 85%  			00000000000000000000FF173300000000000000000000FF173300000000000000000000FF173300);
 85%  			0000000000000000FF173300000000000000000000FF173300000000000000000000FF1733000000);
 85%  			00000000000000FFD68E0520000000000000000000FF173300000000000000000000FF1733000000);
 90%  			10000000000000000000FF170F0720000000000000000000FF170F0720000000000000000000FFD5);
 90%  			000000000000FF3F8700578200000000000000000A40FF173300000000000000000000FFECC001CF);
 90%  			0000000000FF3B1E00E410000000000000000000FF173300000000000000000000FF3B1E00E41000);
 90%  			FFD55A0010000000000000000000FF173300000000000000000000FF173300000000000000000000);
 90%  			01CEA0000000000000000000FFFB6B005410000000000000000000FFD55A00100000000000000000);
 95%  			0000000000FF173300000000000000000000FF173300000000000000000000FF1733000000000000);
 95%  			0000000000FF173300000000000000000000FF173300000000000000000000FF1733000000000000);
 95%  			00000000FF173300000000000000000000FF173300000000000000000000FF173300000000000000);
 95%  			00FF173300000000000000000000FF173300000000000000000000FF173300000000000000000000);
 95%  			000000000000FF173300000000000000000000FF173300000000000000000000FF17330000000000);
 95%  SIR	8	TDI  (FF);
 95%  RUNTEST	IDLE	100 TCK	1.00E-02 SEC;
 95%  SIR	8	TDI  (C0);
 95%  RUNTEST	IDLE	2 TCK	1.00E-03 SEC;
 95%  			MASK (FFFFFFFF);
 95%  SIR	8	TDI  (26);
 95%  RUNTEST	IDLE	2 TCK	2.00E-01 SEC;
 95%  SIR	8	TDI  (FF);
 95%  RUNTEST	IDLE	2 TCK	1.00E-03 SEC;
 95%  SIR	8	TDI  (3C);
 95%  			MASK (00002100);
Error: tdo check error at line 11
Error:     READ = 0x41111043
Error:     WANT = 0x21111043
Error:     MASK = 0xffffffff
Time used: 0m16s208ms
svf file programmed failed
Info : remote_bitbang interface quit
```

```
I: g.device.hardware: generating bitstream ID f4351d43ebcc1e42ec5196bfddf74d47
I: g.cli: running handler for applet 'jtag-openocd'
I: g.applet.interface.jtag_openocd: port(s) A voltage set to 3.3 V
I: g.applet.interface.jtag_openocd: socket: listening at tcp:localhost:33333
I: g.applet.interface.jtag_openocd: socket: new connection from [127.0.0.1]:53502
I: g.applet.interface.jtag_openocd: socket: connection from [127.0.0.1]:53502 lost
^CE: asyncio: Task exception was never retrieved
future: <Task finished name='Task-22' coro=<JTAGOpenOCDApplet.interact.<locals>.forward_in() done, defined at /home/jeremy/Downloads/glasgow/software/glasgow/applet/interface/jtag_openocd/__init__.py:164> exception=ValueError('Set of coroutines/Futures is empty.')>
Traceback (most recent call last):
  File "/home/jeremy/Downloads/glasgow/software/glasgow/applet/interface/jtag_openocd/__init__.py", line 167, in forward_in
    data = await iface.read()
  File "/home/jeremy/Downloads/glasgow/software/glasgow/access/direct/demultiplexer.py", line 240, in read
    await self._in_tasks.wait_one()
  File "/home/jeremy/Downloads/glasgow/software/glasgow/support/task_queue.py", line 81, in wait_one
    await asyncio.wait(self._live, return_when=asyncio.FIRST_COMPLETED)
  File "/usr/lib/python3.10/asyncio/tasks.py", line 368, in wait
    raise ValueError('Set of coroutines/Futures is empty.')
ValueError: Set of coroutines/Futures is empty.
E: asyncio: Task was destroyed but it is pending!
task: <Task pending name='Task-21' coro=<JTAGOpenOCDApplet.interact.<locals>.forward_out() running at /home/jeremy/Downloads/glasgow/software/glasgow/applet/interface/jtag_openocd/__init__.py:159> wait_for=<Future pending cb=[Task.task_wakeup()]>>
```

Probe does work though:
```
glasgow run jtag-probe -V 3.3 --port A --pin-tck 0 --pin-tms 3 --pin-tdi 2 --pin-tdo 1 scan
I: g.device.hardware: device already has bitstream ID 62239ba31f7697d2809a2646248c966a
I: g.cli: running handler for applet 'jtag-probe'
I: g.applet.interface.jtag_probe: port(s) A voltage set to 3.3 V
I: g.applet.interface.jtag_probe: shifted 32-bit DR=<11000010000010001000100010000010>
I: g.applet.interface.jtag_probe: shifted 8-bit IR=<10000000>
I: g.applet.interface.jtag_probe: discovered 1 TAPs
I: g.applet.interface.jtag_probe: TAP #0: IR[8] IDCODE=0x41111043
I: g.applet.interface.jtag_probe: manufacturer=0x021 (Lattice Semi.) part=0x1111 version=0x4
```

I am using the version `0.1.dev2093+g00ad180` with amaranth `0.5.0`.

whitequark, 2024-07-02:
@wanda-phi That sounds related to your changes, can you take a look?

jeremyherbert, 2024-07-03:
A small update - the openocd error was caused by me using an ECP5 25F to test rather than an ECP5 12F. Sorry, was just in a bit of a rush.

Here is what a 12F looks like (working):

```
$ glasgow run jtag-openocd -V 3.3 --port A --pin-tck 0 --pin-tms 3 --pin-tdi 2 --pin-tdo 1 tcp:localhost:33333
I: g.device.hardware: generating bitstream ID f4351d43ebcc1e42ec5196bfddf74d47
I: g.cli: running handler for applet 'jtag-openocd'
I: g.applet.interface.jtag_openocd: port(s) A voltage set to 3.3 V
I: g.applet.interface.jtag_openocd: socket: listening at tcp:localhost:33333
I: g.applet.interface.jtag_openocd: socket: new connection from [127.0.0.1]:59722
I: g.applet.interface.jtag_openocd: socket: connection from [127.0.0.1]:59722 lost
```

```
$ openocd -f flash.ocd
Open On-Chip Debugger 0.12.0+dev-00634-g23c33e1d3 (2024-07-02-17:11)
Licensed under GNU GPL v2
For bug reports, read
	http://openocd.org/doc/doxygen/bugs.html
Info : auto-selecting first available session transport "jtag". To override use 'transport select <transport>'.
Info : Initializing remote_bitbang driver
Info : Connecting to localhost:33333
Info : remote_bitbang driver initialized
Info : Note: The adapter "remote_bitbang" doesn't support configurable speed
Info : JTAG tap: ecp5.tap tap/device found: 0x21111043 (mfg: 0x021 (Lattice Semi.), part: 0x1111, ver: 0x2)
Warn : gdb services need one or more targets defined
svf processing file: "blink.svf"
  0%  HDR	0;
(Above Padding command skipped, as per -tap argument)
  0%  HIR	0;
(Above Padding command skipped, as per -tap argument)
  0%  TDR	0;
(Above Padding command skipped, as per -tap argument)
  0%  TIR	0;
(Above Padding command skipped, as per -tap argument)
  0%  ENDDR	DRPAUSE;
  0%  ENDIR	IRPAUSE;
  0%  STATE	IDLE;
  0%  SIR	8	TDI  (E0);
  0%  			MASK (FFFFFFFF);
  0%  SIR	8	TDI  (1C);
  0%  				FFFFFFFFFFFFFFFFFFFFFFFFFFFFFFFFFFFFFFFFFFFFFFFF);
  0%  SIR	8	TDI  (C6);
  0%  SDR	8	TDI  (00);
  0%  RUNTEST	IDLE	2 TCK	1.00E-02 SEC;
  0%  SIR	8	TDI  (0E);
  0%  SDR	8	TDI  (01);
  0%  RUNTEST	IDLE	2 TCK	1.00E-02 SEC;
  0%  SIR	8	TDI  (3C);
  0%  			MASK (0000B000);
  0%  SIR	8	TDI  (46);
  0%  SDR	8	TDI  (01);
  0%  RUNTEST	IDLE	2 TCK	1.00E-02 SEC;
  0%  SIR	8	TDI  (7A);
  0%  RUNTEST	IDLE	2 TCK	1.00E-02 SEC;
  0%  			0000DCFFFFFFFFCDBDFFFFFF006CAC4C82E24282C21CB4624C8CB4AAACA26232045C2E4E860A00FF);
  0%  			00FF173300000000000000000000FF173300000000000000000000FF173300000000000000000000);
  0%  			FF173300000000000000000000FF173300000000000000000000FF173300000000000000000000FF);
  5%  			173300000000000000000000FF173300000000000000000000FF173300000000000000000000FF17);
  5%  			000000000000000000FF173300000000000000000000FF173300000000000000000000FF17330000);
  5%  			0000000000000000FF173300000000000000000000FF173300000000000000000000FF1733000000);
  5%  			000000000000FF173300000000000000000000FF173300000000000000000000FF17330000000000);
  5%  			00000000FF173300000000000000000000FF173300000000000000000000FF173300000000000000);
 10%  			000000FF173300000000000000000000FF173300000000000000000000FF17330000000000000000);
 10%  			00FF173300000000000000000000FF173300000000000000000000FF173300000000000000000000);
 10%  			173300000000000000000000FF173300000000000000000000FF173300000000000000000000FF17);
 10%  			3300000000000000000000FF173300000000000000000000FF173300000000000000000000FF1733);
 10%  			00000000000000000000FF173300000000000000000000FF173300000000000000000000FF173300);
 15%  			0000000000000000FF173300000000000000000000FF173300000000000000000000FF1733000000);
 15%  			000000000000FF173300000000000000000000FF173300000000000000000000FF17330000000000);
 15%  			0000000000FF173300000000000000000000FF173300000000000000000000FF1733000000000000);
 15%  			000000FF173300000000000000000000FF173300000000000000000000FF17330000000000000000);
 15%  			00FF173300000000000000000000FF173300000000000000000000FF173300000000000000000000);
 20%  			173300000000000000000000FF173300000000000000000000FF173300000000000000000000FF17);
 20%  			3300000000000000000000FF173300000000000000000000FF173300000000000000000000FF1733);
 20%  			000000000000000000FF173300000000000000000000FF173300000000000000000000FF17330000);
 20%  			00000000000000FF173300000000000000000000FF173300000000000000000000FF173300000000);
 20%  			000000000000FF173300000000000000000000FF173300000000000000000000FF17330000000000);
 25%  			00000000FF173300000000000000000000FF173300000000000000000000FF173300000000000000);
 25%  			000000FF173300000000000000000000FF173300000000000000000000FF17330000000000000000);
 25%  			00FF173300000000000000000000FF173300000000000000000000FF173300000000000000000000);
 25%  			0000000000000000FF173300000000000000000000FFF4220000000000000000000A40FF17330000);
 25%  			0000FF173300000000000000000000FF173300000000000000000000FF1733000000000000000000);
 25%  			00000000000000FF173300000000000000000000FF173300000000000000000000FF173300000000);
 30%  			173300000000000000000000FFD5360080000000000000000000FF173300000000000000000000FF);
 30%  			000000000000FFF4220000000000000000000A40FF173300000000000000000000FF173300000000);
 30%  			00000000000000000000FF173300000000000000000000FF173300000000000000000000FF173300);
 30%  			00000000FF173300000000000000000000FF173300000000000000000000FF173300000000000000);
 30%  			000000FF173300000000000000000000FF173300000000000000000000FF17330000000000000000);
 35%  			000000000000FF173300000000000000000000FF173300000000000000000000FF17330000000000);
 35%  			00FFF4220000000000000000000A40FFF4220000000000000000000A40FFF4220000000000000000);
 35%  			000000000000FF173300000000000000000000FF173300000000000000000000FF17330000000000);
 35%  			000000000000FFF4220000000000000000000A40FFF4220000000000000000000A40FFF422000000);
 35%  			0000000000FF173300000000000000000000FF173300000000000000000000FF1733000000000000);
 40%  			0000000000000000FF173300000000000000000000FF173300000000000000000000FF1733000000);
 40%  			00000000FF173300000000000000000000FF173300000000000000000000FF173300000000000000);
 40%  			00000000000000FF173300000000000000000000FF173300000000000000000000FF173300000000);
 40%  			00000000000000000000FF173300000000000000000000FF173300000000000000000000FF173300);
 40%  			0000000000000000FF173300000000000000000000FF173300000000000000000000FF1733000000);
 45%  			00000000000000FF173300000000000000000000FF173300000000000000000000FF173300000000);
 45%  			00000000FF173300000000000000000000FF173300000000000000000000FF173300000000000000);
 45%  			173300000000000000000000FF173300000000000000000000FF173300000000000000000000FF17);
 45%  			0000000000000000FF173300000000000000000000FFD5360080000000000000000000FF17330000);
 45%  			00000000FF173300000000000000000000FF173300000000000000000000FF173300000000000000);
 50%  			000000FF173300000000000000000000FF173300000000000000000000FF17330000000000000000);
 50%  			00FF173300000000000000000000FF173300000000000000000000FF173300000000000000000000);
 50%  			FF173300000000000000000000FF173300000000000000000000FF173300000000000000000000FF);
 50%  			3300000000000000000000FF173300000000000000000000FF173300000000000000000000FF1733);
 50%  			000000000000000000FF173300000000000000000000FF173300000000000000000000FF17330000);
 55%  			00000000000000FF173300000000000000000000FF173300000000000000000000FF173300000000);
 55%  			000000000000FF173300000000000000000000FF173300000000000000000000FF17330000000000);
 55%  			00000000000000000000FF173300000000000000000000FF173300000000000000000000FF173300);
 55%  			FF173300000000000000000000FF173300000000000000000000FF173300000000000000000000FF);
 55%  			173300000000000000000000FF173300000000000000000000FF173300000000000000000000FF17);
 60%  			00000000000000000000FF173300000000000000000000FF173300000000000000000000FF173300);
 60%  			0000000000000000FF173300000000000000000000FF173300000000000000000000FF1733000000);
 60%  			000000000000FF173300000000000000000000FF173300000000000000000000FF17330000000000);
 60%  			0000000000FF173300000000000000000000FF173300000000000000000000FF1733000000000000);
 60%  			000000FF173300000000000000000000FF173300000000000000000000FF17330000000000000000);
 65%  			0000FF173300000000000000000000FF173300000000000000000000FF1733000000000000000000);
 65%  			FF173300000000000000000000FFD5360080000000000000000000FF173300000000000000000000);
 65%  			173300000000000000000000FF173300000000000000000000FF173300000000000000000000FF17);
 65%
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

Thread 304 (2023-02-16):

Synthesis for applets fails with YoWASP with: ERROR: Assert `ofs.is_open()' failed in ../yosys-src/passes/techmap/abc9_ops.cc:950.

VioletEternity, 2023-02-16:
I've installed Glasgow and YoWASP in a new virtual environment:

<details>
<summary>Shell transcript</summary>

```
C:\Users\Maya\Desktop\glasgow>python -m venv venv

C:\Users\Maya\Desktop\glasgow>venv\Scripts\activate

(venv) C:\Users\Maya\Desktop\glasgow>pip install ./software[toolchain]
Processing c:\users\maya\desktop\glasgow\software
  Installing build dependencies ... done
  Getting requirements to build wheel ... done
  Installing backend dependencies ... done
  Preparing metadata (pyproject.toml) ... done
Collecting amaranth@ git+https://github.com/amaranth-lang/amaranth.git
  Cloning https://github.com/amaranth-lang/amaranth.git to c:\users\maya\appdata\local\temp\pip-install-v05ktafr\amaranth_9c9a5d56b90b46b1af4f715b17b29de6
  Running command git clone --filter=blob:none --quiet https://github.com/amaranth-lang/amaranth.git 'C:\Users\Maya\AppData\Local\Temp\pip-install-v05ktafr\amaranth_9c9a5d56b90b46b1af4f715b17b29de6'
  Resolved https://github.com/amaranth-lang/amaranth.git to commit 7e3e10e7333630999c5b51440f0e5f0daef0358c
  Installing build dependencies ... done
  Getting requirements to build wheel ... done
  Preparing metadata (pyproject.toml) ... done
Collecting crcmod
  Using cached crcmod-1.7.tar.gz (89 kB)
  Preparing metadata (setup.py) ... done
Collecting libusb1>=1.8.1
  Using cached libusb1-3.0.0-py3-none-win_amd64.whl (140 kB)
Collecting pyvcd
  Using cached pyvcd-0.3.0-py2.py3-none-any.whl (23 kB)
Collecting bitarray
  Downloading bitarray-2.7.2-cp310-cp310-win_amd64.whl (116 kB)
     ---------------------------------------- 116.2/116.2 kB 3.3 MB/s eta 0:00:00
Collecting fx2>=0.11
  Using cached fx2-0.11-py3-none-any.whl (17 kB)
Collecting aiohttp~=3.8
  Downloading aiohttp-3.8.4-cp310-cp310-win_amd64.whl (319 kB)
     ---------------------------------------- 319.8/319.8 kB 4.9 MB/s eta 0:00:00
Collecting yowasp-nextpnr-ice40>=0.1
  Using cached yowasp_nextpnr_ice40-0.5.0.0.post399-py3-none-any.whl (71.9 MB)
Collecting amaranth-yosys
  Using cached amaranth_yosys-0.25.0.0.post67-py3-none-any.whl (740 kB)
Collecting yowasp-yosys>=0.11
  Using cached yowasp_yosys-0.26.0.0.post489-py3-none-any.whl (7.0 MB)
Collecting charset-normalizer<4.0,>=2.0
  Downloading charset_normalizer-3.0.1-cp310-cp310-win_amd64.whl (96 kB)
     ---------------------------------------- 96.5/96.5 kB ? eta 0:00:00
Collecting yarl<2.0,>=1.0
  Using cached yarl-1.8.2-cp310-cp310-win_amd64.whl (56 kB)
Collecting aiosignal>=1.1.2
  Using cached aiosignal-1.3.1-py3-none-any.whl (7.6 kB)
Collecting attrs>=17.3.0
  Downloading attrs-22.2.0-py3-none-any.whl (60 kB)
     ---------------------------------------- 60.0/60.0 kB 3.1 MB/s eta 0:00:00
Collecting multidict<7.0,>=4.5
  Downloading multidict-6.0.4-cp310-cp310-win_amd64.whl (28 kB)
Collecting async-timeout<5.0,>=4.0.0a3
  Using cached async_timeout-4.0.2-py3-none-any.whl (5.8 kB)
Collecting frozenlist>=1.1.1
  Using cached frozenlist-1.3.3-cp310-cp310-win_amd64.whl (33 kB)
Collecting yowasp-runtime~=1.1
  Using cached yowasp_runtime-1.7-py3-none-any.whl (3.8 kB)
Collecting Jinja2~=3.0
  Using cached Jinja2-3.1.2-py3-none-any.whl (133 kB)
Collecting wasmtime<6,>=1
  Downloading wasmtime-5.0.0-py3-none-win_amd64.whl (4.5 MB)
     ---------------------------------------- 4.5/4.5 MB 1.4 MB/s eta 0:00:00
Collecting MarkupSafe>=2.0
  Downloading MarkupSafe-2.1.2-cp310-cp310-win_amd64.whl (16 kB)
Collecting idna>=2.0
  Using cached idna-3.4-py3-none-any.whl (61 kB)
Collecting appdirs~=1.4
  Using cached appdirs-1.4.4-py2.py3-none-any.whl (9.6 kB)
Building wheels for collected packages: amaranth, glasgow
  Building wheel for amaranth (pyproject.toml) ... done
  Created wheel for amaranth: filename=amaranth-0.4.dev62+g7e3e10e-py3-none-any.whl size=153725 sha256=9781330247253579566930000c7cf3f5edb2bfc851ed882b7668aab92df6492d
  Stored in directory: C:\Users\Maya\AppData\Local\Temp\pip-ephem-wheel-cache-27jb0c1r\wheels\83\05\9a\59c513197e8c3427a5077986524b0058a75e7ae4f4ddd544f4
  Building wheel for glasgow (pyproject.toml) ... done
  Created wheel for glasgow: filename=glasgow-0.1.dev1698+g074db5d-py3-none-any.whl size=386634 sha256=bdedf7a9937296bba531301e7b6cc609d3981fbf1410e7533ed0767d0db5a81e
  Stored in directory: C:\Users\Maya\AppData\Local\Temp\pip-ephem-wheel-cache-27jb0c1r\wheels\66\dd\b5\62e39ea54c42fd95ac1d0534b9688190b78b2c8e9c041faf75
Successfully built amaranth glasgow
Installing collected packages: libusb1, crcmod, charset-normalizer, bitarray, appdirs, wasmtime, pyvcd, multidict, MarkupSafe, idna, fx2, frozenlist, attrs, async-timeout, yowasp-runtime, yarl, Jinja2, amaranth-yosys, aiosignal, yowasp-yosys, yowasp-nextpnr-ice40, amaranth, aiohttp, glasgow
  DEPRECATION: crcmod is being installed using the legacy 'setup.py install' method, because it does not have a 'pyproject.toml' and the 'wheel' package is not installed. pip 23.1 will enforce this behaviour change. A possible replacement is to enable the '--use-pep517' option. Discussion can be found at https://github.com/pypa/pip/issues/8559
  Running setup.py install for crcmod ... done
Successfully installed Jinja2-3.1.2 MarkupSafe-2.1.2 aiohttp-3.8.4 aiosignal-1.3.1 amaranth-0.4.dev62+g7e3e10e amaranth-yosys-0.25.0.0.post67 appdirs-1.4.4 async-timeout-4.0.2 attrs-22.2.0 bitarray-2.7.2 charset-normalizer-3.0.1 crcmod-1.7 frozenlist-1.3.3 fx2-0.11 glasgow-0.1.dev1698+g074db5d idna-3.4 libusb1-3.0.0 multidict-6.0.4 pyvcd-0.3.0 wasmtime-5.0.0 yarl-1.8.2 yowasp-nextpnr-ice40-0.5.0.0.post399 yowasp-runtime-1.7 yowasp-yosys-0.26.0.0.post489

[notice] A new release of pip available: 22.3.1 -> 23.0
[notice] To update, run: python.exe -m pip install --upgrade pip

(venv) C:\Users\Maya\Desktop\glasgow>pip list
Package              Version
-------------------- --------------------
aiohttp              3.8.4
aiosignal            1.3.1
amaranth             0.4.dev62+g7e3e10e
amaranth-yosys       0.25.0.0.post67
appdirs              1.4.4
async-timeout        4.0.2
attrs                22.2.0
bitarray             2.7.2
charset-normalizer   3.0.1
crcmod               1.7
frozenlist           1.3.3
fx2                  0.11
glasgow              0.1.dev1698+g074db5d
idna                 3.4
Jinja2               3.1.2
libusb1              3.0.0
MarkupSafe           2.1.2
multidict            6.0.4
pip                  22.3.1
pyvcd                0.3.0
setuptools           65.5.0
wasmtime             5.0.0
yarl                 1.8.2
yowasp-nextpnr-ice40 0.5.0.0.post399
yowasp-runtime       1.7
yowasp-yosys         0.26.0.0.post489

[notice] A new release of pip available: 22.3.1 -> 23.0
[notice] To update, run: python.exe -m pip install --upgrade pip

C:\Users\Maya\Desktop\glasgow>pip freeze
aiohttp==3.8.3
aiosignal==1.3.1
amaranth @ git+https://github.com/amaranth-lang/amaranth.git@7e3e10e7333630999c5b51440f0e5f0daef0358c
amaranth-boards @ git+https://github.com/amaranth-lang/amaranth-boards@609a65c163c1374fb5f9c528253c36caa8edd56f
amaranth-yosys==0.25.0.0.post67
appdirs==1.4.4
async-timeout==4.0.2
attrs==22.1.0
autobahn==22.12.1
Automat==22.10.0
bitarray==2.6.0
certifi==2022.12.7
cffi==1.15.1
charset-normalizer==2.1.1
click==8.1.3
colorama==0.4.6
constantly==15.1.0
contourpy==1.0.6
crcmod==1.7
cryptography==38.0.4
cycler==0.11.0
fonttools==4.38.0
frozenlist==1.3.3
fx2==0.11
-e git+https://github.com/GlasgowEmbedded/glasgow@074db5dceaa4a028b3b00c56663dfdad82e23d8a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
hkdf==0.0.3
humanize==4.4.0
hyperlink==21.0.0
idna==3.4
incremental==22.10.0
Jinja2==3.1.2
kaitaistruct==0.10
kiwisolver==1.4.4
libusb1==3.0.0
magic-wormhole==0.12.0
MarkupSafe==2.1.1
matplotlib==3.6.2
multidict==6.0.3
numpy==1.24.1
packaging==22.0
Pillow==9.3.0
pyasn1==0.4.8
pyasn1-modules==0.2.8
pycparser==2.21
PyNaCl==1.5.0
pyOpenSSL==22.1.0
pyparsing==3.0.9
python-dateutil==2.8.2
pyvcd==0.2.4
pywin32==305
requests==2.28.1
RigolWFM==0.9.6
service-identity==21.1.0
six==1.16.0
spake2==0.8
tqdm==4.64.1
Twisted==22.10.0
twisted-iocpsupport==1.0.2
txaio==22.2.1
txtorcon==22.0.0
typing_extensions==4.4.0
urllib3==1.26.13
wasmtime==1.0.1
yarl==1.8.2
yowasp-nextpnr-ice40==0.5.0.0.post399
yowasp-runtime==1.7
yowasp-yosys==0.26.0.0.post489
zope.interface==5.5.2

(venv) C:\Users\Maya\Desktop\glasgow>..\..\yowasp-env.cmd

(venv) C:\Users\Maya\Desktop\glasgow>set YOSYS=yowasp-yosys

(venv) C:\Users\Maya\Desktop\glasgow>set NEXTPNR_ICE40=yowasp-nextpnr-ice40

(venv) C:\Users\Maya\Desktop\glasgow>set ICEPACK=yowasp-icepack

(venv) C:\Users\Maya\Desktop\glasgow>
```
</details>

When I attempt to build a bitstream for an applet (I've tried `uart` and `jtag-probe`), I get the following error:

```
(venv) C:\Users\Maya\Desktop\glasgow>glasgow build --rev C1 uart
I: glasgow.cli: building bitstream for applet 'uart'
Preparing to run yowasp-yosys. This might take a while...
ERROR: Assert `ofs.is_open()' failed in ../yosys-src/passes/techmap/abc9_ops.cc:950.
Traceback (most recent call last):
  File "C:\Users\Maya\AppData\Local\Programs\Python\Python310\lib\runpy.py", line 196, in _run_module_as_main
    return _run_code(code, main_globals, None,
  File "C:\Users\Maya\AppData\Local\Programs\Python\Python310\lib\runpy.py", line 86, in _run_code
    exec(code, run_globals)
  File "C:\Users\Maya\Desktop\glasgow\venv\Scripts\glasgow.exe\__main__.py", line 7, in <module>
  File "C:\Users\Maya\Desktop\glasgow\venv\lib\site-packages\glasgow\cli.py", line 857, in main
    exit(loop.run_until_complete(_main()))
  File "C:\Users\Maya\AppData\Local\Programs\Python\Python310\lib\asyncio\base_events.py", line 649, in run_until_complete
    return future.result()
  File "C:\Users\Maya\Desktop\glasgow\venv\lib\site-packages\glasgow\cli.py", line 773, in _main
    f.write(plan.execute())
  File "C:\Users\Maya\Desktop\glasgow\venv\lib\site-packages\glasgow\target\hardware.py", line 118, in execute
    products  = self.lower.execute_local(build_dir)
  File "C:\Users\Maya\Desktop\glasgow\venv\lib\site-packages\amaranth\build\run.py", line 97, in execute_local
    subprocess.check_call(["cmd", "/c", "call {}.bat".format(self.script)])
  File "C:\Users\Maya\AppData\Local\Programs\Python\Python310\lib\subprocess.py", line 369, in check_call
    raise CalledProcessError(retcode, cmd)
subprocess.CalledProcessError: Command '['cmd', '/c', 'call build_top.bat']' returned non-zero exit status 1.
```

In issue https://github.com/GlasgowEmbedded/glasgow/issues/298, where a similar problem was [reported](https://github.com/GlasgowEmbedded/glasgow/issues/298#issuecomment-1355933818), I've [mentioned](https://github.com/GlasgowEmbedded/glasgow/issues/298#issuecomment-1359877580) that the issue was fixed with `yowasp-yosys==0.23.dev444`. If I downgrade YoWASP Yosys to that version, synthesis succeeds. However, it fails with `yowasp-yosys==0.23.0.0.post486` or `yowasp-yosys==0.25.0.102.post487.dev0`.

Running `glasgow build --rev C1 -t zip uart` produces this archive: [uart.zip](https://github.com/GlasgowEmbedded/glasgow/files/10757080/uart.zip)

whitequark, 2023-02-16:
This is a YoWASP issue. YoWASP no longer mounts `/tmp` itself, and Yosys abc integration [uses that](https://libera.irclog.whitequark.org/glasgow/2023-02-16#1676559679-1676559709;) to pass intermediate data around.

whitequark, 2023-02-16:
Could you recheck using the following `yowasp-runtime` wheel, please?
[wheel.zip](https://github.com/GlasgowEmbedded/glasgow/files/10760019/wheel.zip)

VioletEternity, 2023-02-16:
I can build a bitstream with this wheel.

whitequark, 2023-02-16:
I've released `yowasp-runtime` with this patch. Everything should work after `pip install -U yowasp-runtime` (or just reinstall the venv).

Closed 2023-02-16.

Thread 309 (2023-03-27):

Replace `crcmod` with `crc`

whitequark, 2023-03-27:
Crcmod is an ancient no longer updated package that doesn't upload wheels (and so requires pip to use deprecated setup.py based install method) and has a native dependency causing issues. We should replace it with [crc](https://github.com/Nicoretti/crc).

bkerler, 2023-03-28:
Just had some spare time and thought you'd welcome some help :)
Pushed PR #310 to port from crcmod to crc as requested.

bkerler, 2023-03-29:
Cleaned up PR #310 and reissued new PR #311

whitequark, 2023-03-29:
Fixed by #311.

Closed 2023-03-29.

Thread 312 (2023-03-30):

Documentation

attie, 2023-03-30:
I am planning to spend time writing more documentation for Glasgow, in preparation for the influx of new users via Crowd Supply.

I'm sharing my plans here, please feel free to comment with suggestions.
This will reside in the [`/docs/`](/docs/) directory, and will not likely touch [`README.md`](/README.md), at least for now... it may absorb some of the content at some point.
Some of these items will draw heavily on existing words.

The longer-term goal of this issue is to also produce static HTML that is hosted somewhere (probably using GitHub pages on a branch of this repo?)

- Index
  - Intro - what is Glasgow & what can it do?
  - Project overview
    - Revisions & naming
- Getting started
  - Installation
    - Linux
    - macOS
    - Windows
  - Running / invocation
    - Examples
  - Common problems & resolutions
- Applets
  - Overview
  - Details
  - Out-of-tree applets (_TBD..._)
  - My first applet example / template / walkthrough
- Hardware variants
  - Naming scheme
  - _foreach_
    - Feature summary
    - Board overview
- Production
  - PCBs, BOM & Assembly
  - Provisioning (serial numbers & firmware)
  - Testing
- Internals
  - Boot
  - Communication (between FPGA and Python)
  - Applet build, load & run
  - _probably much more, TBD..._
- Q&A
  - Where did the name come from?
  - Where can I get one?
  - Where can I ask for help?
  - Where & how can I use it? (Licensing)

whitequark, 2023-03-31:
Sounds wonderful! Let's gather on our IRC/Discord channel to discuss this sometime soon?

attie, 2023-09-30:
Requested examples / expansion:

- REPL usage
- Internal analyzer

attie, 2023-10-07:
- Add instructions for Ubuntu 20.04 LTS

whitequark, 2023-10-08:
> * Add instructions for Ubuntu 20.04 LTS

These are *really* annoying--I've had a go and I think I won't be working on them.

Thread 347 (2023-07-15):

Custom USB Manufacturer String

attie, 2023-07-15:
Add mechanism to permit users to set a custom Manufacturer USB string when flashing the EEPROM (and add to firmware too?)

1BitSquared are producing Glasgow boards, and would like to be able to use the name `1bitsquared` (or similar).

cc @esden

whitequark, 2023-07-15:
Yes it needs to be both in software (`glasgow factory`) and firmware.

The length I think is reasonable is 24 characters. We use 16 chars for serial but serials have higher entropy so they can be shorter.

Closed 2023-07-28.

Thread 354 (2023-07-23):

[RFC] New basis of operation: Reliable Datagram Pipe

whitequark, 2023-07-23:
Currently we configure USB as 4 or 2 completely unrelated streams: two IN/two OUT and one IN/one OUT (with bigger buffers) and expect applets to fit into this scheme. We also have an I2C sideband where applets can add arbitrary registers.

This scheme is problematic for many reasons:
- You only get full performance with one IN/one OUT pipe, and the difference in performance is *drastic*.
- Also you can't currently get this on Windows. (#231 item 2)
- There are serious race condition issues with the I2C registers that applets have to add workarounds for and which are a constant source of bugs. #147 points this out for SPI but it's true everywhere.
- I2C registers are not reset with the applet.
- With async applets, registers have *even more* race condition issues. Applet registers should be in the applet clock domain! But they are all in the I2C / main clock domain.
- You can never have more than 4 applets using USB pipes. Usually you cannot have more than 2. Sometimes, more than 1 (a few applets use e.g. two IN pipes). This is a blocker for #180, which at the moment is just infeasible.
- Having this weird scheme makes virtualizing Glasgow (e.g. to run the CLI on your PC and have the hardware be connected to your RPi elsewhere) very difficult, bordering on impossible.
- It also drags USB semantics everywhere, making it hard to do a future migration to Ethernet.
- Timeouts are... hard, because you don't have a good way to tell the applet to stop busy looping (like in https://github.com/GlasgowEmbedded/glasgow/issues/187) without just resetting it. You can use I2C registers for that but the protocol is awkward, and it introduces race conditions with async applets (doubly so if the clock is sourced externally).

Considering just the case of many applets and many pipes in isolation, a few solutions were proposed:
- using constant overhead byte stuffing to add metadata
- making the 1st byte of the USB package (which inherently delimits the stream) the applet number
Both of these are bad in that the coding overhead of this in Python will be *massive*. Whatever scheme we use, we need it to be faster, not slower, and this means handling >40 MB/s with USB scheduling in pure Python. So what do we do?

I propose a scheme called RDP: **Reliable Datagram Pipe**.
- It is essentially bootleg PCI Express.
- Communication with the device is done through a dual-simplex channel.
- Each individual datagram on the pipe (IN or OUT; both use the same format) consists of *endpoint* (uleb128), *credits* (uleb128), *length* (uleb128), and *payload* (bytes).
  - The endpoint is an arbitrary number used for routing datagrams in the FPGA and in the software. Its assignment is out of scope for this proposal.
  - The credits is a number of additional datagrams that can be sent in the opposite direction.
  - The length is a number describing the length of the payload.
  - The payload is an arbitrary sequence of bytes.
- The unit of transmission is a datagram, i.e. one 4-byte datagram is not the same as two 2-byte datagrams sent to the same endpoint. This is not a stream oriented scheme.
  - Many endpoints on the FPGA will contain no internal buffer, and will generate or parse the datagram payload on the fly.
  - If you want to make a stream oriented scheme out of it anyway, you can ask the demultiplexer to give you a stream (in software) or ignore the end-of-packet signal of the stream (in gateware).
- Datagrams are guaranteed to be delivered, but the latency (in either direction) is not bounded. In practice, what this means is that if you know that datagram number N has been delivered (e.g. through feedback), you also know that datagrams number 1..N-1 have been delivered. If you have no feedback you don't know when or if they're delivered.
  - Communicating with a non-existent endpoint is undefined behavior.
- Datagrams *to the same endpoint* are guaranteed to be delivered in-order. The order of delivery to different endpoints is unspecified.
- Each endpoint has a maximum length for IN and OUT directions, which is communicated out of band.
  - Exceeding the maximum length results in undefined behavior.
- When a datagram is received in one (e.g. OUT) direction, it automatically consumes a credit for that direction. When the credits (the maximum/initial amount of which is communicated out of band) are exhausted the datagram source must pause. When the datagrams in that direction are processed, the next datagram that is sent in the opposite direction (e.g. IN) has a non-zero amount of credits attached to it. If there is no datagram to be sent in the opposite direction, a credit-only datagram (zero length, no payload, non-zero credit amount) can be sent.
  - Credit-only datagrams carry no data and aren't forwarded to the application layer. To send an actual empty datagram, send it with no credits attached.
  - If a packet is received but there are no resources to process it (for any reason, including "the sender did not respect the credit amount") the packet is defined to be dropped.
  - If more credits are released than the maximum/initial amount, the behavior is undefined.

The scheme has the following advantages:
- Coding overhead is of the kind that Python can handle very well. We already have many protocols that use type-length-payload encoding (e.g. JTAG) and we achieve very high bit rates with them because Python can concatenate strings *really* quickly and it can match and slice only slightly slower. Unlike COBS or first-byte-of-every-512-byte-chunk-is-the-address, this scheme can be easily implemented in Python in such a way that if you have large payloads on average, your transfer rate is limited by USB.
- It isn't difficult to parse on the FPGA either.
  - In fact it seems so straightforward (especially for small endpoint values) that I think the parsers for it should be often nested. I.e. an endpoint addresses an applet, and the first bytes of the payload are uleb128 of a sub-endpoint within an applet.
- It has a straightforward mapping to the Internet protocol stack.
  - Probably the two most reasonable one is "one TCP socket for everything", considering head-of-line blocking is not an issue.
- Credit-based flow control means no head-of-line blocking and (with TCP encapsulation) no buffer bloat. (At least, outside of the Glasgow software.)
  - Dropping datagrams that exceed the available credits means it's easy to do quasi-realtime tasks such as "streaming video and hoping the other side has enough bandwidth for it" without losing framing sync even if you do end up dropping datagrams.
- It has an unlimited amount of endpoints, meaning we can support any number of applets that fit into the gateware.
- Mapping an endpoint to an applet means that the communication with the gateware of that applet can be abstracted as an ordered sequence of datagrams instead of the current stream.
- Using datagrams means that we can e.g. map each register to an endpoint and have it generate or overwrite its value with the payload bytes starting at the first one. This requires no additional buffering (only a state machine) and has no additional overhead.
- Actually, most registers (the main exception is applet reset registers) will be mapped to sub-endpoints within the applet.
  - You could potentially do everything with top-level endpoints, but that seems like it would really bloat the interconnect.
- Asynchronous applets are trivial: they are attached only through their IN and OUT pipes and the async reset register. Any applet registers use sub-endpoints and exist in the applet clock domain.
- There is no real need to make applets fit a contrived "SERDES+sideband" scheme anymore. Any sideband signals/registers are allocated to endpoints/sub-endpoints since they are so cheap.
- To make a timeout, add another (sub-)endpoint that pokes the state machine. The length of a datagram has to be known in advance, ergo any transmission proceeds after buffering at the source (or is otherwise guaranteed to make forward progress, meaning that the interconnect isn't stuck waiting for the transmission to complete while it's waiting for an event that never happens).

Using uleb128 as the encoding of the endpoint, credit, length fields has the following advantages:
- Very compact
- We won't ever run out of them
- Parsing overhead on the FPGA is trivial
- Parsing overhead on the Python side is less trivial, but still not too bad even in pure Python
  - This is simple and self-contained enough it can probably be easily accelerated with e.g. Cython
- Only pay for what you use
  - If you have just 2 endpoints you do not even generate the RTL decision tree bigger than 3 cases for the first byte

Downsides:
- The uleb128 encoding may be somewhat costly to parse on the Python side
- Unbounded latency (but we can't really make it bounded with Python and off-the-shelf OSes anyway)
  - But here it is *really* unbounded. Cut-through routing means an applet can transmit several GB of data and for that entire time it will prevent anything else from being transmitted.
    - Can be solved with fragmentation below applet level, but it gets complicated quick.

Open questions:
- Is it worth it allowing multiple levels of cut-through routing within the FPGA? I.e. instead of a single endpoint number, have a sequence of them at the beginning of the packet. Each router parses the number and then immediately starts forwarding the rest to the next one. The same happens in reverse for transmission.
  - Could be a good way to handle sub-endpoints without introducing complex credit accounting.

attie, 2023-07-23:
This sounds very good - I also prefer it to both COBS and a packet header.

Some questions:
- Is your expectation wrt Credits to primarily provide flow control, or is there more going on there?
- Is it more important to declare the maximum payload size, or make the maximum _buffer_ size?
    - e.g: 2x 10-byte frames may fit in the 10-byte max payload, but the buffer is only 16-bytes and thus overflows, now what?
- Do "_credits_" become "_bytes_", which instructs the other end how much data may be transferred before full, rather than being a more abstract packet count?

Can we address some of the "_undefined behaviour_", perhaps declaring that it resets / raises an exception / etc...?
- Missing endpoint - applet ACKs incoming payload, no-ACK = error -> reset / exception
- Oversied payload - applet ACKs each incoming byte, no-ACK / NACK = error -> reset / exception
- Depleating credits - if credits are "_space in buffer_", then the "_oversized payload_" catches this one too

> Unbounded latency (but we can't really make it bounded with Python and off-the-shelf OSes anyway)

Is it worth imposing a _maximum_ payload size, to help break up long busy periods / allow others in? Dynamically based on what is running, or a hard figure as part of the spec?

> Is it worth it allowing multiple levels of cut-through routing within the FPGA?

I was also wondering how to handle sub-endpoints better than placing header info in the payload... Given we have 128-bit IDs, Is it even worth worrying about multi-level routing, and just allow applets to register multiple endpoints (or a range like network masks / `192.168.0.0/24`)? The endpoint is then masked, and the equivelant of the "_Host ID_" is then passed through to the applet at the start. Alignment and stuff becomes important, but that shouldn't be too difficult to handle.

whitequark, 2023-07-23:
> * Is your expectation wrt Credits to primarily provide flow control, or is there more going on there?

I am thinking of this as solely a mechanism for flow control.

> * Do "_credits_" become "_bytes_", which instructs the other end how much data may be transferred before full, rather than being a more abstract packet count?

I think this actually depends on the buffering strategy used by the gateware! If it uses packets (e.g. it double-buffers a maximum-sized RAM) then a credit would be a datagram. If it is a stream endpoint then a credit would be a byte. (This also answers the previous question, I think?)

> Can we address some of the "_undefined behaviour_", perhaps declaring that it resets / raises an exception / etc...?

It does whatever. (In practice: routes a packet somewhere wrong; overflows an internal counter and gets a weird idea about the amount of credits; etc.) I think it's important to not spend too much gateware resources enforcing contracts that should never be violated

Note that all of the undefined behavior happens on the (abstracted) channel between software and gateware. The end user (or applet developer) never encounters any of it.

> Is it worth imposing a maximum payload size, to help break up long busy periods / allow others in? Dynamically based on what is running, or a hard figure as part of the spec?

I don't know. This seems like it could be potentially limiting to some applets. I think I'd like to understand how difficult it is to work around such a limitation being imposed before committing to it.

> Given we have 128-bit IDs

The ID is just a cache key. I don't think it should go into the gateware; that would be a waste of resources of our tiny iCE40!

> I was also wondering how to handle sub-endpoints better than placing header info in the payload...

I think I know how I want to do routing now.

<hr>

I propose splitting the spec effectively in two parts: the *routing* part and the *flow control* part.

For the routing, I propose ditching the endpoint *number* entirely. Instead, the endpoint *address* becomes an arbitrary sequence of non-zero bytes that ends with a zero byte. (This is so that no address is a prefix of another address.) So the frame becomes: endpoint address (bytes), delimiter (zero byte), length (uleb128), credits (whatever), (rest of) payload. The length would include the credits field and any other management data.
- In gateware, each address byte is parsed by a cut-through stream router that selects the next router, waits for a zero byte, then looks at the length, and goes back to the initial state after forwarding _length_ bytes.
- In software, you use any of the myriad ways to dispatch by prefix, and generally treat it as an opaque sequence.
- The length is important for both the routers (for switch state management) and for the endpoints (for identifying delimiters).
- Everything before the length is only important for the routers.
- Everything that's after the length is only important for the endpoints.
- Since it seems like there's going to be some diversity in flow control, treating it as a part of the payload (for the purely cut-through routers that never buffer anything other than to e.g. interface with the FX2) seems fair.

With this scheme, it is possible to build up arbitrary routing topologies in the gateware (to reflect the needs of e.g. clock domain transfer) and then treat the addresses that result as opaque byte sequences in software, which is kind of how you want to do it anyway. You could actually still make them valid uleb128, it's just no longer necessary since they are delimited at the end.

This means that sub-endpoints inside applets, which can be located e.g. after the CDC FIFO for async applets, are as cheap as normal endpoints are in the original proposal (since they are all treated uniformly anyway). It also means that routers never have to think about credits.

What do you think?

attie, 2023-07-23:
> I don't think it should go into the gateware; that would be a waste of resources of our tiny iCE40!

Fair.

> In gateware, each address byte is parsed by a cut-through stream router that selects the next router, waits for a zero byte, then looks at the length, and goes back to the initial state after forwarding length bytes.

I like it a lot.

Presumably each router also absorbs the first byte in the stream, so the address/"_route_" gets shifted up/shorter each time?

```
source:       0x42 0x01 0x00 ...
router1: 0x42      0x01 0x00 ...
router2: 0x01           0x00 ...

whitequark, 2023-07-23:
Yes, exactly. Each router would be a tiny FSM that is essentially linear:
- after receiving the first byte, connects the input stream to the output stream indicated by it,
- does nothing until it sees a `0x00`,
- latches the next number into a counter,
- counts down with each byte transferred until it's 0 and then switches back to the reset state.

attie, 2023-07-23:
Sounds very good to me!

whitequark, 2023-07-23:
All right. We can prototype this once streams land in upstream Amaranth (and this will be a good test case for them too).

whitequark, 2023-07-23:
> * latches the next number into a counter,

Actually, even this is wasteful. It would make a lot more sense to first pass the stream through a filter that asserts end-of-packet when length is reached, and then routers switch to the initial state on end-of-packet assertion.

This saves a (potentially) large counter in every router by instantiating it exactly one. And the router FSM becomes:
1. after receiving the first byte, connect the input stream to the right output stream (or null sink),
2. do nothing until end-of-packet is reached, then goto 1.

This means that routers are *fantastically* cheap. We can instantiate them completely automatically and without much regard for placement and routing. How cool is this?

attie, 2023-07-23:
> It would make a lot more sense to first pass the stream through a filter that asserts end-of-packet when length is reached, and then routers switch to the initial state on end-of-packet assertion.

> This means that routers are fantastically cheap. We can instantiate them completely automatically and without much regard for placement and routing. How cool is this?

Yeah, I love it!

Flow-wise, I'm envisaging something like this. (Port selection mechanism is obviously not based on 255 instances per router)

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

whitequark, 2023-07-23:
I'm thinking about it more generally. The applet would have a router in it! So for example, consider the system with two UART applets and one LPC applet (which is an async one). It could have a topology like this:

- 0: root router
  - 0.0: reset for UART-A
  - 0.1: router for UART-A
    - 0.1.0: rx/tx pipe
    - 0.1.1: baud rate register
    - 0.1.2: error counter
  - 0.2: reset for UART-B
  - 0.3: router for UART-B
    - 0.3.0: rx/tx pipe
    - 0.3.1: baud rate register
    - 0.3.2: error counter
  - 0.4: reset for LPC
  - 0.5: clock domain bridge for LPC
    - 0.5.0: scratch register on LPC side (on external clock, for testing)
    - 0.5.1: LPC applet (on external clock)
      - 0.5.1.0: rx/tx pipe
      - 0.5.1.1: some statistics...

attie, 2023-07-23:
Yep, we're on the same page... I just drew the router as a distinct box, because it'd be an "off the shelf" component:

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

whitequark, 2023-07-23:
Yep! And given that messages for the same applet should not be re-ordered (this new scheme actually calls the re-ordering policy into question somewhat... "only reorder based on first byte"? that's kind of gross) we can safely interleave register access with pipe commands and so on.

This is actually even more reminiscent of PCIe, except I guess a lot more... message-oriented redesign of it?

whitequark, 2023-07-23:
Actually, looking further at it, it seems that it's logical to put length *first*. So the framing becomes: length, endpoint address, delimiter, (credits), payload.

> Is it worth imposing a maximum payload size, to help break up long busy periods / allow others in? Dynamically based on what is running, or a hard figure as part of the spec?

I think I know how to handle this now. The length field (per above) now solely delimits the datagram stream, right? It became a separate entity that can be used elsewhere now, without involving addressing, credits, and so on.

So what we do is add some nesting. Let's consider the case of sending 100 KB to UART-A and 64 KB to UART-B. This could be encoded as:

    <Length=64.01KB Endpoint=0.1.0 Payload=<Length=100KB Payload=[64KB of data ... (unterminated)>
    <Length=64.01KB Endpoint=0.3.0 Payload=<Length=64KB Payload=[64KB of data]>>
    <Length=36.01KB Endpoint=0.1.0 Payload=<(continuation) ... other 36 KB of data]>>

In gateware, the way this could be implemented is that connected to some of the router outputs (specifically in front of endpoints or groups of them where long packets are allowed) will be another EOP generator, exactly the same as the one  in the front of the whole router tree. And instead of paying attention to the EOP signal at the input, it just looks at the length and counts! Meaning that each such point is a point where you can add fragmentation if you need it.

In software... this works exactly the same! A tree of Python objects that add framing when data passes through them.

I think it's really beautiful because it's completely composable. It's just two blocks, EOP generator and prefix router, connected in any way that seems useful for the design.

The other thing I really like about it is that if you do not need to fragment, _you do not have to_. Nothing stops you from forming the following packet:

    <Length=1.00001GB Endpoint=0.1.0 Payload=<Length=1GB Payload=[1GB of data]>>

It will be incredibly effective, especially assuming you're stuffing the data in there using `sendfile()` or an equivalent. Yes, it can't be interrupted, but what if you don't even have any other applets there to interrupt you? This is in stark contrast with TCP/IP-style fragmentation/segmentation, which you have to do whether you like it or not because it's a correctness issue, not a latency issue.

<hr>

I imagine that endpoints will state their maximum tolerable latency (e.g. "needs to be serviced at least every 10 ms") and the Glasgow infrastructure would insert EOP generators in the places where the data flow would have to be regularly interrupted to preserve fairness.

whitequark, 2023-07-23:
> this new scheme actually calls the re-ordering policy into question somewhat... "only reorder based on first byte"? that's kind of gross

I think what we can do here is twofold. First... do you know `set_clock_groups -asynchronous` from the Synopsys constraint files? Asserting that the groups of clock domains are independent from each other and need not be timed together. We can have the same thing for endpoints: a way to mark them asynchronous. Then they could be mapped to e.g. different TCP streams for when we have TCP/IP running on this thing.

Second, we can actually *enforce* this. We can make it possible to check that a single `asyncio.Task` never awaits two endpoints that are set as asynchronous to each other, and emit a warning (or even crash it) if it ever does.

The actual reordering policy will likely be still prefix based but formed based on the policy definition for endpoints. Ideally (and as we reach higher bandwidths) we'd have some Rust code that yeets datagrams for endpoints from asynchronous groups into different threads and then each thread can run an asyncio reactor handling datagrams for its endpoint group. So it's not just multiple applets running simultaneously, but they could actually run in parallel! (Provided they're actually independent from each other.)

Which, combined with the bound on latency from the previous message, actually makes it seem like we can make multiple-applet configurations that do not have applets starve each other of either USB pipe bandwidth or of host resources? That would be really nice.

whitequark, 2023-07-24:
Okay, it looks like I thought long and hard enough about this problem that I ended up finding a completely new (to myself) way to think about it ~which this margin is too narrow to contain~. I might have even better proposals soon! (Building on these particular ones, it seems.)

sorear, 2023-07-24:
Are all of our writes posted?  How do we establish ordering between an applet responding to a write and subsequent read data on another endpoint?  In particular, if we read data after a reset do we know if the data was generated before or after the reset?

whitequark, 2023-07-24:
> Are all of our writes posted? How do we establish ordering between an applet responding to a write and subsequent read data on another endpoint?

The interconnect knows which endpoints may not have flows be reordered between them and ensures this doesn't happen. Consider a multiplexer which has two input streams pending. If the flows in these streams are declared asynchronous, it can switch at any point (in practice it will switch to maintain latency requirements) and head-of-line blocking isn't possible. If the flows are declared synchronous (all of the flows within one applet are synchronous unless declared otherwise) then head-of-line blocking is possible.

> In particular, if we read data after a reset do we know if the data was generated before or after the reset?

But this isn't enough to solve reset endpoints specifically because it is possible (likely, even) that we want to reset the applet *because* it has filled every single buffer in the pipeline.

I thought I had a solution for this but I think it doesn't work out. I'll sleep on it; maybe it'll make sense then.

attie, 2023-07-29:
Adding my words from `#glasgow` on 2023-07-29, so they don't get lost.

---

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

> something like this (probably needs more thought / proving through)
> The `endpoint` then just connects the applet up instead of the output

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

> this would result in a stream that has `[ n Address Octets ][ n Payload Octets ]`, and can be interpreted as required
> e.g: `02 00 05 01 02 03 04 05` could be address `02 -> 00`, followed by `05` (length) and `01 02 03 04 05` (payload)

whitequark, 2023-07-29:
I don't think we should have an address bus at all--that's gates we could be using for something else.

Thread 382 (2023-08-03):

Device fails to enumerate when plugged in for the first time on Windows

VioletEternity, 2023-08-03:
After the first time the device (with the firmware as shipped by @1bitSquared) is enumerated on Windows 10 Version 10.0.19045 Build 19045, it fails to start:

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

When the device is in this failed state, the Glasgow CLI tool will show the following error:

```
>glasgow voltage
Traceback (most recent call last):
  File "<frozen runpy>", line 198, in _run_module_as_main
  File "<frozen runpy>", line 88, in _run_code
  File "c:\users\maya.maya-domain\.local\bin\glasgow.exe\__main__.py", line 7, in <module>
  File "C:\Users\Maya.MAYA-DOMAIN\AppData\Local\glasgow\software\glasgow\cli.py", line 901, in main
    exit(loop.run_until_complete(_main()))
         ^^^^^^^^^^^^^^^^^^^^^^^^^^^^^^^^
  File "C:\Users\Maya.MAYA-DOMAIN\AppData\Local\Programs\Python\Python311\Lib\asyncio\base_events.py", line 653, in run_until_complete
    return future.result()
           ^^^^^^^^^^^^^^^
  File "C:\Users\Maya.MAYA-DOMAIN\AppData\Local\glasgow\software\glasgow\cli.py", line 493, in _main
    device = GlasgowHardwareDevice(args.serial)
             ^^^^^^^^^^^^^^^^^^^^^^^^^^^^^^^^^^
  File "C:\Users\Maya.MAYA-DOMAIN\AppData\Local\glasgow\software\glasgow\device\hardware.py", line 159, in __init__
    devices = self._enumerate_devices(usb_context)
              ^^^^^^^^^^^^^^^^^^^^^^^^^^^^^^^^^^^^
  File "C:\Users\Maya.MAYA-DOMAIN\AppData\Local\glasgow\software\glasgow\device\hardware.py", line 98, in _enumerate_devices
    handle = device.open()
             ^^^^^^^^^^^^^
  File "C:\Users\Maya.MAYA-DOMAIN\AppData\Local\.local\pipx\venvs\glasgow\Lib\site-packages\usb1\__init__.py", line 2055, in open
    mayRaiseUSBError(libusb1.libusb_open(self.device_p, byref(handle)))
  File "C:\Users\Maya.MAYA-DOMAIN\AppData\Local\.local\pipx\venvs\glasgow\Lib\site-packages\usb1\__init__.py", line 127, in mayRaiseUSBError
    __raiseUSBError(value)
  File "C:\Users\Maya.MAYA-DOMAIN\AppData\Local\.local\pipx\venvs\glasgow\Lib\site-packages\usb1\__init__.py", line 119, in raiseUSBError
    raise __STATUS_TO_EXCEPTION_DICT.get(value, __USBError)(value)
usb1.USBErrorNotSupported: LIBUSB_ERROR_NOT_SUPPORTED [-12]
```

Unplugging the device and plugging it back in resolves the issue.

When it does work, the driver stack is:
```
\Driver\WINUSB
\Driver\ACPI
\Driver\USBHUB3
```

When it does not, the driver stack is:
```
\Driver\ACPI
\Driver\USBHUB3
```

The status code is 0xc0000001 STATUS_UNSUCCESSFUL, which is unfortunately not very useful. I am not sure what causes the issue. I will be able to capture ETW traces later.

The problem can be reproduced by removing the device using the Device Manager, unplugging it, and plugging it back in.

As far as I can tell the firmware does not have the git commit hash embedded into it, so I've included the entire firmware:
[glasgow.ihex.txt](https://github.com/GlasgowEmbedded/glasgow/files/12255462/glasgow.ihex.txt).

attie, 2023-08-03:
> Unplugging the device and plugging it back in resolves the issue.

Could you clarify?
- Did this happen the first ever time, and then never again after re-plugging?
- Does a reboot get it to occur again? (does anything?)

VioletEternity, 2023-08-03:
> * Did this happen the first ever time, and then never again after re-plugging?

Correct.

> * Does a reboot get it to occur again?

It works fine after a reboot.

>  (does anything / can you reproduce it?)

You can artificially make it happen the second time by uninstalling the driver using the Device Manager, unplugging the device, and plugging it back in.

Also, I am fairly certain it will happen once per physical device (i.e. VID/PID/DID/serial number combination).

attie, 2023-08-03:
> Also, I am fairly certain it will happen once per physical device (i.e. VID/PID/DID/serial number combination).

Knowing Windows, possibly physical port too...! (could you confirm?)

VioletEternity, 2023-08-03:
No, not physical port. It was originally plugged into `Port_#0004.Hub_#0002`. After plugging it in `Port_#0002.Hub_#0002` it works fine.

The device instance path remains the same, `USB\VID_20B7&PID_9DB1\C3-20230729T201611Z`, so the same device settings are used. It is only the location that is updated when it is plugged in a different port.

whitequark, 2023-08-03:
> I will be able to capture ETW traces later.

I would really appreciate ETW traces (or any additional information about this issue) because I'm at a loss of where to even begin debugging it.

whitequark, 2023-08-03:
@esden Have you already programmed all of the Early Bird units? This could be an unpleasant thing for people who use Windows to hit on their first plug in...

@attie I think we need to catch `usb1.USBErrorNotSupported` on Windows and ask the operator to unplug it and plug it back again to see if that solves it, until we can fix this properly >_>

attie, 2023-08-03:
> No, not physical port

That's good... FTDI UARTs (and I'm sure something else) used to have a habit of tying the `COMn` to a physical port.

> catch `usb1.USBErrorNotSupported` on Windows and ask the operator to unplug it and plug it back again

I've got access to Windows too, though my knowledge is _far_ below where it could be.
I'm a little surprised it doesn't "figure things out" and that a replug is required... but that's a good idea.

whitequark, 2023-08-03:
> I'm a little surprised it doesn't "figure things out" and that a replug is required... but that's a good idea.

It might be related to WinUSB somehow?

whitequark, 2023-08-04:
@VioletEternity Could you test https://github.com/GlasgowEmbedded/glasgow/pull/385, please?

VioletEternity, 2023-08-04:
I've attached the ETW trace capturing USB transactions on first plug-in of the device:
[usbtrace.zip](https://github.com/GlasgowEmbedded/glasgow/files/12264291/usbtrace.zip)

It seems that the cause of the issue might be the failure of the requests with FNs 378 and 390:
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

I've included the requests below:

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

VioletEternity, 2023-08-04:
It looks like an unrecognized USB request that is received by the device will always fall through to this line:

https://github.com/GlasgowEmbedded/glasgow/blob/31463053c8ca7bf9fda0c44e43f39f003765646d/firmware/main.c#L841

This isn't correct. In case of an IN request or an OUT request with a payload, it is necessary to wait for `EP0CS & _BUSY` to clear first. In case of OUT requests with no payload, the opportunity to stall EP0 has passed and the request should be ignored.

VioletEternity, 2023-08-04:
In addition, it looks like this implementation of `STALL_EP0()` is incorrect:
https://github.com/whitequark/libfx2/blob/82d154153f548b29b1be60f1c11d7a5bc102486d/firmware/library/include/fx2usb.h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

It should be `EP0CS = _HSNAK|_STALL` instead:

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

VioletEternity, 2023-08-04:
> This isn't correct. In case of an IN request, it is necessary to wait for `EP0CS & _BUSY` to clear first.

My apologies; I wasn't paying enough attention and got confused.

There is no point in waiting for `EP0CS & _BUSY` to clear in the beginning of the SUDAV deferred interrupt handler because it will never be set at that point:

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

It only makes sense to wait for `EP0CS & _BUSY` to clear after an EP0 data transfer has been set up. In case of libfx2, this would be after a call to `SETUP_EP0_BUF`, `SETUP_EP0_IN_DATA`, or `SETUP_EP0_IN_DESC`.

The issue is caused by not stalling EP0 as described here:

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

whitequark, 2023-08-04:
All right, I can't quite get it to work right now, but I also realized that I think I understood this part of the FX2 TRM wrong this whole time and I need to rewrite a significant amount of code. I'll do this tomorrow >_>

whitequark, 2023-09-20:
Python reproducer for this issue:

```
import usb1

context = usb1.USBContext()
device = context.getByVendorIDAndProductID(0x20b7, 0x9db1)
handle = device.open()
try:
    handle.controlRead(0xc1, 0xc0, 0, 5, 10)
    print("not failed")
except usb1.USBErrorPipe:
    print("failed")
print(handle.controlRead(0x80, 6, 0x0303, 0x0906, 255).hex())
```

Closed 2023-09-20.

Thread 383 (2023-08-03):

Instructions in README do not make it possible to build bitstreams on Windows

VioletEternity, 2023-08-03:
I followed the [instructions](https://github.com/GlasgowEmbedded/glasgow#-with-windows) exactly. After installing everything afresh, any command that involves building the bitstream causes the following error to occur:

```
>glasgow build --rev C3 uart
I: glasgow.cli: generating bitstream for applet 'uart'
Traceback (most recent call last):
  File "<frozen runpy>", line 198, in _run_module_as_main
  File "<frozen runpy>", line 88, in _run_code
  File "C:\Users\Maya.MAYA-DOMAIN\AppData\Local\.local\pipx\venvs\glasgow\Scripts\yowasp-yosys.exe\__main__.py", line 4, in <module>
  File "C:\Users\Maya.MAYA-DOMAIN\AppData\Local\.local\pipx\venvs\glasgow\Lib\site-packages\yowasp_yosys\__init__.py", line 2, in <module>
    import yowasp_runtime
  File "C:\Users\Maya.MAYA-DOMAIN\AppData\Local\.local\pipx\venvs\glasgow\Lib\site-packages\yowasp_runtime\__init__.py", line 5, in <module>
    import wasmtime
  File "C:\Users\Maya.MAYA-DOMAIN\AppData\Local\.local\pipx\venvs\glasgow\Lib\site-packages\wasmtime\__init__.py", line 16, in <module>
    from ._error import WasmtimeError, ExitTrap
  File "C:\Users\Maya.MAYA-DOMAIN\AppData\Local\.local\pipx\venvs\glasgow\Lib\site-packages\wasmtime\_error.py", line 2, in <module>
    from . import _ffi as ffi
  File "C:\Users\Maya.MAYA-DOMAIN\AppData\Local\.local\pipx\venvs\glasgow\Lib\site-packages\wasmtime\_ffi.py", line 26, in <module>
    raise RuntimeError("unsupported architecture for wasmtime: {}".format(machine))
RuntimeError: unsupported architecture for wasmtime:
Traceback (most recent call last):
  File "<frozen runpy>", line 198, in _run_module_as_main
  File "<frozen runpy>", line 88, in _run_code
  File "c:\users\maya.maya-domain\.local\bin\glasgow.exe\__main__.py", line 7, in <module>
  File "C:\Users\Maya.MAYA-DOMAIN\AppData\Local\glasgow\software\glasgow\cli.py", line 901, in main
    exit(loop.run_until_complete(_main()))
         ^^^^^^^^^^^^^^^^^^^^^^^^^^^^^^^^
  File "C:\Users\Maya.MAYA-DOMAIN\AppData\Local\Programs\Python\Python311\Lib\asyncio\base_events.py", line 653, in run_until_complete
    return future.result()
           ^^^^^^^^^^^^^^^
  File "C:\Users\Maya.MAYA-DOMAIN\AppData\Local\glasgow\software\glasgow\cli.py", line 798, in _main
    f.write(plan.get_bitstream())
            ^^^^^^^^^^^^^^^^^^^^
  File "C:\Users\Maya.MAYA-DOMAIN\AppData\Local\glasgow\software\glasgow\target\hardware.py", line 164, in get_bitstream
    bitstream_data = self.execute(debug=debug)
                     ^^^^^^^^^^^^^^^^^^^^^^^^^
  File "C:\Users\Maya.MAYA-DOMAIN\AppData\Local\glasgow\software\glasgow\target\hardware.py", line 138, in execute
    products  = self.lower.execute_local(build_dir, env=self.toolchain.env_vars)
                ^^^^^^^^^^^^^^^^^^^^^^^^^^^^^^^^^^^^^^^^^^^^^^^^^^^^^^^^^^^^^^^^
  File "C:\Users\Maya.MAYA-DOMAIN\AppData\Local\.local\pipx\venvs\glasgow\Lib\site-packages\amaranth\build\run.py", line 98, in execute_local
    subprocess.check_call(["cmd", "/c", "call {}.bat".format(self.script)],
  File "C:\Users\Maya.MAYA-DOMAIN\AppData\Local\Programs\Python\Python311\Lib\subprocess.py", line 413, in check_call
    raise CalledProcessError(retcode, cmd)
subprocess.CalledProcessError: Command '['cmd', '/c', 'call build_top.bat']' returned non-zero exit status 1.
```

The installed package versions are:

```
>pipx runpip glasgow list
Package              Version              Editable project location
-------------------- -------------------- --------------------------------------------------------
amaranth             0.4.dev160+gb952005
amaranth-yosys       0.25.0.0.post74
appdirs              1.4.4
bitarray             2.8.0
click                8.1.6
colorama             0.4.6
fx2                  0.11
glasgow              0.1.dev1786+g3146305 C:\Users\Maya.MAYA-DOMAIN\AppData\Local\glasgow\software
Jinja2               3.1.2
libusb1              3.0.0
MarkupSafe           2.1.3
packaging            23.1
pip                  23.2.1
pyvcd                0.4.0
setuptools           68.0.0
wasmtime             11.0.0
wheel                0.41.0
yowasp-nextpnr-ice40 0.6.0.0.post440
yowasp-runtime       1.30
yowasp-yosys         0.31.0.13.post553
```

Running yowasp-yosys normally succeeds:

```
>C:\Users\Maya.MAYA-DOMAIN\AppData\Local\.local\pipx\venvs\glasgow\Scripts\yowasp-yosys.exe
Preparing to run yowasp-yosys. This might take a while...
Yosys 0.31+13 (git sha1 6965abeef, ccache clang 14.0.0-1ubuntu1 -Os -flto -flto)
```

This seems to be caused by this line executing the build with only a few environment variables:

https://github.com/GlasgowEmbedded/glasgow/blob/31463053c8ca7bf9fda0c44e43f39f003765646d/software/glasgow/target/hardware.py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

and with these variables not including `PROCESSOR_ARCHITECTURE`:

https://github.com/GlasgowEmbedded/glasgow/blob/31463053c8ca7bf9fda0c44e43f39f003765646d/software/glasgow/target/toolchain.py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

Wasmtime uses `platform.machine()` to determine the system architecture:

https://github.com/bytecodealliance/wasmtime-py/blob/8a759215eaf515f69a70ee04bf105c66f044fff9/wasmtime/_ffi.py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

This method relies on the `PROCESSOR_ARCHITECTURE` environment variable:

```
>>> subprocess.call([sys.executable, "-c", "import platform; print(platform.machine())"], env={"PROCESSOR_ARCHITECTURE": "FOO"})
FOO
```

If this environment variable is additionally included, the build succeeds and the resulting bitstream works.

attie, 2023-08-03:
Oh. Thanks for the report.

This is likely related to the "_hermetic_" builds that Amaranth is doing... see also:
- https://github.com/amaranth-lang/amaranth/commit/cb5b0e38
- https://github.com/YosysHQ/oss-cad-suite-build/issues/75

VioletEternity, 2023-08-03:
> I suspect this is related to the "_hermetic_" builds that Amaranth is doing...

As far as I can see "hermetic" builds are something that is introduced in Glasgow. Amaranth provides the necessary hooks to clear the environment, but that's it.

whitequark, 2023-08-03:
Yeah, we need to include `PROCESSOR_ARCHITECTURE` at least, on Windows.

whitequark, 2023-08-03:
@VioletEternity Can you test https://github.com/GlasgowEmbedded/glasgow/pull/384, please?

Closed 2023-08-04.

Thread 386 (2023-08-05):

Glasgow does not gracefully shutdown if the device is unplugged...

attie, 2023-08-05:
For example, running the `uart` applet, and then unplugging it will produce lots of output, and then hang on `E: g.cli: transfer error: LIBUSB_TRANSFER_ERROR`, requiring `^C` to return to the shell.

<details><summary>Console Output</summary>

```
user@c0f973ab2540:~$ glasgow run uart -V 3.3 tty
I: g.device.hardware: generating bitstream ID fc10eecac687e82738156c3ee7cdfb42
I: g.cli: running handler for applet 'uart'
I: g.applet.interface.uart: port(s) A, B voltage set to 3.3 V
I: g.applet.interface.uart: running on a TTY; enter `Ctrl+\ q` to quit
W: g.applet.interface.uart: 40 frame or parity errors detected
W: g.applet.interface.uart: 12201 frame or parity errors detected
W: g.applet.interface.uart: 12202 frame or parity errors detected
W: g.applet.interface.uart: 12214 frame or parity errors detected
W: g.applet.interface.uart: 12211 frame or parity errors detected
E: asyncio: Task exception was never retrieved
future: <Task finished name='Task-5' coro=<DirectDemultiplexerInterface._in_task() done, defined at /opt/glasgow/software/glasgow/access/direct/demultiplexer.py:214> exception=GlasgowDeviceError('transfer error:
 LIBUSB_TRANSFER_ERROR')>
Traceback (most recent call last):
  File "/opt/glasgow/software/glasgow/access/direct/demultiplexer.py", line 222, in _in_task
    data = await self.device.bulk_read(self._endpoint_in, size)
  File "/opt/glasgow/software/glasgow/device/hardware.py", line 287, in bulk_read
    data = await self._do_transfer(is_read=True, setup=lambda transfer:
  File "/opt/glasgow/software/glasgow/device/hardware.py", line 257, in _do_transfer
    return await result_future
glasgow.device.GlasgowDeviceError: transfer error: LIBUSB_TRANSFER_ERROR
E: asyncio: Task exception was never retrieved
future: <Task finished name='Task-6' coro=<DirectDemultiplexerInterface._in_task() done, defined at /opt/glasgow/software/glasgow/access/direct/demultiplexer.py:214> exception=GlasgowDeviceError('transfer error:
 LIBUSB_TRANSFER_ERROR')>
Traceback (most recent call last):
  File "/opt/glasgow/software/glasgow/access/direct/demultiplexer.py", line 222, in _in_task
    data = await self.device.bulk_read(self._endpoint_in, size)
  File "/opt/glasgow/software/glasgow/device/hardware.py", line 287, in bulk_read
    data = await self._do_transfer(is_read=True, setup=lambda transfer:
  File "/opt/glasgow/software/glasgow/device/hardware.py", line 257, in _do_transfer
    return await result_future
glasgow.device.GlasgowDeviceError: transfer error: LIBUSB_TRANSFER_ERROR
E: asyncio: Task exception was never retrieved
future: <Task finished name='Task-7' coro=<DirectDemultiplexerInterface._in_task() done, defined at /opt/glasgow/software/glasgow/access/direct/demultiplexer.py:214> exception=GlasgowDeviceError('transfer error:
 LIBUSB_TRANSFER_ERROR')>
Traceback (most recent call last):
  File "/opt/glasgow/software/glasgow/access/direct/demultiplexer.py", line 222, in _in_task
    data = await self.device.bulk_read(self._endpoint_in, size)
  File "/opt/glasgow/software/glasgow/device/hardware.py", line 287, in bulk_read
    data = await self._do_transfer(is_read=True, setup=lambda transfer:
  File "/opt/glasgow/software/glasgow/device/hardware.py", line 257, in _do_transfer
    return await result_future
glasgow.device.GlasgowDeviceError: transfer error: LIBUSB_TRANSFER_ERROR
E: asyncio: Task exception was never retrieved
future: <Task finished name='Task-8' coro=<DirectDemultiplexerInterface._in_task() done, defined at /opt/glasgow/software/glasgow/access/direct/demultiplexer.py:214> exception=GlasgowDeviceError('transfer error:
 LIBUSB_TRANSFER_ERROR')>
Traceback (most recent call last):
  File "/opt/glasgow/software/glasgow/access/direct/demultiplexer.py", line 222, in _in_task
    data = await self.device.bulk_read(self._endpoint_in, size)
  File "/opt/glasgow/software/glasgow/device/hardware.py", line 287, in bulk_read
    data = await self._do_transfer(is_read=True, setup=lambda transfer:
  File "/opt/glasgow/software/glasgow/device/hardware.py", line 257, in _do_transfer
    return await result_future
glasgow.device.GlasgowDeviceError: transfer error: LIBUSB_TRANSFER_ERROR
E: asyncio: Task exception was never retrieved
future: <Task finished name='Task-9' coro=<DirectDemultiplexerInterface._in_task() done, defined at /opt/glasgow/software/glasgow/access/direct/demultiplexer.py:214> exception=GlasgowDeviceError('transfer error:
 LIBUSB_TRANSFER_ERROR')>
Traceback (most recent call last):
  File "/opt/glasgow/software/glasgow/access/direct/demultiplexer.py", line 222, in _in_task
    data = await self.device.bulk_read(self._endpoint_in, size)
  File "/opt/glasgow/software/glasgow/device/hardware.py", line 287, in bulk_read
    data = await self._do_transfer(is_read=True, setup=lambda transfer:
  File "/opt/glasgow/software/glasgow/device/hardware.py", line 257, in _do_transfer
    return await result_future
glasgow.device.GlasgowDeviceError: transfer error: LIBUSB_TRANSFER_ERROR
E: asyncio: Task exception was never retrieved
future: <Task finished name='Task-10' coro=<DirectDemultiplexerInterface._in_task() done, defined at /opt/glasgow/software/glasgow/access/direct/demultiplexer.py:214> exception=GlasgowDeviceError('transfer error
: LIBUSB_TRANSFER_ERROR')>
Traceback (most recent call last):
  File "/opt/glasgow/software/glasgow/access/direct/demultiplexer.py", line 222, in _in_task
    data = await self.device.bulk_read(self._endpoint_in, size)
  File "/opt/glasgow/software/glasgow/device/hardware.py", line 287, in bulk_read
    data = await self._do_transfer(is_read=True, setup=lambda transfer:
  File "/opt/glasgow/software/glasgow/device/hardware.py", line 257, in _do_transfer
    return await result_future
glasgow.device.GlasgowDeviceError: transfer error: LIBUSB_TRANSFER_ERROR
E: asyncio: Task exception was never retrieved
future: <Task finished name='Task-11' coro=<DirectDemultiplexerInterface._in_task() done, defined at /opt/glasgow/software/glasgow/access/direct/demultiplexer.py:214> exception=GlasgowDeviceError('transfer error
: LIBUSB_TRANSFER_ERROR')>
Traceback (most recent call last):
  File "/opt/glasgow/software/glasgow/access/direct/demultiplexer.py", line 222, in _in_task
    data = await self.device.bulk_read(self._endpoint_in, size)
  File "/opt/glasgow/software/glasgow/device/hardware.py", line 287, in bulk_read
    data = await self._do_transfer(is_read=True, setup=lambda transfer:
  File "/opt/glasgow/software/glasgow/device/hardware.py", line 257, in _do_transfer
    return await result_future
glasgow.device.GlasgowDeviceError: transfer error: LIBUSB_TRANSFER_ERROR
E: asyncio: Task exception was never retrieved
future: <Task finished name='Task-12' coro=<DirectDemultiplexerInterface._in_task() done, defined at /opt/glasgow/software/glasgow/access/direct/demultiplexer.py:214> exception=GlasgowDeviceError('transfer error
: LIBUSB_TRANSFER_ERROR')>
Traceback (most recent call last):
  File "/opt/glasgow/software/glasgow/access/direct/demultiplexer.py", line 222, in _in_task
    data = await self.device.bulk_read(self._endpoint_in, size)
  File "/opt/glasgow/software/glasgow/device/hardware.py", line 287, in bulk_read
    data = await self._do_transfer(is_read=True, setup=lambda transfer:
  File "/opt/glasgow/software/glasgow/device/hardware.py", line 257, in _do_transfer
    return await result_future
glasgow.device.GlasgowDeviceError: transfer error: LIBUSB_TRANSFER_ERROR
E: asyncio: Task exception was never retrieved
future: <Task finished name='Task-13' coro=<DirectDemultiplexerInterface._in_task() done, defined at /opt/glasgow/software/glasgow/access/direct/demultiplexer.py:214> exception=GlasgowDeviceError('transfer error
: LIBUSB_TRANSFER_ERROR')>
Traceback (most recent call last):
  File "/opt/glasgow/software/glasgow/access/direct/demultiplexer.py", line 222, in _in_task
    data = await self.device.bulk_read(self._endpoint_in, size)
  File "/opt/glasgow/software/glasgow/device/hardware.py", line 287, in bulk_read
    data = await self._do_transfer(is_read=True, setup=lambda transfer:
  File "/opt/glasgow/software/glasgow/device/hardware.py", line 257, in _do_transfer
    return await result_future
glasgow.device.GlasgowDeviceError: transfer error: LIBUSB_TRANSFER_ERROR
E: g.cli: transfer error: LIBUSB_TRANSFER_ERROR
```

</details>

whitequark, 2023-08-05:
Oh yeah. I've spent a lot of effort making it not do that and it's still an issue.

whitequark, 2023-10-21:
Fixed by https://github.com/GlasgowEmbedded/glasgow/pull/452.

whitequark, 2023-10-21:
> requiring ^C to return to the shell.

The UART applet in TTY mode specifically still requires this, but it also works with a single newline. Other applets return instantly. This could be separately fixed in the UART applet.

Closed 2023-10-21.

Thread 387 (2023-08-05):

Devices may "forget" firmware.

attie, 2023-08-05:
I believe I've seen this a few times - a Glasgow with firmware flashed, will "forget" it, and require firmware to be loaded the first time `glasgow` is invoked.

- It seems that byte @ `0x0` in the EEPROM is being set to `0xC0` (i.e: "_Load custom VID / PID / DID only_")
- `fx2tool` shows that firmware was indeed present (see [gist](https://gist.github.com/attie/a9106c4f9e65fddbb815724fdb306965))
- `glasgow flash` loads the firmware again with no error
- I do not currently have a way to reproduce this issue

whitequark, 2023-08-05:
The code in the firmware that does this is here:

https://github.com/GlasgowEmbedded/glasgow/blob/ba3cb99d0b2bcfd2638ccf0d0418942ec040932f/firmware/main.c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

It's called from `main`. But unless `glasgow_config.revision` is for some reason one of specifically `'A'`, `'B'`, or `'C'`, it won't fire.

Since this wouldn't happen with the boards @esden shipped I suspect the cause is something else.

I'm going to close this since it's completely unactionable and there is no reproducer. However, this isn't my way of saying "this issue doesn't matter"—closed issues still stay on the tracker and get searched. If anyone ever hits this again (and is able to provide more context) we will reopen it.

whitequark, 2023-08-05:
Alternatively, we can just remove `config_fixup` entirely. I think it's safe to assume that all of the devices that required the fixup have received it in the four years (git blame points at 2019-03-01) it's been in the codebase.

attie, 2023-08-05:
> Alternatively, we can just remove config_fixup entirely.

I was wondering about that approach too... or wondering if I missed something else performing the write via USB.

whitequark, 2023-08-05:
> or wondering if I missed something else performing the write via USB.

Unless you ran `glasgow flash --no-firmware` or `glasgow factory` I don't see what would issue such a write over USB...

Closed 2023-08-05.

Thread 413 (2023-10-03):

Calling `exit()` from script / REPL does not terminate glasgow

attie, 2023-10-03:
For example:

```
$ glasgow repl uart -V 3.3
I: g.device.hardware: device already has bitstream ID 067aee2e95ca0facf53eddbf5b092d50
I: g.cli: running handler for applet 'uart'
I: g.applet.interface.uart: port(s) A, B voltage set to 3.3 V
I: g.applet.interface.uart: dropping to REPL; use 'help(iface)' to see available APIs
>>> exit()
```

(and then it gets stuck / doesn't exit)

whitequark, 2023-10-28:
Reproducer without Glasgow:

```python
import threading
import usb1

class _PollerThread(threading.Thread):
    def __init__(self, context):
        super().__init__()
        self.done    = False
        self.context = context

    def run(self):
        while not self.done:
            self.context.handleEvents()

usb_context = usb1.USBContext()
usb_poller = _PollerThread(usb_context)
usb_poller.start()
usb_handle = usb_context.openByVendorIDAndProductID(0x20b7, 0x9db1)
exit()
```

Closed 2023-10-29.

Thread 415 (2023-10-03):

Mention cases (3d-printable as well) in the documentation

whitequark, 2023-10-03:
Do we have design files for the aluminium ones shipped by CrowdSupply? That would be good to import in the repo too.

attie, 2023-10-07:
I'll review the current designs (3D print & laser cut) for compatibility with revC3

esden, 2023-10-08:
As discussed during the dev meeting today, the 1BitSquared aluminium case design will remain closed source. But I do want to work on a nice designed to be 3D printable case to contribute to the project as time allows.

Thread 417 (2023-10-04):

glasgow build also has importlib issues with python <3.10

txf-, 2023-10-04:
Using Python 3.9. I updated to the latest version and `glasgow --version` executes correctly:

```
PS C:\Users\Tiago\Documents\Git> glasgow.exe --version
Glasgow version 0.1.dev1827+g613cdc1 (Python 3.9.0)
```

I assume this is related to https://github.com/GlasgowEmbedded/glasgow/issues/408

```
PS C:\Users\Tiago\Documents\Git> glasgow build --rev C3 uart
Traceback (most recent call last):
  File "C:\Users\Tiago\.local\pipx\venvs\glasgow\lib\site-packages\importlib_metadata\__init__.py", line 292, in __getitem__
    return next(iter(self.select(name=name)))
StopIteration

During handling of the above exception, another exception occurred:

Traceback (most recent call last):
  File "c:\python39\lib\runpy.py", line 197, in _run_module_as_main
    return _run_code(code, main_globals, None,
  File "c:\python39\lib\runpy.py", line 87, in _run_code
    exec(code, run_globals)
  File "c:\users\tiago\.local\bin\glasgow.exe\__main__.py", line 7, in <module>
  File "C:\Users\Tiago\Documents\Git\glasgow\software\glasgow\cli.py", line 910, in main
    exit(loop.run_until_complete(_main()))
  File "c:\python39\lib\asyncio\base_events.py", line 642, in run_until_complete
    return future.result()
  File "C:\Users\Tiago\Documents\Git\glasgow\software\glasgow\cli.py", line 794, in _main
    target, applet = _applet(args.rev, args)
  File "C:\Users\Tiago\Documents\Git\glasgow\software\glasgow\cli.py", line 398, in _applet
    applet = GlasgowAppletMetadata.get(args.applet).applet_cls()
  File "C:\Users\Tiago\Documents\Git\glasgow\software\glasgow\support\plugin.py", line 70, in get
    return cls(importlib_metadata.entry_points(group=cls.GROUP_NAME, name=handle)[0])
  File "C:\Users\Tiago\.local\pipx\venvs\glasgow\lib\site-packages\importlib_metadata\__init__.py", line 294, in __getitem__
    raise KeyError(name)
KeyError: 0
```

Closed 2023-10-04.

Thread 422 (2023-10-04):

running Glasgow exectutable produces "TypeError: expected string or bytes-like object" in packaging\utils.py

txf-, 2023-10-04:
The example below is a build command but even just running `Glasgow` without any arguments, produces the same error. I updated to commit 62e27d9941bf22d1fdb73681af7eb74e96be775a. This is still on python 3.9.

```
PS C:\Users\Tiago\Documents\Git> glasgow build --rev C3 uart
Traceback (most recent call last):
  File "c:\python39\lib\runpy.py", line 197, in _run_module_as_main
    return _run_code(code, main_globals, None,
  File "c:\python39\lib\runpy.py", line 87, in _run_code
    exec(code, run_globals)
  File "c:\users\tiago\.local\bin\glasgow.exe\__main__.py", line 7, in <module>
  File "C:\Users\Tiago\Documents\Git\glasgow\software\glasgow\cli.py", line 910, in main
    exit(loop.run_until_complete(_main()))
  File "c:\python39\lib\asyncio\base_events.py", line 642, in run_until_complete
    return future.result()
  File "C:\Users\Tiago\Documents\Git\glasgow\software\glasgow\cli.py", line 490, in _main
    args = get_argparser().parse_args()
  File "C:\Users\Tiago\Documents\Git\glasgow\software\glasgow\cli.py", line 283, in get_argparser
    add_applet_arg(p_run, mode="interact", required=True)
  File "C:\Users\Tiago\Documents\Git\glasgow\software\glasgow\cli.py", line 128, in add_applet_arg
    for handle, metadata in GlasgowAppletMetadata.all().items():
  File "C:\Users\Tiago\Documents\Git\glasgow\software\glasgow\support\plugin.py", line 87, in all
    return {ep.name: cls(ep) for ep in _entry_points(group=cls.GROUP_NAME)}
  File "C:\Users\Tiago\Documents\Git\glasgow\software\glasgow\support\plugin.py", line 87, in <dictcomp>
    return {ep.name: cls(ep) for ep in _entry_points(group=cls.GROUP_NAME)}
  File "C:\Users\Tiago\Documents\Git\glasgow\software\glasgow\support\plugin.py", line 97, in __init__
    self.requirements = _requirements_for_optional_dependencies(
  File "C:\Users\Tiago\Documents\Git\glasgow\software\glasgow\support\plugin.py", line 31, in _requirements_for_optional_dependencies
    if requirement.marker and requirement.marker.evaluate({"extra": dependency}):
  File "C:\Users\Tiago\.local\pipx\venvs\glasgow\lib\site-packages\packaging\markers.py", line 252, in evaluate
    return _evaluate_markers(self._markers, current_environment)
  File "C:\Users\Tiago\.local\pipx\venvs\glasgow\lib\site-packages\packaging\markers.py", line 157, in _evaluate_markers
    lhs_value, rhs_value = _normalize(lhs_value, rhs_value, key=environment_key)
  File "C:\Users\Tiago\.local\pipx\venvs\glasgow\lib\site-packages\packaging\markers.py", line 131, in _normalize
    return tuple(canonicalize_name(v) for v in values)
  File "C:\Users\Tiago\.local\pipx\venvs\glasgow\lib\site-packages\packaging\markers.py", line 131, in <genexpr>
    return tuple(canonicalize_name(v) for v in values)
  File "C:\Users\Tiago\.local\pipx\venvs\glasgow\lib\site-packages\packaging\utils.py", line 47, in canonicalize_name
    value = _canonicalize_regex.sub("-", name).lower()
TypeError: expected string or bytes-like object
```

I did try forcing it to be string in plugin.py:
`if requirement.marker and requirement.marker.evaluate({"extra": str(dependency)}):`

but after doing so I get an issue with the aiohttp dependency (so I don't know if this was the right thing to do):

```
  File "C:\Users\Tiago\Documents\Git\glasgow\software\glasgow\applet\audio\yamaha_opx\__init__.py", line 143, in <module>
    import aiohttp, aiohttp.web
ModuleNotFoundError: No module named 'aiohttp'
```

Here is the full trace:

```
PS C:\Users\Tiago\Documents\Git> glasgow.exe --version
Traceback (most recent call last):
  File "c:\python39\lib\runpy.py", line 197, in _run_module_as_main
    return _run_code(code, main_globals, None,
  File "c:\python39\lib\runpy.py", line 87, in _run_code
    exec(code, run_globals)
  File "c:\users\tiago\.local\bin\glasgow.exe\__main__.py", line 7, in <module>
  File "C:\Users\Tiago\Documents\Git\glasgow\software\glasgow\cli.py", line 910, in main
    exit(loop.run_until_complete(_main()))
  File "c:\python39\lib\asyncio\base_events.py", line 642, in run_until_complete
    return future.result()
  File "C:\Users\Tiago\Documents\Git\glasgow\software\glasgow\cli.py", line 490, in _main
    args = get_argparser().parse_args()
  File "C:\Users\Tiago\Documents\Git\glasgow\software\glasgow\cli.py", line 283, in get_argparser
    add_applet_arg(p_run, mode="interact", required=True)
  File "C:\Users\Tiago\Documents\Git\glasgow\software\glasgow\cli.py", line 128, in add_applet_arg
    for handle, metadata in GlasgowAppletMetadata.all().items():
  File "C:\Users\Tiago\Documents\Git\glasgow\software\glasgow\support\plugin.py", line 87, in all
    return {ep.name: cls(ep) for ep in _entry_points(group=cls.GROUP_NAME)}
  File "C:\Users\Tiago\Documents\Git\glasgow\software\glasgow\support\plugin.py", line 87, in <dictcomp>
    return {ep.name: cls(ep) for ep in _entry_points(group=cls.GROUP_NAME)}
  File "C:\Users\Tiago\Documents\Git\glasgow\software\glasgow\support\plugin.py", line 103, in __init__
    self._cls = entry_point.load()
  File "c:\python39\lib\importlib\metadata.py", line 77, in load
    module = import_module(match.group('module'))
  File "c:\python39\lib\importlib\__init__.py", line 127, in import_module
    return _bootstrap._gcd_import(name[level:], package, level)
  File "<frozen importlib._bootstrap>", line 1030, in _gcd_import
  File "<frozen importlib._bootstrap>", line 1007, in _find_and_load
  File "<frozen importlib._bootstrap>", line 986, in _find_and_load_unlocked
  File "<frozen importlib._bootstrap>", line 680, in _load_unlocked
  File "<frozen importlib._bootstrap_external>", line 790, in exec_module
  File "<frozen importlib._bootstrap>", line 228, in _call_with_frames_removed
  File "C:\Users\Tiago\Documents\Git\glasgow\software\glasgow\applet\audio\yamaha_opx\__init__.py", line 143, in <module>
    import aiohttp, aiohttp.web
ModuleNotFoundError: No module named 'aiohttp'
```

whitequark, 2023-10-04:
Try again on commit https://github.com/GlasgowEmbedded/glasgow/commit/e4fd2dc22f9a48b633004cab0d749606a31e07a2?

txf-, 2023-10-04:
> Try again on commit [e4fd2dc](https://github.com/GlasgowEmbedded/glasgow/commit/e4fd2dc22f9a48b633004cab0d749606a31e07a2)?

Same issue as above.

whitequark, 2023-10-04:
What's your `packaging` version?

txf-, 2023-10-04:
In the venv packaging==23.2
At the global level packaging==21.3

whitequark, 2023-10-04:
@txf- Does it work fine if you revert https://github.com/GlasgowEmbedded/glasgow/commit/69d23bfa397b1a93440c48b0511417338ecc7d3c? I've not been able to reproduce it so far.

txf-, 2023-10-04:
> @txf- Does it work fine if you revert [69d23bf](https://github.com/GlasgowEmbedded/glasgow/commit/69d23bfa397b1a93440c48b0511417338ecc7d3c)?
It does not. Same issue.

ewenmcneill, 2023-10-07:
I also ran into this on Python 3.9, this time on Ubuntu 20.04 LTS.  But only found this bug when someone pointed it out.

After a *bunch* of debugging, I found I could work around the `TypeError` by coercing the `entry_point.extras` value from the `re.Match()` that was being returned, to a string, and then it worked fine.   My fix is *very* brute force, so I don't know if you want it upstream.  But maybe it inspires a solution.

FTR, I did try fixing it in `_entry_points()`, but unfortunately `entry_point.extras` is immutable, and I couldn't quickly figure out where `importlib.metadata.distributions()` was even getting that `re.Match()` from.   Hence the kludge in the patch below.

From notes in `#glasgow`:

```
(Pdb) p entry_point.name, entry_point.extras
('audio-yamaha-opx', [<re.Match object; span=(1, 5), match='http'>])
seems to be the trigger.  And audio-yamaha-opx has a [http] suffix on its pyproject.toml.
```

and there's a gist of my original traceback -- https://gist.github.com/ewenmcneill/c30b58a83e4768e537eaa35f2b74829e -- which at a glance looks the same as the one at the top of this issue.

Presumably this is a Python 3.9 `importlib` bug of some kind.  But I suspect while Python 3.9 support is being kept (another year or so?) it'll probably have to be worked around somehow.

FTR, I too had the `aiohttp` dependency issue.  Which I fixed with:

`pipx3.9 inject glasgow aiohttp`

and then later when I did the a reinstall to see if that fixed the issue, with:

`pipx3.9 install -e --verbose --spec 'glasgow/software[builtin-toolchain,http]' glasgow`

(note that the older pipx, eg, in Ubuntu 20.04 LTS, does need that `--spec .... glasgow` approach as its auto-detection of the package name from the "URL" otherwise fails badly, leading to it installing the venv, not finding the weirdly named package, and deleting the whole venv again :-/

Ewen

```
ewen@parthenon:/src/glasgow/software/glasgow/support$ git diff --cached
diff --git a/software/glasgow/support/plugin.py b/software/glasgow/support/plugin.py
index 8ef6631..8548bac 100644
--- a/software/glasgow/support/plugin.py
+++ b/software/glasgow/support/plugin.py
@@ -27,6 +27,10 @@ def _requirements_for_optional_dependencies(distribution, depencencies):
     requirements = map(packaging.requirements.Requirement, distribution.requires)
     selected_requirements = set()
     for dependency in depencencies:
+        import re
+        if isinstance(dependency, re.Match):
+            dependency = dependency.group(0)
+
         for requirement in requirements:
             if requirement.marker and requirement.marker.evaluate({"extra": dependency}):
                 requirement = packaging.requirements.Requirement(str(requirement))
ewen@parthenon:/src/glasgow/software/glasgow/support$
```

txf-, 2023-10-07:
I can confirm that the above fix works to fix this specific issue, `Glasgow --version` now works again. `Glasgow --build` does not, but that is a bug which is probably windows specific. I'll open a new report for that.

ewenmcneill, 2023-10-07:
FTR, this seems to be the `importlib` being loaded for me:

```
ewen@parthenon:/usr/local/share/pipx/venvs/glasgow$ . bin/activate
(glasgow) ewen@parthenon:/usr/local/share/pipx/venvs/glasgow$ python3.9
python3.9         python3.9-config
(glasgow) ewen@parthenon:/usr/local/share/pipx/venvs/glasgow$ python3.9
Python 3.9.5 (default, Nov 23 2021, 15:27:38)
[GCC 9.3.0] on linux
Type "help", "copyright", "credits" or "license" for more information.
>>> import importlib.metadata
>>> print(importlib.metadata.__file__)
/usr/lib/python3.9/importlib/metadata.py
>>>
```

so it seems to be part of the Python 3.9 upstream distribution.

Ewen

ewenmcneill, 2023-10-07:
Aha, there's a regex-over-a-regex-match to make the `extras` property:

```
    @property
    def extras(self):
        match = self.pattern.match(self.value)
        return re.findall(r'\w+', match.group('extras') or '')
```

at https://github.com/python/cpython/blob/43a6e4fa4934fcc0cbd83f7f3dc1b23a5f79f24b/Lib/importlib/metadata.py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 where the regex patterns are defined at https://github.com/python/cpython/blob/43a6e4fa4934fcc0cbd83f7f3dc1b23a5f79f24b/Lib/importlib/metadata.py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

So it's "expected" in Python 3.9 that it will return a `re.Match` :-(

Ewen

ewenmcneill, 2023-10-07:
Equivalent code in Python 3.10 is completely rearranged, but can be found at:

patterns: https://github.com/python/cpython/blob/97ce15c5f8743fb8b8967c6a05d6aec9fef9cbc7/Lib/importlib/metadata/__init__.py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

extras: https://github.com/python/cpython/blob/97ce15c5f8743fb8b8967c6a05d6aec9fef9cbc7/Lib/importlib/metadata/__init__.py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

and that doesn't obviously look *that* different, so I'm puzzled how this is a Python 3.9 specific bug.  Maybe only Python 3.9 is leaking the `audio-yamaha-opx` module into visibility?

Ewen

whitequark, 2023-10-07:
> Maybe only Python 3.9 is leaking the `audio-yamaha-opx` module into visibility?

This module relies on an optional `aiohttp` package, so that's why it's only happening with that module / that version.

txf-, 2023-10-07:
I went back and omitted the aiohttp injection and that still worked.

whitequark, 2023-10-07:
Nominating the issue for today's meeting; hopefully we'll be able to get a resolution there. (I still don't understand *why* it is happening, and this loading mechanism is a key part of Glasgow.)

ewenmcneill, 2023-10-07:
FTR, I wondered if it was only on *editable* (`-e`) glasgow installs on Python 3.9, but no it appears to happen on both editable and non-editable installs.  Either way (editable or not) the `audio-yamaha-opx` applet ends up being visible in the venv, and thus visible in `dist-info` `entry-points.txt` (which seems to be what is being parsed to find that `http` regex match.

AFAICT `list(re.finditer(r'\w+', match.group('extras') or ''))` is going to return a list of `re.Match()` objects, and that'll happen if there are any `extras`.  The only thing I don't understand is how this apparently doesn't happen with Python 3.10?!

Ewen

<details><summary>Python 3.9 pipx non-editable install, still fails with TypeError</summary>

```
ewen@parthenon:~$ cd /src
ewen@parthenon:/src$ rm -r "${PIPX_HOME}/venvs/glasgow" "${PIPX_BIN_DIR}/glasgow"
ewen@parthenon:/src$ which glasgow
ewen@parthenon:/src$ (cd glasgow && git status && git diff origin/main main && git log -1 --oneline)
On branch main
Your branch is up to date with 'origin/main'.

nothing to commit, working tree clean
f1e9185 (HEAD -> main, origin/main, origin/HEAD) manual: redirect from our domain to /latest/intro.html, not to the index.
ewen@parthenon:/src$ pipx3.9 install --spec 'glasgow/software[builtin-toolchain]' glasgow
  installed package glasgow 0.1.dev1874+gf1e9185, Python 3.9.5
  These binaries are now globally available
    - glasgow
done! ✨ 🌟 ✨
ewen@parthenon:/src$ which glasgow
/usr/local/share/pipx/bin/glasgow
ewen@parthenon:/src$ glasgow --version
Traceback (most recent call last):
  File "/usr/local/share/pipx/bin/glasgow", line 8, in <module>
    sys.exit(main())
  File "/usr/local/share/pipx/venvs/glasgow/lib/python3.9/site-packages/glasgow/cli.py", line 903, in main
    exit(loop.run_until_complete(_main()))
  File "/usr/lib/python3.9/asyncio/base_events.py", line 642, in run_until_complete
    return future.result()
  File "/usr/local/share/pipx/venvs/glasgow/lib/python3.9/site-packages/glasgow/cli.py", line 486, in _main
    args = get_argparser().parse_args()
  File "/usr/local/share/pipx/venvs/glasgow/lib/python3.9/site-packages/glasgow/cli.py", line 279, in get_argparser
    add_applet_arg(p_run, mode="interact", required=True)
  File "/usr/local/share/pipx/venvs/glasgow/lib/python3.9/site-packages/glasgow/cli.py", line 124, in add_applet_arg
    for handle, metadata in GlasgowAppletMetadata.all().items():
  File "/usr/local/share/pipx/venvs/glasgow/lib/python3.9/site-packages/glasgow/support/plugin.py", line 87, in all
    return {ep.name: cls(ep) for ep in _entry_points(group=cls.GROUP_NAME)}
  File "/usr/local/share/pipx/venvs/glasgow/lib/python3.9/site-packages/glasgow/support/plugin.py", line 87, in <dictcomp>
    return {ep.name: cls(ep) for ep in _entry_points(group=cls.GROUP_NAME)}
  File "/usr/local/share/pipx/venvs/glasgow/lib/python3.9/site-packages/glasgow/support/plugin.py", line 97, in __init__
    self.requirements = _requirements_for_optional_dependencies(
  File "/usr/local/share/pipx/venvs/glasgow/lib/python3.9/site-packages/glasgow/support/plugin.py", line 31, in _requirements_for_optional_dependencies
    if requirement.marker and requirement.marker.evaluate({"extra": dependency}):
  File "/usr/local/share/pipx/venvs/glasgow/lib/python3.9/site-packages/packaging/markers.py", line 252, in evaluate
    return _evaluate_markers(self._markers, current_environment)
  File "/usr/local/share/pipx/venvs/glasgow/lib/python3.9/site-packages/packaging/markers.py", line 157, in _evaluate_markers
    lhs_value, rhs_value = _normalize(lhs_value, rhs_value, key=environment_key)
  File "/usr/local/share/pipx/venvs/glasgow/lib/python3.9/site-packages/packaging/markers.py", line 131, in _normalize
    return tuple(canonicalize_name(v) for v in values)
  File "/usr/local/share/pipx/venvs/glasgow/lib/python3.9/site-packages/packaging/markers.py", line 131, in <genexpr>
    return tuple(canonicalize_name(v) for v in values)
  File "/usr/local/share/pipx/venvs/glasgow/lib/python3.9/site-packages/packaging/utils.py", line 47, in canonicalize_name
    value = _canonicalize_regex.sub("-", name).lower()
TypeError: expected string or bytes-like object
ewen@parthenon:/src$
ewen@parthenon:/src$ cd "${PIPX_HOME}/venvs/glasgow/lib/python3.9/site-packages/"
ewen@parthenon:/usr/local/share/pipx/venvs/glasgow/lib/python3.9/site-packages$ grep yamaha glasgow*dist-info/*entry*
audio-yamaha-opx = glasgow.applet.audio.yamaha_opx:AudioYamahaOPxApplet [http]
ewen@parthenon:/usr/local/share/pipx/venvs/glasgow/lib/python3.9/site-packages$ ls glasgow/applet/audio/yamaha_opx/
index.html  __init__.py  __pycache__
ewen@parthenon:/usr/local/share/pipx/venvs/glasgow/lib/python3.9/site-packages$
```
</details>

<details><summary>pdb on Python 3.9 importlib extras</summary>

```
ewen@parthenon:~$ . "${PIPX_HOME}/venvs/glasgow/bin/activate"
(glasgow) ewen@parthenon:~$ python3.9 -m pdb "${PIPX_BIN_DIR}/glasgow" --version
> /usr/local/share/pipx/venvs/glasgow/bin/glasgow(3)<module>()
-> import re
(Pdb) b /usr/lib/python3.9/importlib/metadata.py:93
Breakpoint 1 at /usr/lib/python3.9/importlib/metadata.py:93
(Pdb) c
> /usr/lib/python3.9/importlib/metadata.py(93)extras()
-> match = self.pattern.match(self.value)
(Pdb) p self.value
'glasgow.applet.interface.analyzer:AnalyzerApplet'
(Pdb) c
> /usr/lib/python3.9/importlib/metadata.py(93)extras()
-> match = self.pattern.match(self.value)
(Pdb) p self.value
'glasgow.applet.audio.dac:AudioDACApplet'
(Pdb) c
> /usr/lib/python3.9/importlib/metadata.py(93)extras()
-> match = self.pattern.match(self.value)
(Pdb) p self.value
'glasgow.applet.audio.yamaha_opx:AudioYamahaOPxApplet [http]'
(Pdb) n
> /usr/lib/python3.9/importlib/metadata.py(94)extras()
-> return list(re.finditer(r'\w+', match.group('extras') or ''))
(Pdb) p match
<re.Match object; span=(0, 59), match='glasgow.applet.audio.yamaha_opx:AudioYamahaOPxApp>
(Pdb) p match.group('extras')
'[http]'
(Pdb) p list(re.finditer(r'\w+', match.group('extras') or ''))
[<re.Match object; span=(1, 5), match='http'>]
(Pdb)
```
</details>

ewenmcneill, 2023-10-07:
> **ETA**: [Python 3.12 re.findall()](https://docs.python.org/3/library/re.html#re.findall) suggests `re.finditer()` will return `re.Match` objects, and `re.findall()` will return strings. Which seems to [be fairly similar in Python 3.9 re.findall() and re.finditer()](https://docs.python.org/3.9/library/re.html#re.findall). But the code _being run_ according to the debugger is `re.finditer()`...

Oh no.

```
ewen@parthenon:~$ grep -A 3 "def extras" /usr/lib/python3.9/importlib/metadata.py
    def extras(self):
        match = self.pattern.match(self.value)
        return list(re.finditer(r'\w+', match.group('extras') or ''))

ewen@parthenon:~$
```

which *does not* match the Python 3.9.latest I found in GitHub last night (in https://github.com/GlasgowEmbedded/glasgow/issues/422#issuecomment-1751663261), which is:

```
    @property
    def extras(self):
        match = self.pattern.match(self.value)
        return re.findall(r'\w+', match.group('extras') or '')
```

in https://github.com/python/cpython/blob/43a6e4fa4934fcc0cbd83f7f3dc1b23a5f79f24b/Lib/importlib/metadata.py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

And the reason it doesn't match is https://github.com/python/cpython/issues/91160, which backported some `importlib_metadata` fixes to Python 3.9..... which leads us to *this exact problem* reported in 2022: https://github.com/python/importlib_metadata/issues/369, and this `importlib_metadata` fix that switched to `re.findall()` -- https://github.com/python/importlib_metadata/commit/14cce75299645467adcd17352cb07caada32c444

Relevant Python upstream bug for the backports is https://bugs.python.org/issue47004.   Looks like the relevant backport was merged around 2022-03-13.  Looks like that backport *is* in [Python 3.9.12 (released 2022-03-23)](https://www.python.org/downloads/release/python-3912/), see:

https://github.com/python/cpython/blob/v3.9.12/Lib/importlib/metadata.py#L100-L103

So AFAICT this issue affects Python 3.9 <= 3.9.11 :-(

And TBH, it's possibly best fixed by hand patching `python3.9/importlib/metadata.py`.

Ewen

attie, 2023-10-07:
Good/bad:

- `3.9.5` bad (see Ubuntu 20.04 LTS)

whitequark, 2023-10-08:
Reach heaven by violence. https://github.com/GlasgowEmbedded/glasgow/pull/436

ewenmcneill, 2023-10-08:
Thank you for "fixing" this (monkeypatching FTW!); works for me on Ubuntu 20.04 LTS with Python 3.9.5 from Universe.

```
ewen@parthenon:/src$ grep VERSION= /etc/os-release; glasgow --version
VERSION="20.04.6 LTS (Focal Fossa)"
Glasgow version 0.1.dev1879+g42b7086 (Python 3.9.5)
ewen@parthenon:/src$ (cd glasgow && git log -1 --oneline)
42b7086 (HEAD -> main, origin/main, origin/HEAD) support.plugin: add workaround for defect in Python 3.9 <3.9.11.
ewen@parthenon:/src$
```

For anyone finding this in future, my Ubuntu 20.04 LTS install was done by:

1.  Enabling "universe" repo if it is not already enabled
2.  Installing python 3.9.5  from Ubuntu 20.04 universe, and an old packaged pipx:

`sudo apt-get install python3.9 python3.9-venv python3.9-dev python3-pip pipx`

3.  Updating the pipx for a python3.9 option removal:

`sudo vi /usr/lib/python3/dist-packages/pipx/Venv.py`

and in `_venv_metadata_for_package()`, comment out the:

`encoding="utf-8"`

which was removed from Python3.9.   (Or alternatively pick some other way to install a much more recent pipx, and have a nicer time as the main glasgow instructions are more likely to work for you.)

3.  Using this pipx command instead of the one in the main instructions, due to (a) needing to override the Python version, and (b) the old pipx not supporting the all of the current features:

`python3.9 /usr/bin/pipx install -e --verbose --spec 'glasgow/software[builtin-toolchain,http]' glasgow`

(You *may* be able to leave `,http` out; it pulls in the extra dependencies for the extra applet which was triggering this bug.)

All going well you should then be  able to run `glasgow --version` and get output like the above.

Ewen

whitequark, 2023-10-08:
> Or alternatively pick some other way to install a much more recent pipx, and have a nicer time as the main glasgow instructions are more likely to work for you

I think you should be able to `sudo pip install pipx` or something like that?

ewenmcneill, 2023-10-09:
> I think you should be able to `sudo pip install pipx` or something like that?

Yes, the Python in Ubuntu 20.04 LTS (both 3.8, and universe 3.9.5) seems to be old enough not to complain about doing system-wide installs into the "managed Python".

This combination seems to work for me in an Ubuntu 20.04 LTS test docker run (although in the `ubuntu:20.04` docker image you do have to do `apt-get update && apt-get install sudo` first).

```
sudo apt-get update
sudo apt-get install python3.9 python3-pip python3.9-venv git
sudo python3.9 -m pip install pipx
python3.9 /usr/local/bin/pipx ensurepath
git clone https://github.com/GlasgowEmbedded/glasgow
python3.9 /usr/local/bin/pipx install -e --verbose 'glasgow/software[builtin-toolchain,http]'
glasgow --version
```

Note in particular that the `pipx` install syntax has changed from the "using old Ubuntu 20.40 packaged python-pipx" because the old pipx doesn't work with the new command line syntax (cannot find package, removes venv), and the new pipx from PyPI doesn't understand the old `--spec` arguments.  Apparently backwards compatibility is hard :-/

But as a general recommendation to Ubuntu 20.04 LTS users, using the pipx from PyPI is going to be a *much* nicer experience, as there seems to be a heap of changes in the least 3-4 years.  (In particularly the old packaged python-pipx doesn't know about `pipx reinstall PACKAGE` either.)

Ewen

Closed 2023-10-08.

Thread 441 (2023-10-09):

udev rules on Arch(-ish) systems

Manawyrm, 2023-10-09:
Hi,

I've just tried to setup the glasgow on an Arch machine.
The file glasgow/config/99-glasgow.rules uses the plugdev-group, which doesn't exist on Arch.

Possible solutions:
- use a different group (although I don't have a good suggestion)
- create the plugdev group and add the user

The readme also seems to be missing the
```bash
sudo udevadm control --reload
```
step, as well as a more explicit hint to re-plug the device after this (to apply the new permissions).

ewenmcneill, 2023-10-10:
Yes, I'd also suggest adding `sudo udevadm control --reload` to the documentation (AFAICT some systems will do it based on inotify of file writes, and some systems won't).

There's also `sudo udevadm trigger` (which can take options to match to a specific device, but I've not looked up the exact Glasgow match).  The "trigger" will reapply the updated udev rules to an already plugged in device, as if it was plugged in again.  It might be worth suggesting that rather than needing people to unplug/replug the device.

IIRC `plugdev` as a group is a Debian / Ubuntu thing.  I'm not quickly finding it on some RHEL / CentOS systems I've checked either (and online references suggest it won't be on Fedora either).   I'm not sure what other group name would be common across all Linux that would make sense here; `dialout` is a bit more common across Linux distros, but not really the right group (it's intended for serial TTYs).  Possibly the `sudo` group which is somewhat common across distros?   (For reference [Debian System Groups](https://wiki.debian.org/SystemGroups).)

Ewen

whitequark, 2023-10-11:
One of the issues here is that `TAG+="uaccess"`, which is the mechanism that's supposed to replace static groups, doesn't work on my (Debian) system for unknown reasons [and is undocumented](https://github.com/systemd/systemd/issues/4288), like is usual for systemd. Someone who isn't me is going to deal with that.

(Actually, looking at [this description](https://lists.debian.org/debian-devel/2022/03/msg00144.html) it would simply not work unless you relogin to your desktop, which is insane, and so I hope the description is wrong.)

I'm going to close this issue because I don't want to deal with broken and undocumented systemd stuff. Anyone who has a demonstrably working solution is welcome to offer a PR updating the udev rules. If the current state of udev rules is unsatisfying (due to missing `plugdev` group) I offer `MODE:="0666"` though since the Glasgow hardware is FX2-based this can probably effectively give a determined attacker root (e.g. by making it re-enumerate as a keyboard and hijacking a `sudo` invocation or something like that) and it's probably not something that should be done on shared machines.

I've opened #442 to track the addition of `udevadm` command, which seems incontroversial and simple.

whitequark, 2023-10-11:
Looking carefully at Debian's [SystemGroups](https://wiki.debian.org/SystemGroups) page it seems that our current use of the plugdev group is actually a misuse, since it's not a disk:

> plugdev: Allows members to mount (only with the options nodev and nosuid, for security reasons) and umount removable devices through pmount.

What a mess.

whitequark, 2023-10-11:
I made some progress in figuring out what went wrong with `TAG+="uaccess"`: it looks like it also needs `TAG+="udev-acl"`:

    SUBSYSTEM=="usb", ATTRS{idVendor}=="20b7", ATTRS{idProduct}=="9db1", TAG+="uaccess", TAG+="udev-acl"

With this rules file, the device does get an ACL applied:

```
$ getfacl /dev/bus/usb/001/004
getfacl: Removing leading '/' from absolute path names
# file: dev/bus/usb/001/004
# owner: root
# group: plugdev
user::rw-
user:whitequark:rw-
group::rw-
mask::rw-
other::r--
```

but it's still not accessible:

```
$ glasgow list
Traceback (most recent call last):
  File "/home/whitequark/.local/bin/glasgow", line 8, in <module>
    sys.exit(main())
             ^^^^^^
  File "/home/whitequark/Projects/glasgow/software/glasgow/cli.py", line 919, in main
    exit(loop.run_until_complete(_main()))
         ^^^^^^^^^^^^^^^^^^^^^^^^^^^^^^^^
  File "/usr/lib/python3.11/asyncio/base_events.py", line 653, in run_until_complete
    return future.result()
           ^^^^^^^^^^^^^^^
  File "/home/whitequark/Projects/glasgow/software/glasgow/cli.py", line 882, in _main
    for serial in sorted(GlasgowHardwareDevice.enumerate_serials()):
                         ^^^^^^^^^^^^^^^^^^^^^^^^^^^^^^^^^^^^^^^^^
  File "/home/whitequark/Projects/glasgow/software/glasgow/device/hardware.py", line 171, in enumerate_serials
    devices = cls._enumerate_devices(usb_context)
              ^^^^^^^^^^^^^^^^^^^^^^^^^^^^^^^^^^^
  File "/home/whitequark/Projects/glasgow/software/glasgow/device/hardware.py", line 92, in _enumerate_devices
    handle = device.open()
             ^^^^^^^^^^^^^
  File "/home/whitequark/.local/pipx/venvs/glasgow/lib/python3.11/site-packages/usb1/__init__.py", line 2055, in open
    mayRaiseUSBError(libusb1.libusb_open(self.device_p, byref(handle)))
  File "/home/whitequark/.local/pipx/venvs/glasgow/lib/python3.11/site-packages/usb1/__init__.py", line 127, in mayRaiseUSBError
    __raiseUSBError(value)
  File "/home/whitequark/.local/pipx/venvs/glasgow/lib/python3.11/site-packages/usb1/__init__.py", line 119, in raiseUSBError
    raise __STATUS_TO_EXCEPTION_DICT.get(value, __USBError)(value)
usb1.USBErrorAccess: LIBUSB_ERROR_ACCESS [-3]
```

Why? Who knows
```

whitequark, 2023-10-11:
> ```
> usb1.USBErrorAccess: LIBUSB_ERROR_ACCESS [-3]
> ```

(This error message is terrible, I've fixed it in #442)

whitequark, 2023-10-11:
> I made some progress in figuring out what went wrong with `TAG+="uaccess"`: it looks like it also needs `TAG+="udev-acl"`:

What's weird is that the Debian rules apply the `plugdev` group to the /dev/bus/usb device file whenever both of those tags are present, which seems to contradict Debian's own wiki on which devices should go to `plugdev`.

whitequark, 2023-10-11:
Okay, I figured this mess out. It's all in #442.

collinmay, 2025-05-02:
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

Actually insane behavior from systemd here. Because this is so non-intuitive and it's easy to miss this when skimming docs, would you accept a PR to make the error message from `glasgow` software elaborate that this behavior exists?

collinmay, 2025-05-02:
Maybe also or instead add comments to the udev rule file explaining that A: it needs to be ordered before uaccess rule and B: uaccess has weird behavior with being physically logged in. That also would've saved me a lot of troubleshooting time since udev rule was the first place I looked for something wrong.

whitequark, 2025-05-17:
@collinmay Does this look good? https://github.com/GlasgowEmbedded/glasgow/pull/815

Closed 2023-10-18.

Thread 447 (2023-10-20):

Extract test code from each applet to a separate `test.py` file

whitequark, 2023-10-20:
While the "one file per applet" paradigm was nice for a while, we have outgrown it, and the new directory structure reflects that already. Having tests in the main applet file breaks test discovery with just about any Python test framework. We should have tests in the `glasgow/applet/<category>/<name>/test.py`, next to `glasgow/applet/<category>/<name>/__init__.py` which contains the applet itself.

whitequark, 2023-10-20:
Note that this will need some additional work to unbreak `glasgow test`, which I will do once the mechanical part of this issue (the conversion to multi-file structure) is done.

Closed 2023-10-21.

Thread 459 (2023-10-22):

Documentation: REPL: suggestions for UART example

ewenmcneill, 2023-10-22:
(I started writing this as a comment on https://github.com/GlasgowEmbedded/glasgow/issues/312 but it got long, so I've made it its own issue)

Re https://glasgow-embedded.org/latest/use/repl-script.html#uart which i had a look at because Attie mentioned it in today's meeting, experimenting with it, it appears that the default `iface.read()` will read "whatever is available, possibly nothing": see https://github.com/GlasgowEmbedded/glasgow/blob/05c44bd0ff7fc051c08a942ed6c18cf0b0f8de20/software/glasgow/access/direct/demultiplexer.py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 with the default `length=None`.  Which means as presented the example is a bit racey (I started looking into this as on my second write/read cycle in a run I got a partial return, even with "types by hand" delays, and while experimenting I got an empty byte string even after writing bytes).

It might be worth adding a note to the UART REPL example in the documentation to the effect that `iface.read()` will return "whatever is immediately available, which might not be the whole message as shown in the example".  Or perhaps explicitly calling `iface.read(length=6)` to force reading all bytes expected to be returned for more user-reproducibility.   (FTR, I wasn't that surprised by the short read, given it's a byte oriented serial line; but I was a bit surprised by having an `iface.read()` finish returning a zero length byte string when I had written something.)

Relatedly, `help(iface)` doesn't include any description of how the `length` parameter is interpreted on `read()`, which might be worth adding.  Eg, "if length is omitted or None returns data immediately available; otherwise waits until required number of bytes have been received".  Which I think would be a doc string on `glasglow.access.direct.demultiplexer.DirectDemultiplexerInterface.read()` since AFAICT that's what the REPL user is encouraged to use for interactive help:

```
ewen@parthenon:~$ glasgow repl uart -V 3.3
I: g.device.hardware: device already has bitstream ID d45fa78180875415078a05fcec3dd124
I: g.cli: running handler for applet 'uart'
I: g.applet.interface.uart: port(s) A, B voltage set to 3.3 V
I: g.applet.interface.uart: dropping to REPL; use 'help(iface)' to see available APIs
>>> type(iface)
<class 'glasgow.access.direct.demultiplexer.DirectDemultiplexerInterface'>
>>>
```

**ETA**: Example of the "zero bytes read" read (in this case on the same command line, to make it faster to reproduce; but I did also get this with "up arrow, run again" one command per command line earlier):

<details><summary>UART REPL example showing some racey behaviour</summary>

```
>>> await iface.write(b'hello!')
>>> await iface.read()
<memory at 0x7fc93eac31c0>
>>> bytes(_)
b'hello!'
>>> await iface.write(b'hello!')
>>> await iface.read()
<memory at 0x7fc93eac3400>
>>> bytes(_)
b'hello!'
>>> await iface.write(b'hello!'); await iface.read(); bytes(_)
<memory at 0x7fc93eb5cd00>
b''
>>> await iface.write(b'hello!'); await iface.read(); bytes(_)
<memory at 0x7fc93eac3c40>
b'hello!'
>>> await iface.write(b'hello!'); await iface.read(); bytes(_)
<memory at 0x7fc93ea9f100>
b'hello!'
>>> await iface.read()
<memory at 0x7fc93ea9f4c0>
>>> bytes(_)
b'hello!'
>>>
```
</details>

(Note also the final `iface.read()` which caught up on the outstanding message.)

<details><summary>Example of partial message reads, including parts of two messages</summary>

```
>>> await iface.write(b'Hello World!')
>>> await iface.read()
<memory at 0x7fc93eac7400>
>>> bytes(_)
b'Hello World!'
>>> await iface.write(b'Hello World!')
>>> await iface.read()
<memory at 0x7fc93ea9fc40>
>>> bytes(_)
b'He'
>>> await iface.write(b'Hello World!')
>>> await iface.read()
<memory at 0x7fc93eacba00>
>>> bytes(_)
b'llo World!Hello Wo'
>>> await iface.read()
<memory at 0x7fc93eac71c0>
>>> bytes(_)
b'rld!'
>>>
```
</details>

(FTR, all of this is expected, but IMHO should be documented as expected to avoid user surprise.)

whitequark, 2023-10-22:
The UART should simply not return a `DirectDemultiplexerInterface` directly. In our chat I have called that out as incorrect and we should fix this instead of messing with documentation.

whitequark, 2025-05-20:
This has been implemented some time ago, the UART applet now follows the usual structure with `UARTInterface`.

Closed 2025-05-20.

Thread 460 (2023-10-22):

=

whitequark, 2023-10-22:
[This issue contains a draft of an RFC. It is not actionable yet and is published only to promote discussion.]

The existing pin management system is extremely ugly and hard to use and should go. At some point I thought this would be possible to address with a complete rewrite of our *argument parsing* system but at this point this is clearly infeasible and a more iterative approach is needed.

The requirements for a pin management system are:
* Is declarative (with an additional imperative validation layer; answering the question of "is this pin config valid?" but not "which pin config do these options result in?");
* Is based on Python code (at least for the time being, so far as we continue to allow implementing an applet as a single Python file);
* Is built to integrate with Amaranth components from the `lib.wiring` library;
* Allows the use of complex I/O buffering schemes (with clocked buffers, including tristate clocked buffers) while not requiring undue boilerplate for simple ones ("just give me this pin as an input/output/tristate");
* Namespaced, allowing multiple applets to share pins without fear of name conflicts (for cases such as multiple simultaneous applets, or a single applet instantiating two SPI interfaces in parallel);
* Composable and/or extensible, allowing an applet to instantiate another applet's subtarget with additional sideband pins (by far most common case of this being "SPI plus a bunch of other signals"), with minimal or no boilerplate requierd to hook up these sideband pins to the subtarget;
* Introspectable, allowing to render the pin configuration as JSON or human readable text;
* (Covered by the above goals, but an explicit goal in itself:) Possible to eventually use from a GUI configuration tool.

[To be continued in the future.]

whitequark, 2023-10-22:
(The issue is locked to allow edits by @GlasgowEmbedded/maintainers only, for the time being. It will be unlocked once the draft is finished.)

whitequark, 2025-05-10:
PR #598 has achieved several of the stated goals in full: it integrates with Amaranth standard library components (`lib.io` and `lib.wiring`), it allows the use of complex IO buffering schemes without requiring too much boilerplate, and it lets an applet to instantaite a subtarget of another applt while passing it a port group or its subset.

(We might want to have a slicing operation for port groups, but this might make more sense to do upstream in Amaranth.)

whitequark, 2025-05-10:
This issue should now be focused on the applet DX/UI concerns, as the backend concerns are fully or almost fully addressed. I'm happy to hear suggestions!

Thread 469 (2023-10-24):

[RFC] Use Nix instead of Docker for reproducible firmware builds

whitequark, 2023-10-24:
As of revision https://github.com/GlasgowEmbedded/glasgow/commit/8bf630516861843c8ad45e3d6086b985a864aca7 we are using Docker to build the firmware in a bit-for-bit reproducible way. An alternative way of doing this is by using Nix, suggested by @tpwrules. The advantages and disadvantages respectively are:

Docker:
* Advantage: most people already have it and many know (begrudgingly) how to use it
* Disadvantage: apt-get is used in the build script, requiring network access each time it is used, and potentially enabling impurity
  * While it is possible that a new upstream version of sdcc would be uploaded in the Debian package repository for the same release, this has never happened in the entire history of sdcc in debian.
  * It is possible to use https://snapshot.debian.org/ to work around that but that is not currently the case
* Disadvantage: this particular style of using Docker is unidiomatic

Nix:
* Advantage: unquestionably reproducible builds that are entirely offline
* Disadvantage: less widely known and understood system
  * This is not a maintenance concern because the script being used is very straightforward (see below)
* Disadvantage: installer in distro repositories can be outdated and potentially cause issues
  * Doesn't seem to be the case for the (seemingly widely maligned) Debian nix package

We should pick one or the other, but not both.

Nix-based replacement script (by @tpwrules):

```shell
#!/usr/bin/env nix-shell
#! nix-shell --pure -i bash -p sdcc -p git
#! nix-shell -I nixpkgs=https://github.com/NixOS/nixpkgs/archive/5550a85a087c04ddcace7f892b0bdc9d8bb080c8.tar.gz

# Display dependency versions.
sdcc --version

# Clean all build products; they may have been built using a different compiler.
make -C vendor/libfx2/firmware/library clean
make -C firmware clean

# Build the artifact.
make -C vendor/libfx2/firmware/library all MODELS=medium
make -C firmware all

# Deploy the artifact.
cp firmware/glasgow.ihex software/glasgow/device/firmware.ihex
```

whitequark, 2024-03-06:
To move this forward we'd need to write a user guide for this and integrate it with GitHub actions. I'm not really sure if "install Nix first" is a great thing to have in our guide for firmware developers...

tpwrules, 2024-03-06:
It was my understanding that this was only to be for the builds to be committed to the repo, which individual developers would not be generating anyway, so developers would not be required to use Nix. For what it's worth, I would have to install Docker first to use the current script.

I'd be okay with dropping this, I think it's neat and a nicer way but not mandatory. There are some minor tweaks to do for long term robustness but I haven't had this in the front of my mind. Using Nix with GHA is not a problem but I'm not really sure what an action to e.g. automatically build and commit the firmware would look like.

whitequark, 2024-03-06:
> It was my understanding that this was only to be for the builds to be committed to the repo, which individual developers would not be generating anyway

No, you actually have to use Docker/Nix when [deploying firmware](https://glasgow-embedded.org/latest/develop/firmware.html#deploying-firmware).

tpwrules, 2024-03-06:
I propose we keep the current Docker-based setup and keep this in the back of our minds for if there are problems down the line. It seems pretty unlikely to cause reproducibility problems, I think mostly the choice would have to do with ergonomics.

whitequark, 2024-03-06:
Souunds good to me. Thanks for the effort! I did appreciate seeing how flexible Nix can be.

Closed 2024-03-06.

Thread 484 (2023-10-29):

A CLI command to create a directory tree for a new out of tree applet

whitequark, 2023-10-29:
Once we enable the general use of out of tree applets (which should be possible soon, as long as we figure out API versioning and make it exceedingly clear that the current API is unstable and will be regularly broken without warning), we should add a command for creating a new out-of-tree applet (with the right dependencies, and a template filled in with the user's provided name) that also prints (or includes in the applet source tree) instructions for its use.

whitequark, 2025-05-20:
Not clear if anybody actually wants this—we can revisit the idea if there's demand.

Closed 2025-05-20.

Thread 511 (2024-01-13):

jtag-probe: JEDEC manufacturer lookup fails for bank 15

neuschaefer, 2024-01-13:
I am trying to scan a device with IDCODE=0x07926f0f, manufacturer=0x787, but `jedec_mfg_name_from_bank_num` fails:

```
$ glasgow run jtag-probe -V 3.3 --pin-tck 3 --pin-tms 2 --pin-tdi 1 --pin-tdo 4 --pin-trst 0 scan
I: g.device.hardware: device already has bitstream ID e999b72415fd3441a20e233ca2a839d9
I: g.cli: running handler for applet 'jtag-probe'
I: g.applet.interface.jtag_probe: port(s) A, B voltage set to 3.3 V
I: g.applet.interface.jtag_probe: shifted 32-bit DR=<11110000111101100100100111100000>
I: g.applet.interface.jtag_probe: shifted 4-bit IR=<1000>
I: g.applet.interface.jtag_probe: discovered 1 TAPs
Traceback (most recent call last):
  File "/.../bin/glasgow", line 8, in <module>
    sys.exit(main())
             ^^^^^^
  File "/.../glasgow/software/glasgow/cli.py", line 937, in main
    exit(loop.run_until_complete(_main()))
         ^^^^^^^^^^^^^^^^^^^^^^^^^^^^^^^^
  File "/usr/lib/python3.11/asyncio/base_events.py", line 653, in run_until_complete
    return future.result()
           ^^^^^^^^^^^^^^^
  File "/home/jn/dev/fpga/glasgow/software/glasgow/cli.py", line 707, in _main
    return applet_task.result()
           ^^^^^^^^^^^^^^^^^^^^
  File "/home/jn/dev/fpga/glasgow/software/glasgow/cli.py", line 656, in run_applet
    return await applet.interact(device, args, iface)
           ^^^^^^^^^^^^^^^^^^^^^^^^^^^^^^^^^^^^^^^^^^
  File "/home/jn/dev/fpga/glasgow/software/glasgow/applet/interface/jtag_probe/__init__.py", line 1039, in interact
    mfg_name = jedec_mfg_name_from_bank_num(idcode.mfg_id >> 7,
               ^^^^^^^^^^^^^^^^^^^^^^^^^^^^^^^^^^^^^^^^^^^^^^^^
  File "/home/jn/dev/fpga/glasgow/software/glasgow/database/jedec.py", line 18, in jedec_mfg_name_from_bank_num
    for (number, name, code) in _manufacturers[bank]:
                                ~~~~~~~~~~~~~~^^^^^^
IndexError: list index out of range
```

The `_manufacturers` array contains bank 1 to bank 15, which amounts to 15 banks (not 16), so bank 15 is out of bounds.

I suspect that the JEP106 conversion script might have an off-by-one error and generate one too few entries, but I might also be misunderstanding how these manufacturer IDs and banks work.

wanda-phi, 2024-01-13:
There isn't an off by one in the code; the problem is that new manufacturer IDs have been added since the last update of the database in Glasgow, and the code deals badly with an out-of-bounds bank number (which I fix in #512).

I'd gladly update the database if you can point me to a newer version of JEP106 PDF.

wanda-phi, 2024-01-13:
Oh huh. The PDF is actually a free download. I'll just update the database then.

neuschaefer, 2024-01-13:
Thanks for the fix in #512.

The device that I'm scanning isn't particularly new (so the update doesn't help me in this case), I think it just reports a bogus manufacturer ID.

Closed 2024-01-13.

Thread 541 (2024-03-22):

Failing to build applets on Windows 10

GMMan, 2024-03-22:
As suggested in the initial setup instructions in the readme, when I run `glasgow build --rev C3 uart`, I get the following output:

<details>
<summary>Console output</summary>

```
PS C:\projects\glasgow> glasgow build --rev C3 uart
I: glasgow.cli: generating bitstream for applet 'uart'
Fatal Python error: _Py_HashRandomization_Init: failed to get random numbers to initialize Python
Python runtime state: preinitialized

Traceback (most recent call last):
  File "C:\Users\cyanic\AppData\Local\Programs\Python\Python39\Lib\runpy.py", line 197, in _run_module_as_main
    return _run_code(code, main_globals, None,
  File "C:\Users\cyanic\AppData\Local\Programs\Python\Python39\Lib\runpy.py", line 87, in _run_code
    exec(code, run_globals)
  File "c:\users\cyanic\.local\bin\glasgow.exe\__main__.py", line 7, in <module>
  File "C:\projects\glasgow\glasgow\software\glasgow\cli.py", line 937, in main
    exit(loop.run_until_complete(_main()))
  File "C:\Users\cyanic\AppData\Local\Programs\Python\Python39\Lib\asyncio\base_events.py", line 642, in run_until_complete
    return future.result()
  File "C:\projects\glasgow\glasgow\software\glasgow\cli.py", line 833, in _main
    f.write(plan.get_bitstream())
  File "C:\projects\glasgow\glasgow\software\glasgow\target\hardware.py", line 170, in get_bitstream
    bitstream_data = self.execute(debug=debug)
  File "C:\projects\glasgow\glasgow\software\glasgow\target\hardware.py", line 144, in execute
    products  = self.lower.execute_local(build_dir, env=environ)
  File "C:\Users\cyanic\AppData\Local\pipx\pipx\venvs\glasgow\lib\site-packages\amaranth\build\run.py", line 101, in execute_local
    subprocess.check_call(["cmd", "/c", f"call {self.script}.bat"],
  File "C:\Users\cyanic\AppData\Local\Programs\Python\Python39\Lib\subprocess.py", line 373, in check_call
    raise CalledProcessError(retcode, cmd)
subprocess.CalledProcessError: Command '['cmd', '/c', 'call build_top.bat']' returned non-zero exit status 1.
```
</details>

The error is `Fatal Python error: _Py_HashRandomization_Init: failed to get random numbers to initialize Python`. [Researching this][1], it seems the executing environment variables are not reproduced, and missing `SYSTEMROOT` causes issues when running Python. I suggest adding `SYSTEMROOT` to child process envs, like it was done in #384.

[1]: https://stackoverflow.com/a/64706392/1180879

Closed 2024-03-22.

Thread 550 (2024-04-01):

`glasgow run benchmark source` fails on Windows

bburky, 2024-04-01:
On a Windows 11 computer I'm seeing `glasgow run benchmark source` fail:
```
I: glasgow.cli: running handler for applet 'benchmark'
I: glasgow.applet.internal.benchmark: running benchmark mode source for 8.000 MiB
E: glasgow.applet.internal.benchmark: mode source failed!
```

Very rarely, it sometimes succeeds:
```
I: glasgow.applet.internal.benchmark: running benchmark mode source for 8.000 MiB
I: glasgow.applet.internal.benchmark: mode source: 37.70 MiB/s (301.61 Mb/s)
```

After comparing the `actual` vs `golden` data, it seems there is a 0x400 offset to the test pattern in the `actual` data. It would seem some initial data is getting lost somehow?

(A future improvement to the benchmark test might be to send the requested length from Python to the FPGA, and have it refuse to send more than the requested amount of data. This likely would have caused an unexpectedly short read in this case, and may have made the bug more visible initially.)

If I comment out `iface.reset()` here, it consistently works fine (I don't know what the impact of removing the `reset()` call is though):
https://github.com/GlasgowEmbedded/glasgow/blob/2b01503bb516397910ad83948d86aed0c08460d5/software/glasgow/applet/internal/benchmark/__init__.py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

Does `DirectDemultiplexer.reset()` cause a read (or discard some read data) that could interfere with the test?

`actual` and `golden` data available here: https://gist.github.com/bburky/ac39a5211eb386c2edcc73e8b29b5397
I'm not an expert in USB debugging, but if there's something specific I can check I'm happy to.

Sazzach, 2025-03-12:
I replicated this on my Windows 10 computer. I was curious if this error might have been fixed by lock added in libusb1 3.3.0, but that made no change.

I spend some time examining the USB requests in Wireshark. I think that the issue may be that the FX2 FIFO isn't getting reset. I'm not firm in this conclusion though.

whitequark, 2025-03-12:
> After comparing the `actual` vs `golden` data, it seems there is a 0x400 offset to the test pattern in the `actual` data. It would seem some initial data is getting lost somehow?

Looking at this again, I've hit this problem before and concluded that it is indeed down to `RAW_IO` issues, but I haven't proven it by enabling that flag.

sonatique, 2025-08-28:
@bburky Can we consider this issue closed now that we have https://github.com/libusb/libusb/pull/1512 merged?

Thread 552 (2024-04-04):

Reloading FPGA bitstream causes all outputs whose Vio is enabled to strongly drive high

whitequark, 2024-04-04:
This unfortunately happens because the reset state for the FPGA is pull-high, which translates to DIR=H (B=A), where A is FPGA-side and B is DUT-side.

Solutions:
1. Turn off Vio during FPGA reconfiguration and wait for the output cap to discharge before proceeding.
   - Pros: costs nothing.
   - Cons: slow, turns off DUT power which is undesirable, makes Vsense alert even less useful.
2. Add pulldowns on Dxn nets.
   - Pros: preserves existing design as much as feasible.
   - Cons: another BOM line, @esden has 4000 revC3 PCBs.
3. Switch to [74AXP1T45](https://github.com/GlasgowEmbedded/glasgow/issues/283) and swap A/B.
   - Pros: improves performance of the device, doesn't add a BOM line.
   - Cons: @esden has ~2000-3000 boards worth of SN74LVC1T.
4. [Power gate the FPGA bank or the IO drivers](https://github.com/GlasgowEmbedded/glasgow/issues/552#issuecomment-2044906109)
   - Pros: zero new BOM lines, one added part
   - Cons: really awkward solution, may have unintended consequences

Swapping A/B on SN74LVC1T isn't feasible since this level shifter is asymmetric.

We have to implement (1) anyway to handle the existing devices; we must implement (2) or (3) for revD. What is not clear is whether or when revC4 will be designed, tested, and put into production.

smunaut, 2024-04-09:
You can also power gate the VCCIO of the FPGA bank. Either using a power switch or having two 3v3 rail ( fed by another TLV75533PDRVR with a different EN line). Not saying it's a great option, but it's a fourth option.

whitequark, 2024-04-09:
Thanks, added.

nekrondev, 2024-05-08:
Many thanks for building and maintaining `glasgow`... I've got a question regarding this issue ... how practically does this affect using the current device revision (C3)? I'm new into this and can't reason about it if it's only an issue when there is some edge case hacking where you need to power the DUT or does it interfere using `glasgow` with some common setup? As this hasn't been detected during the different PCB version integration tests I guess it should be a minor concern, right?

whitequark, 2024-05-09:
@nekrondev We'll deploy a firmware based fix that only has trivial effect on usability of device (slight delay added to firmware reload).

whitequark, 2024-06-22:
Apparently we *did* notice this... back in 2019: https://github.com/GlasgowEmbedded/glasgow/issues/96

whitequark, 2024-06-22:
While working on this (testing it with the UART applet) I discovered another buggy behavior in transients:
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

Because the FIFO interface was turned off before the FPGA was reset, and because turning it off meant that several active-low flags would go permanently low, applets would receive an endless stream of phantom zero bytes. This could potentially cause very undesired operation.

u1735067, 2025-01-30:
Maybe not the right place (sorry), but to share about "*How do I verify that the fix is applied*" (https://www.crowdsupply.com/1bitsquared/glasgow/updates/campaign-fulfillment-progress): on Windows it seems the device description containing the firmware git revision is not updated after the first plugging, so the provided `Get-WmiObject` command returns the old string even after flashing, unless the device is "uninstalled" (this was deduced from https://github.com/GlasgowEmbedded/glasgow/issues/382 and tested).

whitequark, 2025-01-31:
Oh, this is good to know, thank you!

Closed 2024-06-22.

Thread 565 (2024-05-04):

FAIL:  glasgow build --rev C3 uart

mbparks, 2024-05-04:
```
PS C:\Users\plebe> glasgow build --rev C3 uart
I: glasgow.cli: generating bitstream for applet 'uart'
Traceback (most recent call last):
  File "<frozen runpy>", line 198, in _run_module_as_main
  File "<frozen runpy>", line 88, in _run_code
  File "C:\Users\plebe\pipx\venvs\glasgow\Scripts\yowasp-yosys.exe\__main__.py", line 7, in <module>
  File "C:\Users\plebe\pipx\venvs\glasgow\Lib\site-packages\yowasp_yosys\__init__.py", line 16, in _run_yosys_argv
    sys.exit(run_yosys(sys.argv[1:]))
             ^^^^^^^^^^^^^^^^^^^^^^^
  File "C:\Users\plebe\pipx\venvs\glasgow\Lib\site-packages\yowasp_yosys\__init__.py", line 11, in run_yosys
    return yowasp_runtime.run_wasm(__package__, "yosys.wasm", resources=["share"],
           ^^^^^^^^^^^^^^^^^^^^^^^^^^^^^^^^^^^^^^^^^^^^^^^^^^^^^^^^^^^^^^^^^^^^^^^
  File "C:\Users\plebe\pipx\venvs\glasgow\Lib\site-packages\yowasp_runtime\__init__.py", line 111, in run_wasm
    store.set_wasi(wasi_cfg)
  File "C:\Users\plebe\pipx\venvs\glasgow\Lib\site-packages\wasmtime\_store.py", line 97, in set_wasi
    raise WasmtimeError._from_ptr(error)
wasmtime._error.WasmtimeError: The system cannot find the path specified. (os error 3)
Traceback (most recent call last):
  File "<frozen runpy>", line 198, in _run_module_as_main
  File "<frozen runpy>", line 88, in _run_code
  File "c:\users\plebe\.local\bin\glasgow.exe\__main__.py", line 7, in <module>
  File "C:\Users\plebe\glasgow\software\glasgow\cli.py", line 937, in run_main
    exit(asyncio.run(main()))
         ^^^^^^^^^^^^^^^^^^^
  File "C:\Users\plebe\AppData\Local\Programs\Python\Python312\Lib\asyncio\runners.py", line 194, in run
    return runner.run(main)
           ^^^^^^^^^^^^^^^^
  File "C:\Users\plebe\AppData\Local\Programs\Python\Python312\Lib\asyncio\runners.py", line 118, in run
    return self._loop.run_until_complete(task)
           ^^^^^^^^^^^^^^^^^^^^^^^^^^^^^^^^^^^
  File "C:\Users\plebe\AppData\Local\Programs\Python\Python312\Lib\asyncio\base_events.py", line 687, in run_until_complete
    return future.result()
           ^^^^^^^^^^^^^^^
  File "C:\Users\plebe\glasgow\software\glasgow\cli.py", line 833, in main
    f.write(plan.get_bitstream())
            ^^^^^^^^^^^^^^^^^^^^
  File "C:\Users\plebe\glasgow\software\glasgow\target\hardware.py", line 171, in get_bitstream
    bitstream_data = self.execute(debug=debug)
                     ^^^^^^^^^^^^^^^^^^^^^^^^^
  File "C:\Users\plebe\glasgow\software\glasgow\target\hardware.py", line 145, in execute
    products  = self.lower.execute_local(build_dir, env=environ)
                ^^^^^^^^^^^^^^^^^^^^^^^^^^^^^^^^^^^^^^^^^^^^^^^^
  File "C:\Users\plebe\pipx\venvs\glasgow\Lib\site-packages\amaranth\build\run.py", line 101, in execute_local
    subprocess.check_call(["cmd", "/c", f"call {self.script}.bat"],
  File "C:\Users\plebe\AppData\Local\Programs\Python\Python312\Lib\subprocess.py", line 413, in check_call
    raise CalledProcessError(retcode, cmd)
subprocess.CalledProcessError: Command '['cmd', '/c', 'call build_top.bat']' returned non-zero exit status 1.
```

Running Win11, and latest Python, pipx and git

whitequark, 2024-05-04:
This error is definitely a property of your environment, but it's difficult to say exactly how. The actual error most likely comes from one of [these statements](https://github.com/YoWASP/runtime-py/blob/9027ad28a03962e338dcc4392ca06260929a17ed/yowasp_runtime/__init__.py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), although it is also possible (but unlikely) that either the temporary directory or the resource directory are missing.

Do you happen to have a `net use` or `subst` share defined that is referencing a non-existent target?

whitequark, 2024-05-04:
It looks like I just reproduced this in my environment (unintentionally, I was trying to get something done). It has a network share, but no subst mounts.

whitequark, 2024-05-04:
I've confirmed that this is an upstream (YoWASP) error and not specific to Glasgow:

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

whitequark, 2024-05-04:
I've confirmed that the culprit is these preopens:

```
            for letter in "abcdefghijklmnopqrstuvwxyzABCDEFGHIJKLMNOPQRSTUVWXYZ":
                wasi_cfg.preopen_dir(letter + ":\\", letter + ":")
```

Namely, wasmtime used to ignore invalid preopens until you accessed them, but it no longer does since version 20. The workaround for now is to downgrade `wasmtime` to version 19.0.0.

whitequark, 2024-05-04:
This is an upstream issue in the YoWASP runtime and/or Wasmtime, so I filed two issues on it:
- https://github.com/YoWASP/runtime-py/issues/3
- https://github.com/bytecodealliance/wasmtime/issues/8552

There is an automated testsuite that is supposed to prevent this from happening, however unfortunately it does not cover Windows. We could probably run it under Wine...

whitequark, 2024-05-04:
I've fixed this in https://pypi.org/manage/project/yowasp-runtime/release/1.55/ and yanked the broken release. You can upgrade the virtual environment, or just reinstall it from scratch if you don't want to bother.

lboulard, 2024-06-25:
### FAIL: `glasgow build --rev C3 uart` in presence of BitLocker drives in locked state

Follow up on same issue. This is for reference for people who get hit by same bus.
I guess that any letter without a readable file system by operating system will also trigger issue.

Hint in https://github.com/GlasgowEmbedded/glasgow/issues/565 that was used for a fix in https://github.com/YoWASP/runtime-py/issues/3 is incomplete, and current fix does not address core issue. Core issue is that drive letters on windows are dynamic and may expose ressources that are not always available as readable file system. Because not a wheel known file system — ext4, xfs, BSD partition — or, folder/drive permissions does not allow current user. Drive letters can also come and gone at any moment.

Only fix I found is altering directly pipx virtualenv for glasgow. This will ignore non accessible drive.

```patch
--- Lib\site-packages\yowasp_runtime\__init__.py.orig
+++ Lib\site-packages\yowasp_runtime\__init__.py
@@ -62,6 +62,8 @@
             for drive_index in range(26):
                 if drive_mask & (1 << drive_index):
                     drive_letter = "abcdefghijklmnopqrstuvwxyz"[drive_index]
+                    if not os.access(drive_letter + ":\\", os.R_OK):
+                        continue
                     wasi_cfg.preopen_dir(drive_letter + ":\\", drive_letter + ":")
                     drive_letter = drive_letter.upper()
                     wasi_cfg.preopen_dir(drive_letter + ":\\", drive_letter + ":")
```

Should solve most existing failure of `glasgow build` on Windows.

Currently, I understand what `__init__.py` code is doing for startup. But, I do not known why `yowasp_runtime` code does "static" capture of drives list. First fix was to only allow C drive (`drive_mask  =4`), C drive is only drive I am (almost) sure exists on any windows setup.

This is why I write bug report here until I can understand who is guilty here. And open a new issue.

I know that glasgow project is not responsable for this bug.
Still, please, reopen this bug until a final solution is found.

whitequark, 2024-06-25:
So the proper fix is to bump the YoWASP wasmtime requirement to >=21.0.0 and then bail if `wasi_cfg.preopen_dir()` fails.

whitequark, 2024-06-25:
Please test whether https://test.pypi.org/project/yowasp-runtime/1.61/ addresses the issue and if it does I will make a proper release of yowasp-runtime and bump the constraint in Glasgow.

lboulard, 2024-06-25:
@whitequark I confirm that 1.61 solved issue. Thanks.
Testes 1.62 too. working too but that was expected on Windows I think.

whitequark, 2024-06-25:
Released 1.62: https://pypi.org/project/yowasp-runtime/1.62/.

lboulard, 2024-06-25:
Confirm. Everything did run well.

```
╭─ C:\lb\Code\glasgow   main 
╰─ pipx reinstall glasgow
uninstalled glasgow! ✨ 🌟 ✨
  installed package glasgow 0.1.dev2069+gbf5f29e, installed using Python 3.11.9
  These apps are now globally available
    - glasgow.exe
done! ✨ 🌟 ✨

╭─ C:\lb\Code\glasgow   main 
╰─ pipx runpip glasgow list
Package              Version
-------------------- --------------------
amaranth             0.5.0
amaranth-yosys       0.40.0.0.post96
click                8.1.7
colorama             0.4.6
fx2                  0.13
glasgow              0.1.dev2069+gbf5f29e
importlib_resources  6.4.0
Jinja2               3.1.4
jschon               0.11.1
libusb1              3.1.0
MarkupSafe           2.1.5
packaging            24.1
pip                  24.1
platformdirs         4.2.2
pyvcd                0.4.0
rfc3986              2.0.0
setuptools           69.0.2
typing_extensions    4.12.2
wasmtime             22.0.0
wheel                0.42.0
yowasp-nextpnr-ice40 0.7.0.0.post519
yowasp-runtime       1.62
yowasp-yosys         0.42.0.0.post734

╭─ C:\lb\Code\glasgow   main 
╰─ glasgow build --rev C3 uart
I: glasgow.cli: generating bitstream for applet 'uart'
```

Closed 2024-06-25.

Thread 568 (2024-05-06):

UART applet warnings

ikarus23, 2024-05-06:
Hi. My Glasgow just arrived today and I'm very exited. I've just tested the UART applet with nothing connected and made some observations. Not sure of what to make of them. Maybe they will help with development.

1. If I run the applet I'm always getting parity warnings, although the parity check is `none` by default.
```
> glasgow run uart -V 3.3 tty
I: g.device.hardware: generating bitstream ID d709aa1c79bf720fd874632c4cd73c2c
I: g.cli: running handler for applet 'uart'
I: g.applet.interface.uart: port(s) A, B voltage set to 3.3 V
I: g.applet.interface.uart: running on a TTY; enter `Ctrl+\ q` to quit
W: g.applet.interface.uart: 911 frame or parity errors detected
W: g.applet.interface.uart: 12226 frame or parity errors detected
W: g.applet.interface.uart: 12224 frame or parity errors detected
W: g.applet.interface.uart: 12213 frame or parity errors detected
[...]
```
2. If I run the applet in pty mode, canceling with CTRL+\ q is terminating the program with a core dump
```
> glasgow run uart -V 3.3 pty
I: g.device.hardware: device already has bitstream ID d709aa1c79bf720fd874632c4cd73c2c
I: g.cli: running handler for applet 'uart'
I: g.applet.interface.uart: port(s) A, B voltage set to 3.3 V
/dev/pts/1
W: g.applet.interface.uart: 40 frame or parity errors detected
W: g.applet.interface.uart: 12211 frame or parity errors detected
W: g.applet.interface.uart: 12238 frame or parity errors detected
^\[1]    8247 quit (core dumped)  glasgow run uart -V 3.3 pty

```
3. If I run the applet in pty mode, canceling with CTRL+C is terminating the program with errors
```
> glasgow run uart -V 3.3 pty
I: g.device.hardware: device already has bitstream ID d709aa1c79bf720fd874632c4cd73c2c
I: g.cli: running handler for applet 'uart'
I: g.applet.interface.uart: port(s) A, B voltage set to 3.3 V
/dev/pts/1
W: g.applet.interface.uart: 865 frame or parity errors detected
W: g.applet.interface.uart: 12221 frame or parity errors detected
W: g.applet.interface.uart: 12211 frame or parity errors detected
^C

[ Nothing happens after the first CTRL+C ]

^C
Traceback (most recent call last):
  File "/home/ikarus/.local/bin/glasgow", line 8, in <module>
    sys.exit(run_main())
             ^^^^^^^^^^
  File "/home/ikarus/Programs/glasgow/software/glasgow/cli.py", line 937, in run_main

[...]

KeyboardInterrupt

[ Nothing happens, lets press CTRL+C a third time ]

^CException ignored in: <module 'threading' from '/usr/lib/python3.12/threading.py'>
Traceback (most recent call last):

[...]

    if lock.acquire(block, timeout):
       ^^^^^^^^^^^^^^^^^^^^^^^^^^^^
KeyboardInterrupt:
```

attie, 2024-05-06:
The first is a non-issue - as there is no signal (and parity is disabled), it's just informing you that there were _n_ framing errors... UARTs are typically idle-high, and if the line is low for an extended period then it is either a break (technically also a framing issue), or an invalid signal.

https://en.wikipedia.org/wiki/Universal_asynchronous_receiver-transmitter#Break_condition

whitequark, 2024-05-06:
> Just wasn't expecting "warnings" when doing nothing.

I consider this the desired behavior since it's an abnormal state indicating a connection error, a faulty transmitter, or some other condition you want to be aware of. I do not consider it a concern that when you are not actually using the applet for its only task you're getting what may seem to be spurious warnings.

> 2\. If I run the applet in pty mode, canceling with CTRL+\ q is terminating the program with a core dump

If you run it in PTY mode it does not instruct you to use `Ctrl+\ q` because that kills the application with a core dump. Ctrl+\ is SIGQUIT; it's used in the TTY mode because it's difficult to find an escape character that's not otherwise used. This is expected behavior.

> 3\. If I run the applet in pty mode, canceling with CTRL+C is terminating the program with errors

That seems like a bug.

whitequark, 2024-05-06:
> This is expected behavior.

(That said, I'm wondering if we should switch to a different escape sequence and/or trap SIGQUIT and make it synonymous to SIGINT normally because training users to do a thing that most of the time coredumps is bad.)

ikarus23, 2024-05-06:
> I consider this the desired behavior

It was just new to me because other USB to UART converters (e.g. FTDI, etc.) don's show that. But fair enough, I understand you point.

> If you run it in PTY mode it does not instruct you to use `Ctrl+\ q`

Correct. I just tired it because `Ctrl+c`did not work either. I did not know that it sends a SIGQUIT.

> That seems like a bug.

Ok. :)

Thank you for the hard work on the project. Feel free to close this issue or to change its title to something more appropriate (e.g. "Bug when closing UART applet in PTY mode using Ctrl+c").

whitequark, 2024-05-06:
> It was just new to me because other USB to UART converters (e.g. FTDI, etc.) don's show that. But fair enough, I understand you point.

One thing we can do is simply add a pullup on the RX line.

whitequark, 2024-05-07:
So reading through this issue with a fresh pair of eyes:

1. For the framing error problem, I agree that it can be distracting to new users, and given that we use the UART applet as the first applet you run, it's worth putting a higher bar on the UX there. I think we should either:
   - Unconditionally enable the pullup.
   - Conditionally enable the pullup so that revAB users don't get a message about it. (Does anyone care? E.g. @smunaut?)
2. I think it would be problematic to trap SIGQUIT and make it work the same as SIGINT because then we train users to do a different thing anyway. But we could make it do nothing by default, and something in some (small subset) of applets. Thoughts? This is less for the issue reporter and more for comaintainers.
3. Ctrl+C in pty mode seems to be hitting a deadlock that should be fixed.

So I think there's actually three issues here, but it's a little more subtle than what it looked at first.

theorbtwo, 2024-05-07:
Is it worth the (small, I think) effort to change the message to not mention parity errors if parity is none?  FWIW, I also like that it informs me when the DUT stops pulling it's transmit line high.

whitequark, 2024-05-07:
> Is it worth the (small, I think) effort to change the message to not mention parity errors if parity is none?

Yes, happy to merge a PR right away.

smunaut, 2024-05-07:
@whitequark FWIW, no I don't care about a warning message  :)  And I also only use my revABs with custom applet anyway.

whitequark, 2024-05-07:
@smunaut Thanks. n=1 isn't a lot but it's better than n=0, so I'll go with an unconditional pullup and we can fix it later.

Anyone in this thread wants to add the pullups? You can glean how from the I2C applet.

whitequark, 2024-06-19:
We are now unconditionally enabling pulls on the UART applet: https://github.com/GlasgowEmbedded/glasgow/pull/583

This leaves SIGQUIT and the deadlock on Ctrl-C as the remaining issues.

Closed 2025-08-09.

Thread 575 (2024-05-23):

Glasgow does not support Espressif esptool - possible to convert to applet?

victorhooi, 2024-05-23:
This is related to the Discord chat from here:

https://discord.com/channels/613131135903596547/613461005392936961/1239057227055239269

_tl;dr - glasgow does not work in UART mode with ESP devices. @whitequark suggested easiest fix may be to simply implement the esptool functionality as an applet._

I was trying to use the glasgow UART support with [esptool](https://github.com/espressif/esptool), which is the official Espressif tool for interacting with ESPXX/ESPXXXX bootloaders.

This was how I started glasgow in UART mode:
```
victorhooi@Victors-MacBook-Pro-3 ~/c/g/firmware (main)> glasgow run uart -V 3.3 --pin-tx 1 --pin-rx 0 -b 9600 pty
I: g.device.hardware: device already has bitstream ID 75401762f86c41aae9f5996a07c0b632
I: g.cli: running handler for applet 'uart'
I: g.applet.interface.uart: port(s) A, B voltage set to 3.3 V
/dev/ttys012
W: g.applet.interface.uart: 24 frame errors detected
```

This is the error I got with `esptool`:
```
victorhooi@Victors-MacBook-Pro-3 ~/c/g/firmware (main)> esptool.py -p /dev/ttys012 flash_id
esptool.py v4.7.0
Serial port /dev/ttys012
Connecting...
Failed to get PID of a device on /dev/ttys012, using standard reset sequence.

Traceback (most recent call last):
  File "/opt/homebrew/bin/esptool.py", line 37, in <module>
    esptool._main()
  File "/opt/homebrew/Cellar/esptool/4.7.0_1/libexec/lib/python3.12/site-packages/esptool/__init__.py", line 1139, in _main
    main()
  File "/opt/homebrew/Cellar/esptool/4.7.0_1/libexec/lib/python3.12/site-packages/esptool/__init__.py", line 712, in main
    esp = esp or get_default_connected_device(
                 ^^^^^^^^^^^^^^^^^^^^^^^^^^^^^
  File "/opt/homebrew/Cellar/esptool/4.7.0_1/libexec/lib/python3.12/site-packages/esptool/__init__.py", line 1018, in get_default_connected_device
    _esp = detect_chip(
           ^^^^^^^^^^^^
  File "/opt/homebrew/Cellar/esptool/4.7.0_1/libexec/lib/python3.12/site-packages/esptool/__init__.py", line 1018, in get_default_connected_device
    _esp = detect_chip(
           ^^^^^^^^^^^^
  File "/opt/homebrew/Cellar/esptool/4.7.0_1/libexec/lib/python3.12/site-packages/esptool/cmds.py", line 97, in detect_chip
    detect_port.connect(connect_mode, connect_attempts, detecting=True)
  File "/opt/homebrew/Cellar/esptool/4.7.0_1/libexec/lib/python3.12/site-packages/esptool/loader.py", line 678, in connect
    last_error = self._connect_attempt(reset_strategy, mode)
                 ^^^^^^^^^^^^^^^^^^^^^^^^^^^^^^^^^^^^^^^^^^^
  File "/opt/homebrew/Cellar/esptool/4.7.0_1/libexec/lib/python3.12/site-packages/esptool/loader.py", line 563, in _connect_attempt
    reset_strategy()  # Reset the chip to bootloader (download mode)
    ^^^^^^^^^^^^^^^^
  File "/opt/homebrew/Cellar/esptool/4.7.0_1/libexec/lib/python3.12/site-packages/esptool/reset.py", line 83, in __call__
    self._setDTRandRTS(False, False)
  File "/opt/homebrew/Cellar/esptool/4.7.0_1/libexec/lib/python3.12/site-packages/esptool/reset.py", line 48, in _setDTRandRTS
    "I", fcntl.ioctl(self.port.fileno(), TIOCMGET, struct.pack("I", 0))
         ^^^^^^^^^^^^^^^^^^^^^^^^^^^^^^^^^^^^^^^^^^^^^^^^^^^^^^^^^^^^^^
OSError: [Errno 25] Inappropriate ioctl for device
```

And for comparison - here is esptool working using a tigard as the UART device:
```
victorhooi@Victors-MacBook-Pro-3 ~/c/g/firmware (main) [2]> esptool.py -p /dev/tty.usbserial-TG1001d00 flash_id
esptool.py v4.7.0
Serial port /dev/tty.usbserial-TG1001d00
Connecting....
Detecting chip type... Unsupported detection protocol, switching and trying again...
Connecting...
Detecting chip type... ESP8266
Chip is ESP8266EX
Features: WiFi
Crystal is 26MHz
MAC: 48:e7:29:49:1b:19
Uploading stub...
Running stub...
Stub running...
Manufacturer: ef
Device: 4014
Detected flash size: 1MB
Hard resetting via RTS pin...
```

@whitequark suggested this might be due to some tricks esptool is doing with DTR/RST, and the fact that Glasgow is using a pty (versus the Tigard which uses a real tty at the hardware level).

bburky, 2024-05-23:
Yes, by default esptool resets your device into the bootloader using RTS and DTR which is unsupported by glasgow's pty mode, but you can [disable this in esptool](https://docs.espressif.com/projects/esptool/en/latest/esp32/esptool/advanced-options.html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) however, which should allow you to use esptool with a Glasgow today (you'll have to manually put the device into bootloader mode first, perhaps by holding a BOOT button during reset or tying GPIO0 to ground). Similarly, you can use a socket instead of pty which doesn't support RTS and DTR anyway.
```
# first, put the esp device into bootloader mode manually. Then:

# untested, should work
glasgow run uart -V 3.3 --port A --pin-tx 1 --pin-rx 0 -b 115200 pty
esptool --before no_reset -p /dev/ttys012 flash_id
# you may also need --after no_reset

# works, even on windows which doesn't support pty
glasgow run uart -V 3.3 --port A --pin-tx 0 --pin-rx 1 -b 115200 socket tcp:127.0.0.1:4000
esptool -p socket://127.0.0.1:4000 flash_id
```

I'm not sure this is the best option (I've never used it, and CUSE was discussed as another alternative in Discord) but if you want to add support for esptool reset via glagow uart... esptool seems to support [RFC 2217](https://datatracker.ietf.org/doc/html/rfc2217) (telnet) remote serial ports:
https://docs.espressif.com/projects/esptool/en/latest/esp8266/esptool/remote-serial-ports.html

There's an example in their source code, it supports detecting RTS and DTR over the serial port and doing the bootloader reset. Though they do not actually pass through RTS and DTR directly to the serial port and instead trigger the esptool specific reset process in the serial server code (those docs say this is to handle network latency, see https://github.com/espressif/esptool/issues/383. Maybe you could skip this if the localhost rfc2217 server is on the same machine as esptool... but it sounds like they had issues in a fully local system too)
https://github.com/espressif/esptool/blob/v4.7.0/esp_rfc2217_server.py#L75

You could probably add support for an RFC 2217 server (similarly to socket) in the uart applet? Unless you can pass through RTS and DTR directly to output pins, the applet would need to do implement the esptool specific reset modes. I'm unsure if RFC 2217 is a widely used protocol, but apparently pyserial supports it and that's where esptool's support comes from.

If you had an RFC 2217 server applet, you could use it with esptool like the docs above describe. Like: `esptool.py --port rfc2217://127.0.0.1:4000?ign_set_control flash_id`

whitequark, 2024-05-23:
We could add an `uart-rs232` applet which does have the additional control lines.

Thread 577 (2024-06-02):

Installation issue on macOS

mringwal, 2024-06-02:
Hi. eagerly awaiting my Glasgow, I've followed the installation instructions for macOS and get an error checking the version.
After installing pipx with brew, re-starting the terminal, I get this:

```
➜  Projects pipx reinstall glasgow
uninstalled glasgow! ✨ 🌟 ✨
  installed package glasgow 0.1.dev1654+gb1985b3, installed using Python 3.12.3
  These apps are now globally available
    - glasgow
done! ✨ 🌟 ✨
➜  Projects glasgow --version
Traceback (most recent call last):
  File "/Users/mringwal/.local/bin/glasgow", line 5, in <module>
    from glasgow.cli import main
  File "/Users/mringwal/Projects/glasgow/software/glasgow/cli.py", line 31, in <module>
    from .applet import *
  File "/Users/mringwal/Projects/glasgow/software/glasgow/applet/__init__.py", line 108, in <module>
    from ..access.simulation import *
  File "/Users/mringwal/Projects/glasgow/software/glasgow/access/simulation/__init__.py", line 3, in <module>
    from .demultiplexer import *
  File "/Users/mringwal/Projects/glasgow/software/glasgow/access/simulation/demultiplexer.py", line 13, in <module>
    class SimulationDemultiplexerInterface(AccessDemultiplexerInterface):
  File "/Users/mringwal/Projects/glasgow/software/glasgow/access/simulation/demultiplexer.py", line 20, in SimulationDemultiplexerInterface
    @asyncio.coroutine
     ^^^^^^^^^^^^^^^^^
AttributeError: module 'asyncio' has no attribute 'coroutine'. Did you mean: 'coroutines'?```

Any ideas/suggestion?

whitequark, 2024-06-02:
> installed package glasgow 0.1.dev1654+gb1985b3, installed using Python 3.12.3

That looks like an extremely old checkout (~400 commits behind). You should `git pull`.

mringwal, 2024-06-02:
You're correct. I did a git pull but have been on the old-school 'master' branch. After switching to 'main', it starts as expected. Thanks!

Closed 2024-06-02.

Thread 599 (2024-06-26):

Migrate away from deprecated `Pads`/`get_pads` mechanism

whitequark, 2024-06-26:
The two mechanisms are similar conceptually and mainly differ syntactically. The following command can illustrate the changes required:

```console
$ git diff 38730032..e9571705 -- glasgow/applet/interface/jtag_probe/__init__.py
```

List of applets that still need migration:

- [x] applet.audio.dac
- [x] applet.audio.yamaha_opx
- [x] applet.control.servo
- [x] applet.display.hd44780
- [x] applet.display.pdi
- [x] applet.interface.analyzer
- [x] applet.interface.i2c_initiator
- [x] applet.interface.i2c_target
- [x] applet.interface.ps2_host
- [x] applet.interface.sbw_probe
- [x] applet.interface.spi_controller
- [x] applet.interface.swd_openocd
- [x] applet.interface.uart
- [x] applet.memory.floppy
- [x] applet.memory.onfi
- [x] applet.memory.prom
- [x] applet.program.avr.spi
- [x] applet.program.m16c
- [x] applet.program.nrf24lx1
- [x] applet.radio.nrf24l01
- [x] applet.sensor.hx711
- [x] applet.sensor.pmsx003
- [x] applet.video.hub75_output
- [x] applet.video.rgb_input
- [x] applet.video.vga_output
- [x] boilerplate applet
- [x] applet.interface.jtag_pinout
- [x] applet.interface.spi_flashrom
- [x] applet.program.ice40_flash

q3k, 2024-06-26:
Like this? (#602) My Amaranth is very rusty and I don't have how to actually test this. Is there an easy way to make sure an Amaranth/Python change is an RTL no-op?

whitequark, 2024-06-26:
> Is there an easy way to make sure an Amaranth/Python change is an RTL no-op?

No, but the changes are simple enough I expect to catch most issues during review, even if it's tedious.

Improvements to the general applet infrastructure will continue at a decent pace for the next half year or so, and I expect I'll have to sit down and manually test every single applet at the end of it, hopefully while also adding some better tests. It's going to be painful but what can you do?..

whitequark, 2024-06-26:
Also I don't even know where *my* HX711 board is, much less have a load cell on hand...

q3k, 2024-06-26:
Any tips on sequencing updates across multiple modules, eg. with UART(pads/ports) being used by multiple applets?

Is there a temporary/transitional mechanism that I could use to first update the applets (or libraries?) and then the other side?

whitequark, 2024-06-26:
I'd suggest leaving updating the libraries (UART and I2C in particular) to some later point, they're kind of a pain and I'm going to rewrite UART at least soon, anyway.

For the rest, unfortunately we don't have real applet composability so the answer is suffering. Making things composable is on my TODO list but it goes after this.

isabelburgos, 2024-08-05:
One more item for this list - `examples.boilerplate` still uses pads

Closed 2025-04-27.

Thread 608 (2024-06-27):

[Feature request] signal generator applet

ikarus23, 2024-06-27:
Hi. It would be cool to have simple signal generator applet. I'm not sure about DACs on the Glasgow, but even a square signal from a normal IO would be great.

I found the `control-servo` applet which generates a limited PWM signal. This is a great start, but it would be great to have more freedom. Some features I'm thinking about:

1. Simple square signal defined by providing a pulse with, a pause with and a pin.
2. "Replaying" a signal: same as 1. but a string of 1 and 0 can be provided with 1 being a high signal using the pulse with and a 0 being a low signal using the pause width.
3. Same as 1. or 2. but make it parallel. This would allow to specify multiple pins and to simulate a parallel bus signal.

This would also be great for some quick and rudimentary bit banging tests.

whitequark, 2024-06-27:
My concern here is the degree of generality. Ultimately, you could consider *any* applet a type of "signal generator" since that's what Glasgow does. I think I can't accept such an applet upstream without a clearly defined and justified scope.

whitequark, 2024-06-27:
Ultimately I also want it to be easy enough to add new applets that you wouldn't have to configure some monster with dozens of features to generate a signal similar to what you want; you would write a little bit of gateware that is exactly what you want.

arnobert, 2024-11-26:
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

A simple sig gen is one of the *basic* features, I would expect. Just dial in frequency and amplitude, maybe waveform (sine, square, triangle), that's it.

whitequark, 2024-11-26:
Glasgow can't generate sine or triangle without an external LPF.

arnobert, 2024-11-27:
> Glasgow can't generate sine or triangle without an external LPF.

Even a square gen would actually help me.

rabagliati, 2024-11-27:
I also have an Analog Discovery 2, which I use a lot. I mostly use it as a digital signal analyser and protocol decoder, but I like the 'scope functionality, and the LCR addon is useful, though the dedicated ones are easier. I do not use the signal generator very much, but it is used for the LCR addon.

The Glasgow has more output capability, and its single channel analog input has a much more useful voltage range than the Analog discovery 2.

I think a signal generator and single channel scope are natural targets for the Glasgow - even if they are low frequency.

whitequark, 2024-11-27:
> I think a signal generator and single channel scope are natural targets for the Glasgow - even if they are low frequency.

An arbitrary waveform generator would need an analog frontend, and this is actually already covered: `audio-dac` plus a filter or a more complex frontend gives you that capability.

A binary pulse train generator can get fairly complex if you want multi-channel synchronization, on-the-fly updates, or things like that (you could write a PhD on this topic alone) so without a well defined scope I don't want to have one in-tree.

The analog input has something like 1 kHz of bandwidth, which is more of a "multimeter" range than a "scope" range. I don't think we currently have infrastructure to utilize even that at full capacity, and I'm not sure that infrastructure would be easy to fit into the FX2 either.

arnobert, 2024-11-27:
> > Even a square gen would actually help me.
>
> Something scoped to a square gen would work. How do you imagine controlling it? Do you want to change the signal parameters on the fly? Do you want cycle-accurate event scheduling or anything like that?

I would try to keep it as simple as possible: Just one single channel, frequency and amplitude as parameters, without any changes during runtime, that's it.

whitequark, 2024-11-27:
Glasgow does not have per-pin amplitude control. (You can control it indirectly via the port voltage, but our command line option system isn't really currently flexible enough to express the parameters as "frequency plus amplitude", although arguably it should be.)

Other than that sounds fine.

whitequark, 2024-11-27:
> As long as there is only a single channel in use, that should be fine.

A single channel per port (you can have two!). To be clear, I never wanted to imply this couldn't work electrically, this is purely a user interface limitation.

mayjack0312, 2025-07-05:
> This code will not output a 1 kHz square wave. Did "AI" write it for you?

Ah, that's right. I only know it is a square wave (0 and 1) I use this program to make a running light example

mayjack0312, 2025-07-05:
> [@mayjack0312](https://github.com/mayjack0312) I would recommend using the [script mode](https://glasgow-embedded.org/latest/use/repl-script.html), which will let you do "PWM" like this at maybe 100 Hz (but not reliably). In order to reliably output a square wave at 1 kHz (or faster) you will need to write some gateware.

OK, I will study the document. Thank you

mayjack0312, 2025-07-05:
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

The test results are as follows
```

```

The following table can intuitively express the frequency bottleneck

| Target Frequency (Hz) | Target Period (ms) | High Time (ms) | Low Time (ms) | Actual Frequency (Hz) | Error (%) | Test Duration (s) | Generated Cycles |
|----------------------|-------------------|----------------|---------------|----------------------|-----------|-------------------|------------------|
| 10                   | 100.000           | 50.000         | 50.000        | 9.5                  | 5.1       | 3.06              | 29               |
| 15                   | 66.667            | 33.333         | 33.333        | 13.7                 | 8.5       | 3.06              | 42               |
| 20                   | 50.000            | 25.000         | 25.000        | 18.1                 | 9.7       | 3.04              | 55               |
| 25                   | 40.000            | 20.000         | 20.000        | 22.0                 | 11.9      | 3.04              | 67               |
| 30                   | 33.333            | 16.667         | 16.667        | 25.7                 | 14.4      | 3.04              | 78               |
| 35                   | 28.571            | 14.286         | 14.286        | 28.5                 | 18.7      | 3.02              | 86               |
| 40                   | 25.000            | 12.500         | 12.500        | 32.7                 | 18.2      | 3.03              | 99               |
| 45                   | 22.222            | 11.111         | 11.111        | 35.0                 | 22.2      | 3.03              | 106              |
| 50                   | 20.000            | 10.000         | 10.000        | 40.0                 | 19.9      | 3.02              | 121              |
| 55                   | 18.182            | 9.091          | 9.091         | 41.1                 | 25.4      | 3.02              | 124              |
| 60                   | 16.667            | 8.333          | 8.333         | 45.0                 | 24.9      | 3.02              | 136              |
| 65                   | 15.385            | 7.692          | 7.692         | 48.9                 | 24.8      | 3.01              | 147              |
| 70                   | 14.286            | 7.143          | 7.143         | 49.8                 | 28.8      | 3.01              | 150              |
| 75                   | 13.333            | 6.667          | 6.667         | 54.8                 | 27.0      | 3.01              | 165              |
| 80                   | 12.500            | 6.250          | 6.250         | 55.8                 | 30.3      | 3.01              | 168              |
| 85                   | 11.765            | 5.882          | 5.882         | 60.5                 | 28.9      | 3.01              | 182              |
| 90                   | 11.111            | 5.556          | 5.556         | 62.9                 | 30.1      | 3.00              | 189              |
| 95                   | 10.526            | 5.263          | 5.263         | 62.8                 | 33.9      | 3.01              | 189              |
| 100                  | 10.000            | 5.000          | 5.000         | 68.6                 | 31.4      | 3.00              | 206              |

Its optimal working range: 10-25Hz, the error is controlled within 12%. I think its stable upper limit is 70Hz.

The highest frequency it can generate is 173.6Hz, but the error is a bit too high.

mayjack0312, 2025-07-05:
> Yes, the GPIO method is very limited. You need to use the gateware method to achieve good results. With it, you can generate frequencies up to 24 MHz, although the error gets higher the higher you go.

"Just use it" It is mainly used as a universal burner ^_^

whitequark, 2025-07-05:
What's ProtoBlade?

mayjack0312, 2025-07-05:
> What's ProtoBlade?

Oh, I changed the name of another device O(∩_∩)O ~

Thread 688 (2024-09-11):

"E: g.cli: register 0x00 does not exist" when running applet

tinylabs, 2024-09-11:
Just received my glasgow rev C3 yesterday. While walking through the documentation there seems to be an issue running applets. The install went fine. udev rules installed.

```
elliot@workstation:~/projects/glasgow$ glasgow --version
Glasgow 0.1.dev2193+gf2c0ecb (CPython 3.10.12 on Linux-6.9.3-76060903-generic-x86_64-with-glibc2.35 Pop!_OS 22.04 LTS)
elliot@workstation:~/projects/glasgow$ glasgow list
C3-20240821T171012Z
elliot@workstation:~/projects/glasgow$ glasgow run uart -V 3.3 --pin-tx 0 --pin-rx 1 -b 57600 tty
I: g.device.hardware: generating bitstream ID d21f2ed6831a43901015d4b7d4b8eb4e
I: g.cli: running handler for applet 'uart'
E: g.cli: register 0x00 does not exist
```

I can build and flash the uart applet fine.
```
elliot@workstation:~/projects/glasgow_workspace$ glasgow build --rev C3 uart
I: g.cli: generating bitstream for applet 'uart'
elliot@workstation:~/projects/glasgow_workspace$ glasgow flash uart
I: g.cli: reading device configuration
I: g.cli: device has serial C3-20240821T171012Z
I: g.cli: device has flashed firmware
I: g.cli: device has flashed bitstream ID 654b5aaa14e3f1a88970463fd0864462
I: g.cli: generating bitstream for applet uart
I: g.cli: generated bitstream ID 654b5aaa14e3f1a88970463fd0864462
I: g.cli: using built-in firmware
I: g.cli: programming bitstream
I: g.cli: bitstream identical
I: g.cli: programming configuration and firmware
I: g.cli: configuration and firmware identical
```

Any advice would be appreciated. I can't seem to find anyone with a similar issue.

whitequark, 2024-09-11:
This is likely a hardware issue.

1. Try taking the device out of the case if you have it within. Let me know if that helps.
2. Contact @esden for further instructions.

tinylabs, 2024-09-11:
Ok, thank you @whitequark.
Adding some troubleshooting I tried:
- I bypassed the USB3.0 hub that it was plugged into. Didn't help.
- I switch to a different USB-C cable. Didn't help.
- The ACT and ERR LEDs blink fast twice when running the 'uart run' command above.

I'll email @esden to troubleshoot further.

matthewelse, 2024-09-16:
@tinylabs did you manage to find a solution to this? I'm seeing the same errors with ~the same repro

whitequark, 2024-09-16:
We should probably add a message indicating this to be a hardware error--this is ~always a fault on the I2C bus, from my experience.

Could you re-run with `glasgow -vvv ...` to confirm please?

matthewelse, 2024-09-16:
Thanks! This is the output with `-vvv`

```
➜  glasgow git:(main) glasgow -vvv run uart -V 3.3 --pin-tx 0 --pin-rx 1 -b 57600 tty
D: g.device.hardware: found revC3 device with serial C3-20240821T190159Z
D: g.applet.interface.uart: clock in=48000.000 req=9.600 out=9.600 [kHz] error=0 [ppm] duty=50.0%
D: g.applet.interface.uart: claimed pipe P and port(s) A, B
D: g.applet.interface.uart: adding reset register at address 0x05
D: g.applet.interface.uart: assigning applet port 'rx' to device pin A1
D: g.applet.interface.uart: assigning applet port 'tx' to device pin A0
D: g.target.toolchain: using toolchain 'builtin' (yosys 0.45.0.0.post775, nextpnr-ice40 0.7.0.0.post519, icepack 0.7.0.0.post519)
T: g.target.toolchain: tool 'yosys' is invoked as '/home/melse/.local/share/pipx/venvs/glasgow/bin/yowasp-yosys'
T: g.target.toolchain: tool 'nextpnr-ice40' is invoked as '/home/melse/.local/share/pipx/venvs/glasgow/bin/yowasp-nextpnr-ice40'
T: g.target.toolchain: tool 'icepack' is invoked as '/home/melse/.local/share/pipx/venvs/glasgow/bin/yowasp-icepack'
T: g.target.toolchain: toolchain ID is 0fb575d5e6ecfd3329cec3237d6f0fd7
T: g.target.toolchain: tool ID of 'yosys' is e21c23412a85d1114fb3a09fcee195c2
T: g.target.toolchain: tool ID of 'nextpnr-ice40' is d8e70cbe36257a34e6563bc47eb4c832
T: g.target.toolchain: tool ID of 'icepack' is d8e70cbe36257a34e6563bc47eb4c832
T: g.device.hardware: USB: CONTROL IN type=0x40 request=0x18 value=0x0000 index=0x0000 length=16 (submit)
T: g.device.hardware: USB: CONTROL IN data=<87f7eb3795bb06b69417b10dbbdee655> (completed)
I: g.device.hardware: device already has bitstream ID 87f7eb3795bb06b69417b10dbbdee655
I: g.cli: running handler for applet 'uart'
D: g.applet.interface.uart: clock in=48000.000 req=57.600 out=57.623 [kHz] error=400 [ppm] duty=50.0%
T: g.device.hardware: register 0 write: 0x340
T: g.device.hardware: USB: CONTROL OUT type=0x40 request=0x13 value=0x0000 index=0x0000 data=<00000340> (submit)
T: g.device.hardware: USB: CONTROL IN type=0x40 request=0x12 value=0x0000 index=0x0000 length=1 (submit)
T: g.device.hardware: USB: CONTROL IN data=<02> (completed)
E: g.cli: register 0x00 does not exist
```

tinylabs, 2024-09-16:
> @tinylabs did you manage to find a solution to this? I'm seeing the same errors with ~the same repro

It appears to be a hardware issue. After working with @esden I ended up RMA'ing my unit.

whitequark, 2024-09-21:
Changes in #699 should address the issue.

Closed 2024-09-21.

Thread 718 (2024-11-07):

voltage --no-alert

rabagliati, 2024-11-07:
I am wanting to use glasgow as a power supply - but
`glasgow voltage AB 5`
blinks the power on and off.

`glasgow voltage AB 5 --no-alert`
does what I want, and "do not raise an alert if Vsense is out of range of Vio" is unintuitive for my use case.

whitequark, 2024-11-07:
This is an incredibly common papercut even for myself, and we should just change the default.

Closed 2025-03-23.

Thread 748 (2025-03-02):

applet.internal.benchmark libusb1 `ValueError` under PyPy

Sazzach, 2025-03-02:
Running the benchmark applet with PyPy results in either a ValueError exception, or the applet hanging indefinitely. I noticed this issue you raised here: vpelletier/python-libusb1/issues/98, and changed the libusb1 version mentioned in the thread (vpelletier/python-libusb1@11e700bcbebceff3752a34849a39a360d0af4322) which fixed it.

I'm not sure if you want to wait for a libusb1 release on pypi including the finalizer lock or not so I made this issue.

Glasgow version: `Glasgow 0.1.dev2243+ga667a26 (PyPy 3.10.14 on Linux-6.8.0-54-generic-x86_64-with-glibc2.39 Ubuntu 24.04.2 LTS)`

The full debug output is ~140MB, the following is the tail end of it.
```
T: glasgow.device.hardware: USB: BULK EP6 IN length=16384 (submit)
T: glasgow.applet.internal.benchmark: FIFO: flush
T: glasgow.applet.internal.benchmark: FIFO: wait for flush
T: glasgow.applet.internal.benchmark: FIFO: cancelling operations
T: glasgow.device.hardware: USB: BULK EP6 IN (cancelled)
T: glasgow.device.hardware: USB: BULK EP6 IN (cancelled)
T: glasgow.device.hardware: USB: BULK EP6 IN (cancelled)
T: glasgow.device.hardware: USB: BULK EP6 IN (cancelled)
T: glasgow.device.hardware: USB: BULK EP6 IN (cancelled)
T: glasgow.device.hardware: USB: BULK EP6 IN (cancelled)
T: glasgow.device.hardware: USB: BULK EP6 IN (cancelled)
T: glasgow.device.hardware: USB: BULK EP6 IN (cancelled)
T: glasgow.device.hardware: USB: BULK EP6 IN (cancelled)
T: glasgow.device.hardware: USB: BULK EP6 IN (cancelled)
T: glasgow.device.hardware: USB: BULK EP6 IN (cancelled)
T: glasgow.device.hardware: USB: BULK EP6 IN (cancelled)
T: glasgow.device.hardware: USB: BULK EP6 IN (cancelled)
T: glasgow.device.hardware: USB: BULK EP6 IN (cancelled)
T: glasgow.device.hardware: USB: BULK EP6 IN (cancelled)
Traceback (most recent call last):
  File "/home/samuelz/Documents/glasgow_devel/glasgow3/glasgow/software/.venv/bin/glasgow", line 8, in <module>
    sys.exit(run_main())
             ^^^^^^^^^^
  File "/home/samuelz/Documents/glasgow_devel/glasgow3/glasgow/software/glasgow/cli.py", line 944, in run_main
    exit(asyncio.new_event_loop().run_until_complete(main()))
         ^^^^^^^^^^^^^^^^^^^^^^^^^^^^^^^^^^^^^^^^^^^^^^^^^^^
  File "/home/samuelz/.local/share/pdm/python/pypy@3.10.14/lib/pypy3.10/asyncio/base_events.py", line 649, in run_until_complete
    return future.result()
           ^^^^^^^^^^^^^^^
  File "/home/samuelz/.local/share/pdm/python/pypy@3.10.14/lib/pypy3.10/asyncio/futures.py", line 201, in result
    raise self._exception.with_traceback(self._exception_tb)
  File "/home/samuelz/.local/share/pdm/python/pypy@3.10.14/lib/pypy3.10/asyncio/tasks.py", line 232, in __step
    result = coro.send(None)
             ^^^^^^^^^^^^^^^
  File "/home/samuelz/Documents/glasgow_devel/glasgow3/glasgow/software/glasgow/cli.py", line 712, in main
    return applet_task.result()
           ^^^^^^^^^^^^^^^^^^^^
  File "/home/samuelz/.local/share/pdm/python/pypy@3.10.14/lib/pypy3.10/asyncio/futures.py", line 201, in result
    raise self._exception.with_traceback(self._exception_tb)
  File "/home/samuelz/.local/share/pdm/python/pypy@3.10.14/lib/pypy3.10/asyncio/tasks.py", line 232, in __step
    result = coro.send(None)
             ^^^^^^^^^^^^^^^
  File "/home/samuelz/Documents/glasgow_devel/glasgow3/glasgow/software/glasgow/cli.py", line 659, in run_applet
    return await applet.interact(device, args, iface)
           ^^^^^^^^^^^^^^^^^^^^^^^^^^^^^^^^^^^^^^^^^^
  File "/home/samuelz/Documents/glasgow_devel/glasgow3/glasgow/software/glasgow/applet/internal/benchmark/__init__.py", line 212, in interact
    actual = await iface.read(len(packetmax))
             ^^^^^^^^^^^^^^^^^^^^^^^^^^^^^^^^
  File "/home/samuelz/Documents/glasgow_devel/glasgow3/glasgow/software/glasgow/access/direct/demultiplexer.py", line 258, in read
    await self._in_tasks.wait_one()
  File "/home/samuelz/Documents/glasgow_devel/glasgow3/glasgow/software/glasgow/support/task_queue.py", line 84, in wait_one
    await self.poll()
  File "/home/samuelz/Documents/glasgow_devel/glasgow3/glasgow/software/glasgow/support/task_queue.py", line 71, in poll
    await self._done.popleft()
  File "/home/samuelz/.local/share/pdm/python/pypy@3.10.14/lib/pypy3.10/asyncio/futures.py", line 288, in __await__
    return self.result()  # May raise too.
           ^^^^^^^^^^^^^
  File "/home/samuelz/.local/share/pdm/python/pypy@3.10.14/lib/pypy3.10/asyncio/futures.py", line 201, in result
    raise self._exception.with_traceback(self._exception_tb)
  File "/home/samuelz/.local/share/pdm/python/pypy@3.10.14/lib/pypy3.10/asyncio/tasks.py", line 232, in __step
    result = coro.send(None)
             ^^^^^^^^^^^^^^^
  File "/home/samuelz/Documents/glasgow_devel/glasgow3/glasgow/software/glasgow/access/direct/demultiplexer.py", line 233, in _in_task
    data = await self.device.bulk_read(self._endpoint_in, size)
           ^^^^^^^^^^^^^^^^^^^^^^^^^^^^^^^^^^^^^^^^^^^^^^^^^^^^
  File "/home/samuelz/Documents/glasgow_devel/glasgow3/glasgow/software/glasgow/device/hardware.py", line 344, in bulk_read
    data = await self._do_transfer(is_read=True, setup=lambda transfer:
  File "/home/samuelz/Documents/glasgow_devel/glasgow3/glasgow/software/glasgow/device/hardware.py", line 265, in _do_transfer
    transfer = self.usb_handle.getTransfer()
               ^^^^^^^^^^^^^^^^^^^^^^^^^^^^^
  File "/home/samuelz/Documents/glasgow_devel/glasgow3/glasgow/software/.venv/lib/pypy3.10/site-packages/usb1/__init__.py", line 1517, in getTransfer
    return USBTransfer(
  File "/home/samuelz/Documents/glasgow_devel/glasgow3/glasgow/software/.venv/lib/pypy3.10/site-packages/usb1/__init__.py", line 257, in __init__
    registerFinalizer(finalizer_handle, self.__close)
  File "/home/samuelz/Documents/glasgow_devel/glasgow3/glasgow/software/.venv/lib/pypy3.10/site-packages/usb1/__init__.py", line 1047, in __registerFinalizer
    raise ValueError('Finalizer handle {handle} already exists')
ValueError: Finalizer handle {handle} already exists
```

whitequark, 2025-03-02:
Thanks, I completely forgot.

Sazzach, 2025-03-12:
I tried it with the new libusb1 release(`libusb1 3.3.0`) and it is fixed with that version too.

One interesting thing to note is that the USB performance as measured by the benchmark with `pypy` is substantially lower than `cpython`.

pypy:
```
> pdm run glasgow run benchmark
I: g.device.hardware: device already has bitstream ID 4c6d76f0db309e9240e75479026105cb
I: g.cli: running handler for applet 'benchmark'
I: g.applet.internal.benchmark: running benchmark mode source for 8.000 MiB
I: g.applet.internal.benchmark: mode source: 10.74 MiB/s (85.92 Mb/s)
I: g.applet.internal.benchmark: running benchmark mode sink for 8.000 MiB
I: g.applet.internal.benchmark: mode sink: 14.62 MiB/s (116.99 Mb/s)
I: g.applet.internal.benchmark: running benchmark mode loopback for 8.000 MiB
I: g.applet.internal.benchmark: mode loopback: 17.18 MiB/s (137.41 Mb/s)
I: g.applet.internal.benchmark: running benchmark mode latency for 8.000 MiB
I: g.applet.internal.benchmark: mode latency: mean: 956.01 µs stddev: 2003.66 µs worst: 89243.84 µs
```

cpython:
```
> pdm run glasgow run benchmark
I: g.device.hardware: device already has bitstream ID 4c6d76f0db309e9240e75479026105cb
I: g.cli: running handler for applet 'benchmark'
I: g.applet.internal.benchmark: running benchmark mode source for 8.000 MiB
I: g.applet.internal.benchmark: mode source: 41.09 MiB/s (328.75 Mb/s)
I: g.applet.internal.benchmark: running benchmark mode sink for 8.000 MiB
I: g.applet.internal.benchmark: mode sink: 35.55 MiB/s (284.37 Mb/s)
I: g.applet.internal.benchmark: running benchmark mode loopback for 8.000 MiB
I: g.applet.internal.benchmark: mode loopback: 41.74 MiB/s (333.88 Mb/s)
I: g.applet.internal.benchmark: running benchmark mode latency for 8.000 MiB
I: g.applet.internal.benchmark: mode latency: mean: 530.03 µs stddev: 71.61 µs worst: 1769.94 µs
```

whitequark, 2025-03-12:
> One interesting thing to note is that the USB performance as measured by the benchmark with pypy is substantially lower than cpython.

I'm afraid I don't have the capacity to investigate that for foreseeable future.

Sazzach, 2025-03-12:
>I'm afraid I don't have the capacity to investigate that for foreseeable future.

No worries! I didn't intend that to come across as a request for you to investigate. As I was testing, I noticed the performance difference and figured that it was notable / could potentially signify another issue wrt PyPy and libusb1. I'm not sure that is actually the case, but I didn't want to sit on a potential issue.

Closed 2025-04-26.

Thread 751 (2025-03-11):

Evaluate Corebai CBM9002A as a replacement for Cypress CY7C68013A

whitequark, 2025-03-11:
The FX2 is [being discontinued on extremely short notice](https://www.mouser.com/PCN/Infineon_cPD_314_24.pdf), with the last order date being this Saturday, and we have no other replacement for it. If the Corebai ASIC does not work we have to retire revA..revC designs entirely (meaning to treat them as legacy designs that cannot be manufactured and prioritizing the design of revD, which would have to include a new USB controller ASIC).

ewenmcneill, 2025-03-11:
Looking closer at the Product Discontinuation notice I see it's actually dated "2024-09-12" (bottom of each page), so coming up 6 months ago.   I guess we're learning about it now because resellers (eg, DigiKey / Mouser) are trying to finalise *their* last orders.

Also of note, the disclaimer at the bottom says: "Final orders can only be accepted on or before the last order date and are **subject to the availability**.  Early ordering is strongly recommended" (emphasis added)

So it seems like this might *not* be related to Skywater buying the Infineon Austin fab (February 2025)?   Possibly Cypress had it on an older Skywater process node, which got discontinued?  (I vaguely remember hearing Skywater were decomissioning an old process node a while back, but I'm not quickly finding it.)

Anyway, the actions are still "maybe buy some more stock" and "find a replacement for new boards".

Ewen

whitequark, 2025-03-11:
> So it seems like this might _not_ be related to Skywater buying the Infineon Austin fab (February 2025)?

Deals like this are usually done months in advance so I wouldn't be surprised if it is.

However, Andrew Zonenberg provided a plausible seeming explanation for it: newer product lines (CYUSB*) are simply higher margin so Infineon wants us to buy that, NRE be damned.

whitequark, 2025-03-25:
Thanks to the emergency testing efforts of @AleksaBjelogrlic we now know that, at the very least, basic functions of the device work fine (`benchmark source`, `benchmark sink`, `uart` applets). So, while there is always risk involved with a part replacement like that, this is very encouraging as it suggests there are not any major issues and the timing on the FX2 bus is fine.

Therefore, I will recommend that anyone having trouble sourcing the FX2 use the Corebai chip instead.

CounterPillow, 2025-03-26:
A replacement was seemingly already found, but I'm gonna leave this possible alternative here anyway
https://www.wch-ic.com/products/CH569.html (I have an evaluation kit of this, but haven't found the time to play with it yet)

100+ unit pricing on LCSC is $5.0353 per chip.

sd-fritze, 2025-03-26:
While that's a part that looks interesting capabilities-wise, the datasheet contains
"Please refer to and call the provided subroutine library for specific applications."
far too often (for most high-speed peripherals) - and some of the others are extremely underdocumented :(

--gruetzkopf

whitequark, 2025-07-24:
Based on an evaluation by a contract manufacturer I talked to, CBM9002A will remain in production until at least 2030. As such I believe it's an adequate replacement for the FX2LP and we can use it for foreseeable future.

GerdchenF, 2025-08-22:
> Thanks to the emergency testing efforts of [@AleksaBjelogrlic](https://github.com/AleksaBjelogrlic) we now know that, at the very least, basic functions of the device work fine (`benchmark source`, `benchmark sink`, `uart` applets).

Sorry for writing on a closed matter, but are details of the test available? I didn't find anything on that either here or at Aleksa's page.

Closed 2025-07-24.

Thread 794 (2025-05-01):

Get rid of explicit flush / autoflush as currently implemented

whitequark, 2025-05-01:
Right now, flow control works as follows. If you have a complete 512-byte packet, it is immediately submitted to the USB host. If the buffer has less than 512 bytes, you have one of two options:
1. Autoflush enabled (default): whenever the applet is no longer actively writing to the buffer, even for one cycle, the buffer is submitted.
2. Explicit flush (`auto_flush=False`): whenever the applet is asserting a signal, the buffer is submitted; otherwise it is never submitted.

Having (2) as the default caused a lot of problems early on where applets would deadlock because a flush operation was forgotten somewhere. Having (1) is a default is problematic now because it has really high performance (bandwidth, latency, *and* CPU time) overhead.

Instead of (1) by default we should use a version of [Nagle's algorithm](https://en.wikipedia.org/wiki/Nagle's_algorithm): submit a packet if it's been sitting in the buffer for a few milliseconds. We probably will also need an equivalent of `TCP_NODELAY`; although the delay is imperceptible on human timescales, protocols that require thousands of roundtrips per second will still visibly suffer from this change. However, there are many protocols which primarily transfer latency-insensitive bulk data, and the implementations of them would benefit from a default that is easier to work with.

urjaman, 2025-05-10:
I think an optionally adjustable inter-byte (or inter-write, regardless of unit size, i assume we're talking bytes) timeout (couple of milliseconds, Nagle-like) _and_ a total packet timeout (like 20ms / 50Hz) would serve most users quite well.

This thought provided to you by me going "instead of NODELAY, how about we just have adjustable delay that can be set to 0, that way things with a baud rate (or similar) could set their expected speed" - but then a 19200 baud UART will buffer for 0.27 seconds and dump the full 512 bytes, that's not optimal either - so in those cases sending packets in the handful of bytes size (1920 / 50 = 38.4) would be optimal.

whitequark, 2025-05-10:
What is the difference between "inter-write timeout" and "total packet timeout"?

urjaman, 2025-05-10:
total packet timeout counts from (resets at) the first write to the packet buffer but not on subsequent writes until the packet is sent (by being full, inter-byte timeout or the total packet timeout).

(Actually now that I'm thinking, alternatively you could just compute a more suitable maximum packet size, that might be cheaper on the gateware.)

whitequark, 2025-07-12:
@urjaman I've solved this in a slightly different manner in https://github.com/GlasgowEmbedded/glasgow/pull/948. The problem is that asserting PKTEND on a maximum-length packet may flush it to the HC, but it won't complete the URB. So the "use the bus efficiently" timeout and the "deliver data promptly" timeout can't use the same mechanism.

What do you think? It seems to work well in my testing.

Thread 822 (2025-05-19):

Implement efficient `AbstractInPipe.read_until`

whitequark, 2025-05-19:
This is slightly tricky (and annoying) to do in an applet; `spi-analyzer` and `qspi-analyzer` (and everything using COBS) would benefit from this being a part of the core framework. Asyncio offers similar functionality.

whitequark, 2025-06-08:
Done in 3f87177be29828a2a3877b267069047482b60a68.

Closed 2025-06-08.

Thread 826 (2025-05-19):

Migrate all applets to V2 API

whitequark, 2025-05-19:
- [ ] analyzer
- [ ] audio-dac
- [ ] audio-yamaha-opx
- [ ] benchmark
- [ ] control-servo
- [ ] control-si535x
- [ ] control-tps6598x
- [ ] debug-arc
- [ ] debug-arm
- [x] debug-arm7
- [ ] debug-mips
- [ ] display-hd44780
- [ ] display-pdi
- [ ] i2c-initiator
- [ ] i2c-target
- [ ] jtag-openocd
- [ ] jtag-pinout
- [ ] jtag-probe
- [ ] jtag-svf
- [ ] memory-24x
- [ ] memory-25x
- [ ] memory-floppy
- [ ] memory-onfi
- [ ] memory-prom
- [ ] program-avr-spi
- [ ] program-ice40-flash
- [ ] program-ice40-sram
- [ ] program-m16c
- [ ] program-mec16xx
- [ ] program-nrf24lx1
- [ ] program-stusb4500-nvm
- [ ] program-xc6s
- [ ] program-xc9500
- [ ] program-xc9500xl
- [ ] program-xpla3
- [ ] ps2-host
- [x] qspi-analyzer
- [ ] qspi-controller
- [ ] radio-nrf24l01
- [ ] sbw-probe
- [ ] selftest
- [ ] sensor-bmx280
- [ ] sensor-hx711
- [ ] sensor-ina260
- [ ] sensor-mouse-ps2
- [ ] sensor-pmsx003
- [ ] sensor-scd30
- [ ] sensor-sen5x
- [x] spi-analyzer
- [ ] spi-controller
- [ ] spi-flashrom
- [ ] swd-openocd
- [x] uart
- [ ] video-hub75-output
- [ ] video-rgb-input
- [ ] video-vga-output
- [ ] video-ws2812-output

Thread 931 (2025-07-05):

When using the I2C example, it prompts that the device is occupied and the device cannot be connected

mayjack0312, 2025-07-05:
I use the following command to communicate with the PMBUS host computer
```
glasgow run i2c-initiator --scl A0 --sda A1 --pulls -V 3.3 scan
```
After the command is successfully entered, the host computer displays that it is always searching for devices.

Below is the core code of the host computer to obtain the device

```
# Glasgow Device Finder Module
# Device finding related code extracted from GDE25S12B_GUI_glasgow_version.py

import tkinter as tk
from tkinter import messagebox
import ttkbootstrap as ttk
from ttkbootstrap.constants import *
import asyncio
import threading
import logging
import traceback
from typing import Optional, Tuple, Callable

# Try to import glasgow related modules
try:
    from glasgow.hardware.device import glasgowDevice
    glasgow_AVAILABLE = True
except ImportError as e:
    print(f"Warning: Unable to import glasgow module: {e}")
    print("Please ensure glasgow is properly installed and configured")
    glasgow_AVAILABLE = False

# Configure logging
logging.basicConfig(
    level=logging.INFO,
    format="%(asctime)s [%(levelname)s]: %(message)s",
    datefmt="%Y-%m-%d %H:%M:%S"
)
logger = logging.getLogger(__name__)

class glasgowDeviceFinder:
    """Glasgow Device Finder"""

    def __init__(self, default_address: int = 0x5B):
        """
        Initialize the finder

        Args:
            default_address: Default I2C device address
        """
        self.default_address = default_address
        self.device = None
        self.is_connected = False

    def is_glasgow_available(self) -> bool:
        """Check if glasgow module is available"""
        return glasgow_AVAILABLE

    def find_and_connect(self) -> Tuple[Optional[glasgowDevice], Optional[int]]:
        """
        Find and connect to the first available glasgow device

        Returns:
            (device instance, device address) or (None, None)
        """
        if not self.is_glasgow_available():
            logger.error("Glasgow module not available")
            return None, None

        try:
            # Try to enumerate devices
            serials = glasgowDevice.enumerate_serials()
            logger.info(f"Found {len(serials)} glasgow devices: {serials}")
   
            if serials:
                # Connect to the first device
                device = glasgowDevice(serials[0])
                logger.info(f"Successfully connected to device: {serials[0]}")
                self.device = device
                self.is_connected = True
                return device, self.default_address
            else:
                logger.warning("No glasgow devices found")
                return None, None
       
        except Exception as e:
            logger.error(f"Glasgow device connection failed: {e}")
            traceback.print_exc()
            return None, None

    def find_and_connect_async(self, callback: Callable[[Optional[glasgowDevice], Optional[int]], None]):
        """
        Asynchronously find and connect to device

        Args:
            callback: Callback function with parameters (device instance, device address)
        """
        def worker():
            try:
                # Set up event loop
                loop = asyncio.new_event_loop()
                asyncio.set_event_loop(loop)
       
                # Find and connect to device
                device, addr = self.find_and_connect()
       
                # Call callback
                callback(device, addr)
       
            except Exception as e:
                logger.error(f"Async connection failed: {e}")
                traceback.print_exc()
                callback(None, None)

        # Run in new thread
        thread = threading.Thread(target=worker, daemon=True)
        thread.start()

    def disconnect(self):
        """Disconnect device"""
        if self.device:
            try:
                # Glasgow devices typically don't need explicit disconnection
                self.device = None
                self.is_connected = False
                logger.info("Device connection disconnected")
            except Exception as e:
                logger.error(f"Disconnection failed: {e}")

    def get_connection_status(self) -> str:
        """Get connection status"""
        if not self.is_glasgow_available():
            return "Glasgow module not available"
        elif self.is_connected and self.device:
            return "Connected"
        else:
            return "Not connected"

    def test_connection(self) -> bool:
        """Test if current connection is valid"""
        if not self.device or not self.is_connected:
            return False

        try:
            # Try to get device serial number to test connection
            serial = getattr(self.device, '_serial', None)
            return serial is not None
        except Exception as e:
            logger.error(f"Connection test failed: {e}")
            return False

class ConfigDialog(ttk.Toplevel):
    """Glasgow Device Connection Configuration Dialog"""

    def __init__(self, parent, callback):
        super().__init__(parent)
        self.title("Connect Glasgow Device")
        self.callback = callback
        self.transient(parent)
        self.grab_set()
        self.resizable(False, False)
        self.geometry("350x120")
        ttk.Label(self, text="Searching for Glasgow device...", font=("Microsoft YaHei", 12)).pack(pady=20)
        self.after(100, lambda: self.try_connect())

    def try_connect(self):
        def worker():
            try:
                import traceback
                loop = asyncio.new_event_loop()
                asyncio.set_event_loop(loop)
                print("[DEBUG] glasgowDevice dir:", dir(glasgowDevice))
                # Try to enumerate devices
                serials = glasgowDevice.enumerate_serials()
                print("[DEBUG] enumerate_serials returned:", serials)
                if serials:
                    device = glasgowDevice(serials[0])
                    print("[DEBUG] Device instantiation successful: ", device)
                    addr = 0x5B
                    self.callback(device, addr)
                else:
                    print("[ERROR] No glasgow devices found")
                    self.callback(None, None)
            except Exception as e:
                print("[ERROR] glasgowDevice call failed:", e)
                traceback.print_exc()
                self.callback(None, None)
            finally:
                self.destroy()

        threading.Thread(target=worker, daemon=True).start()

# Convenience functions
def find_glasgow_device() -> Tuple[Optional[glasgowDevice], Optional[int]]:
    """Convenience function to find and connect to glasgow device"""
    finder = glasgowDeviceFinder()
    return finder.find_and_connect()

def find_glasgow_device_async(callback: Callable[[Optional[glasgowDevice], Optional[int]], None]):
    """Convenience function to asynchronously find and connect to glasgow device"""
    finder = glasgowDeviceFinder()
    finder.find_and_connect_async(callback)

def check_glasgow_availability() -> bool:
    """Convenience function to check if glasgow is available"""
    finder = glasgowDeviceFinder()
    return finder.is_glasgow_available()

def safe_find_device() -> Tuple[Optional[glasgowDevice], Optional[int]]:
    """Safe device finding function with complete error handling"""
    if not glasgow_AVAILABLE:
        logger.error("Glasgow module not available")
        return None, None

    try:
        # Enumerate devices
        serials = glasgowDevice.enumerate_serials()
        logger.info(f"Found {len(serials)} glasgow devices: {serials}")

        if not serials:
            logger.warning("No glasgow devices found")
            return None, None

        # Connect to first device
        device = glasgowDevice(serials[0])
        logger.info(f"Successfully connected to device: {serials[0]}")
        return device, 0x5B

    except Exception as e:
        logger.error(f"Device finding failed: {e}")
        traceback.print_exc()
        return None, None

# Usage example
if __name__ == "__main__":
    print("Glasgow Device Finder Test")
    print("=" * 50)

    # Check glasgow availability
    if not check_glasgow_availability():
        print("❌ Glasgow module not available")
        exit(1)

    print("✅ Glasgow module available")

    # Method 1: Using finder class
    finder = glasgowDeviceFinder()
    device, addr = finder.find_and_connect()

    if device and addr:
        print(f"✅ Successfully connected to device")
        print(f"   Device address: 0x{addr:02X}")
        print(f"   Connection status: {finder.get_connection_status()}")

        # Test connection
        if finder.test_connection():
            print("✅ Connection test passed")
        else:
            print("❌ Connection test failed")
    else:
        print("❌ Connection failed")
        print("Please ensure:")
        print("1. Glasgow hardware is connected to USB")
        print("2. Glasgow firmware is installed")
        print("3. Device drivers are properly installed")

    # Method 2: Using convenience functions
    print("\n" + "=" * 50)
    print("Testing convenience functions:")
    device2, addr2 = safe_find_device()
    if device2:
        print(f"✅ Convenience function connection successful, address: 0x{addr2:02X}")
    else:
        print("❌ Convenience function connection failed")

    # Method 3: Async connection example
    print("\n" + "=" * 50)
    print("Async connection test:")

    def on_device_found(device, addr):
        if device:
            print(f"✅ Async connection successful, address: 0x{addr:02X}")
        else:
            print("❌ Async connection failed")

    find_glasgow_device_async(on_device_found)

    # Wait for async operation to complete
    import time
    time.sleep(2)
```

mayjack0312, 2025-07-05:
I think the core problem is that I need to run the flash command to burn the program into the chip. Is there any way to run it without occupying the device?

mayjack0312, 2025-07-05:
> When asking for help with the `glasgow` command, please post the complete log, which can be obtained by running `glasgow -L logfile.txt <...>`.

Okay, I'll take a look later

Closed 2025-07-06.

Thread 934 (2025-07-06):

Make IO standard a part of `GlasgowPin` structure

whitequark, 2025-07-06:
This would entail additional infrastructure for:
1. Automating adding a voltage argument that would populate the IO voltage part of the `GlasgowPin` structure;
2. Making sure it is not onerous to specify voltage when using applets via the CLI;
3. Making sure it is not onerous to specify voltage when using applets via the API.

For (1), I propose slightly amending our current DSL to:

```python
    @classmethod
    def add_build_arguments(cls, parser, access):
        with access.add_voltage_argument(parser):
            access.add_pins_argument(parser, "ce",   default=True, required=True)
            access.add_pins_argument(parser, "cs",   default=True, required=True)
            access.add_pins_argument(parser, "sck",  default=True, required=True)
            access.add_pins_argument(parser, "copi", default=True, required=True)
            access.add_pins_argument(parser, "cipo", default=True, required=True)
            access.add_pins_argument(parser, "irq",  default=True)
```

This would create *a* voltage argument (probably with a `name: Optional[str]` argument, for dual I/O voltage applets) and attach it to the pins arguments inside the context manager, so that specyfing the voltage automatically inserts that value into the `GlasgowPin` objects in the namespace attributes defined by the `add_pin_argument` calls.

The explicit `assembly.use_voltage` call will then disappear. The Glasgow assembly would be able to diagnose voltage conflicts in `configure_ports`, as a separate step before making any actual adjustments to voltages.

For (2), I propose making the voltage argument required by default (to avoid a common current mistake: forgetting it entirely and getting nothing from the applet), but making it possible to specify `--voltage -` (similar to `--pin-cs -` which you can do already).

For (3), I propose making it legal to use `GlasgowPin` structures without a voltage attached to them, with the expectation that the `use_voltage` call will be done by whoever instantiates the `*Interface` object. (This guardrail can also be used for (2).) This way, one would be able to do e.g. `ce="A1"` without worrying about the voltage.

For (2) & (3), I propose also making it possible to say both `--pin-ce A1~3.3` and `ce="A1~3.3"`. It's not clear whether this is even a good idea, but it is worth looking at as a natural extension of our pin specification language.

whitequark, 2025-07-06:
Making this happen will require changing every V2 applet, but since this involves adjusting the `build` method in a straightforward way, it won't involve redoing hardware tests on every applet.

Thread 968 (2025-07-23):

How to use the Recovery function to "recover bricks"

mayjack0312, 2025-07-23:
When I was developing the firmware, the firmware failed to burn and it said:
Windows has stopped the device because it has a problem. (Code 43)
The USB configuration descriptor returned by the USB device is invalid.

I tried to short-circuit R40 and reinstall the driver, but after the driver was successfully installed and restarted, an error message continued to pop up:
Windows has stopped the device because it has a problem. (Code 43)
The USB configuration descriptor returned by the USB device is invalid.

How can I re-burn the firmware?

whitequark, 2025-07-23:
You do not need to reinstall the driver. Short R40 and then use `glasgow factory` command to re-initialize the EEPROM. This will change the serial number of the device unless you supply the one you got from the factory, which should be on a sticker on the back of the PCB.

mayjack0312, 2025-07-23:
> On Windows, you may need to use Zadig to install a different, WinUSB driver for the VID=0x04B4 and PID=0x8613 device since that driver won't be attached by default.

Thanks for the help, it finally worked, except the serial number became C3-20250724T001218Z, all other functions are fine. Thank you

whitequark, 2025-07-23:
> C3-20250724T001218Z

Yes, by default the serial number is generated from current date and time. You can use the `--serial` option to use any serial number you want. You will need to supply it without the "C3-" prefix, eg `--serial 20250724T001218Z`.

mayjack0312, 2025-07-23:
> > C3-20250724T001218Z
>
> Yes, by default the serial number is generated from current date and time. You can use the `--serial` option to use any serial number you want. You will need to supply it without the "C3-" prefix, eg `glasgow factory --serial 20250724T001218Z`.

Okay, this is great.

Closed 2025-07-23.

Thread 982 (2025-07-28):

Unable to upgrade firmware from 2025-01-26

flokli, 2025-07-28:
I updated glasgow from 2a67f79d6025a06e98277956cbb036c4237960f1 to 8a61053c7b7ff241c096eba68c6ab8fc0e0389f7.

I got prompted to upgrade the firmware, but had issues with `glasgow flash` running into `LIBUSB_ERROR_TIMEOUT`.

I get one of the two error behaviours during a `glasgow flash` invocation:

```
sudo result/bin/glasgow --log-file issue.log flash
I: g.hardware.device: found revC3 device with API level 3 (supported API level is 4)
Traceback (most recent call last):
  File "/nix/store/3w5rxhwl847595k46dxvqsklqrcdgcas-glasgow-0-unstable-2025-07-24/lib/python3.13/site-packages/glasgow/support/usb/libusb1.py", line 58, in wrapper
    return f(*args, **kwargs)
  File "/nix/store/3w5rxhwl847595k46dxvqsklqrcdgcas-glasgow-0-unstable-2025-07-24/lib/python3.13/site-packages/glasgow/support/usb/libusb1.py", line 205, in serial_number
    self._serial_number = self._ensure_open.getASCIIStringDescriptor(
                          ~~~~~~~~~~~~~~~~~~~~~~~~~~~~~~~~~~~~~~~~~~^
        self._impl_device.getSerialNumberDescriptor())
        ^^^^^^^^^^^^^^^^^^^^^^^^^^^^^^^^^^^^^^^^^^^^^^
  File "/nix/store/bpqzv0gm5wcgxx7j637gh4wf9wjr86wj-python3.13-libusb1-3.3.1/lib/python3.13/site-packages/usb1/__init__.py", line 1364, in getASCIIStringDescriptor
    received = mayRaiseUSBError(libusb1.libusb_get_string_descriptor_ascii(
        self.__handle, descriptor,
        create_binary_buffer(descriptor_string)[0],
        STRING_LENGTH,
    ))
  File "/nix/store/bpqzv0gm5wcgxx7j637gh4wf9wjr86wj-python3.13-libusb1-3.3.1/lib/python3.13/site-packages/usb1/__init__.py", line 129, in mayRaiseUSBError
    __raiseUSBError(value)
    ~~~~~~~~~~~~~~~^^^^^^^
  File "/nix/store/bpqzv0gm5wcgxx7j637gh4wf9wjr86wj-python3.13-libusb1-3.3.1/lib/python3.13/site-packages/usb1/__init__.py", line 121, in raiseUSBError
    raise __STATUS_TO_EXCEPTION_DICT.get(value, __USBError)(value)
usb1.USBErrorTimeout: LIBUSB_ERROR_TIMEOUT [-7]

The above exception was the direct cause of the following exception:

Traceback (most recent call last):
  File "/nix/store/3w5rxhwl847595k46dxvqsklqrcdgcas-glasgow-0-unstable-2025-07-24/bin/.glasgow-wrapped", line 9, in <module>
    sys.exit(run_main())
             ~~~~~~~~^^
  File "/nix/store/3w5rxhwl847595k46dxvqsklqrcdgcas-glasgow-0-unstable-2025-07-24/lib/python3.13/site-packages/glasgow/cli.py", line 1056, in run_main
    exit(asyncio.new_event_loop().run_until_complete(main()))
         ~~~~~~~~~~~~~~~~~~~~~~~~~~~~~~~~~~~~~~~~~~~^^^^^^^^
  File "/nix/store/chgczp3c2zsr14bxkx9vfwsywajbgbgg-python3-3.13.5/lib/python3.13/asyncio/base_events.py", line 725, in run_until_complete
    return future.result()
           ~~~~~~~~~~~~~^^
  File "/nix/store/3w5rxhwl847595k46dxvqsklqrcdgcas-glasgow-0-unstable-2025-07-24/lib/python3.13/site-packages/glasgow/cli.py", line 605, in main
    device = await GlasgowDevice.find(args.serial)
             ^^^^^^^^^^^^^^^^^^^^^^^^^^^^^^^^^^^^^
  File "/nix/store/3w5rxhwl847595k46dxvqsklqrcdgcas-glasgow-0-unstable-2025-07-24/lib/python3.13/site-packages/glasgow/hardware/device.py", line 187, in find
    usb_devices = await cls._enumerate_devices(usb_context)
                  ^^^^^^^^^^^^^^^^^^^^^^^^^^^^^^^^^^^^^^^^^
  File "/nix/store/3w5rxhwl847595k46dxvqsklqrcdgcas-glasgow-0-unstable-2025-07-24/lib/python3.13/site-packages/glasgow/hardware/device.py", line 114, in _enumerate_devices
    device.serial_number)
    ^^^^^^^^^^^^^^^^^^^^
  File "/nix/store/3w5rxhwl847595k46dxvqsklqrcdgcas-glasgow-0-unstable-2025-07-24/lib/python3.13/site-packages/glasgow/support/usb/libusb1.py", line 60, in wrapper
    map_error(err)
    ~~~~~~~~~^^^^^
  File "/nix/store/3w5rxhwl847595k46dxvqsklqrcdgcas-glasgow-0-unstable-2025-07-24/lib/python3.13/site-packages/glasgow/support/usb/libusb1.py", line 45, in map_error
    raise Error(str(error)) from error
glasgow.support.usb.Error: LIBUSB_ERROR_TIMEOUT [-7]
```

```
I: g.hardware.device: found revC3 device with API level 3 (supported API level is 4)
W: g.hardware.device: please run `glasgow flash` to update firmware of device C3-20241011T135145Z
W: g.hardware.device: device 001/002 did not re-enumerate after firmware upload
E: g.cli: device not found
```

I was only able to reproduce when having the older firmware present; running `glasgow flash --remove-firmware` with the new glasgow version was not sufficient.

I reproduced this by building nixpkgs' on current `master` (which uses the upstream `.ihex` file due to a packaging bug), and by building https://github.com/NixOS/nixpkgs/pull/382355 (which produces the same firmware as upstream), by invoking `sudo $(nix-build -A glasgow)/bin/glasgow flash` with a commit before and after the bump to `0-unstable-2025-07-28`. [^1]

[^1]: Contrary to the older reports in https://github.com/GlasgowEmbedded/glasgow/pull/958, I was also able to reproduce the issues with the parent commit of that PR.

flokli, 2025-07-28:
Running
 - `glasgow flash --remove-firmware` with 2a67f79d6025a06e98277956cbb036c4237960f1,
 - replug
 - `glasgow flash` with 42327220a33f70b061c9103309364b6ecc1c507f
 -  replug
 - `glasgow flash` with 8a61053c7b7ff241c096eba68c6ab8fc0e0389f7
 -  replug

seems to be a way to workaround this issue and lift the device to API level 4.

If I skip step the  `glasgow flash` with 42327220a33f70b061c9103309364b6ecc1c507f, replug, then
`glasgow flash` with 8a61053c7b7ff241c096eba68c6ab8fc0e0389f7 shows the following error:

```
W: g.hardware.device: device 001/003 did not re-enumerate after firmware upload
E: g.cli: device not found
```
So it looks like somewhere between 42327220a33f70b061c9103309364b6ecc1c507f..8a61053c7b7ff241c096eba68c6ab8fc0e0389f7 `glasgow flash` lost the ability to deal with unflashed, or API level 3 devices.

flokli, 2025-07-28:
42327220a33f70b061c9103309364b6ecc1c507f (July 18, 2025) already contains the fix b78ec447e285779838f16eadc901ddd990420fe4 (Aug 3, 2024).

whitequark, 2025-07-28:
OK, I have simplified your reproducer. On current HEAD:

```
$ glasgow flash --remove-firmware
# replug
$ glasgow list
```

is sufficient to cause a timeout. It is not sporadic but rather reliably occurs every time.

whitequark, 2025-07-28:
Fixed in https://github.com/GlasgowEmbedded/glasgow/pull/983. I made an error while refactoring and wrong code was being uploaded.

Thread 984 (2025-07-29):

AttributeError: 'EnumView' object has no attribute 'name' when using an `amaranth.lib.enum.Enum` with `glasgow.hardware.assembly.add_rw_register()`

joelpmichael, 2025-07-29:
Raising bug as requested by @whitequark in Mastodon thread https://aus.social/@jpm/114933922761154443

I'm trying to use an `amaranth.lib.enum.Enum` with `glasgow.hardware.assembly.add_rw_register()`, and it is failing with errors:

```
joel@Joels-iMac-Pro bitstreams % glasgow -vvv run shift-register-cd4021 -V 5
D: g.cli: Glasgow 0.1.dev2601+g7943521.d20250729 (CPython 3.13.5 on macOS-15.5-x86_64-i386-64bit-Mach-O)
D: g.hardware.device: found revC3 device with serial C3-20240518T195949Z
W: g.applet.interface.CD4021: applet is PREVIEW QUALITY and may CORRUPT DATA
D: g.applet.interface.CD4021: setting port A voltage to 5.00 V
D: g.applet.interface.CD4021: setting port B voltage to 5.00 V
D: g.applet.interface.CD4021: assigning pin clock to A1
D: g.applet.interface.CD4021: assigning pin data to A0
D: g.applet.interface.CD4021: assigning pin latch to A2
Traceback (most recent call last):
  File "/Users/joel/.local/pipx/venvs/glasgow/bin/glasgow", line 8, in <module>
    sys.exit(run_main())
             ~~~~~~~~^^
  File "/Users/joel/.local/pipx/venvs/glasgow/lib/python3.13/site-packages/glasgow/cli.py", line 1056, in run_main
    exit(asyncio.new_event_loop().run_until_complete(main()))
         ~~~~~~~~~~~~~~~~~~~~~~~~~~~~~~~~~~~~~~~~~~~^^^^^^^^
  File "/usr/local/Cellar/python@3.13/3.13.5/Frameworks/Python.framework/Versions/3.13/lib/python3.13/asyncio/base_events.py", line 725, in run_until_complete
    return future.result()
           ~~~~~~~~~~~~~^^
  File "/Users/joel/.local/pipx/venvs/glasgow/lib/python3.13/site-packages/glasgow/cli.py", line 653, in main
    applet, target = _applet(assembly, args)
                     ~~~~~~~^^^^^^^^^^^^^^^^
  File "/Users/joel/.local/pipx/venvs/glasgow/lib/python3.13/site-packages/glasgow/cli.py", line 469, in _applet
    applet.build(args)
    ~~~~~~~~~~~~^^^^^^
  File "/Users/joel/.local/pipx/venvs/glasgow/lib/python3.13/site-packages/glasgow/applet/interface/CD4021/__init__.py", line 259, in build
    self.ShiftRegisterCD4021_iface = ShiftRegisterCD4021Interface(
                                     ~~~~~~~~~~~~~~~~~~~~~~~~~~~~^
        self.logger,
        ^^^^^^^^^^^^
    ...<4 lines>...
        num_bits=args.num_bits,
        ^^^^^^^^^^^^^^^^^^^^^^^
    )
    ^
  File "/Users/joel/.local/pipx/venvs/glasgow/lib/python3.13/site-packages/glasgow/applet/interface/CD4021/__init__.py", line 169, in __init__
    self._reg_mode = assembly.add_rw_register(component.reg_mode)
                     ~~~~~~~~~~~~~~~~~~~~~~~~^^^^^^^^^^^^^^^^^^^^
  File "/Users/joel/.local/pipx/venvs/glasgow/lib/python3.13/site-packages/glasgow/hardware/assembly.py", line 555, in add_rw_register
    address=2 + len(self._registers), shape=signal.shape(), name=signal.name)
                                                                 ^^^^^^^^^^^
AttributeError: 'EnumView' object has no attribute 'name'
```

Turning these into a Python `enum.Enum` works fine, with the appropriate code adjustments to use `enum.Enum.value` where necessary.

Code snippets in question:

```python

class CD4021Mode(enum.Enum, shape=range(4)):
    IDLE = 0  # No command, component is allowed to run
    STOP = 1  # Stop processing
    LATCH = 2  # Perform latch + data reads
    DATA = 3  # Perform data reads only

...

class ShiftRegisterCD4021Component(wiring.Component):
    def __init__(self, ports, num_bits: int = 8):
        if num_bits < 2:
            raise ValueError("num_bits must be 2 or more")

        self._ports = ports
        self._num_bits = num_bits

        self._reg_state = Signal(CD4021State, init=CD4021State.LATCH)
        self._reg_data = Signal(self._num_bits + 1, init=0)

        super().__init__(
            {
                "reg_active": Out(
                    1,
                    init=0,
                ),  # will be set to 1 when component is busy sampling data
                "reg_mode": In(
                    CD4021Mode,
                ),  # requested working mode, reset to IDLE to start working
                "stream_result": Out(
                    stream.Signature(self._num_bits),
                ),  # output data stream
            }
        )

...

class ShiftRegisterCD4021Interface:
    def __init__(
        self,
        logger: logging.Logger,
        assembly: AbstractAssembly,
        *,
        clock: GlasgowPin,
        data: GlasgowPin,
        latch: GlasgowPin,
        num_bits: int,
    ):
        self._logger = logger
        self._level = logging.DEBUG if self._logger.name == __name__ else logging.TRACE

        ports = assembly.add_port_group(clock=clock, data=data, latch=latch)
        component = assembly.add_submodule(
            ShiftRegisterCD4021Component(ports, num_bits=num_bits), name="cd4021"
        )
        self._result_pipe = assembly.add_in_pipe(component.stream_result)
        self._reg_mode = assembly.add_rw_register(component.reg_mode)
        self._reg_active = assembly.add_ro_register(component.reg_active)

...

class ShiftRegisterCD4021Applet(GlasgowAppletV2):
...
    def build(self, args):
        with self.assembly.add_applet(self):
            # FIXME - detect requested voltage, info if < 5V, warn if < 3V
            self.assembly.use_voltage(args.voltage)
            self.ShiftRegisterCD4021_iface = ShiftRegisterCD4021Interface(
                self.logger,
                self.assembly,
                clock=args.clock,
                data=args.data,
                latch=args.latch,
                num_bits=args.num_bits,
            )
...
```

Thread 998 (2025-08-09):

UART escape key combination is hard to type on german keyboards

fridtjof, 2025-08-09:
As noted by esc_ctrl in the project's channel, Ctrl+\ is quite complicated to type on (at least) german keyboard layouts:

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

(In this case, it would mean holding both Ctrl (Strg) and the "Alt Gr" modifiers, then pressing the ß key to type Ctrl+\)

To make it worse, Apple keyboards (as found on any Mac) have a wildly different layout when it comes to special characters. Here, a backslash is typed by holding **both** Shift and the option ("alt") key, then pressing 7 (there is logic behind this believe me or not). That means 3 modifiers for Ctrl+\\.

A list of special characters typable without modifiers on both regular and Apple german keyboards (umlauts included for completeness, obviously not universally viable):

| < | , | . | - | # | + | ß | ´ (diacritic, triggers compose logic) | ^ (same) | ä | ö | ü |
| --- | --- | --- | --- | --- | --- | --- | --- | --- | --- | --- | --- |

(This only covers de_DE layouts, not sure whether this fully applies to other layouts like de_CH, de_AT, ..., not to mention whatever Apple cooked up for those)

Are any of these usable on (at least) en_ layouts, while also not having pre established semantics (e.g. editors like nano, emacs) they would collide with?

whitequark, 2025-08-09:
Fixed by https://github.com/GlasgowEmbedded/glasgow/pull/1000.

Closed 2025-08-09.

Thread 1007 (2025-08-13):

Off-By-1 error in glasgow.gateware.clockgen.ClockGen causes incorrect clock frequency to be generated

joelpmichael, 2025-08-13:
### Version

Glasgow 0.1.dev2629+g9205dde.d20250811 (CPython 3.13.5 on macOS-15.6-x86_64-i386-64bit-Mach-O)

### Description

Not sure if ClockGen is still part of the Glasgow API, as it doesn't seem to be widely used. Happy for this bug to be closed WONTFIX if it's being deprecated. Also happy to write a PR to fix this if ClockGen is going to be hanging around.

The "common" case of `cyc >= 2` contains the following code:

```python
        if self.cyc >= 2:
            # General case.
            # Implementation: counter.
            counter = Signal(range(self.cyc))
            clk_r = Signal()

            m.d.sync += counter.eq(counter - 1)
            with m.If(counter == 0):
                m.d.sync += counter.eq(self.cyc - 1)

            with m.If(counter == self.cyc // 2):
                m.d.sync += self.clk.eq(1)
            with m.If(counter == 0):
                m.d.sync += self.clk.eq(0)

            m.d.sync += clk_r.eq(self.clk)
            m.d.comb += [
                self.stb_r.eq(~clk_r & self.clk),
                self.stb_f.eq(clk_r & ~self.clk),
            ]
```

The off-by-one issue is because `counter = Signal(range(self.cyc))` produces a range of 0 to (`self.cyc` - 1), i.e. for the case `self.cyc == 2` the counter can only hold values 0 or 1. This ends up being a half-divider because when `counter == 0` it is reloaded with `self.cyc - 1` == 1, and the next tick the counter is decremented and is now 0 so the counter is reloaded. This can be fixed by increasing the size of `counter` by 1 i.e. `counter = Signal(range(self.cyc) + 1)` and reloading with `self.cyc` i.e. `m.d.sync += counter.eq(self.cyc)`. This issue is visible in simulation, and can also be observed with an oscilloscope that supports frequency measurement when `clk` is hooked up to a GPIO pin. The error is more significant at lower divider values (higher frequency) with the worst case being a divider value of 2 producing 24MHz instead of the expected 16MHz from Glasgow's source 48MHz clock.

However if the fix is applied, then the calculation for the half-way point of the tick at `with m.If(counter == self.cyc // 2)` is now off-by-one, which can be fixed by adding 1 to `self.cyc` in the statement i.e. `with m.If(counter == (self.cyc + 1) // 2)`. I have verified this fix in simulation and by measuring with an oscilloscope.

### Log file

_No response_

whitequark, 2025-08-13:
Probably the same issue as #668

joelpmichael, 2025-08-14:
> Probably the same issue as [#668](https://github.com/GlasgowEmbedded/glasgow/pull/668)

It is. As noted on Mastodon, ClockGen is considered deprecated, plus the notes in #667 indicate that going through every single consumer of ClockGen and users of ClockGen.derive would be needed to fix this.

Closed 2025-08-14.

Thread 1019 (2025-09-24):

Schematics.pdf for Rev C3 shows "Rev C2" in the page header.

langleyVa, 2025-09-24:
### Version

n.A.

### Description

The schematic.pdf for rev C3 (see https://github.com/GlasgowEmbedded/glasgow/blob/main/hardware/boards/glasgow/revC3/schematics.pdf) says "Rev: C2" in the lower right corner of every sheet.

### Log file

_No response_

whitequark, 2025-09-24:
Thanks. Could you submit a PR fixing this?

langleyVa, 2025-09-24:
Well, sorry about this, but:

The version of Kicad that Ubuntu gives me (7.0.11+dfsg-1build4) is newer than what is listed in the PDF (7.0.8-7.0.8~ubuntu22.04.1). It still refuses to open the schematic: "KiCad was unable to open this file because it was created with a more recent version than the one you are running. To open it you will need to upgrade KiCad to a version dated 20231120 or later."

The version that the Kicad PPA gives me (9.0.4) changes a few bits and bobs in the project files when saving, but also changes all instances of "+3.3V" to "+3V3". That's way out of my comfort zone, it seems like a great way to screw something up in subtle ways that I don't know enough about to make sure that I don't mess them up.

I can offer a pull request where I just commit whatever Kicad 9.0.4 decides is the best way forward for the project, or I have to pass this on to someone who has the right version of Kicad lying around.

whitequark, 2025-09-24:
@q3k Do you think you could handle this?

langleyVa, 2025-09-24:
P.S. Last Commit message on the .kicad_sch file says "Open and save with Kicad 8.0.9"

q3k, 2025-09-24:
See #1020

langleyVa, 2025-09-25:
That closed it, thank you!

Closed 2025-09-25.
