GlasgowEmbedded/glasgow/hardware/boards/test-jig/schematics.pdf

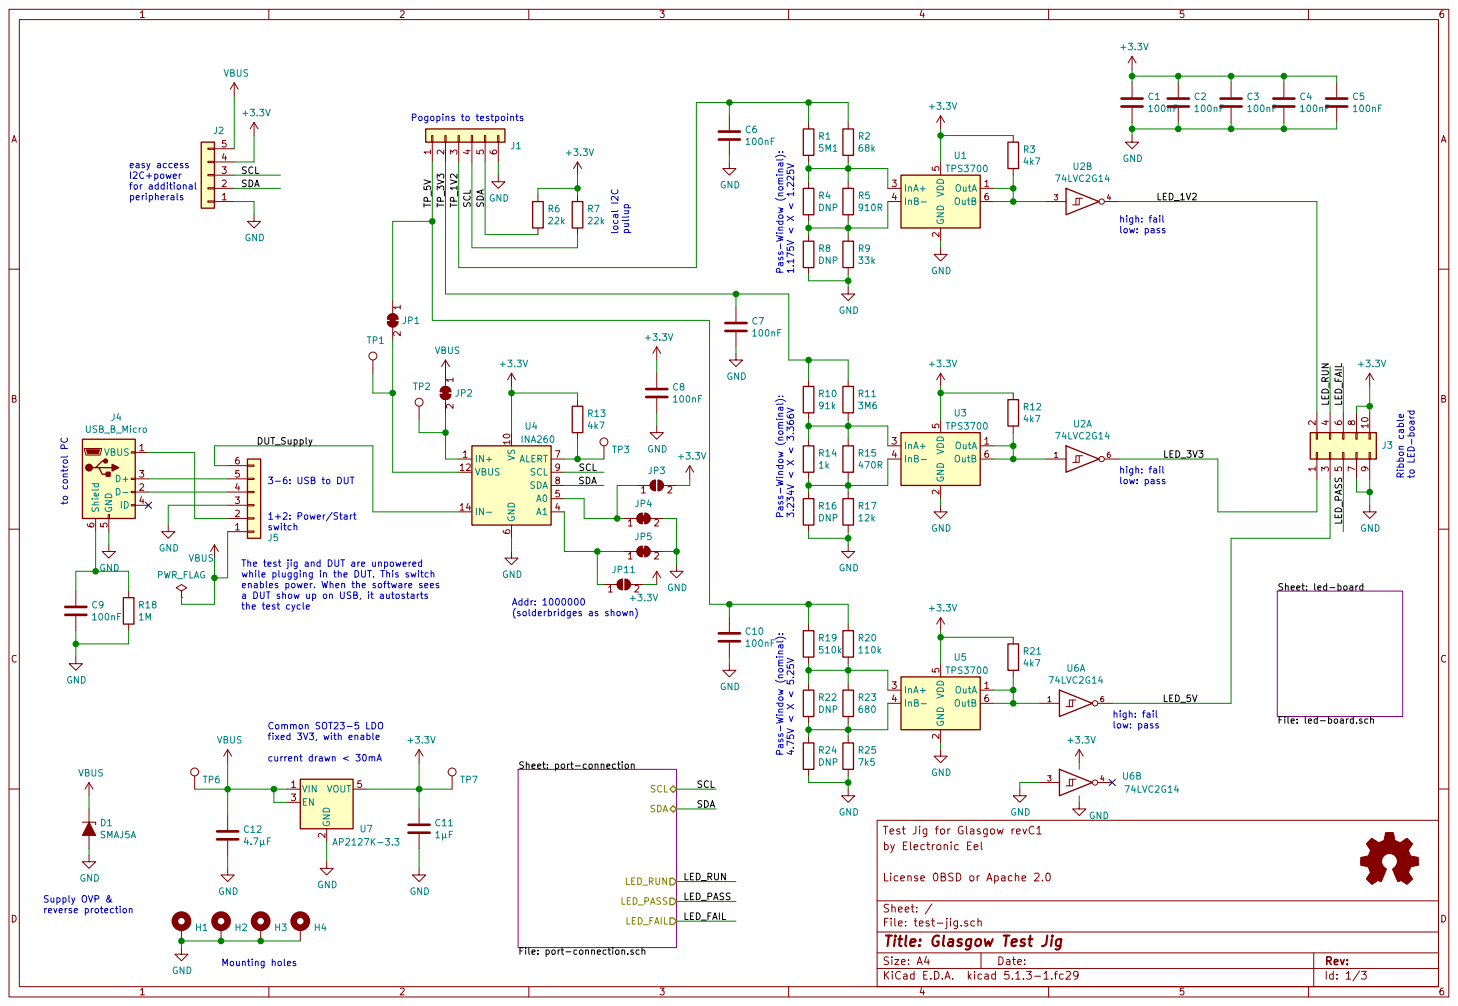
[picture p27: page 1]

LED_1V2 DUT_Supply SCL to control PC

1+2: Power/Start switch Common SOT23-5 LDO

low: pass Pass-Window (nominal): 3.234V < X < 3.366V

3-6: USB to DUT Supply OVP &

The test jig and DUT are unpowered
while plugging in the DUT. This switch
enables power. When the software sees
a DUT show up on USB, it autostarts

Test Jig for Glasgow revC1
by Electronic Eel

File: test-jig.sch Sheet: / License 0BSD or Apache 2.0

Id: 1/3 Title: Glasgow Test Jig

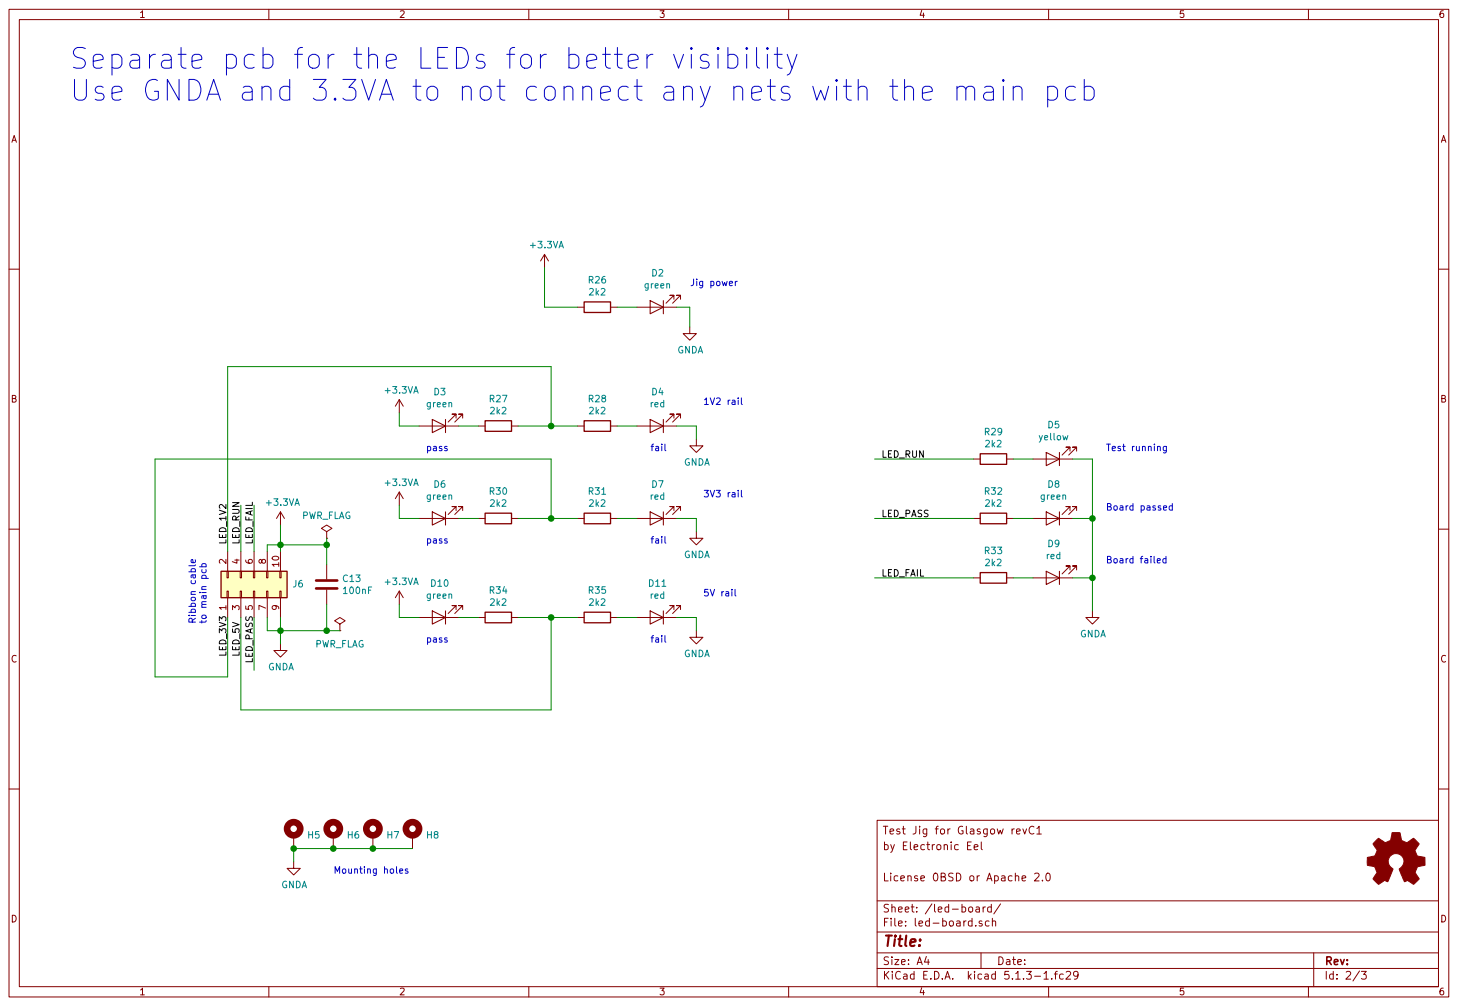
[picture p28: page 2]

Use GNDA and 3.3VA to not connect any nets with the main pcb

Test Jig for Glasgow revC1 D6

5V rail Ribbon cable to main pcb

Id: 2/3 Title: File: led-board.sch Sheet: /led-board/ License 0BSD or Apache 2.0

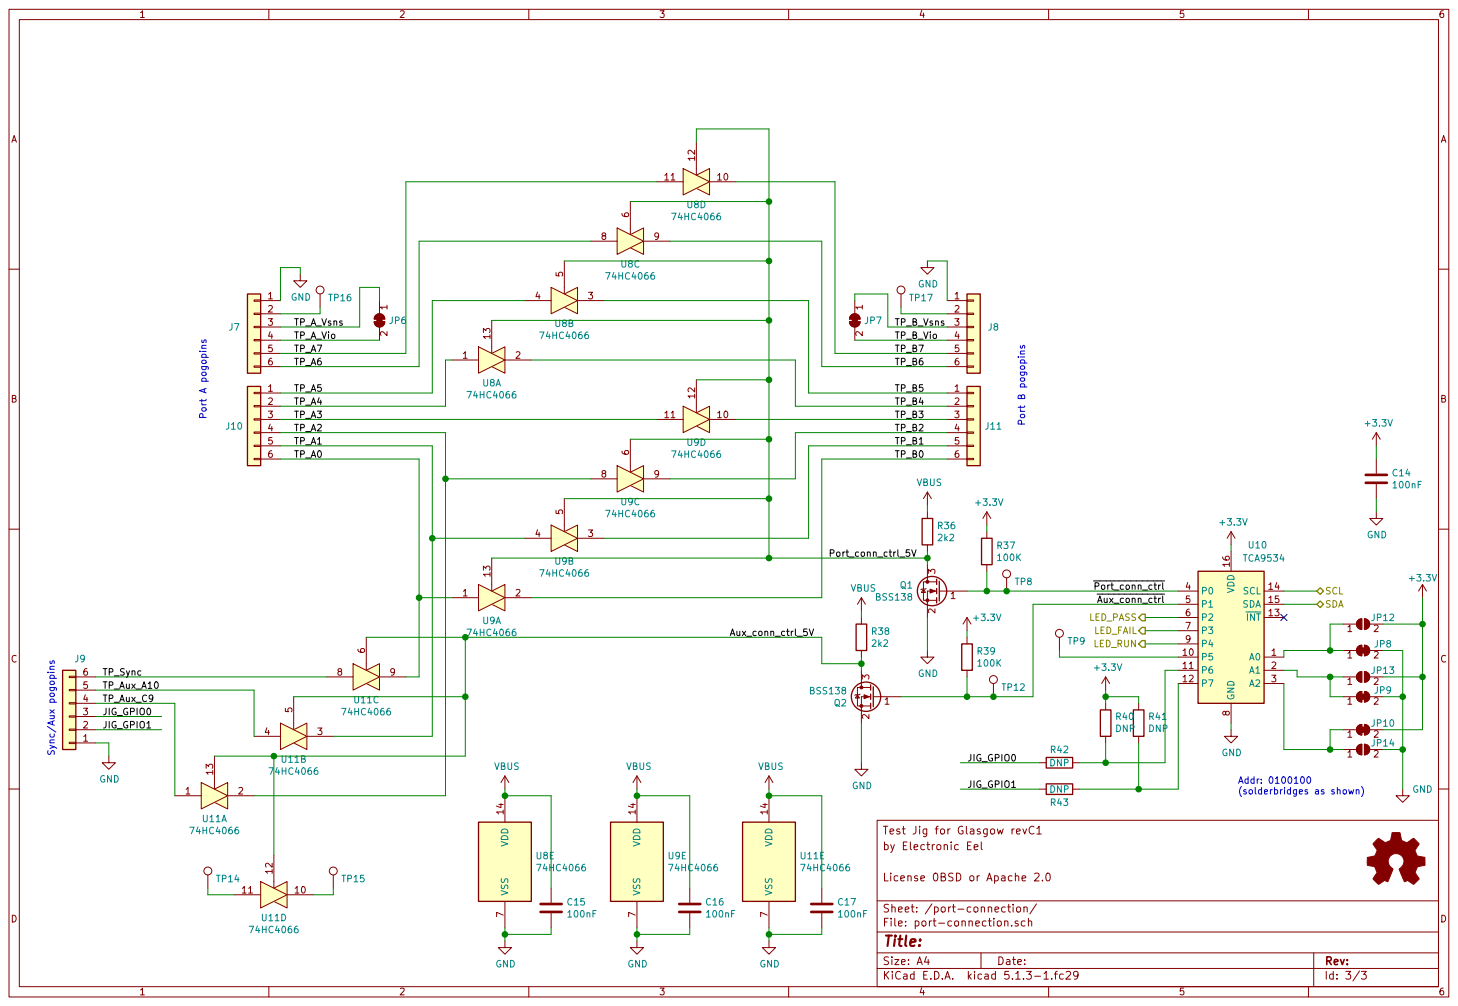
[picture p29: page 3]

(solderbridges as shown) Port B pogopins

Sheet: /port-connection/
File: port-connection.sch
Id: 3/3 Title:
