GlasgowEmbedded/glasgow/hardware/boards/glasgow/revD0/output/schematics.pdf

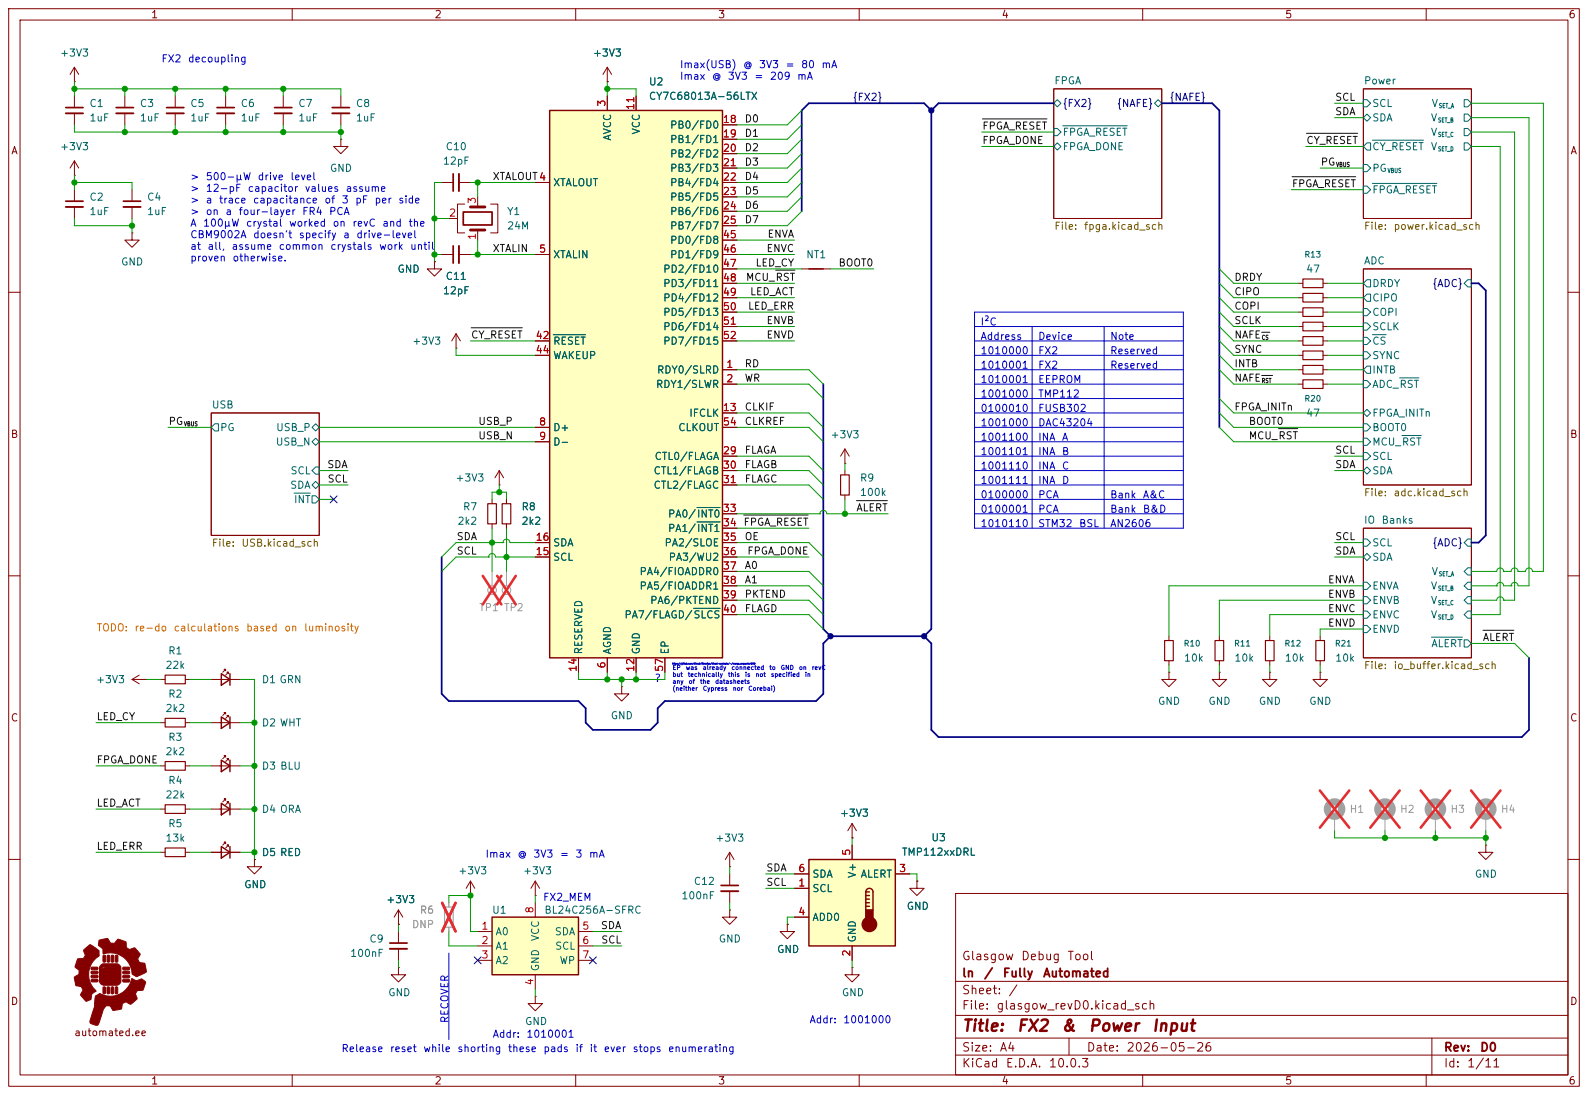
[picture p41: page 1]

V SET_A V SET_B V SET_C CY_RESET V SET_D PGVBUS FPGA_RESET Power File: power.kicad_sch PG

File: adc.kicad_sch SCL SDA

> 500-µW drive level > 12-pF capacitor values assume > a trace capacitance of 3 pF per side > on a four-layer FR4 PCA

A 100µW crystal worked on revC and the CBM9002A doesn't specify a drive-level at all, assume common crystals work until proven otherwise.

INTB NAFE RST ENVB

1001000 | TMP112
0100010 | FUSB302

0100000 | PCA | Bank A&C
0100001 | PCA | Bank B&D
1010110 | STM32 BSL | AN2606

https://gitlab.com/kicad/libraries/kicad-symbols/-/merge_requests/289 FX2_MEM

EP was already connected to GND on revC
but technically this is not specified in
any of the datasheets
(neither Cypress nor Corebai)

Release reset while shorting these pads if it ever stops enumerating RECOVER

Size: A4 | Rev: D0
KiCad E.D.A. 10.0.3 | Id: 1/11

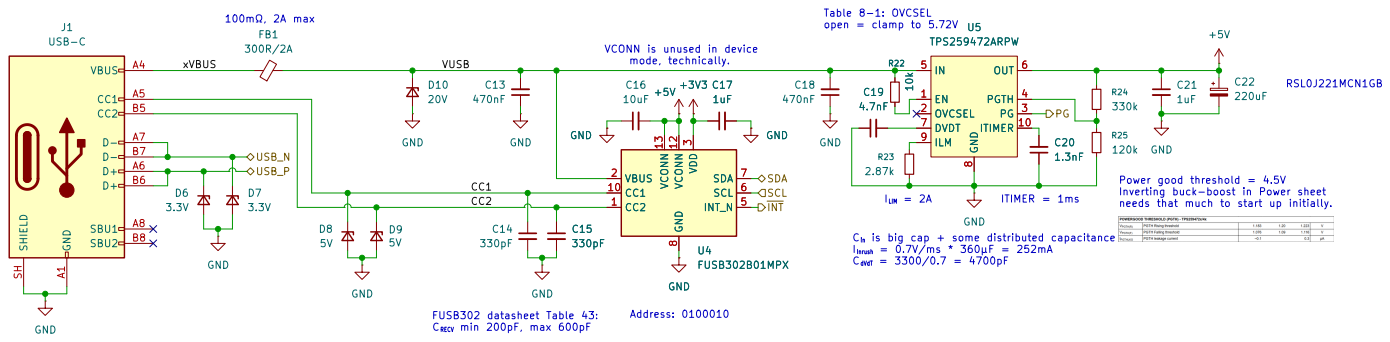
[picture p42: page 2]

8 CC1 10 VCONN 12 VCONN 13 U4 GND FUSB302B01MPX GND A1

Inverting buck-boost in Power sheet needs that much to start up initially. I LIM = 2A

FUSB302 datasheet Table 43: CRECV min 200pF, max 600pF

Glasgow Debug Tool
ln / Fully Automated
Sheet: /USB/
File: USB.kicad_sch
Title: USB input protection

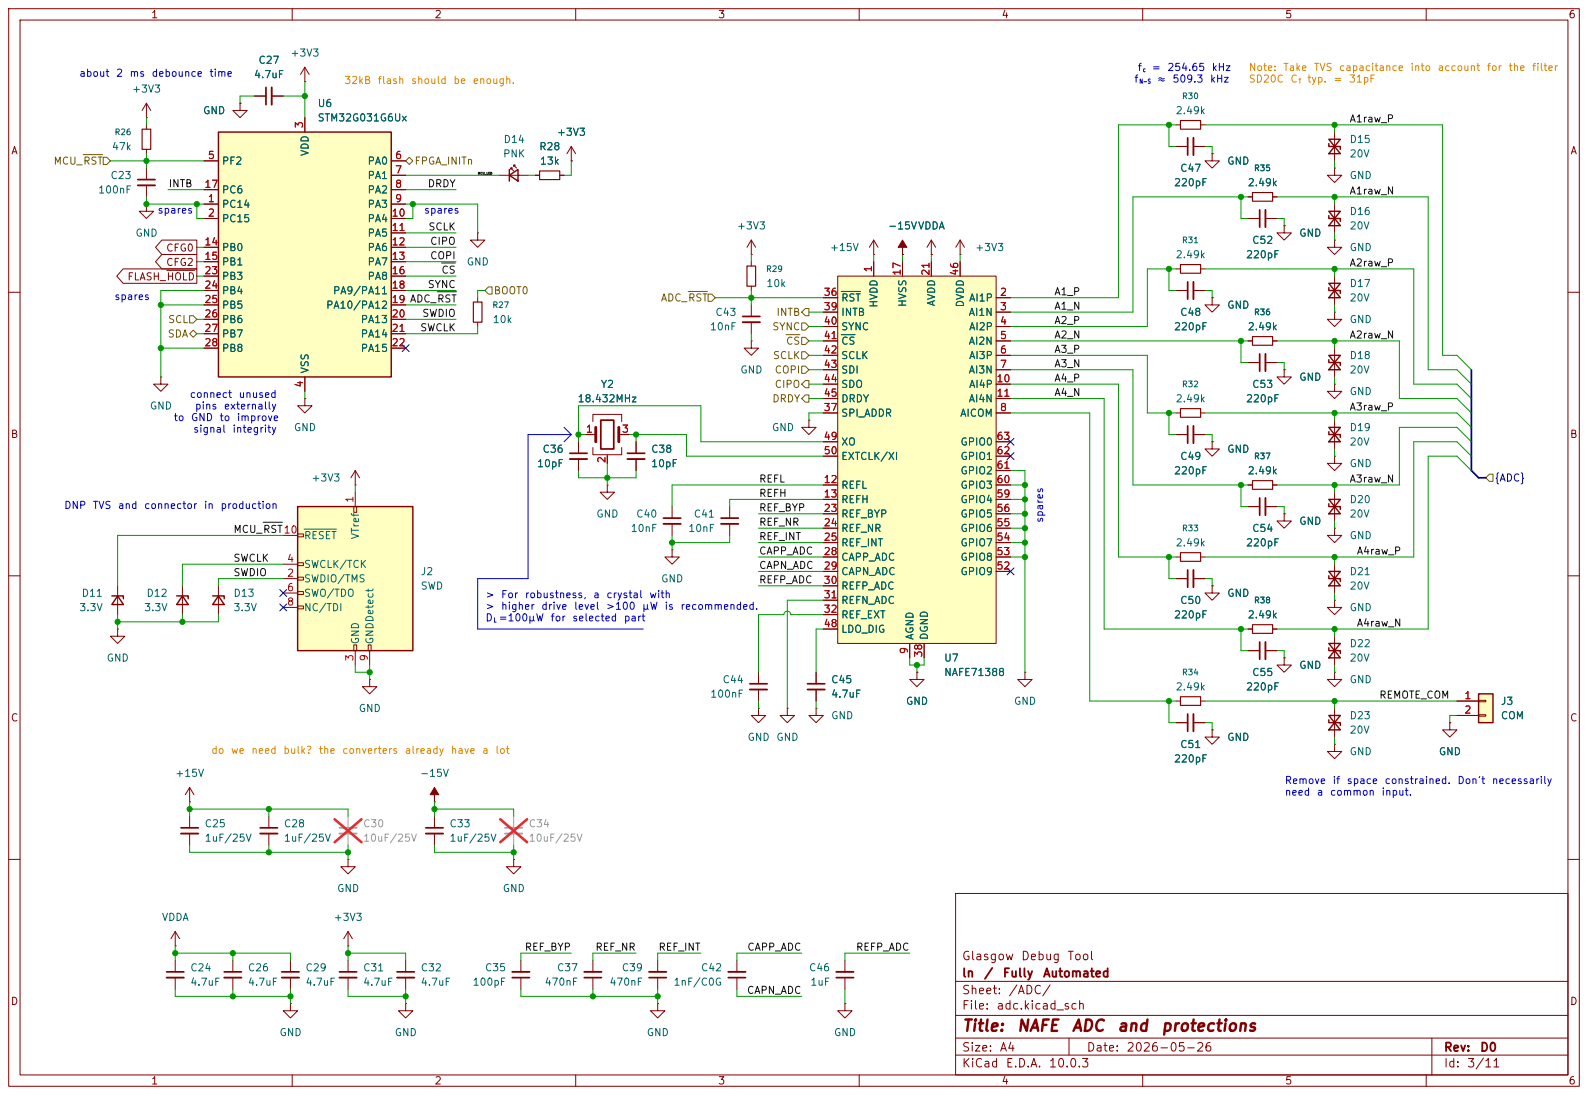
[picture p43: page 3]

spares do we need bulk? the converters already have a lot

FLASH_HOLD
to GND to improve

Glasgow Debug Tool VDDA

ln / Fully Automated
Sheet: /ADC/
File: adc.kicad_sch
Title: NAFE ADC and protections

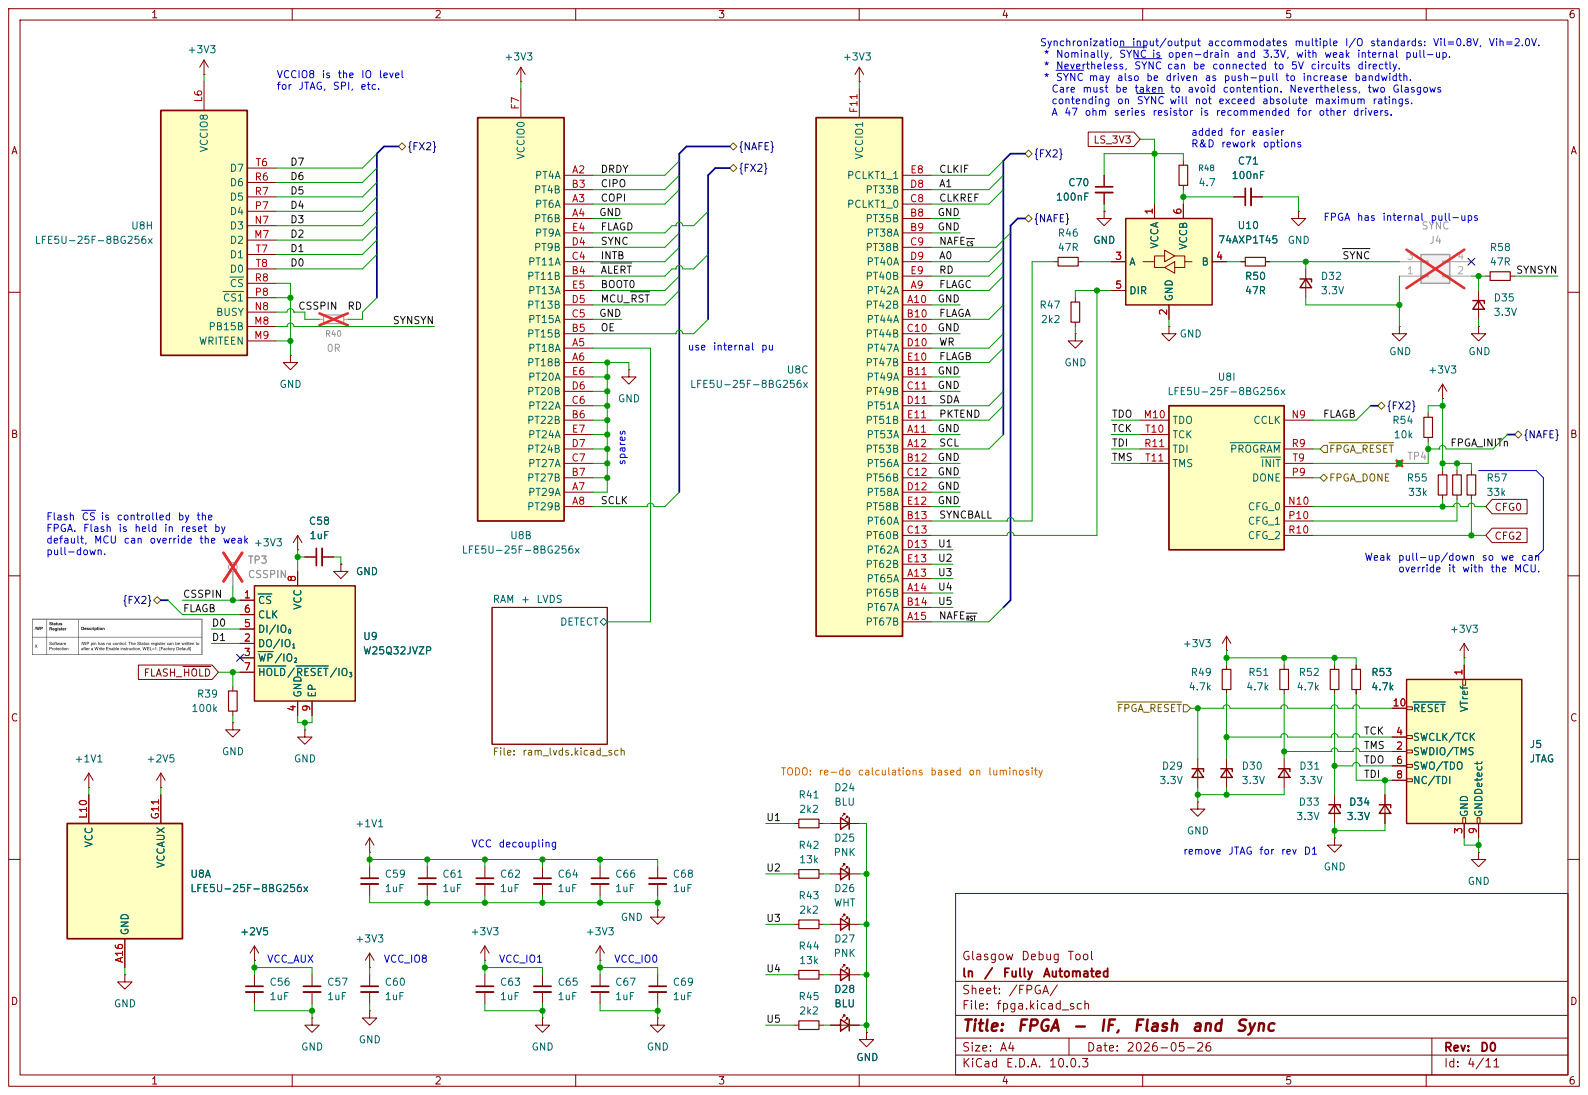
[picture p44: page 4]

Synchronization input/output accommodates multiple I/O standards: Vil=0.8V, Vih=2.0V. * Nominally, SYNC is open-drain and 3.3V, with weak internal pull-up. * Nevertheless, SYNC can be connected to 5V circuits directly. * SYNC may also be driven as push-pull to increase bandwidth. Care must be taken to avoid contention. Nevertheless, two Glasgows
GND

contending on SYNC will not exceed absolute maximum ratings. A 47 ohm series resistor is recommended for other drivers. added for easier R&D rework options U10

SCL GND NAFE CS FLAGA PKTEND

Flash CS is controlled by the
FPGA. Flash is held in reset by

override it with the MCU. TODO: re-do calculations based on luminosity

4 DI/IO0 5 CLK 6 HOLD/RESET/IO3 7 VCC

Glasgow Debug Tool DETECT RAM + LVDS

remove JTAG for rev D1

ln / Fully Automated
Sheet: /FPGA/
File: fpga.kicad_sch
Title: FPGA - IF, Flash and Sync

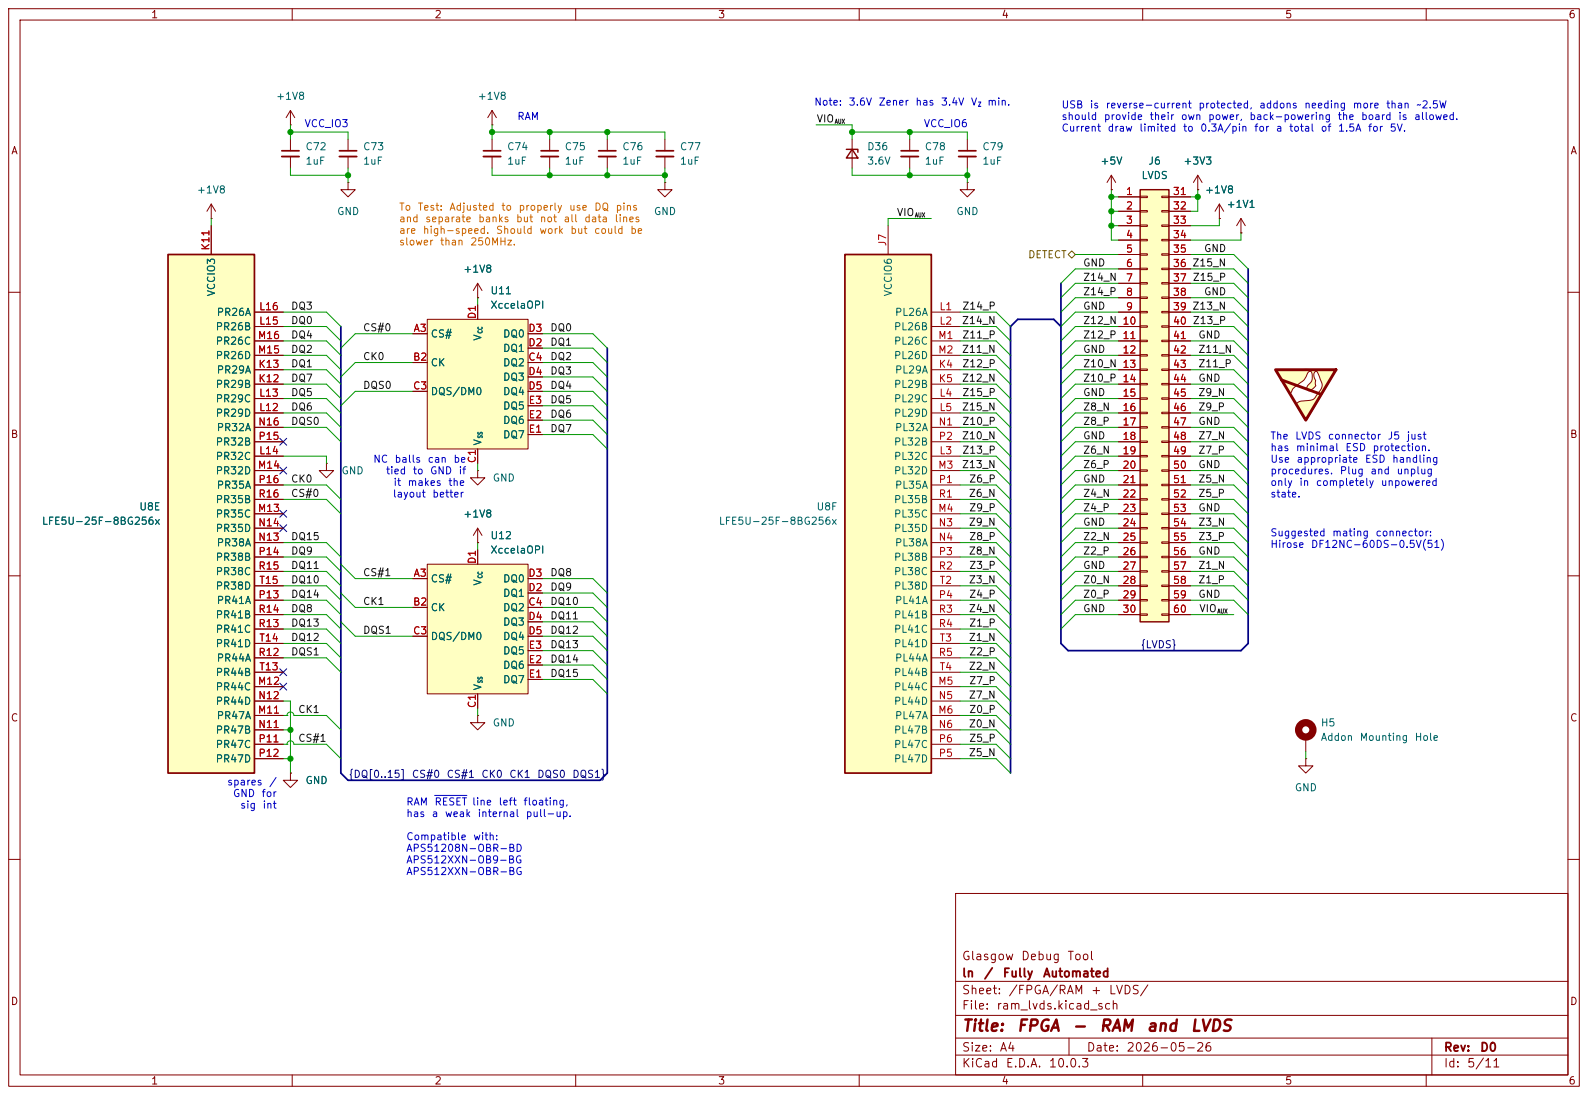
[picture p45: page 5]

Note: 3.6V Zener has 3.4V V Z min.

should provide their own power, back-powering the board is allowed. Current draw limited to 0.3A/pin for a total of 1.5A for 5V. NC balls can be

layout better To Test: Adjusted to properly use DQ pins and separate banks but not all data lines are high-speed. Should work but could be

The LVDS connector J5 just has minimal ESD protection. Use appropriate ESD handling

tied to GND if
it makes the
only in completely unpowered state. RAM RESET line left floating, has a weak internal pull-up.

procedures. Plug and unplug

spares /
GND for sig int

Compatible with: APS51208N-OBR-BD

Glasgow Debug Tool
ln / Fully Automated
Sheet: /FPGA/RAM + LVDS/
File: ram_lvds.kicad_sch
Title: FPGA - RAM and LVDS

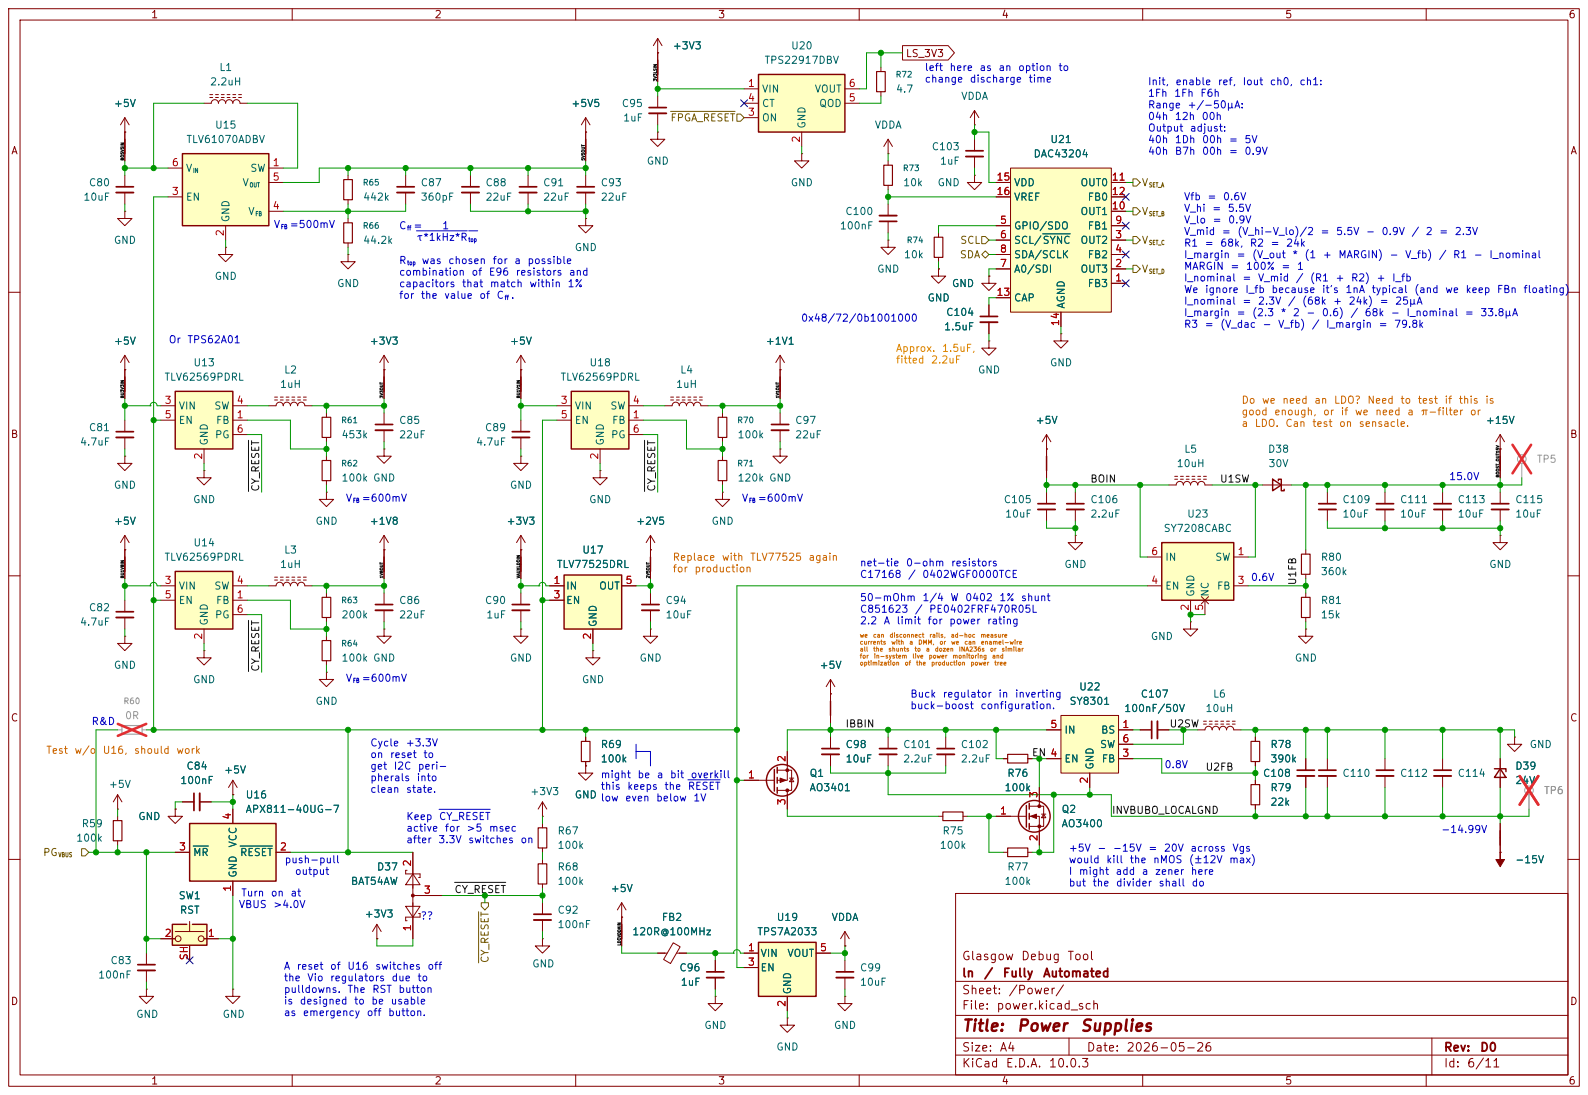
[picture p46: page 6]

left here as an option to
change discharge time

Init, enable ref, Iout ch0, ch1: 1Fh 1Fh F6h Range +/-50µA: 04h 12h 00h Output adjust: 40h 1Dh 00h = 5V 40h B7h 00h = 0.9V

for the value of Cff . push-pull

τ*1kHz*Rtop Rtop was chosen for a possible

combination of E96 resistors and
capacitors that match within 1%

I_nominal = V_mid / (R1 + R2) + I_fb We ignore I_fb because it's 1nA typical (and we keep FBn floating)

I_margin = (2.3 * 2 - 0.6) / 68k - I_nominal = 33.8µA R3 = (V_dac - V_fb) / I_margin = 79.8k Cycle +3.3V on reset to get I2C peri-

Approx. 1.5uF, fitted 2.2uF net-tie 0-ohm resistors C17168 / 0402WGF0000TCE 50-mOhm 1/4 W 0402 1% shunt C851623 / PE0402FRF470R05L 2.2 A limit for power rating

V FB =600mV might be a bit overkill this keeps the RESET
GND

we can disconnect rails, ad-hoc measure
currents with a DMM, or we can enamel-wire all the shunts to a dozen INA236s or similar

optimization of the production power tree Q1

for in-system live power monitoring and

is designed to be usable as emergency off button. R&D

pherals into clean state.

A reset of U16 switches off
the Vio regulators due to pulldowns. The RST button

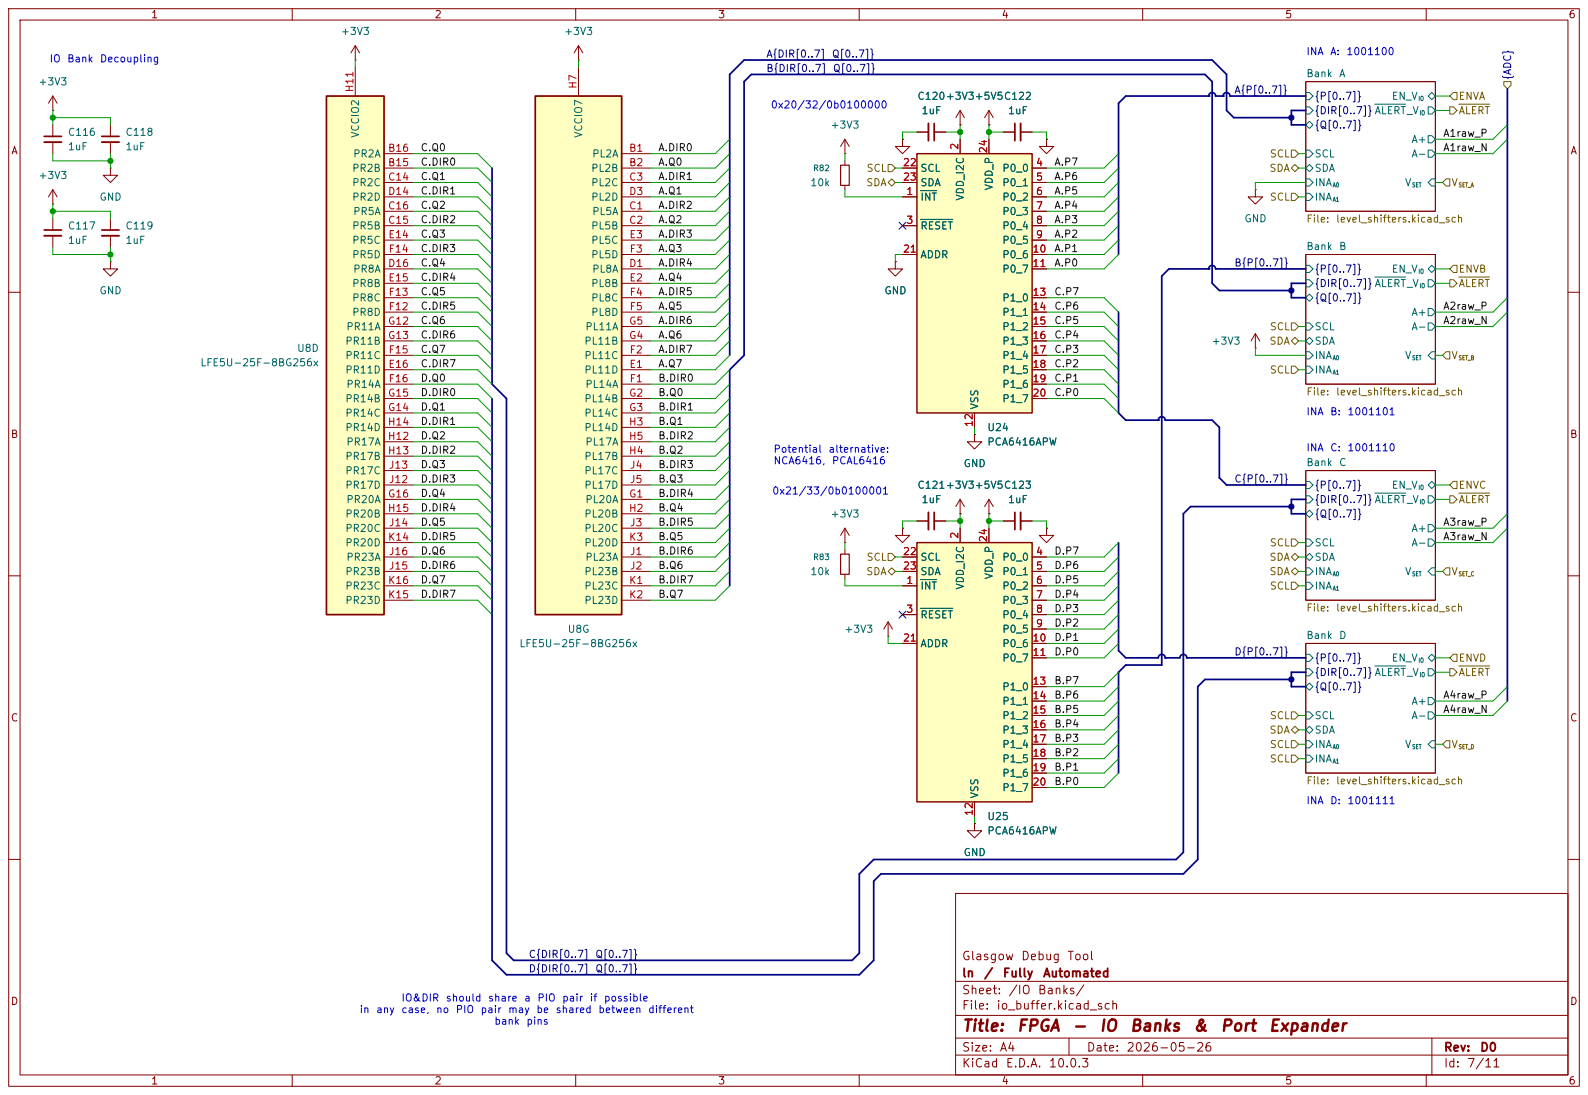
[picture p47: page 7]

ALERT _V IO V SET Bank A

ALERT _V IO V SET Bank B

INA C: 1001110
ALERT _V IO V SET Bank C

ALERT _V IO V SET Bank D

Glasgow Debug Tool
ln / Fully Automated
Sheet: /IO Banks/
File: io_buffer.kicad_sch
Title: FPGA - IO Banks & Port Expander

IO&DIR should share a PIO pair if possible

in any case, no PIO pair may be shared between different bank pins

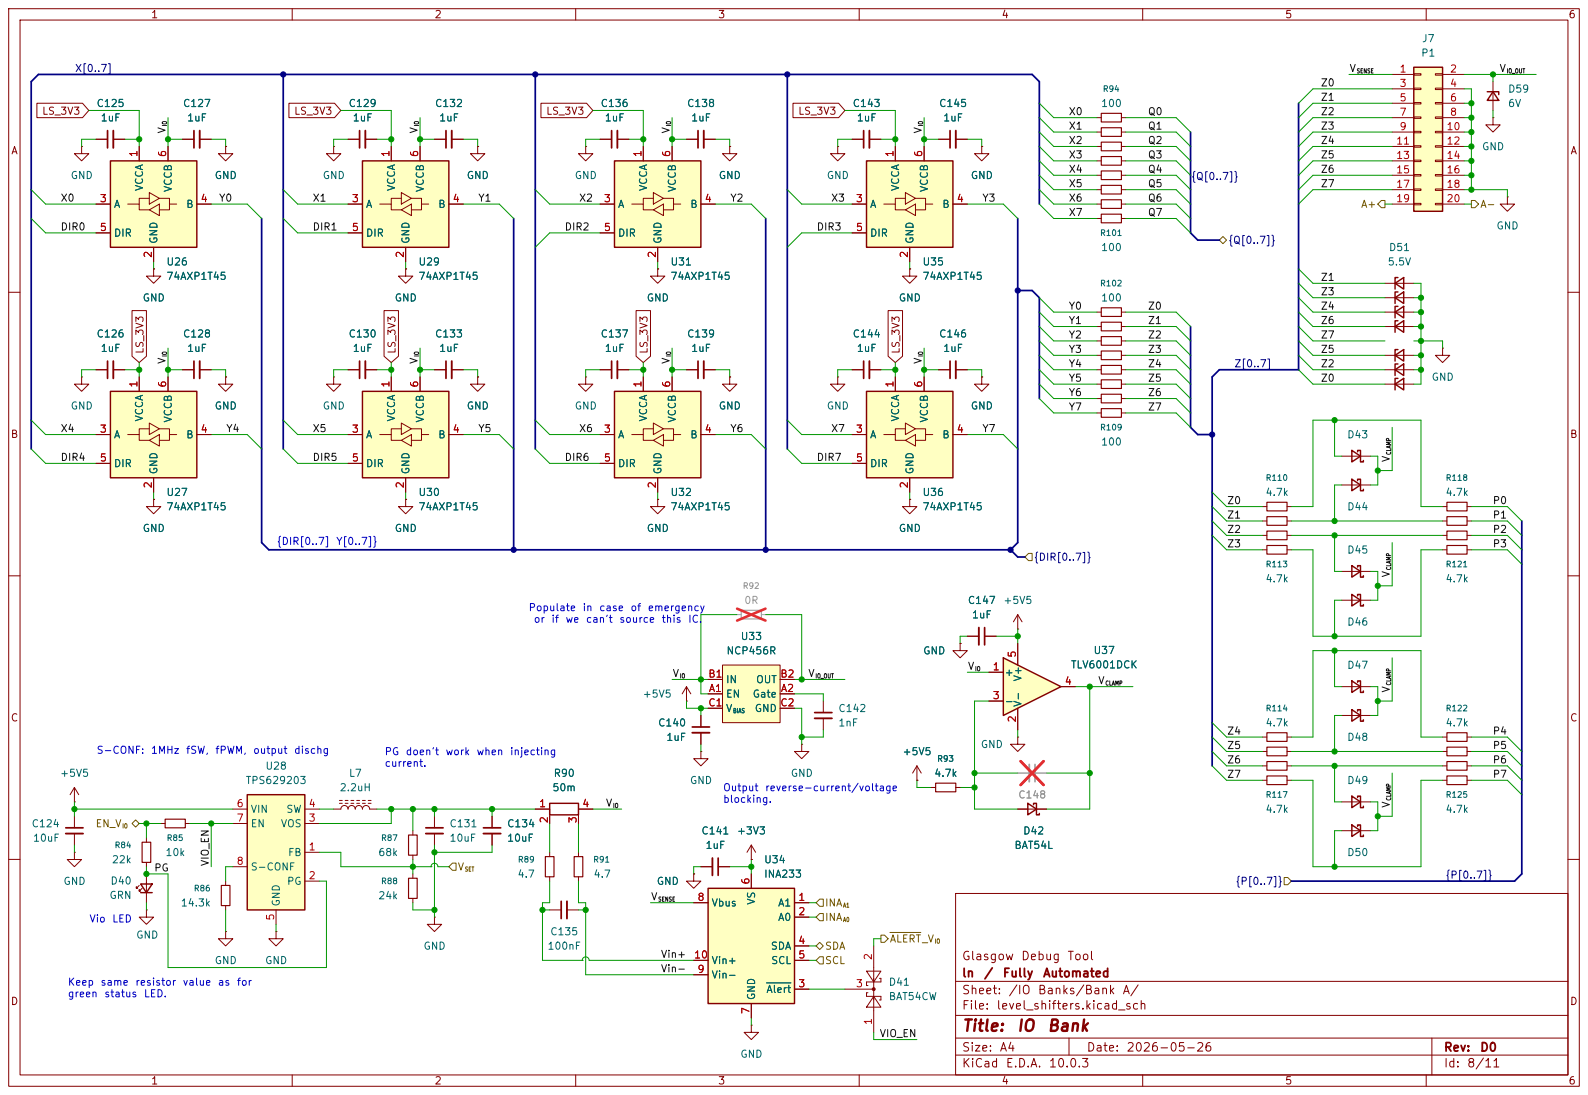
[picture p48: page 8]

{DIR[0..7] Y[0..7]} PG doen't work when injecting

Populate in case of emergency or if we can't source this IC. Keep same resistor value as for green status LED. Vio LED

S-CONF: 1MHz fSW, fPWM, output dischg

Output reverse-current/voltage
blocking.
INA233 GND

Glasgow Debug Tool
ln / Fully Automated
Sheet: /IO Banks/Bank A/
File: level_shifters.kicad_sch
Title: IO Bank

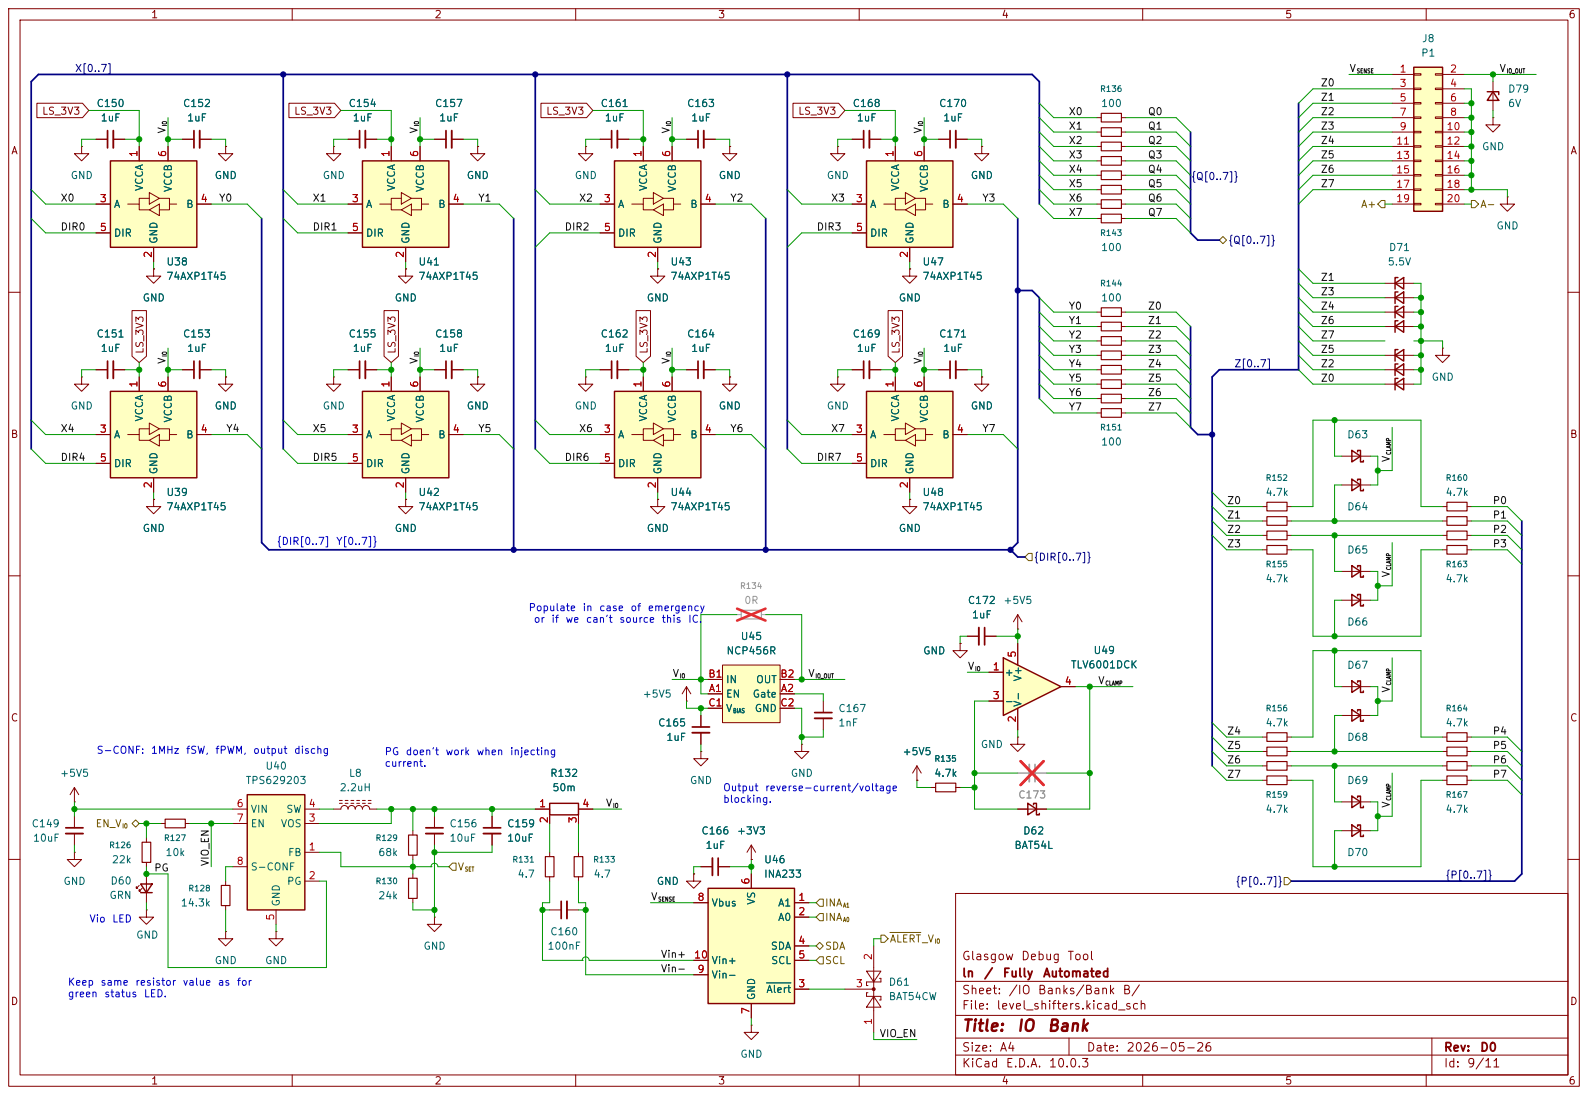
[picture p49: page 9]

{DIR[0..7] Y[0..7]} PG doen't work when injecting

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

S-CONF: 1MHz fSW, fPWM, output dischg

Output reverse-current/voltage
blocking.
INA233 GND

Glasgow Debug Tool
ln / Fully Automated
Sheet: /IO Banks/Bank B/
File: level_shifters.kicad_sch
Title: IO Bank

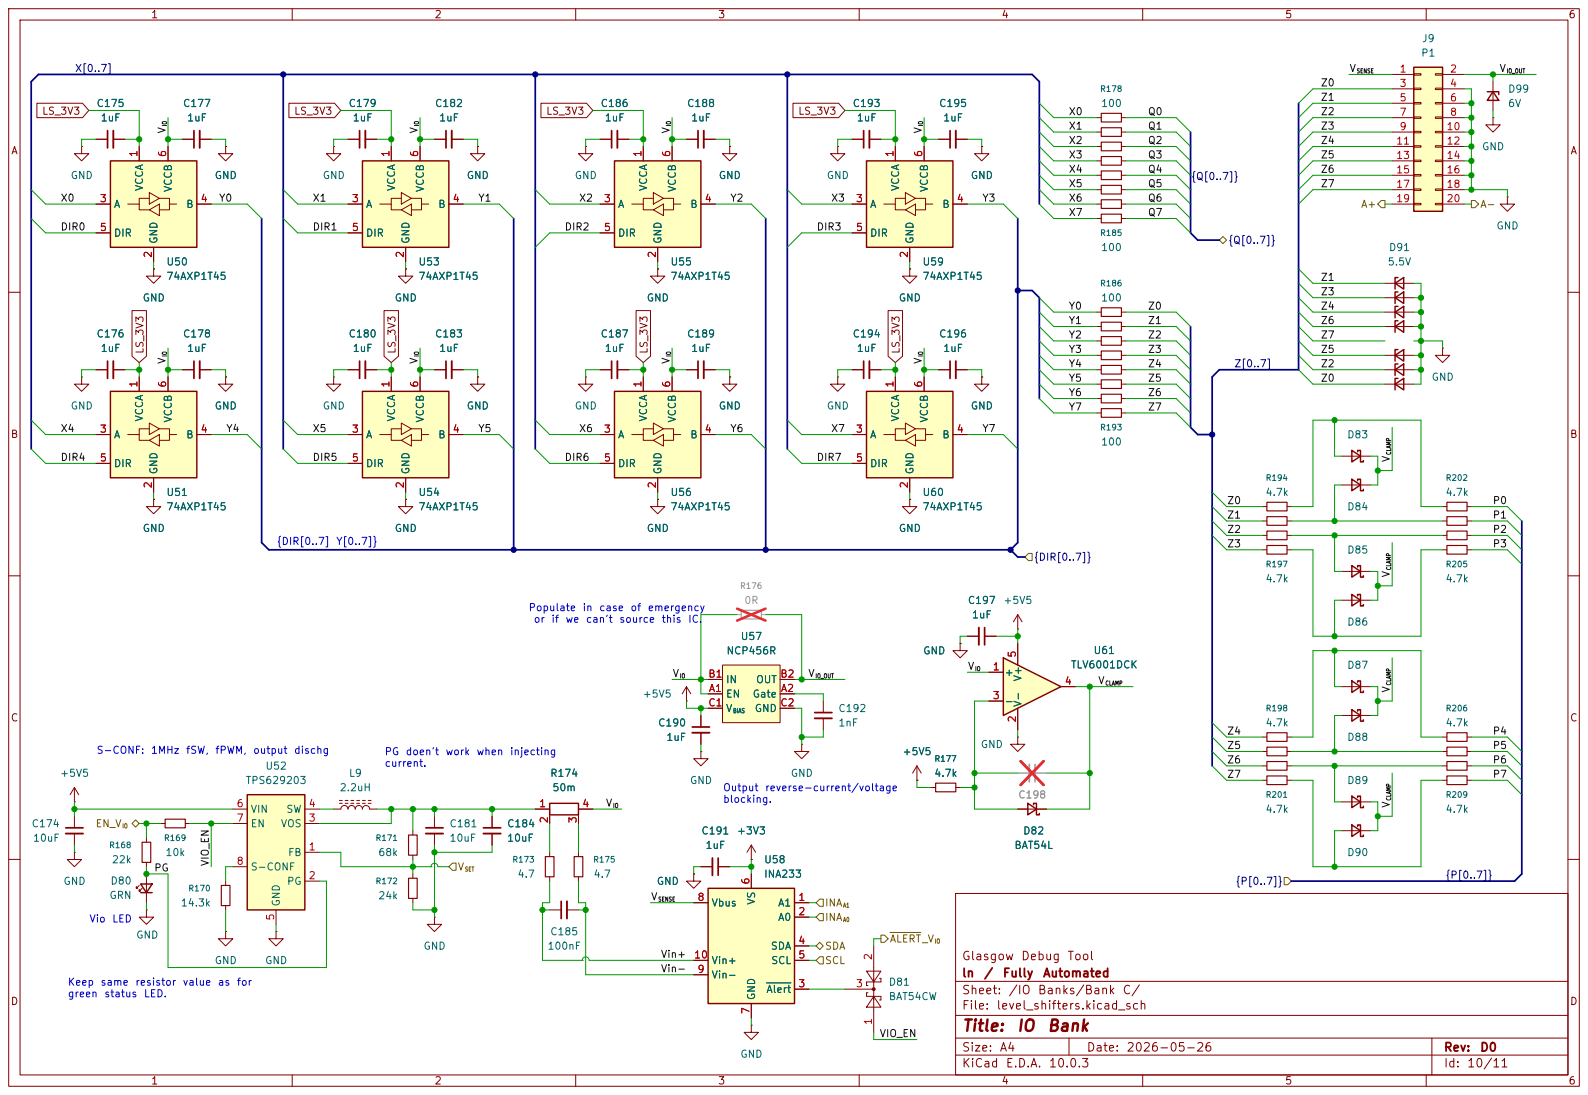
[picture p50: page 10]

{DIR[0..7] Y[0..7]} PG doen't work when injecting

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

S-CONF: 1MHz fSW, fPWM, output dischg

Output reverse-current/voltage
blocking.
INA233 GND

Glasgow Debug Tool
ln / Fully Automated
Sheet: /IO Banks/Bank C/
File: level_shifters.kicad_sch
Title: IO Bank

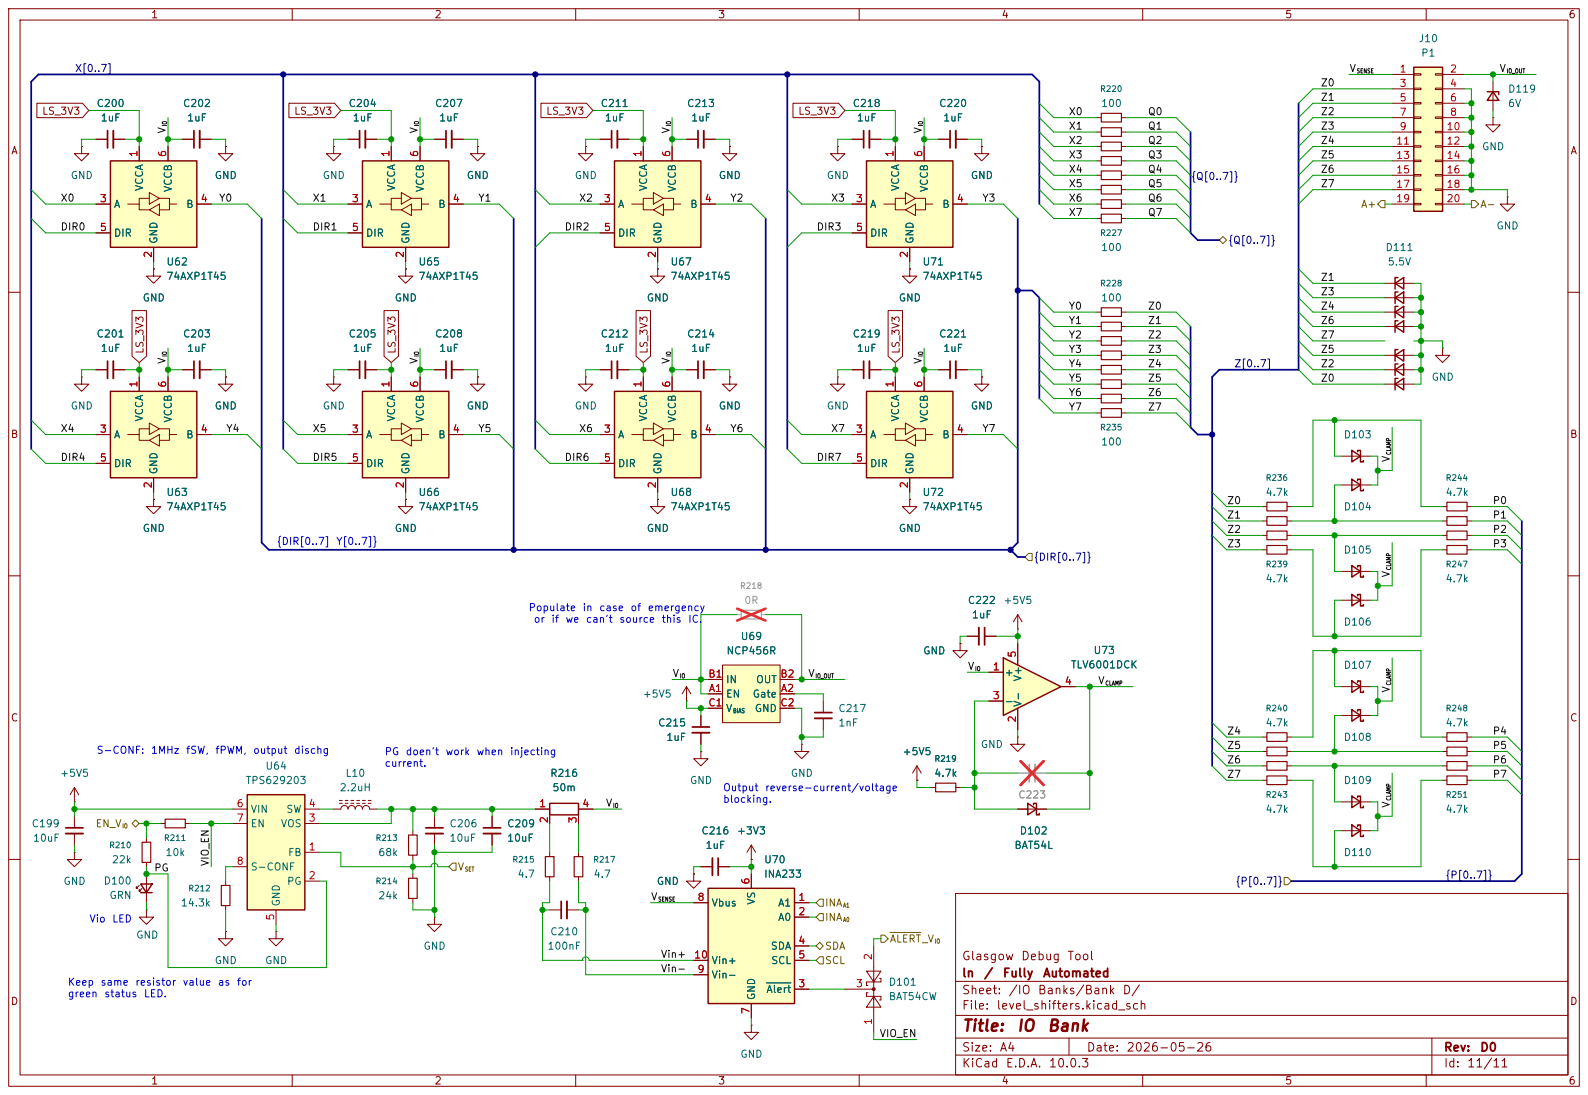
[picture p51: page 11]

{DIR[0..7] Y[0..7]} PG doen't work when injecting

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

S-CONF: 1MHz fSW, fPWM, output dischg

Output reverse-current/voltage
blocking.
INA233 GND

Glasgow Debug Tool
ln / Fully Automated
Sheet: /IO Banks/Bank D/
File: level_shifters.kicad_sch
Title: IO Bank
