GlasgowEmbedded/glasgow/hardware/boards/glasgow/revC3/output/schematics.pdf

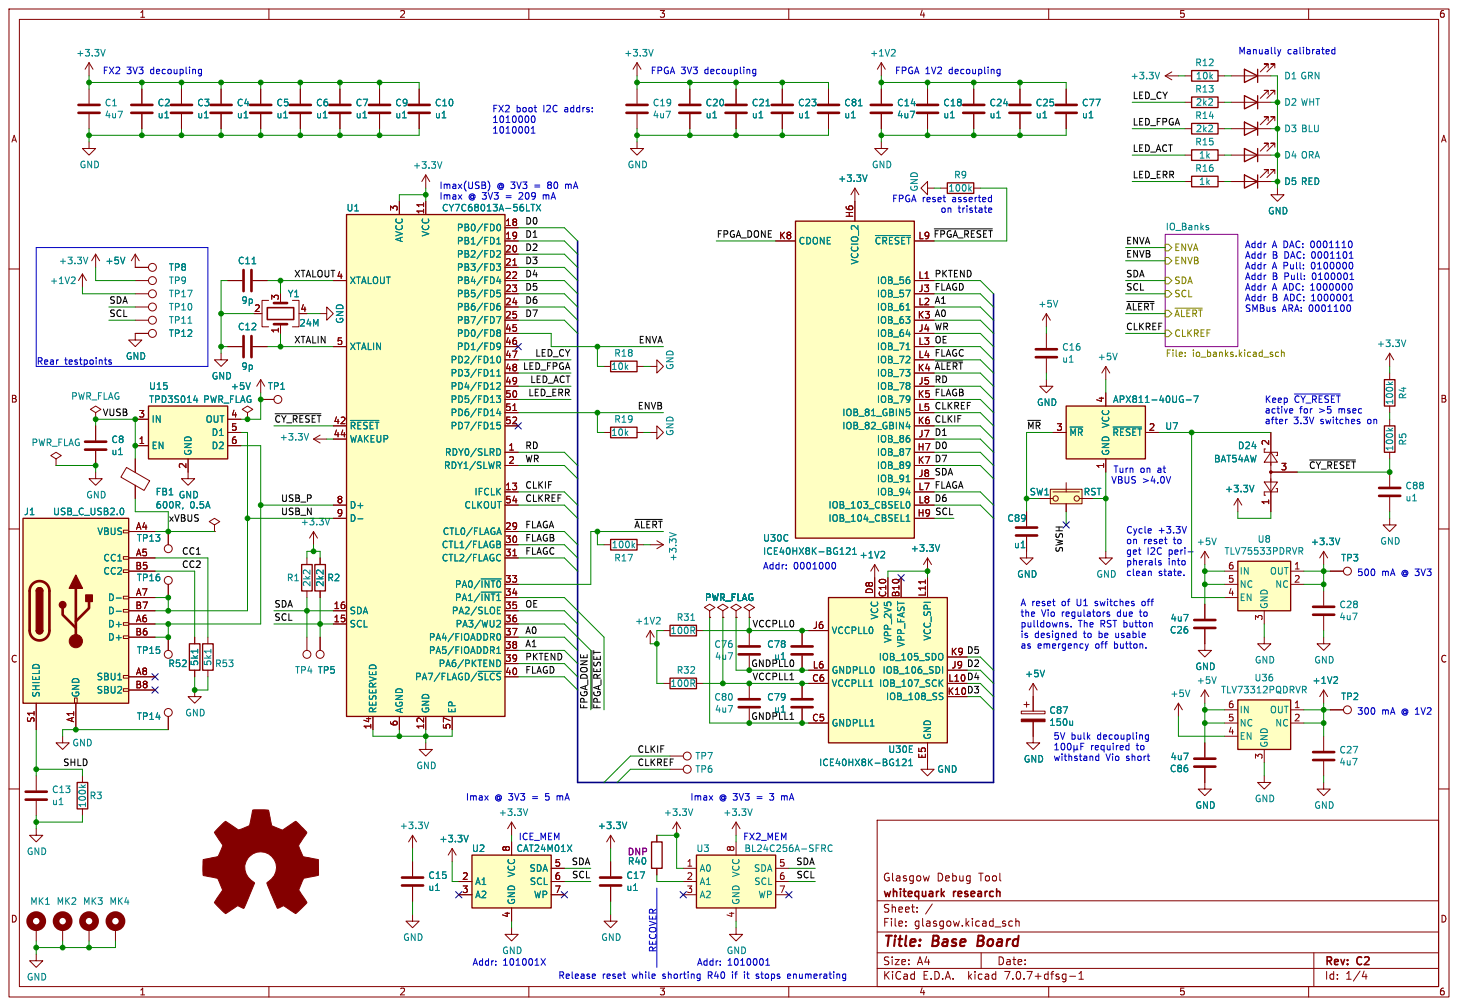
[picture p52: page 1]

Addr A DAC: 0001110 Addr B DAC: 0001101 Addr A Pull: 0100000 Addr B Pull: 0100001 Addr A ADC: 1000000 Addr B ADC: 1000001 SMBus ARA: 0001100 Manually calibrated Keep ~{CY_RESET} active for >5 msec after 3.3V switches on
D2 WHT GND

3 CTL1/FLAGB 30 CTL2/FLAGC 31 PA0/~{INT0}33 PA1/~{INT1}34 PA2/SLOE 35 PA3/WU2 36 PA4/FIOADDR0 37 PA5/FIOADDR1 38 PA6/PKTEND 39 XTALOUT 4 PA7/FLAGD/~{SLCS} 40 ~{RESET} 42 WAKEUP 44 PD0/FD8 45 PD1/FD9 46 PD2/FD10 47 PD3/FD11 48 PD4/FD12 49 XTALIN 5 PD5/FD13 50 PD6/FD14 51 PD7/FD15 52 CLKOUT 54 EP 57 AGND

A reset of U1 switches off
is designed to be usable

4 SDA 5 SCL 6 WP 7 VCC

Id: 1/4 Title: Base Board

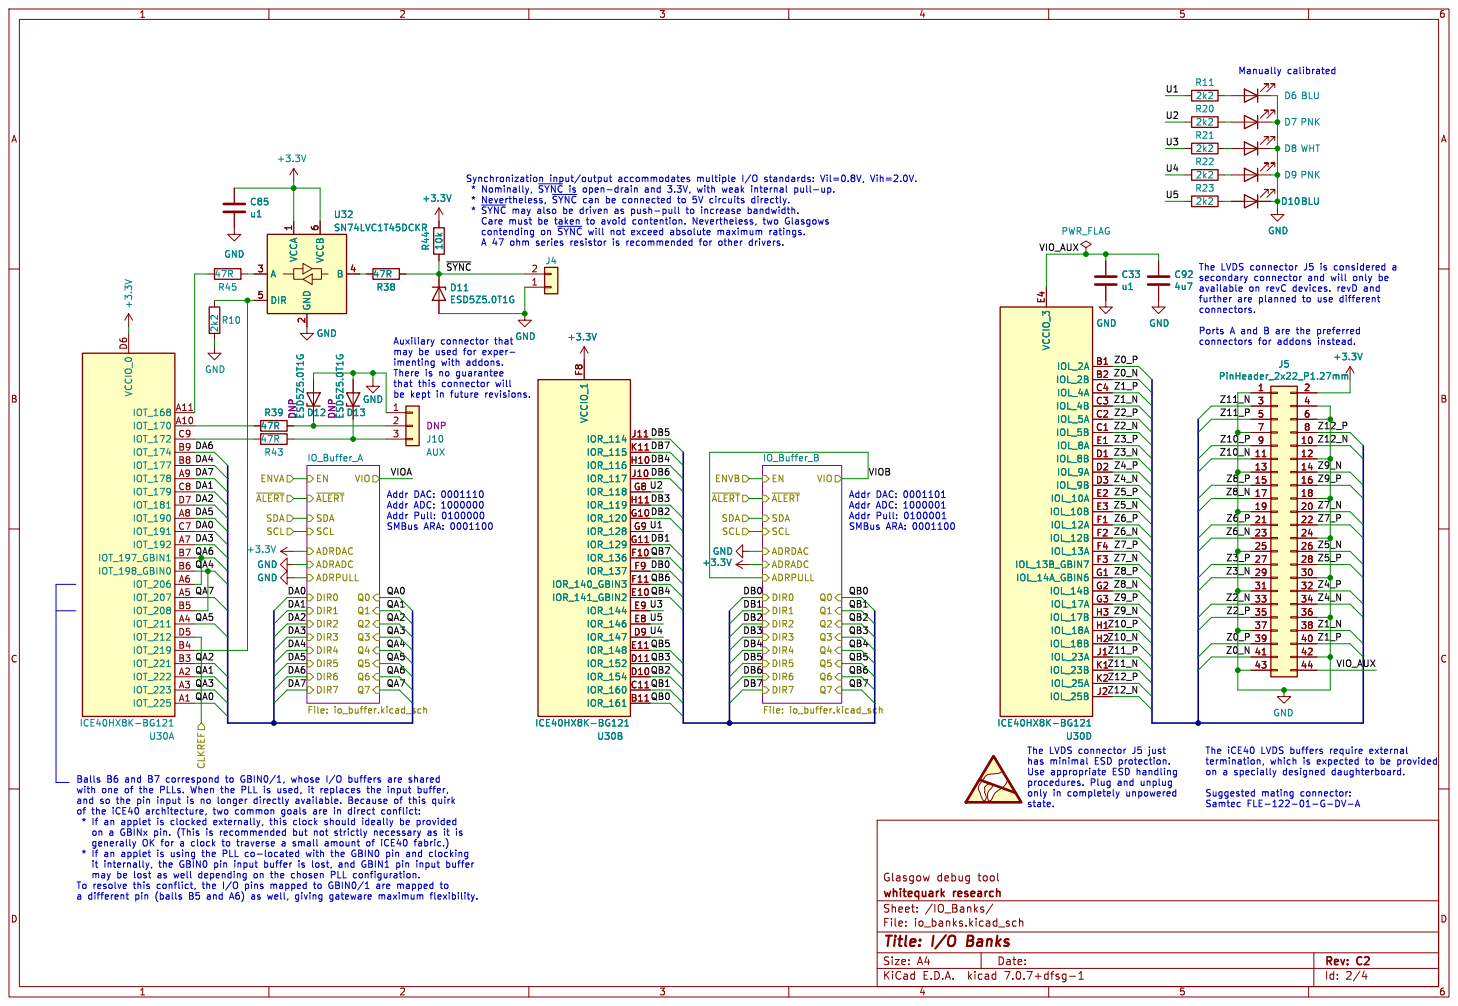
[picture p53: page 2]

4u7 GND DNP ESD5Z5.0T1G D12 DNP ESD5Z5.0T1G D13 U32 SN74LVC1T45DCKR VCCA

further are planned to use different connectors. Ports A and B are the preferred

Suggested mating connector: Samtec FLE-122-01-G-DV-A

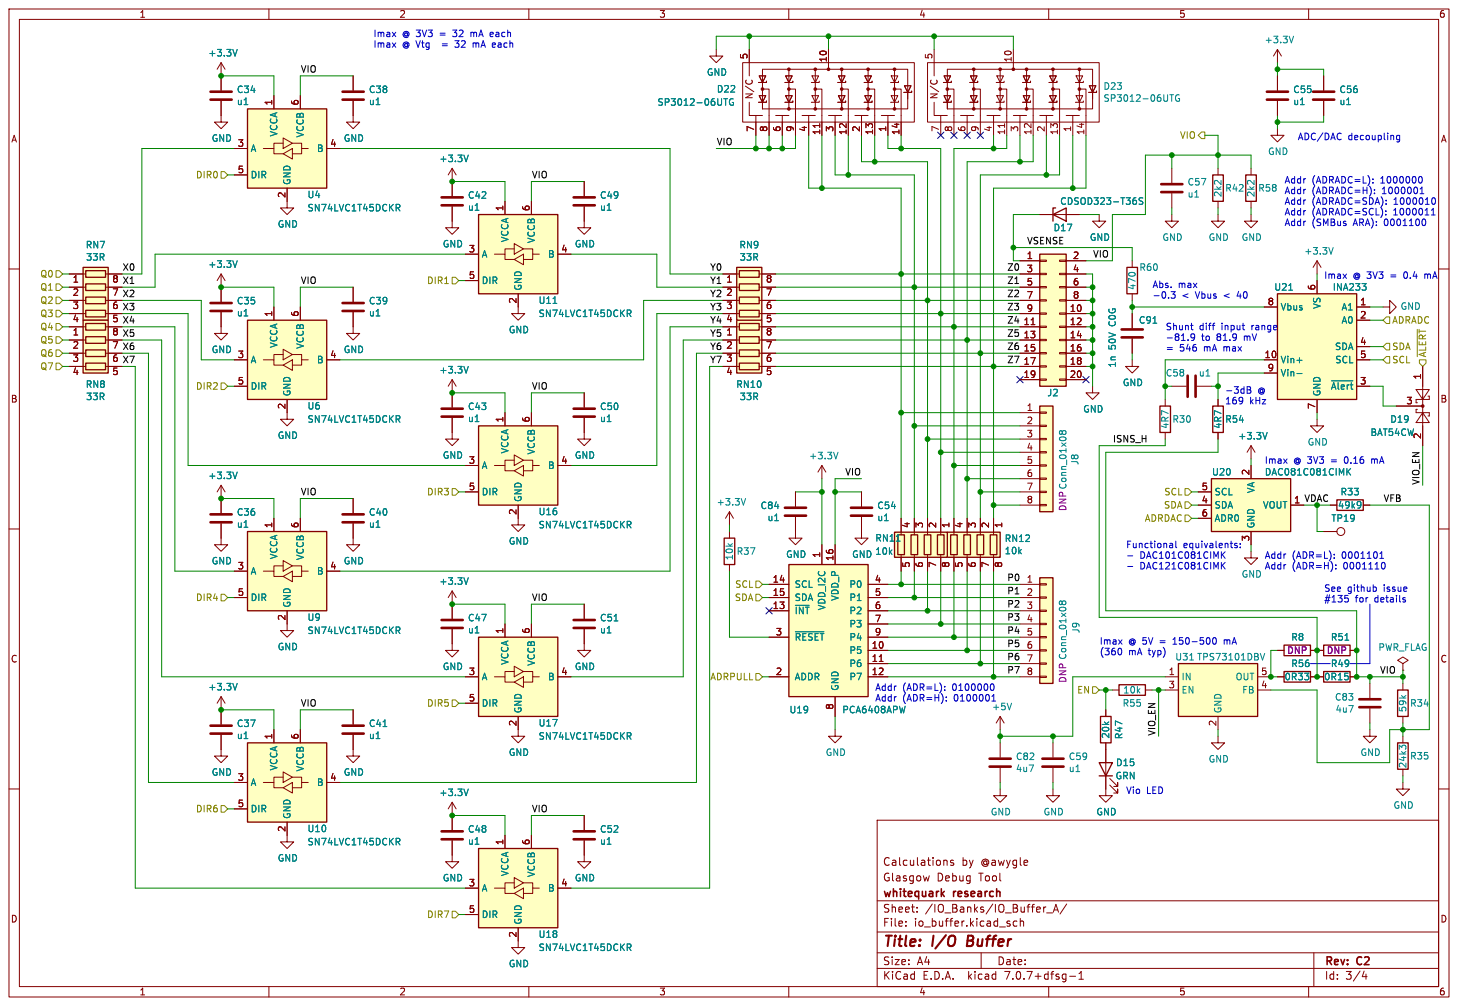
[picture p54: page 3]

Addr (ADRADC=L): 1000000 Addr (ADRADC=H): 1000001 Addr (ADRADC=SDA): 1000010 Addr (ADRADC=SCL): 1000011 Addr (SMBus ARA): 0001100 ADC/DAC decoupling

Addr (ADR=L): 0001101 Addr (ADR=H): 0001110 Abs. max

#135 for details Shunt diff input range
= 546 mA max

1 P5 10 P6 11 P7 12 ~{INT} 13 SCL 14 SDA 15 VDD_P 16 ADDR 2 ~{RESET} 3 P0 4 P1 5 P2 6 P3 7 GND

6 U10 SN74LVC1T45DCKR GND GND GND GND

Addr (ADR=L): 0100000 Addr (ADR=H): 0100001

Id: 3/4 Title: I/O Buffer File: io_buffer.kicad_sch Sheet: /IO_Banks/IO_Buffer_A/

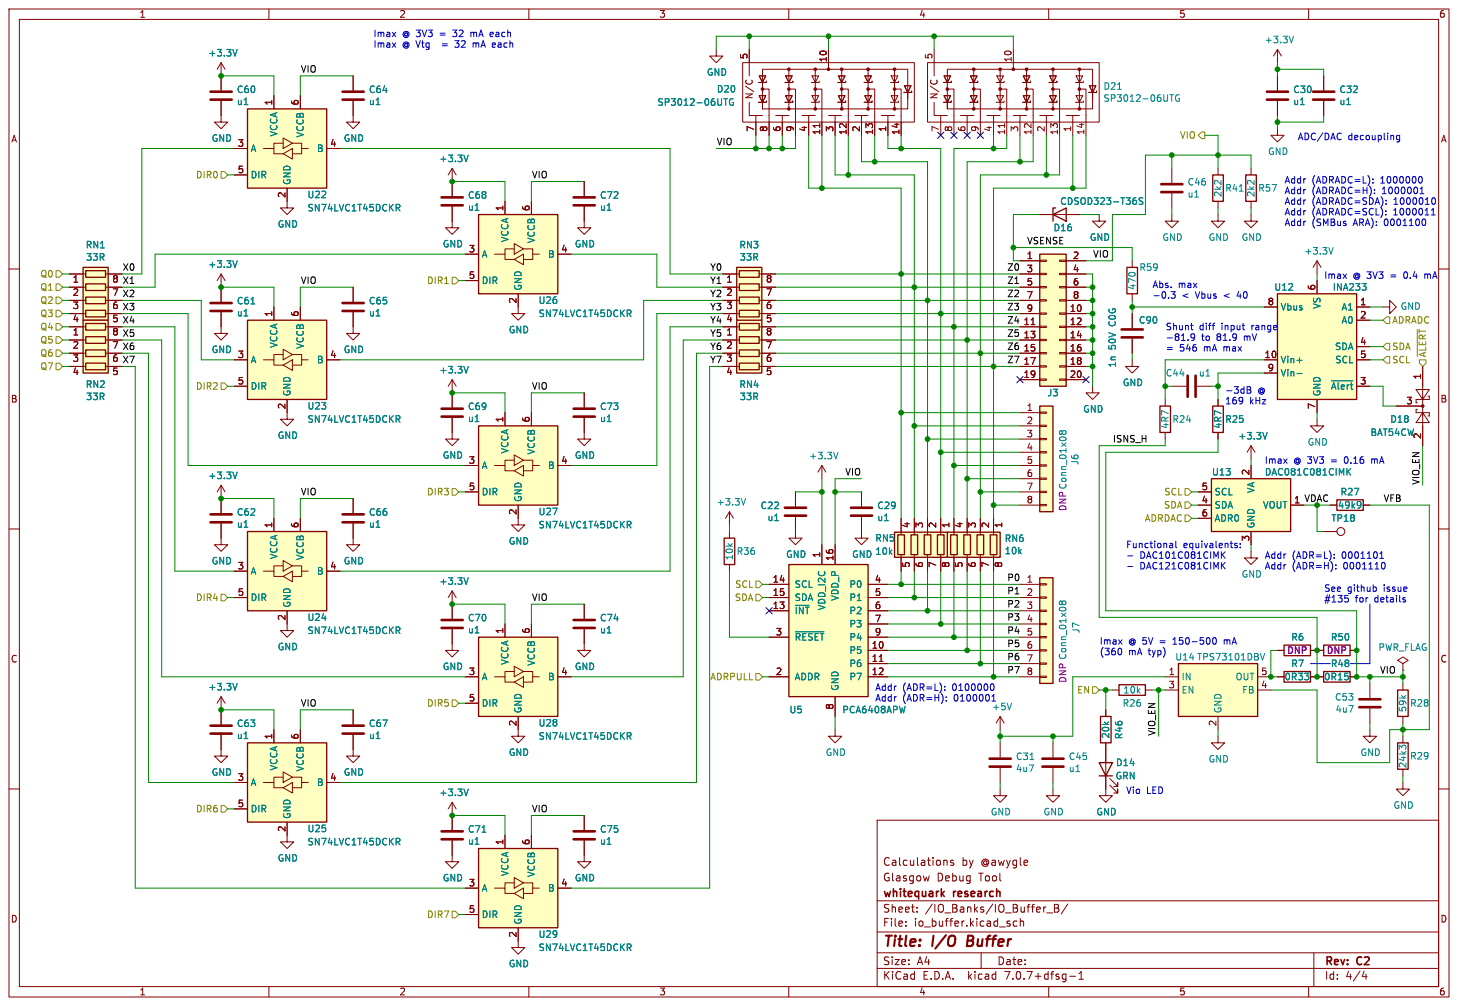
[picture p55: page 4]

Addr (ADR=L): 0001101 Addr (ADR=H): 0001110 Abs. max

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

Id: 4/4 Title: I/O Buffer File: io_buffer.kicad_sch Sheet: /IO_Banks/IO_Buffer_B/
