GlasgowEmbedded/glasgow/hardware/boards/glasgow/revC2/output/schematics.pdf

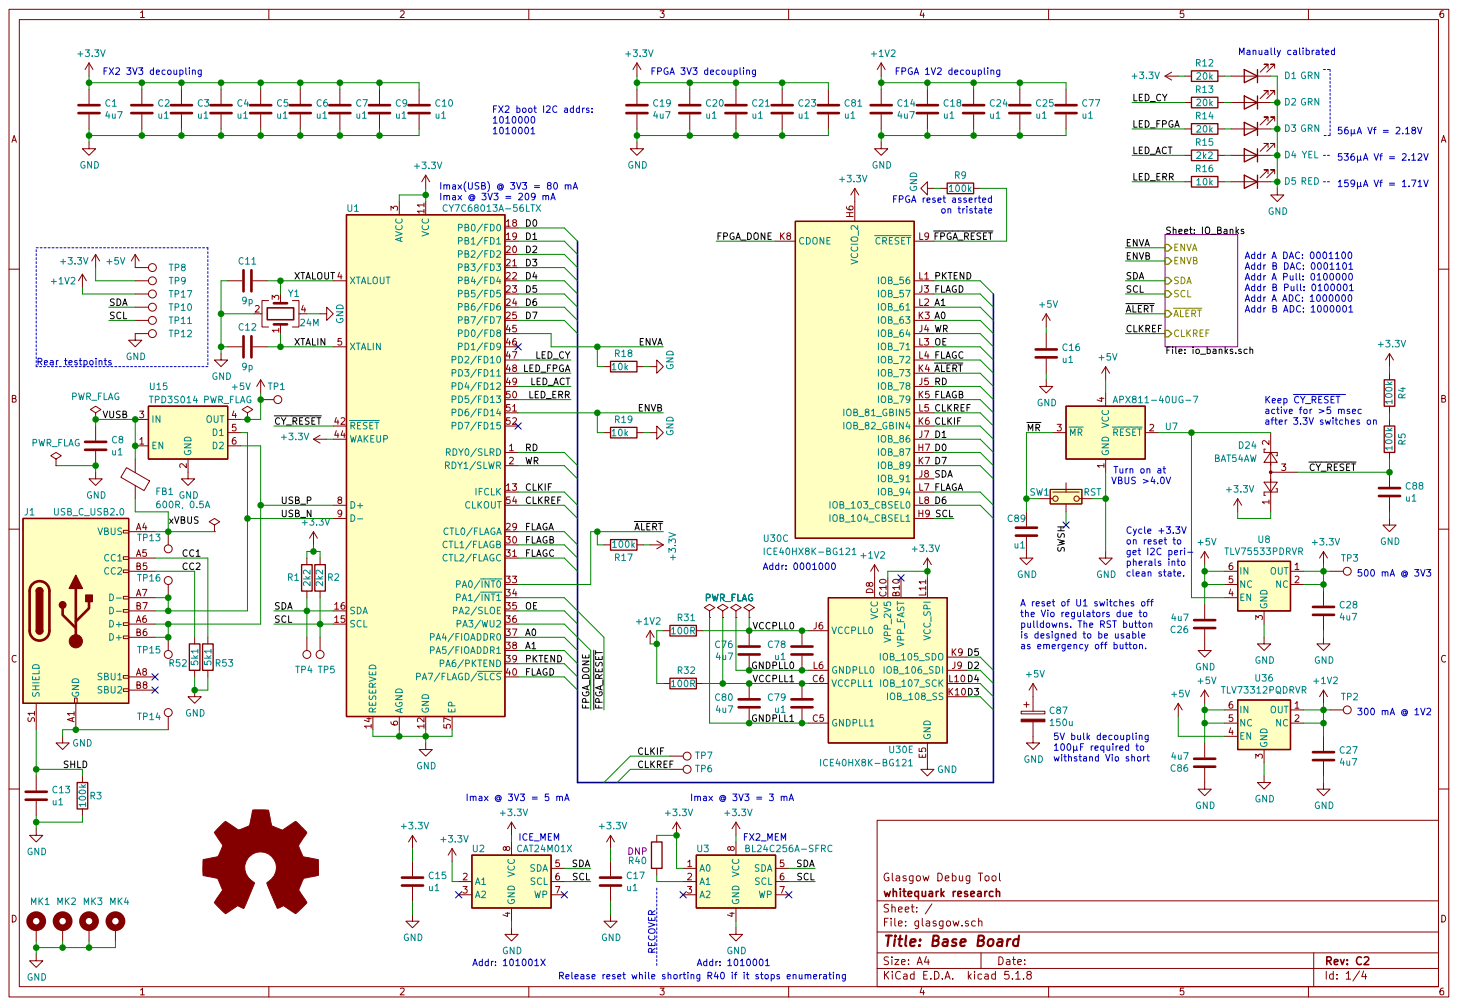
[picture p56: page 1]

pherals into clean state. FPGA reset asserted

3 CTL1/FLAGB 30 CTL2/FLAGC 31 PA0/INT0 33 PA1/INT1 34 PA2/SLOE 35 PA3/WU2 36 PA4/FIOADDR0 37 PA5/FIOADDR1 38 PA6/PKTEND 39 XTALOUT 4 PA7/FLAGD/SLCS 40 RESET 42 WAKEUP 44 PD0/FD8 45 PD1/FD9 46 PD2/FD10 47 PD3/FD11 48 PD4/FD12 49 XTALIN 5 PD5/FD13 50 PD6/FD14 51 PD7/FD15 52 CLKOUT 54 EP 57 AGND

Sheet: IO_Banks File: io_banks.sch ENVA

Addr A DAC: 0001100 Addr B DAC: 0001101 Addr A Pull: 0100000 Addr B Pull: 0100001 Addr A ADC: 1000000 Addr B ADC: 1000001

SCL ALERT CLKREF GND

Keep CY_RESET active for >5 msec after 3.3V switches on

Cycle +3.3V
on reset to get I2C peri-

A reset of U1 switches off
the Vio regulators due to
pulldowns. The RST button
is designed to be usable
as emergency off button.

150u GND
5V bulk decoupling
100µF required to withstand Vio short

4 SDA 5 SCL 6 WP 7 VCC

Glasgow Debug Tool
File: glasgow.sch Sheet: / whitequark research

Id: 1/4 Title: Base Board

Release reset while shorting R40 if it stops enumerating Addr: 101001X

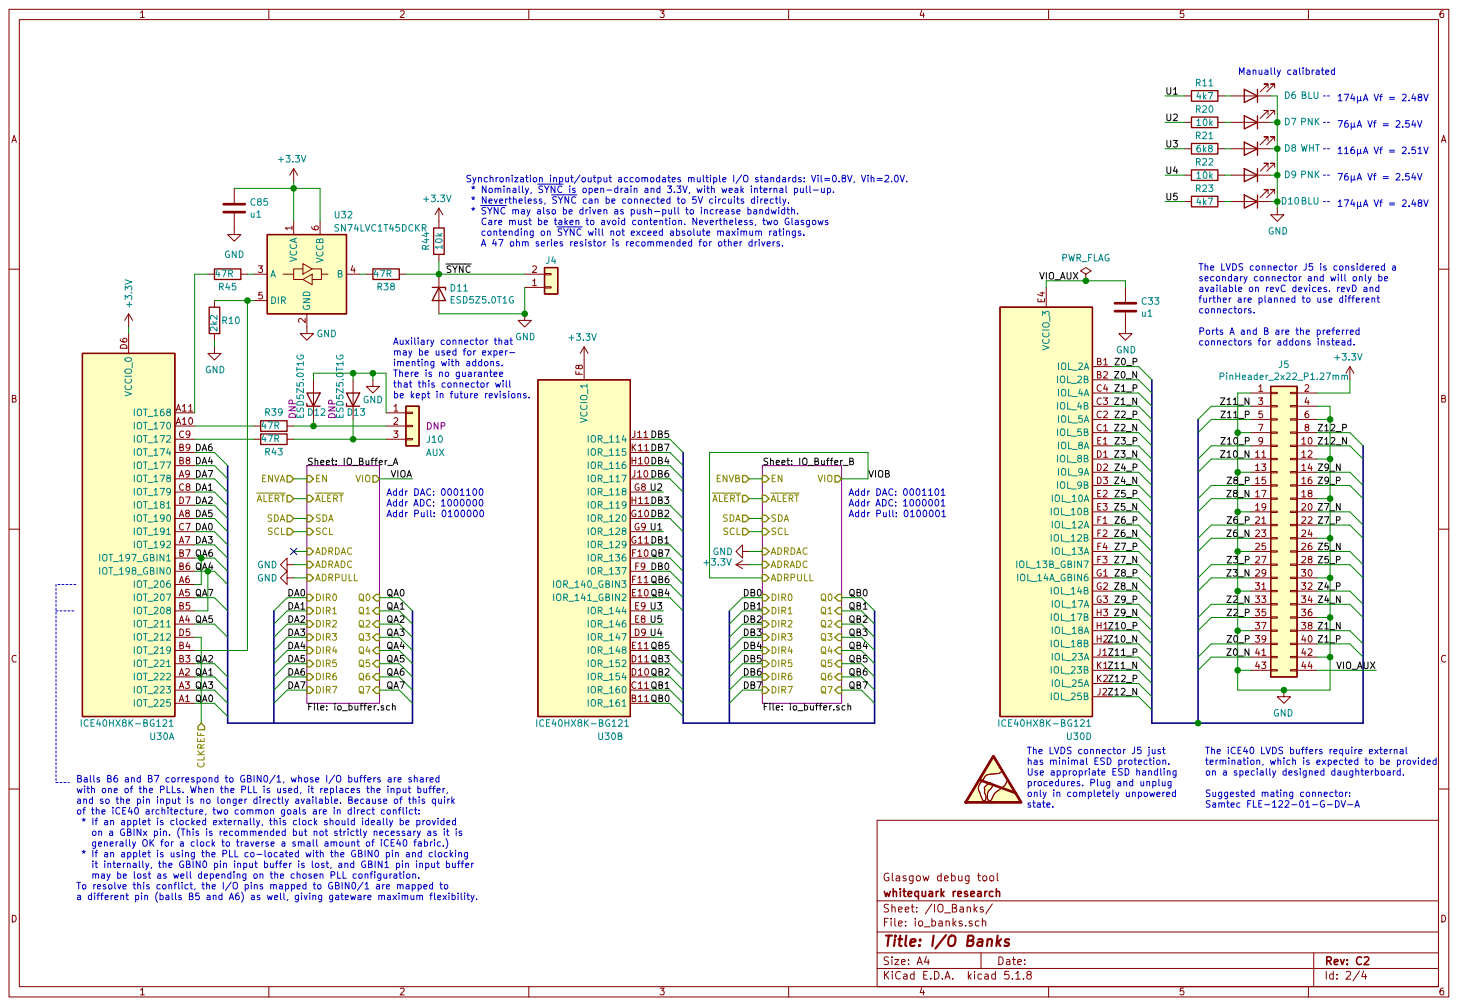
[picture p57: page 2]

further are planned to use different connectors. Ports A and B are the preferred connectors for addons instead. Manually calibrated

Synchronization input/output accomodates multiple I/O standards: Vil=0.8V, Vih=2.0V.
* Nominally, SYNC is open-drain and 3.3V, with weak internal pull-up.
* Nevertheless, SYNC can be connected to 5V circuits directly.
* SYNC may also be driven as push-pull to increase bandwidth.
Care must be taken to avoid contention. Nevertheless, two Glasgows
contending on SYNC will not exceed absolute maximum ratings.
J4 GND

A 47 ohm series resistor is recommended for other drivers. Auxiliary connector that

The LVDS connector J5 is considered a secondary connector and will only be available on revC devices. revD and

may be used for exper-
imenting with addons.
There is no guarantee
DIR0 DIR2 DIR4 DIR6 DIR1 DIR3 DIR5 DIR7 ADRPULLVIO
SCL ALERT ADRDAC
File: io_buffer.sch Q1 Q2 Q3 Q4 Q5 Q6 Q7 Q0 SDA

Glasgow debug tool Sheet: IO_Buffer_A

The LVDS connector J5 just
has minimal ESD protection.
Use appropriate ESD handling
procedures. Plug and unplug
only in completely unpowered state.

The iCE40 LVDS buffers require external
termination, which is expected to be provided
on a specially designed daughterboard.

Balls B6 and B7 correspond to GBIN0/1, whose I/O buffers are shared
with one of the PLLs. When the PLL is used, it replaces the input buffer,
and so the pin input is no longer directly available. Because of this quirk
of the iCE40 architecture, two common goals are in direct conflict:
* If an applet is clocked externally, this clock should ideally be provided
on a GBINx pin. (This is recommended but not strictly necessary as it is
generally OK for a clock to traverse a small amount of iCE40 fabric.)
* If an applet is using the PLL co-located with the GBIN0 pin and clocking
it internally, the GBIN0 pin input buffer is lost, and GBIN1 pin input buffer
may be lost as well depending on the chosen PLL configuration.
To resolve this conflict, the I/O pins mapped to GBIN0/1 are mapped to
a different pin (balls B5 and A6) as well, giving gateware maximum flexibility.

Suggested mating connector: Samtec FLE-122-01-G-DV-A

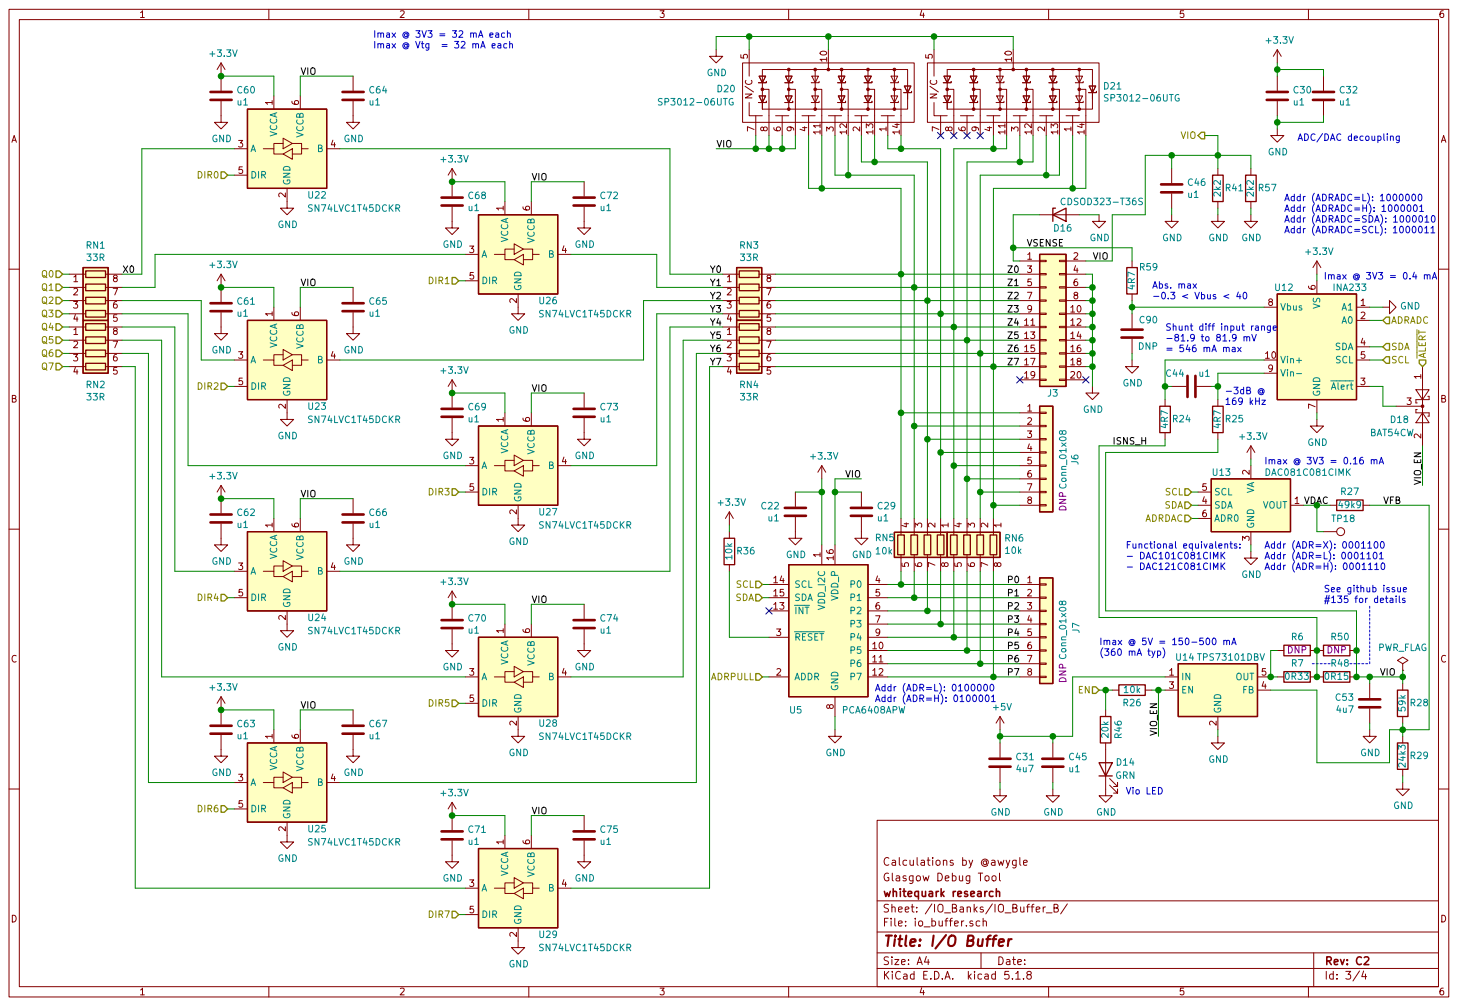
[picture p58: page 3]

Imax @ 3V3 = 32 mA each
Imax @ Vtg = 32 mA each

= 546 mA max Abs. max

4 | 5 | 11 | 12
1 | | 13 | 14

169 kHz Shunt diff input range

See github issue #135 for details Functional equivalents: - DAC101C081CIMK

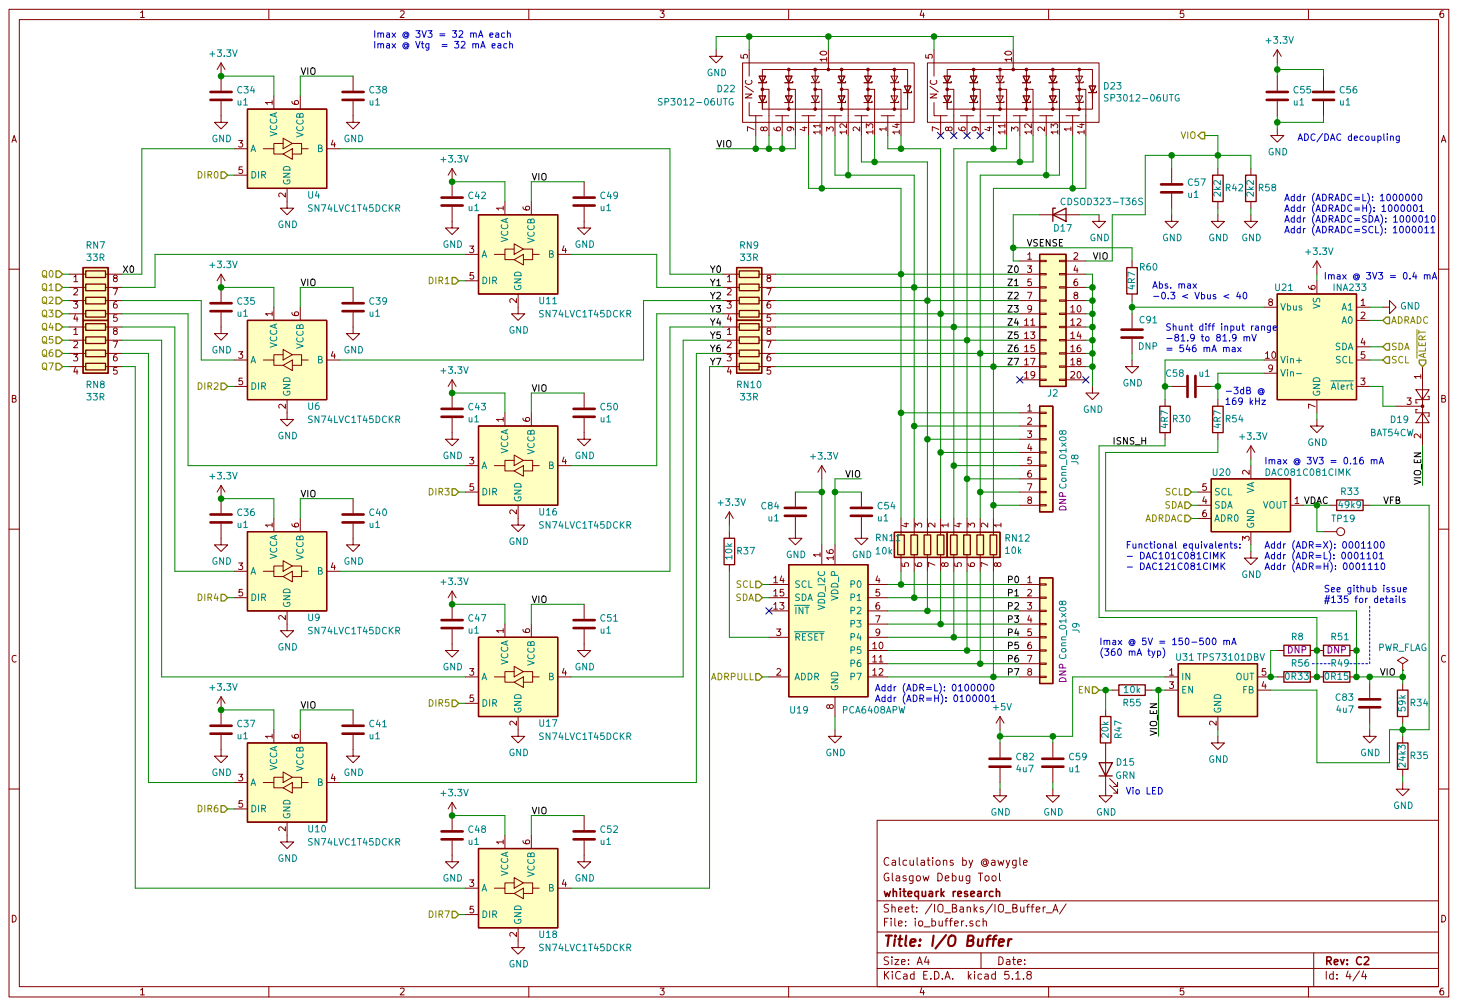
[picture p59: page 4]

Imax @ 3V3 = 32 mA each
Imax @ Vtg = 32 mA each

= 546 mA max Abs. max

4 | 5 | 11 | 12
1 | | 13 | 14

169 kHz Shunt diff input range

See github issue #135 for details Functional equivalents: - DAC101C081CIMK
