GlasgowEmbedded/glasgow/hardware/boards/glasgow/revC0/output/schematics.pdf

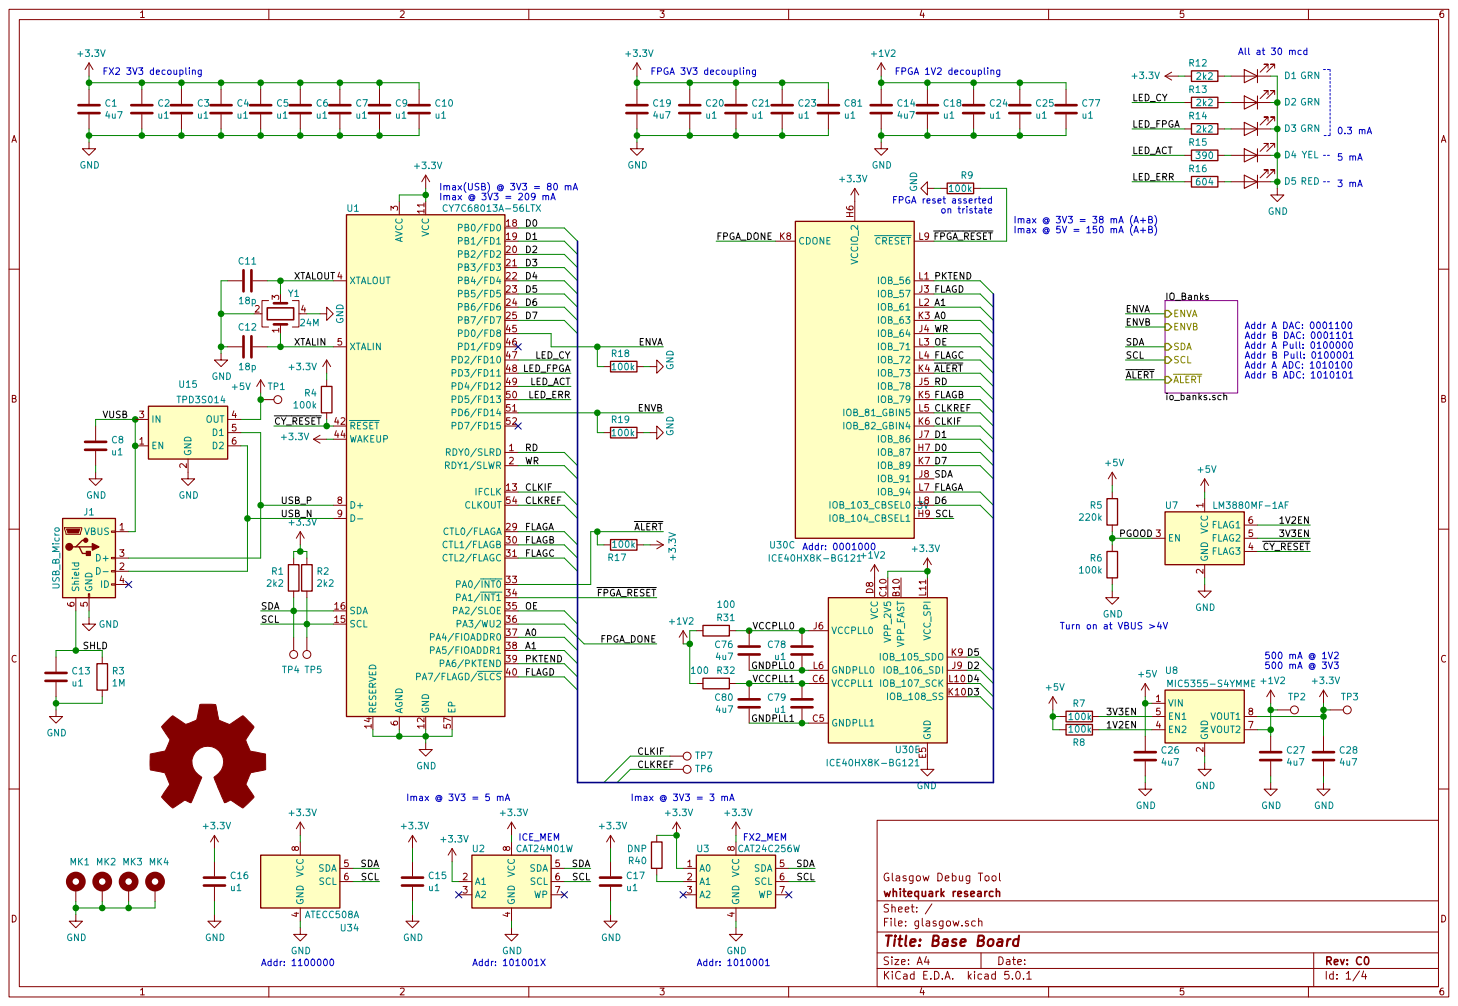
[picture p64: page 1]

3 CTL1/FLAGB 30 CTL2/FLAGC 31 PA0/INT0 33 PA1/INT1 34 PA2/SLOE 35 PA3/WU2 36 PA4/FIOADDR0 37 PA5/FIOADDR1 38 PA6/PKTEND 39 XTALOUT 4 PA7/FLAGD/SLCS 40 RESET 42 WAKEUP 44 PD0/FD8 45 PD1/FD9 46 PD2/FD10 47 PD3/FD11 48 PD4/FD12 49 XTALIN 5 PD5/FD13 50 PD6/FD14 51 PD7/FD15 52 CLKOUT 54 EP 57 AGND

PKTEND
FLAGD
FLAGA CLKREF D7 D6 D1 D0 CLKIF WR

Turn on at VBUS >4V

4 SDA 5 SCL 6 WP 7 VCC

File: glasgow.sch Sheet: / whitequark research

Id: 1/4 Title: Base Board

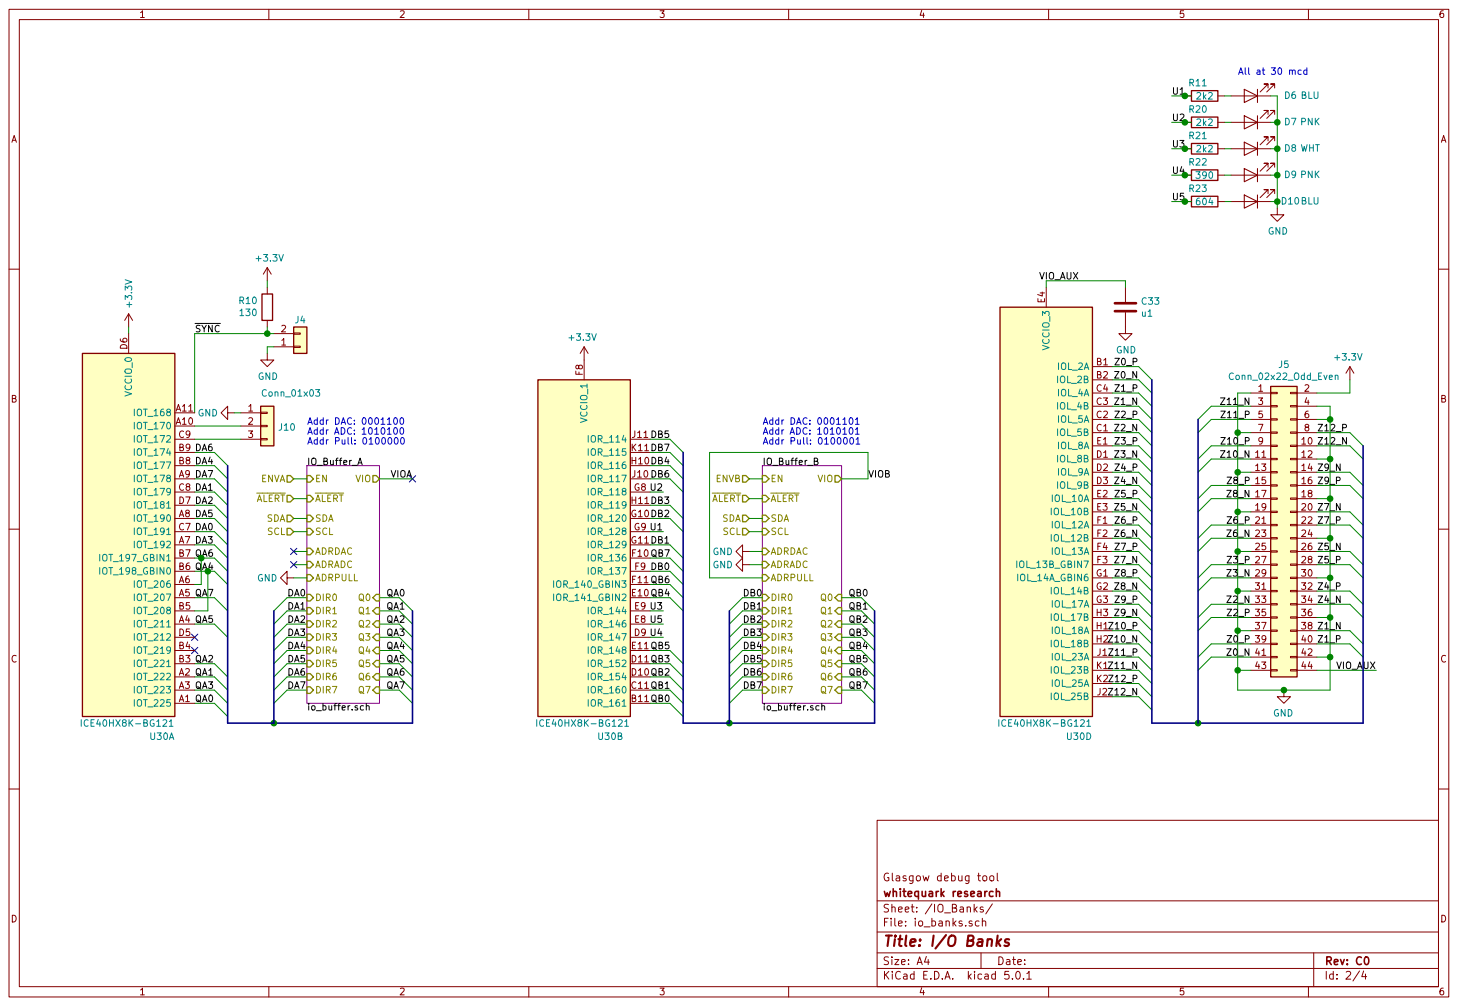
[picture p65: page 2]

Addr DAC: 0001101 Addr ADC: 1010101 Addr Pull: 0100001 GND

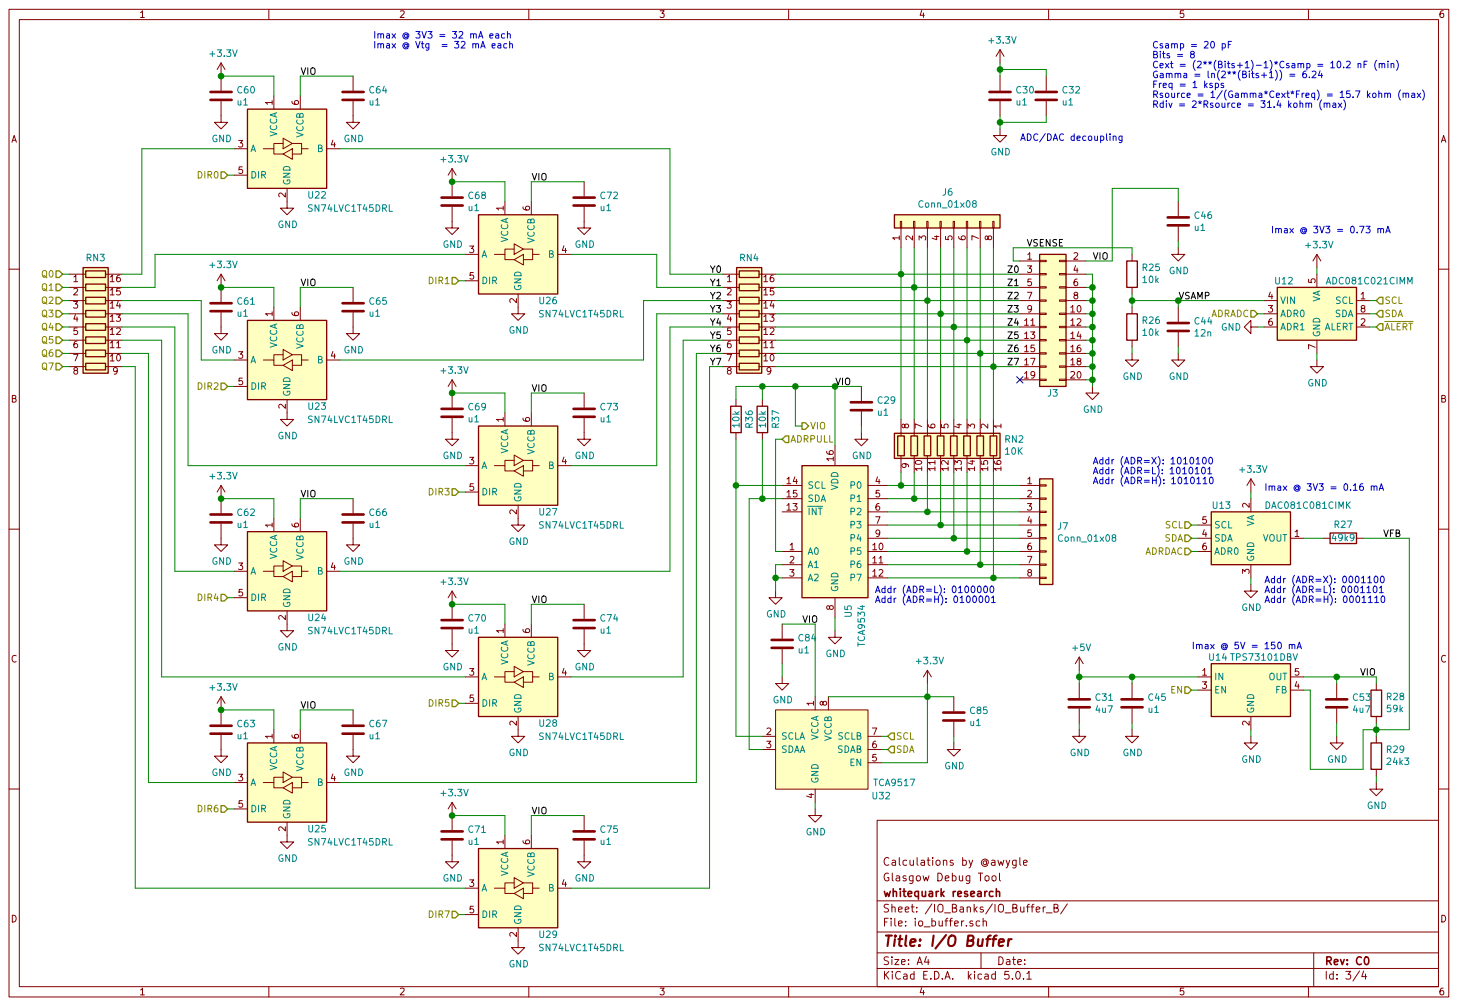
[picture p66: page 3]

Rdiv = 2*Rsource = 31.4 kohm (max) C45
ADC/DAC decoupling C31

10kCsamp = 20 pF Bits = 8 Cext = (2**(Bits+1)-1)*Csamp = 10.2 nF (min)

Gamma = ln(2**(Bits+1)) = 6.24
Freq = 1 ksps
Rsource = 1/(Gamma*Cext*Freq) = 15.7 kohm (max)

7 SDA 8 U12 ADC081C021CIMM
SCL SDA GND GND
ADRADC

2 EN 3 FB 4 OUT 5 U14 TPS73101DBV GND

4 EN 5 SDAB 6 SCLB 7 VCCB

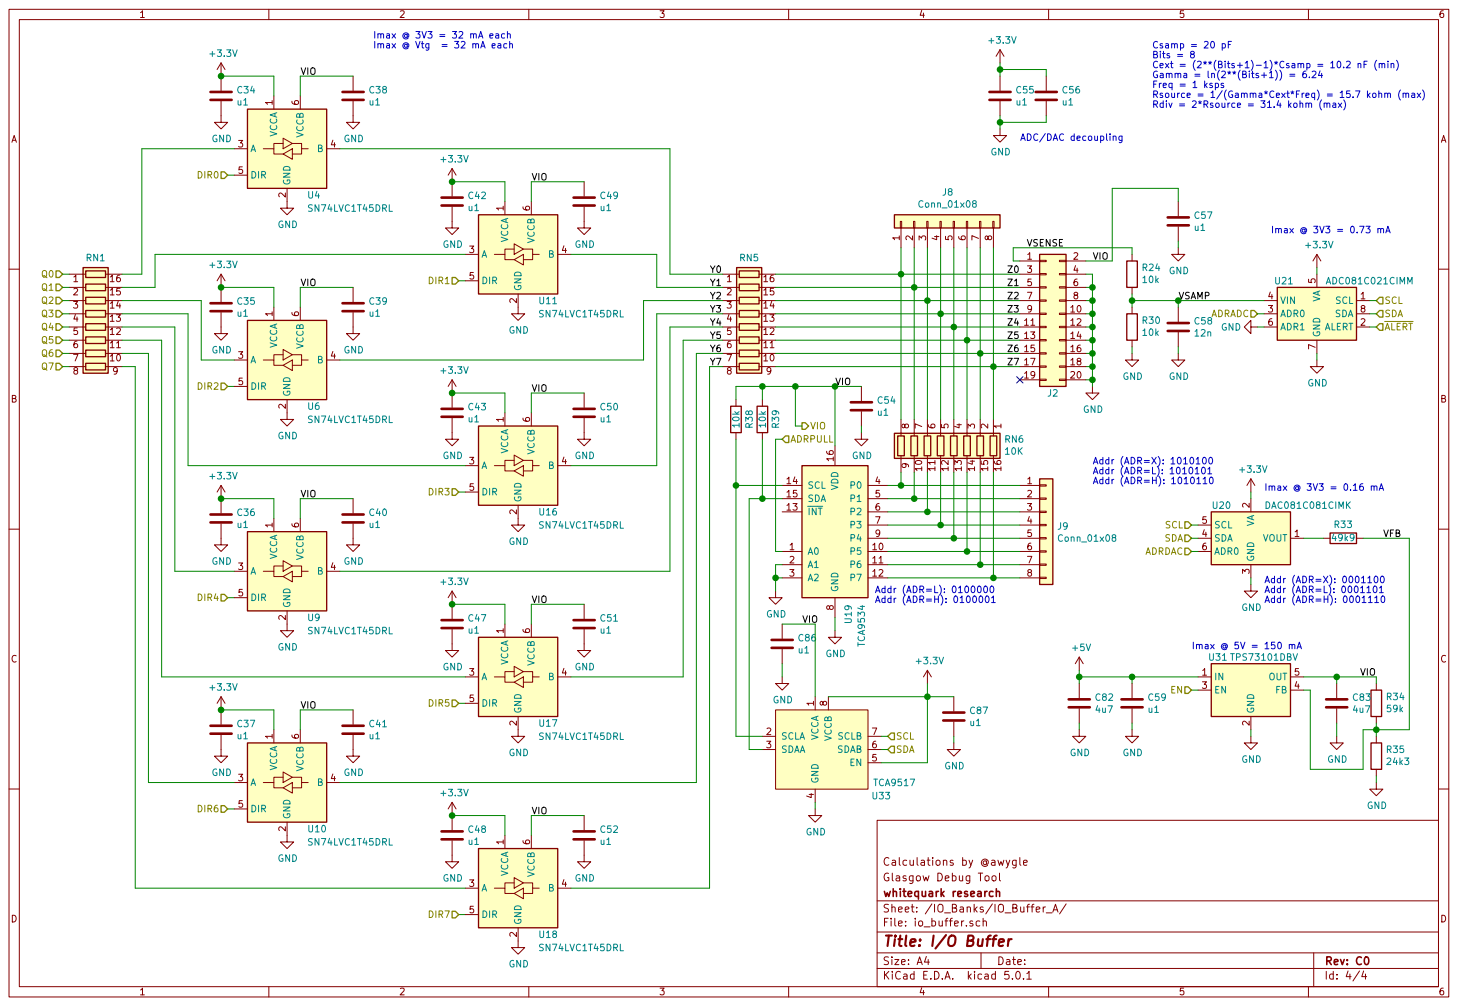
[picture p67: page 4]

Rdiv = 2*Rsource = 31.4 kohm (max) C59
ADC/DAC decoupling C82

10kCsamp = 20 pF Bits = 8 Cext = (2**(Bits+1)-1)*Csamp = 10.2 nF (min)

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

7 SDA 8 U21 ADC081C021CIMM
SCL SDA GND GND
ADRADC

2 EN 3 FB 4 OUT 5 U31 TPS73101DBV GND

4 EN 5 SDAB 6 SCLB 7 VCCB
