GlasgowEmbedded/glasgow/hardware/boards/glasgow/revC3/output/fabrication.pdf

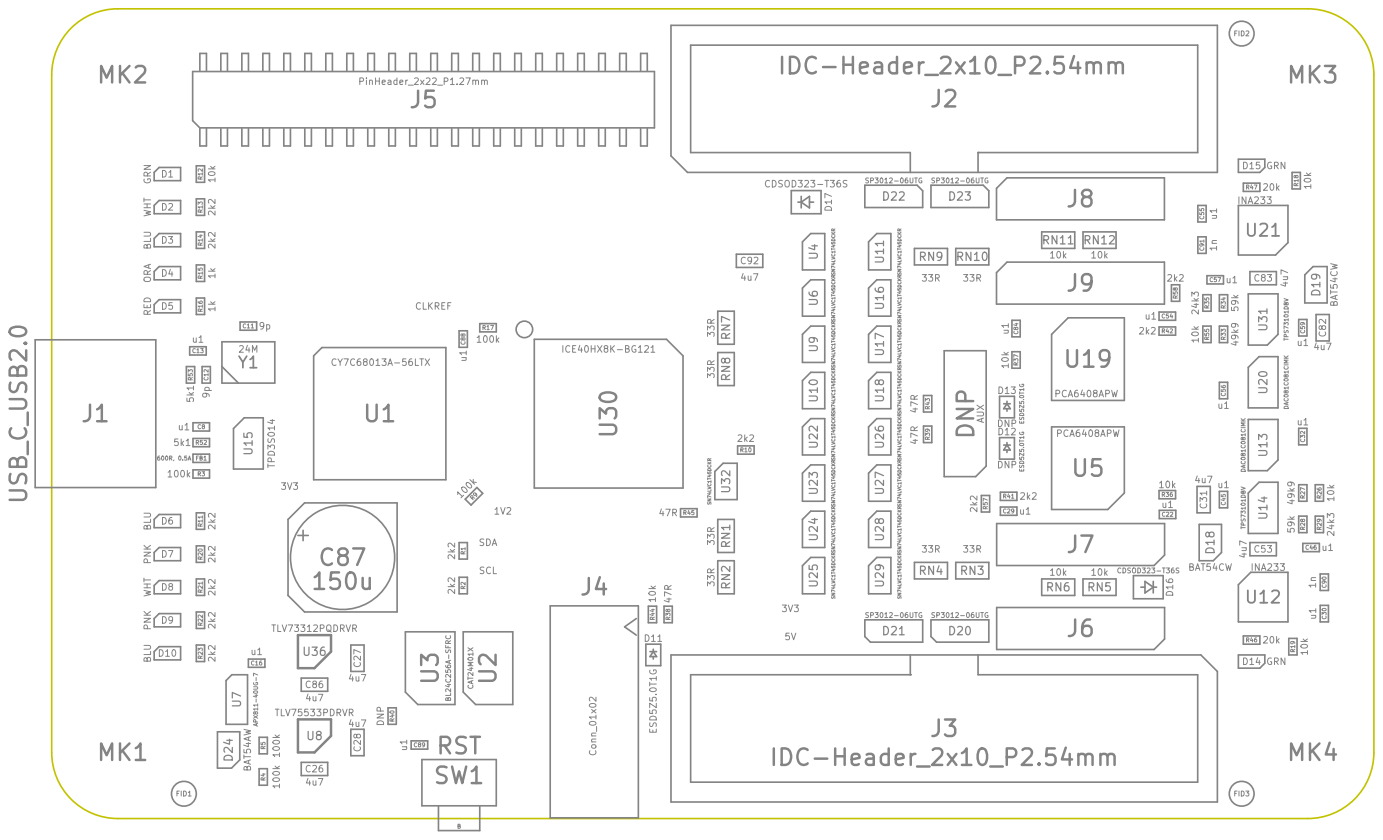
[picture p68: page 1]

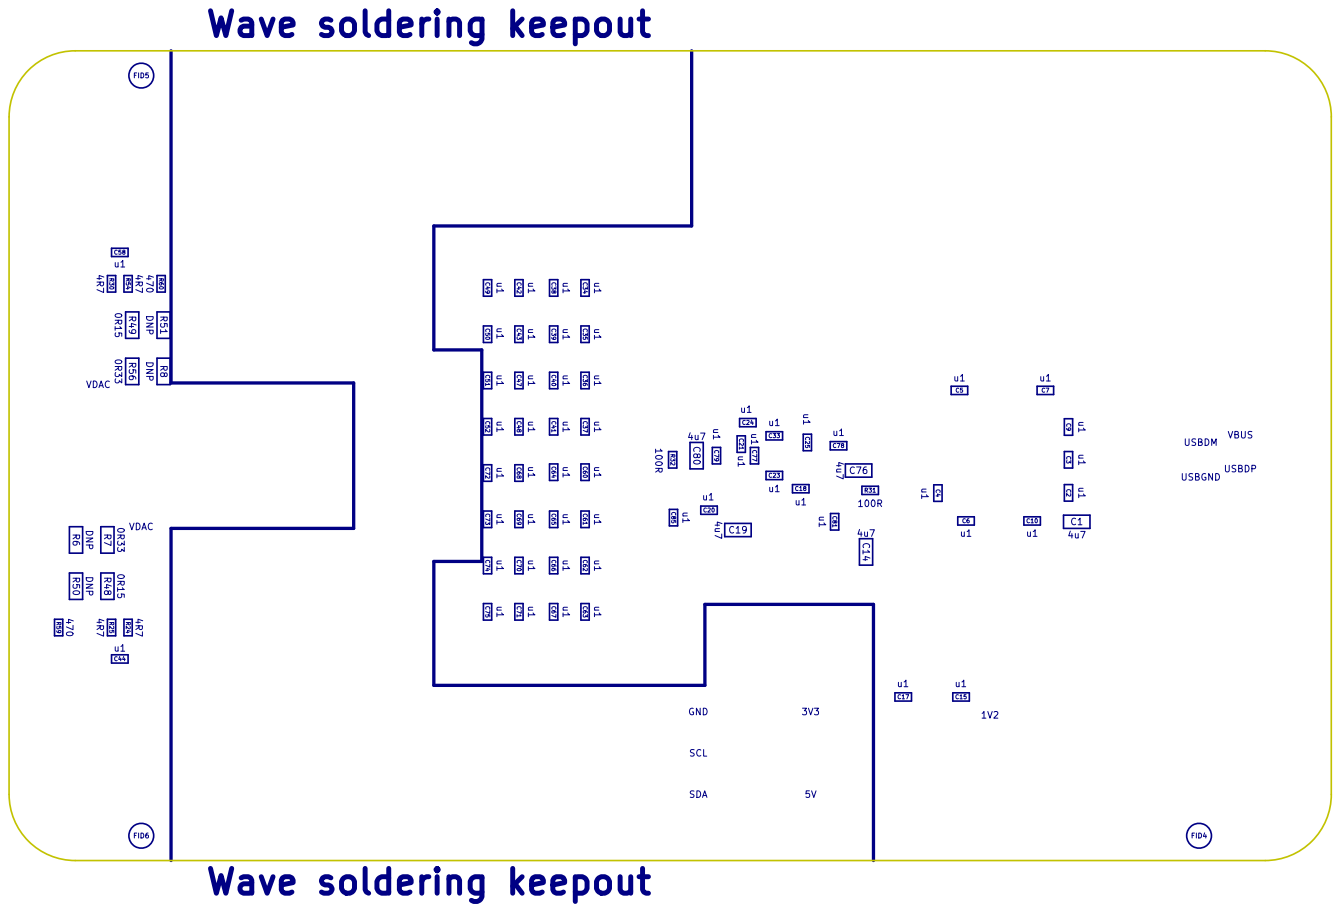
[picture p69: page 2]
