GlasgowEmbedded/glasgow/hardware/boards/glasgow/revC2/output/fabrication.pdf

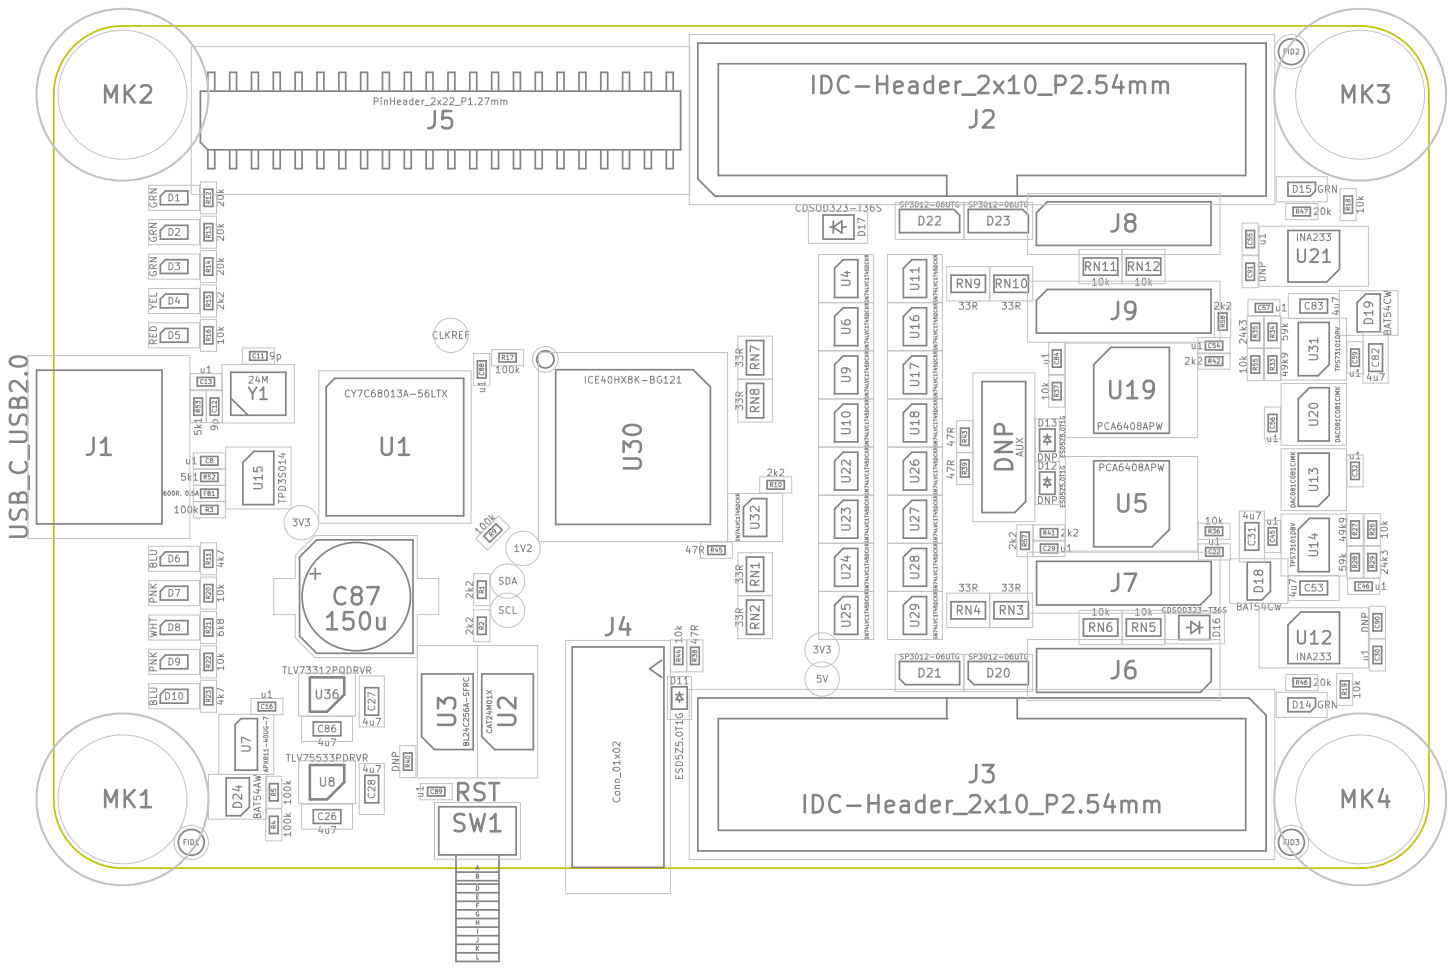
[picture p70: page 1]

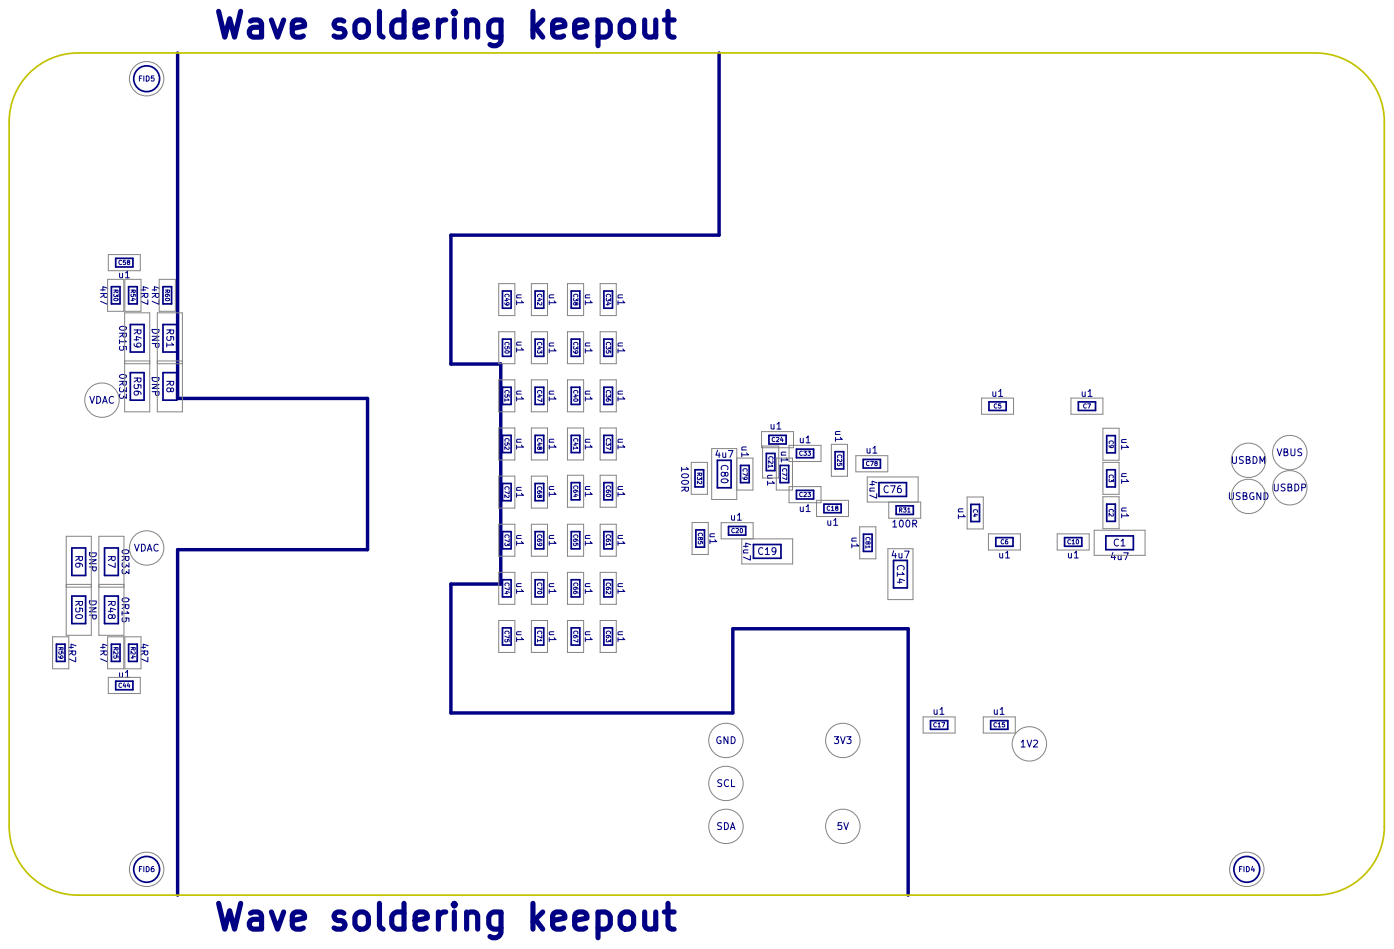
[picture p71: page 2]
