GlasgowEmbedded/glasgow/hardware/boards/glasgow/revC1/output/fabrication.pdf

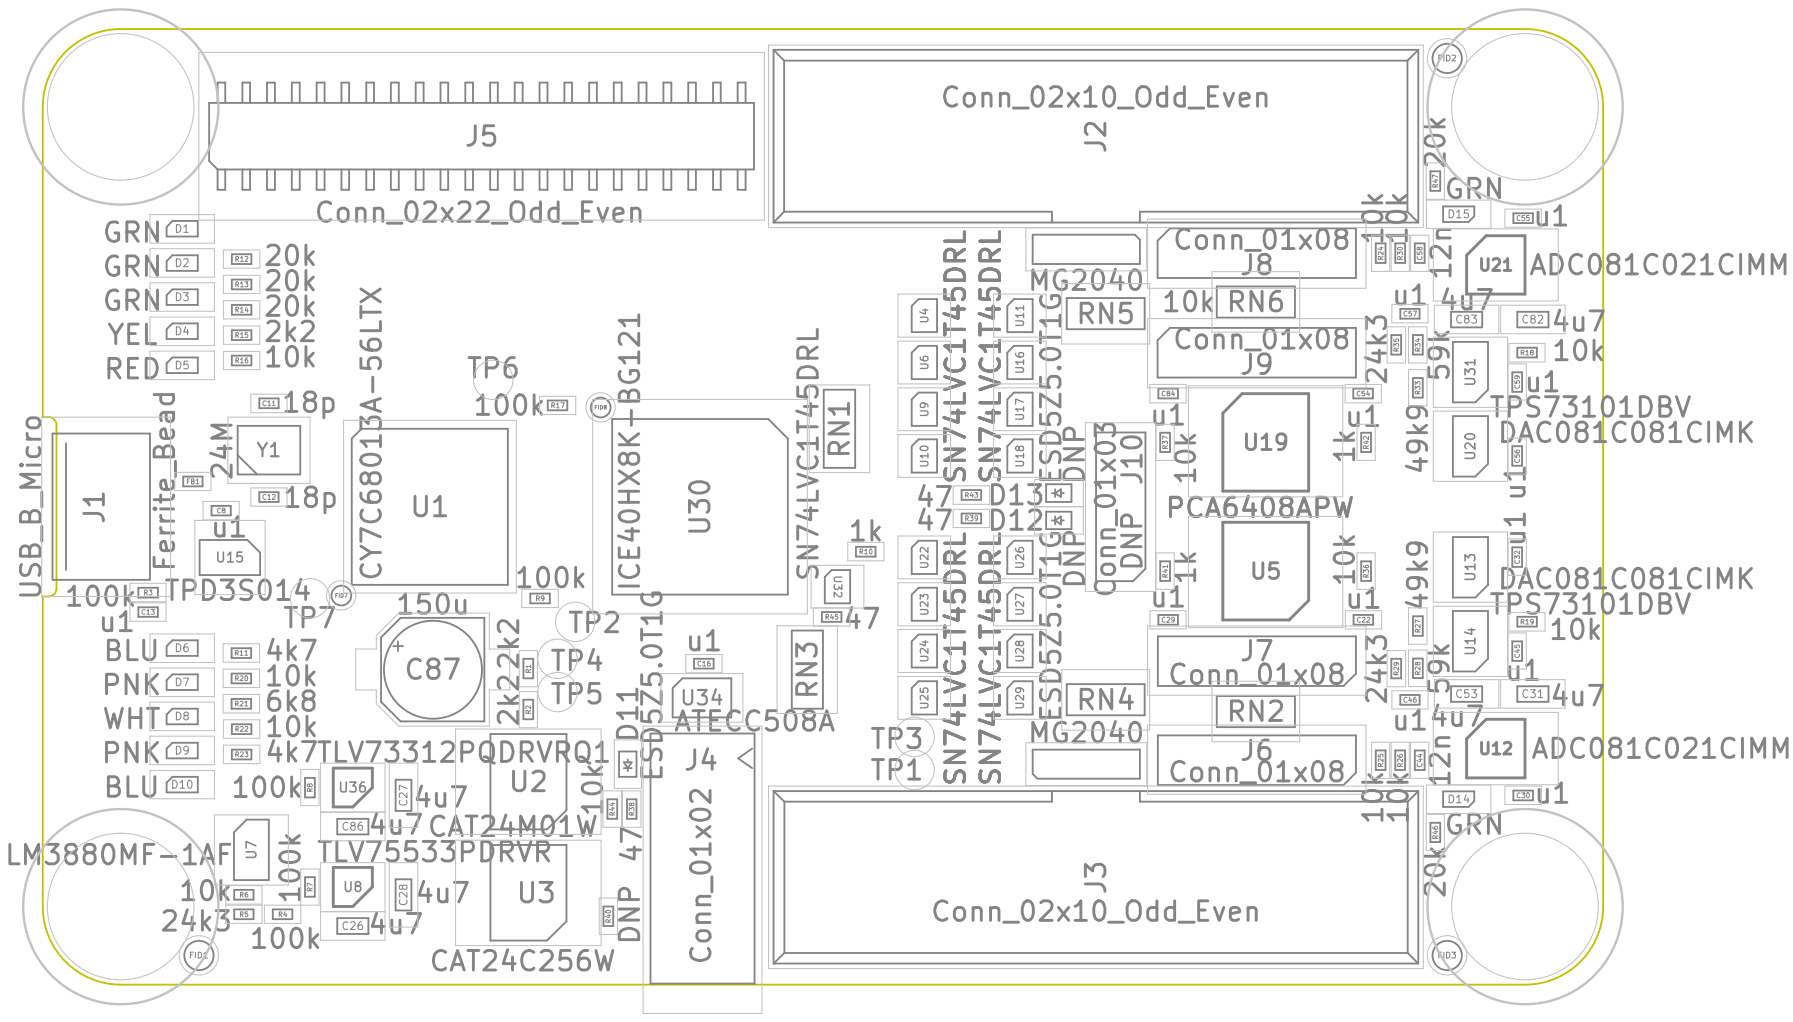
[picture p72: page 1]

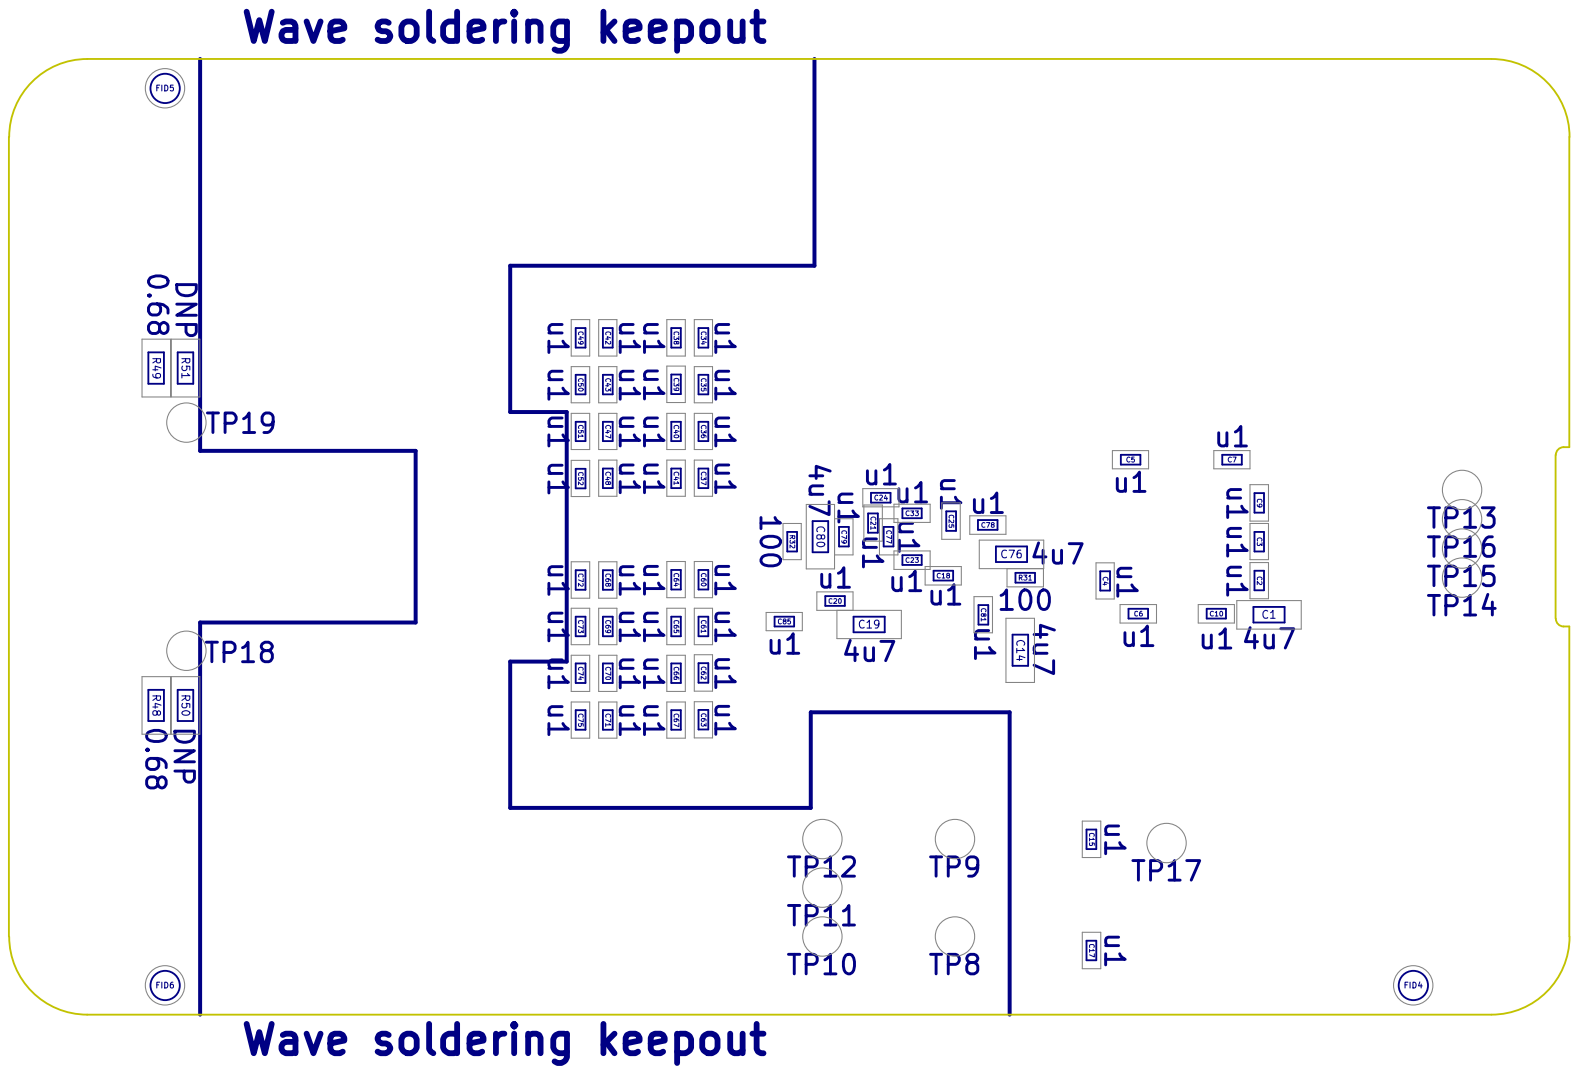
[picture p73: page 2]
