GlasgowEmbedded/glasgow/hardware/boards/glasgow/revC0/output/fabrication.pdf

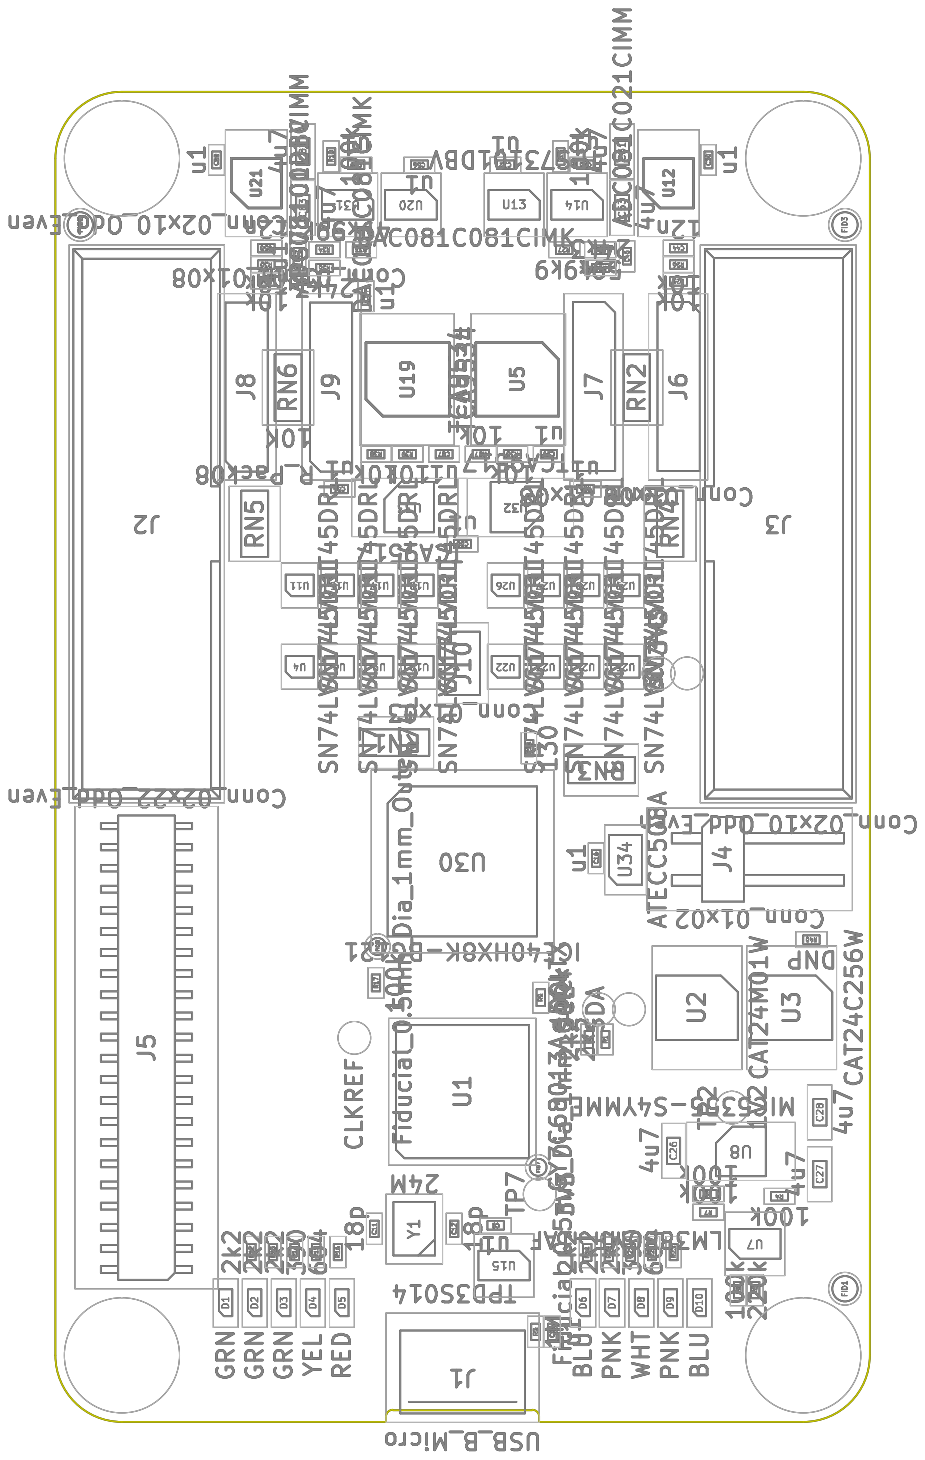
[picture p74: page 1]

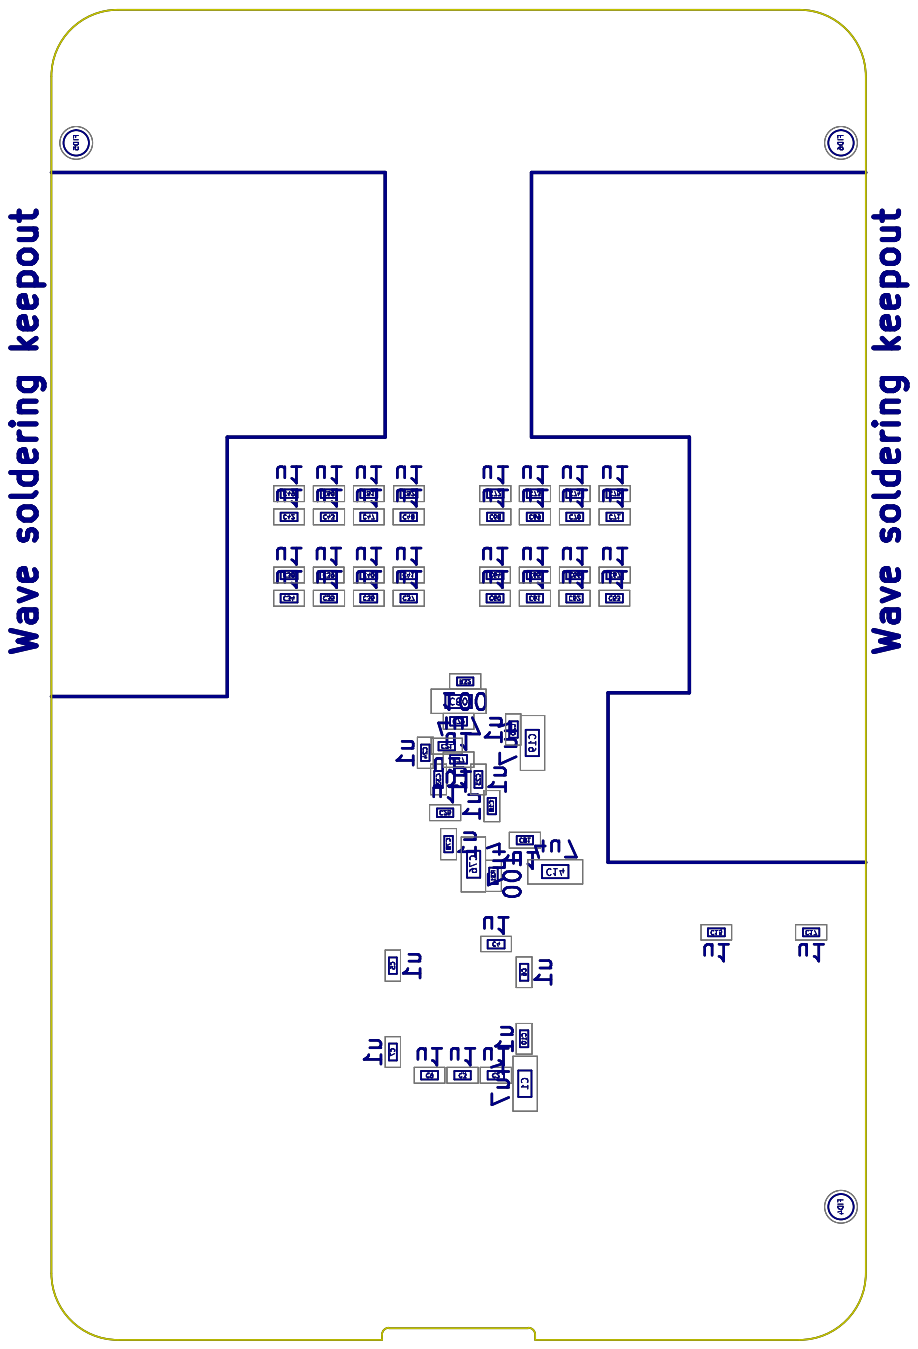
[picture p75: page 2]
