GlasgowEmbedded/glasgow/hardware/boards/glasgow/revB/output/fabrication.pdf

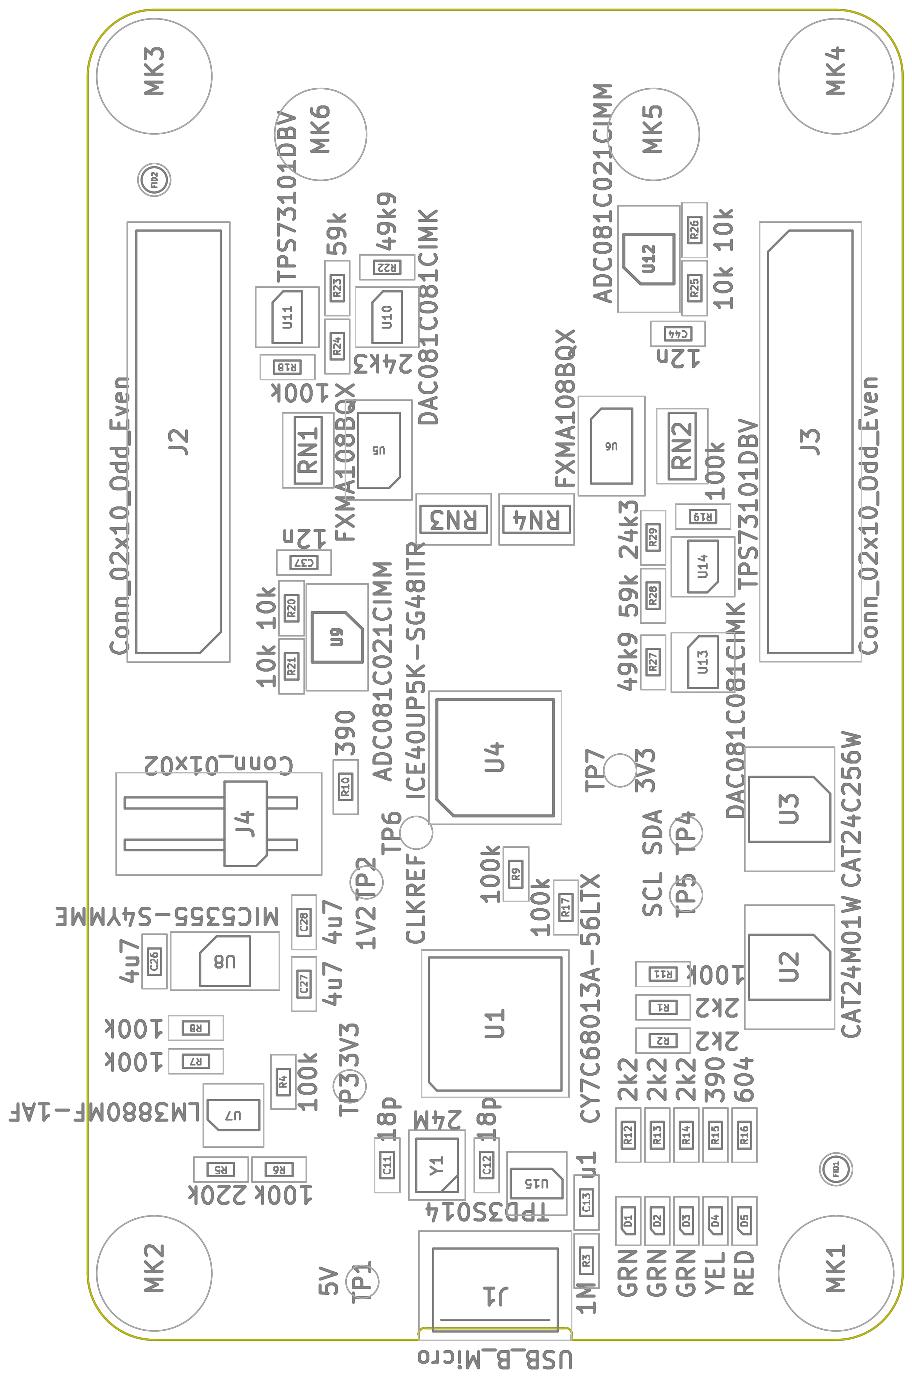
[picture p76: page 1]

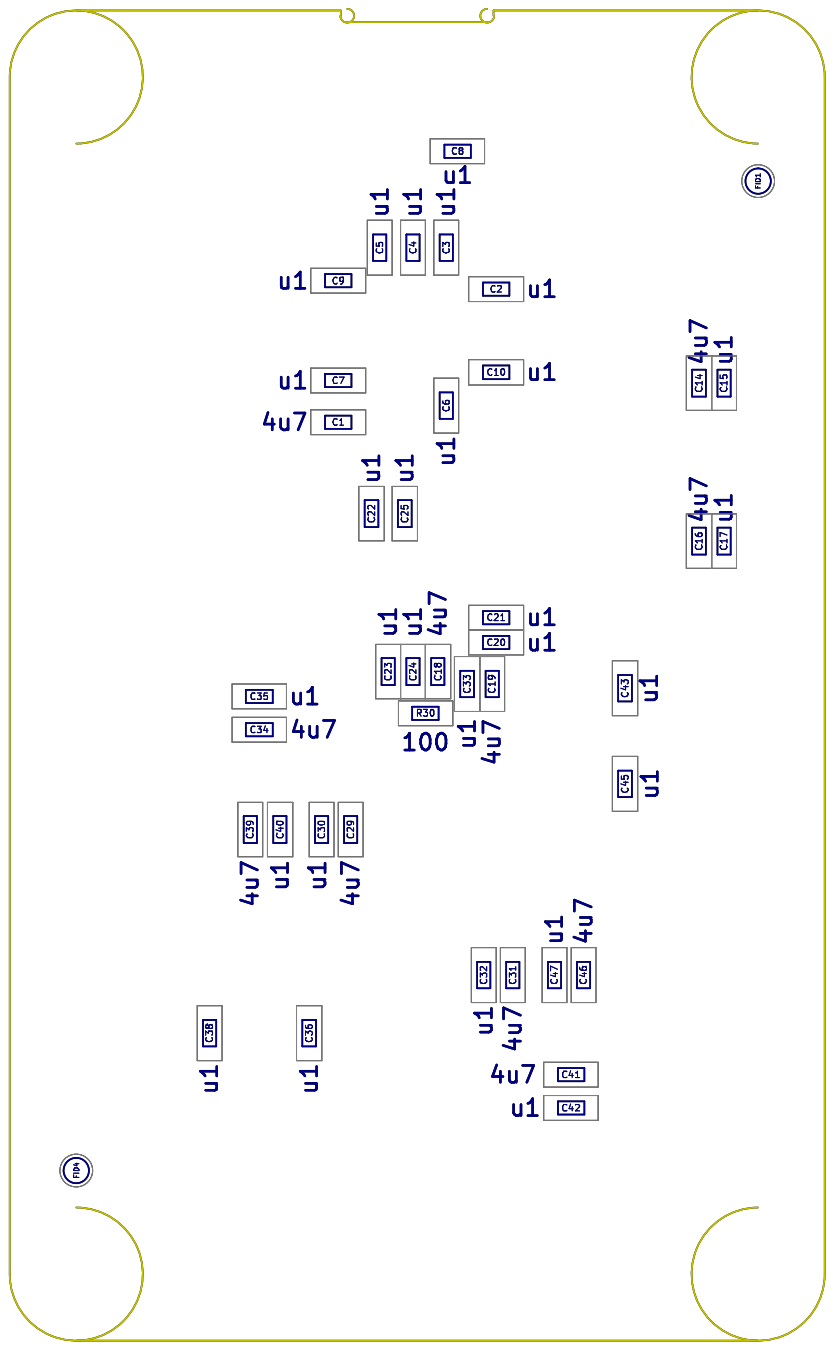
[picture p77: page 2]
