GlasgowEmbedded/glasgow/hardware/boards/glasgow/revB/output/schematics.pdf

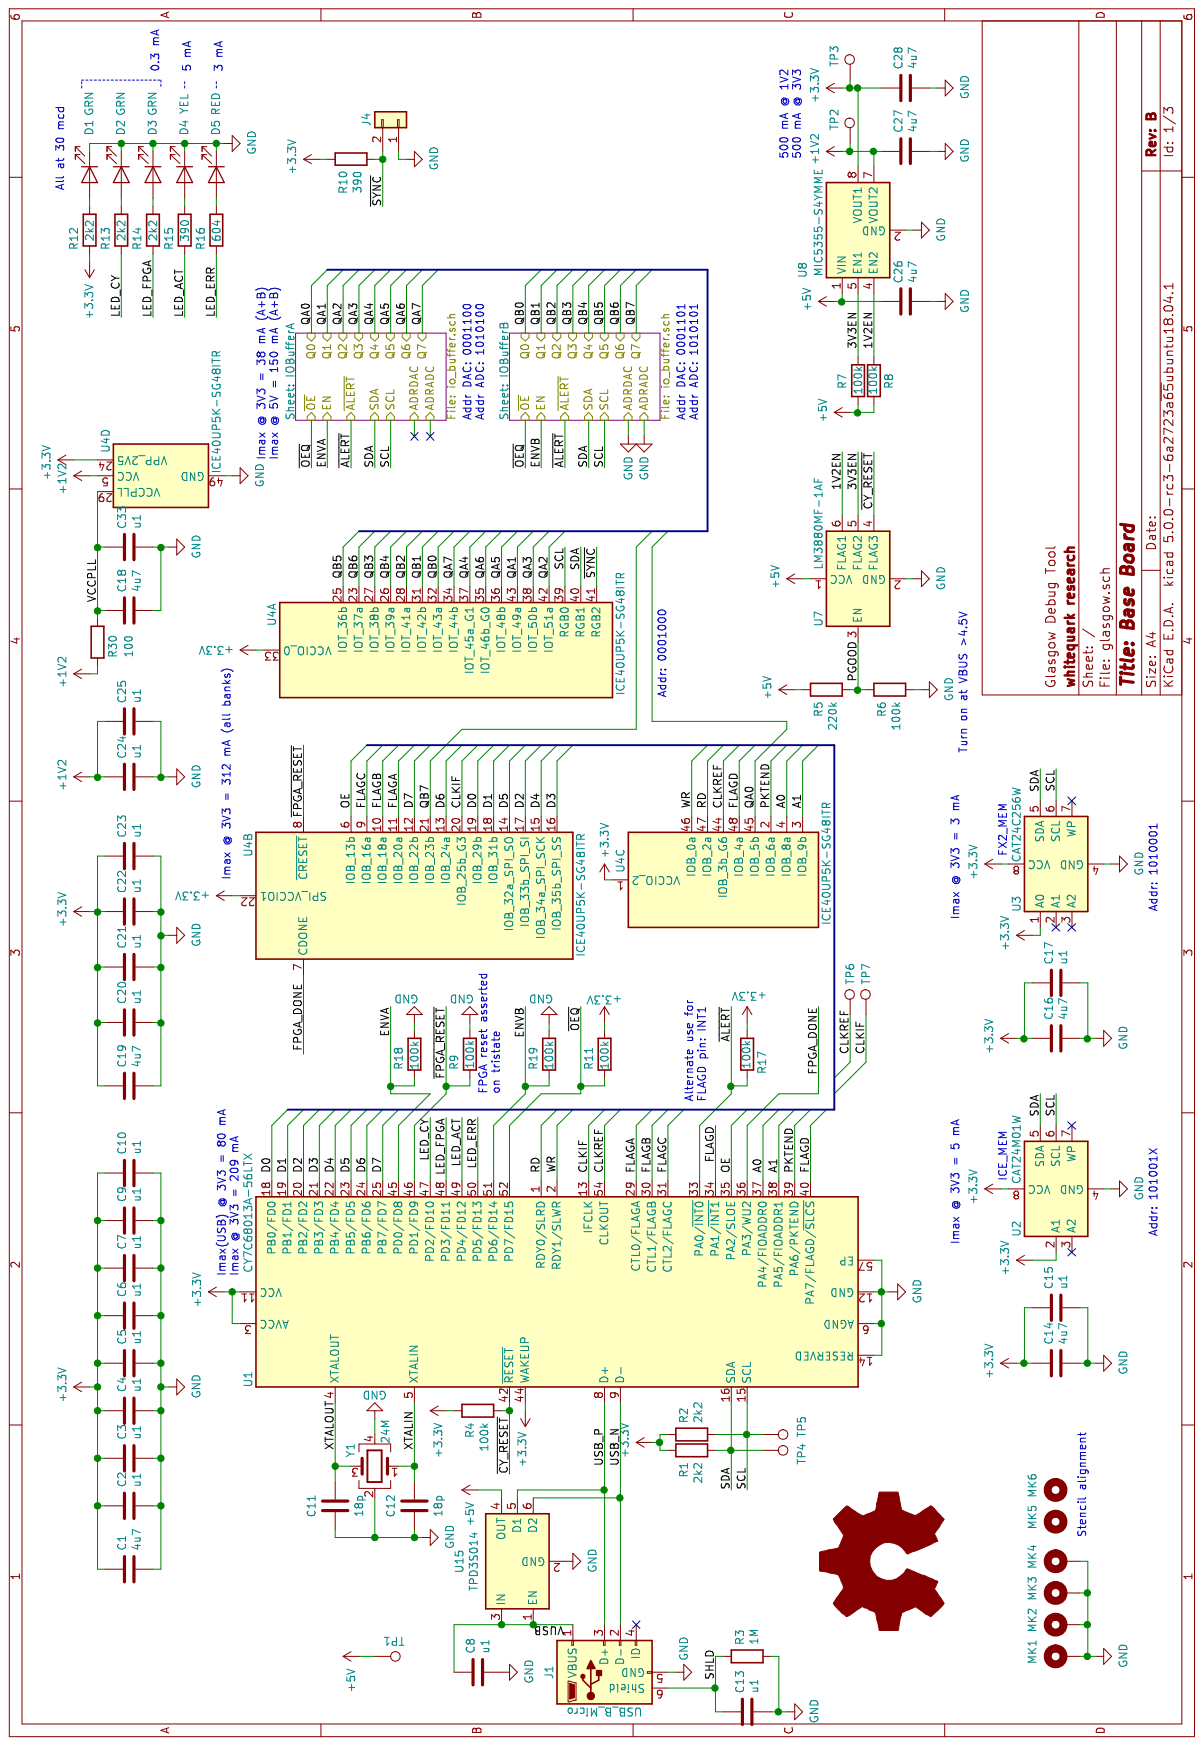
[picture p78: page 1]

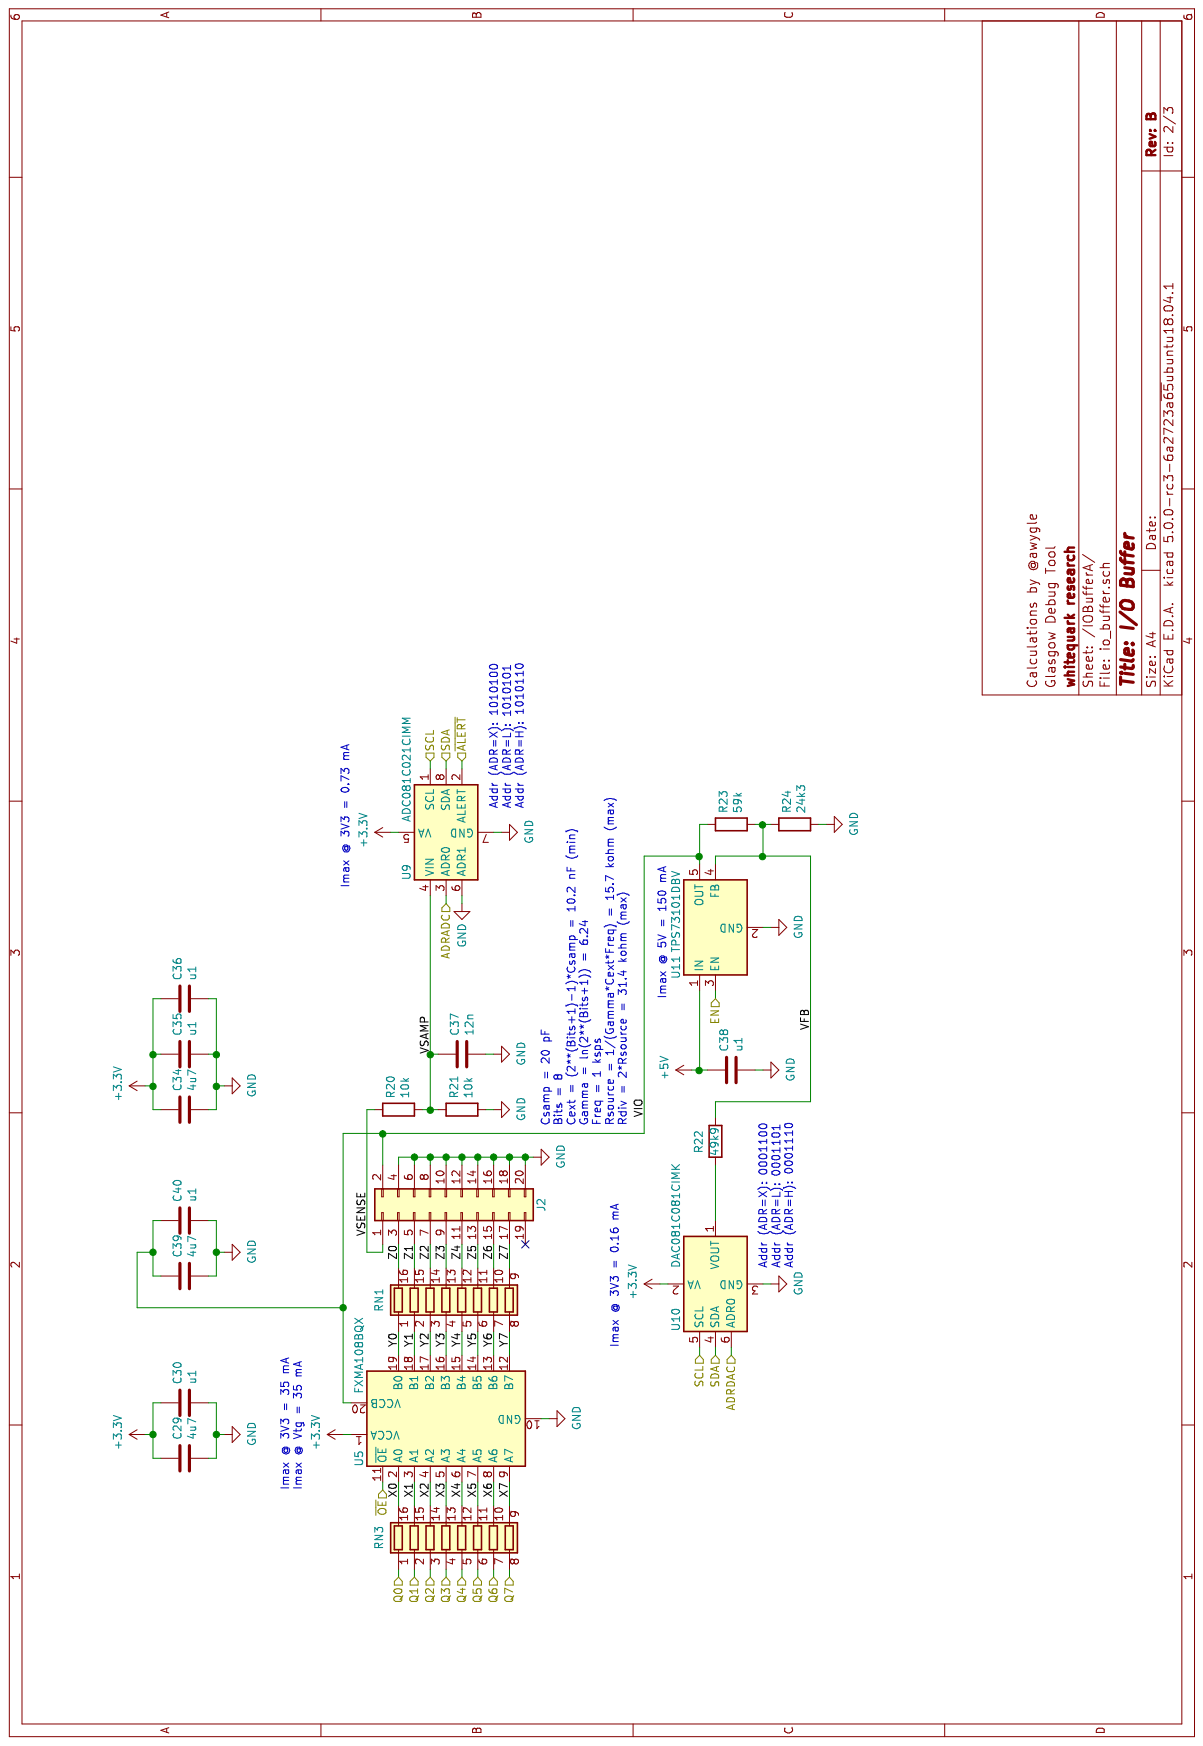
[picture p79: page 2]

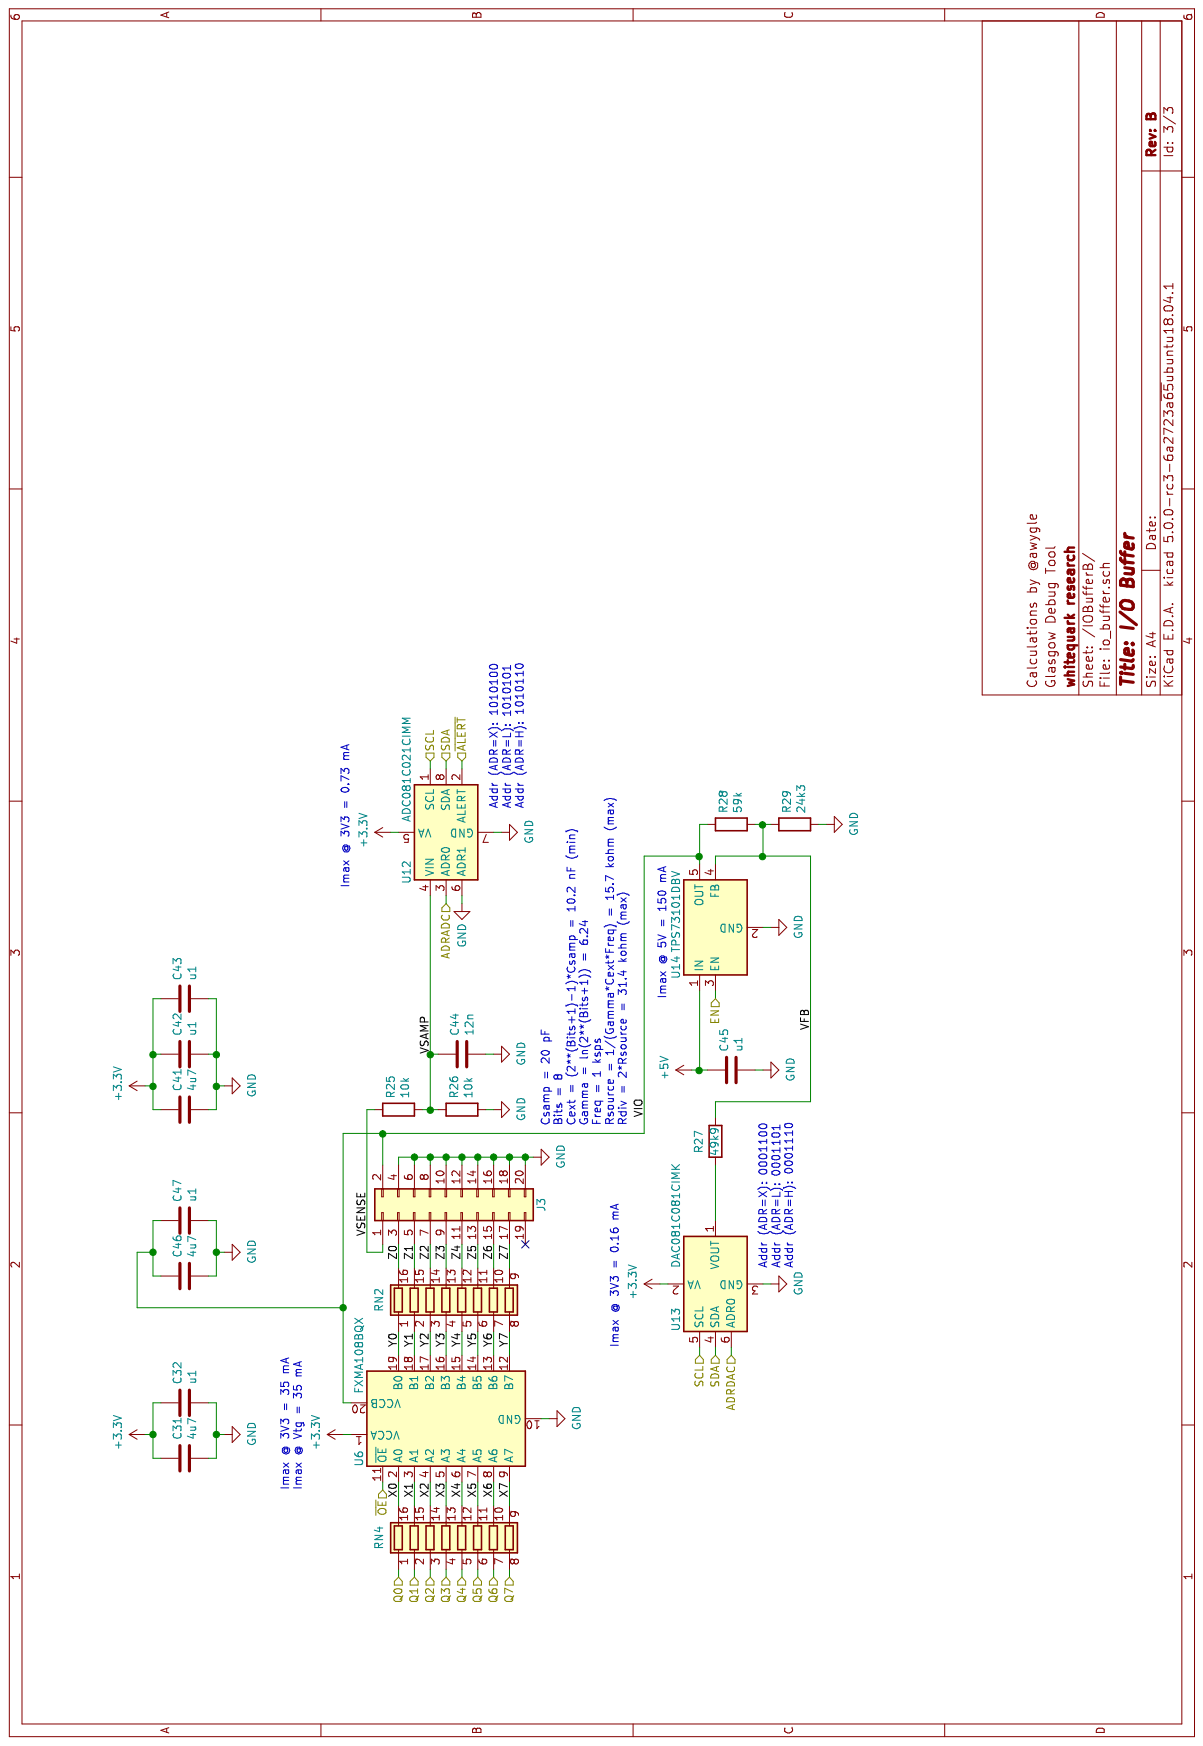
[picture p80: page 3]
