GlasgowEmbedded/glasgow/hardware/boards/glasgow/revA/output/schematics.pdf

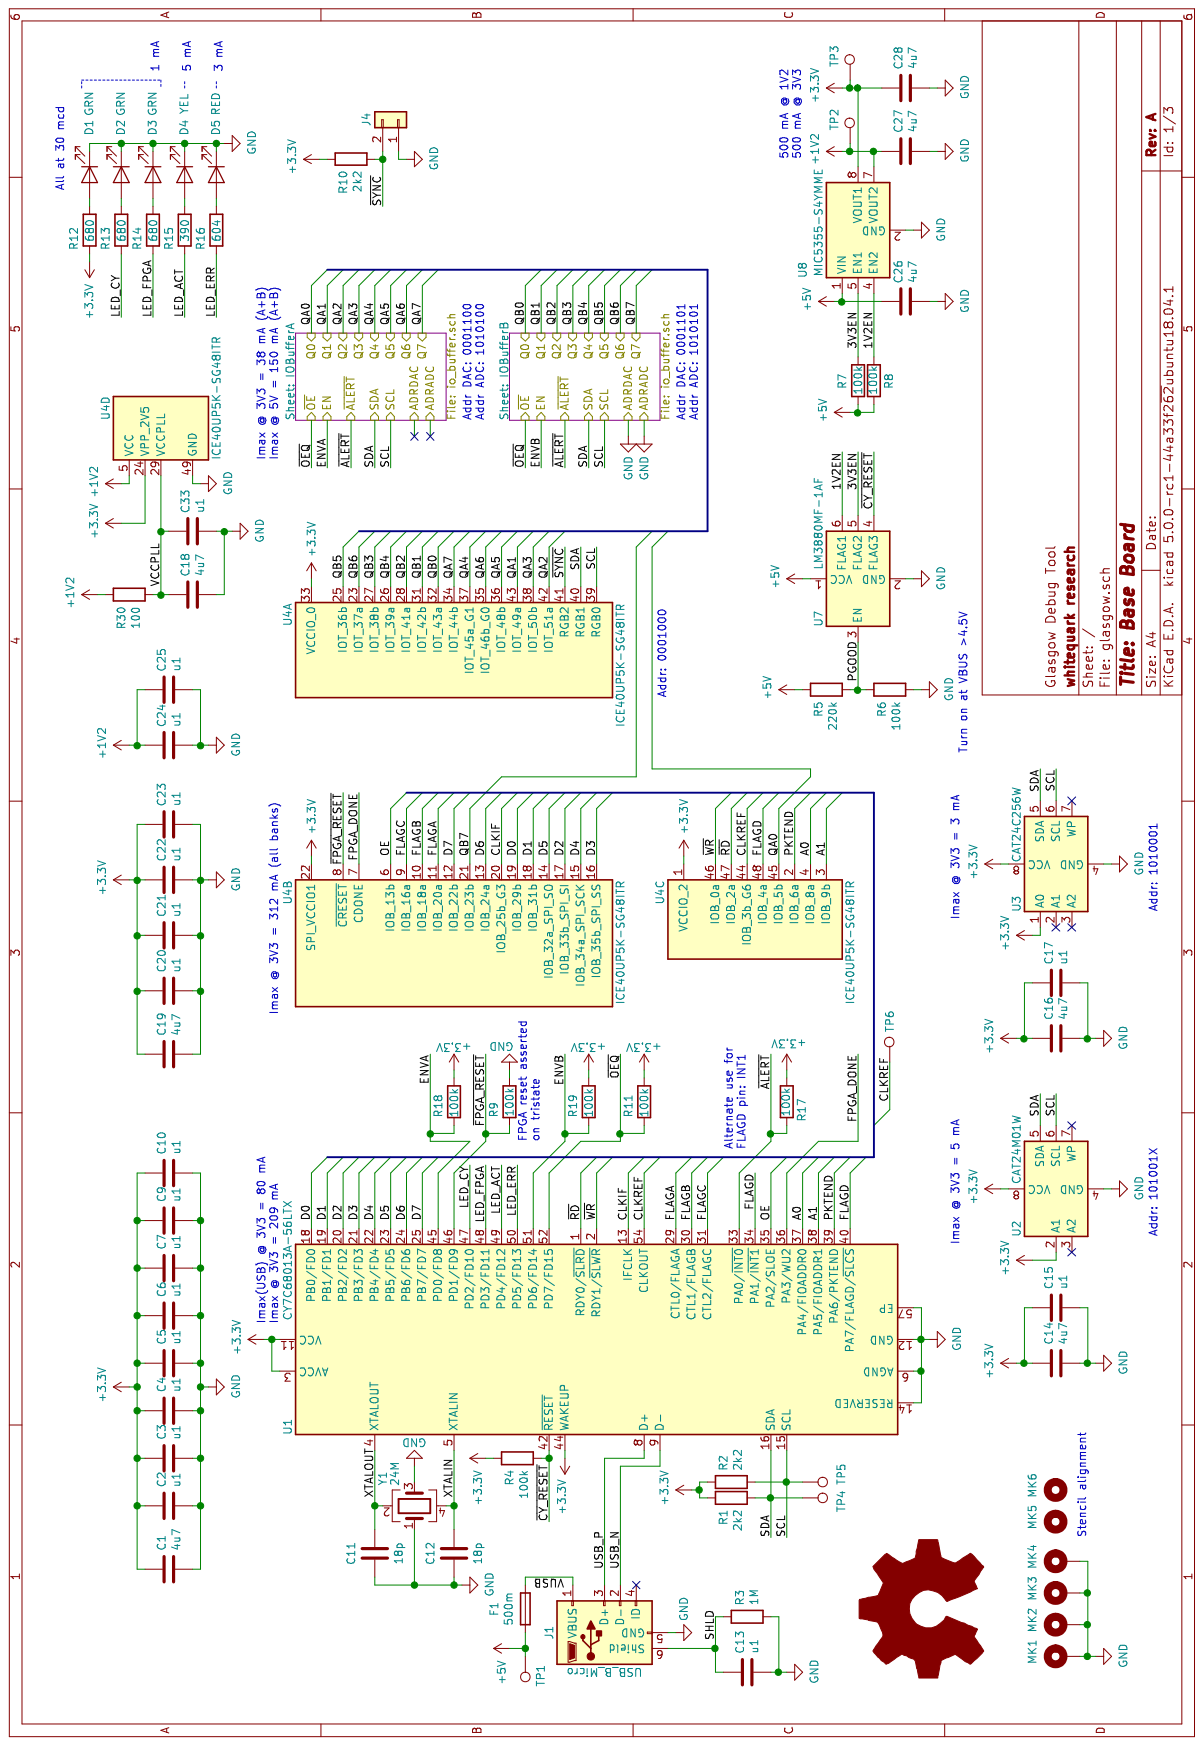
[picture p81: page 1]

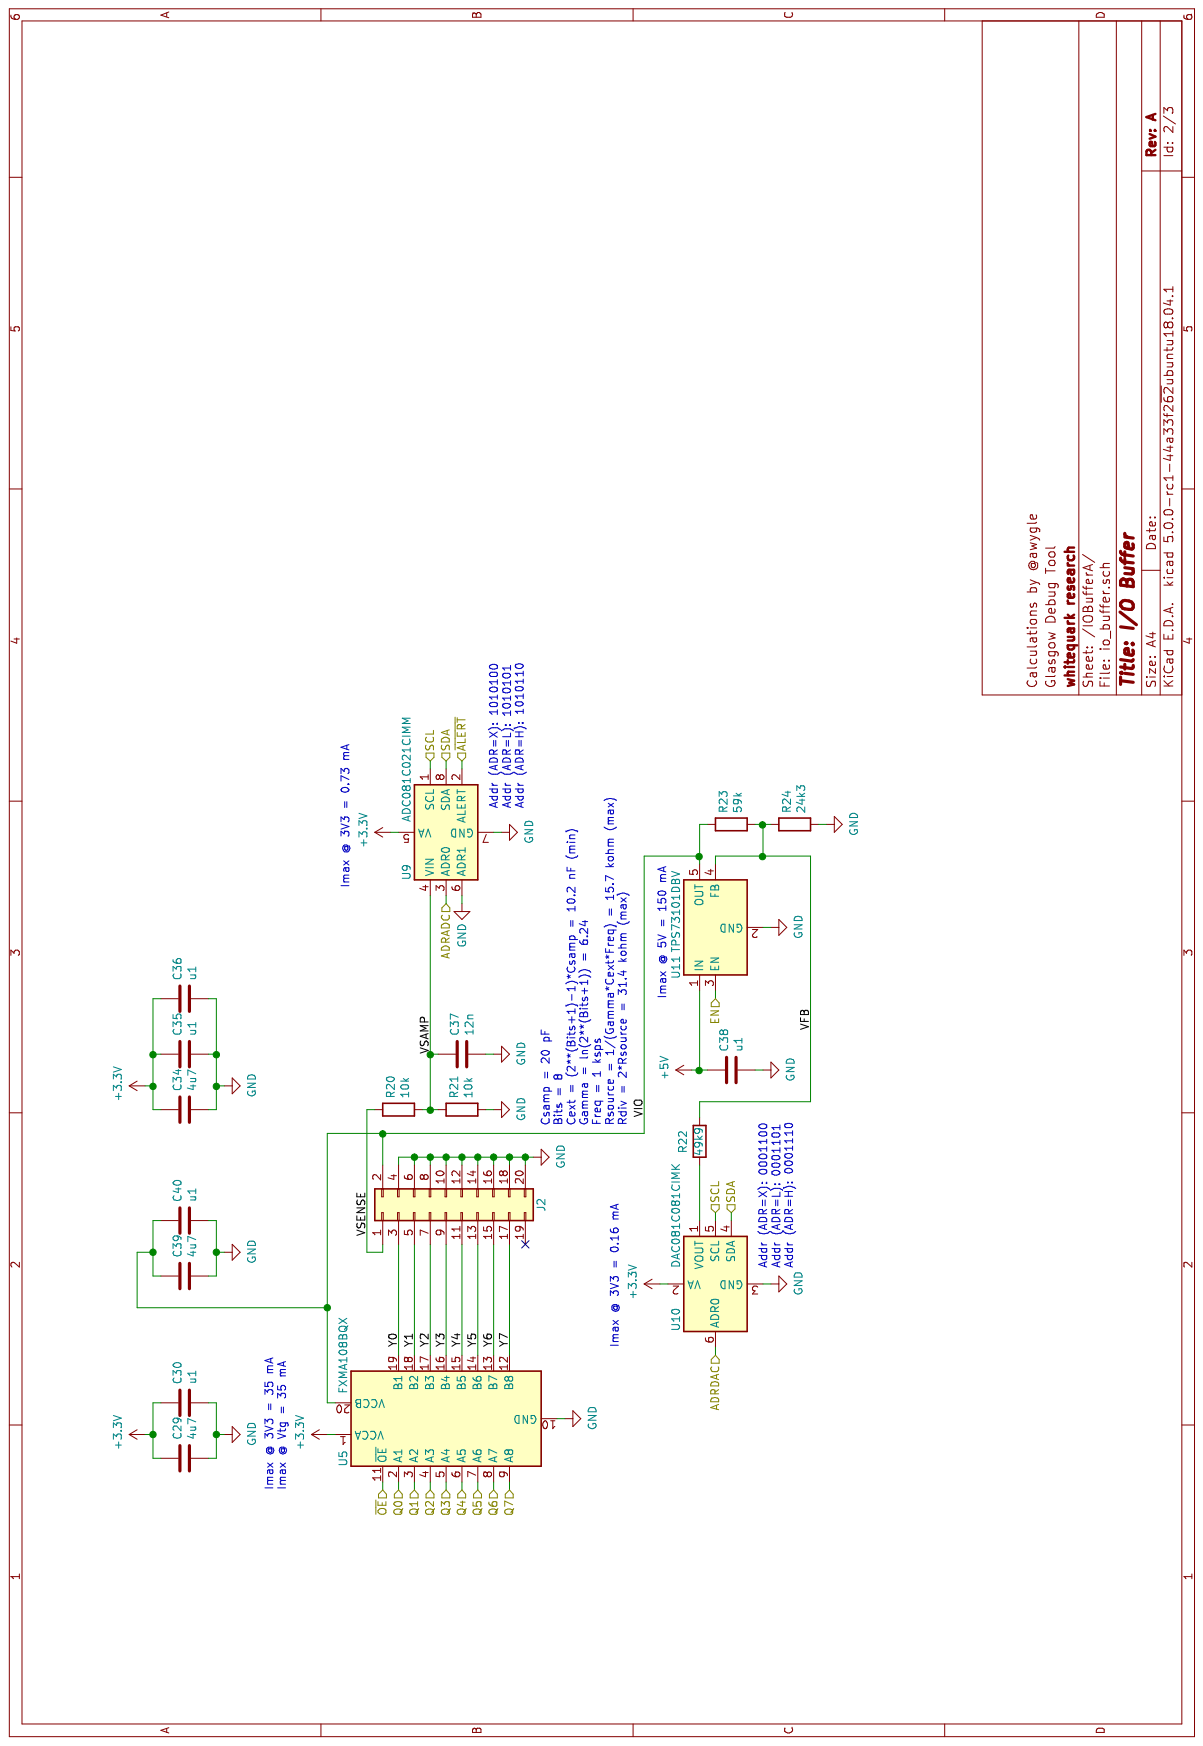
[picture p82: page 2]

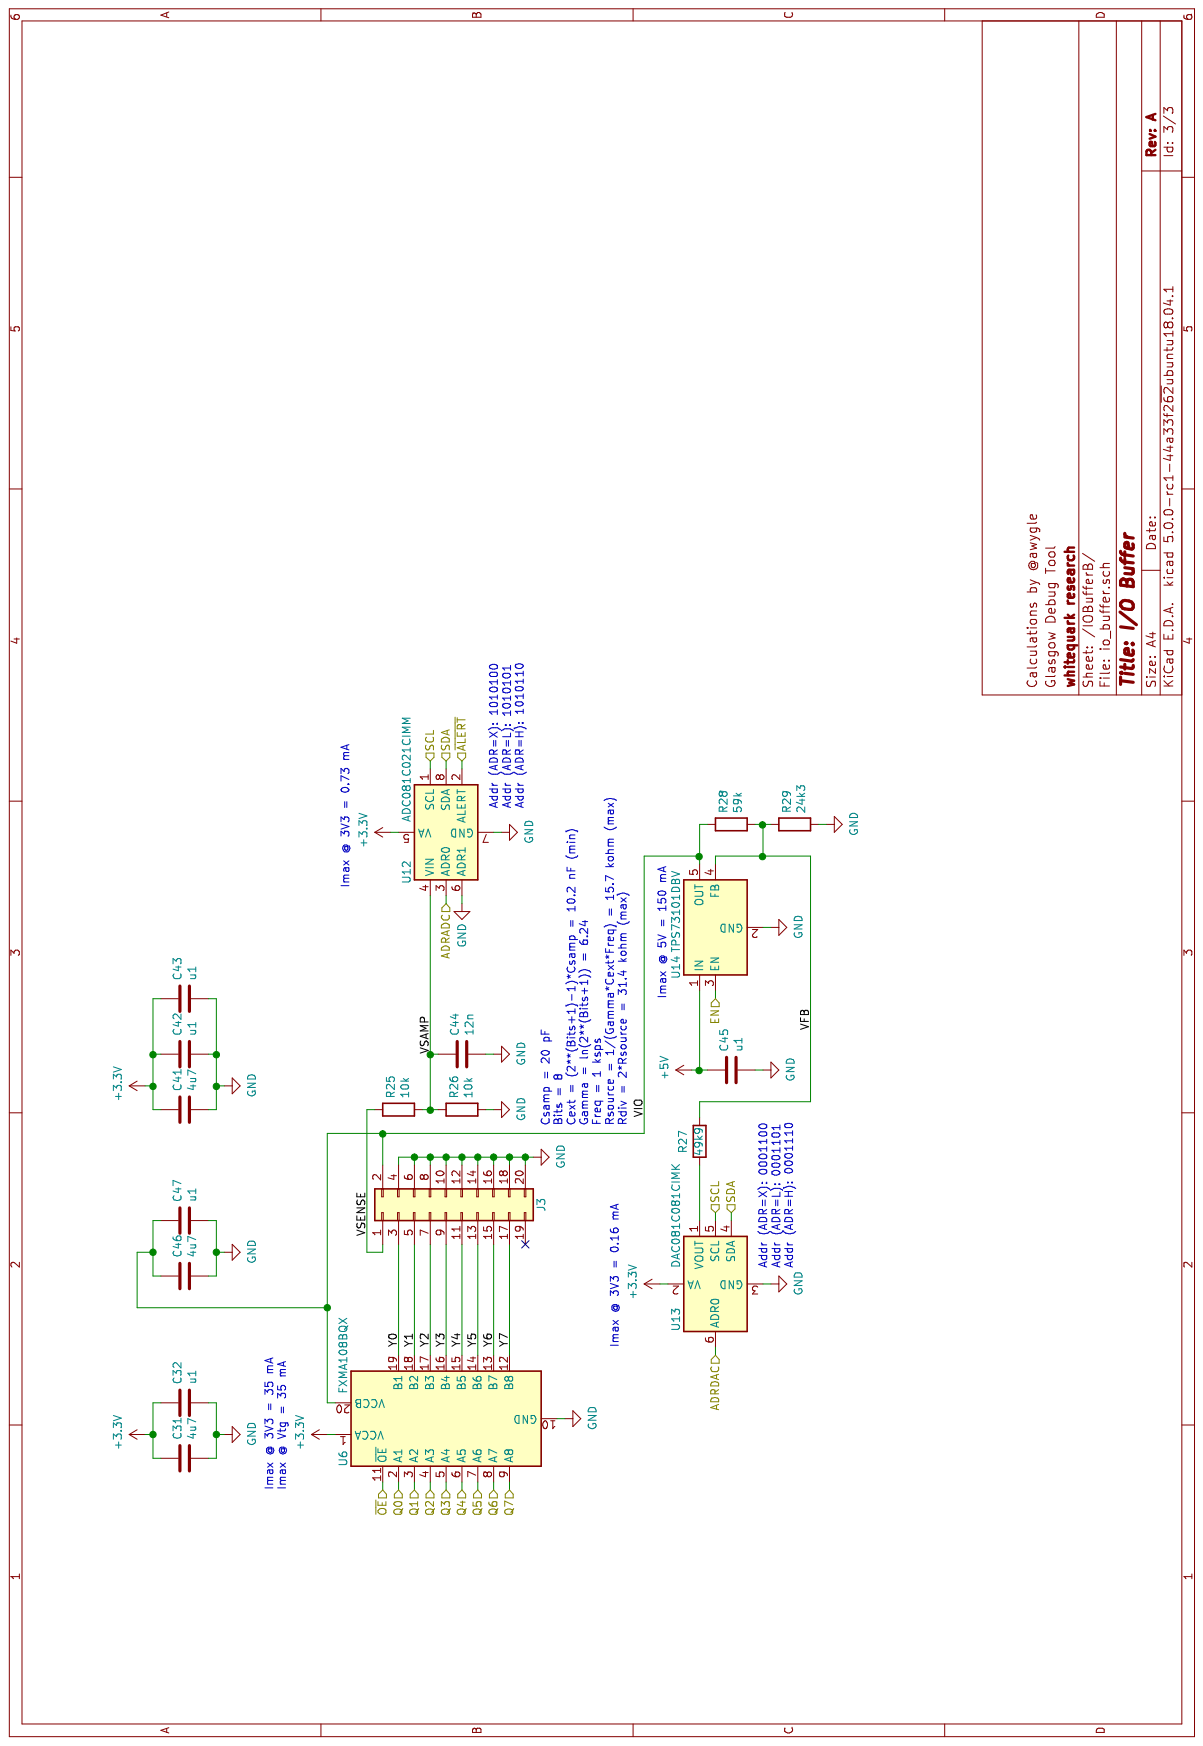
[picture p83: page 3]
