GlasgowEmbedded/glasgow/hardware/boards/glasgow/revA/output/fabrication.pdf

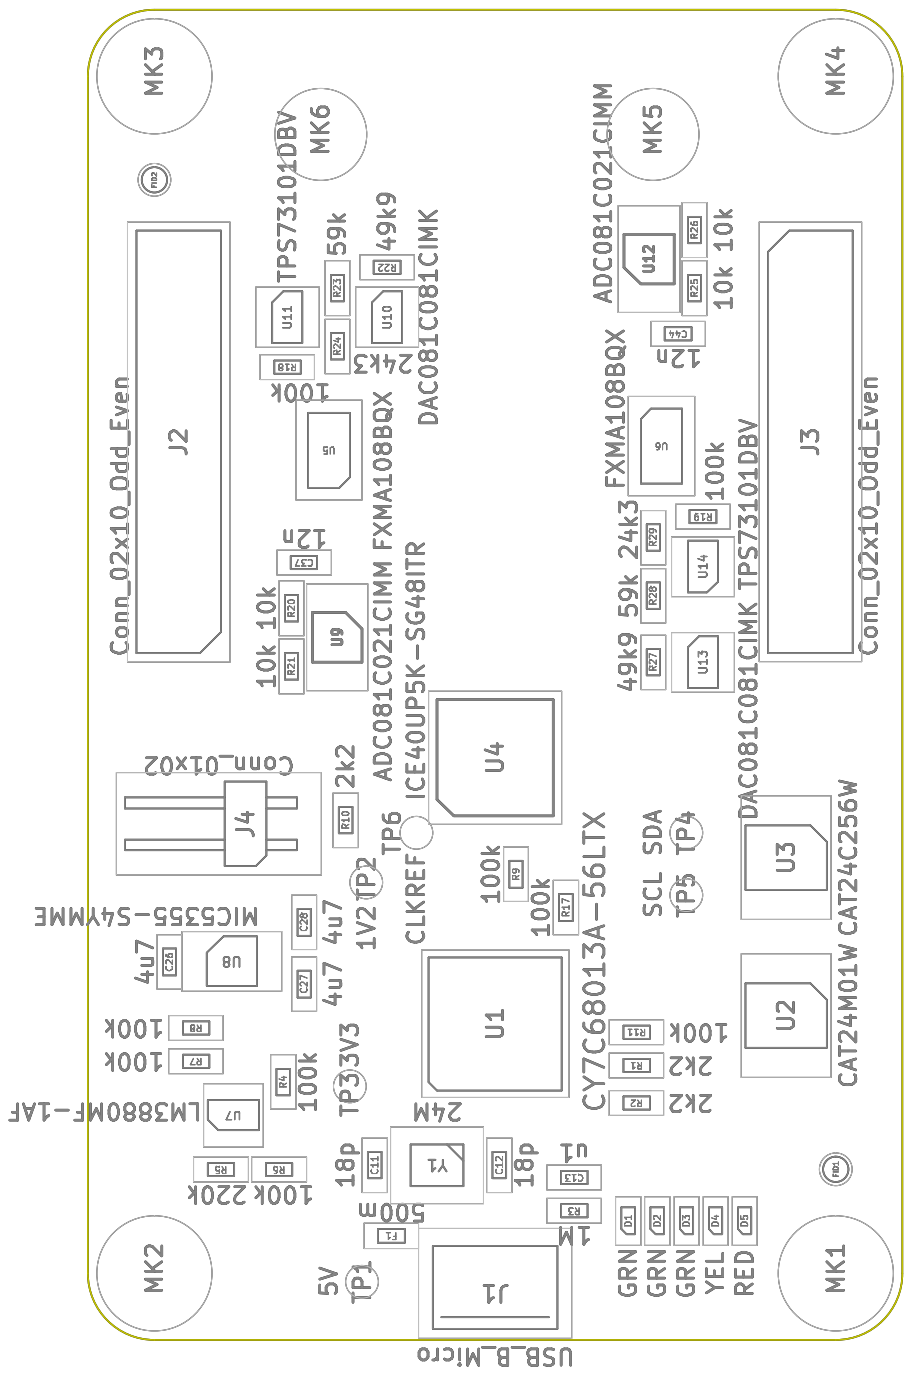
[picture p84: page 1]

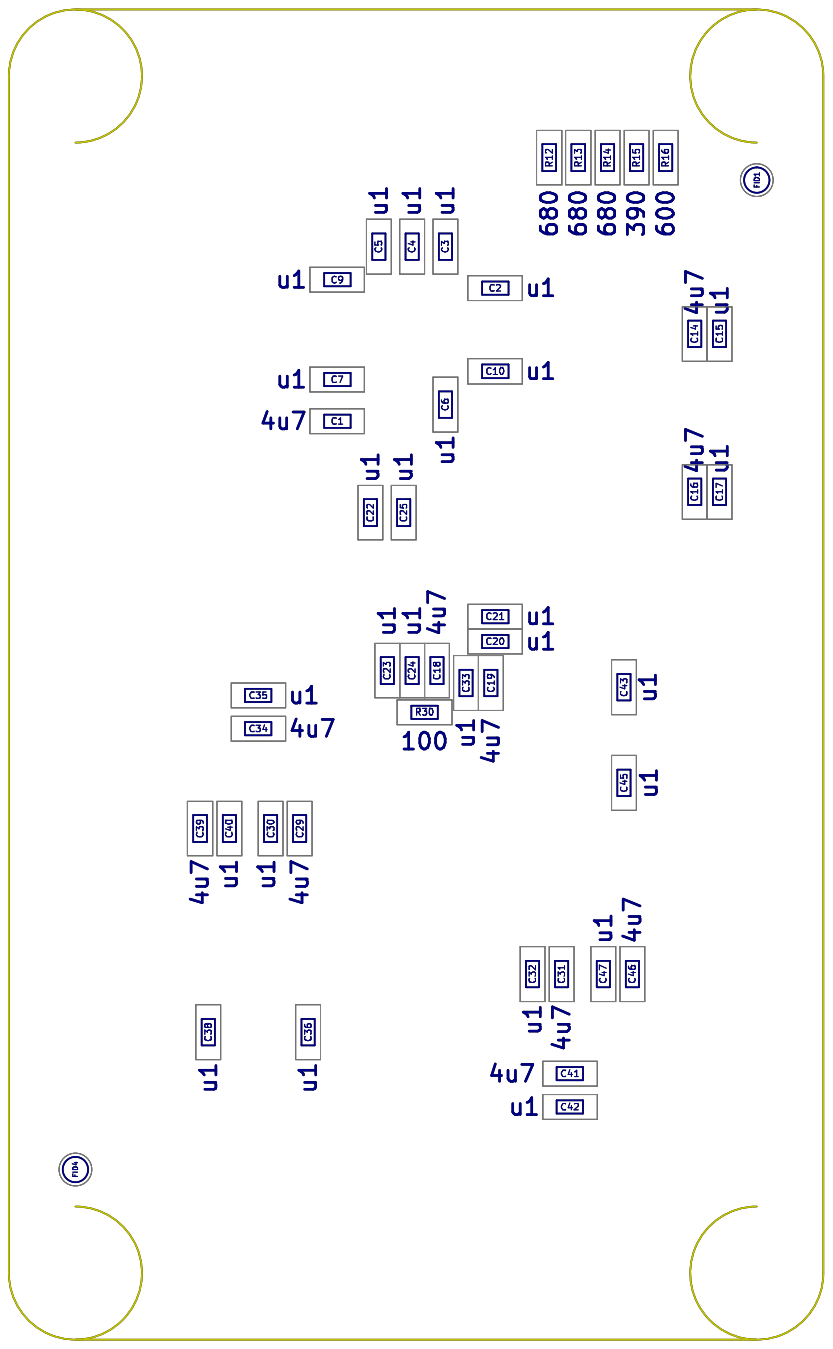
[picture p85: page 2]
