GlasgowEmbedded/glasgow/software/glasgow/hardware/assembly.py

from typing import Any, BinaryIO, override
from collections.abc import Generator
from collections import defaultdict
from contextlib import contextmanager
import os
import asyncio
import dataclasses

from amaranth import *
from amaranth.hdl import ShapeCastable
from amaranth.lib import wiring, io, cdc
from amaranth.vendor import SiliconBluePlatform
from amaranth.build import ResourceError

from ..support import logging
from ..support.logging import dump_hex
from ..support.task_queue import TaskQueue
from ..support.chunked_fifo import ChunkedFIFO
from ..gateware.i2c import I2CTarget
from ..gateware.registers import I2CRegisters
from ..gateware.fx2_crossbar import FX2Crossbar
from ..gateware.stream import Queue
from ..gateware import octoram, pll
from ..abstract import *
from .platform.rev_ab import GlasgowRevABPlatform
from .platform.rev_c import GlasgowRevC0Platform, GlasgowRevC123Platform
from .platform.rev_d import GlasgowRevD0Platform
from .toolchain import find_toolchain
from .build_plan import GlasgowBuildPlan
from .device import GlasgowDevice


__all__ = ["HardwareAssembly"]


logger = logging.getLogger(__name__)


# On Linux, the total amount of in-flight USB requests for the entire system is limited
# by usbfs_memory_mb parameter of the module usbcore; it is 16 MB by default. This
# limitation was introduced in commit add1aaeabe6b08ed26381a2a06e505b2f09c3ba5, with
# the following (bullshit) justification:
#
#   While it is generally a good idea to avoid large transfer buffers
#   (because the data has to be bounced to/from a contiguous kernel-space
#   buffer), it's not the kernel's job to enforce such limits.  Programs
#   should be allowed to submit URBs as large as they like; if there isn't
#   sufficient contiguous memory available then the submission will fail
#   with a simple ENOMEM error.
#
#   On the other hand, we would like to prevent programs from submitting a
#   lot of small URBs and using up all the DMA-able kernel memory. [...]
#
# In other words, there is a platform-specific limit for USB I/O size, which is not discoverable
# via libusb, and hitting which does not result in a sensible error returned  from libusb
# (it returns LIBUSB_ERROR_IO even though USBDEVFS_SUBMITURB ioctl correctly returns -ENOMEM),
# so it is not even possible to be optimistic and back off after hitting it.
#
# To deal with this, use requests of at most 1024 EP buffer sizes (512 KiB with the FX2) as
# an arbitrary cutoff, and hope for the best.
_max_packets_per_ep = 4096

# USB has the limitation that all transactions are host-initiated. Therefore, if we do not queue
# reads for the IN endpoints quickly enough, the HC will not even poll the device, and the buffer
# will quickly overflow (provided it is being filled with data). To address this, we issue many
# pipelined reads, to compensate for the non-realtime nature of Python and the host OS.
#
# This, however, has an inherent tradeoff. If we submit small reads (down to a single EP buffer
# size), we get the data back as early as possible, but the CPU load is much higher, and we have
# to submit many more buffers to tolerate the same amount of scheduling latency. If we submit large
# reads, it's much easier to service the device quickly enough, but the maximum latency of reads
# rises.
#
# The relationship between buffer size and latency is quite complex. If only one 512-byte buffer
# is available but a 10240-byte read is requested, the read will finish almost immediately with
# those 512 bytes. On the other hand, if 20 512-byte buffers are available and the HC can read one
# each time it sends an IN token, they will all be read before the read finishes; if we request
# a read of dozens of megabytes, this can take seconds.
#
# To try and balance these effects, we choose a medium buffer size that should work well with most
# applications. It's possible that this will need to become customizable later, but for now
# a single fixed value works.
_packets_per_xfer = 128

# Queue as many transfers as we can, but no more than 16, as the returns beyond that point
# are diminishing.
_xfers_per_queue = min(32, _max_packets_per_ep // _packets_per_xfer)


class HardwareRORegister(AbstractRORegister):
    def __init__(self, logger, parent, address, *, shape=None, name=None):
        self._logger  = logger
        self._parent  = parent
        self._address = address
        self._shape   = shape
        self._name    = name or f"{address:#x}"
        self._width   = (Shape.cast(self._shape).width + 7) // 8

    async def get(self):
        value = await self._parent.device.read_register(self._address, self._width)
        if isinstance(self._shape, ShapeCastable):
            value = self._shape.from_bits(value)
        return value

    @property
    def shape(self):
        return self._shape


class HardwareRWRegister(HardwareRORegister, AbstractRWRegister):
    async def set(self, value):
        if isinstance(self._shape, ShapeCastable):
            value = Const.cast(self._shape.const(value)).value
        await self._parent.device.write_register(self._address, value, self._width)


def _check_detach():
    # See the comment in `HardwareAssembly.start()`.
    if os.name == "nt":
        raise NotImplementedError(
            "pipe detaching is not supported on Windows due to WinUSB limitations")


class HardwareInPipe(AbstractInPipe):
    def __init__(self, logger, parent, *, buffer_size=None):
        self._logger            = logger
        self._parent            = parent

        self._in_interface      = -1 # allocated later
        self._in_alt_setting    = 1
        self._in_ep_address     = -1
        self._in_packet_size    = -1

        self._in_running        = False
        self._in_buffer_size    = buffer_size
        self._in_pushback       = asyncio.Condition()
        self._in_tasks          = TaskQueue()
        self._in_buffer         = ChunkedFIFO()
        self._in_stalls         = 0

    async def _attach(self):
        await self._parent.device.usb_device.claim_interface(self._in_interface)

    async def _start(self):
        assert not self._in_running
        self._logger.trace(f"IN pipe {self._in_interface}: starting "
            f"(alt-setting {self._in_alt_setting})")
        await self._parent.device.usb_device.select_alternate_interface(self._in_interface,
            self._in_alt_setting)
        for _ in range(_xfers_per_queue):
            self._in_tasks.submit(self._in_task())
        self._in_running = True

    async def _stop(self):
        if not self._in_running:
            return
        self._logger.trace(f"IN pipe {self._in_interface}: stopping")
        await self._in_tasks.cancel()
        self._in_buffer.clear()
        await self._parent.device.usb_device.select_alternate_interface(self._in_interface, 0)
        self._in_running = False

    async def _in_task(self):
        if self._in_buffer_size is not None:
            async with self._in_pushback:
                while len(self._in_buffer) > self._in_buffer_size:
                    self._logger.trace(f"IN pipe {self._in_interface}: read pushback")
                    await self._in_pushback.wait()

        size = self._in_packet_size * _packets_per_xfer
        data = await self._parent.device.bulk_read(self._in_ep_address, size)
        self._in_buffer.write(data)

        self._in_tasks.submit(self._in_task())

    @property
    def readable(self) -> int:
        return len(self._in_buffer)

    async def recv(self, length) -> memoryview:
        assert length > 0

        # Return exactly the requested length.
        while len(self._in_buffer) < length:
            self._logger.trace(f"IN pipe {self._in_interface}: need %d bytes",
                length - len(self._in_buffer))
            self._in_stalls += 1
            assert self._in_tasks
            await self._in_tasks.wait_one()

        async with self._in_pushback:
            result = self._in_buffer.read(length)
            self._in_pushback.notify_all()

        if len(result) < length:
            chunks  = [result]
            length -= len(result)
            while length > 0:
                async with self._in_pushback:
                    chunk = self._in_buffer.read(length)
                    self._in_pushback.notify_all()
                chunks.append(chunk)
                length -= len(chunk)
            # Always return a memoryview object, to avoid hard to detect edge cases downstream.
            result = memoryview(b"".join(chunks))

        self._logger.trace(f"IN pipe {self._in_interface}: read <%s>", dump_hex(result))
        return result

    async def recv_until(self, delimiter) -> bytes:
        assert len(delimiter) >= 1

        self._logger.trace(f"IN pipe {self._in_interface}: need <%s> delimiter",
            dump_hex(delimiter))

        chunks = []
        while True:
            while len(self._in_buffer) == 0:
                self._in_stalls += 1
                assert self._in_tasks
                await self._in_tasks.wait_one()

            async with self._in_pushback:
                chunk = self._in_buffer.read_until(delimiter)
                self._in_pushback.notify_all()

            chunks.append(chunk)
            if chunk[-len(delimiter):] == delimiter:
                break

        result = b"".join(chunks)
        self._logger.trace(f"IN pipe {self._in_interface}: read <%s>", dump_hex(result))
        return result

    async def reset(self):
        self._logger.trace(f"IN pipe {self._in_interface}: reset")
        await self._stop()
        await self._start()

    async def detach(self) -> tuple[int, None]:
        self._logger.trace(f"IN pipe {self._in_interface}: detaching")
        _check_detach()
        await self._stop()
        await self._parent.device.usb_device.release_interface(self._in_interface)
        return self._in_interface, None

    def statistics(self):
        self._logger.info(f"IN pipe {self._in_interface} statistics:")
        self._logger.info("  total   : %d B",   self._in_buffer.total_read_bytes)
        self._logger.info("  waited  : %.3f s", self._in_tasks.total_wait_time)
        self._logger.info("  stalls  : %d",     self._in_stalls)
        self._logger.info("  wakeups : %d",     self._in_tasks.total_wait_count)


class HardwareOutPipe(AbstractOutPipe):
    def __init__(self, logger, parent, *, buffer_size=None):
        self._logger            = logger
        self._parent            = parent

        self._out_interface     = -1 # allocated later
        self._out_alt_setting   = 1
        self._out_ep_address    = -1
        self._out_packet_size   = -1

        self._out_running       = False
        self._out_buffer_size   = buffer_size
        self._out_inflight      = 0
        self._out_tasks         = TaskQueue()
        self._out_buffer        = ChunkedFIFO()
        self._out_stalls        = 0

    async def _attach(self):
        await self._parent.device.usb_device.claim_interface(self._out_interface)

    async def _start(self):
        assert not self._out_running
        self._logger.trace(f"OUT pipe {self._out_interface}: starting "
            f"(alt-setting {self._out_alt_setting})")
        await self._parent.device.usb_device.select_alternate_interface(self._out_interface,
            self._out_alt_setting)
        self._out_running = True

    async def _stop(self):
        if not self._out_running:
            return
        self._logger.trace(f"OUT pipe {self._out_interface}: clearing")
        await self._out_tasks.cancel()
        self._out_buffer.clear()
        await self._parent.device.usb_device.select_alternate_interface(self._out_interface, 0)
        self._out_running = False

    def _out_slice(self):
        # Fast path: read as much contiguous data as possible, up to our transfer size.
        size = self._out_packet_size * _packets_per_xfer
        data = self._out_buffer.read(size)

        if len(data) < self._out_packet_size:
            # Slow path: USB is very inefficient with small packets, so if we only got a few
            # bytes from the FIFO, and there is more in it, spend CPU time to aggregate that
            # into a larger transfer, as this is likely to result in overall speedup.
            data = bytearray(data)
            while len(data) < self._out_packet_size and self._out_buffer:
                data += self._out_buffer.read(self._out_packet_size - len(data))

        self._out_inflight += len(data)
        return data

    @property
    def _out_threshold(self):
        out_xfer_size = self._out_packet_size * _packets_per_xfer
        if self._out_buffer_size is None:
            return out_xfer_size
        else:
            return min(self._out_buffer_size, out_xfer_size)

    async def _out_task(self, data):
        assert len(data) > 0

        try:
            await self._parent.device.bulk_write(self._out_ep_address, data)
        finally:
            self._out_inflight -= len(data)

        # See the comment in `write` below for an explanation of the following code.
        if len(self._out_buffer) >= self._out_threshold:
            self._out_tasks.submit(self._out_task(self._out_slice()))

    @property
    def writable(self) -> int | None:
        if self._out_buffer_size is None:
            return None
        return self._out_buffer_size - self._out_inflight

    async def send(self, data):
        if self._out_buffer_size is not None:
            # If write buffer is bounded, and the combined size of said buffer and all inflight
            # requests is greater than the configured size, then wait until the combined size is
            # less than the configured size.
            if self._out_inflight + len(self._out_buffer) >= self._out_buffer_size:
                self._out_stalls += 1
            while self._out_inflight + len(self._out_buffer) >= self._out_buffer_size:
                self._logger.trace(f"OUT pipe {self._out_interface}: write pushback")
                await self._out_tasks.wait_one()

        # Eagerly check if any of our previous queued writes errored out.
        await self._out_tasks.poll()

        self._logger.trace(f"OUT pipe {self._out_interface}: write <%s>", dump_hex(data))
        self._out_buffer.write(data)

        # The write scheduling algorithm attempts to satisfy several partially conflicting goals:
        #  * We want to schedule writes as early as possible, because this reduces buffer bloat and
        #    can dramatically improve responsiveness of the system.
        #  * We want to schedule writes that are as large as possible, up to _packets_per_xfer,
        #    because this reduces CPU utilization and improves latency.
        #  * We never want to automatically schedule writes smaller than _out_packet_size,
        #    because they occupy a whole microframe anyway.
        #
        # We use an approach that performs well when fed with a steady sequence of very large
        # FIFO chunks, yet scales down to packet-size and byte-size FIFO chunks as well.
        #  * We only submit a write automatically once the buffer level crosses the threshold of
        #    `_out_packet_size * _packets_per_xfer`. In this case, _slice_packet always returns
        #    `_out_packet_size * n` bytes, where n is between 1 and _packet_per_xfer.
        #  * We submit enough writes that there is at least one write for each transfer worth
        #    of data in the buffer, up to _xfers_per_queue outstanding writes.
        #  * We submit another write once one finishes, if the buffer level is still above
        #    the threshold, even if no more explicit write calls are performed.
        #
        # This provides predictable write behavior; only _packets_per_xfer packet writes are
        # automatically submitted, and only the minimum necessary number of tasks are scheduled on
        # calls to `write`.
        while len(self._out_tasks) < _xfers_per_queue and \
                    len(self._out_buffer) >= self._out_threshold:
            self._out_tasks.submit(self._out_task(self._out_slice()))

    # TODO: we should not in principle need `_wait=False` as flushes of large batches of data
    # should happen automatically as data is sent
    async def flush(self, *, _wait=True):
        self._logger.trace(f"OUT pipe {self._out_interface}: flush")

        # First, we ensure we can submit one more task. (There can be more tasks than
        # _xfers_per_queue because a task may spawn another one just before it terminates.)
        if len(self._out_tasks) >= _xfers_per_queue:
            self._out_stalls += 1
        while len(self._out_tasks) >= _xfers_per_queue:
            await self._out_tasks.wait_one()

        # At this point, the buffer can contain at most _packets_per_xfer packets worth
        # of data, as anything beyond that crosses the threshold of automatic submission.
        # So, we can simply submit the rest of data, which by definition fits into a single
        # transfer.
        assert len(self._out_buffer) <= self._out_packet_size * _packets_per_xfer
        if self._out_buffer:
            data = bytearray()
            while self._out_buffer:
                data += self._out_buffer.read()
            self._out_inflight += len(data)
            self._out_tasks.submit(self._out_task(data))

        if _wait:
            self._logger.trace(f"OUT pipe {self._out_interface}: wait for flush")
            if self._out_tasks:
                self._out_stalls += 1
            while self._out_tasks:
                await self._out_tasks.wait_all()

    async def reset(self):
        self._logger.trace(f"OUT pipe {self._out_interface}: reset")
        await self._stop()
        await self._start()

    async def detach(self) -> tuple[None, int]:
        self._logger.trace(f"OUT pipe {self._out_interface}: detaching")
        _check_detach()
        await self._stop()
        await self._parent.device.usb_device.release_interface(self._out_interface)
        return None, self._out_interface

    def statistics(self):
        self._logger.info(f"OUT pipe {self._out_interface} statistics:")
        self._logger.info("  total   : %d B",   self._out_buffer.total_written_bytes)
        self._logger.info("  waited  : %.3f s", self._out_tasks.total_wait_time)
        self._logger.info("  stalls  : %d",     self._out_stalls)
        self._logger.info("  wakeups : %d",     self._out_tasks.total_wait_count)


class HardwareInOutPipe(HardwareInPipe, HardwareOutPipe, AbstractInOutPipe):
    def __init__(self, logger, parent, *, in_buffer_size, out_buffer_size):
        HardwareInPipe.__init__(self, logger, parent, buffer_size=in_buffer_size)
        HardwareOutPipe.__init__(self, logger, parent, buffer_size=out_buffer_size)

    def statistics(self):
        HardwareInPipe.statistics(self)
        HardwareOutPipe.statistics(self)

    async def _attach(self):
        await HardwareInPipe._attach(self)
        await HardwareOutPipe._attach(self)

    async def _start(self):
        await HardwareInPipe._start(self)
        await HardwareOutPipe._start(self)

    async def _stop(self):
        await HardwareInPipe._stop(self)
        await HardwareOutPipe._stop(self)

    async def reset(self):
        self._logger.trace(f"IN/OUT pipe {self._in_interface}/{self._out_interface}: reset")
        await self._stop()
        await self._start()

    async def detach(self) -> tuple[int, int]:
        self._logger.trace(f"IN/OUT pipe {self._in_interface}/{self._out_interface}: detaching")
        _check_detach()
        await self._stop()
        return self._in_interface, self._out_interface


class HardwareAssembly(AbstractAssembly):
    _HEALTH_ADDR   = 0x00
    _PIPE_RST_ADDR = 0x01
    _ALERTS_ADDR   = 0x02
    _1ST_USER_ADDR = _ALERTS_ADDR + 1

    @staticmethod
    def _create_platform(revision: str):
        match revision:
            case "A0" | "B0":
                return GlasgowRevABPlatform()
            case "C0":
                return GlasgowRevC0Platform()
            case "C1" | "C2" | "C3":
                return GlasgowRevC123Platform()
            case "D0":
                return GlasgowRevD0Platform()
            case _:
                assert False, f"invalid revision {revision}"

    @classmethod
    async def find_device(cls, serial: str | None = None) -> "HardwareAssembly":
        return cls(device=await GlasgowDevice.find(serial))

    def __init__(self, *,
            device: GlasgowDevice | None = None,
            revision: str | None = None):
        if device is not None:
            assert revision is None or revision == device.revision
            self._device    = device
            self._revision  = device.revision
        elif revision is not None:
            self._device    = None
            self._revision  = revision
        else:
            raise ValueError("must provide either device or revision")

        self._platform      = self._create_platform(self._revision)
        self._registers     = [] # (register, signal, domain)
        self._domains       = [] # domain
        self._modules       = [] # (domain, elaboratable, name)
        self._in_streams    = [] # (domain, in_stream, in_flush, fifo_depth)
        self._out_streams   = [] # (domain, out_stream, fifo_depth)
        self._pipes         = [] # in_pipe|out_pipe|inout_pipe
        self._memories      = [] # (domain, bus, DRAMOptions)
        self._indicators    = [] # signal
        self._resets        = [] # (signal, when)
        self._voltages      = [] # (port, vio)
        self._pulls         = {} # (port, number): state

        self._logger        = logger
        self._applet        = None
        self._domain        = None

        self._artifact      = None
        self._running       = False

    @property
    def revision(self) -> str:
        return self._revision

    @property
    def sys_clk_period(self) -> float:
        match self._revision:
            case "A0" | "B0":
                return 1/36e6
            case "C0" | "C1" | "C2" | "C3" | "D0":
                return 1/48e6
            case _:
                assert False, f"invalid revision {self._revision}"

    @contextmanager
    def add_applet(self, applet: Any) -> Generator[None]:
        assert self._applet is None

        self._logger = applet.logger
        self._applet = applet
        self._domain = ClockDomain(f"applet{len(self._domains)}")
        self._domains.append(self._domain)
        try:
            yield
        finally:
            self._logger = logger
            self._applet = None
            self._domain = None

    @property
    def _current_logger(self) -> logging.Logger:
        assert self._logger is not None
        return self._logger

    def add_platform_pin(self, pin: GlasgowPin, port_name: str) -> io.PortLike:
        assert self._artifact is None, "cannot add a port to a sealed assembly"
        # TODO: make this a proper error and not an assertion
        pin_name = f"{pin.port}{pin.number}"
        assert pin_name in self._platform.glasgow_pins, f"unknown or already used pin {pin_name}"
        self._current_logger.debug("assigning pin %s to %s%s", port_name, pin_name,
            " (inverted)" if pin.invert else "")
        if (pin.port, pin.number) not in self._pulls:
            self._pulls[pin.port, pin.number] = PullState.Float
        port = self._platform.glasgow_pins.pop(pin_name)
        return ~port if pin.invert else port

    def add_submodule[E: Elaboratable](self, elaboratable: E, *, name: str | None = None) -> E:
        assert self._artifact is None, "cannot add a submodule to a sealed assembly"
        self._modules.append((self._domain, elaboratable, name))
        elaboratable._MustUse__used = True
        return elaboratable

    def add_ro_register(self, signal) -> AbstractRORegister:
        assert self._artifact is None, "cannot add a register to a sealed assembly"
        register = HardwareRORegister(self._current_logger, self,
            address=self._1ST_USER_ADDR + len(self._registers), shape=signal.shape(),
            name=Value.cast(signal).name)
        self._registers.append((register, signal, self._domain))
        return register

    def add_rw_register(self, signal) -> AbstractRWRegister:
        assert self._artifact is None, "cannot add a register to a sealed assembly"
        register = HardwareRWRegister(self._current_logger, self,
            address=self._1ST_USER_ADDR + len(self._registers), shape=signal.shape(),
            name=Value.cast(signal).name)
        self._registers.append((register, signal, self._domain))
        return register

    def add_in_pipe(self, in_stream, *, in_flush=C(0),
                    fifo_depth=None, buffer_size=None) -> AbstractInPipe:
        assert self._artifact is None, "cannot add a pipe to a sealed assembly"
        in_pipe = HardwareInPipe(self._current_logger, self, buffer_size=buffer_size)
        self._in_streams.append((self._domain, in_stream, in_flush, fifo_depth))
        self._pipes.append(in_pipe)
        return in_pipe

    def add_out_pipe(self, out_stream, *,
                     fifo_depth=None, buffer_size=None) -> AbstractOutPipe:
        assert self._artifact is None, "cannot add a pipe to a sealed assembly"
        out_pipe = HardwareOutPipe(self._current_logger, self, buffer_size=buffer_size)
        self._out_streams.append((self._domain, out_stream, fifo_depth))
        self._pipes.append(out_pipe)
        return out_pipe

    def add_inout_pipe(self, in_stream, out_stream, *, in_flush=C(0),
                       in_fifo_depth=None, in_buffer_size=None,
                       out_fifo_depth=None, out_buffer_size=None) -> AbstractInOutPipe:
        assert self._artifact is None, "cannot add a pipe to a sealed assembly"
        inout_pipe = HardwareInOutPipe(self._current_logger, self,
            in_buffer_size=in_buffer_size, out_buffer_size=out_buffer_size)
        self._in_streams.append((self._domain, in_stream, in_flush, in_fifo_depth))
        self._out_streams.append((self._domain, out_stream, out_fifo_depth))
        self._pipes.append(inout_pipe)
        return inout_pipe

    @override
    def add_dynamic_memory(self, options=DRAMOptions()) -> tuple[octoram.Signature, range]:
        if options.size is None:
            options = dataclasses.replace(options, size=64 * 0x100000)
        assert self._artifact is None, "cannot add a dynamic memory to a sealed assembly"
        assert self._revision >= "C0", "DRAM is not available prior to revision D0"
        assert len(self._memories) < 2, "only two memory channels are available"
        assert options.size <= 64 * 0x100000, "memory size must be no more than 64 MB"
        self._current_logger.debug(f"allocating DRAM channel {len(self._memories)}")
        bus = octoram.Signature().flip().create()
        self._memories.append((self._domain, bus, options))
        # In the future we will likely allow sharing memories; for now this is not available so
        # the entire chip is allocated to one applet.
        return bus, range(options.size)

    def add_indicator(self, signal: Signal, *, name: str):
        self._current_logger.info("assigning indicator %r to U%d", name, len(self._indicators) + 1)
        self._indicators.append(signal)

    def set_port_voltage(self, port: GlasgowPort, vio: GlasgowVio):
        self._current_logger.debug("setting port %s voltage to %s V", port, vio)
        self._voltages.append((port, vio))

    def set_pin_pull(self, pin: GlasgowPin, state: PullState):
        if pin.invert:
            state = ~state
        if state.enabled():
            self._current_logger.debug("pulling pin %s%s %s%s",
                pin.port, pin.number, state, " (was inverted)" if pin.invert else "")
        self._pulls[pin.port, pin.number] = state

    def artifact(self):
        if self._artifact is not None:
            return self._artifact

        m = Module()

        i2c_pins = self._platform.request("i2c", dir={"scl": "-", "sda": "-"})
        fx2_pins = self._platform.request("fx2", dir={
            "sloe": "-", "slrd": "-", "slwr": "-", "pktend": "-", "fifoadr": "-",
            "flag": "-", "fd": "-"
        })

        if self._revision >= "D0":
            afe_mcu_pins = self._platform.request("afe_mcu", dir={"reset": "-"})
            m.submodules.afe_mcu_reset = afe_mcu_reset = io.Buffer("o", afe_mcu_pins.reset)
            m.d.comb += afe_mcu_reset.oe.eq(0)

        m.submodules.i2c_target = i2c_target = I2CTarget(i2c_pins)
        m.submodules.i2c_registers = i2c_registers = I2CRegisters(i2c_target)
        m.d.comb += i2c_target.address.eq(0b0001000)

        # always add a register at address 0x00, to be able to check that the FPGA configuration
        # succeeded and that I2C communication works; some 1b2 production devices fail this check
        health_addr = i2c_registers.add_existing_ro(C(0xa5, 8))
        assert health_addr == self._HEALTH_ADDR

        # always add a per-FX2-endpoint pipe reset register at address 0x01
        pipe_rst, pipe_rst_addr = i2c_registers.add_rw(4, init=0b1111)
        assert pipe_rst_addr == self._PIPE_RST_ADDR

        # always add an alert (essentially, interrupt) register at address 0x02
        alerts, alerts_addr = i2c_registers.add_ro(8)
        assert alerts_addr == self._ALERTS_ADDR

        try:
            # Available on revC0+ only.
            alert_pin = self._platform.request("alert", dir="-")
            m.submodules.i2c_alert = i2c_alert = io.Buffer("o", alert_pin)
            m.d.comb += i2c_alert.o.eq(1)
            m.d.comb += i2c_alert.oe.eq(alerts.any())
        except ResourceError:
            pass

        for domain in self._domains:
            m.domains += domain
            m.d.comb += domain.clk.eq(ClockSignal())
            with m.If(ResetSignal(allow_reset_less=True)):
                m.d.comb += domain.rst.eq(1)
            # Applet domain reset is also asserted below, whenever any of the pipes associated with
            # the applet is held in reset.

        for domain, elaboratable, name in self._modules:
            if domain is None:
                m.submodules[name] = elaboratable
            else:
                m.submodules[name] = DomainRenamer(domain.name)(elaboratable)

        for register, signal, domain in self._registers:
            if isinstance(register, HardwareRWRegister):
                register_addr = i2c_registers.add_existing_rw(Value.cast(signal), domain=domain)
            elif isinstance(register, HardwareRORegister):
                register_addr = i2c_registers.add_existing_ro(Value.cast(signal))
            assert register_addr == register._address

        if self._memories and "D0" <= self.revision < "E0":
            # The location constraint should not be needed with new enough nextpnr-ecp5, but is
            # included here as insurance. TODO: remove this once nextpnr-0.11 is used.
            plan = pll.ClockPlan(self.sys_clk_period, location="X70/Y49/EHXPLL_LR")
            m.domains.dram_edge = plan.add_domain(
                pll.ecp5.Channel(period=1/(2*112e6), usage="edge"))
            m.submodules.dram_pll = plan.create(self._platform)

            # See the comment in `octoram.Controller` about ECP5.
            m.domains.dram_sync = ClockDomain(local=True)
            m.submodules.logic_rst = cdc.ResetSynchronizer(ResetSignal(domain.name),
                domain="dram_sync")
            m.submodules.logic_div = Instance("CLKDIVF",
                i_RST=ResetSignal("dram_edge"),
                i_CLKI=ClockSignal("dram_edge"),
                o_CDIVX=ClockSignal("dram_sync"),
            )

            for channel, (domain, mem_bus, options) in enumerate(self._memories):
                mem_ports = self._platform.request("octoram", channel,
                    dir={"cs": "-", "clk": "-", "dq": "-", "dqs": "-"})
                m.submodules[f"mem_ctrl{channel}"] = mem_ctrl = DomainRenamer({
                    "sync": "dram_sync", "edge": "dram_edge",
                })(octoram.Controller(mem_ports, half_rate=False))
                m.d.comb += mem_ctrl.mem_type.eq(octoram.MemoryType.OctalSPI)
                m.d.comb += mem_ctrl.latency.eq(5)
                m.submodules[f"mem_queue{channel}"] = mem_queue = octoram.InterfaceQueue(
                    i_domain=domain.name,
                    o_domain="dram_sync",
                    w_buffer_depth=options.w_buffer_size,
                    r_buffer_depth=options.r_buffer_size,
                )
                wiring.connect(m, mem_queue.o, mem_ctrl.bus)
                wiring.connect(m, wiring.flipped(mem_bus), mem_queue.i)

        elif self._memories and "C0" <= self.revision < "D0":
            if os.getenv("GLASGOW_REVC_DRAM", "no") == "yes":
                logger.warning("DRAM support on revC is experimental, use at your own risk")
            else:
                logger.error("DRAM support on revC is not enabled without GLASGOW_REVC_DRAM=yes")
                os._exit(1)

            self._platform.add_ram_pak_resources()

            plan = pll.ClockPlan(self.sys_clk_period)
            m.domains.dram_sync = plan.add_domain(pll.Channel(period=1/(64e6)))
            m.submodules.dram_pll = plan.create(self._platform)

            for channel, (domain, mem_bus, options) in enumerate(self._memories):
                mem_ports = self._platform.request("octoram", channel,
                    dir={"cs": "-", "clk": "-", "dq": "-", "dqs": "-"})
                m.submodules[f"mem_ctrl{channel}"] = mem_ctrl = DomainRenamer({
                    "sync": "dram_sync",
                })(octoram.Controller(mem_ports, half_rate=True))
                m.d.comb += mem_ctrl.mem_type.eq(octoram.MemoryType.HyperRAM)
                m.d.comb += mem_ctrl.latency.eq(7)
                m.submodules[f"mem_queue{channel}"] = mem_queue = octoram.InterfaceQueue(
                    i_domain=domain.name,
                    o_domain="dram_sync",
                    w_buffer_depth=options.w_buffer_size,
                    r_buffer_depth=options.r_buffer_size,
                )
                wiring.connect(m, mem_queue.o, mem_ctrl.bus)
                wiring.connect(m, wiring.flipped(mem_bus), mem_queue.i)

        elif self._memories:
            assert False, "DRAM not available on this hardware revision"

        m.submodules.fx2_crossbar = fx2_crossbar = FX2Crossbar(fx2_pins)

        for idx, (in_ep, (domain, in_stream, in_flush, depth)) in \
                enumerate(zip(fx2_crossbar.in_eps, self._in_streams)):
            if depth == 0:
                wiring.connect(m, in_ep.data, in_stream)
            else:
                m.submodules[f"in_fifo_{idx}"] = in_fifo = ResetInserter(in_ep.reset)(
                    Queue(shape=8, depth=self.DEFAULT_FIFO_DEPTH if depth is None else depth))
                wiring.connect(m, in_fifo.i, in_stream)
                wiring.connect(m, in_ep.data, in_fifo.o)
            m.d.comb += in_ep.flush.eq(in_flush)
            m.d.comb += in_ep.reset.eq(pipe_rst[2 + idx])
            if domain is not None:
                with m.If(in_ep.reset):
                    m.d.comb += domain.rst.eq(1)

        for idx, (out_ep, (domain, out_stream, depth)) in \
                enumerate(zip(fx2_crossbar.out_eps, self._out_streams)):
            if depth == 0:
                wiring.connect(m, out_stream, out_ep.data)
            else:
                m.submodules[f"out_fifo_{idx}"] = out_fifo = ResetInserter(out_ep.reset)(
                    Queue(shape=8, depth=self.DEFAULT_FIFO_DEPTH if depth is None else depth))
                wiring.connect(m, out_fifo.i, out_ep.data)
                wiring.connect(m, out_stream, out_fifo.o)
            m.d.comb += out_ep.reset.eq(pipe_rst[idx])
            if domain is not None:
                with m.If(out_ep.reset):
                    m.d.comb += domain.rst.eq(1)

        for index, led_value in enumerate(self._indicators):
            try:
                led_port = self._platform.request("led", index, dir="-")
                m.submodules[f"led{index}"] = led_buffer = io.Buffer("o", led_port)
                m.d.comb += led_buffer.o.eq(led_value)
            except ResourceError:
                logger.error("ran out of LEDs to use for indicator display")
                break

        # /!\ IMPORTANT /!\
        # tie off output enables of unused pins to zero, or they will strongly drive high
        for idx, unused_pins in enumerate(self._platform.glasgow_pins.values()):
            m.submodules[f"unused_pin_{idx}"] = io.Buffer("io", unused_pins)

        try:
            # See note in `rev_c.py`.
            unused_balls = self._platform.request("unused", dir="-")
            m.submodules["unused_balls"] = io.Buffer("io", unused_balls)
        except ResourceError:
            pass

        toolchain = find_toolchain(tools=self._platform.required_tools)
        # nextpnr-ecp5 *must* include commit `7c667eeba362a8538396f9c4dc9bd1a168b35fa3`, or any
        # applet that uses IO gearboxes will be broken due to PLL placement issues.
        toolchain.assert_version("nextpnr-ecp5", ("0", "10", "88"))

        match self._platform:
            case SiliconBluePlatform():
                # TODO: https://github.com/GlasgowEmbedded/glasgow/issues/1203
                nextpnr_opts = "--placer heap --no-promote-globals"
            case _:
                nextpnr_opts = "--placer heap"

        build_plan = self._platform.prepare(m,
            # always emit complete build log to stdout; whether it's displayed is controlled by
            # the usual logging options, e.g. `-vv` or `-v -F build`
            verbose=True,
            # don't invalidate cache if all that's changed is the location of a Signal; nobody
            # really looks at the RTLIL src attributes anyway
            emit_src=False,
            # latest yosys and nextpnr versions default to this configuration, but we support some
            # older ones in case yowasp isn't available and this keeps the configuration consistent
            synth_opts="-abc9",
            nextpnr_opts=nextpnr_opts,
        )
        product_name = self._platform.bitstream_filename("top")
        self._artifact = GlasgowBuildPlan(build_plan, toolchain, product_name)
        return self._artifact

    @property
    def device(self) -> GlasgowDevice:
        if not self._running:
            raise RuntimeError("runtime features may be used only while a bitstream is loaded")
        assert self._device is not None
        return self._device

    async def configure_ports(self):
        for port, vio in self._voltages:
            if vio.sense is not None:
                assert port != GlasgowPort.ALL
                sensed = await self.device.mirror_voltage(str(port), str(vio.sense))
                logger.info(
                    "port %s voltage set to %.1f V (sensed on port %s)", port, sensed, vio.sense)
            if vio.value is not None:
                spec = self.device.all_ports if port == GlasgowPort.ALL else str(port)
                await self.device.set_voltage(spec, vio.value)
                logger.info("port %s voltage set to %.1f V", port, vio.value)

        port_pulls = defaultdict(lambda: (set(), set()))
        for (port, number), state in self._pulls.items():
            low, high = port_pulls[port]
            match state:
                case PullState.Low:  low .add(number)
                case PullState.High: high.add(number)
        for port, (low, high) in port_pulls.items():
            if not low and not high:
                continue
            if self._revision < "D0":
                # revC powers the level shifters from Vio; revD uses a special clamping circuit
                # to avoid having them fall off the bus when Vio is off.
                voltage = await self.device.get_voltage(str(port))
                if voltage == 0.0:
                    logger.error("cannot configure pulls for port %s: Vio is off", port)
                    continue
            await self.device.set_pulls(str(port), low, high)

    @property
    def _iface_count(self):
        # TODO: this isn't really accurate, but requires rework of the firmware to fix
        return max(len(self._in_streams), len(self._out_streams))

    async def __aenter__(self):
        return await self.start()

    async def start(self, device: GlasgowDevice | None = None, *,
                    reload_bitstream: bool = False, _bitstream_file: BinaryIO | None = None):
        assert not self._running, "only a stopped assembly can be started"

        if self._device is None:
            self._device = device
        elif device is not None:
            assert self._device == device
        if self._device is None:
            raise RuntimeError("no device provided")

        await self._device.open()
        if _bitstream_file is not None:
            await self._device.download_prebuilt(self.artifact(), _bitstream_file)
        else:
            await self._device.download_plan(self.artifact(), reload=reload_bitstream)

        interfaces = self._device.usb_device.configuration.interfaces[1:]

        in_ifaces = interfaces[len(interfaces) // 2:]
        in_pipes = iter(pipe for pipe in self._pipes if isinstance(pipe, HardwareInPipe))
        for in_iface, in_pipe in zip(in_ifaces, in_pipes):
            in_pipe._in_interface = in_iface.number
            in_pipe._in_alt_setting = 2 if len(self._in_streams) <= 1 else 1
            endpoint, = in_iface.alternates[in_pipe._in_alt_setting].endpoints
            in_pipe._in_ep_address = endpoint.number
            in_pipe._in_packet_size = endpoint.packet_size

        out_ifaces = interfaces[:len(interfaces) // 2]
        out_pipes = iter(pipe for pipe in self._pipes if isinstance(pipe, HardwareOutPipe))
        for out_iface, out_pipe in zip(out_ifaces, out_pipes):
            out_pipe._out_interface = out_iface.number
            out_pipe._out_alt_setting = 2 if len(self._out_streams) <= 1 else 1
            endpoint, = out_iface.alternates[out_pipe._out_alt_setting].endpoints
            out_pipe._out_ep_address = endpoint.number
            out_pipe._out_packet_size = endpoint.packet_size

        self._running = True # can access `self.device` after this point

        # Claim all of the interfaces first. On Linux it doesn't matter when this is done, but
        # on Windows claiming an interface resets all of the other configured interfaces.
        #
        # This also means that currently an applet calling `.detach()` will break all of
        # the other applets, but since the only user of this API, `probe-rs`, isn't able to
        # attach to the device directly on Windows anyway (due to an nusb bug), this is probably
        # okay for now.
        for pipe in self._pipes:
            await pipe._attach()

        await self.configure_ports()
        for pipe in self._pipes:
            await pipe._start()

    async def flush_pipes(self):
        for pipe in self._pipes:
            if isinstance(pipe, HardwareOutPipe):
                await pipe.flush()

    async def stop(self):
        for pipe in self._pipes:
            await pipe._stop()

        await self.device.close()

        self._running = False

    async def __aexit__(self, exc_type, exc_value, traceback):
        if exc_type is None:
            await self.flush_pipes()

        await self.stop()

    def statistics(self):
        for pipe in self._pipes:
            pipe.statistics()
