GlasgowEmbedded/glasgow/(commit log)

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2018-04-07 Use our own VID:PID pair instead of Cypress one (PID provisional).
    This also adds an EEPROM access API.
2018-04-10 Add base board schematics (only the Cypress side for now).
    [glasgow.sch]
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2018-04-13 Update schematics and add preliminary layout.
    [glasgow.kicad_pcb, glasgow.sch]
2018-04-14 Design and lay out most of the board, except for Vtg DAC/ADC/LDOs.
    [glasgow.kicad_pcb, glasgow.sch, glasgow_iobuf.sch]
2018-04-14 Add 500mA fuse on VUSB.
    [glasgow.kicad_pcb, glasgow.sch, glasgow_iobuf.sch]
2018-04-14 Add SYNC port.
    [glasgow.kicad_pcb, glasgow.sch]
2018-04-14 Voltage translator has a ~OE pin, not OE, oops.
    [glasgow.kicad_pcb, glasgow.sch, glasgow_iobuf.sch]
2018-04-15 Add MSOP-8 footprints to Glasgow repo.
    Remove later when KiCAD PR goes through.
2018-04-15 Add corrected Cypress footprint.
2018-04-15 Added LEDs, TPs, fixed fab layers.
    [glasgow.kicad_pcb, glasgow.sch, glasgow_iobuf.sch]
2018-04-15 Added proper VCCPLL bypass.
    [glasgow.kicad_pcb, glasgow.sch]
2018-04-15 Fix CY7C68013A and MIC5355 footprints.
    [glasgow.kicad_pcb, glasgow.sch, glasgow_iobuf.sch]
2018-04-16 Add stencil alignment holes, fix attribution.
    [glasgow.kicad_pcb, glasgow.sch, glasgow_iobuf.sch]
2018-04-16 Connect INT0 to FLAGD to get an interrupt triggered by FPGA.
    [glasgow.kicad_pcb, glasgow.sch]
2018-04-16 Swapped VOUT and I2C pins on DAC symbol.
2018-04-16 Add analog frontend schematics.
    [glasgow.kicad_pcb, glasgow.sch, glasgow_iobuf.sch]
2018-04-16 Add proper RC filter on VCCPLL.
    [glasgow.kicad_pcb, glasgow.sch, glasgow_iobuf.sch]
2018-04-16 Add power budgeting.
    [glasgow.sch, glasgow_iobuf.sch]
2018-04-16 Add DAC resistor network values.
    [glasgow.kicad_pcb, glasgow_iobuf.sch]
2018-04-16 Fill in Mouser_PN for every component.
    [glasgow_iobuf.sch]
2018-04-16 Replace non-stock capacitor with stocked one.
    [glasgow.sch, glasgow_iobuf.sch]
2018-04-16 Correct Imax numbers for FXMA108.
    [glasgow.kicad_pcb, glasgow.sch, glasgow_iobuf.sch]
2018-04-16 Split voltage supply and sense.
    [glasgow.kicad_pcb, glasgow_iobuf.sch]
2018-04-17 Finish layout.
    [glasgow.kicad_pcb, glasgow.sch, glasgow_iobuf.sch]
2018-04-17 Reorganize directory structure for hardware.
    Also a few cosmetic fixes on the board.
    [glasgow.kicad_pcb, glasgow.sch, io_buffer.sch]
2018-04-17 Swap INT0 and INT1 to give ~ALERT highest natural priority.
    [glasgow.kicad_pcb, glasgow.sch, io_buffer.sch]
2018-04-17 Remove decoupling capacitor from non-power (WAKEUP) pin.
    [glasgow.kicad_pcb, glasgow.sch]
2018-04-17 Add explicit pin1 mark for CY7C as the IPC one is obscured by via.
    [glasgow.kicad_pcb]
2018-04-17 Add fiducials.
    Awfully optimistic, I know :)
    [glasgow.kicad_pcb]
2018-04-18 Fix some unconnected nets.
    [glasgow.kicad_pcb]
2018-04-18 Leave only ADC on Vsense, and connect LDO and FXMA both to Vio.
    [glasgow.kicad_pcb, io_buffer.sch]
2018-04-18 Fix LM3880 EN divider to have correct threshold (thanks @awygle!).
    [glasgow.kicad_pcb, glasgow.sch]
2018-04-18 DFM tweaks to MSOP paste and thermal vias.
    [glasgow.kicad_pcb]
2018-04-18 Restore paste layer for back side pads.
    This got clobbered when I disabled it globally in kicad.
    [glasgow.kicad_pcb]
2018-04-18 Enlarge CY7C thermal vias to 0.3mm to satisfy board house capabilities.
    DirtyPCBs can only do 12mil+ finished hole.
    [glasgow.kicad_pcb]
2018-04-18 Add Glasgow revA production files.
    [glasgow-B.Cu.gbl, glasgow-B.Mask.gbs, glasgow-B.Paste.gbp, glasgow-B.SilkS.gbo, glasgow-Edge.Cuts.gm1, glasgow-F.Cu.gtl, glasgow-F.Mask.gts, glasgow-F.Paste.gtp]
2018-04-18 Add laser cut case, with production files.
    [bottom.dxf, top.dxf]
2018-04-20 Update to use latest KiCad libraries.
    [glasgow.kicad_pcb, glasgow.sch]
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2018-04-25 Fix u1 capacitors to be 0603, not 0201.
    Fuck's sake.
    [glasgow.sch, io_buffer.sch]
2018-04-25 Specify part number for J4.
    [glasgow.sch]
2018-04-25 Fixed most issues with i2c slave read.
    Still a problem with the stop bit, but be a test bug.
    [i2c.py]
2018-04-29 Set I2C MultiReg reset state back to 1.
    [i2c.py]
2018-04-29 Fix typo in documentation.
    [i2c.py]
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2018-04-29 Fix I2C read stobe timing and add more elaborate tests for reads.
    [i2c.py]
2018-04-29 gateware/ → software/glasgow/gateware/
    We need to move this so that CLI can generate Verilog directly.
2018-04-29 Assign an I2C address to the FPGA.
    [glasgow.sch]
2018-04-29 Use a pads object for I2C instead of separate scl/sda signals.
    So that I2CSlave(platform.request("i2c")) works.
2018-04-29 Move GlasgowDevice to glasgow.device and add __all__ everywhere.
    So that `import glasgow.gateware` doesn't pull in libusb.
    [device.py, i2c.py]
2018-04-29 Correctly use TSTriple in I2C gateware.
    [i2c.py]
2018-04-29 Add the rest of FX2 pinout and LED control code.
2018-04-30 Remove hardware/packages3D/LED_0603_1608Metric_Castellated.{step,wrl}.
    This is now provided upstream.
    [glasgow.kicad_pcb]
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2018-05-01 Hook up some registers to I2C inside the FPGA.
2018-05-01 Add dedicated register read/write code.
    This lets us stall EP0 when trying to access a nonexistent register;
    reusing EEPROM code would silently do nothing on errors.
    [main.c]
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2018-05-01 Add revA fab pdf.
    [glasgow.kicad_pcb]
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2018-05-01 Make all endpoints byte-wide to avoid interfering with port D.
    [main.c]
2018-05-01 Fix layer visibility.
    [glasgow.kicad_pcb]
2018-05-02 Fix R16 value.
    Closes #18.
    [glasgow.kicad_pcb, glasgow.sch]
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2018-05-02 Use ERR LED to indicate FPGA config failure.
    [main.c]
2018-05-03 Add I2C address constants.
    Also fix broken case fallthrough.
    [glasgow.h, main.c]
2018-05-03 Add an explicit device status word and much improve error handling.
    [device.py, fpga.c, glasgow.h, main.c]
2018-05-03 Pulse ACT LED when there is USB activity.
2018-05-03 Fix DAC addresses on schematic.
    [glasgow.sch, io_buffer.sch]
2018-05-03 Implement configuration of I/O buffer voltage.
    This doesn't actually work right now because of a schematic issue.
    [device.py, glasgow.h, iobuf.c, main.c, target.py]
2018-05-03 Fix ENVA/ENVB pin polarity (oops!)
    [glasgow.kicad_pcb, glasgow.sch, io_buffer.sch]
2018-05-03 Fix Mouser_PN for R19, R22.
    Closes #32.
    [io_buffer.sch]
2018-05-03 Fix typo that inverted OED bits.
    [iobuf.c]
2018-05-05 Move R12-R16 to top side.
    Closes #19.
    [glasgow.kicad_pcb]
2018-05-05 Add a test command to expose I2C bus on port A.
2018-05-05 Move J1 to be flush with the board outline.
    Closes #21.
    [glasgow.kicad_pcb]
2018-05-05 Reduce green LED current to 0.31 mA.
    Closes #22.
    [glasgow.kicad_pcb, glasgow.sch]
2018-05-05 Correct crystal orientation and shrink footprint.
    Closes #20 and #23.
    [glasgow.kicad_pcb, glasgow.sch]
2018-05-05 Change ENVA and ENVB from pullups to pulldowns.
    Closes #31.
    [glasgow.kicad_pcb, glasgow.sch, io_buffer.sch]
2018-05-05 Increment PCB revision to B.
    [glasgow.kicad_pcb]
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2018-05-07 Fix LED current comment on schematic.
    [glasgow.sch]
2018-05-07 Add a `glasgow voltage` command-line verb.
    Also fix some glitches related to alerts.
    [adc.c, device.py]
2018-05-08 Make all FIFO strobes active-high for simplicity.
    [glasgow.kicad_pcb, glasgow.sch]
2018-05-09 Fix identifier not renamed in 3dda7a10.
    [target.py]
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2018-05-11 Use a proper reset sequence and disable FIFO bus to avoid glitches.
    [fifo.c, fpga.c, target.py]
2018-05-11 Configure SLRD and SLWR as active low to avoid glitches.
    [fifo.c]
2018-05-11 Implement basic FX2 bus arbiter (no starvation prevention yet).
    [fx2.py, target.py]
2018-05-12 Fix silkscreen issues with resistors moved to top.
    Closes #19 (again).
    [glasgow.kicad_pcb]
2018-05-12 Add IFCLK test point.
    Closes #40.
    [glasgow.kicad_pcb, glasgow.sch]
2018-05-12 Add slew rate control resistors to DUT busses.
    Closes #35.
    [glasgow.kicad_pcb, io_buffer.sch]
2018-05-12 Make a few cosmetic changes to the PCB, both traces and silk.
    Also, actually connect ~OEQ pullup.
    [glasgow.kicad_pcb, glasgow.sch, io_buffer.sch]
2018-05-12 Moved USB connector to be flush with board edge.
    Added cutout for connector flange.
    [glasgow.kicad_pcb]
2018-05-12 Move the USB connector flush with the board outline.
    [glasgow.kicad_pcb]
2018-05-12 Add local copy of resistor array footprint.
    To be removed when accepted upstream.
2018-05-12 Remove all footprints, symbols and 3D packages merged in KiCAD.
    [glasgow.kicad_pcb, glasgow.sch, io_buffer.sch]
2018-05-12 Hack together a 3D model for Crystal_SMD_3225_4Pads.
    [glasgow.kicad_pcb]
2018-05-13 CLI: set voltage to 0 V after failing to set it to requested value.
    Otherwise, the alert gets reset, but the voltage stays where it is.
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2018-05-14 Move QB traces around a bit to free up space near to level shifter.
    [glasgow.kicad_pcb]
2018-05-18 Implement `glasgow factory` and expose rev/serial in USB descriptors.
    Fixes #29.
    Fixes #30.
    [device.py, glasgow.h, main.c]
2018-05-18 Relabel CYP→FX2, FPGA→ICE.
    Fixes #54.
    [glasgow.kicad_pcb, glasgow.sch]
2018-05-19 Fix IOPort.__getitem__ invocation without explicit stop index.
    [target.py]
2018-05-20 Use async BF polling and tighten timings in hd44780 applet.
    [hd44780.py]
2018-05-21 Update libfx2 to use EEPROM page writes.
    This also forces 400 kHz I2C mode to be used, and adds verification
    for `glasgow flash`.
2018-05-22 Allow flashing bitstream to ICE_MEM.
    This also removes `glasgow test download` command in favor of
    `glasgow run --bitstream`, allows using CLI arguments in applets when
    building gateware, adds logging, and improves robustness of EEPROM
    handling code overall.
    Fixes #55.
    [device.py, fpga.c, glasgow.h, hd44780.py, main.c, program_ice40.py]
2018-05-24 Fix accidentally used 0201 resistor.
    [glasgow.sch, io_buffer.sch]
2018-05-24 Use Mfg/MPN fields in schematic instead of Mouser_PN.
    There's no point in having Mouser_PN; pretty much every service,
    including Mouser itself (!), works better (or even at all) with MPNs.
    [glasgow.sch, io_buffer.sch]
2018-05-24 Update MPNs for out of stock capacitors and resistors.
    Also fix a few MPNs that didn't quite match the manufacturer format,
    and assign a MPN to J4.
    [glasgow.sch, io_buffer.sch]
2018-05-25 Compute bitstream ID and avoid rebuilding bitstreams if it matches.
    [device.py, glasgow.h, main.c, target.py]
2018-05-25 Fix dptr corruption in EPn interrupt handlers.
    [main.c]
2018-05-26 Allow retargeting applets to different port and pins.
    Fixes #57.
    [hd44780.py, program_ice40.py, target.py]
2018-05-28 Allow applets to request FIFOs instead of hardcoding count and depth.
    This also makes asynchronous FIFOs actually work.
    Fixes #58.
    [fx2.py, program_ice40.py, target.py, test.py]
2018-05-28 Add early_in parameter to get_in_fifo to disable automatic OUTPKTEND.
    Also fix a typo.
    [fx2.py]
2018-05-28 Fix data corruption writing last byte available in an FX2 IN FIFO.
    [fifo.c, fx2.py]
2018-06-04 Add USB protection IC.
    [glasgow.kicad_pcb, glasgow.sch]
2018-06-24 Add edge-rate control resistors on FPGA side.
    [glasgow.kicad_pcb, io_buffer.sch]
2018-06-24 Minor silkscreen cleanups.
    [glasgow.kicad_pcb]
2018-07-21 Add a TRACE log level and log all port and USB I/O using it.
2018-07-21 Use upstream FPGA symbol
    [glasgow.sch]
2018-07-21 Reduce SYNC pull-up value to 390 Ohms.
    Closes #51.
    [glasgow.sch]
2018-07-21 Use upstream QFN footprint for Cypress part
    Closes #61.
    [glasgow.kicad_pcb, glasgow.sch]
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2018-07-21 Update revision on schematic.
    [glasgow.sch, io_buffer.sch]
2018-07-21 Update MPN on schematic.
    [glasgow.sch]
2018-07-21 Add fabrication outputs for revB.
    This also fixes bad positioning on fab layers and wrong 3D package
    for the Cypress chip.
    Resistor network MPN is still TBD.
    [glasgow-B.Cu.gbl, glasgow-B.Mask.gbs, glasgow-B.Paste.gbp, glasgow-B.SilkS.gbo, glasgow-Edge.Cuts.gm1, glasgow-F.Cu.gtl, glasgow-F.Mask.gts, glasgow-F.Paste.gtp]
2018-07-21 UART: improve TTY handling.
    As follows:
    * Clear ISIG to pass ^C, ^Z, etc (use ^\^\ to quit).
    * Don't run TTY ioctls on pipes.
2018-07-21 Re-enable ACT LED disabled in firmware by accident.
2018-07-21 Allow both R/O and R/W I2C registers on FPGA.
    Fixes #46.
    [registers.py, target.py, test.py]
2018-07-21 Add a self-test applet, to find pin shorts (more in future).
    Fixes #56.
    [dac_ldo.c, device.py, glasgow.h, main.c, selftest.py]
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2018-07-22 Further reduce SYNC pullup to 130 Ohms.
    Closes #51 (again).
    [glasgow.sch]
2018-07-23 Extract UART module into glasgow.gateware and add tests.
    This also fixes a few bugs and idiosyncrasies in it.
    [uart.py]
2018-07-23 applet.uart: restore fcntl flags on stdin as well.
    Otherwise, programs expecting interactive input think you enter ^D
    at every prompt.
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2018-07-23 device.GlasgowPort: explicitly convert data to bytes in write.
    The same is not done for write_str because of the default
    implementation of __str__, which has too much of a footgun potential.
    [device.py]
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2018-07-24 cli: move code that adds a TRACE log level to main package.
    Or you cannot `import glasgow.device` and have things work.
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2018-07-24 Abstract away multiplexing/demultiplexing of pin and FIFO access.
    Applets shouldn't need to care which specific port they run on,
    unless they have a good reason to.
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2018-07-25 applet.i2c.eeprom: improve resiliency in face of bus errors.
2018-07-25 Allow programming a non-volatile voltage limit, as a safety feature.
    E.g. if you work with only 1.8 V logic, you would run
    glasgow voltage-limit AB 1.8
    and until the limit is removed, Glasgow will never put more than
    1.8 V on an I/O port, assuming the DAC circuitry is working correctly.
    If the DAC circuitry is not working correctly, the voltage monitor
    feature will disable the outputs, although it might still not be
    quick enough.
    [dac_ldo.c, device.py, glasgow.h, main.c]
2018-07-25 applet.i2c_master: use reliable out-of-band reset instead of in-band.
    [hd44780.py, i2c_master.py, program_ice40.py, uart.py]
2018-07-25 gateware.i2c_regs: forward any add_* args to Signal().
    This allows registers of any width and with any reset value, among
    other things.
    Registers wider than 8 bits are currently not handled specially and
    are simply truncated.
    [i2c_regs.py]
2018-07-25 target.access: allow making pin and pin set arguments required.
2018-07-26 Use correct form of %#0Dx format specified.
    D specifies total field width, not the amount of zeroes in the part
    after 0x, so increase by 2 everywhere.
    [bmp280.py]
2018-07-27 applet.i2c_master: allow transactions of up to 65535 bytes in size.
2018-07-27 applet.i2c.eeprom_24c: rename, add proper user interface.
    The 24CXX EEPROM applet now supports reading and writing all EEPROMs
    with 1 and 2 address byte, including 1 address byte EEPROMs larger
    than 256 B, but not (yet) 2 address byte EEPROMs larger than 64 KiB.
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2018-07-28 applet.i2c_master: fix I2C reserved address range.
    [i2c_master.py]
2018-07-28 applet: use well defined build, run and interact phases.
    This commit updates applets to work in three phases:
    * build: adds gateware subtarget
    * run: initializes gateware, e.g. divisors, resets
    * interact: processes user arguments, e.g. reads, writes
    When subclassing applets, the superclass build and run phases should
    be invoked, but the interact phase is overridden completely.
    [bmp280.py, eeprom_24c.py, hd44780.py, i2c_master.py, program_ice40.py, selftest.py]
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2018-07-28 applet: make run() and interact() asyncio coroutines.
    This doesn't actually change the I/O within them to be non-blocking.
    This will be done in future commits.
    [bmp280.py, eeprom_24c.py, hd44780.py, i2c_master.py, program_ice40.py, selftest.py, uart.py]
2018-07-28 Select RN MPN, populate and add to schematic.
    [io_buffer.sch]
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2018-07-30 gateware.i2c_regs: rename to registers, split I2C part off.
2018-07-30 Rename *Mock* to *Simulation* and split target/device packages.
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2018-08-30 applet.spi_master: new applet.
    Fixes #48.
    [i2c_master.py, spi_master.py]
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2018-09-03 applet.spi.flash_avr: take DUT out of reset before exit.
2018-09-03 applet.spi.flash_avr: add attiny24/45/85 support.
    Also fix device detection.
2018-09-03 applet.spi.flash_avr: fix applet description.
2018-09-03 applet.i2c.master: add an option to drop into Python shell.
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2018-09-04 applet.spi.flash_25c: allow coexistence with other SPI masters.
    This permits reflashing microcontroller boot ROM in circuit.
2018-09-04 applet.spi.flash_25c: fix typos.
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2018-09-05 applet.spi.flash_25c: add a command to perform a RMEW cycle.
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2018-09-09 applet.uart: add support for creating a ttyS-like PTY.
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2018-09-10 applet.swd: fix most bugs.
    Parity is still not checked when receiving.
    [swd.py]
2018-09-12 applet.spi.flash_25c: minor UI fixes.
2018-10-07 access: use streaming=False by default in get_in_fifo().
    streaming=True by default causes confusing bugs and the reason for
    its existence in the first place is no longer true any more (it
    was added because of FX2 bus flakiness due to the lack of proper
    SB_IO registers).
    [fx2.py, nand_flash.py, swd.py, uart.py]
2018-10-07 applet.benchmark: new applet.
    Fixes #47.
    Not exactly functional due to #44 and #64.
    benchmark: running benchmark mode source for 4.000 MiB
    benchmark: mode source: 4.136 MiB/s
    (hangs. after restart:)
    benchmark: running benchmark mode sink for 4.000 MiB
    benchmark: mode sink: 1.394 MiB/s
    (hangs. after restart:)
    benchmark: running benchmark mode loopback for 4.000 MiB
    (hangs)
    [benchmark.py, selftest.py]
2018-10-09 Use USB alternate settings to transparently reset endpoint FIFOs.
    This is necessary to gracefully handle crashes and termination via
    e.g. ^C; once the process dies (no matter how) the kernel resets
    the interface to the 0th alternate setting, and to actually use
    the endpoints in the interface it needs to be set to the 1st
    alternate setting, which resets the FIFOs.
    Refs #64.
    [benchmark.py, fifo.c, glasgow.h, main.c]
2018-10-09 Implement unified, zero-configuration reset for applets and FIFOs.
    This commit makes sure that every time an interface is claimed,
    the CY7C FIFOs and iCE arbiter FIFOs are cleared, and all applet
    logic is reset. This makes it possible to stop applets with ^C
    and safely restart them without any framing errors, workarounds like
    stuffing the pipe with dummy packets to flush it out, or any explicit
    code in applets to handle this case.
    Fixes #64.
    This commit doesn't (yet?) implement device-only reset, i.e. CY7C
    automatically issuing the I2C requests on SET INTERFACE. This is
    because it isn't clear that this can be done, or desirable, for
    indirect applet access; because it isn't essential; becau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
    [benchmark.py, fx2.py, hd44780.py, nand_flash.py]
2018-10-11 firmware: fix EP4 FIFO reset code.
    Typo. Which I've spent several hours on. :/
    [fifo.c]
2018-10-11 Implement a basic integrated event analyzer.
    This doesn't yet suspend applets on FIFO high-water mark, nor does it
    write any useful format like VCD.
    Refs #65.
    [analyzer.py, benchmark.py, rgb_grabber.py]
2018-10-11 applet.nand_flash: fix setup/hold violation.
    [nand_flash.py]
2018-10-12 applet.nand_flash: slightly improve timings.
    After the recent changes the applet can read 128M of flash with only
    a handful of single bit errors (which are to be expected) and can now
    be considered production quality.
    [nand_flash.py]
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2018-10-12 target.analyzer: reset analyzer on USB interface reset.
    This makes timestamps start at a sensible boundary. Also, trigger
    capture of pins immediately after reset to show their initial values
    properly.
    [analyzer.py]
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2018-10-12 hardware: update I/O cell to use SN74LVC1T45 level shifters.
    [io_buffer.sch]
2018-10-12 hardware: update to revC0.
    [glasgow.kicad_pcb, glasgow.sch, io_buffer.sch]
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2018-10-13 applet.jtag: scan: gracefully handle broken chains.
    [jtag.py]
2018-10-13 applet.jtag: minor display issues.
    [jtag.py]
2018-10-13 applet.jtag: scan: discover IR lengths in the chain.
2018-10-13 applet.jtag: ensure chain is not left in invalid states.
2018-10-13 applet.jtag: use correct algorithm for JEDEC database lookup.
    [jtag.py]
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2018-10-15 applet.jtag.mips: add public API and track target state.
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2018-10-16 applet.jtag.mips: implement software breakpoint support.
    Also display some cache info on PrAcc probe.
2018-10-20 applet.jtag.pinout: also probe TRST# if pulldowns are detected.
    There is no need to probe it if it has a pullup or is Hi-Z because
    we get all those to high before probing other pins.
    Also write out the arguments to the `jtag` applet. This isn't
    entirely correct as it'll break with indirect access, but it's good
    enough for now.
2018-10-20 gateware.fx2: replace "non-streaming" FIFOs with "auto-flush" FIFOs.
    The difference is that all FIFOs are now flush-capable, and
    auto-flush FIFOs simply always assert flush. This means that applets
    can flush on demand.
    The manual-flush mode currently has an issue where if a flush is
    asserted after all data is already transferred into the FX2 side
    FIFO, the packet is not sent. Thus, it is not usable in general.
    [benchmark.py, fx2.py, rgb_grabber.py]
2018-10-20 access: allow hinting reads for dramatically improved performance.
    The `hint` argument to `read` chooses the size of the buffer
    submitted to the OS. It should be set to the amount of data expected
    to be recived, and using it correctly is essential to avoid
    FIFO underflows and poor performance.
    [benchmark.py, fx2.py]
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2018-10-25 applet.spi.master: fix refactoring issue.
    This broke dependent applets like applet.spi.flash_25c.
2018-10-25 applet.spi.flash_25c: use proper dummy byte count for RDP.
2018-10-25 applet.spi.master: SS should always be driven.
    This broke spi.flash-25c applet in mysterious ways.
2018-10-25 applet.spi.flash_25c: add HOLD# pin, always high.
    Flashes (usually?) don't have an internal pullup there, so
    an explicit pin makes it easier to remember that, and use a straight
    8-to-8 socket adapter, if we ever get any.
2018-10-25 gateware.fx2: finish manual-flush code paths.
    This fixes the manual-flush issue described in aa80b038, and makes
    manual-flush actually usable.
    [fx2.py]
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2018-10-25 revB: add missing BOM.
2018-10-25 applet.shugart_floppy: new applet.
    Currently features (software) PLL, (software) MFM demodulator,
    and only raw reads. More to come!
2018-10-25 applet.shugart_floppy: improve dirty clock recovery, fix docs.
    [shugart_floppy.py]
2018-10-25 applet.shugart_floppy: pedantic doc fixes.
    [shugart_floppy.py]
2018-10-25 applet.shugart_floppy: interleave tracks from both sides.
    This gives us "LBA" (really logical track addressing) that seems
    consistent with what Linux &c use... of course, FAT12 uses CHS
    directly.
2018-10-26 applet.shugart_floppy: implement MFM image indexing.
    Indexing as in it gives you an index of the sectors it found in
    the disk image. It does decode the data and verify CRC too, but
    doesn't save the decoded bytes anywhere.
    [shugart_floppy.py]
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2018-10-26 applet.shugart_floppy: tweak PLL for lower desync rate.
    before: 1255/2915 sectors missing
    after: 913/2915 sectors missing
    [shugart_floppy.py]
2018-10-26 applet.shugart_floppy: fix missing LBA calculation.
    [shugart_floppy.py]
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2018-10-26 applet.spi.master: implement optimized reads/writes.
    These don't hold up FIFOs with zeroes (for writes) or dummy bytes
    (for reads).
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2018-10-31 applet.{i2c,spi}: add missing __init__.py to satisfy setuptools.
2018-10-31 firmware: update to newer libfx2.
    Fixes #66.
    [main.c]
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2018-10-31 firmware: update to newer libfx2.
    Fixes incorrect bNumInterfaces in USB configuration descriptors.
    [main.c]
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2018-11-01 Untangle USB pipes from I/O ports.
    Fixes #72.
    [main.c]
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2018-11-02 gateware.fx2: add missing import.
    [fx2.py]
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2018-11-18 firmware: fix operator precedence issue.
    [main.c]
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2018-11-19 cli: add --filter-log, for raising the log level of a single component.
2018-11-20 applet.spi.{master,flash_25c}: add missing @synthesis_test.
2018-11-20 applet.spi.flash_avr: fix build().
2018-11-20 applet.spi.flash_avr: add missing @synthesis_test.
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2018-11-21 revC WIP PCB work
    [glasgow.kicad_pcb, glasgow.sch, io_buffer.sch]
2018-11-21 revC: FX2<->FPGA routing take 1
    [glasgow.kicad_pcb, glasgow.sch, io_buffer.sch]
2018-11-21 revC: FX2<->FPGA routing take 2
    [glasgow.kicad_pcb]
2018-11-21 revC: delete old FPGA
    No useful information left, since it's mostly just the port routing
    remaining
    [glasgow.kicad_pcb, glasgow.sch]
2018-11-21 revC: route missing D0 and D1
    [glasgow.kicad_pcb, glasgow.sch, io_buffer.sch]
2018-11-21 revC: fix some misc DRC errors
    [glasgow.kicad_pcb]
2018-11-21 revC: Update SOT563 footprints to Glasgow version and more DRC fixes
    [glasgow.kicad_pcb, io_buffer.sch]
2018-11-21 revC: fix connector placement, LVDS connector testing
    [glasgow.kicad_pcb, glasgow.sch, io_buffer.sch]
2018-11-21 revC: route LVDS
    [glasgow.kicad_pcb, glasgow.sch, io_buffer.sch]
2018-11-21 revC: move FPGA I/O banks to a separate sheet, wire I/O buffers
    [glasgow.kicad_pcb, glasgow.sch, io_banks.sch, io_buffer.sch]
2018-11-23 gateware.fx2: `async` became a reserved word.
    Fixes #78.
    [fx2.py]
2018-11-23 firmware: fix illegal IOx manipulation.
    Something like:
    IOx |= 0x02;
    IOx &= 0x01;
    doesn't guaranteed to work unless both of those are already outputs,
    since writing an 1 (or 0) to an input doesn't change the value read
    back.
    In practice this results in weird inconsistent bugs due to board-to-
    board variability.
    Fixes #77.
    [dac_ldo.c]
2018-11-23 revC: I/O buffer B routing
    [glasgow.kicad_pcb, io_banks.sch, io_buffer.sch]
2018-11-24 revC: more layout work on port A & misc
    [glasgow.kicad_pcb, glasgow.sch, io_banks.sch, io_buffer.sch]
2018-11-25 cli: fix --trace.
2018-11-25 revC: I/O buffers fully routed
    [glasgow.kicad_pcb, io_buffer.sch]
2018-11-25 revC: all routed, top silkscreen cleaned up
    [glasgow.kicad_pcb, glasgow.sch, io_buffer.sch]
2018-11-28 revC: length match LVDS pairs (#82)
    [glasgow.kicad_pcb]
2018-11-28 revC: swap U2/U3, fix DRC issue
    [glasgow.kicad_pcb]
2018-11-28 revC: pull +5V a bit further away from GND
    [glasgow.kicad_pcb]
2018-11-28 revC: add ATECC508A
    [glasgow.kicad_pcb, glasgow.sch]
2018-11-28 revC: update wave soldering keepouts
    [glasgow.kicad_pcb]
2018-11-28 revC: fix up diffpairs
    Moved skew matching meanders to the FPGA side, length matched again.
    Kicad is being stupid about length matching so I could only get them to
    within +/- 0.5mm, but that should be plenty.
    [glasgow.kicad_pcb]
2018-11-28 revC: fix some more diffpair issues
    [glasgow.kicad_pcb]
2018-11-28 gateware.fx2: implement reset for async FIFOs.
    [fx2.py]
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2018-11-30 firmware: add Device Qualifier request.
    Necessary for USB compliance.
2018-11-30 support.logging: implement dump_hex, and use in USB and FIFO code.
    Most of the time it is not necessary (and in fact is harmful) to
    eagerly dump the complete packet at USB and FIFO layers. Instead,
    lazily dump only some first bytes, which is sufficient for most
    debugging. In any case, `glasgow -vvv` dumps the complete data.
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2018-12-03 revC: silkscreen wrapup, add Hana
    [glasgow.kicad_pcb]
2018-12-03 revC: restore Glasgow label text
    Got lost somewhere...
    [glasgow.kicad_pcb]
2018-12-03 revC: use proper footprint for I/O connectors, tweak silkscreen
    [glasgow.kicad_pcb, glasgow.sch, io_buffer.sch]
2018-12-03 revC: Fix a glitch
    [glasgow.kicad_pcb]
2018-12-03 Move three refspecs 0.1mm for symmetry against other side.
    [glasgow.kicad_pcb]
2018-12-04 revC: remove spurious square in F.Paste
    [glasgow.kicad_pcb]
2018-12-04 revC: minor beauty tweaks to routing, redo USB 2.0 diffpairs
    I used the same specs as for LVDS (even though those are 100Ω and USB
    2.0 is supposed to be 90Ω, it's short enough it won't matter and we're
    not doing tight enough fab control for it to make a difference)
    [glasgow.kicad_pcb]
2018-12-04 gateware.boneless: use split memory ports, if any (-20 LUT).
    Before:
    Number of wires: 475
    Number of wire bits: 919
    Number of public wires: 44
    Number of public wire bits: 386
    Number of memories: 0
    Number of memory bits: 0
    Number of processes: 0
    Number of cells: 737
    SB_CARRY 93
    SB_DFF 9
    SB_DFFE 1
    SB_DFFESR 80
    SB_DFFSR 36
    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
2018-12-04 gateware.boneless: use non-transparent read port (-47 LUT, -17 DFF).
    Number of wires: 462
    Number of wire bits: 899
    Number of cells: 717
    SB_DFF 1
    SB_LUT4 505
    SB_RAM40_4K 1
    After:
    Number of wires: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
2018-12-04 revC: update incorrect comment re: Vbus threshold
    [glasgow.sch]
2018-12-04 revC: connect Port A 4,6 to extra FPGA I/Os as well as GBUFs
    This allows flexibility in using the PLL with or without the pins as
    clock inputs.
    [glasgow.kicad_pcb, io_banks.sch]
2018-12-04 revC: schematic style fix (add wire for net label)
    [glasgow.sch]
2018-12-04 revC: remove additional I/O port silkscreen markings
    [glasgow.kicad_pcb]
2018-12-04 revC: move USB D+ closer to D- near U15
    [glasgow.kicad_pcb]
2018-12-04 revC: simplify VUSB routing, move input cap to top layer, double vias
    [glasgow.kicad_pcb]
2018-12-04 revC: reposition fiducials, add a third corner, add more for FX2, FPGA
    [glasgow.kicad_pcb]
2018-12-04 revC: minor nudging and tweaking to improve silkscreen around reg area
    [glasgow.kicad_pcb]
2018-12-04 revC: another silkscreen tweak near USB connector
    [glasgow.kicad_pcb]
2018-12-04 revC: line up some traces better
    [glasgow.kicad_pcb]
2018-12-12 revC: add ferrite bead to VUSB
    [glasgow.kicad_pcb, glasgow.sch]
2018-12-13 revC: fix silkscreen for FB1
    [glasgow.kicad_pcb]
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2018-12-18 Revert nMigen changes.
    This reverts commit 9f617b2e8c5844ee41b810179ec40f095d8e4ef5.
    This reverts commit 73e1a478ff151c5641bf0b8e29b7aefb41638220.
    [i2c.py, uart.py]
2019-01-13 cli: print version if -V/--version option is used.
2019-01-13 gateware: use SB_GB_IO instead of SB_IO+SB_GB to reduce delay.
    Unfortunately, this takes liberties with the FX2 interface; the data
    is now captured on falling edge, so instead of one full cycle of
    data validity there is only a half cycle. However, the FX2 interface
    was certainly broken before, and it seems less broken to me now, so
    I am committing this anyway.
    Ideally, the FX2 interface would register the input on the next
    rising edge. However, this would add two registers in the input path,
    and we are already using the INFM1 bit in the FX2. Therefore, adding
    this register would require a radical rethinking of the entire FX2
    interface.
    See #89.
    [fx2.py]
2019-01-13 applet.jtag_pinout: fix discovery for pin ranges not starting at 0.
2019-01-23 applet.spi_flash_25c: fix an issue where --pin-hold 0 would be ignored.
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2019-02-04 revC: rename some schematic symbols to match Kicad update
    [glasgow.sch]
2019-02-04 revC: revC0 text -> revC?
    [glasgow.kicad_pcb]
2019-02-04 revC1: add discharge resistors for VIO
    [glasgow.kicad_pcb, io_banks.sch, io_buffer.sch]
2019-02-04 revC1: annotate FB1
    Looks like this was missed in the commit that added it.
    [glasgow.sch]
2019-02-04 revC1: change C78 silkscreen text to 0.8 for consistency
    [glasgow.kicad_pcb]
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2019-02-06 firmware: fix more illegal IOx manipulation.
    See 19662930 for details.
    [fpga.c]
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2019-02-18 applet.audio_output: refactor and add 16-bit sample format support.
2019-02-19 cli: leave formatting of sample CLI invocations alone.
2019-02-20 hardware: revB resistors did not really fix the FXMA brokenness :(
2019-02-24 applet.yamaha_opl: accumulate fractional sample delays.
    This is done to correct for write latency, since some OPx clients,
    such as VGM, assume that writes take zero time.
    This also cleans up the handling of clocking all around, to make it
    easier to generalize to other Yamaha chips.
2019-02-25 device.hardware: don't request RAM writes of >4096 bytes.
2019-02-25 hardware: make Fab layers more readable
    [glasgow.kicad_pcb]
2019-02-25 applet.jtag: scan: improve output for complex chains.
    Before this commit, if automatic IR segmentation fails, nothing
    useful would be shown. After this commit, the IDCODEs are shown,
    and IR and DR values are also shown for debugging.
2019-02-26 applet.jtag_pinout: fix type confusion between bit and pin numbers.
    Before this commit, the applet would break if the JTAG pin set would
    not start with pin 0.
2019-02-26 applet.jtag_pinout: fix failure to detect TRST# on pin 0.
2019-02-26 applet.jtag: fix misdetection of 32-bit DRs at end of chain as truncated.
2019-02-26 applet.jtag: pulse TRST# and reset TAPs when run.
    Almost all circumstances make this sensible. The rare applet that
    needs to, specifically, not reset the test chain when run, can opt
    out of this explicitly.
    Before this commit, the jtag-mips applet would crash at startup.
2019-02-26 applet.jtag_mips: reset Rocc before entering probe mode.
    Otherwise all our writes will just get ignored.
    This commit also adds detection of unexpected core reset.
2019-02-27 applet.jtag: reset TAP chain before selecting a TAP.
    Selecting a TAP requires reading IDCODE/BYPASS from DR, which means
    that a TAP chain reset was a precondition for select_tap(), but this
    wasn't intended or documented. The current design requires a reset,
    so just add that.
    Since all derived applets want to select a TAP, remove the TAP reset
    via TMS from run(); however, keep TAP reset via TRST#, because that
    enables the TRST# driver.
2019-03-01 firmware: persist voltage limit on writes, not reads.
    Oops... this would have written the EEPROM on each `glasgow voltage`
    invocation.
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2019-03-01 applet.i2c_master: require revC+.
    The I2CPadsWrapper hack was horrible to use even when it worked.
    I can't in good conscience recommenda anyone with a revA/B do that,
    so let's get rid of it.
2019-03-01 firmware, software: change revision format from revX to revXN.
    Until now, the firmware and software did not know the specific board
    variant. This doesn't let us work around board bugs.
    [fpga.c, glasgow.h, main.c]
2019-03-01 access.direct.demultiplexer: support pulls in claim_interface().
    This has to be done specifically in claim_interface because it needs
    to be correctly sequenced with relation to IO voltage changes. This
    is not ideal, but works as a first approximation, and it is not clear
    what a significantly better solution would be.
2019-03-01 applet.i2c_master: add --pulls option, to enable pullups on SCL/SDA.
2019-03-02 applet.spi_flash_25c: identify: significantly improve robustness.
    Somef flashes return 0x00 for unimplemented commands, some return
    0xff instead. Any commands may be unimplemented, and some commands
    can return conflicting information, so show everything that looks
    valid at all.
    Also, show a warning if RES returns an invalid result, since that's
    most likely a device that isn't connected properly.
2019-03-04 applet..spi_master: add delay commands.
    These can be very useful if the SPI device requires specific timings;
    in particular, for small delays (e.g. 10 us between commands) it is
    much more efficient to implement these as subtarget commands than it
    would be to wait on the host.
    The synchronize method is useful for e.g. the following pattern:
    await spi_iface.write(...)
    await spi_iface.delay_ms(...)
    await device.write_register(...)
    or in other words, in any case that SPI delays should have a defined
    phase relationship to any other actions.
2019-03-07 revC1: adjust LED resistor values for eye safety
    [glasgow.kicad_pcb, glasgow.sch, io_banks.sch]
2019-03-07 revC1: update schematic with current/voltage figures for LEDs
    [glasgow.sch, io_banks.sch]
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2019-03-08 applet.program.avr→applet.program.avr.spi
    Also, describe the Atmel programming interface mess.
2019-03-08 *.xc9500→*.xc9500xl
    The XC9500 and XC9500XL series have completely different programming
    interfaces, and rather large other differences as well.
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2019-03-08 applet.interface.i2c_master: use argparse subparsers.
    Instead of mutually exclusive groups.
2019-03-08 revC1: fix ugliness in user LED schematic section
    [io_banks.sch]
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2019-03-12 gateware.clockgen: implement universal clock generator.
    This replaces gateware.uart.uart_bit_cyc.
    Fixes #80.
    [clockgen.py, uart.py]
2019-03-12 access.direct.multiplexer: inject pin location into bitstream ID.
    Fixes #103.
2019-03-12 applet.interface.spi_master: let subclasses add their own pin arguments.
    This makes sense for cases where a subclassing applet e.g. requires
    SS, SCK, and MOSI but doesn't need MISO at all.
2019-03-12 applet.audio.yamaha_opl: replace ~CS pin with A1.
    This applet does not really need ~CS, since the chip can be safely
    always selected. On the other hand, having A0 and A1 allows us to
    interface almost every OPx device, with the chief exception of OPL4.
2019-03-12 applet.audio.yamaha_opl: parameterize over specific Yamaha chip.
    Currently only OPL2 and OPL are supported. OPL has not been tested
    on real hardware, but is virtually certain to work.
2019-03-18 gateware.clockgen, applet: fix typos.
    [clockgen.py]
2019-03-18 applet.interface.spi_master: use ClockGen.
    This makes clear the limitations of the current SERDES engine (i.e.
    that the maximum clock rate is 1/4 of applet clock) and handles edge
    conditions reliably. It could also enable higher rates in the future.
2019-03-18 gateware.fx2: re-register FX2 outputs. (UPDATE FIRMWARE.)
    Before this commit, the FX2 arbiter would incorrectly use FX2 outputs
    in the fabric that were actually only valid for 1/2 of IFCLK period,
    because they were DDR input signals. After this commit, these signals
    are correctly re-registered in fabric so that they are valid for
    an entire IFCLK period, increasing latency by one cycle.
    Fixes #89.
    [fifo.c, fx2.py]
2019-03-18 applet.video.rgb_input: exclude frame from FSM but not subtarget reset.
    This means that frame skip is detected correctly but the subtarget is
    still completely reset and starts from frame 0.
2019-03-25 Revert "gateware.fx2: re-register FX2 outputs. (UPDATE FIRMWARE.)"
    This reverts commit 684e45808f4627d91b31a3d32bb18c1bc05b06a4.
    That commit broke the audio-yamaha-opl3 applet *badly*. It is not
    clear exactly what the issue is but the correct fix is likely to
    stop relying on flags to detect a buffer full condition and instead
    use a local counter on the FPGA side, and use flags only to detect
    the out of buffers condition.
    [fifo.c, fx2.py]
2019-03-25 applet.audio.yamaha_opl: implement WAV export.
    This also makes the applet more efficient by performing the unsigned-
    to-signed conversion with numpy, or avoiding a roundtrip, in case
    libsamplerate is used.
2019-03-28 revC1: replace pulls with PCA6408A and remove shifters
    [glasgow.kicad_pcb, io_buffer.sch]
2019-03-28 revC1: fix old value/datasheet for PCA6408, style fixes
    [glasgow.kicad_pcb, io_buffer.sch]
2019-03-28 revC1: make Sync pull-up 1K
    Closes: #102
    [glasgow.kicad_pcb, io_banks.sch]
2019-03-28 revC0: export production files
    Closes: #98
    [glasgow-B.Cu.gbl, glasgow-B.Mask.gbs, glasgow-B.Paste.gbp, glasgow-B.SilkS.gbo, glasgow-Edge.Cuts.gm1, glasgow-F.Cu.gtl, glasgow-F.Mask.gts, glasgow-F.Paste.gtp]
2019-03-28 revC1: note 10/12-bit ADC/DACs as alternates
    Also minor positioning adjustment to the schematic
    Closes: #104
    [io_buffer.sch]
2019-03-28 revC1: bump schematic revision to C1
    [glasgow.sch, io_banks.sch, io_buffer.sch]
2019-03-30 revC1: add level shifter to SYNC pin, using unused FPGA pin for DIR
    [glasgow.kicad_pcb, io_banks.sch]
2019-04-01 revC1: improve Sync change layout, fix silk/fab layers
    [glasgow.kicad_pcb]
2019-04-01 revC1: route FPGA pin D5 to CLKREF
    [glasgow.kicad_pcb, glasgow.sch, io_banks.sch]
2019-04-01 revC1: get rid of squiggle on In2 layer
    [glasgow.kicad_pcb]
2019-04-01 revC1: tweak 1V2 plane and prettify some traces
    [glasgow.kicad_pcb]
2019-04-01 revC1: change AUX pin header .05" -> .1"
    [glasgow.kicad_pcb, io_banks.sch]
2019-04-01 revC1: update fab layers
    [glasgow.kicad_pcb]
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2019-04-01 revC1: make I/O connector pin 20 NC
    [glasgow.kicad_pcb, glasgow.sch, io_buffer.sch]
2019-04-02 revC1: add inline resistors to AUX/SYNC, add testpoints to rear
    [glasgow.kicad_pcb, glasgow.sch, io_banks.sch]
2019-04-03 applet.internal.benchmark: fix throughput for loopback mode.
    Loopback mode transfers everything twice, so it's double the value
    currently shown.
    Also, show values in Mbps as well.
2019-04-03 device.hardware: only cancel submitted transfers.
    Before this commit, cancelling the future after the transfer has
    already finished would result in a LIBUSB_ERROR_NOT_FOUND exception
    raised in the done callback.
2019-04-03 gateware.i2c: load new data after each byte is read.
    Also, fix testbench to release SDA after writing a bit.
    [i2c.py]
2019-04-04 gateware.i2c: fix fencepost error in reads.
    The ACK period would be interpreted as starting one bit time too
    early, and SDA would be released. Not only that is a fencepost error,
    but releasing SDA during the sample half-period is illegal; it would
    be correctly detected as a stop condition, terminating trasnaction.
    This commit reworks the read part of the FSM to only change SDA level
    during setup half-period, and fixes the fencepost error.
    [i2c.py]
2019-04-04 fx2.FX2Arbiter→fx2_crossbar.FX2Crossbar
    It's not so much an arbiter (there's only one bus master, the FPGA)
    as a crossbar switch with an integrated control signal sequencer.
2019-04-05 revC1: add io port pinout to back silkscreen
    Shortened version with just numbers, V instead of Vio, aligned numbers
    [glasgow.kicad_pcb]
2019-04-05 support.logging: dump_hex: show total bytes, not elided bytes.
    It's not actually clear how many bytes are shown, so printing how
    many bytes are elided isn't helpful at all. Instead, print the total
    count, which is handy e.g. to see if a complete packet was received.
2019-04-06 applet.memory.onfi: mark as preview-quality again.
    The applet works decently enough, but the parallel bus should really
    use IOB registers. It is not completely clear but this might be
    the cause of read errors that manifest as single bit flips.
    The reason I suspect these errors aren't inherent to the memory
    itself is because they seem to correlate with the wire length in
    my wiring harness. See #116 for details.
    In principle, these single bit flips aren't too bad as the flash is
    supposed to be read with ECC anyway, but we don't implement any ECC,
    and moreover I don't feel comfortable signing off on an applet with
    known data corruption issues. (It'd be much worse if the bit flip
    happened in t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
2019-04-06 applet.memory.onfi: increase wait states to 3.
    This is a band-aid at most; we really need to rewrite this part of
    the applet properly. However, without this band-aid, currently
    not even the ONFI parameter page can be read reliably.
2019-04-06 applet.memory.onfi: print ID signature.
    This could be used e.g. with Flash Extractor.
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2019-04-07 revC1: fix some ERC errors
    [glasgow.sch, io_banks.sch]
2019-04-07 revC1: add ESD protection to IO banks
    [glasgow.kicad_pcb, io_buffer.sch]
2019-04-07 revC1: fix U32 reference size
    [glasgow.kicad_pcb]
2019-04-07 revC1: s/LVDS Bank/LVDS/
    [glasgow.kicad_pcb]
2019-04-07 revC1: add a TVS protection diode to SYNC
    [glasgow.kicad_pcb, glasgow.sch, io_banks.sch]
2019-04-07 revC: tiny changes to text placement on schematic for readability.
    [glasgow.sch, io_banks.sch, io_buffer.sch]
2019-04-07 revC1: add UDFN-18 package model
    [glasgow.kicad_pcb]
2019-04-07 revC1: make the routing around the ESD protection more uniform
    [glasgow.kicad_pcb]
2019-04-07 gateware.fx2_crossbar: rework to handle pipelining. (UPDATE FIRMWARE)
    This commit reverts all PF changes and avoids relying on FF to handle
    IN FIFO. Instead, the level of FX2-side FIFO is now mirrored on
    the FPGA side, and PKTEND is asserted at precisely the right cycle.
    Moreover, ZLPs are now sent when appropriate to avoid apparent hangs
    when issuing BULK IN URBs that are larger than one packet size.
    This commit doesn't yet correctly re-register the signals that are
    FX2 outputs, but it's very close.
    Overall, the crossbar is significantly simpler, shorter, faster and
    more reliable now, and the firmware is smaller.
    [fifo.c, fx2_crossbar.py]
2019-04-07 revC1: switch to a SOD-523 diode for the SYNC protection
    [glasgow.kicad_pcb, io_banks.sch]
2019-04-07 gateware.fx2_crossbar: re-register FX2 outputs.
    At last, this can be done safely, by extending the pipeline logic by
    one more stage. This adds a wait state, but we can fix that later.
    This improves Fmax by a factor of 1.5-1.8.
    Fixes #89 (again).
    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
    [fx2_crossbar.py]
2019-04-07 device.config: fix typo.
2019-04-07 access.direct: select configuration with optimal pipe count.
    This significantly improves throughput in case of one used pipe.
2019-04-08 revC1: add 10k pull-up to SYNC pin
    [glasgow.kicad_pcb, io_banks.sch]
2019-04-08 revC1: fix U32 reference size again.
    Derp.
    [glasgow.kicad_pcb]
2019-04-08 revC1: move J5 reference away from mounting screw
    [glasgow.kicad_pcb]
2019-04-08 revC: add suggested J5 mating connector on schematic.
    [glasgow.sch, io_banks.sch]
2019-04-09 revC1: add USB testpoints to the rear
    [glasgow.kicad_pcb, glasgow.sch, io_banks.sch, io_buffer.sch]
2019-04-09 revC1: fix USB testpoint silkscreen/fab
    [glasgow.kicad_pcb]
2019-04-09 revC1: simplify a trace
    [glasgow.kicad_pcb]
2019-04-10 revC: add a few detailed explanations on schematic.
    Also, where applicable, move text to match moved symbols, and remove
    clearly outdated text.
    [glasgow.sch, io_banks.sch, io_buffer.sch]
2019-04-11 revC: correct the explanation for GBIN0/1 balls being shared.
    [io_banks.sch]
2019-04-13 Add ESD protection diodes for the AUX header too
    [glasgow.kicad_pcb, io_banks.sch]
2019-04-13 revC1: add protection resistor to FPGA Sync pin
    Closes: #125
    Closes: #126
    [glasgow.kicad_pcb, io_banks.sch]
2019-04-13 revC1: add 1V2 testpoint to the rear
    Also fix some testpoint value tags
    [glasgow.kicad_pcb, glasgow.sch]
2019-04-14 gateware.uart: allow reconfiguring baud rate at runtime.
    If never changed this register will be eliminated by the synthesizer.
2019-04-14 applet.interface.uart: perform most baud rate changes at runtime.
    The divisor register is intentionally not kept wider than what's
    needed for 9600 baud since that would negatively impact Fmax.
    Nevertheless if you do request such a low baud rate it is still
    supported, just with more bitstream rebuilds.
2019-04-14 device.simulation: fix {read,write}_register APIs to match hardware.
2019-04-14 applet.interface.uart: count and display receive errors.
    [uart.py]
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2019-04-16 revC1: Added BOM management keys to the schematic.
    This is needed for 1BitSquared production management.
    [glasgow.sch, io_banks.sch, io_buffer.sch]
2019-04-21 revC1: Updated part information and datasheet links
    - Added resistor network datasheet/part number
    - Updated blue, white, pink LED datasheet/part numbers
    - Updated capacitor datasheets/part numbers
    - Updated resistor part numbers
    - Added MPN/Mfg fields for
    * PCA6408APW
    * SN74LVC1T45DRL
    * ATECC508A
    * MG2040
    * ESD5Z5.0T1G
    - Added information for ferrite bead (600 ohm jellybean)
    - Fixed typo (MG2048 -> MG2040)
    [glasgow.kicad_pcb, glasgow.sch, io_banks.sch, io_buffer.sch]
2019-04-22 create footprint for 3.5mm mounting hole with courtyard
2019-04-22 revC1: increase mounting hole size from 3.2mm to 3.5mm, add courtyard space around
    - 3.2mm is the standard mounting hole size for M3 screws. But this requires tight
    tolerances that sometimes are difficult to achieve with hobbyist tools. 3.5mm
    allows for more tolerance
    - a M3 washer has 7mm outer diameter. A 3mm screw+washer can be offset 0.5mm in a
    3.5mm hole -> 8mm space necessary around the center of the hole. Add 1mm
    clearance + tolerance around gives a 10mm diameter courtyard keepout zone
    - change to a pad style with small vias in it because the vias slightly increase
    the adhesion of the copper to the FR4 material. I think it also looks nice.
    [glasgow.kicad_pcb, glasgow.sch]
2019-04-22 revC1: move R5 and R6 out of the mounting hole courtyard
    [glasgow.kicad_pcb]
2019-04-22 revC1: add caution text about screw & washer conflicts to drawings layer
    [glasgow.kicad_pcb]
2019-04-22 revC1: relocate VSENSE divider silkscreen away from screws
    Also move things around a bit with the VSENSE filters; they are now more
    symmetrical even.
    [glasgow.kicad_pcb]
2019-04-22 revC1: fix fab layers
    [glasgow.kicad_pcb]
2019-04-24 applet.memory.floppy: add doc reference for System 34 track format.
2019-04-24 revC1: add Vio active LEDs, misc fixes
    - Move some vias that were gratuitously intruding into pads
    - Update footprints that changed names upstream
    - Beauty fixes
    [glasgow.kicad_pcb, glasgow.sch, io_banks.sch, io_buffer.sch]
2019-04-24 revC1: clean up some datasheet links & MPNs
    [glasgow.sch, io_banks.sch, io_buffer.sch]
2019-04-24 revC1: fix silkscreen borkage due to footprint updates
    Also fix some inconsistencies in silkscreen fonts
    [glasgow.kicad_pcb]
2019-04-24 revC1: fix fab layer too
    [glasgow.kicad_pcb]
2019-04-24 revC1: add TLV733/755/757 in DFN-6 footprint to library
2019-04-24 revC1: Replace 1V2/3V3 regulator with TLV755/733 series
    [glasgow.kicad_pcb, glasgow.sch]
2019-04-24 revC1: Add extra vias to the 1V2 regulator top side
    [glasgow.kicad_pcb]
2019-04-24 revC1: get rid of 3V3 plane stitch across top side
    No longer needed since the 1V2 trace does not cut through as far down
    now.
    [glasgow.kicad_pcb]
2019-04-24 revC1: make space for and add silkscreen label for VIO LEDs
    Based on idea by @electroniceel
    [glasgow.kicad_pcb]
2019-04-25 revC1: improve routing around U21
    This should make it easier to drop down a Vio protection resistor to the
    bottom side if we do so.
    [glasgow.kicad_pcb]
2019-04-25 revC1: minor nudge
    [glasgow.kicad_pcb]
2019-04-25 revC1: add series current limiting resistors to Vio
    [glasgow.kicad_pcb, glasgow.sch, io_buffer.sch]
2019-04-25 revC1: tweak some traces, move vias away from Sync silkscreen
    [glasgow.kicad_pcb]
2019-04-25 revC1: run a trace/via cleanup pass, adjust 1V2 plane settings
    [glasgow.kicad_pcb]
2019-04-25 revC1: more minor adjustments
    [glasgow.kicad_pcb]
2019-04-25 revC1: fix NONO_HANA silk art geometry
    No longer self-intersecting, also coords rounded to 1um grid.
    [glasgow.kicad_pcb]
2019-04-25 revC1: double up protection resistors on the rear side
    One as DNP for now, might end up being a parallel pair to spread out
    dissipation.
    [glasgow.kicad_pcb, io_buffer.sch]
2019-04-25 revC1: remove MPN/etc for DNP resistor
    [io_buffer.sch]
2019-04-26 applet.memory.floppy: change pinout to allow straightforward crimp.
    This also adds support for both pins in DRVSA/B and MOTEA/B pairs.
    Currently both DRVSx pins are enabled, which allows connecting
    a single floppy no matter how it is keyed. This might be changed
    in the future in the unlikely case that someone wants to connect
    two floppy drives to one Glasgow.
    REDWC is essentially omitted as we don't (directly) support either
    5.25" drives (no reason other than me not having one) or any writes
    at all (not implemented yet).
2019-04-30 revC1: fix LM3880MF EN divider for 4.1V brownout
    This takes into account the internal current source, and also eliminates
    one BOM resistor value.
    [glasgow.kicad_pcb, glasgow.sch, io_buffer.sch]
2019-04-30 revC1: add 100uF bulk decoupling to 5V rail
    Issue: #135
    [glasgow.kicad_pcb, glasgow.sch, io_buffer.sch]
2019-04-30 revC1: change Vio current limit resistors to 0.68 ohms
    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
    [glasgow.kicad_pcb, io_buffer.sch]
2019-04-30 revC1: change regulator EN pulldowns 100k -> 10k
    Closes: #135
    [glasgow.kicad_pcb, glasgow.sch]
2019-04-30 revC1: add additional current-carrying vias to USB GND
    [glasgow.kicad_pcb]
2019-04-30 revC1: rotate U15 90deg, swap D1/D2 pins
    This simplifies the VBUS routing and avoids several layer crossings
    [glasgow.kicad_pcb, glasgow.sch]
2019-04-30 revC1: bump 5V cap to 150µF
    [glasgow.kicad_pcb, glasgow.sch]
2019-04-30 revC1: update 5V capacitor footprint & datasheet
    Mouser datasheet is wrong, lol.
    [glasgow.kicad_pcb, glasgow.sch]
2019-04-30 revC1: move C87 up slightly, relocate CLKIF label
    Just to keep it further away from U2.
    [glasgow.kicad_pcb, glasgow.sch]
2019-04-30 revC1: add testpoints for raw DAC output
    Also tweak some other testpoint silkscreen markings
    [glasgow.kicad_pcb, io_buffer.sch]
2019-04-30 revC1: spread apart rear USB testpoints some more
    [glasgow.kicad_pcb]
2019-04-30 revC1: make serial number box solid white, increase size
    [glasgow.kicad_pcb]
2019-04-30 revC1: make the serial number field larger still, center actual box
    [glasgow.kicad_pcb]
2019-05-01 revC1: nudge some traces
    [glasgow.kicad_pcb]
2019-05-01 revC1: revC? -> revC1
    [glasgow.kicad_pcb]
2019-05-01 revC1: nudge SDA/SCL testpoints a bit
    [glasgow.kicad_pcb]
2019-05-01 revC1: adjust "Serial no" text in the rear to clash less with via
    [glasgow.kicad_pcb]
2019-05-01 revC1: remove DNP part models & add DNP field in sch
    [glasgow.kicad_pcb, glasgow.sch, io_banks.sch, io_buffer.sch]
2019-05-01 revC1: Updated BOM management keys in the schematic.
    [glasgow.sch, io_buffer.sch]
2019-05-01 revC1: disable solder paste for DNP footprints
    [glasgow.kicad_pcb]
2019-05-01 revC1: get rid of spurious thermal connections to GND layer
    [glasgow.kicad_pcb]
2019-05-01 revC1: change bulk decoupling cap to polymer in 1b2 key
    [glasgow.sch]
2019-05-01 revC1: reduce count of different resistor values
    [glasgow.kicad_pcb, glasgow.sch, io_banks.sch]
2019-05-01 revC1: nudge two vias around the ESD diode arrays
    [glasgow.kicad_pcb]
2019-05-02 Add Molex_KK-254_1x02_P2.54mm_Horizontal.wrl 3D model
    Modified from upstream kicad libs:
    Connector_Molex.3dshapes/Molex_KK-254_AE-6410-02A_1x02_P2.54mm_Vertical.wrl
    Connector_PinHeader_2.54mm.3dshapes/PinHeader_1x02_P2.54mm_Horizontal.wrl
2019-05-02 Add Molex_KK-254_1x02_P2.54mm_Horizontal footprint
    Modified from upstream _Vertical version
2019-05-02 revC1: replace Sync connector with proper Molex KK footprint
    [glasgow.kicad_pcb, io_banks.sch]
2019-05-02 revC1: move AUX and J10 silkscreen labels
    [glasgow.kicad_pcb]
2019-05-02 revC1: another minor tweak around AUX area
    [glasgow.kicad_pcb]
2019-05-02 revC1: add G/S labels under Sync connector, judge surrounding vias
    [glasgow.kicad_pcb]
2019-05-02 revC1: move via away from Sync
    Whoops. Nothing to see here, please move along.
    [glasgow.kicad_pcb]
2019-05-02 revC1: final adjustments to fab layers
    [glasgow.kicad_pcb]
2019-05-02 revC1: remove gunk from fab layer, adjust plot settings
    [glasgow.kicad_pcb]
2019-05-02 revC1: mirror "Wave soldering keepout" on Fab.B to match rest of text
    [glasgow.kicad_pcb]
2019-05-02 revC1: move caution text closer to board
    makes it center more nicely in fab output
    [glasgow.kicad_pcb]
2019-05-02 revC1: hide 1V2 label from B.Fab layer
    [glasgow.kicad_pcb]
2019-05-02 revC1: add fabrication outputs
    [bom.csv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]
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2019-05-03 applet.program.avr.spi: use SPI interface delays, not host delays.
2019-05-03 gateware.clockgen: avoid spurious stb_r/stb_f pulses.
    [clockgen.py]
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2019-05-04 applet.memory.floppy: fix raw data format screwup.
2019-05-04 applet.memory.floppy: fix erroneous track counts everywhere.
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2019-05-06 applet.memory.floppy: fix track/cylinder confusion.
2019-05-06 applet.memory.floppy: remove read-track operation.
    This is really a debug function best performed on dumps, not live.
2019-05-06 applet.memory.floppy: decrease frequency gain by 2×.
    By observing that frequency requires changes much less than phase,
    this modification improves stability of the loop greatly on data with
    particularly large jitter.
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2019-07-03 applet.internal.benchmark: suppress setting pull resistors.
    We're not really interested in any electrical port features, so just
    pass args=None everywhere.
2019-07-03 applet.interface.uart: fix py3.6 compatibility.
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2019-07-24 RevC1: Added missing component MPN/Mfg values
    [glasgow.sch, io_banks.sch]
2019-07-24 gateware.i2c, applet.interface.i2c_master: minor fixes. NFC.
    [i2c.py]
2019-07-24 gateware.i2c: make clock stretching actually work.
    Oops... see m-labs/nmigen#159.
2019-07-24 applet.interface.i2c_master: reset count to 0 if unacked.
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2019-07-25 gateware.i2c: avoid SCL and SDA edges close to each other.
    [i2c.py]
2019-07-25 applet.sensor.scd30: use a prime for polling readiness.
    This avoids harmless but annoying situation where the measurements
    have a lot of jitter at small intervals.
2019-07-25 gateware.i2c: fix off-by-2× error in period.
    [i2c.py]
2019-07-25 gateware.i2c: simplify, remove incoherent "SDA stretching" (??) code.
2019-07-25 cli: fix incorrect help text for --filter-log.
2019-07-25 applet.{display.pdi,program.avr}: disable autoflush.
    This improves performance, and also there appears to be an autoflush
    related race condition with the crossbar currently.
2019-07-25 gateware.fx2_crossbar: pend should set nrdy.
    Not doing this causes intermittent, extremely rare losses of 1 byte
    packets when they immediately follow the PKTEND strobe that ends
    the previous packet and that packet also fills the last FX2 FIFO.
    Wow. What a nasty bug.
    [fx2_crossbar.py]
2019-07-26 revC1: Swap miss labelled 1V2/3V3 regulator MPNs
    [glasgow.sch]
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2019-07-27 applet.program.ice40_sram: simplify. NFC.
    Reset pin is required anyway.
2019-07-27 access.direct.demultiplexer: introduce non-blocking flushes
    flush([wait=True]) ensures that all written data has been sent to
    the device. flush(wait=False) on the other hand ensures that all
    written data has been queued as USB URBs, but does not wait for them
    to complete.
    Use flush(wait=False) to ensure that every last byte of queued data
    will make it to the device in a timely manner, without stalling
    the entire USB transfer pipeline.
2019-07-27 applet.video.ws2812_output: use non-blocking flush
    We need to make sure that all video data will make it to the Glasgow
    in a timely manner, to avoid "tearing" the frame (the LEDs cannot
    handle gaps longer than a few microseconds in the data stream without
    triggering a premature latch/reset), but we don't necessarily want to
    wait for the data to actually be sent.
2019-07-27 cli: remove `run --bitstream`, add `run-prebuilt [BITSTREAM]`.
    The former isn't that useful currently (most of its uses probably
    should be replaced with a 2-line Python file that instantiates
    GlasgowHardwareDevice() directly), and the latter has actual use
    case: prebuilding bitstreams on a machine that has the FPGA toolchain
    to use them on a machine that does not, as well as testing bitstreams
    received from someone else. Both cases require the applet code to be
    actually run.
2019-07-28 applet.program.avr.spi: fix bit rot.
    [spi.py]
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2019-07-29 cli: allow replacing interact stage of every applet with a REPL.
    And remove most repl subcommands (though, keep the customized ones,
    and add some logic to steer people towards them, if they exist).
2019-07-29 applet.sensor.mouse_ps2: new applet.
    Also, unflag ps2_host as preview, since it seems quite stable, and
    appears to handle edge cases sufficiently well.
2019-07-30 applet.interface.ps2_host: fix multiple setup/hold timing violations.
    This worked with TrackPoint mostly by chance, but not with any other
    devices...
2019-07-30 applet.{interface.ps2_host,sensor.mouse_ps2}: add historical docs.
    Mostly deductions on the decision process behind assignment of
    command numbers.
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2019-07-31 applet.sensor.mouse_ps2: uinput: fix handling of wheel.
2019-07-31 applet.sensor.mouse_ps2: explain difference in handling of EE. NFC.
2019-08-01 applet.interface.jtag_probe: refactor to support other transports.
    Such as cJTAG or Spy-Bi-Wire.
    Simplify it while we're at it.
2019-08-01 applet.interface.jtag_probe: allow specifying TDI for shift_tms.
    This is potentially useful for magic sequences involving switching
    between interfaces, but isn't currently used anywhere. (The interface
    I implemented this for turned out to require a different kind of
    magic sequence.)
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2019-08-02 Replace inappropriate uses of bitarray with support.bits.
    * Never trip up on endian="little" again.
    * Never reverse bit literals compared to the datasheet again.
    * Rely only on Python builtins and not C extensions.
    A few cases (JESD3C fuses, PDI bitmaps) actually call for a bitarray,
    so those are kept as-is.
    [jtag.py]
2019-08-02 applet.interface.jtag_probe: add explicit support for sideband signals.
    One example of a sideband signal is TRST#, already present, but other
    ones are also useful, for example SRST#, device programming signals
    like PROGRAM#, and also alternative transport layers, which might use
    these sidebands internally.
    A number of pulse_trst() calls has been removed from other applets
    on the grounds that the TRST# driver (if TRST# is present) is enabled
    by default, and so TMS-driven reset should be sufficient for most
    use cases. The reset argument to JTAGProbeApplet.run() may later be
    exposed via a command line argument as well, in case some devices
    turn out to need an explicit TRST# pulse.
2019-08-03 applet.interface.spi_master: redesign command set to be like jtag_probe.
    The JTAG probe applet has a very nice orthogonal command set, more
    applets should be like it. In the future, the SS# line should be
    changed to be an ordinary aux signal, and all dependent applets with
    aux signals in registers should be redesigned to use those.
2019-08-04 applet.program.xc9500xl: be more resistant to incorrect connections.
    Before this commit, if IR length does not match, identify() asserts.
2019-08-05 arch.xilinx.xc6: explain the nature of JTAG configuration flow.
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2019-08-05 applet.interface.jtag_probe: set TRST# to inactive by default.
    I think this was a mistake, flipped polarity. The default applet flow
    does not pulse TRST#, which should be fine given that TRST# is rarely
    useful and not relying on it is a good idea; the main function of
    --pin-trst is for SVF and to drive it to inactive level.
2019-08-06 firmware: work around a bug in SDCC 3.5.
    [main.c]
2019-08-06 firmware: fix type of glasgow_config.revision.
    [glasgow.h]
2019-08-06 software: only build the library part of libfx2.
    Building all of it wastes time and has problems in case some parts
    (not used in Glasgow) tickle compiler bugs.
2019-08-06 cli: add `safe`, a command to turn off Vregs and drivers quickly.
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2019-08-06 cli: allow overriding revision requirement.
    This is useful for hacked revA/B devices that had the FXMA removed
    and replaced with a 0R bank, for 3V3 only operation.
2019-08-07 Commit missing parts of 1639a25f.
    [spi.py]
2019-08-07 applet.audio.dac: add support for connecting to a PCM source socket.
    Works with Linux desktop!
2019-08-16 begin schematics for the power monitoring part of the test jig
    [test-jig.kicad_pcb, test-jig.sch]
2019-08-16 test-jig schematics: add switchable connection between the ports
    [port-connection.sch, test-jig.sch]
2019-08-16 test-jig schematics: add pcb with status leds
    [led-board.sch, port-connection.sch, test-jig.sch]
2019-08-16 test-jig schematics: make i2c address pins easier to bodge, add some more testpoints
    [port-connection.sch, test-jig.sch]
2019-08-16 test-jig schematics: set resistor values for the window comparators
    [test-jig.sch]
2019-08-16 test-jig schematics: optimize to common connector types, some cleanup
    [led-board.sch, port-connection.sch, test-jig.sch]
2019-08-16 test-jig schematics: annotate and ERC fixup
    [led-board.sch, port-connection.sch, test-jig.sch]
2019-08-16 test-jig schematics: small improvements
    [led-board.sch, port-connection.sch, test-jig.sch]
2019-08-16 test-jig schematics: increase resistance of local i2c pullups to 22k
    4k7 might conflict with the max allowed current of some components on Glasgow.
    It is a tradeoff against contact bounce when connecting the board, so do not increase
    the value too much.
    [test-jig.sch]
2019-08-16 test-jig schematics: fix & improve comments
    [test-jig.sch]
2019-08-16 test-jig schematics: change from start button to a power switch with autodetect
    Powering off the jig & dut will prevent any glitches due to contact bounce and similar effects.
    [port-connection.sch, test-jig.sch]
2019-08-16 test-jig schematics: add pdf for more conveniant access
2019-08-16 test-jig schematics: further reduce bom count
    change all connectors to pogo pins to ones with 6 connections.
    Will probably use some lever-type terminals like Wago 233 or Metz AST 041
    for these. The 6 connection ones are easier to source for both types.
    [port-connection.sch]
2019-08-16 test-jig schematics: fix typo
    [test-jig.sch]
2019-08-16 test-jig: assign footprints (except terminals to pogo pins)
    [led-board.sch, port-connection.sch, test-jig.sch]
2019-08-16 test-jig: add terminal block footprint (Metz AST04106) and assign it
    [port-connection.sch, test-jig.sch]
2019-08-16 test-jig: use smaller footprints for '4066 and '2G14
    [port-connection.sch, test-jig.sch]
2019-08-16 test-jig: re-orient some of the connectors to better match the intended layout
    [led-board.sch, port-connection.sch, test-jig.sch]
2019-08-16 test-jig: pcb edges, initial placement of connectors
    [test-jig.kicad_pcb]
2019-08-16 test-jig: reduce space needed for testpoints and solderjumper
    - use smaller solderjumpers footprints
    - 2 solderjumpers for I2C address selection instead of solderjumper + testpoint
    - smaller testpoint footprints
    [port-connection.sch, test-jig.kicad_pcb, test-jig.sch]
2019-08-16 test-jig: all tracks routed
    [port-connection.sch, test-jig.kicad_pcb, test-jig.sch]
2019-08-16 test-jig: properly position references on silkscreen
    [test-jig.kicad_pcb]
2019-08-16 test-jig: add pin descriptions to silkscreen
    [test-jig.kicad_pcb]
2019-08-16 test-jig: small improvements to ground plane
    [test-jig.kicad_pcb]
2019-08-16 test-jig: route led pcb
    [test-jig.kicad_pcb]
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2019-08-16 test-jig: add page notes to layout
    [test-jig.kicad_pcb]
2019-08-16 test-jig: add some board renderings for easy display
2019-08-16 test-jig: minor silkscreen improvement
    [test-jig.kicad_pcb]
2019-08-21 gateware.analyzer: adjust for nMigen.
    There were three issues:
    * nMigen SyncFIFOBuffered no longer provides access to the inner
    FIFO. Therefore, level of the outer FIFO is used instead.
    * nMigen simulator no longer allows setting Signals that are not
    actually used anywhere in simulation.
    * In nMigen, FIFOInterface.read() is 1-cycle, not 2-cycle.
    This requires adjustment of our read loop (which would ideally
    be rewritten.)
    [analyzer.py]
2019-08-21 gateware.pll: adjust for nMigen.
    This doesn't include adjustments for gateware.platform. Fortunately,
    only a few applets use PLL, so this can be done later.
    [pll.py]
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2019-08-21 gateware.fx2_crossbar: adjust for nMigen.
    nMigen now provides XDR in the platform layer, so it is no longer
    necessary to instantiate SB_IO.
    [fx2_crossbar.py]
2019-08-21 access.direct.multiplexer: adjust for nMigen.
    nMigen build plans contain all files, including the constraint files,
    so it is no longer necessary to track IO placement in attributes.
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2019-08-23 revC1: swap regulator library references
    This was missed in f1772ca
    [glasgow.sch]
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2019-08-24 applet.audio.yamaha_opl: pad the end of VGM file with silence.
    Without this, some VGM files result in a few (~16 on one exmaple)
    fewer samples produced than expected. I've spent many hours trying
    to track this down and fixed many other bugs, but the exact cause
    of this eludes me. (It could do something with overclocking, or
    maybe missing synchronization--but overflows now hard-stop the audio
    bitstream receiver, so it has nothing to do with overflows.)
    Although I would rather have a clean solution to this problem, by
    this point spending any more time on it seems pointless, and
    the workaround isn't particularly bad anyway.
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2019-08-25 applet.sensor.scd30: influxdb: add timeouts.
    For unknown reasons SCD30 sometimes times out with the Glasgow
    I2C applet.
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2019-08-28 support.asignal: fix thread unsafety.
2019-08-28 device.hardware: correctly handle asynchronous libusb cancellation.
2019-08-28 device.hardware: shut down libusb polling thread.
    Not doing this can cause a hang at interpreter shutdown because
    python-libusb1 calls libusb_close() in __del__, which causes libusb1
    to take a lock, which might have been taken by the daemon poller
    thread, which might have already been killed (without releasing
    the lock) by the time __del__ is called.
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2019-08-28 device.hardware: short-circuit USB callback during shutdown.
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2019-09-23 applet.program.ice40_sram: remove useless condition.
    The reset pin is not optional anymore.
2019-09-27 device.hardware: start USB poller thread only after enumeration.
    USB poller threads are unfortunately deadlock-prone (see 4de70043),
    so if we start it before enumeration and enumeration fails, we have
    to clean it up. Since we only use synchronous API during enumeration,
    it's easier to delay starting the poller thread.
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2019-09-28 Revert "cli: make output legible on black-on-white terminals too"
    This reverts commit b6c88afc4417c82c8f9db70a2a380e3d1e30aca1.
    This made the trace text look indistinguishable from info text,
    making debugging unnecessarily difficult.
2019-09-29 applet.audio.yamaha_opl: do unsigned→signed conversion in gateware.
    Pretty much everything (WebAudio, samplerate, WAV, ...) uses signed
    samples instead of unsigned, so it's silly that we have to use numpy
    just to shift everything by 0x8000.
2019-09-29 applet.audio.yamaha_opl: fix mounting at a path.
2019-09-30 applet.interface.uart: remove `tty --cr`.
    It looks like the default mode (no --cr) only ever works by accident,
    so let's get rid of it instead. (But maybe I'm wrong? Unix TTY is
    not my strong point.)
2019-09-30 applet.audio.yamaha_opl: move resampling to client side.
    This gives better results latency-wise, could (in principle; not
    currently implemented) handle context sample rate changing during
    playback (which WebKit can apparently do), and also makes downloaded
    WAV files true to the original PCM data.
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2019-10-02 firmware: let bitstream overflow into FX2_MEM.
    The HX8K bitstream is very slightly larger than ICE_MEM. It is not
    practical to use a larger memory due to I2C addressing issues. Due
    to my foresight of issues like this, I made FX2_MEM twice as large
    as the largest FX2 firmware, so now we can stuff the ~0x1000 extra
    bytes of the bitstream into FX2_MEM, and still have 0x3000 bytes
    of Free Real Estate left.
    This commit also reports failures during loading of flashed bitstream
    by lighting up the error LED instead of ignoring them.
    Fixes #164.
    [main.c]
2019-10-03 hardware/boards/glasgow: explain the function of R40.
    [glasgow.sch, io_banks.sch, io_buffer.sch]
2019-10-03 target.analyzer: fix initial IO/OE update.
    Broken during nMigen migration.
    [analyzer.py]
2019-10-06 applet.sensor.ina260: add applet for the INA260 I2C power monitoring IC.
2019-10-06 firmware: fix pipe names to match software.
    [main.c]
2019-10-06 applet.interface.i2c_master: replace "scan-read" and "scan-write" commands with "scan"
    "-r", "-w" and "-rw" allow to select which type of addresses to scan.
    "-rw" is the default.
    Some devices only ACK one of the addresses, so scanning both gives
    a better overview of the bus.
2019-10-06 applet.interface.i2c_master: move scan command from interact to I2CMasterInterface
    Allows to use it from other applets or the repl interface
2019-10-06 applet.interface.i2c_master: do write scanning before read scanning to reduce possible side-effects
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2019-10-08 software,firmware: fix factory programming.
    The new device detection code (introduced in 3ff1f20a) does not work
    if the device reenumerates with Glasgow VID/PID, so make it enumerate
    with the default Cypress VID/PID.
    [glasgow.h, main.c]
2019-10-15 applet.debug.mips: restrict Rocc handshaking to EJTAG >2.0.
    BMIPS seems to support it, but Lexra does not, even though both are
    EJTAG 2.0, so disable it on EJTAG 2.0 completely.
    Also, print every CONTROL bit, instead of only the overridden one.
2019-10-16 device.hardware: symbolize transfer errors.
2019-10-21 applet.audio.yamaha_opx: allow user-defined command stream filters.
    E.g. for glitching.
2019-10-30 revC1: update PCB from schematic (fix regulator values)
    [glasgow.kicad_pcb]
2019-10-30 revC1: update fabrication outputs with regulator swap
    No gerber changes, just BOM, schematic, and fabrication diagram
    [bom.csv]
2019-11-05 cli: Fix voltage command help.
2019-11-18 applet.program.{nrf24l→nrf24lx1}
    It's a bit ambiguous to have both radio.nrf24l and program.nrf24l,
    so let's do radio.nrf24l01 and program.nrf24lx1.
2019-12-31 applet.sensor.bmp280: reset the sensor on startup.
2019-12-31 applet.sensor.bmp280: fix reset-on-error code path.
2020-01-13 applet.memory.24x: use chunked reads.
    Currently the I2C applet cannot handle reads of 64K and more,
    and 64K I2C EEPROMs exist; before this commit, trying to read exactly
    64K from one would result in a hang.
2020-01-13 s/master/initiator/ s/slave/target/ in I2C-related code.
    I was going to do this for a while, given that even the specification
    itself has to explain that "master" is the device that is initiating
    a transaction, etc.
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2020-01-13 gateware.i2c: fix stop strobe to follow documented behavior.
    [i2c.py]
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2020-01-13 gateware.i2c: add experimental clock stretching support for target.
2020-01-13 applet.interface.i2c_target: add generic I2C target applet.
    This applet uses clock stretching to handle transactions on the host.
    Unfortunately this excludes many interesting uses of such an applet.
2020-01-14 applet.interface.uart: add repl command.
    Useful for playing with binary interfaces over UART, for example
    MCU bootloaders.
2020-01-19 README: clarify timing claims; make "minimal effort" more realistic.
    In this case "minimal effort" refers to using 2FF synchronizers and
    a simple FSM driven by the system clock, which, when using revC at
    48 MHz will not exceed 12 Mbps data rate. However, virtually anyone
    with a minimal knowledge of HDL is able to implement applets that
    use this technique.
2020-01-19 revC1: fix formatting issue in BOM.
    Line 21 was missing several columns.
    [bom.csv]
2020-01-19 applet.audio.yamaha_opx: relax timeout.
    The current value is way too aggressive and leads to spurious
    timeouts in some conditions. The only purpose of this timeout is
    to guard against a hung undervolted chip, so the exact value is
    not very important, only that it's not too long.
2020-01-25 applet.radio.nrf24l01: add repeat receive support.
    This also fixes a bug where the received packet would not be flushed
    from RX FIFO, which meant you could receive at most 5 packets before
    power cycling the device. Oops...
2020-02-03 firmware, device.hardware, applet.internal.selftest: add comments re nOE lines only existing on revAB
2020-02-03 firmware: rename PIND_OEQ_N to PIND_OEQ_N_REVAB
    PIND_OEQ_N is only connected on revAB and left floating on revC. Rename
    the pin to better reflect this.
2020-02-08 applet.interface.i2c_target: fix test.
2020-02-08 gateware.analyzer: disable broken FIFO tests.
    See issue #182.
    [analyzer.py]
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2020-03-03 revC schematics: fix recommended LVDS connector
    Fixes #172
    [io_banks.sch]
2020-03-07 applet.interface.{i2c_initiator,uart}: remove obsolete repl command.
    These weren't customized, so run-repl is a complete replacement.
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2020-03-22 support.data_logger: queue and batch data for InfluxDB.
    This results in much higher performance, allowing the use of ~100 Hz
    sample rate sensors than ~1 Hz rate. As a side effect, this feature
    also resubmits data that would previously be lost due to network
    errors. This may cause the queue to grow without bounds though.
2020-03-22 support.data_logger: always timestamp InfluxDB requests.
    To avoid missing data points when batching. This still relies on
    the system clock being high resoltion and could still result in
    missing data points. In principle there is no way to avoid missing
    data points completely (the user can specify lower precision than
    the sample rate), and while we could fudge timestamps in case we
    detect a low resolution system clock, that is almost certainly worse
    than just dropping those points entirely.
2020-03-22 applet.sensor.hx711: add configurable frequency source.
    This frequency source can drive the XI pin to allow a wider range for
    and more accuracy of the sample rate.
2020-04-02 applet.sensor.hx711: fix accession number.
2020-04-02 applet.sensor.{bmp280→bmx280}: add BME280 support.
    This is just for temperature and pressure, no humidity measurement
    yet.
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2020-05-25 applet.interface.uart: add --pulls option, for pull-up on RX.
    Useful if the buffer driving RX line is tristated, the DUT can be
    unpowered, certain multidrop scenarios, and so on.
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2020-07-04 applet.sensor.pmsx003: unmark as preview.
    Also, verified that it works fine with PMS7003.
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2020-07-26 applet.memory.prom: print values of unstable words.
    This can help e.g. with distinguishing signal integrity issues from
    bit rot issues.
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2020-07-27 applet.memory.prom: encourage (sic) metastability during reads.
    This change is tested with Atmel AT29C flash and may or may not have
    any effect on other memories. In case of this Atmel flash, output
    buffers have parasitic feedback (likely through power supply) and
    will oscillate if encouraged, e.g. if OE is kept asserted, or if data
    transitions are maximized.
2020-07-30 applet.program.avr: minor fixes. NFC.
    [spi.py]
2020-07-30 applet.interface.jtag_probe: flush after each REPL command.
    This is a great anti-frustration feature that I added to the global
    REPL command, but not to the applet-specific REPLs. Which led to
    great frustration.
2020-07-31 applet.program.avr.spi: fix address masks for EEPROM write.
    The masking is handled on an upper level anyway, since the lower
    interface doesn't know anything about the device.
    Before this commit, only 64 EEPROM bytes out of every 256 would be
    actually written. (It would then fail verification.)
    [spi.py]
2020-07-31 applet.program.avr: fix writing and verification of extra fuse.
    [spi.py]
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2020-08-17 applet.interface.uart: allow to invert the UART line signals (=idle low)
    Adds the --invert-rx and --invert-tx cli arguments and the corresponding
    build-time parameters to the uart gateware.
    [uart.py]
2020-08-27 applet.memory.prom: added support for latched shift registers for the address high bits
    Added and documented the --pin-a-lat latch drive option
    Added the address latch signal to the underlying hardware elaborate
    Added some comments to aid future readers
    Added two latch states to get a long enough pulse
    Made the latch states for the FSM only generate when the address latch signal does
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2020-10-03 device.hardware: split glasgow firmware loading and enumeration into a static method
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2020-10-10 cli: add the device to the REPL interface's context
2020-10-16 support.task_queue: clear done queue after cancellation.
    Since .cancel() waits until all live tasks are done, it is likely
    that the done queue will contain some cancelled tasks. If the done
    queue is not cleared, then the next poll()/wait_one()/wait_all() call
    will cancel the caller, which usually silently terminates it. In any
    case, semantically .cancel() discards the results of all tasks in
    the queue even if they completed before they were cancelled.
    This bug was introduced in commit a7d041f4.
    Fixes #202.
2020-10-24 update SPI signal terms to COPI / CIPO
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2020-10-25 database.ti.msp430: Initial import of device list from slau320ag
2020-10-27 hardware: Add 3d printed case
    [Glasgow_base.f3d, Glasgow_base.iges, Glasgow_base.stl]
2020-11-04 hardware: Rename laser cut case directory
    [bottom.dxf, top.dxf]
2020-11-04 hardware: Add 3D printed case lid
    [glasgow_magnetic_lid.f3z, glasgow_magnetic_lid.iges, glasgow_magnetic_lid.stl]
2020-11-04 applet.interface.jtag_pinout: fix misuse of sets.
    Since Python 3.7, dict iteration order is the insertion order.
    However, set iteration order is always arbitrary.
2020-11-04 applet.interface.jtag_pinout: always try to detect TRST#.
    On a certain device, jtag-pinout would detect a TAP without TRST#,
    but using it afterwards with jtag-openocd resulted in spurious debug
    session breakage. This was caused by spurious pulses on TRST#, which
    were in turn caused by a very weak TAP-side pull-up, TRST# being
    connected to but not driven by the applet, and TCK/TMS/TDIO wires
    being in close proximity to TRST#.
    To avoid this situation happening again, always detect TRST# if there
    is any chance it is connected at all.
2020-11-04 applet.interface.jtag_pinout: suggest voltage argument for probe.
    I've originally omitted this because it would not be (easily)
    possible once multi-applet support lands, but:
    a) this is probably the #1 largest source of frustration in
    the jtag-pinout applet, especially since it's used much more
    often to avoid wiring mistakes than to discover truly unknown
    JTAG pinouts;
    b) if the future multi-applet functionality can't support this,
    maybe we should rethink it rather than remove anti-frustration
    features to make code a bit simpler.
2020-11-05 applet.interface.jtag_probe: move XR scan limits to JTAGProbeInterface.
    Before this commit, these rarely useful options had to be threaded
    through a lot of unrelated code, which polluted interfaces and was
    done quite inconsistently.
    Also, do not call add_run_arguments() from add_run_tap_arguments().
    This was inconsistent with our conventions and required an `access`
    argument in add_run_tap_arguments() that was otherwise unnecessary.
2020-11-05 applet.interface.jtag_probe: remove scan_dr(zero_ok=) argument.
    Before this commit, this option used only in enumerate-ir had to be
    threaded through a lot of unrelated code, which polluted interfaces
    and made the logic hard to understand.
    Also, tighten the post-conditions on scan_xr_length() such that it
    always requires a valid scan result (finite non-zero length).
2020-11-05 applet.interface.jtag_probe: remove read_dr(idempotent=) argument.
    Before this commit, this unused option had to be threaded through
    a lot of unrelated code, which polluted interfaces. Moreover, since
    commit 42144aa6, it is also worse than useless, because scan_dr()
    does the exact same thing more safely (it does not rely on provided
    DR length).
2020-11-05 applet.interface.jtag_probe: don't track IR offsets. NFCI.
    Per-TAP IR offsets are redundant, pointless, and complicate the logic
    of specifying IR lengths manually.
2020-11-05 applet.interface.jtag_probe: completely rework error handling.
    JTAGProbeInterface historically suffered from underuse of exceptions;
    it was originally written to return void values on error paths since
    it strictly validates all input at every opportunity, and this does
    not survive collision with the real world. (Can you believe there are
    production JTAG devices where IDCODE is 32 zeroes?) Scanning, as well
    as any future manual overrides, have to relax validation greatly.
    Unfortunately, this approach caused proliferation of identical error
    handling code in every caller, error propagation boilerplate, and
    polymorphic return values. It was awful. This commit changes all
    remaining code to use e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
2020-11-05 Stuff all of the custom_repl infrastructure into a bonfire.
    Custom REPLs are very nice. custom_repl is awful for several reasons:
    1. It required the user to watch out for a warning and then
    remember to switch to a different, inconsistent command, or
    else experience strange breakage.
    2. It lacked any way to provide arguments to the REPL runner,
    which in turn was justifying the behavior in (1).
    3. It involved some incredibly gross metaclass code.
    4. It was completely unnecessary. All of the metaclass stuff has
    been replaced by a pair of methods that's easier to understand
    *and* provides more useful functionality (REPL arguments).
    I don't know what I was thinki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
2020-11-05 cli: rename commands run-repl→repl, run-script→script.
    The extra "run-" in the front isn't really necessary (both "repl" and
    "script" work pretty well as verbs). Also, since commit 2c7828f6,
    applets have a `repl()` method as well as a `run()` one, so it would
    be nice if they corresponded to the `repl` and `run` commands.
2020-11-05 cli: replace command run-prebuilt→{run,repl,script} --prebuilt[-at].
    It makes no sense to disallow using prebuilt bitstreams with REPL or
    script runner, so turn the command into an option.
    Also, clean up CLI help text a bit.
2020-11-05 cli, device.hardware: prepend bitstream ID to prebuilt bitstreams.
    This makes prebuilt bitstreams functionally identical to just-in-time
    built bitstreams; there are no warnings any more for using a prebuilt
    bitstream that exactly matches the build plan.
    Because prebuilt bitstreams are intended for resource constrained
    devices, i.e. they are often not easily rebuilt, loading a prebuilt
    bitstream with a mismatched ID only produces a warning. (It can't
    really be an error given that nMigen-produced RTLIL files embed
    file paths from the host system.)
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2020-11-09 applet.interface.uart: fix auto-baud detection
    This patch addresses two issues that prevented the UART auto-baud from
    operating correctly:
    1. It is critically imporant that `UART.bit_cyc` is never set to zero,
    doing so will render the UART gateware inoperable. To avoid this,
    the `auto_cyc` register is set to "all 1s" at reset.
    2. To ensure that a given initial baudrate is correctly loaded, it is
    important to permit the gateware to see the `use_auto` register
    with a value of `0`. This is achieved by moving the regiser write
    to after the applet is reset.
    If the gateware does not see the initial `0` value, then the
    `bit_cyc` register's default value of `0` will remain, loc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
2020-11-10 applet.debug.arm.swd: remove.
    This applet has never worked, and keeping it in-tree is misleading.
    It is also somewhat badly designed.
2020-11-10 applet.interface.jtag_probe: don't transmit XR header/trailer on wire.
    This has many benefits:
    * Selecting a TAP no longer requires copying all scan sequences;
    * TAPInterface implementation is now much simpler;
    * Log messages no longer have header/trailer clutter.
    The current implementation no longer allows custom headers/trailers.
    This is an extremely obscure capability. If necessary, it could be
    restored by accepting `bits` in prefix=/suffix= arguments.
2020-11-10 applet.interface.jtag_probe: add explicit --ir-lengths option.
    This is useful for devices that capture more than one <10> sequence
    in their IR immediately after Test-Logic-Reset.
2020-11-15 support.arepl, cli: gracefully handle Ctrl+C in REPL.
    Ctrl+C is turned into cancellation if the REPL is running user code,
    and into KeyboardInterrupt on the main thread (i.e. the default
    Python behavior) if the REPL is waiting for input.
2020-11-15 software: simplify firmware management.
    * Move firmware to glasgow/device/firmware.ihex.
    * Teach GlasgowHardwareDevice to find firmware unassisted.
    * Remove all code that accepted custom firmware filenames except
    for `flash --firmware`. There is no loss of functionality; during
    development, use `make -C firmware load`, which was always a more
    reliable option anyway.
2020-11-15 firmware, software: positively verify API compatibility.
    Before this commit, firmware and software did not check USB protocol
    compatibility in any way. Although this mostly worked because there
    were few changes in USB protocol, there were still breaking changes,
    the last one in commit 5a7d18a6 that caused a silent hang when wrong
    firmware version was used. The community is larger now and this sort
    of breakage is no longer acceptable.
    After this commit, firmware exports an "API level" (functionally
    similar to a semver major version) and software verifies that its own
    API level matches that of the firmware. On mismatch, software reloads
    the firmware, like it would handle a blank device. Each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
    [glasgow.h, main.c]
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2020-11-17 arch.arm.dp: add DP register definitions, up to DPv2.
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2020-11-17 arch.arm{→.dap}.{ap,dp}: consolidate.
    There's *way* too many DAP-related definitions for them not to have
    their own namespace.
2020-11-17 applet.debug.arm.jtag: new applet.
    Currently it implements only basic AP enumeration.
2020-11-17 applet.debug.arm.jtag: handle AP transactions setting STICKYERR.
    Also, gracefully handle failures reading AP IDR when enumerating APs.
2020-11-17 applet.debug.arm.jtag: enable debug power.
    Without debug power, AP enumeration will ~always fail.
2020-11-21 device.hardware, cli: unbreak `factory --force`.
    Before this commit, the `factory` command would ignore already
    factory-programmed devices during enumeration (even if the device was
    in recovery mode). This defeated the purpose of the `--force` flag.
    After this commit, the `factory` command would discover any devices,
    whether factory-programmed or not, such that `--force` works on any
    device in any state.
    Closes #236.
2020-11-23 device.hardware: use hotplug events when waiting for re-enumeration.
    Before this commit, there was a close race between re-enumeration in
    the firmware (which takes about a second), and a hardcoded wait in
    the software (which also took about a second). This would result in
    spurious errors when firmware needed to be reloaded.
    After this commit, hotplug events are used when available to remove
    any hardcoded wait (and make the process a bit faster as well), and
    on platforms without hotplug events (see libusb/libusb#86), a longer
    hardcoded wait of 5 seconds is used to make the race less likely to
    fail.
2020-11-23 software: fix broken package_data link.
    This change was missed in 68f8cfbf, and broke installation through
    wheels.
2020-11-24 device.hardware: fix downloading prebuilt bitstreams.
    This was broken in commit 7e170bf1.
2020-11-24 firmware: move ICE LED handling to FPGA code. NFCI.
    The existence of an FX2 pin dedicated to the ICE LED is an oversight;
    it should have been hooked up directly to CDONE to save a scarce FX2
    pin. Handle the LED transparently in FPGA code, with the aim of
    eventually freeing its pin on a future revision.
    Also, eliminate redundant state in the form of ST_FPGA_RDY latched
    status bit.
2020-11-24 firmware: remove LED abstraction. NFCI.
    This abstraction never worked well; the ACT LED manipulation was half
    inlined because function calls are tricky in interrupts, and the ICE
    LED manipulation was moved to the FPGA code in commit 23aacd73. Get
    rid of it, simplify the code, and make the firmware smaller.
    Also, rename LED constants to match the board silkscreen.
2020-11-28 device.hardware: fix enumeration on Windows.
    While it would make sense for hotplugRegisterCallback() with flags
    set to HOTPLUG_ENUMERATE to call the function for each discovered
    device on Windows in spite of the lack of true hotplug, that was not
    a correct assumption.
2020-11-28 applet.interface.uart: only shield from cancellation on socket side.
    Cancellation from the socket side means a client disconnected.
    Cancellation from the FIFO side means the applet is shutting down.
2020-12-03 applet.sensor.scd30: add a note about starting the sensor first
2020-12-03 applet.sensor.scd30: add a note about the startup delay
2020-12-03 software: require libusb1 version with Windows binary wheels.
2020-12-24 revC2: Bump revision. Remove ESD diode ground pads.
    The main reason to remove the ground pads is assembly reliability. In
    previous boards it was observed that it is fairly easy to create shorts
    between the ground pads and signal pads of the package.
    [glasgow.kicad_pcb, glasgow.sch, io_banks.sch, io_buffer.sch]
2020-12-24 revC2: Changed SOT-563 footprint to improve assembly reliability.
    The previous footprint was causing the solder stop webbing to be very
    thin which can result in the webbing missing on PCBs and result in
    shorts during reflow.
    [glasgow.kicad_pcb]
2020-12-24 revC2: Updated the VREG DFN Footprints to match datasheet.
    The datasheet has a finer footprint with smaller pads and smaller Via
    drills.
    [glasgow.kicad_pcb]
2020-12-24 revC2: Updated a bunch of the footprints to the upstream versions.
    This change seems like a big diff but it only really changes SOIC-8 and
    MSOP-8. They mostly bring roundrect changes and increase pad length for
    better fileting.
    [glasgow.kicad_pcb]
2020-12-24 revC2: Replaced rpack8->4 and level shifter package.
    * The 8x resistor arrays are not as common as 4x. Thus the 8x end up being
    more expensive and harder to source.
    * The SOT-563 package has slightly harder to solder than the SOT-363.
    Also the level shifter in SOT-363 is lower cost.
    [glasgow.kicad_pcb, io_banks.sch, io_buffer.sch]
2020-12-24 revC2: Updated TSSOP footprint to get roundrect pads.
    [glasgow.kicad_pcb]
2020-12-24 revC2: Updated UDFN-18 to roundrect pads.
    [glasgow.kicad_pcb]
2020-12-24 revC2: All swapped all remaining missing roundrect footprints.
    All footprints that are still not roundrect in the official KiCad
    library moved to local Glasgow footprint library and updated to
    roundrect pads.
    Also made a version of the 2x22 pin 1.27mm pitch LVDS connector with
    alignment pins. This will allow us to have accurate enough position of
    the connector so we can reliably connect to it in the pogopin tester and
    to possible daugter boards.
    [glasgow.kicad_pcb, glasgow.sch, io_banks.sch, io_buffer.sch]
2020-12-24 revC2: Initial routing pass after changing out parts.
    [glasgow.kicad_pcb]
2020-12-24 revC2: Spread level shifters to respect courtyards.
    As part of rerouting also moved half of the power via under the
    packages. We regained some space thanks to that resulting in slightly
    cleaner routing.
    [glasgow.kicad_pcb]
2020-12-24 revC2: Part ID removed from silkscreen, added logic block legends.
    All part IDs and values are now meant to be printed on the Fab layer as
    hardcopy manual assembly and population guide. The space on the
    silkscreen used for part IDs was partly traded against logical circuit
    block documentation. This is just the first pass and meant as a stepping
    stone. The goal is to have the logical functionality be as self
    descriptive on the silkscreen as possible.
    [glasgow.kicad_pcb, glasgow.sch, io_buffer.sch]
2020-12-24 revC2: Some minor silkscreen legend improvements.
    Mainly improved readability of the Pull-Up/-Down control block legend.
    This resulted in some of the passives being moved out of the way to make
    space for the legend. Also added legend that indicates which level
    shifter is responsible for which IO signal, including Sync.
    [glasgow.kicad_pcb]
2020-12-24 revC2: Align inline resistors and Sync level shifter.
    They were not aligned in a vertical line. For aethetic reasons this is
    now fixed. :)
    [glasgow.kicad_pcb]
2020-12-24 revC2: Replaced HiZ with P- to better reflect the actual function.
    The GPIO extenders can set a Pull-Up/-Down resistor or do nothing. That
    is not the same thing as HiZ. HiZ is only true if the level shifters are
    also set to input. So P- (Pull nothing or Passive) is a better term.
    [glasgow.kicad_pcb]
2020-12-24 revC2: Swapped Micro USB for USB-C USB 2.0 connector.
    This is the inital routing pass. This is the status after esden's Twitch
    stream on Tuesday May 26th 2020.
    [glasgow.kicad_pcb, glasgow.sch, io_buffer.sch]
2020-12-24 revC2: Rerouted and cleaned the USB current limit switch section.
    [glasgow.kicad_pcb]
2020-12-24 revC2: Added Mfr name and logo anchors.
    [glasgow.kicad_pcb]
2020-12-24 revC2: Added top silk bank pin legend.
    [glasgow.kicad_pcb]
2020-12-24 revC2: Made back side silkscreen black on white compatible.
    Replaced nono_hana with an outlive version and made the Serial Number
    box an outline. This will make the black silkscreen on white solder mask
    look "right". Should still work for light silk on dark solder stop.
    [glasgow.kicad_pcb]
2020-12-24 revC2: replace ADC with INA233 voltage & current monitor
    [glasgow.sch, io_banks.sch, io_buffer.sch]
2020-12-24 revC2: remove ATECC ic from schematics
    It was decided to be DNP for poduction, but there are still regularly questions
    about it popping up. So better completely remove it.
    [glasgow.sch, io_banks.sch]
2020-12-24 revC2: documentation improvements & small beautifications
    schematics part of #165 done
    [glasgow.sch, io_buffer.sch]
2020-12-24 revC2: remove left-over traces, place new footprints
    Also add new footprints where necessary, fix a silkscreen bug
    Layout for new components still TODO
    [glasgow.kicad_pcb, glasgow.sch, io_buffer.sch]
2020-12-24 revC2: layout for INA233 on port A done, port B still TODO
    [glasgow.kicad_pcb]
2020-12-24 revC2: schematics fixup
    Add manufacturer names & MPNs, remove stray wire, uppercase R in resistor values
    [io_buffer.sch]
2020-12-24 revC2: layout for INA233 on port B done
    [glasgow.kicad_pcb]
2020-12-24 revC2: make layout for D18 and D19 symmetric
    [glasgow.kicad_pcb]
2020-12-24 revC2: roundrect and fixed 3d model for USB-C socket
    [glasgow.kicad_pcb, glasgow.sch, io_buffer.sch]
2020-12-24 revC2: fix & improve silkscreen
    - improve Pu/Pd marking
    - fix silkscreen pin numbering on the board edge
    - fix silkscreen pin numbering for the pu/pd sections on the back side
    [glasgow.kicad_pcb]
2020-12-24 revC2: add symbol & footprint for new TVS diode array SP3012-06UTG
    TODO: 3D model is just a placeholder, to be replaced with the correct one
    [glasgow.kicad_pcb, glasgow.sch, io_buffer.sch]
2020-12-24 revC2: place new TVS diodes for port A
    [glasgow.kicad_pcb, io_buffer.sch]
2020-12-24 revC2: place new TVS diodes for port B
    [glasgow.kicad_pcb]
2020-12-24 revC2: re-shuffle silkscreen labels ("Glasgow", creators, ports, OSHW, Sync) to work with the new TVS diodes
    [glasgow.kicad_pcb]
2020-12-24 revC2: simplify power sequencing
    - The ice40HX does not need power sequencing (unlike the ice40UP5K in previous revs)
    - Just the FX2 needs a proper reset circuit with delay after power on
    - On a brownout on the 5V rail, not only the FX2 needs a reset, but also all ICs connected to the I2C bus
    - Otherwise they could be stuck in a transaction
    - Switch off the 3.3V whole rail with the MAX809J reset IC to solve this
    - Reset the FX2 before the 3.3V rail becomes unstable
    [glasgow.kicad_pcb, glasgow.sch]
2020-12-24 revC2: save one BOM line by replacing a 220k resistor against 2x 100k
    [glasgow.kicad_pcb, glasgow.sch]
2020-12-24 revC2: separate current shunt for the INA233
    The original idea in #165 and #135 was to reuse the 0.47 Ohms dropper resistor
    we already have for the regulator as current shunt too. As the INA233 has a fixed
    measurement range of +- 81.9 mV, this would allow to measure 174 mA. My initial
    thought was that this is enough, as the specced load of the TPS73101 is 150 mA.
    Review and experimentation has shown that the TPS73101 can be used to 350 mA in
    most configurations before limiting set in, for a programmed output of 5 V I
    could use it even up to 420 mA. As one of the design goals of using the INA233
    is overcurrent protection, the settable range should be higher than what the
    regulator can output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
    [glasgow.kicad_pcb, glasgow.sch, io_buffer.sch]
2020-12-24 revC2: move C13 and R3 (USB shield) a bit away from the usb-c connector
    Allows easier experimenting with pin-in-paste for manufacturing.
    [glasgow.kicad_pcb]
2020-12-24 revC2: save one BOM line by replacing 1k resistors with 2k2
    [glasgow.kicad_pcb, glasgow.sch, io_banks.sch, io_buffer.sch]
2020-12-24 revC2: fix track too close to pads of U32
    [glasgow.kicad_pcb]
2020-12-24 revC2: Some very minor routing cleanups.
    [glasgow.kicad_pcb]
2020-12-24 revC2: Adjusted minimum drill distance down to 0.15mm.
2020-12-24 revC2: Switched eeprom packages to TSSOP-8 to gain more space.
    [glasgow.kicad_pcb, glasgow.sch]
2020-12-24 revC2: Switched bulk cap footprint, Added system reset button circuit.
    [glasgow.kicad_pcb, glasgow.sch, io_buffer.sch]
2020-12-24 revC2: Bigger footprint bulk cap and reset button.
    Details:
    * Replaced the bulk capacitance polymer capacitor with a larger
    footprint version as the 6.3mm footprint is more common.
    * Added a reset button that instantly resets the cirucuit. Meant also as
    emergency stop. Reset will result in cutting power to the target instantly.
    * To enable reset we replaced the power supervisor chip with one that
    has a reset pin.
    * As the pullup current of the supervisor chip reset line is very low,
    we have added a capacitor parallel to the tact switch, to improve
    "wetting current" and break down contact oxides.
    * To make space for the reset button I decided to replace the SO8
    EEPROMs with TSSO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
    [glasgow.kicad_pcb, glasgow.sch]
2020-12-24 revC2: Moved sync connector to increase separation.
    This will allow us to create a web between the main connector and sync
    connector in the top side of the case.
    [glasgow.kicad_pcb]
2020-12-24 revC2: Minor silkscreen work. Added tact switch 3d model.
    [glasgow.kicad_pcb]
2020-12-24 revC2: Updated Molex KK 3D Model.
    The previouos WRL model was not exporting to STEP for some reason. :(
    [glasgow.kicad_pcb]
2020-12-24 revC2: fix distance between port headers to multiple of 2.54 mm
    It was off by 0.1 mm before, thanks to user disasm for spotting this.
    A raster of 2.54 mm is desirable for compatibility to other 2.54 mm
    equipment like protoboards. Also designing addon boards is simplified
    by allowing to use an imperial grid in CAD.
    Also update the dimension drawings. Align the dimension drawings to
    the location of pin 1 instead of the connector center, as Kicad library
    connectors have their origin on pin 1 and not at the center.
    [glasgow.kicad_pcb]
2020-12-24 revC2: center the vias to GND for the TVS diode arrays
    [glasgow.kicad_pcb]
2020-12-24 revC2: improve silkscreen labes for LEDs, pulls and ESD protection
    [glasgow.kicad_pcb]
2020-12-24 revC2: move polymer capacitor to allow reworking the pads of the FX2
    [glasgow.kicad_pcb]
2020-12-24 revC2: rename led blocks once again, to "STATUS LEDS" and "USER LEDS"
    [glasgow.kicad_pcb]
2020-12-24 revC2: adapt text about recovery in schematics to match current silkscreen + reset button
    [glasgow.sch]
2020-12-24 revC2: add bom keys and datasheet for button + reset ic
    [glasgow.sch]
2020-12-24 revC2: Minor routing cleanups.
    [glasgow.kicad_pcb]
2020-12-24 revC2: Replaced 0603 HandSolder footprints with regular ones.
    [glasgow.kicad_pcb, glasgow.sch, io_banks.sch, io_buffer.sch]
2020-12-24 revC1: Updated Placement plan.
    Adjusted text sizes, and moved ID/Values to Fab layers.
    [glasgow.kicad_pcb]
2020-12-24 revC2: Added and assigned the UDFN-14 3d model for the IO ESD Diode packages.
    [glasgow.kicad_pcb]
2020-12-24 revC2: add ESD warning to LVDS connector, add note about it not being available on future revs
    [io_banks.sch]
2020-12-24 revC2: add more vias to layer changes of the main +5V rail
    [glasgow.kicad_pcb]
2020-12-24 revC2: add some more documentation about reset to the schematics
    [glasgow.sch]
2020-12-24 revC2: Replaced top actuated tact switch with a side actuated one.
    This should make the case design better. This is not necessarily the
    final tact switch selection.
    [glasgow.kicad_pcb, glasgow.sch, io_banks.sch, io_buffer.sch]
2020-12-24 revC2: Improved anchor of the tact switch shield to the PCB.
    We now have through hole slots that will solder to the metal shield tabs
    of the tact switch. This will securely anchor the tact switch to the
    PCB.
    [glasgow.kicad_pcb, glasgow.sch]
2020-12-24 revC2: Added copper fills to anchor the USB-C connector better.
    Added copper flood fills on all PCB layers to make a more positive
    anchor of the shield tab through holes to the PCB layers. Also enabled
    solder paste aperture openings for the shield pads. Tested on other
    projects I know that paste in hole works for these connectors.
    [glasgow.kicad_pcb]
2020-12-24 revC2: Increased the solder paste apertures for paste in hole.
    Extended the apertures for the USB-C and Tact switch shield through
    holes. This should provide a bigger amount of solder for the through
    holes. (Might require additional tweaking down the road)
    [glasgow.kicad_pcb]
2020-12-24 revC2: added reset button 3d model.
    [glasgow.kicad_pcb]
2020-12-24 revC2: Corrected the reset button 3d model.
    [glasgow.kicad_pcb]
2020-12-24 revC2: Increased tact switch slot width.
    Now the slot width is the same 0.6mm as the USB-C connector which is
    known to work even with JLCPCB. JLCPCB officially states that the slot
    width should be 0.65mm, though we know they are fine with the narrower
    USB-C slot too.
    [glasgow.kicad_pcb]
2020-12-24 revC2: Updated 1b2-bom-keys and corrected levelshifter PN.
    [glasgow.kicad_pcb, glasgow.sch, io_banks.sch, io_buffer.sch]
2020-12-24 revC2: Addressed some DRC issues.
    Addressed:
    * Decreased via size under the BGA. 0.2mm drill 0.4mm pad, this
    increases the clearance to the pads and is still a reasonable
    requirement for most PCB houses. (PCB houses can adjust these if
    necessary in most cases)
    * Decreased via size under the ESD diode packs.
    Disabled:
    * Disabled courtyard checking, this is a guidance in the first place, also
    we violate it in so many places that the DRC errors drown in the noise.
    It is still good practice to respect courtyards when possible.
    Not resolved:
    * Pad to drill distance for the LVDS connector. To resolve it we can
    either use complex pads or use the new single corner chamfered pads in
    KiCad nightly.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
    [glasgow.kicad_pcb]
2020-12-24 revC2: Consolidated sub 1k resistor value notation.
    [glasgow.kicad_pcb, glasgow.sch, io_banks.sch, io_buffer.sch]
2020-12-24 revC2: fix drc issues at the lvds connector with chamfered pads
    The chamfered pads are made using custom shape primitives using only features from Kicad 5.1
    [glasgow.kicad_pcb]
2020-12-24 revC2: add rc filter for Vsense input
    The capacitor is currently DNP as it is currently unknown if the filter is necessary.
    The resistor is the lowest value in the BOM (4r7).
    [glasgow.kicad_pcb, glasgow.sch, io_buffer.sch]
2020-12-24 revC2: Fix ESD protection footprint & clean up routing
    [glasgow.kicad_pcb, io_buffer.sch]
2020-12-24 revC2: Clean up VSENSE routing
    [glasgow.kicad_pcb]
2020-12-24 revC2: Modify reset switch footprint
    - Fix incorrect F.Fab drawing
    - Change mounting-pad dimensions/design
2020-12-24 revC2: Clean up silkscreen & ADC routing
    [glasgow.kicad_pcb, glasgow.sch]
2020-12-24 revC2: More work on silkscreen
    [glasgow.kicad_pcb]
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2020-12-24 revC2: Fix LVDS alignment hole layers
2020-12-24 revC2: Lots of cleanup to VIO set/sense routing
    [glasgow.kicad_pcb, glasgow.sch, io_banks.sch, io_buffer.sch]
2020-12-24 revC2: Fix review notes
    [glasgow.kicad_pcb, glasgow.sch, io_banks.sch, io_buffer.sch]
2020-12-24 revC2: fix paste-in-hole and wave solder keepout
    [glasgow.kicad_pcb]
2020-12-24 revC2: Connected a few remaining ground pad via solid to ground plane.
    [glasgow.kicad_pcb]
2020-12-24 revC2: Added XKB TC-1109DE TH RA tact switch footprint.
2020-12-24 revC2: Added the tc-1109de-b-f tact switch 3d model.
2020-12-24 revC2: Replaced the small SMD tact switch with a slighly bigger TH version.
    After testing and playing around with the small SMD tact switch we came
    to the conclusion that a slightly bigger button will fit in the same
    space and will give us more options. Also the longer, bigger and lower
    weight tact switch will feel nicer and fit in the case better.
    [glasgow.kicad_pcb, glasgow.sch]
2020-12-24 revC2: Updated the tact switch footprint to include 3d model.
    Also fixed up the silkscreen and fab layers.
    [glasgow.kicad_pcb]
2020-12-24 revC2: re-route ~MR trace on the bottom layer to not split the GND plane below voltage regulators
    [glasgow.kicad_pcb]
2020-12-24 revC2: add dimension drawings for the mounting holes
    [glasgow.kicad_pcb]
2020-12-24 revC2: Minor footprint type corrections.
    The reset button had to be TH. Logos should be virtual.
    [glasgow.kicad_pcb]
2020-12-24 revC2: Corrected the SOT-143 footprint.
    The footprint in the KiCad library works but it is too large and could
    cause assembly reliability issues. The new footprint and 3D model are
    based on the official Diodes Inc data and match the part we are using.
    [glasgow.kicad_pcb]
2020-12-24 revC2: Corrected resistor pack footprints.
    The outer pads of the resistor pack footprints were slightly too small.
    This can cause assembly reliability isues.
    [glasgow.kicad_pcb]
2020-12-24 revC2: Moved the front mfr logo anchor to a better spot.
    [glasgow.kicad_pcb]
2020-12-24 revC2: Removed the solder mask minimum width setting.
    As recommended by KiCad this setting should only be used when explicitly
    asked by the PCB manufacturer. It depends on their needs and
    capabilities and is usually done as part of gerber file pre processing
    done by the PCB manufacturer.
    [glasgow.kicad_pcb]
2020-12-24 revC2: fix level shifter MPN
    Thanks @gregdavill for spotting & reporting this.
    [io_banks.sch, io_buffer.sch]
2020-12-27 revC2: Generated gerber, bom and renderings.
    Additionally, the glasgow subdirectory README now contains information
    on how to generate the 3d renderings included in the glasgow repository.
    [bom.csv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]
2020-12-27 cli: coarsen --trace VCD timestamps to 10 ns.
    This speeds up dumb VCD viewers like sigrok that do work per sample
    rather than per edge by an order of magnitude at the cost of some
    non-accumulating loss of precision. Although unfortunate, sigrok is
    just far too slow to decode traces without this hack.
2020-12-27 firmware: rename adc file and functions to prepare supporting the INA233 ADC too
2020-12-27 firmware: implement voltage reading for the INA233
    move adc_reg_read()/_write() to util.c and rename to i2c_reg8_read()/_write()
    as they are used by both ADCs and can most probably also be used for other I2C peripherals.
2020-12-27 firmware: implement initializing and reading alert limits for the INA233
    With this firmware it is now possible to use regular "voltage"
    cli commands on revC2 to enable ports and read the sensed voltage back.
2020-12-29 firmware: fix ~ALERT interrupt handling
    The interrupt is level triggered on the FX2, so disable the handler until the
    ADC disengages it.
    It did somehow "work" without this fix, but the CPU was spending most of it's time
    entering the interrupt handler.
    Found by mistakenly not properly disengaging the ~ALERT line, then all USB comms
    broke. This doesn't happen with this commit.
    [main.c]
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2020-12-29 gateware.uart: support words longer than 8-bits
    It seems that the shift register was being truncated to 8-bits
    regardless of the requested word size, since the `data_bits`
    attribute was introduced in 0f497e4a.
2021-01-06 Fix typos. NFC.
    [io_banks.sch]
2021-01-08 gateware.uart: fixup parity handling
    [uart.py]
2021-01-09 examples: fixup PCF8574 usage
    [i2c-pcf8574.py]
2021-02-15 platform.rev_c12: add connector definition for the lvds connector.
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2021-03-16 README: tone down I/O pin data rate expectations.
    100 MHz was too optimistic and is unlikely to be achievable in most
    cases due to layout and component choices. The level shifters are
    rated up to 210 Mbps at 3V3-to-3V3, but this is the rating for just
    the shifters and not the complete system.
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2021-09-26 applet.program.avr: add support for devices with no 'Poll RDY/#BSY' instruction
2021-09-26 database.microchip.avr: add support for devices with no 'Poll RDY/#BSY' instruction
2021-10-29 applet.program.xc9500xl: Correct logging stanza for device name and id
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2022-04-29 revC2: Fix bom having not enough columns on multiple lines
    [bom.csv]
2022-12-13 firmware: handle voltage alerts on revC2
    Implements a workaround for an i2c address clash of the
    SMBus Alert Request Address (required to clear the ~ALERT line)
    and the DAC A.
    [adc_ina233.c, glasgow.h, main.c, util.c]
2022-12-28 applet.interface.uart: fix `tty` subcommand on Windows.
2023-02-07 firmware: switch the DAC off too when switching off Vio
    Without this, the DAC still outputs it's control voltage even if Vio is off.
    This goes through the feedback resistors to the output. I measured about
    15 mV without this patch on a port that was previously enabled.
    With this patch it properly goes down to zero.
    While such a low voltage usually shouldn't be a problem, I consider it
    unclean design, especially if it is so easy to fix.
    [dac_ldo.c]
2023-02-07 software: tighten dependency to aiohttp~=3.8.
    Fixes #294.
2023-02-21 applet.interface.uart: add commentary about the autobaud and its limitations
2023-02-25 applet.interface.jtag_svf: ignore TRST OFF when TRST# not present
    Some SVF producers (like Xilinx impact) emit a TRST OFF command as
    part of the initialization. This has no effect other than bringing the
    system to the default state, so ignoring it when there is no TRST# pin
    is harmless. Likewise, ignore TRST Z in this case.
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2023-07-04 software: move from `TSTriple` to `Pin`, simplify `Pads`
    This removes the last dependency on `amaranth.compat`, finishing the
    migration.
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2023-07-22 pyproject: setuptools~=67.0 → setuptools>=67.0
    The latter is overly strict and breaks installation with PDM (which
    is more principled than our other PEP517 build backends).
2023-07-23 software: add PDM support.
    PDM's functionality is essentially equivalent to that of pipx for
    the Glasgow use case, but it can still be handy for development.
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2023-07-23 target: locate and examine the FPGA build tools.
    This commit adds a mechanism to Glasgow similar to the existing
    `AMARANTH_USE_YOSYS` mechanism that selects a Yosys binary to run.
    It introduces the concept of a toolchain (a collection of tools
    that come from a single source; currently, either the system binaries
    or the co-installed YoWASP packages). The toolchain is used
    as a whole, i.e. system and YoWASP packages cannot be mixed since
    this has a high probability of being a mistake. Any missing
    components required for operation are reported.
    To select the toolchain, a new `GLASGOW_TOOLCHAIN` environment
    variable is introduced. It can be set to `builtin`, `system`, or
    a comma separated list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
    [toolchain.py]
2023-07-23 target: cache bitstreams.
    This is a major usability improvement for two use cases:
    * routine and recommended use of the reset button on revC2+, which
    is otherwise excruciatingly slow;
    * frequent switching between multiple specific applet configurations,
    useful as a workaround for the lack of multiple applet support.
    This commit should make most uses of `run --prebuilt` obsolete.
    Fixes #43 (again).
2023-07-28 cli,device: split factory flashing off into its own flow.
    Before this commit, some aspects of factory flashing (device
    enumeration and initial loading of firmware) were handled in
    the production flow. However, this interacted poorly with the device
    recovery flow, since uploading a production firmware causes
    the device to re-enumerate.
    * Re-enumeration is not very reliable, especially on Windows. (#252)
    * If more than one device is connected, re-enumeration could cause
    the wrong one to be destructively reflashed, since USB has no
    geographical addressing.
    In addition, behavior related to `--force` depended on the device
    EEPROM state, which is not appropriate to either factory flashing
    or t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
2023-07-28 firmware,software: add LED test mode (-67 bytes XRAM).
2023-07-28 applet.selftest: add `leds` mode.
    Fixes #235.
2023-07-28 firmware,software: make iManufacturer configurable in factory flow.
    Fixes #347.
    [glasgow.h, main.c]
2023-07-28 firmware: breathe FX2 LED when USB address is not assigned.
    Fixes #257.
    [main.c]
2023-07-29 firmware: fix git merge resolution error with 3a783fad and 5783d828.
    This has caused the FX2 LED to be stuck on even in LED test mode.
    [main.c]
2023-07-29 firmware,software: set high byte of bcdDevice to API level.
    Before this commit, bcdDevice can have two possible values:
    * 0x00RR for devices without firmware
    * 0x01RR for devices with firmware
    (where RR is the encoded revision, e.g. 0x32 for revC2)
    Finding out the API level requires opening a device and sending
    the REQ_USB_API_LEVEL control request.
    The API level is also 1 at the moment.
    After this commit, the high byte of bcdDevice is either zero (if
    the firmware is not loaded), or equal to the current API level (if
    the firmware is loaded). Conveniently, with the API level before
    this commit the rules are already satisfied.
    REQ_USB_API_LEVEL is eliminated and finding out the API level can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
2023-07-30 cli: rationalize return codes for running applets.
    * Allow applets and tools to return non-zero codes using `return`
    statement in the runner function.
    * Return 1 on `GlasgowAppletError` being raised.
    * Return 130 (SIGINT return code) on applet interruption.
2023-07-31 device.hardware: print causes of `set_voltage()` failure.
    For example:
    $ glasgow voltage
    Port Vio Vlimit Vsense Monitor
    A 0.0 5.5 0.0 0.0-5.5
    B 0.0 3.3 0.0 0.0-5.5
    $ glasgow voltage AB 5
    E: g.cli: cannot set I/O port(s) AB voltage to 5.0 V (port B voltage limit is set to 3.3 V)
    It is easy to miss the value in the Vlimit column. The display of
    causes of the error avoids a source of frustration, and ensures that
    voltage limit caused errors do not mislead the operator into thinking
    that their device is faulty.
2023-07-31 cli: in `glasgow voltage`, replace `Monitor` with `Vsense(range)`.
    This makes it clearer exactly what is monitored.
2023-07-31 revC2: Corrected the CAT24M01 part number.
    [bom.csv, glasgow.sch]
2023-08-01 applet: kill `all`, use Python entry points to declare applets.
    `glasgow.applet.all` was an abomination. Now that it is gone, we have
    several new possibilities:
    * Out-of-tree applets is the major one. (This commit explicitly
    prohibits them because the API is not stable or ready for public
    consumption.)
    * Applets can now have package dependencies of their own, through
    their list of optional dependency groups that must be installed.
    This prevents any further dependency bloat of the software stack.
    * Applet metadata can at some point be cached to reduce load times.
    Loading every applet (which we still do, just in a less directly
    intentional way) is costly, especially on low-power sy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
    [metadata.py]
2023-08-01 support.plugin: generalize from applet.metadata.
    At this point we have at least three subsystems that would benefit
    from a plugin mechanism based on entry points that was added to
    handle applets:
    * Applets. Duh.
    * Applet tools. Currently very awkwardly attached to applets even
    though they aren't really related.
    * Data loggers. `support.data_loggers` depends on `aiohttp` for
    a part of its functionality but because there was no way to
    express it, a data logger specific work around was added.
    This commit lays the foundation for using the same plugin system
    for all three.
2023-08-02 applet.video.ws2818_output: add support for LEDs other than RGB
2023-08-05 device.hardware: check if device is busy before loading firmware.
    On Linux multiple userspace applications can send control requests
    to a device without being aware of each other. Claim every interface
    to ensure mutual exclusion with any other application.
    On other OSes device access is already exclusive.
    Fixes #241.
2023-08-05 device.hardware: nudge the operator to reflash obsolete devices.
    Fixes #239.
    Closes #247.
2023-08-05 firmware: remove config fixup functionality.
    There was only a small amount of devices that required config fixup
    in first place, and they should have all been fixed in the ~4 years
    that have passed since the code was added. If anyone boots firmware
    on a device with non-fixed EEPROM after this commit, the device will
    come up with a `Z9-9999...9` serial and running `glasgow flash` with
    the right revision will fix the problem.
    Fixes #387.
    [main.c]
2023-08-19 software: fix fwft parameter value on all `FIFOInterface`s. NFCI.
    [analyzer.py, fx2_crossbar.py]
2023-09-16 applet.selftest: fix `leds` mode.
    Fixes the following error:
    TypeError: Object flipped((rec led_0 o)) cannot be converted to an
    Amaranth value
2023-09-20 firmware: fix issue #382 (-88 bytes XRAM).
    The issue #382 (failure of the device to enumerate when plugged into
    a Windows machine for the first time) was caused by the lack of handling
    of a Windows-specific descriptor. Respond to a request for this
    descriptor.
    [main.c]
2023-09-20 firmware: include git revision in product string (-15 bytes XRAM).
    In the issue #382, @VioletEternity pointed out that it is not
    currently possible to find out which git commit a firmware was built.
    This commit introduces the embedding of the hash of the commit
    containing the last modification to the `firmware/` (git) tree
    in the product string that is visible in the device properties, for
    example on Linux it can be retrieved like this:
    $ lsusb -d 20b7:9db1 -v | grep iProduct
    iProduct 2 Glasgow Interface Explorer (git 52734ce9)
    Because a commit cannot include its own hash (without a successful
    preimage attack on SHA1), the commit that is updating the built-in
    firmware in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
    [main.c]
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2023-10-02 manual: index: add opengraph and twitter metadata.
    It is unclear whether services will follow the meta redirect on the landing
    /index.html page, but it seems the answer is "probably not". Be safe and add
    the metadata both on /index.html and /latest/index.html, for good measure.
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2023-10-06 revC3: change silkscreen to "owGglas revC?" to emphasise that it is a development version for now
    [glasgow.kicad_pcb]
2023-10-06 revC3: remove port pinout marking on top silkscreen
    As decided in #256
    [glasgow.kicad_pcb]
2023-10-06 revC3: fix internal i2c bus testpoint silkscreen labels on top side
    Fixes #250
    [glasgow.kicad_pcb]
2023-10-06 revC3: change the I2C address of DAC A to remove the address clash with the SMBus Alert Response Request (ARA)
    - The SMBus Alert Response Request (ARA) is used by the INA233
    - Add notes about this to the schematics
    - Also store the correct footprint of the reset IC U7 in the schematics
    (was previously just in the layout and the assignment in the schematics wrong)
    [glasgow.kicad_pcb, glasgow.sch, io_banks.sch, io_buffer.sch]
2023-10-06 revC3: increase spacing of the 3V3 flood fill on the internal power layer around the mounting holes
    For ensuring GND contact to a metal case one solution is to use serrated washers on the mounting holes.
    In some cases the serrated washers could penetrate through the outer PCB layer and create a short
    between 3V3 and GND. With the increased spacing this becomes very unlikely.
    None of the areas around the mounting holes is important for current flow or signal referencing.
    [glasgow.kicad_pcb]
2023-10-06 revC3: add input filter for Vsense
    Without this filter, Vsense is sensitive to substantial aliasing on specific frequencies.
    Detailed measurements and reasoning in
    https://github.com/GlasgowEmbedded/glasgow/issues/221#issuecomment-753531753
    [glasgow.kicad_pcb, io_banks.sch, io_buffer.sch]
2023-10-06 revC3: add URL to back silkscreen, resize VDAC labels on back silkscreen
    [glasgow.kicad_pcb]
2023-10-06 revC3: change URL on back silkscreen to https
    [glasgow.kicad_pcb]
2023-10-06 revC3: connect the 3v3 pin of the LVDS connector with a second via
    Power traces should be connected with at least two vias for lower impedance
    and improved reliability. On the other instances this was already addressed
    in revC2, this one was missed.
    Without this improvement the planned Hyperram addon for the LVDS connector
    could get a power problem because 2 active Hyperram ICs draw in the order
    of 100 mA through the 3v3 pin.
    [glasgow.kicad_pcb]
2023-10-06 revC3: add pin 1 marker to silkscreen for LVDS header
    [glasgow.kicad_pcb]
2023-10-06 revC3: add an 4.7µF capacitor to VIO_AUX for improved decoupling
    VIO_AUX is the IO voltage for the LVDS connector. If it is used with
    high speed signals (like for example connecting to fast RAM), the
    existing 100n decoupling may not be enough. Also add some more
    vias to the VIO_AUX trace for lower inductance.
    Unfortunately placing the capacitor nearer to the FPGA would require
    major rerouting. This is not done here for fear of adding new issues.
    [glasgow.kicad_pcb, io_banks.sch]
2023-10-06 revC3: Filled in the blanks for the Reset button part number.
    [glasgow.sch]
2023-10-06 revC3: Updated LEDs and current limiting resistors.
    * New status LED color scheme: PWR/GRN, FX2/WHT, ICE/BLU, ACT/ORA,
    ERR/RED
    * Updated LED part numbers and the corresponding resistor values.
    * All LED sourcable from LCSC.
    [glasgow.kicad_pcb, glasgow.sch, io_banks.sch, io_buffer.sch]
2023-10-06 revC3: Decreased LVDS connector alignment hole to 0.76mm
    We noticed that the selected alignment hole size allowed for too much
    movement of the LVDS connector. The alignment pin is 0.65mm diameter and
    Samtec recommends a hole of 0.76mm diameter.
    [glasgow.kicad_pcb]
2023-10-06 revC3: Updated to the new stable KiCad V6.
    This includes updating the KiCad system 3D model library path variable.
    [glasgow.kicad_pcb, glasgow.kicad_sch, glasgow.sch, io_banks.kicad_sch, io_banks.sch, io_buffer.kicad_sch, io_buffer.sch]
2023-10-06 revC3: Updated resistor pack footprint.
    This change is based on battle proven footprint used in 1BitSquared
    board designs. This makes the gaps between pads consistent 0.22mm to
    pass PCB manufacturer automated DRC and receive solder stop between
    pads decreasing solder bridging probability during assembly.
    [glasgow.kicad_pcb]
2023-10-06 revC3: Adjusted button footprint to reflect selected tact switch.
    [glasgow.kicad_pcb]
2023-10-06 revC3: Added kikit tab anchors.
    [glasgow.kicad_pcb]
2023-10-06 revC3: Increased min pad gap to 0.22mm.
    This increases the chances of getting solder mask bridges between pads
    decreasing probability of bridging.
    [glasgow.kicad_pcb, glasgow.kicad_sch, io_buffer.kicad_sch]
2023-10-06 revC3: Increased Serial No frame size.
    Now the frame is >6mm wide which will accomodate some more common label
    printer labels without looking strange or oversized.
    [glasgow.kicad_pcb]
2023-10-06 revC3: Hid U12&U21 labels. Corrected APX 1b2 key.
    [glasgow.kicad_pcb, glasgow.kicad_sch]
2023-10-06 revC3: Added paste to USB-C shield anchors.
    [glasgow.kicad_pcb]
2023-10-06 revC3: Corrected the USB-C 3D model position.
    [glasgow.kicad_pcb]
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2023-10-06 revC3: Final cleanups before production.
    * Changed 3D models to step so the 3D model can be exported for
    enclosure CAD.
    * Changed silk and stop colors to match 1BitSquared production boards
    [glasgow.kicad_pcb, glasgow.kicad_sch, io_banks.kicad_sch, io_buffer.kicad_sch]
2023-10-06 revC3: Corrected U2 (CAT24M01) part number.
    [glasgow.kicad_sch]
2023-10-06 revC3: update fabrication layer text size/position.
    [glasgow.kicad_pcb]
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2023-10-06 revC3: export fabrication files.
    Except for BOM.
    [glasgow-B_Courtyard.gbr, glasgow-B_Cu.gbl, glasgow-B_Fab.gbr, glasgow-B_Mask.gbs, glasgow-B_Paste.gbp, glasgow-B_Silkscreen.gbo, glasgow-Edge_Cuts.gm1, glasgow-F_Courtyard.gbr]
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2023-10-07 manual: install: mention how to discover plugged in device.
2023-10-08 revC3: Added generated BOM file.
    [bom.csv]
2023-10-08 revC3: Use the new KiCad DNP flag for the DNP parts.
    [glasgow.kicad_sch, io_banks.kicad_sch, io_buffer.kicad_sch]
2023-10-08 revC3: Marked non schematic/bom parts correctly.
    [glasgow.kicad_pcb, glasgow.kicad_sch, io_banks.kicad_sch, io_buffer.kicad_sch]
2023-10-08 revC3: Updated bom to drop the excluded parts.
    We don't need to include mounting holes and test pads in the BOM.
    [bom.csv]
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2023-10-08 revC3: Updated schematic to use the new DNP markings.
2023-10-18 device.hardware: print a nicer error for missing permissions.
2023-10-20 protocol.jesd3: fix detection of default fuse state in a JED file.
    Originally proposed in whitequark/prjbureau#13.
2023-10-21 revC3: Added aluminium case outline with tolerance.
    The case to board tolerance is 0.4mm. The lines are doubled to represent
    the maximum overlap extents.
    [glasgow.kicad_pcb]
2023-10-21 device.hardware: log the file from which the firmware is loaded.
    This works for Glasgow loaded directly from a *.whl file, too!
2023-10-21 applet: extract test code to a separate file.
    Fixes #447.
    [test.py]
2023-10-21 support.task_queue: do not ignore task exception on cancellation.
    Before this commit, cancelling a task queue would cancel all the tasks
    and, once they finish, clear them from the queue, ignoring their result
    or exception. This isn't correct since it ignores errors that could have
    been raised before or during cancellation, and it also causes asyncio to
    print a *lot* of backtraces (one per task) on interpreter shutdown.
    After this commit, all tasks are awaited, and then the first exception
    that isn't asyncio.CancelledError is re-raised. As a result, unplugging
    a device while it's open results in a single error message...
    T: g.applet.radio.sx1276: FIFO: cancelling operations
    E: g.cli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
2023-10-21 device.hardware: improve handling of surprise disconnection.
    This commit adds handling of the LIBUSB_ERROR_NO_DEVICE error during
    transfer submission. This error was already handled during transfer
    completion, but since surprise disconnection is (by definition)
    asynchronous, this it can happen right before submission too.
    The message is also changed from ambiguous "device lost" (lost where?)
    to unambiguous "device disconnected".
    The code in _do_transfer with the exception handler nested three levels
    deep is some of the most cursed and convoluted logic I have ever written
    but as far as I can tell it is reasonably appropriate to the task. Sigh.
    This is still not quite enough to reduce the e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
2023-10-21 cli: retrieve exception of applet task before finishing other work.
    Otherwise asyncio will print a very long backtrace corresponding to
    the applet task (without any useful information) if, most commonly,
    the device was surprise unplugged and all of the other tasks that need
    USB communication fail.
    After this commit, finally, this works as it should:
    $ glasgow run benchmark -c 1000000000
    I: g.device.hardware: generating bitstream ID 6b120f4f94cf4ccd95c51417abc09069
    I: g.cli: running handler for applet 'benchmark'
    I: g.applet.internal.benchmark: running benchmark mode source for 953.674 MiB
    E: g.cli: device disconnected
2023-10-23 CI: fix semantics of the `required` check.
    If a dependency of the `required` check, e.g. `test-software` fails,
    the `required` check as a whole is considered skipped. While this works
    as expected for gating PR merges, it does not work the same way in
    the merge queue: in the latter case, the non-successful status does not
    prevent the merge queue branch from being merged to `main`.
    To address this, apply a workaround such that the `required` check
    always runs and programmatically checks the status of the required jobs
    rather than delegating this to GHA flow graph.
2023-10-23 firmware,software: implement a "modified design" marker (+93 bytes XRAM).
    In our documentation (in https://glasgow-embedded.org/latest/build.html)
    we very strongly require modified devices to not be described anywhere
    as "Glasgow Interface Explorer". Before this commit there is no way to
    avoid having that string appear in device descriptors. This commit adds
    a flag to the firmware, set once during factory flashing, indicating
    that this particular device was manufactured from modified device files.
    This flag is a mandatory (to require positive confirmation) argument to
    `glasgow factory` called `--using-modified-design-files`, where the two
    valid choices are `yes` and `no`. When provided, the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
    [glasgow.h, main.c]
2023-10-23 device.hardware: print a notice at INFO level for modified devices.
    Fixes #406.
2023-10-24 support.plugin: gracefully handle plugin load errors.
    This most notably improves the case where stale entry points metadata
    refers to a nonexistent applet (e.g. because it was removed, or because
    the applet was developed in a different branch of an editable install),
    which before this commit entirely breaks the CLI. This commit catches
    load errors and displays a nice error message in the UI.
    This commit also improves help text for plugins with unmet requirements.
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2023-10-29 device.hardware: interrupt USB polling thread before threading shutdown.
    While performing `USBContext.handleEvents()` the poller thread is
    uninterruptible other than through libusb1 API. Since the Python runtime
    joins all non-daemon threads on threading shutdown it is necessary to
    interrupt the thread by calling the corresponding libusb1 function.
    A seemingly obvious solution is to make the thread a daemon thread so
    that it is not joined on threading shutdown. Unfortunately this only
    makes the problem worse. All daemon threads are instantly killed on
    shutdown, leaving a lock within libusb1 permanently taken, and causing
    a hang later when python-libusb1 objects are garbage collected by
    the m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
2023-11-16 sim: fix pin parsing mismatch
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2024-01-14 applet.interface.jtag_probe: add flush() method to TAPInterface
    For now it simply calls JTAGProbeInterface.flush()
    This is in order to make higher level JTAG code more readable,
    so not too many .lower's need to be chained.
2024-01-21 applet.program.mec16xx: clear errors and switch to standby on every new operation
    This fixes the write command failing on MEC1633.
    The write command used to first successfully execute an erase, but after that
    the actual writing of the data failed. It seems that at least the MEC1633
    requires the embedded flash controller to go back to manually the STANDBY state
    before executing the next command.
    This is also explicitly spelled out in the MEC1632 and MEC1618i datasheets,
    that the controller must go back to standby when switching to a different mode.
    This is also especially useful in case of calling these in repl mode
2024-01-21 applet.program.mec16xx: add warning to emergency-erase
    Emergency erase requires a power cycle after it has been executed,
    at least on some chips. This is explicitly called out in the MEC1632
    datasheet for example. The warning might help a user to avoid thinking
    that something is broken, if they try a read/write command after
    emergency-erase.
2024-01-21 applet.program.mec16xx: support other flash sizes
    Both the read-flash and write-flash commands don't hardcode flash size anymore.
    write-flash uses the size of the file specified,
    while read-flash forces the user to specify a flash size using the -s argument.
    The help text has also been extended to describe typical flash sizes observed on
    mec16xx devices.
2024-01-21 applet.program.mec16xx: add note to the help text about what devices have been tested
2024-01-21 applet.interface.jtag_openocd: Add system reset (SRST#) support.
    The SRST# pin is not specified in IEEE 1149.1, but it can be used to
    reset the DUT in configurations that have it.
2024-01-21 applet.interface.jtag_pinout: Include --port in suggested arguments
    If the user has selected a non-default port spec, print it in the
    suggested command line, to ensure that the suggested pin numbers are
    correct.
2024-02-14 software: remove uses of the deprecated `fwft` parameter.
    It is no longer present in Amaranth 0.5, and it defaults to `True` in
    Amaranth 0.4 anyway.
    [analyzer.py]
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2024-03-22 manual: basic: improve wording and typography.
    - Reflowed text.
    - Changed "Warning" to "Important" for power-only USB cable warning to
    avoid warning fatigue.
    - Added em-dashes --- where appropriate instead of minuses -.
    - Improved consistency of monotype and emphasis.
    - Rephrased some sentences to read more clearly.
2024-03-24 device: add quirks for 1BitSquared batch shipped in March 2024.
2024-03-28 device.hardware: Set skip_on_error flag to improve Windows experience with USB discovery
2024-04-04 applet.selftest: fix incorrect usage of `Pin.eq`.
2024-04-15 pdm: disable symlinking to cache.
    Because of the wasmtime's implementation of sandboxing, YoWASP binaries
    cannot read symlinks that point outside of the mounts they can access.
    The symptom of that is an error message like this:
    ERROR: Can't open input file `/share/ice40/cells_sim.v' for reading: Operation not permitted
    This needs to be fixed properly (probably by making YoWASP binaries be
    Wasm components) but in the meantime this addresses immediate breakage.
2024-04-15 access.direct.arguments: fix default and required pin sets.
    Before this commit, despite having default=True and the help text
    showing default values, the corresponding argument still had to be
    specified.
2024-04-20 gateware.accumulator: new module.
    Wide counters (24-bit and wider) are problematic on the fairly slow
    iCE40 architecture, and this module allows using counters of any width
    by pipelining them.
    [accumulator.py, test_accumulator.py]
2024-05-03 Fix small detail in uart applet doc
2024-05-07 applet.interface.uart: fix "frame or parity errors"
2024-05-17 manual: use current year for "copyright" year purposes.
2024-05-18 cli: instruct power cycling device on firmware/configuration changes.
2024-05-28 applet.memory.24x: carry address for 2 address byte memories, too.
    Before this commit, the address would silently wrap around, corrupting
    the data at the beginning of the memory. This behavior is almost never
    desirable.
    After this commit, writing an overly long image into memory will usually
    fail since there's nothing to ack the next I2C address. It could also
    succeed and corrupt something else if there is and it's unintentional.
    Memory writes are an inherently destructive operation so this currently
    relies on a careful operator.
    Also, instead of ORing the carried over bits, add them to the I2C
    address. This will almost always perform the same operation but will
    fail in a more obvious way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
2024-06-22 firmware: turn off Vio on revC before resetting FPGA (-0 XRAM bytes).
    Fixes #552, previously reported as #96 but not fully addressed.
    The minimum delay (3×t_RC for onboard bulk capacitance) is 18 ms,
    the actual delay implemented is 250 ms, to account for capacitance
    in the device under test as well.
    RevAB devices are not affected.
    In addition to the primary issue, another issue was discovered, where
    turning off the FIFO bus was causing phantom zero bytes to be received
    by applets, which could then exhibit undesired operation. This was
    addressed as well by disabling the FIFO bus after and not before reset.
    The API level was incremented to ensure devices are reflashed with
    the new firmwar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
    [fpga.c, glasgow.h]
2024-06-24 software: deprecate the existing "pads" mechanism. NFCI
    This mechanism is predicated on the idea that the applets may only want
    to use an i,o,oe triple, which precludes the use of I/O flip-flops and
    DDR I/O.
    A new mechanism will be introduced in a follow-up commit.
    [boilerplate.py]
2024-06-24 software: add support for Amaranth 0.5 I/O.
    This commit adds a `GlasgowPlatformPort`, which is an `io.PortLike`,
    and adds platform-specific lowering logic that handles connecting
    the level shifter direction pin on revC+.
    It also adds `AccessMultiplexerInterface.get_port`, which can be used
    to construct a `GlasgowPlatformPort`. At the moment this is the only
    non-deprecated way to drive pins, however, it is not the final design
    and is still subject to change.
    It is now possible to use `io.FFBuffer` and `io.DDRBuffer` (as well as
    an explicit `io.Buffer`) in applets! :tada:
2024-06-24 platform: rename platform classes to be more distinct. NFC
    The names `GlasgowPlatformPort` and `GlasgowPlatformGeneric` would seem
    to imply that "Port" is a kind of platform Glasgow gateware can run on.
    Rename:
    * `GlasgowPlatformGeneric`→`GlasgowGenericPlatform`
    * `GlasgowPlatformICE40`→`GlasgowICE40Platform`
    * `GlasgowPlatformRevAB`→`GlasgowRevABPlatform`
    * `GlasgowPlatformRevC0`→`GlasgowRevC0Platform`
    * `GlasgowPlatformRevC123`→`GlasgowRevC123Platform`
    These names also work better in light of `LatticeICE40Platform`.
2024-06-24 applet.interface.jtag_openocd: decouple from jtag_probe.
    The coupling wasn't helpful to either applet, and is not really
    necessary with the new I/O.
2024-06-24 access.direct.multiplexer: expose FIFO ports as Amaranth streams.
    This commit alters the object returned by `get_{in,out,inout}_fifo()`
    to also have a `.stream` property, containing an Amaranth stream object
    whose ports are the `.[rw]_{rdy,en,data}` signals of the FIFO port.
    An alternative to this design is to make the FIFO port object itself
    an interface object that can be connected to Amaranth streams. This was
    not done because of the `in_fifo.flush` signal, which is sampled
    regardless of the `in_fifo.stream.valid` (aka `in_fifo.r_en`) signal,
    and which therefore cannot be a part of the payload. (Even if it was,
    it would be inconvenient to connect to the IN FIFO port stream if it
    always i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
2024-06-26 firmware: fix comment about power-only USB cables. NFC
    The comment talks about devices which find themselves without a USB
    address, which implies that power is present, but data isn't.
    [main.c]
2024-06-26 access.direct.multiplexer: accept pin sets in `get_port()`.
    This parallels the functionality in `get_deprecated_pad()` that also
    accepts pin sets. Unlike the latter, `get_port()` returns a port object
    that can later be split to the granularity of individual pins, and so
    does not preclude per-pin output enable control.
2024-06-26 device.hardware: adjust re-enumeration wait parameters for Windows.
    Now that libusb will support hotplug events on Windows shortly (see
    libusb/libusb#1406), the hotplug wait path will get exercised.
    Currently it does not wait for long enough; it takes about 5.5 s on
    a representative Windows desktop machine used for testing.
    This commit raises re-enumeration timeout to 10.0 s, and ensure that
    the timeout is respected no matter how many hotplug events are received.
    The higher fixed timeout on older libusb on Windows isn't disruptive,
    and with the next libusb release will become irrelevant for most.
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2024-06-27 access.direct.multiplexer: accept empty list in `get_port()`.
    This can come up when a `--pins-x ''` argument (or no argument at all)
    is provided, and zero pins are accepted by the applet for it.
    In principle, `PortLike` can have a zero length. However, instead,
    `None` is returned. This is for two reasons:
    - Constructing an empty `GlasgowPlatformPort` is surprisingly annoying.
    - Handling a case of a zero length port separately from a case of no
    port being provided at all seems like making I/O cores more complex
    with no upside to it.
2024-06-27 applet.program.xc6s: fix IR write with multiple devices on chain.
2024-06-30 cli: stop using `asyncio.run()`.
    This method intercepts `SIGINT` and installs a handler that interferes
    with our own `SIGINT` handler:
    https://docs.python.org/3/library/asyncio-runner.html#handling-keyboard-interruption
    In practical terms this may result in a two-exceptions-long backtrace
    being printed after the `^CW: g.cli: interrupted` message, which is not
    We started using `asyncio.run()` in commit 11223134, but there is
    nothing wrong with just creating the event loop ourselves instead.
    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
2024-06-30 target.hardware: greatly improve QoL for viewing bitstream logs.
    - Bitstreams are now always built in verbose mode (what previously
    required `AMARANTH_verbose=1`).
    - Instead of going to stdout/stderr, Yosys and nextpnr output is now
    captured by Python host and directed to the normal log at TRACE level.
    This can be viewed with `-vv` or `-v -F build` CLI options.
    - Build logs are considered a product and are cached together with
    the built bitstream. Absence of a build log (e.g. for bitstreams
    built before this change) triggers a full rebuild.
    - If a bitstream is retrieved from the cache, the build log is logged
    in the same way as if the build was executed anew.
    - If a build fails,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
2024-06-30 target.hardware: constrain system clock frequency.
    This was an omission introduced in commit eb2b96a2. The legacy (with
    `dir` not `"-"`) `platform.request()` function automatically adds one
    based on the `Clock()` clause, but this doesn't happen for `dir="-"`.
    (Should it perhaps do that?)
    As a result all of the built bitstreams were unsound until this commit.
    This especially impacted the use of PLLs, but it affected all circuitry.
2024-07-03 applet.interface.jtag_svf: automatically insert DUT reset in more cases.
    See #303.
2024-07-18 platform.generic: fix value driven on `oe_port`.
    Due to a mistake only the lowest pin of a multi-pin port would be
    actually driven.
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2024-07-19 applet.interface.spi_controller: allow multiple exchanges via CLI.
    This is very useful for SPI flashes and the like.
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2024-07-21 applet.program.avr: improve CLI experience for memory arguments.
    Before this commit, it was not clear that the filename suffix determines
    the file format. After this commit this is made clear in the text, and
    also invalid filenames are rejected at argument parsing stage.
2024-07-22 applet.interface.spi_controller: modernize API.
    This commit updates the SPIControllerInterface API to use explicit
    transaction marking with `async with iface.select():` rather than
    implicit transaction marking with `iface.xxx(hold_ss=True)`. Also,
    the implementation of the interface is aligned with that of QSPI applet
    (work in progress). The gateware is mostly untouched, except for adding
    the select command, and will be upgraded later.
    The following applets used implicit transaction marking and had to be
    upgraded:
    * memory-25x: tested on hardware
    * spi-flashrom: tested on hardware
    * program-ice40: tested on hardware
    * program-nrf24lx1: tested on hadware
    * radio-nrf24l01: tested on hardware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
2024-07-23 applet.interface.i2c_{initiator,target}: modify to use port groups.
    Also, update the I2C core to handle the same.
2024-07-23 access: reimplement `get_deprecated_pad{,s}()` via `get_port()`.
    There is no loss of functionality and this change allows us to only
    consider `get_port()` as a consumer of pin argument values.
2024-07-23 access.direct: implement selective pin inversion with `--pin-x 0#`.
    Amaranth supports inversion for any pin and for any I/O core on the I/O
    buffer level. This mechanism obviates the need for ad-hoc inversion in
    any applets, but was not exposed until now. Any pin can now be inverted
    via the command-line interface using one of the following syntaxes:
    * single pin: `--pin-x 0#`
    * pin range: `--pins-x 0:8#` (inverts all of them)
    * pin list: `--pins-x 0,1#,2#,3` (inverts only specified pins)
    Pull-ups configured for a pin with inversion get converted to pull-downs
    and vice versa.
2024-07-23 gateware.uart,applet.interface.uart: remove ad-hoc inversion.
    No longer needed as the same result can be achieved with `--pin-rx 0#`
    and `--pin-tx 1#`.
    [uart.py]
2024-07-23 applet.interface.spi_controller: remove ad-hoc CS# inversion.
    No longer needed as the same result can be achieved with `--pin-cs 0#`
    instead of `--cs-active 1`.
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2024-07-24 docs: suggest that the button is a better habit to press than typing `glasgow safe`
2024-07-24 docs: suggest using uart socket, rather than uart tty
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2024-08-02 firmware: move factored-out ep0 stall to end of fn (+13 bytes XRAM).
    [main.c]
2024-08-03 firmware: bugfix: rejected control transfer lingers (-2 bytes XRAM).
    If a control transfer is rejected, in some cases `pending_setup` will remain
    true. Then the main loop will keep entering `handle_pending_usb_setup`, and
    there is a race condition with the `handle_usb_setup()` interrupt handler.
    Often the handle_usb_setup() interrupt handler will prevent follow-up
    correctly formed setup packets from completing.
    note: This bug was present before my code size optimization patches too.
    [main.c]
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2024-08-12 gateware.qspi.QSPIController: new component.
    This component is a fully pipelined, zero wait states SPI, dual-SPI,
    and quad-SPI controller designed for high performance memory device
    access.
2024-08-12 applet.memory.25x: use QSPI controller instead of SPI.
    This makes it possible to use higher transfer rates, at the cost of
    WP# and HOLD# pins becoming mandatory.
2024-08-19 manual: revC3: Added hardware description documentation for Glasgow revC3 board.
2024-08-24 gateware.iostream.IOStreamer: fix bug for incorrect sampling of input
    Before this commit IOStreamer would sample its input 1 cycle late.
    This lowers latency by 1 clock cycle.
    This commit also adds a latency-agnostic testcase the verifies that
    SDR IOStreamer samples its inputs at the right point in time.
    This commit also fixes test_basic.
    This commit also fixes and simplifies the skid buffer test.
    Some behaviors of the skid buffer are not tested anymore because we're about to change those behaviors.
    [iostream.py, test_iostream.py]
2024-08-24 gateware.iostream.IOStreamer: fix bug for incorrect sampling DDR inputs
    This also adds a testcase to check the correct sampling time.
    [iostream.py, test_iostream.py]
2024-09-04 Revert "gateware.iostream.IOStreamer: fix bug for incorrect sampling DDR inputs"
    This reverts commit 579ff961d9f2e215b21e55fe7cadd8a0e1fb8893.
    [iostream.py, test_iostream.py]
2024-09-11 test_iostream.test_skid: fix assert message
    [test_iostream.py]
2024-09-13 gateware.qspi.QSPIController: fix multi-chip operation
    [qspi.py]
2024-09-13 tests: implement glitchless SimulatableDDRBuffer
    Thanks '2 Wanda' for the idea!
    [iostream.py]
2024-09-13 manual: describe pin inversion feature
    Documenting the pin inversion feature that was implemented
    in commit 4f89908ad953452768b4a6f1d1ac8b67b2634852
2024-09-21 gateware.iostream.IOClocker: Fix phase and state keeps flipping.
    When i_stream is idle, there is currently nothing that prevents
    the state machine from changing state between Falling/Rising,
    toggling phase, and restarting the timer.
    This results in lost power, and sometimes shortened clock pulses
    after an idle period.
    [iostream.py]
2024-09-21 {device,target}: add FPGA/I2C health check after bitstream load.
    There have been reports of issues that are suspected to be manufacturing
    defects related to the I2C bus, for example #688. These issues cause
    a failure in one of the post-configuration code paths related to the I2C
    bus, where it's difficult to display a good error message. This commit
    adds a dedicated health check register and a dedicated error message:
    E: g.cli: FPGA health check failed; if you are using a newly
    manufactured device, ask the vendor of the device for return and
    replacement, else ask for support on community channels
2024-12-22 applet.interface.qspi_controller: pull up IO0/IO1 also.
    This prevents reading 50/60 Hz noise from devices that do not drive
    their outputs (e.g. a QSPI flash that boots in QPI mode).
2025-01-20 applet.{memory.25x,interface.qspi_controller}: improve pins help message.
    It was unclear how the IO0-3 pins correspond to COPI/CIPO/WP/HOLD pins.
    Add the IO pin names to the pinout drawings for memory-25x, and add the
    correspondence to `--pins-io` help message.
2025-02-12 device.hardware: download bitstream in bigger chunks.
    This has no functional difference but makes logs 4× shorter at `-vv`
    verbosity.
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2025-03-13 applet.interface.spi_flashrom: change default pin assignments to be like memory-25x
2025-03-13 applet.interface.spi_flashrom: explicitly mention the default pin assignments of memory-25x
2025-03-16 applet.program.avr: Improve error handling and fix identify command for unknown devices
    The `identify` command would error out if it was talking to an unknown AVR. This
    change additionally ensures that `programming_disable` is called before the
    `interact` function finishes, which previously only happened on success.
2025-03-23 cli: invert voltage alert handling
    Alert handling was default enabled which led to unintuitiv usage of the
    voltage cli interface, since --no-alert needs to be set if Vio should
    just be enabled.
    Invert the handling, alerting is now default disabled and --alert can be
    used to turn it on.
    Fixes https://github.com/GlasgowEmbedded/glasgow/issues/718
2025-03-23 applet.sensor.scd30: adjust voltage comment
    The --no-alert option is no longer necessary since the handling has been
    inverted.
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2025-03-31 hardware: open & save with KiCAD 8.0.9
    [glasgow.kicad_pcb, glasgow.kicad_sch, io_banks.kicad_sch, io_buffer.kicad_sch]
2025-04-20 applet.program.ice40_flash: read done reg if it exists (not if reset exists..)
    This is an apparent copy-paste error; it checked for the
    address for the reset pin control register (same as previous fn),
    then read the done pin reg.
2025-04-26 applet.interface.{spi,qspi}_controller: ensure a chip is selected.
    Forgetting to `async with iface.select():` is a common novice usage
    error that is frustrating to debug.
    [test.py]
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2025-04-27 software: remove deprecated way to instantiate pin buffers.
    Closes #599.
    Thanks @isabelburgos and @q3k!
2025-04-27 software: remove "analyzer throttle".
    This functionality has never worked correctly and is conceptually
    unsound and impossible to implement in a generic way.
2025-04-27 applet.interface.uart: modernize.
    This applet is often used as an example and until now would return
    the DemultiplexerInterface object which isn't intended for direct
    applet end user manipulation, only for applet developers. Instead,
    it should be wrapped by an applet-specific *Interface object.
2025-05-07 support.endpoint: don't use cancellation to signal EOF.
    This is a very poor practice: not only it is called out as such by
    asyncio docs, but it also has a major practical consequence: it makes
    *actual* cancellation be swallowed by API consumers of ServerEndpoint
    that need to persist across client disconnections.
    Updating all clients right now is too much singular effort, so I added
    a switch to enable the new behavior to introduce it piecemeal.
    Also, fix up tests that had unclosed resources and deprecated uses of
    asyncio.
2025-05-07 applet.interface.uart: fix `ServerEndpoint` deprecations.
    Also, fix `socket` mode, and use asyncio task groups.
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2025-05-08 cli: --filter-log: raise to INFO, not DEBUG.
    This is much more useful, since it lets you opt out of seeing
    the normal DEBUG level messages from the applet.
2025-05-08 gateware.jtag: add TAP and probe implementation.
    The TAP has known design issues and is primarily there to aid testing
    of the probe, not to be used on its own.
2025-05-08 protocol.gdb_remote: remove `target_register_names()`.
    This method isn't really a sound approach for targets with holes in
    register address space like ARM. The existing MIPS target already
    handles out-of-bounds register accesses anyway, so it doesn't need
    to be updated.
2025-05-08 protocol.gdb_remote: support breakpoint kinds.
    These are required on ARM/Thumb capable targets.
2025-05-08 protocol.gdb_remote: wait for cancellation of `target_continue()`.
    The current approach of cancelling the future and then forgetting about
    it works fine for the simple strategy of waiting and polling used in
    MIPS EJTAG, but isn't good enough for implementing interruptible wait
    in gateware, since in that case cancellation can require waiting.
    Instead, wrap the future into a task explicitly, and wait for the task
    to complete after it is cancelled.
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2025-05-08 applet.debug.arm.arm7: implement async wait cancellation.
    This greatly improves responsiveness, but is quite complex.
2025-05-10 glasgow.cli: remove `run --trace` option (the "applet analyzer").
    Note that `glasgow run analyzer` (the "analyzer applet") is unchanged.
    The applet analyzer has long been neglected. Its performance is subpar,
    resource use is high, code is inscrutable, and ever since migrating to
    Amaranth 0.5 `lib.io` it has stopped registering pin events, which made
    it essentially useless. It's unlikely anybody has derived any actual
    value from `--trace` option in its existing form, so removing it brings
    no harm. Also, a functioning implementation would have to be rewritten
    almost from scratch anyway.
    It's quite unfortunate that a key part of our project (showcased on
    the landing page and the CS campaign p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
2025-05-10 target.hardware: disable pullups on revC pins used for routing.
    This fixes a regression introduced in commit c97d2d8e.
    The pins in the `unused` resource are connected to another pin in order
    to simplify routing. iCE40 has a weak pullup on all unused pins that
    we have to disable or it will interfere with operation.
2025-05-11 software: reorganize module hierarchy. NFCI
    Move all simulation-related implementation details to `.simulation`,
    all hardware-related ones to `.hardware`, and remaining abstract base
    classes to `.device` and `.access`.
2025-05-13 software: redesign and simplify host/device glue layer. (PR #803)
    See the pull request description for details.
    [assembly.py, build_plan.py, device.py]
2025-05-13 applet: drop `pin{s,}-` prefix from pin arguments.
    I.e. instead of `glasgow run uart -V 3.3 --pin-rx 0 --pin-tx 1`, you
    would use `glasgow run uart -V 3.3 --rx 0 --tx 1`.
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2025-05-14 software: unify "pin arguments" and "pin set arguments".
2025-05-14 hardware.assembly: fix `HardwareOutPipe.writable`.
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2025-05-14 software: rework `--voltage` argument syntax.
    Migration guide:
    * `--keep-voltage` → (nothing)
    * `--port X -V 3.3` → `-V X=3.3`
    * `--port XY -V 3.3` → `-V XY=3.3`
    * `--port X --mirror-voltage` → `-V X=SX`
    Note that `-V 3.3` always means `-V AB=3.3` and ignores `--port` in
    this commit. `--port` will be removed in the next one.
    [device.py, test.py]
2025-05-14 software: rework pin argument syntax.
    * `--pin 0` → `--pin A0`
    * `--pin 0#` → `--pin A0#`
    * `--pin 0:3` → `--pin A0:3`
    * `--pin 0:3#` → `--pin A0:3#`
    * `--pin 9` → `--pin B1`
    * `--pin 0:15` → `--pin A0:7,B0:7`
    * `--pin 0:15#` → `--pin A0:7#,B0:7#`
    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
    [assembly.py, test.py]
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2025-05-16 applet: fix parsing of `--voltage` with multiple clauses.
    E.g. `--voltage A=5,B=3.3`.
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2025-05-17 simulation.assembly: fix `use_pulls()`.
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2025-05-17 hardware.assembly: don't crash after running out of pipes to configure.
    [assembly.py]
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2025-05-17 applet.interface.analyzer: fix `--pin-names` argument declaration.
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2025-05-18 software: fix use of pulls in simulation.
    [assembly.py]
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2025-05-19 applet.interface.{spi,qspi}_analyzer: increase default buffer size.
    Coupled with increased USB buffer sizes (not a part of this commit),
    this change greatly reduces frequency of overflows. Once multiple
    applets land, the `--buffer-size` option will allow better coexistence.
2025-05-19 hardware.assembly: significantly increase buffer sizes.
    The new SPI/QSPI analyzer applets are sensitive to these parameters and
    the new values almost entirely eliminate overflows.
2025-05-20 cli: add support for running multiple applets in parallel.
    This also removes `--override-required-revision` (downgrading the error
    to a warning), since most people have produciton revC3 devices, and
    those who don't, know what they're doing. This flag now indicates
    the revision of hardware against which the applet will be tested.
    [assembly.py]
2025-05-20 hardware.assembly: fix Vio sensing.
    [assembly.py]
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2025-05-21 firmware: reset FPGA side FIFOs automatically (-61 bytes XRAM).
    This commit ties together several changes that align the way FIFOs work
    with the new API with the way the firmware treats FIFOs. With new API,
    applets can request up to 4 independent pipes: two OUT and two IN.
    There is no inherent ties between any of the pipes, in particular they
    are not paired as IN+OUT.
    Until this commit, the gateware would pair pipes into interfaces: one
    IN+OUT pair per interface. After this commit, each endpoint gets its
    own interface, independent from all others. Moreover, the firmware is
    now aware of a pipe reset register in the FPGA, and will reset a pipe
    in response to the standard Set Interface command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
    [assembly.py, device.py, fifo.c, fpga.c, glasgow.h, main.c]
2025-05-21 hardware.assembly: fix `HardwareInOutPipe.reset`.
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2025-05-23 gateware.fx2_crossbar: fix skid buffer handling.
    If the skid buffer starts being drained while the skid buffer is still
    skidding, we still need to direct incoming bytes to the skid buffer,
    even though the read stream is now ready. This fixes problems with
    bytes being dropped on the OUT FIFO.
    Fixes #850.
    [fx2_crossbar.py]
2025-05-23 applet.interface.{spi,qspi}_analyzer: less aggressive pull settings.
    The current settings cause issues with autosensing level shifters and
    with unpowered targets. Narrow down the pull configuration to only
    the part that is required to avoid spurious transaction captures.
2025-05-23 software: float pulls unless otherwise configured.
    Before this commit, if you ran an applet with pull resistors configured
    and then re-ran it without the `use_pulls()` call, the pull resistors
    would remain configured in some cases.
2025-05-25 applet.interface.uart: fix REPL mode.
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2025-05-28 software: style fix in boilerplate example.
    [boilerplate.py]
2025-05-28 arch.arm.dap.dp: fix `DP_DPIDR` layout.
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2025-05-29 firmware: fix altsetting management (-22 bytes XRAM).
    [main.c]
2025-05-29 firmware: fix variable names. NFC
    [main.c]
2025-05-29 firmware: don't access FPGA if it isn't ready. (-21 bytes XRAM)
    This causes the device to fail enumeration on Windows.
    [fpga.c]
2025-05-29 support.endpoint.ServerEndpoint: allow attaching to a pipe.
    In the future, this could be made significantly more efficient.
2025-05-29 hardware.assembly: allow bypassing IN/OUT FIFOs.
    This is useful when the applet already includes its own FIFO.
2025-05-29 cli: fix failure case of argument parsing for multiple applets.
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2025-06-01 gateware.registers: allow assigning domain to RW registers.
    This is used to reset registers that are a part of an applet together
    with that applet.
    [registers.py, test_registers.py]
2025-06-01 hardware.assembly: use applet domain reset for RW registers.
    [assembly.py]
2025-06-01 abstract: add `.add_clock_divisor()` building block.
    This replaces `GlasgowApplet{,V2}.derive_clock` and `ClockGen.derive`.
    Eventually `ClockGen` should be removed.
    [assembly.py, test.py]
2025-06-01 applet.interface.swd_openocd: remove.
    This applet never worked right due to what are most likely bugs in
    OpenOCD. That and the need to build OpenOCD from source made its
    utility almost nil. Now that we have fast native SWD we have no need
    for it.
    [test.py]
2025-06-02 gateware.iostream2: redesign `IOStreamer`.
    The new design is significantly simpler and easier to understand. It
    changes the following:
    * There is no `i_en` anymore; the metadata must contain enough
    information to determine whether the sample contains useful input.
    As a result, there is a 1:1 correspondence between input and output
    frames.
    * There is no `IOClocker`; the enframer handles clocking. This is
    slightly more verbose to implement, but much easier to understand.
    * For SDR interfaces, it is expected that the enframer would produce
    DDR frames, allowing fIO=fSYS; if such an enframer must be used
    with SDR buffers, an IO stream specific downconverter must be u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
    [iostream.py]
2025-06-02 gateware.swd: use DDR buffers to double fSWCLK_max.
    This commit combines several changes:
    * Migrating to new IOStreamer.
    * Changing tests to have simulated DUT setup/sample on the correct
    edge (setup on rising, sample on falling).
    * Changing enframer to double timer resolution and upper frequency
    range.
    * Changing enframer/deframer to allow for varying the sampling point.
    * Moving the sampling point to right before DUT setup point, to
    maximize timing budget.
    * Updating `probe-rs` applet protocol to accommodate the change in
    divisor semantics.
    [swd.py, test_swd.py]
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2025-06-05 applet.control.gpio: allow interacting with pins from CLI.
    This is very useful to set strap pins, e.g. if you have a system reset
    connected to pin `B7` and it must be asserted for JTAG to work:
    glasgow multi jtag-probe <...> ++ gpio --pins B7 B7=0
    It is also possible to set pins to drive weakly (e.g. use the `B7=H` or
    `B7=L` as an argument), and to sample pins (e.g. use `B6` as an
    argument).
2025-06-07 gateware.cobs: re-export `encode` and `decode` from `cobs` package.
    This simplifies import management, and also allows us to easily replace
    these functions with a faster implementation.
    [cobs.py]
2025-06-07 gateware.cobs: fix an internal overflow.
    This bug was causing data corruption when the FIFO would fill up.
    [cobs.py, test_cobs.py]
2025-06-07 gateware.uart: fix parity computation
    Iteration over a `Shape` has not been a thing since Amaranth 0.4,
    causing a `TypeError` when setting up non-constant parity. Use the
    reduction XOR operator instead of hand-rolling the parity computation.
    Tested that both odd and even parity work, and that mismatched settings
    generate receive errors, when listening to an FT232R on macOS running
    CoolTerm. Tested also that a loopback connection works.
    [uart.py]
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2025-06-08 applet.interface.uart: fix `--stream` option handling.
2025-06-08 hardware.assembly: claim all interfaces before pipelining IN requests.
    Claiming an interface on Windows resets all of the sibling interfaces.
    It is probably not possible to make `.detach()` work properly without
    a lot of additional work.
    [assembly.py]
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2025-06-13 gateware.uart: fix RX valid/ready signaling.
    Before this commit, the signaling did not follow stream rules. Even
    though it's not defined as a stream, we treat it this way downstream,
    and not clearing ready flag immediately on exiting READY state caused
    duplicate received bytes.
    [uart.py]
2025-06-13 abstract: add configurable rounding mode for `add_clock_divisor()`.
    This is useful for UART and similar protocols, where the desirable end
    frequency should be "closest", rather than "not to exceed".
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2025-06-28 hardware.toolchain: fix non-virtualenv installations with YoWASP on Windows.
    [build_plan.py, toolchain.py]
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2025-07-03 applet.interface.spi_controller: migrate to V2 API.
    This also unfortunately removes functionality (only Mode 3 is supported
    in the new controller, whereas the old one supported all modes), but
    most devices use either Mode 0 or Mode 3 and don't care which one it is.
2025-07-04 applet: be explicit if pin is required or optional.
    Many applets have optional pin arguments for some auxiliary function,
    but this is currently non-discoverable if they have a default value,
    since they look exactly the same as a required argument.
2025-07-04 gateware.{spi,qspi}: fix to actually comply with Mode 3.
    Before this commit, the clock would idle low after the first transaction
    was completed.
    [qspi.py, spi.py, test_qspi.py, test_spi.py]
2025-07-04 applet.interface.spi_controller: add stub mode parameter.
    This parameter is currently just there to make any downstream user
    stop and consider whether their device actually uses Mode 3 or not.
    Once SPI modes are implemented properly, it will configure the SPI
    controller.
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2025-07-06 applet.interface.uart: don't silently drop frames on overflow.
    Partial fix for #263.
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2025-07-09 applet.interface.i2c_initiator: remove `--pulls` option.
    The main reason to make pull resistor state configurable (besides
    compatibility with revAB, which is now handled centrally) is to avoid
    sourcing too much current. However, it doesn't seem like the added 330
    microamps (at 3.3 V) is going to make any difference in any real-world
    situation. Forgetting `--pulls` however is a very real source of
    frustration.
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2025-07-10 applet.interface.i2c_controller: redesign API and add tests.
    [assembly.py, i2c.py, test.py]
2025-07-10 applet.interface.i2c_controller: use clock divisor API.
    The way this is done is rather hacky, done so to avoid modifying
    the existing I2C initiator as much as possible (since it is reliable
    and also verifying I2C gateware is very difficult).
    At some later point the existing I2C gateware will be replaced with
    a stream-based one anyway. Then all of this will go away.
    [i2c.py, test.py]
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2025-07-10 CI: cache PDM installation.
    This is mainly important because numpy wheels have to be rebuilt from
    scratch on PyPy, and that is the rate limiting step.
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2025-07-13 gateware.fx2_crossbar: flush IN FIFO once per microframe.
    This eliminates a common pitfall for applet authors, where by default
    the IN FIFO is flushed too often, and very small packets clog the FX2
    buffers, causing buffer overflows and data loss. With this change, so
    long as the host polls the device once per microframe (with XHCI hosts,
    this can happen even more than once), there will never be a case where
    an FX2 buffer isn't available, unless the bus is very heavily loaded
    with other traffic.
    There are two cases where more control over flushing is desired.
    First, in request/response style protocols, it is useful to flush
    the IN FIFO once the OUT FIFO is empty, since this reduces time spe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
2025-07-13 applet.sensor.sen5x: add delay before I2C reads
    The datasheet lists a worst-case command execution time of 20 ms for all
    read commands, but doesn't clearly explain what to do with that information.
    However, the device NACKs an I2C read if it's issued too soon after the
    command-address write. So, this delays all reads by that execution time
    and seems to be stable now.
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2025-07-14 Revert "applet.bridge.probe_rs: support included in probe-rs release!"
    This reverts commit 96c2a7fb8f3622af8c7d4dff8102ed278535587f.
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2025-07-18 hardware.toolchain: fix incorrect types. NFC
    [toolchain.py]
2025-07-18 manual: basic: replace i2c-initiator by i2c-controller.
2025-07-20 gateware.fx2_crossbar: use init instead of reset.
    [fx2_crossbar.py]
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2025-07-20 support.usb.webusb: map `NetworkError` to `ErrorStall`.
    Disconnecting the device seems to produce a `NotFoundError` with
    "The device was disconnected." in the message. This isn't a great
    solution but I don't have anything better.
    [assembly.py]
2025-07-23 pyproject.toml: fix spi-flashrom module name
    The module was temporarily called flashrom instead of spi_flashrom, but
    this isn't the case anymore.
2025-07-28 software/deploy-firmware: skip group addition if group already exists
    Running the script on a distribution where the current user is using gid
    100 fails, as that group already exists inside the image:
    ```
    Setting up libgssapi-krb5-2:arm64 (1.20.1-2+deb12u3) ...
    Setting up libgdbm-compat4:arm64 (1.23-3) ...
    Setting up libperl5.36:arm64 (5.36.0-7+deb12u2) ...
    Setting up libcurl3-gnutls:arm64 (7.88.1-10+deb12u12) ...
    Setting up perl (5.36.0-7+deb12u2) ...
    Setting up liberror-perl (0.17029-2) ...
    Setting up git (1:2.39.5-0+deb12u2) ...
    Processing triggers for libc-bin (2.36-9+deb12u10) ...
    + groupadd --gid 100 caller
    groupadd: GID '100' already exists
    ```
    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
2025-07-28 hardware.device: fix firmware upload.
    Introduced in commit 132dbf14.
    Fixes #982.
    [device.py]
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2025-08-08 pyproject.toml: exclude yowasp-yosys 0.56 as it fails building Glasgow applets with error ERROR: Assert `count_id(wire->name) == 0' failed in ../yosys-src/kernel/rtlil.cc:2621. Yosys issue ref: https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
    pdm.min.lock: update as requested
2025-08-09 applet.interface.uart: change quit sequence to `~` then `.`.
    This sequence is similar to SSH, except it doesn't have to follow
    a newline. It's changed because on some non-US keyboard layouts it
    may be difficult to enter Ctrl+\ (issue #998), and because it was
    training users to use Ctrl+\ to quit other applets or modes, which
    sends SIGQUIT and dumps core on some OSes (issue #568).
    Fixes #998.
2025-08-10 CI: push latest wheel to https://glasgow-embedded.org/.
    This will be used by the WebUSB port.
2025-08-11 hardware.device: Add FX2BootloaderDevice
    FX2BootloaderDevice is very similar to FX2Device from libfx2. The primary
    differences are:
    a) parameters in FX2Device such as page size, and address width are fixed
    to the ones matching the Glasgow hardware/firmware
    b) USB requsts use the USB abstraction from support
    [device.py]
2025-09-21 software: fix undefined names (ruff F821).
    [test.py]
2025-09-21 software: fix comprehension syntax (ruff unsafe C4). NFCI
    [test.py]
2025-09-21 software: remove trailing comma on empty tuple (ruff COM818). NFC
    [skip blame]
    [uart.py]
2025-09-21 software: avoid raising `Exception` (ruff TRY002).
    [assembly.py]
2025-09-21 software: avoid unnecessary dict lookup (ruff safe PLR1733). NFC
    [toolchain.py]
2025-09-21 software: normalize to use double quotes (ruff safe Q). NFC
    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
    [assembly.py, build_plan.py, device.py]
2025-09-21 software: fix docstring formatting (ruff safe D*). NFC
    [lint]
    preview = true
    select = [
    "D200", # unnecessary-multiline-docstring
    "D201", # blank-line-before-function
    "D202", # blank-line-after-function
    "D204", # incorrect-blank-line-after-class
    "D207", # under-indentation
    "D208", # over-indentation
    "D209", # new-line-after-last-paragraph
    "D210", # surrounding-whitespace
    "D211", # blank-line-before-class
    "D212", # multi-line-summary-first-line
    "D214", # overindented-section
    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
    [accumulator.py, analyzer.py, clockgen.py]
2025-09-21 software: fix whitespace (ruff safe E*,W*). NFC
    "E262", # no-space-after-inline-comment
    "E302", # blank-lines-top-level
    "E305", # blank-lines-after-function-or-class
    "E252", # missing-whitespace-around-parameter-equals
    "E303", # too-many-blank-lines
    "E225", # missing-whitespace-around-operator
    "W291", # trailing-whitespace
    "W292", # missing-newline-at-end-of-file
    "W391", # too-many-newlines-at-end-of-file
    "E265", # no-space-after-block-comment
    "W293", # blank-line-with-whitespace
    ]
    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
    [accumulator.py]
2025-09-21 software: fix line length (ruff E501). NFCI
    [analyzer.py, assembly.py]
2025-09-21 software: upgrade formatting syntax (ruff unsafe UP031, flynt). NFCI
    The "aggressive" mode of flynt appears to corrupt format strings with
    precision: instead of converting to `{foo:{bar}d}`, it converts to
    `{foo:{{}}d}`. This was fixed manually.
    [analyzer.py, device.py]
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2025-09-24 revC3: schematics, cosmetic: update revision in page frame to C3
    [glasgow.kicad_sch, io_banks.kicad_sch, io_buffer.kicad_sch]
2025-09-24 revC3: schematics, cosmetic: regenerate schematics.pdf
    The new export is with KiCad 8 vs. the previously used 7. The project
    has been updated to KiCad 8 a while back (in d884af4b), but the
    schematic has never been re-exported since.
    This means that there's a few changes that the schematic is now catching
    up to:
    1. 3.3V is now called 3V3
    2. The symbols for resistor networks are slightly visually different.
    Otherwise, however, the schematic is the same, and represents the same
    netlist.
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2025-10-08 firmware: fix race conditions in control out transfers (-3 bytes XRAM).
    Before this change, the EP0BUF buffer used by control out transfers
    could be overwritten by new control transfers before the firmware is
    finished processing the previous control transfer.
    The easiest way to illustrate this problem would be to run in a
    different terminal the following:
    ```bash
    while true; do lsusb -v -d 20b7:9db1 > /dev/null; done
    While this is running, glasglow is completely unusable.
    Presumably even a single lsusb run could cause corruption, if it
    happens to be issued at the wrong time.
    With this change glasgow is now usable, even if the above loop is
    running.
    Please see https://github.com/whit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
    [main.c]
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2025-10-12 applet.sensor.hcsr04: fix us_cycles calculation.
2025-10-12 applet.sensor.hcsr04: increase default timeout.
    The value was too low for the default/highest supersampling factor.
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2025-10-12 applet.sensor.hcsr04: add a 50 ms delay between samples.
    Vendors specify minimum inter-sample delay as high as 200 ms, but 50 ms
    seems to work OK. Not letting the sensor recover between pulses causes
    it to timeout often.
2025-10-13 [pre-commit.ci] software: automatic code style fixes.
    For more information, see https://pre-commit.ci.
    [stream.py]
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2025-11-02 firmware: fix race conditions missed by pr #703 (+4 bytes XRAM).
    These were missed by PR #703, because they used `SETUP_EP0_BUF(2)`
    with a non-zero argument for Control OUT transfers. Even though
    these didn't follow libfx2's (old) rule, of setting length to 0 when
    using Control OUT transfers, they did mostly work, because the FX2
    actually ignores the length on OUT transfers.
    PR #703 assumed that all non-zero `SETUP_EP0_BUF` calls were IN
    transfer, which was wrong, so these instances remained vulnerable to
    the race condition. This change fixes those too.
    [main.c]
2025-11-03 firmware: Add build script to more easily use docker for development.
    Added "./docker.sh" build script with various subcommands in order to
    encourage using the official sdcc version even for experimental
    developer builds of the firmware. They will work much faster than the
    previous `deploy-firmware.sh` script because they now use docker's
    caching mechanism to not reinstall sdcc every time they are invoked.
    One of the subcommands `./docker.sh deploy` now replaces the old
    `deploy-firmware.sh` script. The console output will look a little bit
    different, because the installation steps are now printed by
    `docker build --progress=plain`. The caching mechanism is disabled
    only for deploying.
    This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
2025-11-06 applet.control.gpio: improve log message for 1-pin case.
    D: g.applet.program.avr.spi: assigning pin reset[0] to A0
    D: g.applet.program.avr.spi: assigning pin reset to A0
    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
2025-11-06 applet.interface.spi_controller: make CS# pin optional.
    This is useful for some SPI-like interfaces with custom synchronization
    or if CS# is implemented manually (e.g. for AVR SPI programming, where
    it is merged with the reset pin, it is more convenient to do so).
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2025-12-03 hardware.assembly: HardwareOutPipe fix buffer_size not working when > ~2000000
    Previously, when buffer_size was set, send only checked the size of
    inflight requests. This meant that if buffer_size was more than
    ~_max_packets_per_ep * 512 (2097152), send would never stall as the
    size of inflight requests cannot exceed this value.
    Changed to instead consider both the size of inflight requests and
    the size of the contents of the buffer.
    [assembly.py]
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2025-12-18 applet.interface.spi_flashrom: Allow empty reads
    Running flashrom with --layout can result in zero length reads, which
    would otherwise hit an assertion. Just return an empty buffer.
    flashrom -p serprog:ip=localhost:7788 -c MT25QU01G --read dump1.bin --layout /path/to/file.layout --include part3
    | Traceback (most recent call last):
    | File "glasgow/software/glasgow/cli.py", line 797, in applet_task
    | await applet.run(applet_parsed_args)
    | File "glasgow/software/glasgow/applet/bridge/spi_flashrom/__init__.py", line 158, in run
    | await SerprogCommandHandler(self.logger, self.spi_iface, endpoint).handle_cmd()
    | File "glasgow/software/glasgow/applet/bridge/spi_flashrom/__init__.py"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
2026-01-24 applet.interface.uart: flush IN FIFO on newline.
    This *greatly* improves responsiveness of e.g. running `dmesg` in
    a serial terminal connected to a Linux machine, or entering U-Boot
    using an interrupt sequence, or other similar use cases.
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2026-02-01 applet.interface.uart: fix exception when optional rx is missing.
    Fixes #1106
    Also added missing import for `GlasgowAppletError`
    [test.py]
2026-02-01 applet.program.ice40_sram: assert CS# only once FPGA is in reset.
    Since configuration interface CS# pin can be configured as an ouptut
    by the bitstream, behavior before this commit can cause bus contention.
    It has destroyed a CS# pin output cascade on one of my boards :(
2026-02-10 gateware.{spi,qspi}: rename `Mode` enum to `Operation`. NFC
    "Mode" has a specific meaning in context of SPI which this enum did not
    reflect. QSPI does not have the same "mode", but is also changed for
    consistency.
2026-02-10 gateware.{spi,qspi}: rename `Operation.{Dummy→Idle}`. NFC
    The reasoning is explained in the next commit.
2026-02-10 gateware.spi: add support for (Motorola) modes 0, 1, 2.
    The SPI controller gains an additional usage constraint: when changing
    modes (the default is Mode 0), you must perform an idle operation with
    the new mode before transferring any data. (Obviously, changing mode
    while a device is selected is not supported.)
2026-02-10 gateware.spi: ensure setup/hold time between CS#/SCK is met.
    Inject a delay of one SCK half-period after CS# assertion and before
    CS# deassertion to avoid CS#/SCK timing violations.
    [spi.py, test.py, test_spi.py]
2026-02-10 applet.program.ice40_sram: write exactly 49 dummy bits.
    In case of certain types of pin reuse, this can minimize duration of
    bus contention during FPGA startup.
2026-02-10 applet.program.avr.spi: migrate to V2 API.
    Also, make programming entry procedure closer to what's described
    in the datasheet.
    Also, switch tests to ATmega328P, since that's much more common.
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2026-02-11 applet.display.pdi: remove.
    This is a V1 applet using the deprecated SPI controller, and it would
    require a non-trivial migration effort. I still have the device against
    which it was written, but given how obscure this early EPD is, it feels
    unlikely that this applet serves anyone's needs.
    We do not often remove applets but this one seems like a good choice
    for removal.
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2026-03-11 simulation.assembly: fix most pylance reports.
    [assembly.py]
2026-03-12 arch.qspi: new architecture.
    Turns out (Q)SPI Flash command sets are very similar to CPU ISAs. (Everyone disliked that.)
2026-03-12 applet.memory._25q: new applet.
    This is a complete functional replacement for `memory-25x` and it
    obsoletes the latter in favor of something with a much better UI,
    as well as considerably higher performance.
    [nor.py, test.py]
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2026-03-15 applet.interface.i2c_controller: fix hang after partially unacked write.
    [test.py]
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2026-04-26 hardware.device: fix script ADC read precision on RevC2 and later.
    Previously all script ADC reads were rounded to 2 decimal places,
    limiting precision to 10mV. Enough for the 8bit ADC on earlier revisions
    with a LSB = 25.9 mV.
    Hardware revision C2 changed to a 16bit ADC, the INA233, with a LSB =
    1.25 mV, giving a full extra digit of precision available.
    Since internally the value is transferred as integer millivolts and will
    be truncated to 3 decimal digits regardless, the round() call can be
    removed.
    [device.py]
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2026-04-26 assembly: Consistently cast `GlasgowPort` to `str` where used as a port spec.
    This fixes an exception caused by `glasgow run ... -V VOLTS` where VOLTS is
    outside the supported voltage range.
    [assembly.py]
2026-05-18 applet.measure.calibrate_clock: supports measuring Glasgow's internal clock against external frequency references, and supports measuring an external clock input to specified gpio against external fr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
2026-05-18 applet.sensor.qmc5883p: implement applet supporting the i2c triple-axis magnetometer from qstcorp, tested against breakout GY-271 from aliexpress.
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2026-05-19 nit: fix CODEOWNERS taxon for calibrate_clock - is `measure` not `internal`
2026-05-26 hardware: add revision D0
    this switches the FPGA to an ECP5, doubles the IO banks, adds RAM, an ADC and re-does the whole power supply.
    full history here: https://codeberg.org/tachiniererin/glasgow_revD
    [USB.kicad_sch, adc.kicad_sch, fpga.kicad_sch, glasgow_revD0.kicad_sch, io_buffer.kicad_sch, level_shifters.kicad_sch, power.kicad_sch, ram_lvds.kicad_sch]
2026-05-30 firmware: implement current measurement on the ina233 used in revC3. +255B XRAM usage.
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2026-06-01 applet.measure.prn_noise: implement pseudorandom noise generator which can be band-limited to approximate AWGN for audio and RF filter / system characterisation. Output from Glasgow revC3 is flat to 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
    [test.py]
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2026-06-27 applet.measure.curve_trace: implement two quadrant (1.8v-5v) and four quadrant (-1.7v to +1.5v) curve tracing for quantifying the behavior of LEDs, other diodes, and resistors
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2026-07-23 abstract: accept `io.{Simulation,SingleEnded}Port` as well.
    This is currently not well surfaced (in particular the types are not
    updated for this case), but it's a useful escape hatch e.g. to talk
    to the NAFE using the SPI controller applet:
    # ...
    afe_adc = assembly._platform.request("afe_adc", dir={
    "reset": "o",
    "cs": "-",
    "clk": "-",
    "copi": "-",
    "cipo": "-",
    "int": "i",
    "sync": "o",
    "drdy": "i",
    })
    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
2026-07-23 support.usb: add `ErrorOther`.
    This error is reported by libusb if you stall a Set Interface request.
2026-07-23 hardware: add basic revD0 support.
    This does not include the extensive firmware changes required to use revD0 devices.
2026-07-23 firmware/{.→fx2-old}: prepare for replacement.
    [adc_adc081c.c, adc_ina233.c, dac_ldo.c, fifo.c, fpga.c, glasgow.h, main.c, normalize.py]
2026-07-23 firmware/fx2: reimplement.
    The new FX2 firmware has complete feature parity with the old FX2
    firmware, with the following major changes:
    - reimplement board/port/FPGA management USB protocol to be network
    transparent
    - reimplement handling of USB endpoint buffering to significantly
    increase throughput on Windows and open the door for e.g. all-OUT or
    all-IN configurations
    - reimplement port management commands to take a mask and four distinct
    values (documented in `firmware/fx2/glasgow_mgmt.h`)
    - add support for ECP5 SRAM bitstream loading
    - add support for using ports `C`, `D` on revD0
    - extend I/O voltage range to 1.2-5.5 V on revD0 (from 1.8-5.0 V on
    revABC)
    - implement a more ro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
2026-07-23 hardware.assembly: fix `add_{ro,rw}_register` with `EnumView` argument.
    [assembly.py]
2026-07-23 applet.measure.{calibrate_clock,prn_noise}: add missing `tests()`.
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2026-07-23 hardware.assembly: use `--no-promote-globals` on iCE40.
    See #1203. This is a temporary solution in lieu of something better
2026-07-25 gateware.iostream: implement `HalfRateIOStreamer`.
    Useful for DDR protocols on devices without QDR IO primitives.
2026-07-25 software: ensure sufficiently new nextpnr-ecp5 is used.
    Specifically, YosysHQ/nextpnr@7c667eeba362a8538396f9c4dc9bd1a168b35fa3
    is **absolutely required** for any applet that attempts to use IO
    gearboxes. This includes any use of the onboard DRAM.
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2026-07-28 cli: clarify I/O voltage ranges.
    Both revABC and revD can set the DAC to 5.5 V, but only revD has
    the boost converter to make it actually happen (without an abnormally
    high Vbus).
2026-07-28 cli: improve `voltage` command syntax.
    Fixes #1208.
2026-07-30 manual: revC3: zh_CN: minor fixes
    Fix two missed words at the start, and fix a misinterpretation of "power
    requirements".
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2026-08-06 applet.interface.spi_analyzer: shrink memory for test.
    The timings are marginal, and Yosys 0.68 upgrade seems to have broken
    this applet. Band-aid it for now.
    [test.py]
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2026-08-09 glasgow.applet: accept more spellings of "leave pin unconnected"
    Currently, it is difficult to figure out how to leave a pin unassigned
    when a default is present for that pin. In order to fix that, this
    commit introduces 'NC' as the preferred syntax for this choice, so as
    to make the meaning immediately clear to users of ordinary skill in the art.
    Additionally, adjust the error message to succintly explain the syntax
    by example.
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2026-08-14 VGA: convert to V2 applet API
    This also adds additional tests and fixes existing tests:
    - Make pattern test meaningful with enough pixels to verify the pattern.
    - Add additional parameter validation test.
    - Fixed a bug where the first frame after init was blank because h_en and v_en
    were reset to zero
    - Fix a bug where the flag pattern's phase was updated synchronously, causing
    the first pixel of each stripe to retain the previous stripe's colour.
    - Add additional parameter validation.
    - Document setting active-low sync (some VGA modes require it).
    - Rename variables to be more consistent with other video modules.
    [test.py]
2026-08-15 firmware/stm32: new firmware.
    This firmware has two main functions:
    * Provide a bridge from FX2's I2C to NAFE's SPI interface.
    * Provide a way to boot the revD FPGA from SPI flash.
    It is written to be very compact to simplify bootstrapping, as it is
    designed to be loaded by the FX2 into RAM on boot.
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2026-08-15 firmware/fx2: fix STM32 reset sequence.
    Before this commit, hot reloads would fail due to some not fully
    understood timing violation between nRST and SWCLK/BOOT0.
    [stm32.c]
2026-08-15 firmware/fx2: fix numeric overflow in NAFE code scaling.
    [nafe.c]
2026-08-15 firmware/fx2: fix signedness in NAFE code scaling.
    [nafe.c]
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2026-08-16 glasgow.database.i2c.probe: fix type of `addresses`.
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2026-08-29 gateware.stream: fix `stream_get()` for `always_ready=True` streams.
    [stream.py]
2026-08-29 gateware.octoram: print odd address on assertion failure.
    [octoram.py]
2026-08-29 hardware.assembly: reset DRAM logic on applet domain reset.
    This used to be done based on the edge domain reset, but as a result
    if the applet queued an invalid command/data sequence (typically because
    of a queue overflow), the memory controller would become wedged even
    after re-running the CLI (which clears all other error conditions).
    [assembly.py]
2026-08-29 hardware.assembly: reduce revD DRAM edge clock to 236 MHz.
    This decreases the DRAM logic clock to 118 MHz, which should take care
    of spurious timing failures at 120 MHz by introducing a little margin.
    [assembly.py]
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2026-08-29 cli: ignore `usb.ErrorDisconnected` on device close.
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2026-09-01 gateware.octoram: split off `InterfaceQueue`. NFC
    This is a much better approach than having a separate ECP5 controller
    variant; not only to reduce proliferation of device specific memory
    controllers, but also because the queue should be used in simulation
    to reduce mismatch with synthesis.
2026-09-01 simulation.assembly: place DRAM into its own clock domain.
    This significantly improves accuracy relative to actual hardware.
2026-09-01 gateware.octoram: add support for HyperRAM.
    HyperRAM is not a good bus. The specification is completely unhinged.
    However, with the RAM shortage, we may not be able to be choosers.
    [octoram.py]
2026-09-01 hardware.assembly: add experimental DRAM support on revC.
    This is currently hardcoded to use HyperRAM devices, which are what
    the prototype RAM-Pak is using. However, we will try to avoid shipping
    these in production to make managing the fleet less of a headache.
    [assembly.py]
2026-09-02 hardware: restructure to avoid relying on branches.
    Before this commit, it was expected that the latest version of design
    and production files for each revision was contained in the respective
    branch. This has created nothing but problems and divergence.
    After this commit, all design and production files exist in parallel
    on the `main` branch, and all past branches/tags used for this purpose
    are to be removed.
    [Glasgow_base.f3d, Glasgow_base.iges, Glasgow_base.stl, bom.csv, bottom.dxf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]
2026-09-03 applet.memory.25x: remove in favor of `memory-25q`.
    This applet has been deprecated for some time, and `memory-25q` is
    a complete functional replacement with better performance.
    [applets_without_cli.py, test.py]
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2026-09-03 applet.interface.analyzer2: new applet.
    This applet will eventually replace `applet.interface.analyzer`, once
    revC compatibility is added.
    [test.py]
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2026-09-21 gateware.iostream: Support zero width ports
    This updates IOStreamer to support zero width ports, using the method proposed in #1292
    See discussion at:
    https://libera.catirclogs.org/glasgow/2026-09-20#1789885505-1789885570;
    resolves #1292
    [iostream.py, test_iostream.py]
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2026-09-25 hardware: revD0: add fabrication files.
    [glasgow-B_Courtyard.gbr, glasgow-B_Cu.gbr, glasgow-B_Fab.gbr, glasgow-B_Mask.gbr, glasgow-B_Paste.gbr, glasgow-B_Silkscreen.gbr, glasgow-Edge_Cuts.gbr, glasgow-F_Courtyard.gbr]
2026-09-25 hardware: revD1: add source and fabrication files.
    [adc.kicad_sch, fpga.kicad_sch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]
2026-09-25 hardware: revD1: change MPN of U9 to W25Q32JVZPIM.
    Winbond W25Q32JVZPIQ has QE fixed to 1 and nHOLD disabled, which will
    break bitstream loading via the FX2. The -IM variant is different only
    in that QE is not fixed and defaults to 0.
    [fpga.kicad_sch]
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2026-09-30 applet.memory.25q: Forgotten bits from 256 byte erase block support
    Few more missing pieces for 256-bytes erase block support.
    Fixes: c136b7f6a5dbb4c36e079044226fb8b2d5f900b6
    [nor.py]
2026-09-30 applet: migrate remaining I2C and UART applets to V2 API.
    Migrate `sensor-ina260`, `control-tps6598x`, `program-stusb4500-nvm`,
    `sensor-pmsx003`, and `program-m16c` to the V2 applet API, add synthesis
    tests, and add them to the manual.
    Remove `interface.i2c_initiator_deprecated`, which no longer has any
    consumers.
    [test.py]
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2026-10-10 Expose LEDs as virtual pins `LED[0-4]`.
    Also, expose the sync port as virtual pin `SYN0`, in preparation for
    revD1 having two sync pins. This isn't a breaking change because `S0`
    has never properly worked (`GlasgowPin.parse` would reject it).
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2026-10-20 software: switch to PEP 751 lockfile format.
    This lockfile format will become the default in a future PDM version,
    so it has first-class support. It also allows us to migrate away from
    PDM much more easily in the future.
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
